ddasdkimo/rack-atx-controller/hardware/research/hxy-trial5-all20-overview.png

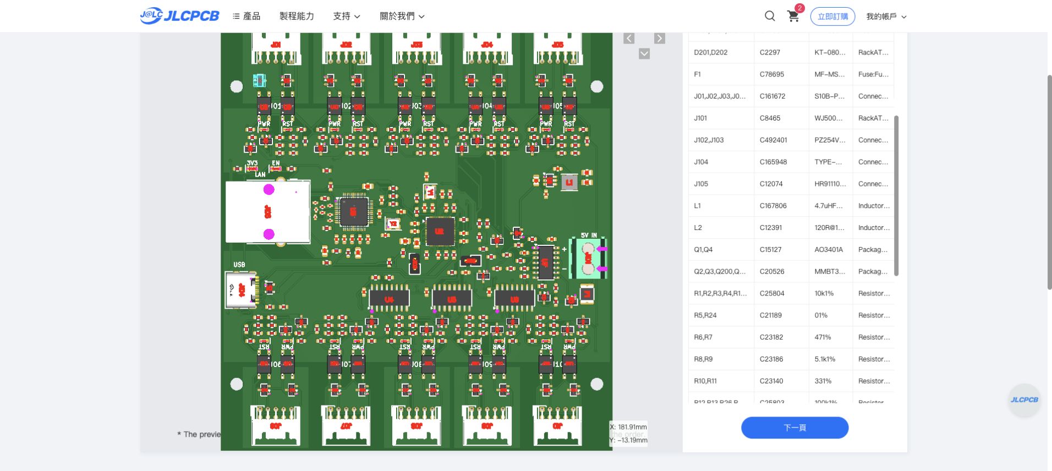
hardware/research/hxy-trial5-all20-overview.png
