ddasdkimo/rack-atx-controller/hardware/research/jlc-r3-shift-registers.jpg

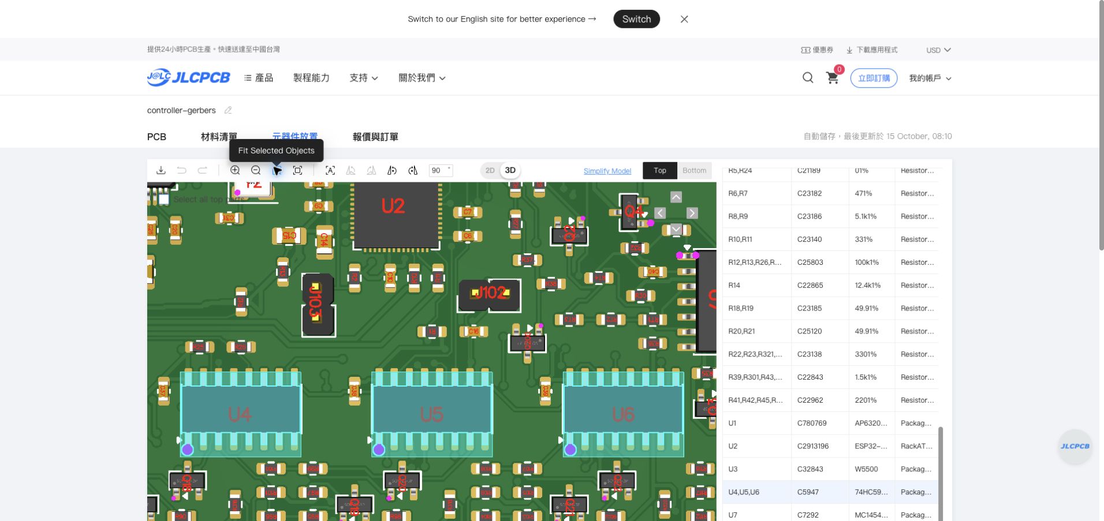
hardware/research/jlc-r3-shift-registers.jpg
