ddasdkimo/rack-atx-controller/hardware/simulation/README.md

# Current B.2 study — 2026-10-14

Run `python3 hardware/simulation/run-b2.py` from the repository root. [B2-summary.json](results/B2-summary.json) is tied to the exact current circuit hash. The study uses ngspice47 with a datasheet-fitted aggregate32768-count timer and transistor/photorelay models; **no vendor oscillator model or hardware correlation**.

The B.1 LED sensing failure is addressed by removing that entire electrical branch; case LEDs remain directly attached to the motherboard. The timer is nowMC14541B,200kΩ/1nF C0G,Rs400kΩ,AR disabled,MR external,one transition. Independent ARM gating keeps PHOTO_5V off while reset Q is high. ARM/OE/LATCH move toGPIO4/6/7.

16corners combine R±1.5%,C±5.2%,supply4.75/5.25V and an **assumed±25%clock-frequency stress range**. Nominal15.07328s; computed pulses11.2597–21.4599s fall in the8–25s design-study window. Clock tolerance is a study envelope, not a production specification. Nine cases cover normal pulse,heldARM60s,disarm5s,bootwithoutfirmware,OEforcedenabled,timerQforcedhigh,10µs/1spowerramps,andrepeatedcommands. All assertions pass.

Actual RC oscillator startup/frequency, supply and temperature extremes, MCU boot loading, ESD, EMC, USB/Ethernet and physical relay behavior still need prototype qualification. Repeated ARM transitions start new windows; this is not a fault-proof interlock against arbitrary firmware. The following B.1 study is retained to document why the redesign was made; its LED and TLC555 results are not the active circuit.

---

# B.1 行為級 SPICE 模擬（2026-10-14）

這個目錄是 B.1 電路的 ngspice 模擬：用 datasheet 參數擬合的**行為模型**，檢查 B.1 原理圖中無法只靠直流估算確認的行為。它是設計審閱的輸入，**不是**廠商模型驗證、不是實機量測，也**沒有**改變 B.1 原理圖、BOM 或 S.2／R.1 配置。所有結論都要在實際主機板與試作板上重新確認。

## 範圍與結果一覽

| 研究 | 網表 | 結論 |
|---|---|---|
| LED 感測門檻與遲滯 | `led-threshold.cir` | 300 次 Monte Carlo 加方向性角落：開啟 0.41–1.18 V、關閉 0.33–1.11 V（差動輸入），在「關 ≤0.2 V、開 ≥1.4 V」的理想包絡內成立 |
| LED 感測動態（假設主機板驅動） | `led-dynamic.cir` | **低側開汲極驅動的主機板一律誤判為常亮**；只有高側驅動正確。見下方發現 1 |
| 掉電負載與回灌 | `led-backfeed.cir` | 控制器通電、主機斷電時回灌 <0.02 µA；控制器斷電時每腳負載 ≤46 µA；但感測支路使熄滅的機殼 LED 流過約 30 µA |
| TLP3122A 驅動 | `photorelay.cir` | 128 個角落 IF 7.34–9.30 mA，皆高於 IFT 上限 3 mA、遠低於 50 mA；DRV 低或 595 三態時繼電器皆斷開 |
| TLC555 共用限時 | `timer.cir` | 標稱 16.81 s；含電容偏壓／溫度假設的角落 6.75–25.7 s，**超出 8–25 s 目標**；持續高電位不延長；解除 ARM 立即關閉 |
| 上電時序 | `powerup.cir` | GPIO43/44 的重置弱上拉使 555 RESET 腳在開機時約 2.28 V（高於 1.8 V 最差解除門檻），但 AC 耦合觸發沒有快速邊緣，軌道仍未啟動 |

機器可讀結果在 `results/*.json`，摘要同步到 `../validation/checks.json` 的 `spice_simulation`。

## 發現與建議

### 1. LED 感測在常見的主機板驅動方式下會誤判（高優先）

B.1 的 LED 感測是量 LED+ 與 LED− 的差動電壓，兩個輸入各經 100 kΩ 到比較器網路、10 kΩ 到主機參考地。原本的適配條件是「熄滅時差動 ≤0.2 V、亮起 ≥1.4 V」。模擬顯示對最常見的主機板拓樸（LED+ 經限流電阻接 5 V 或 3.3 V，LED− 由開汲極拉低）這個條件**不成立**：

- 驅動器關閉時 LED− 高阻抗，控制器的感測支路（約 110 kΩ 到主機地）把 LED− 拉向地，使機殼 LED 在約 30 µA 下微導通。差動電壓等於 LED 在微安級的順向電壓：綠色約 1.7 V、藍色約 2.4 V，都高於開啟門檻上限 1.18 V，所以 MCU 讀到「亮」。
- 沒有接機殼 LED 時，LED− 直接被拉到地，差動 ≈ 4.9 V，同樣讀到「亮」。亮與滅的差動幾乎相同，電壓感測在這個情況下**無法分辨**。
- 推挽式驅動（熄滅時 LED− 為 3.3 V 高電位、LED+ 為 5 V）差動 1.68 V，也讀到「亮」。
- 高側驅動（LED+ 被切換、LED− 固定接地）才正確：延遲開啟約 10 µs、關閉約 80 µs。

實務後果：HDD 燈在主機通電時會被讀成常亮；電源燈在待機閃爍時讀不到熄滅；同時機殼 LED 在「熄滅」時仍有約 30 µA 微亮，與控制器是否通電無關。

what-if（**未採用**，只是方向性證據）：在控制器端的主機域內，於 LED− 感測輸入與 LED+ 之間加一顆上拉電阻，讓熄滅時 LED− 跟著 LED+。模擬結果：

| 上拉 | 綠 LED 5 V 低側 | 無機殼 LED | 藍 LED 3.3 V | 亮起時經主機板驅動器的額外電流 |
|---|---|---|---|---|
| 22 kΩ | 誤判（熄滅差動 0.84 V） | 誤判 | 正確 | 0.09 mA |
| 4.7 kΩ | 正確（0.21 V，貼近關閉門檻下限 0.33 V） | 正確 | — | 0.43 mA |
| 2.2 kΩ | 正確（0.10 V），含最差比較器角落 | 正確 | 正確 | 0.93 mA |

2.2 kΩ 時亮起狀態多了約 0.9 mA 經主機板的 LED 驅動電晶體，這對一般驅動器可接受但必須以實際主機板確認；推挽式驅動仍無法用上拉解決，需要改成感測 LED 電流或改門檻。真正的修正要重新設計 LED− 支路（含 390 kΩ 偏壓與 4×510 kΩ 遲滯的比例），並依 AGENTS.md 同步 design.json、3D、接線圖與 CHANGELOG；這裡不做。

### 2. TLC555 限時角落超出 8–25 s 目標

脈寬 = R32 × Ct × ln(VDD / (VDD − VIT))。模擬角落：R32 ±1 %、VIT 2.7–3.9 V（全溫範圍）、Ct 17.2–33 µF。Ct 下限的假設是 3 × CL21A106KAYNNNE（10 µF 25 V X5R 0805）：公差 −10 %、5 V 直流偏壓 −25 %、X5R 溫度 −15 % 相乘；上限 +10 %。結果 6.75–25.7 s。若要守住 8 s 下限，需要量測該電容在 5 V 偏壓下的實際容量，或改用 C0G／較高額定電壓的電容，或接受下限由韌體長按 5 s 的餘裕吸收。這與原本的「8–25 s 是鑑定目標而非保證」一致，只是把差距量化。

其他行為：TIMER_FIRE 持續高電位 40 s 只產生一個 16.8 s 脈衝（AC 耦合有效）；每 5 s 重觸發 1 ms 會在前一脈衝結束後再開新視窗，60 s 內軌道共通電 50.4 s；觸發後 5 s 解除 ARM，軌道在 10 ms 內關閉；未 ARM 時觸發，軌道保持 0 V；20 路同時導通時 PHOTO_5V 為 4.99 V；觸發脈衝約 1.4 ms，4.75 V 時 TRIG 腳最低 0.046 V。

### 3. GPIO43／GPIO44 的重置狀態削弱了「預設禁能」的保護

ESP32-S3 datasheet v2.2 表 2-1 記載 GPIO43（U0TXD，接 TIMER_ARM）與 GPIO44（U0RXD，接 TIMER_FIRE）在重置時與重置後都是「WPU, IE」，即內部弱上拉啟用。以 45 kΩ 上拉對 100 kΩ 下拉計算，開機時 TIMER_ARM 約 2.28 V，高於 TLC555 RESET 解除門檻的最差值 1.8 V，所以 555 在韌體接手前**沒有被 RESET 鎖住**。另外 ROM bootloader 會在 U0TXD 輸出開機訊息，也會把這一腳驅動為高。

模擬顯示軌道仍未啟動：TIMER_FIRE 也被弱上拉緩慢拉到 2.28 V，經 100 nF／10 kΩ 的 AC 耦合只在 Q2 基極產生 0.24 V，不足以觸發；即使之後出現 2.28→3.3 V 的快速邊緣（1 V 階躍）也不觸發。因此 B.1 在開機時的安全只剩「需要低阻抗來源的快速 0→3.3 V 上升邊緣」這一層，失去 ARM 這一層互鎖。建議把 TIMER_ARM 與 TIMER_FIRE 換到重置時沒有上拉的腳位（datasheet 標 IE 的一般 GPIO），把 GPIO43/44 讓給弱上拉無害的訊號（例如 ETH_CS_N、ETH_INT_N，兩者本來就有 10 kΩ 外部上拉），並在 design.json / circuit.json 的 GPIO 表同步。這是腳位分配變更，不改元件。

GPIO2（OUT_OE_N）在上電時有約 60 µs 的低電位毛刺（表 2-2），74HC595 上電內容未定義，所以輸出可能在這 60 µs 被致能。因為 PHOTO_5V 軌道此時關閉，模擬中沒有 LED 電流；假設軌道已開，TLP3122A 的 tON 典型 2 ms，60 µs 不足以閉合，但這依賴切換時間，不是零風險。

### 4. 無問題的項目

- TLP3122A 驅動：IF 7.34–9.30 mA（5 V ±5 %、HC595 2.9–3.3 V、電阻 ±1 %、LED VF 1.1–1.4 V、hFE 100–300、1 或 20 路同時）；IFT 上限 3 mA 以上餘裕 4.3 mA。DRV 低、595 三態、20 路滿載時繼電器皆保持斷開。
- 回灌：主機斷電而控制器通電時，流入主機板 LED 腳的電流小於 0.02 µA（390 kΩ 偏壓經 100 kΩ）。控制器斷電時，每個 LED 腳被負載 ≤46 µA，與原本 51 µA 的估算一致。
- 比較器輸入在所有角落都低於 0.71 V，在 LM393 共模範圍內。
- PWM 調光或 1 kHz 閃爍的 LED 會原樣傳到 MCU（100 µs 輸入濾波、18 µs 光耦），韌體要做積分；30 µs 的脈衝會被濾掉。

## 執行方式

```
/opt/homebrew/bin/brew install ngspice      # arm64 Homebrew；x86 brew 會從原始碼編 X11
python3 hardware/simulation/run.py          # 全部；--quick 減少 Monte Carlo；--only timer,powerup
ngspice -b hardware/simulation/timer.cir    # 單獨跑一個網表
```

run.py 把每個網表的 `.param` 以字串替換後丟給 `ngspice -b`，解析 `.meas` 與 `print` 輸出，寫入 `results/`，最後更新 `../validation/checks.json` 的 `spice_simulation`。`scripts/check-circuit.py` 重新產生 checks.json 時會保留這一段。

## 模型與假設

`models.lib` 內每個模型都註明擬合的 datasheet 數值。重點假設：

- **主機板 LED 驅動**（`MOBO_LED`）：沒有任何實際主機板量測。三種拓樸：低側開汲極（預設）、高側、推挽。限流電阻 330 Ω，軌 5 V 或 3.3 V。機殼 LED 用通用綠（2.0 V @10 mA）與藍（2.9 V）二極體模型。
- **LM393**：TI datasheet 的 VOS、IIB、VOL 極限做成 sigmoid 比較器加開集極 100／175 Ω；共模範圍不強制，改以節點電壓檢查。
- **TLC555**：平滑比較器加純類比雙穩態閂鎖；門檻用 KTH／KTR 縮放到 datasheet 全溫範圍。XSPICE 數位閂鎖在緩慢門檻交越時會進入未知狀態，已捨棄。
- **TLP3122A**：LED 二極體加理想開關，tON 用 4.4 ms 一階延遲近似；tOFF 未建模。
- **EL357N(B)**：CTR 1.3–2.6，軟飽和，8 µs 一階延遲。
- **B0505S / HT7533**：Thevenin 與限幅行為模型，只用在回灌研究的軌電壓，不代表啟動或湧入行為。
- ESP32-S3 內部弱上拉 45 kΩ 為典型值假設。
- 隔離界線不在模擬範圍：各網表只把一個主機域與控制器地用 0 V 源綁在一起供求解器參考。
- `timer.cir` 與 `powerup.cir` 使用 `.options method=gear`；trapezoidal 在門檻交越處會停滯。
- EL357N 模型在輸出翻轉時有 0.1–0.2 V 的數值下衝，與元件無關。

## 尚未模擬（第二批）

十組 B0505S 同時啟動的湧入與 5 V 2 A 供應器、AP63203 buck 負載暫態、EL357N 回傳的溫度與老化 CTR、USB／Ethernet 版圖級阻抗，以及任何實際主機板波形。
