ddasdkimo/rack-atx-controller/hardware/RELEASE-CHECKLIST.md

# B.2 / R.3 送樣檢查紀錄

更新：2026-10-15。目標為試作送樣，**尚未製造放行，未下單、付款或開始生產**。目前可以離線完成的檢查已整理如下；供應商資料不足的項目維持未通過。

| 檢查 | 結果及證據 |
|---|---|
| 原理圖與 PCB 接腳 | 主板 300 顆、956 個腳位；轉接板 6 顆、20 個腳位。兩板 ERC／DRC／未連接皆為 0。原生 PCB 與封裝幾何未改；原理圖/BOM 的 TVS 料號已更新並重新 ERC、接腳與行為模擬檢查。見 [電路檢查](validation/checks.json)、[佈線檢查](validation/routing-R3-checks.json)。 |
| 隔離、預設關閉與限時 | 十個主機參考地互相隔離；保留 20 個雙向接點。ARM／OE 預設、16 組角落與 9 種狀態的行為模擬已檢查。振盪器 ±25% 是模型假設，並非廠商保證。 |
| USB／Ethernet 與供電 | 指定 CLI 已完成原生幾何與回流複查。短距離 USB 接頭扇出跨線、C34 焊盤起點參考面缺口和供電瞬態列為實板量測項，兩層板沒有工廠控阻保證。 |
| Gerber／鑽孔 | 獨立 CAM 解析已核對主板 380 圓孔、4 USB 槽孔、轉接板 20 孔。此次再核對 34 個製造檔雜湊、兩個 ZIP 共 20 個成員逐位一致。 |
| BOM／CPL | 主板 46 料號、300 顆，無重複或漏件，製造 BOM 的料號逐一匹配。新增 [原生幾何核對程式](../scripts/check-jlc-cpl.py)，直接由 PCB 焊盤核對 15 個連接器中心及 285 個原生錨點，最大座標差 0 mm。見 [核對結果](validation/jlc-cpl-native-checks.json)。 |
| JLC 校正可重現性 | 同一位 CLI 已獨立驗證 Trial 4：47 列更改、253 列不變，匯出結果逐位一致。這只證明校正符合所記錄的規則，不能取代供應商封裝方向確認。 |
| HXY TVS 換料 | C5451656 的 60 組 DC 漏電檢查通過限定的 3–5 V／≤47 kΩ 主機介面。全板 20 顆模型顯示正常，D2／D12 兩種方向近照已核對；Trial5 共 67 列校正，較 Trial4 多 20 列。見 [漏電分析](validation/hxy-button-leakage.json)、[預覽證據](validation/hxy-cpl-preview-checks.json)。高溫及實際主機仍須量測。同一位 CLI 已完成 [本次限定複查](validation/hxy-peer-review.json)，無新增阻擋。 |
| 補充放置預覽 | U4／U5／U6 的 pin 1 均在左下，16 腳落在焊盤列；J102 水平、J103 垂直，接腳對準孔位。見 [IC 近照](research/jlc-r3-shift-registers.jpg)、[排針近照](research/jlc-r3-headers.jpg)。未逐顆宣稱工廠貼裝合格。 |
| 固定包完整性 | 前次製造包 88 檔與 CPL 包 26 檔雜湊全部相符，未覆寫。前次獨立複查結果及本次補充證據將一起交給最終複查者。 |
| 實際報價 | 正常 Economic、五片 ENIG／蓋油：PCB 28.25＋零件 168.86＋組裝 78.37＝**US$275.48**。手工組裝費已包含；未列出的費用不預加。主控板單項價格未含運稅與配件。 |
| 轉接板與合併運送報價 | 五十片接頭全部代焊 US$63.10（PCB 17.85＋接頭 23.04＋代焊相關 22.21）。與五片主控製造合計 US$338.58，順豐合併寄台灣 US$12.21，含運 **US$350.79**。CPT 進口稅／清關費未列，線束、電源與外殼另計。見 [完整報價](research/jlc-r3-combined-quote.json)。已暫存購物車，未提交訂單。 |
| 轉接板供應商 CPL | 六個接頭以編號焊盤中心匯出獨立 Trial 1；兩種料號全部選入，JLC 顯示六個接頭。現已保存與實際報價相同雜湊的 [Trial1](manufacturing/R3-candidate/adapter-cpl-jlc-trial1.csv)，核對全部六個原生中心、角度、Top 面與 BOM；最大中心誤差 0 mm。見 [主控與轉接板聯合檢查](validation/combined-cpl-native-checks.json)。原生板與原生 CPL 未改；角度沿用同料號的預覽校正，最終獨立複查與工廠確認仍待完成。 |

## 等客服回覆後處理

2026-10-15 已寄出送件前工程詢問及審閱用附件；11:12（台灣時間）核對原往來及直接相關來信，尚未收到工程答覆。使用者已決定保留原 J105／HANRUN HR911105A／C12074。

1. **D2–D21 已改 HXY C5451656**：原占位模型阻擋已排除。完整模型與兩種擺放方向核對完成；Trial5 的 20 列新增校正與限定漏電結論已經同一位 CLI 獨立複查，未發現新阻擋；工廠問題結案後仍須最終複查。
2. **J105／HR911105A**：確認供應商模型的完整腳位、XY 基準點與角度。
   已比較同價位替代品：HCTL M899 雖有實際 JLC 外殼模型，但圖面型號與商品名稱不一致，固定腳與 LED 孔位也不同；M894 接腳定義不同；CND-tek 同名候選無現貨。此次不換料，J105 阻擋維持。見 [替代品紀錄](research/j105-alternatives.json)。
3. **QFN 工藝**：九個裸焊盤孔、底面蓋油、16 個錫膏窗與 55.39% 覆蓋率，需確認可焊性、鋼網、吸錫／空洞與檢查方式。
4. **通孔組裝**：確認已選料號適用目前 Economic 配置。依畫面報價記帳；如需變更工藝，先取得說明與新報價。

## 送件前最後一步

客服問題結案後，重匯受影響的 Gerber／BOM／JLC CPL，核對實際上傳版本、庫存、工藝和價格，再固定最終送樣包及雜湊。**請使用者指定的同一位 `rack-atx-controller` 複查**，確認收件與最終報告。若修正影響受審內容，須再請其核對。

原生 CPL 留作追溯，不可直接當成已校正的 JLC 生產檔。Trial 5 是本次 HXY 預覽候選，與原生 CPL 分開保存。任何檢查結果都不構成下單或生產授權。

實板到貨後才進行 USB／Ethernet 互通、3.3 V 瞬態、冷開機、斷線／重置時接點釋放、計時上限、十台主機接線及燈號驗證。韌體已編譯、尚未在硬體執行；以上是部署前資格驗證，不能以模擬或 DRC 取代。

## 若現在直接製造的剩餘風險

以下是依目前證據作出的工程判斷，排序代表處理優先順序，不是故障機率。尚無此板的製造批次或實板資料，不能給出良率百分比。檔案檢查通過的範圍是連接、幾何、資料一致性與指定模型；未取得的工廠證據不列為通過。

| 項目 | 已有證據／缺少的確認 | 若未處理就製造，可能結果 |
|---|---|---|
| QFN 裸焊盤焊接，優先處理 | 九孔、底面蓋油與 16 個錫膏窗幾何已核對。工廠尚未確認此孔／鋼網組合的回焊製程與檢查方式。 | 吸錫、空洞或接地焊接不足，可能造成無法啟動、運作不穩或散熱變差。焊點在晶片底下，目視與一般烙鐵不易診斷／修復，可能需要熱風返修、檢查設備或重製。不能推論五片一定有幾片失敗。 |
| J105 供應商對位 | 原廠圖面與原生孔位相符；CPL 計算和外殼預覽相符。尚無供應商完整 pin 編號、零度與錨點對照。 | 可能被工廠退回確認、無法按錯誤指示插裝，或位置／腳位裝配不符而無網路。實際孔型通常會限制插裝方向，但不代表任意角度錯誤都能自動排除；也不代表 PCB 本身已發現錯誤。通孔返修通常比 QFN 容易，仍有焊盤損傷風險。 |
| Economic 通孔組裝 | 報價已選入所需零件，手工設定與組裝費已列入。尚待確認本案全部料號的工藝安排。 | 比較可能影響審核時間、備料或加工安排；若工廠要求技術變更，需重新核價。沒有證據可預加額外費用，也不能把等待確認解讀成一定漏焊。 |
| 原型功能與主機相容性 | 電路、隔離、限時行為與限定 HXY 漏電分析已檢查；USB／Ethernet 為兩層原型佈線，韌體僅編譯通過。 | 可能需要韌體除錯、訊號／電源量測、修改元件甚至改板。未驗證前接上正式主機，錯誤觸發 POWER／RESET 可能造成非預期關機、重開及未儲存資料損失。先以量測治具／備用主機驗證全部輸出、冷開機與斷線釋放。 |

五片主控若有共同設計或製程問題，可能同時受影響；五十片被動轉接板不會因主控 QFN 問題必然報廢。當前整批含運報價仍為 US$350.79，這是本批支出，**不是預估損失，也不含假設的返修／重製費**。

我建議維持現有流程：先取得 J105 對照與 QFN 工藝確認，保留生產檔／零件位置人工確認，再將更新後固定包交同一位 CLI 最終複查；收到板子後才做功能資格驗證。工廠確認能降低製造不確定性，無法取代實板測試。

依據：原生與 CAM 證據見本頁前述連結；[Espressif 指南](https://docs.espressif.com/projects/esp-hardware-design-guidelines/en/latest/esp32s3/pcb-layout-design.html)要求裸焊盤至少九個接地孔；[JLC 過孔工藝說明](https://jlcpcb.com/help/article/pcb-via-covering)區分蓋油與填孔，且不將普通油墨塞孔適用於焊盤內孔；[JLC 焊盤說明](https://jlcpcb.com/blog/solder-pad-design-explained)說明 QFN 焊盤內孔的吸錫／空洞風險；[JLC PCBA FAQ](https://jlcpcb.com/help/article/pcb-assembly-faqs)說明通孔手工組裝及依所選零件顯示報價。以上是一般工藝依據，不代表 JLC 已核准本板。
