ddasdkimo/rack-atx-controller/hardware/HARDWARE.md

# 硬體 B.2 · POWER／RESET only

中央板支援十台主機；每台一片免供電的被動按鍵分接板，亦可用等效 Y 線束。**原機殼電源燈／硬碟燈直接接原主機板，不再接本裝置。** 主控保留 ESP32-S3FN8＋W5500＋HR911105A 有線網路，3 顆 74HC595 控制 20 個 TLP3122A 隔離接點。ping／SSH／Agent 健康檢查是後續軟體，未實作；無硬體 LED 回報。

## 按鍵與隔離

TLP3122A：1=A、3=K、4/6=常開雙向接點；接點並聯在 PWR_SW／RESET_SW，兩端不分正負。1.5 kΩ＋MMBT3904 驅動，base 有 100 kΩ 下拉，光輸入串 2×220 Ω。最低母線 4.5 V 的估算 IF≥5.63 mA；最大約 9.76 mA。長按效果由主機板決定，不會切斷 AC／5VSB。主機板沒有 RESET 腳時該組留空。

每台保留兩顆 PESD5V0S2BT，保護 POWER／RESET 四條線；pin3 維持接本機 HOST_REF。這個參考地是按鍵 TVS 使用，並非供電或 LED 偵測。十個主機域與 GND_CTRL 不相連；繼電器兩側維持隔離。板上 1 mm 功能隔離規則是低壓設計規則，不是安全隔離認證。

## 電源與上電控制

外部穩壓 5 V ±5%、2 A 接 J101：pin1=+5V、pin2=GND。保留 PPTC、防反接及 AP63203 3.3 V 降壓；USB-C 僅燒錄／除錯，不能從 USB VBUS 供電。移除所有 B0505S、HT7533、LM393、EL357N 與 LED 感測 RC。外接電源與保護線路須使 5 V 母線負載下仍≥4.5 V；2 A 為沿用電源選型上限，非實測耗電。

- GPIO4 TIMER_ARM：外部 10 kΩ 下拉。GPIO6 OUT_OE_N：外部 10 kΩ 上拉。GPIO7 OUT_LATCH：外部 100 kΩ 下拉。
- 不再使用 GPIO43/44 的開機弱上拉，也移離 GPIO1/2 的開機毛刺腳位。內部 flash 腳仍保留；禁用 Wi-Fi／BLE，RF 腳留空。
- TIMER_ARM 低時，Q2 關閉，MR 由 10 kΩ 拉至 5 V 重置計數器；Q200 同時斷開輸出閘控，PHOTO_5V 關閉。即使 timer Q 在 reset 為高、OE 意外拉低，未 ARM 仍不允許光繼電器通電。

## 計時修正

MC14541BDR2G（C7292）取代 TLC555CDR。Rtc=2×100 kΩ、Rs=4×100 kΩ，均沿用 Basic 阻值；Ctc=1 nF C0G±5%（C163508）。接線：Rtc(pin1) 經 200 kΩ 至 OSC_RC，Ctc(pin2) 經 1 nF 至 OSC_RC，Rs(pin3) 經 400 kΩ 至 OSC_RC。AR=1、MR 外控、MODE=0、QSEL=1、A=B=1，5 V 工作時不依賴僅適用較高電壓的自動重置。

依原廠 RC 式 f≈1/(2.3RtcCtc)，Q 在 32768 個週期後由高轉低，標稱約 15.07 秒。Q3 與 Q200 串聯控制 PHOTO_5V 的 PMOS，必須 timer Q 與 ARM 都為有效才導通。撤除 ARM 可立即結束短按／長按；持續 ARM 高只能使用一次計時窗口。重複 ARM 低高仍可開新窗口，不是可防任意韌體故障的安全計時器。

韌體順序：ARM低、OE高 → shift並latch 24個0 → OE低，進入啟用待命（EN燈亮）。每次操作寫入單一按鍵位元並latch → ARM高 → 指定按壓時間 → ARM低 → 清除位元。兩次指令間 ARM低至少10ms；目前韌體留50ms。異常或停用時 ARM低且OE高（EN燈熄）。595與W5500共用SPI，寫入完整frame及latch時鎖住匯流排。現有韌體來源見 firmware/；尚未在本板實機驗證。

## 使用者可見燈號

| 燈號 | 亮起 | 熄滅 |
|---|---|---|
| 3V3 電源綠燈 D201 | 主控3.3V母線有電 | 未供電或3.3V異常 |
| EN 啟用綠燈 D202 | OUT_OE_N為低，輸出鎖存已啟用 | 輸出未啟用 |
| RJ45 LINK／ACT | 網路實體連線／封包活動 | 未建立實體連線／無活動 |
| 每台 PWR 紅燈 D101、103…119 | 該 POWER 隔離開關正在驅動 | 該路未驅動 |
| 每台 RST 紅燈 D102、104…120 | 該 RESET 隔離開關正在驅動 | 該路未驅動 |

PWR／RST燈取自 PHOTO_5V 與該路NPN集極，每顆各串1.5kΩ，與光繼電器輸入並聯成獨立支路，沒有串入主機訊號。限時切斷PHOTO_5V時操作燈也熄。兩顆綠燈各串330Ω；EN燈直接由OE_N低電位汲電流，開機預設為熄滅。沿用RJ45內建LINK／ACT燈，沒有新增連線燈零件。

**這些燈顯示驅動命令，不是接點實際回讀，也不是主機開／關機狀態。** 啟用且待命時EN亮、二十顆操作燈全熄；操作時只有選定主機的PWR或RST亮；未啟用時EN與操作燈皆熄。LINK代表乙太網路實體連線，不代表主機SSH可用。紅燈C2286、綠燈C2297均為JLC Basic；22燈＋22顆既有阻值電阻，五片批量每片增加約US$0.23零件費，不新增Extended上料類別。亮度、可視角及色差待樣板確認。

[onsemi MC14541B Rev.16](https://www.onsemi.com/pdf/datasheet/mc14541b-d.pdf) · [Espressif ESP32-S3](https://documentation.espressif.com/esp32_s3_datasheet_en.pdf)

## 連接器與線束

| 自訂 JST pin | 功能 | 線材候選 Belden 9505 |
|---|---|---|
| 1 / 2 | PWR_A / PWR_B | 第1對 紅／黑 |
| 3 / 4 | RST_A / RST_B | 第2對 白／黑 |
| 9 | 本機 HOST_REF（按鍵 ESD） | 第5對 黑 |
| 5–8、10 | NC，不裝端子 | 未用芯兩端絕緣封存 |

沿用 JST S10B-PHDSS(LF)(SN)／PHDR-10VS／SPHD-001T-P0.5；實體孔位依廠商圖面確認，上表不是主機板針位。Belden 9505 是已查過的五對24AWG候選線；現在只使用五芯，不把它誤稱為已選定的新五芯線材。未來可再選少芯線壓成本，這次不加入未驗證料號。十台需20個PCB接頭、20個膠殼、100個端子另加備品；線長1–3m是待測目標，並非保證上限。屏蔽排流線不代替HOST_REF，機殼接法須EMI／ESD確認。

被動分接板只有6個零件：JA1=JST；JA2/JA3=主機板 POWER/RESET；JA4/JA5=原機殼 POWER/RESET；JA6 pin1=本機GND、pin2=NC。原按鈕同名兩端直通，再並聯至JST；這些路徑不依賴中央板供電。原 LED 完全繞過分接板，保持原極性接原主機板。每個2.54mm插頭標註功能，依主機板手冊接，不做未核對的通用F_PANEL插頭。

## 驗證範圍

主控300個元件、956個定義腳位；分接板6個元件、20個腳位，皆與 KiCad 匯出網表核對，ERC 0違規。R.3 中央板與 26×34 mm 被動轉接板均已連通，原生 DRC 0 違規、未連接 0；腳位、網名、封裝及原理圖 UUID 一致。

[行為模擬](simulation/README.md)16角落及9狀態通過，計時11.26–21.46s，包含額外±25%時鐘變動研究假設；非廠商模型或實測。測試尚未涵蓋實際振盪器、USB／Ethernet訊號完整性、ESD／EMC及實際主機。已依授權完成佈線及原生 DRC。晶振與 buck 關鍵線同面無過孔；供電銅箔 DC 路徑已估算。USB／Ethernet 配對阻抗與回流尚未資格驗證，工廠 DFM、熱焊盤／溫升及實機量測仍待完成，見 ROUTING-R3.md。

## 狀態燈位置

[正面俯視位置圖](indicator-layout-R2.svg)。紅色 D101–D110 在上排 J01–J05 內側；D111–D120 在下排 J06–J10 內側。綠色 D201（3V3）／D202（EN）在左側 RJ45 上方。LINK／ACT 位於 RJ45 外露端。此俯視方向，上排 PWR 左、RST 右，下排因鏡像而 RST 左、PWR 右；原生下排絲印旋轉 180°。位置圖文字為便於閱讀統一朝上，未改動 PCB。
