ddasdkimo/rack-atx-controller/hardware/COMPACT-STUDY.md

# Current compact board: S.3

B.2 removes host LED sensing. Selected placement is100×110mm, two copper layers,300electrical components+fourM3holes. It reduces area67.65% versusS.2(200×170mm). R.2 routing was explicitly authorized and is now connected with zero configured DRC violations. See [S.3 rationale and checks](LAYOUT-S3.md).

Two-layer connectivity is complete. High-speed pair/return/impedance qualification, thermal management and factory DFM remain; see [R.2 report](ROUTING-R2.md). This is neither a production board nor a100×100mm discount-tier claim. The prior S.1/S.2 and partial R.0/R.1 files remain historical evidence; their pricing or routing results do not apply to B.2. [Historical compact study](archive/B1/docs/hardware/COMPACT-STUDY.md).
