ddasdkimo/rack-atx-controller/hardware/LAYOUT-S3.md

# S.3 compact control-only placement

B.2 電路，100×110×1.6 mm、2層，300個電氣元件＋4個M3孔；佈局檢查後已依使用者授權完成 R.2 佈線。面積比S.2 200×170 mm減少67.65%。[可放大原生焊盤圖](layout-S3-review.svg)／[PCB](cad/B2/rack-atx-controller.kicad_pcb)。

上下兩排各5個JST PHD，每路中心間距18mm。每路接頭→兩顆按鍵ESD→兩顆TLP3122A→控制側驅動。只有光繼電器封裝跨過隔離帶；兩個銅層的隔離帶禁止tracks／vias／pads／zone fills。每台HOST_REF保持獨立。

左側RJ45、USB，W5500靠近磁性接頭；ESP32在中間，晶振與去耦按實際IC電源／時鐘腳集中。三顆595在中央下方，向上下兩排驅動分配。右側5V輸入；buck／電感／電容在右上，計時與ARM閘控在右中。4個3.2mm孔位為(4,17)、(96,17)、(4,93)、(96,93)mm，避開接頭及ESD；機殼、螺絲頭和線束插拔需實物覆核。

## 實際檢查

- 所有300個元件均有實際焊盤，沒有無焊盤佔位；完整已連線pin/net對應B.2原理圖。
- 元件外框無重疊，基本外框間隙≥0.25mm；44項指定電源／時鐘相關距離加3項獨立覆核全通過。
- 不同電氣域的焊盤外框最小距離5.1mm，滿足本設計1mm低壓功能分隔目標；非安全認證。
- S.3 保留為獨立未佈線基準；現行 R.2 原生 DRC／未連接皆為 0，2,754 段走線、185 過孔、22 個覆銅區，見 [佈線紀錄](ROUTING-R2.md)。
- Footprint採KiCad庫或既有原廠圖面轉錄，與BOM和原理圖Footprint一致；仍不是工廠／實物封裝認證。

此尺寸保留了電源與MCU周圍的出線空間；尚未強壓至100×100mm優惠級距，避免把必要回流／散熱空間當成剩餘空白。兩層已完成連通與幾何 DRC；USB 90Ω／MDI 100Ω 是設計目標，尚無已確認疊構／阻抗計算或配對回流資格驗證。晶振與 buck 關鍵線已手動縮短，供電銅箔 DC 壓降另有估算；QFN 熱焊盤／溫升仍須 DFM 與實測。

依原廠指南與幾何規則作實務審閱；不宣稱完整IPC合規。B.1/S.2/R.0/R.1仍保留為歷史，不能套用本版檢查結果。重建：KiCad bundled Python執行scripts/make-layout-s3.py、scripts/check-layout-s3.py；標準CLI執行pcb drc。
