ddasdkimo/rack-atx-controller/hardware/ROUTING-R0.md

> 歷史 B.1 記錄；現行 B.2／R.2 請看 [佈線檢查](ROUTING-R2.md)，不可沿用本頁的待辦或結果。

# R.0 實務布局審閱與第一階段佈線

使用者於 2026-10-14 指示改採大方向的實務確認，無須以 IPC 完整合規作為開始佈線的門檻。這取代先前「規範全部符合才佈線」的條件；不宣稱 IPC／IEC 認證。

## 開始佈線前的判斷

- 已核對 694 個電氣元件的連線腳位與 PCB net；S.2 的 11 個通孔屬性錯誤已修正。courtyard、板邊及焊盤幾何 DRC 沒有違規。
- 十路分為上下兩排，接頭朝外；38 mm 單元節距大於接頭外形。四角固定孔保留空間；USB／LAN 與供電端子朝板外。RESET／BOOT 排針從上方接入。實際機殼／插頭外殼與工具尺寸仍須在送廠前確認，不能視為機構定版。
- 先前未納入通用 SMD 間距表的 31 件，已按功能與現有封裝外形檢視：十個主機接頭、十顆隔離電源、五個服務接頭、兩顆晶振、兩顆電感、保險絲和二極體。沒有發現會阻止試佈線的外形重疊；不等於逐項公差及工廠組裝 DFM 已簽核。
- U2 周邊 11 對包圍盒距離為 0.925 mm，相對 JLC 的 1 mm 建議差 0.075 mm。此為組裝／返修餘量的建議差異，不是電氣短路或 courtyard 重疊。依此次實務審閱先保留位置，列為送廠 DFM 的明示待覆核項，沒有改寫成符合 1 mm。
- 隔離界線與不同主機參考地保持分開。1 mm 是專案低壓功能隔離規則，不是高壓額定值。
- 去耦、時鐘與電源分組可進入試佈線；ESP32 的細間距 QFN、USB 與 Ethernet 仍要遵循原廠高速／回流要求。不能因大多數元件是一般阻容就省略這些要求。

**判定：足以開始工程試佈線；不是完整製造放行。** IPC 全文不再是這一階段的阻塞。

## 已完成的第一階段

`cad/routing-R0.kicad_pcb` 是實際帶銅箔走線的 KiCad 檔，S.2 保留為不含走線的布局基準。

- 286 組短局部連接，524 段 F.Cu 走線，總長約 865.584 mm。
- 線寬 0.25 mm，僅用於這一階段的短局部支線；不當作主電源幹線的電流能力結論。
- 包含比較器供電去耦支線，以及主機 LED 感測／控制的短局部訊號。沒有為了接通而跨過隔離禁佈區。
- 0 vias、尚無地平面。所有元件位置及焊盤 net 與 S.2 一致。
- 原始試線發現 10 處間距不足；保留原 KiCad 0.2 mm netclass 要求，擴大路徑避讓後重新生成。最終 DRC：0 violations，仍報告 499 個未連線項目；這個報告數不是走線完成百分比。
- 路徑產生器保守避開異 net 焊盤、其他走線及隔離帶，找不到短路徑的連接保留為未完成，不硬穿。

## 尚未完成

主電源幹線、各隔離區地平面、MCU 出線、晶振、USB／Ethernet、其餘跨區控制連接，以及回流／阻抗／散熱與最終連通性審核均尚未完成。**不能送板，也未宣稱兩層已全部走通。**

重現順序：`start-local-routing.py` → KiCad CLI DRC → `export-routing-review.py`。後者核對原生 PCB 的位置／net 與每條實際走線，再輸出 `routing-R0.json` 和 `routing-R0.svg`。原始 DRC 報告留在本地，公開 JSON 只記錄不含本機路徑的結果。後續手動編輯 R.0 後勿直接重跑第一階段生成器覆蓋修改，應另存下一版並更新產生流程。
