ddasdkimo/rack-atx-controller/hardware/ROUTING-R1.md

> 歷史 B.1 記錄；現行 B.2／R.2 請看 [佈線檢查](ROUTING-R2.md)，不可沿用本頁的待辦或結果。

# R.1 雙面佈線與供電檢查

B.1 電路、200 × 170 mm、2 層、1.6 mm FR-4；694 個電氣元件及四個 M3 固定孔。R.0 與 S.2 保留為歷史基準。工作檔為 `cad/routing-R1.kicad_pcb`，必須連同同名 `.kicad_pro`、`.kicad_dru` 開啟，才能使用正確的檢查規則。

這是工程候選板，尚未完成實板與工廠組裝驗證。完整連通不等於阻抗、回流、散熱、EMC 或製造放行。原生連通數、DRC 與來源雜湊以 `routing-R1.json` 為準。

## 本次實作

- F.Cu / B.Cu 實際走線、一般通孔，以及控制器和十個主機各自獨立的地平面。不同主機地與控制器地不能合併。
- ESP32 的部分腳位採內外交錯引出，短引出線最小 0.125 mm；一般細訊號為 0.15 mm。一般過孔 0.5 / 0.3 mm，電源主幹轉層用 0.8 / 0.4 mm。沒有使用微孔、盲孔或埋孔。
- 3.3 V 主幹 1.2 mm，主控電容分支 0.8 / 0.4 mm，接腳附近保留短頸縮線。不能把自動佈線時的 0.15 mm 長線當作主電源。
- 為避免時鐘交叉，Y1 旋轉 180°、C17/C18 對調；USB 串聯電阻 R10/R11 旋轉 180°，MCU 側朝向 MCU；C11 移動 0.5 mm，讓出細腳引出空間。其餘封裝位置與 S.2 基準的差異由匯出器檢查，BOM 和原理圖 net 不因這些調整而變更。
- RJ45 磁性元件下方維持禁止鋪銅區。跨主機區的 1 mm 功能隔離規則仍保留；這不是安規額定隔離距離。
- 十個主機接頭的地腳採直接鋪銅連接，避免僅剩單支熱焊盤連接；局部無法形成完整熱焊盤的 SMD 地腳改用明確走線與過孔，仍須檢查實際連通。

## 製程規則

以 [JLCPCB 公開 PCB 能力](https://jlcpcb.com/capabilities/pcb-capabilities)（2026-10-14 查閱）為製程參考。此版本一般間距採 0.15 mm，細引出線 0.125 mm；均高於頁面所列 1 oz 兩層板的 0.10 mm 線寬／間距能力。

過孔與元件鑽孔分開檢查：過孔孔間距設定 0.25 mm；涉及元件通孔的孔間距維持 0.45 mm，元件通孔至其他銅箔至少 0.28 mm。不能把元件通孔規則直接套用到全部過孔，也不能因資料表可做更小，就省略本板 DRC。

這些是低壓板的工程規則，不宣稱 IPC 或 IEC 完整合規，也不代表工廠已核准檔案。S.2 先前記錄的組裝間距建議差異仍須在送廠 DFM 時覆核。

## 電源驗算方法

`scripts/audit-r1-power-paths.py` 讀取原生走線，建立含焊盤連接、過孔及 T 接點的導通圖，計算來源到負載的一條低電阻供電路徑。使用 35 µm 銅、60°C 銅阻率及每個通孔 2 mΩ 的保守假設。對主控各 3.3 V 腳，個別套用整體 0.65 A 峰值預算，並非宣稱每個腳都實際吸取 0.65 A。

這是供電銅箔的 DC 上界估算；不含外接線、PPTC、MOSFET、接頭、穩壓器公差、地回路與瞬態響應。不能當作實測或溫升簽核。需在負載及啟動測試中確認實際電壓。

## 驗證與發布界線

- KiCad 重新鋪銅後的原生未接線數，是連通性判定依據。DRC JSON 有報告項目數上限，不能用它估算完成率。
- 必須重跑原生 DRC、腳位 net 核對與電源路徑檢查，才更新已選定的 CAD 與公開資料。
- 3D 銅箔、過孔與平面由原生 PCB 匯出。元件外觀仍是審閱模型，不是每顆元件經原廠認證的 STEP 模型。
- USB / Ethernet 仍須按原廠要求檢查配對、長度、回流及訊號完整性。JLCPCB 公開的受控阻抗服務不應直接套用為此兩層板的 90 / 100 Ω 保證。
- ESP32 EPAD 的九個導熱過孔須與鋼網、塞孔／阻焊方式一併覆核，避免錫膏流失。不得僅因 DRC 通過就假設 QFN 組裝已通過 DFM。
- 主機端轉接板與線束仍須依實際主機板手冊核對；本次控制板佈線不代表所有主機型號或線束均已完成驗證。

## 維護

以原生 PCB 為佈線來源；不要重跑 R.0 或試驗產生器覆蓋後續修改。`scripts/export-routing-r1.py` 核對選定 PCB，輸出 `routing-R1.json`、SVG 與 `design.json` 的佈線資料；再執行 `scripts/build.py`、`scripts/check.py`。另外檢視桌面／手機的整體、控制板、兩台 PC 與接線頁。

本地 `artifacts/local/` 內的自動佈線中間檔、試驗板、下載工具及原始日誌不屬於製造釋出。公開頁與 GitHub 應指向相同的選定版本，且不能把試驗中繼檔誤標成已完成板。
