ddasdkimo/rack-atx-controller/hardware/PROTOTYPE-P0.md

# P.0：現成 ESP32 ＋ 控制模組／轉接板郵票孔拼板

**已暫停：使用者已選擇回到一片控制十台主機的整合方案。本頁保留先前研究，不是目前實作方向。**

2026-10-14 曾評估的驗證方向：使用現成 ESP32 開發板，暫不自製網路主控板；保留 TLP3122A 雙向按鍵接點，先驗證控制電路與主機板被動轉接板。此為可行性與試作範圍，尚未完成 P.0 原理圖、BOM、PCB 或生產檔。B.1／S.1 留作完整十路設計的比較基準，不能拿原完整板價格當 P.0 報價。

## 可行，建議這樣分板

同一製造拼板放 **1 片雙主機控制模組＋2 片相同的被動轉接板**。這是 3 片子板、2 種電路設計。兩台是本次建議的驗證粒度，並非使用者已要求固定模組容量。

- ESP32 開發板在拼板外，只提供網路、邏輯控制及狀態管理；接頭先定義功能，待實際開發板型號確認再分配 GPIO。3.3 V 邏輯與 5 V 光驅動電源分開核算，不能假設 USB 開發板可供應任意数量的擴充模組。
- 控制模組放 4 顆 TLP3122A（兩台的 POWER／RESET 各一）、驅動、預設關閉、限時與保護。以移位暫存器等簡單邏輯擴充，避免每模組再買一顆 ESP32；確切介面、按鍵時間限制與失聯行為待原理圖定版。
- 兩片轉接板只有主機板端、原機殼端及控制支路接頭。原按鈕及 LED 直通；這次 LED 不做遠端感測。轉接板免供電，不放 MCU。
- 後續感測另做，這次不裝 B0505S、HT7533-1、LM393 或 LED 回報光耦，也不自製 ESP32／W5500／RJ45／QFN 電源核心。

控制模組與轉接板之間、兩台轉接板之間，在拼板上沒有任何電氣連接；連接橋只保留 FR4 板材，**所有層的走線／銅皮／地平面均不得跨越**。拆板後才透過指定線束接入，控制器側 GND 與各台 HOST_REF 繼續隔離。不能為省佈線而在拼板內把不同電腦的地接在一起。

```text
現成 ESP32（外接，非本次製板）
      │ 短距離邏輯／電源線
      ▼
┌──────────── 同一製造拼板 ────────────┐
│ 雙主機控制模組  ·郵票孔橋·  轉接板 A01 │
│ 4 × TLP3122A    ·郵票孔橋·  轉接板 A02 │
│ 各子板沒有跨板銅線；收到後分板             │
└────────────────────────────────────┘
拆開後：控制模組 ── 線束 ── A01／A02 ── 各自主機板
                               └── 原機殼按鈕／燈號
```

## 分板工藝與費用

優先 **銑槽＋郵票孔連接橋（mouse bites）**。JLC 官方 FAQ 明確列為 Economic 拼板方法；V-cut 若連同代貼要用 Standard。郵票孔並不代表沒有拼板費或自動通過 DFM。

起始機構條件採 2 層、1.6 mm、單面元件、約 2 mm 板間銑槽；JLC 能力表建議郵票孔孔徑 0.5–0.8 mm、孔間剩餘材料 0.2–0.3 mm，有郵票孔的連接橋寬至少 5 mm。將機構強度、分板工具空間、銅／元件退讓、SMT 工藝邊、定位孔與 fiducial 一起交 DFM 確認，並非直接把能力表最小值套用為本板圖面。不要把銅到一般銑邊的 0.2 mm 能力當作郵票孔斷裂區的通用安全退讓。

折斷處避開 TLP3122A、陶瓷電容與接頭焊腳；用分板工具支撐／剪斷連接橋，避免扭整片板。若接頭自行手焊，先分板再裝接頭，較不會讓長接頭承受分板彎力。若工廠全焊，須考慮元件與工具接近空間。

同一片拼板仍應申報 **2 種設計**，不能申報 1 種以取得優惠。JLC 費率頁另列多設計拼板的 PCBA Panel 費 $8.21，裸 PCB 混拼／銑槽／工藝邊等以實際上傳審核為準。圖面確定後要比較：

1. 混拼郵票孔：一筆控制＋轉接板組合拼板，控制器 SMT 代貼，通孔接頭自行焊。
2. 同一混拼，全部接頭也由工廠焊。
3. 若混拼附加費偏高：控制器單獨代貼，轉接板另做裸板手焊。

這次真正的節省來自使用現成主控、少做感測與先驗證少數路數；不能單靠「幾片小板連在一起」推算一定便宜。TLP3122A 的數量按实际控制路數縮小，不以便宜但有極性的光電晶體代替。

80×80 mm 單一設計、2 層、1.6 mm、綠油白字、無鉛噴錫、蓋膜、一般 2 天的網頁參考試算：5 片 $5.20，10 片 $6.40（2026-10-14，USD）。這僅驗證小板價格，**不是本拼板尺寸或報價**，沒有計混拼、代貼、元件、耗損或運費；JLCONE 額外優惠不納入基準。對應截圖位於 research/quote-2L-80x80-*。

## P.0 費用初估

以含工藝邊的 **100×100 mm** 拼板為報價情境，尚未驗證是否能放入完整電路／接頭。JLC 網頁設定兩種設計、客戶提供拼板、2 層、1.6 mm、綠油白字、無鉛噴錫、蓋膜、一般交期，5 片裸拼板：工程 $4＋板材 $4.90＋表面處理 $1.30＋拼板 $4.06＝**$14.26**。未上傳 Gerber，最終仍須審核。[截圖](research/quote-P0-100x100-2designs-5panels-2026-10-14.jpg)。

| 項目（USD，整批） | 組裝 2 片拼板，四台容量 | 組裝 5 片拼板，十台容量 |
|---|---:|---:|
| 裸 PCB：兩欄均購買 5 片拼板 | $14.26 | $14.26 |
| 零件：含對應控制模組和轉接板 | $15.53 | $36.91 |
| ① 材料合計，自己焊 | $29.79 | $51.17 |
| ② SMT 代貼，通孔接頭自己焊 | $60.96 | $83.11 |
| ③ 全部由工廠焊好 | $67.62–76.83 | $94.40–103.61 |

①、②、③是替代方案總額，不能相加。兩片方案保留三片空拼板。SMT 自焊接頭方案包含通孔材料的比較預算，但需另找通路採購；JLC 不寄這些散件給使用者。

成本模型暫列每拼板 92 個元件、20 種料號，採實際數量的 2026-10-13 庫價階梯，沒有套用原五片完整十路板的較大量價格。保留 4 顆 TLP3122A、1 顆 74HC595、TLC555 共用限時、電源／訊號保護；ESP32 接口先以 8 個已知 2-pin 排針估 16 個腳位預算，不代表正式接頭與 pinout 已定。

五片批量包含：開單／鋼網／確認／PCBA 混拼 $18.37，4 種 SMT Extended 上料 $12.28，SMT 焊工約 $1.30。全焊再加通孔開工及 470 焊點工資約 $11.29；通孔 Extended 若也計上料，再加 $9.21，故列上下限。沒有 QFN／BGA，暫不計 X-ray；實際分類由工廠決定。

**不含 ESP32 開發板、外接電源、線束／壓接端子、機殼、運稅、耗損／MOQ、DFM 追加、工具／個人焊接工時及燒錄。** 這是功能範圍預算，未完成 P.0 原理圖，不能視為正式 BOM 或成品承諾。五片拼板是十台容量；原五片完整 B.1 中央板是五十台容量，兩批次不能直接當作相同功能／容量的降價百分比。

[可重算模型](prototype-cost.json) · [估算脚本](../scripts/prototype-cost.py)。

## 原接線仍需核對（POWER／RESET／LED）

TLP3122A 的外部開關接點可交換兩端，所以正確的 POWER／RESET 按鈕對不用分正負。但一定要依主機板手冊找對那一對接腳，且電壓／電流須在規格內。LED 直通仍需保留原極性；若保護電路使用 HOST_REF，仍須找對該主機 GND。開關無極性不代表整組接頭可隨便接。

## 這次要驗證的結果

- ESP32 啟動、reset、韌體掛起、模組拔除／缺電時不誤觸發，按鍵不會永久保持。
- POWER 短按、長按、RESET 動作；原機殼按鍵與 LED 在控制器無電時仍能使用。
- 控制器與各主機信號域隔離、兩台 HOST_REF 不因拼板／線束短接，按鍵電壓與低電流接點相容。
- 線束方向、防反插、拉扯與實際線長下的穩定性；先驗證短線，再測預定最長線長。
- 郵票孔分板後無銅皮／焊點裂傷，毛邊不影響接頭、固定孔及機殼。

製作前仍需確認現成 ESP32 的確切型號與主機板前面板接腳；此處不指定可能影響開機的 GPIO，也不宣稱有通用主機板 pinout。

官方來源：[拼板 FAQ](https://jlcpcb.com/help/article/pcb-assembly-faqs)、[分板／V-cut 規則](https://jlcpcb.com/help/article/pcb-panelization)、[工藝能力](https://jlcpcb.com/capabilities/Capabilities?type=1)、[組裝費率](https://jlcpcb.com/help/article/pcb-assembly-price)。
