ddasdkimo/rack-atx-controller/hardware/archive/B1/README.md

# Historical B.1 baseline

Snapshot retained before the B.2 control-only redesign. These schematics/BOM/simulation/documents include LED sensing and known simulation findings; they are not selected or manufacturing-ready. Active files are hardware/cad/B2 and hardware/circuit.json. Archived generator scripts are reference copies with their original relative-path assumptions; do not run in place. S.2/R.0/R.1 native PCBs and their ignored local checkpoints remain in their original locations.
