ddasdkimo/rack-atx-controller/hardware/archive/B1/docs/hardware/HARDWARE.md

> **目前已進入 R.0 局部佈線，尚未全板連通。** S.2 為保留的布局基準；以下舊版「待確認／未佈線」敘述屬歷史狀態。

# 硬體設計 B.1

> 目前布局為 S.2（200×170 mm），待使用者確認，尚未佈線。以下 S.1 尺寸／費用／52 個佔位敘述為歷史紀錄；S.2 已補焊盤，詳見 [布局審閱](LAYOUT-S2.md)。舊尺寸報價不適用於 S.2。

這版已完成選料、可編輯 KiCad 原理圖及電阻／電容定值。這是**原理圖審閱版**：尚無 PCB 佈線、Gerber 或 CPL；亦未接上實際主機驗證。3D 是同版本的機構配置示意，不能用作元件座標。

## 架構與實物數量

1 塊中央控制板接 10 台電腦；每台用 1 片**免供電分接板**，也可以用等效 Y 線束。分接板只有 JST 接頭及 2.54 mm 排針，不含 MCU、供電或通訊電路。主控板內的每一路有獨立隔離電源、感測器及隔離開關。

主控：ESP32-S3FN8（8 MB 內建 Quad flash）＋ W5500 ＋ HR911105A 有線網路。禁用 Wi-Fi／BLE；依 Espressif 指引留空 RF 腳。GPIO26–32 留給內部 flash。USB-C 僅燒錄／除錯，不替本板供電。GPIO 表在 [circuit.json](circuit.json)。

輸出：3 × 74HC595D 鎖存 20 個 POWER／RESET 開關位元。20 路 LED 回傳直接接 MCU GPIO，靠中斷擷取，不用慢速 I/O polling。HDD 活動只代表前面板 LED 訊號，不能據此判定 OS 或硬碟健康；Linux ping／SSH／Agent 屬後續軟體工作。

## 電源

外部穩壓 **5 V ±5%、2 A**，經 WJ500V-5.08-2P 螺絲端子 J101：1 = +5 V、2 = GND。使用合格隔離式外接電源；本板只處理低壓 DC。1.5 A PPTC 加 AO3401A 防反接，AP63203WU-7 與 4.7 µH 電感產生 3.3 V。以本板 5 V 母線在負載下保持 ≥4.5 V 為驗收條件；電源引線與保護元件的壓降一起計算。

每台主機：B0505S-1WR3L 隔離 DC/DC，接 HT7533-1 產生該台專用 3.3 V。非穩壓模組的輕載輸出不可當精確 5 V；HT7533-1 可承受較高輸入。輸入 4.7 µF、隔離原始輸出 10 µF、LDO 輸出 10 µF＋100 nF，另有 10 kΩ 放電負載。模組資料表允許 0% 負載；仍須量測啟動、輕載過衝及 LDO 溫升。模組資料表隔離試驗為 **1500 VDC**，不是 JLC 摘要標成的 Vrms。本板沒有整機安全隔離認證。

預算抓 3.3 V 主系統峰值 0.65 A、十路隔離供電合計 0.25 A@5 V、輸出全開約 0.20 A@5 V，總輸入約 1 A 等級；正常韌體一次只操作一個按鍵。這是配置預算，不是量測值。PPTC 高溫降額、buck 效率及 DC/DC 啟動浪湧列為板上驗收項目。

## POWER／RESET 支路

原按鈕兩端直通，TLP3122A 常開雙向接點並聯。**實際腳號 1 = LED A、3 = LED K、4／6 = 開關**，不能套用 1／2／3／4 SOP4。其光輸入由 74HC595 → 1.5 kΩ → MMBT3904 驅動，base 有 100 kΩ 下拉；光 LED 串 2 × 220 Ω。假設 5 V 母線最低 4.5 V、LED VF 最高 1.7 V、BJT 壓降 0.3 V，光電流最低約 5.63 mA；正常最大估計約 9.76 mA。這覆蓋 Toshiba 建議的 ≥5 mA 工作值。

TLC555CDR 單穩態經 BJT／PMOS 控制共用 PHOTO_5V 光驅動電源。510 kΩ 與 3 × 10 µF 的名目時間約 16.8 秒。觸發採 AC 耦合，因此 GPIO 固定高電位不會一直把 TRIG 拉低。CMOS TLC555 的 RESET 有 100 kΩ 下拉；未採雙極 NE555，避免它的 RESET 偏置電流讓弱下拉失效。

**8–25 秒是待實測的硬體窗口目標，並非已保證的最長時間。** MLCC 偏壓降容、溫度、timer 門檻及漏電會影響時間。重複觸發或反覆切換 ARM 仍可建立新窗口，所以這不是能防禦任意韌體故障的安全計時器。MCU watchdog 仍要在韌體啟用。

韌體順序：OE 保持高 → ARM/FIRE 低 → shift 24 個 0 → latch → OE 低 → 寫入單一按鍵位元 → ARM/FIRE 觸發 → 短按 100–300 ms 或長按約 5 秒 → 清除位元並撤除 ARM。長按效果依主機板／OS 設定；它不會切斷 AC 或 5VSB。三顆 595 共用 Ethernet SPI CLK/MOSI，只有完整輸出 frame 後才能 latch；Ethernet 封包不能誤鎖進輸出。SPI 建議初版 8 MHz 並驗證時序。

## 保留 LED 的感測電路

每個 LED 的正、負端各經 100 kΩ 到比較器網路，10 kΩ 到該主機 HOST_REF、1 nF 濾波。LM393 的 IN− 接 LED+ 分壓；IN+ 接 LED− 分壓並有 390 kΩ 從隔離 3.3 V 提供偏置，以及 **4 × 510 kΩ** 的正回授。OUT 以 10 kΩ 拉高。LED 亮使 OUT 拉低，經 2 × 330 Ω 驅動 EL357N(B)(TA)-G；其電晶體端隔離回到 MCU，10 kΩ 上拉及 1 nF 濾波，狀態 active-low。

390 kΩ 是刻意保留的延伸料：減少串聯拼值元件，並配合共模誤差和遲滯裕度；不是任意可替換為 470 kΩ。100 kΩ／10 kΩ 電阻使用 1% 0603，角落分析額外納入 0.5% 溫度變動額度、隔離電源 ±3%、比較器總輸入誤差 ±14 mV。保守計算的差動觸發範圍為開啟 0.361–1.357 V、關閉 0.216–1.222 V，範圍會隨共模與公差變化；不是單一主機的遲滯寬度。重建結果見 [validation/checks.json](validation/checks.json)。

適配條件：各輸入相對 HOST_REF 在 0–5 V，LED 熄滅差動 ≤0.2 V、亮起 ≥1.4 V。實際主機板要量測；三腳／雙色電源燈或特別的脈衝驅動另行適配。比較器 VCC=0 時允許正輸入電壓；100 kΩ 的 5 V 電阻限流上限約 51 µA/線，另須計入 TVS 漏電。此值是正常條件的支路負載估算，**不是主機板接腳短路保護額定，也不代表掉電回灌已實测為零**。控制器有電而主機沒電時也要量測偏置經網路回到主機的微小電流。

EL357N 的 B 級 CTR 最低值是在 IF=5 mA、VCE=5 V、25°C 定義；本電路的 IF 約數 mA、集極負載約 0.33 mA。低溫／低 IF／飽和條件不能直接套用標示 CTR，需用實物確認 MCU 低準位與短脈波延遲。初版驗收 LED 脈波 ≥1 ms 的捕捉率。

每台 4 顆 PESD5V0S2BT 保護八條信號，pin1／2 為雙向 I/O，pin3 只接該台 HOST_REF。十台 HOST_REF 不在控制板連在一起，也不接主控 GND。主機機殼或既有保護接地可能在設備外相連；本板不增加信號地回路。

## 自訂十芯接頭與線束

| Pin | 訊號 | Belden 9505 線芯 |
|---|---|---|
| 1 / 2 | PWR_A / PWR_B | 第 1 對 紅／黑 |
| 3 / 4 | RST_A / RST_B | 第 2 對 白／黑 |
| 5 / 6 | PLED+ / PLED− | 第 3 對 綠／黑 |
| 7 / 8 | HDD+ / HDD− | 第 4 對 藍／黑 |
| 9 | HOST_REF | 第 5 對 黑 |
| 10 | NC | 第 5 對 黃，兩端封存且不裝端子 |

上表是訊號編號，**不是主機板 F_PANEL 實體孔位圖**。J01–J10 均採 JST S10B-PHDSS(LF)(SN)，線端 PHDR-10VS，SPHD-001T-P0.5 端子。B.1 取代 A.2 的 Molex Micro-Fit，因指定 JST 料號有經濟型代貼庫存、體積與價格較適合。它們不互插。JST 2 mm PHD 也不等於主機板常見的 2.54 mm 排針。

全套十台：20 個 PCB 插座、20 個線端膠殼、180 個裝入端子＋備品、10 段 Belden 9505。9505 是真實五對 24 AWG 屏蔽線；單芯絕緣外徑約 1.1 mm，落在端子規格內。線束是訂製壓接件，沒有單一現成線組料號。1–3 m 只是原型線長驗收目標。屏蔽／排流線另接中央機殼單端，PC 端絕緣，不能代替 HOST_REF；此接法也需做 EMI／ESD 驗證。

分接板 JA1 接長線；JA2–JA5 接主機板四組信號，JA6–JA9 接原機殼同名插頭，JA10 pin1 接經確認的本機 GND，pin2 空。所有同名功能對直接接通。主機板端仍需依手冊訂製帶功能標籤的 2.54 mm 母頭跳線，不應壓成未核對的通用 9-pin F_PANEL 插頭。原機殼按鈕／LED 的直通功能不依賴控制器供電，但不是任意線纜短路故障下仍保證正常。

## 行為級 SPICE 模擬（2026-10-14，未實測）

[simulation/README.md](simulation/README.md) 用 ngspice 與 datasheet 擬合的行為模型檢查 B.1 的 LED 感測、掉電負載／回灌、TLP3122A 驅動、TLC555 限時與上電時序；結果在 [simulation/results/](simulation/results/) 與 [validation/checks.json](validation/checks.json) 的 `spice_simulation`。這些是審閱輸入，不是廠商模型驗證或實機量測，也沒有改變 B.1 電路。主要發現：

- **LED 感測對低側開汲極驅動的主機板會誤判為常亮**：感測支路把高阻抗的 LED− 拉向地，使熄滅的機殼 LED 以約 30 µA 微導通，差動電壓等於 LED 的微安級順向電壓（綠約 1.7 V、藍約 2.4 V），高於開啟門檻；沒有機殼 LED 時差動約 4.9 V，亮滅無法分辨。只有高側驅動正確。上面「熄滅差動 ≤0.2 V」的適配條件對這類主機板不成立，LED− 支路需要重新設計（例如對 LED+ 的上拉，what-if 見模擬說明），尚未採用。
- TLC555 脈寬含電容偏壓與溫度假設的角落為 6.75–25.7 s，超出 8–25 s 目標；下限由 X5R 電容在 5 V 偏壓下的容量決定，需量測或換料。
- TIMER_ARM／TIMER_FIRE 所在的 GPIO43／44 在 ESP32-S3 重置時有內部弱上拉，開機時 555 RESET 腳約 2.28 V，失去 ARM 互鎖；模擬中因 AC 耦合觸發需要快速邊緣，軌道仍未啟動。建議換到重置時無上拉的腳位。
- TLP3122A 驅動 IF 7.3–9.3 mA、回灌 <0.02 µA、斷電控制器負載 ≤46 µA 均無問題。

## PCB 與下一階段驗收

S.1 主控板候選外形 160 × 110 mm、2 層 FR-4、元件單面組裝，保留同尺寸 4 層備案；層數是 PCB 銅層數，與 PCBA 單／雙面收費分開。694 個零件已做無重疊的佔位配置，其中 52 個為五類未核定封裝的無焊盤外框。這仍是空間研究，不保證可佈線，固定孔與機構出口也未定版。詳見 [縮板評估](COMPACT-STUDY.md)。USB 90 Ω 與 Ethernet MDI 100 Ω 差動、QFN散熱焊盤、buck 回路、各主機隔離銅區及爬電距離都要另做 layout/DRC；隔離區不能鋪連續共地平面。

完成：KiCad 10 ERC 零違規；原理圖匯出 netlist 的 1887 個主板腳位及 28 個分接板腳位核對；BOM 數量核對；十路隔離界面檢查；上述 DC 角落計算。ERC 不會驗證供應商腳位、IC類比行為或 PCB實體隔離。

待完成：五類未指派焊盤（TLP3122A、EL357N、隔離模組、電感、輸入端子）及其餘候選焊盤圖面審核；PCB 與外殼、CPL/Gerber；主機板真實針位；有／無電負載與 LED 亮度；拔插和分支故障；timer 靜態卡死與反覆觸發；1–3 m 線束干擾、ESD、溫升／PPTC降額。先做單路台架測試，再接十台。

來源、選料與計價：[JLCPCB.md](JLCPCB.md)、[SOURCES.md](SOURCES.md)。
