ddasdkimo/rack-atx-controller/hardware/research/hxy-trial5-combined-cart.png

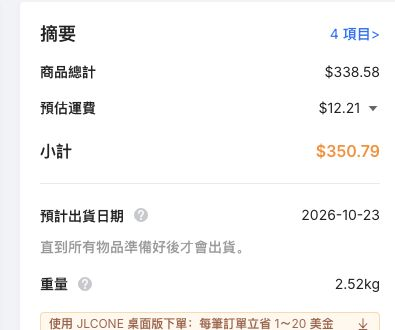
hardware/research/hxy-trial5-combined-cart.png
