ddasdkimo/rack-atx-controller/hardware/research/hxy-trial5-d2-pin1.png

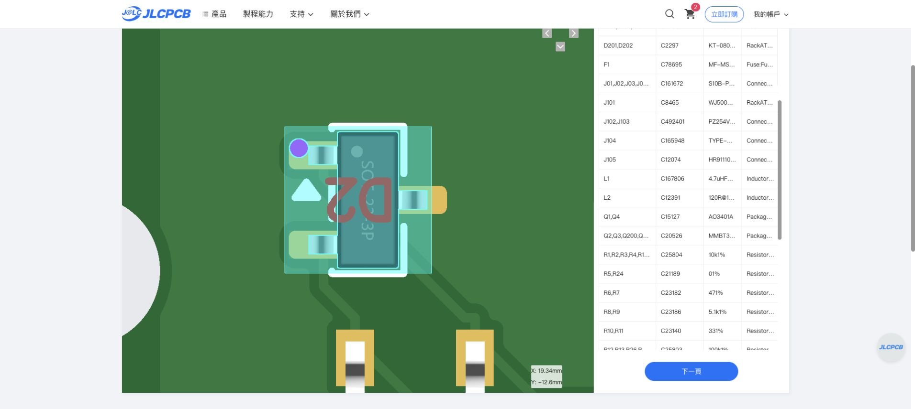
hardware/research/hxy-trial5-d2-pin1.png
