ddasdkimo/rack-atx-controller/hardware/research/j105-hctl-m899-preview.png

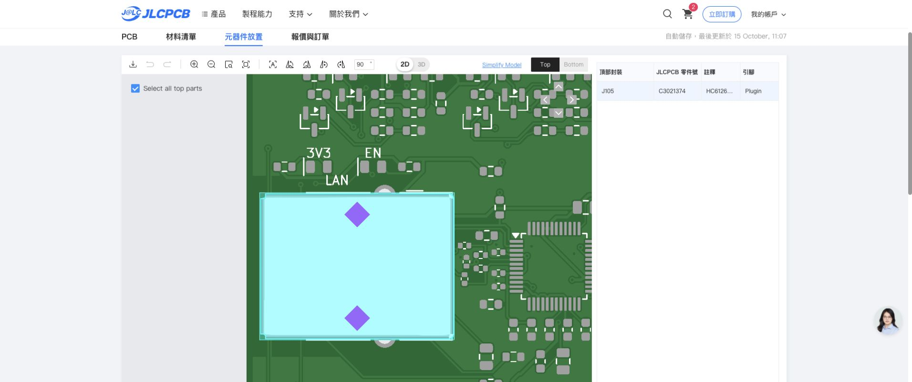
hardware/research/j105-hctl-m899-preview.png
