ddasdkimo/rack-atx-controller/hardware/research/jlc-r3-economic-5pcs-20261015.png

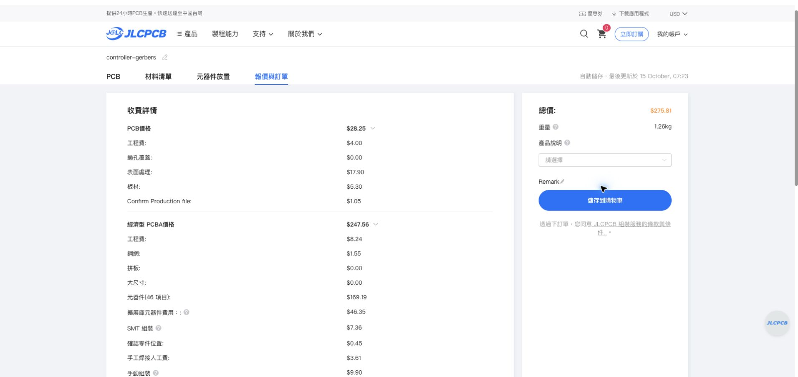
hardware/research/jlc-r3-economic-5pcs-20261015.png
