ddasdkimo/rack-atx-controller/hardware/research/jlc-r3-enig-5pcs-2026-10-15.jpg

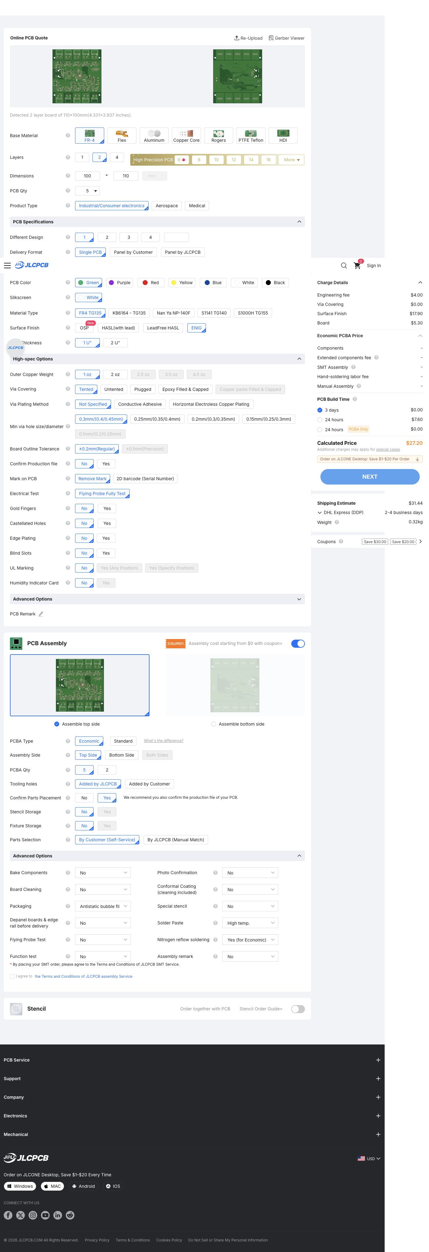
hardware/research/jlc-r3-enig-5pcs-2026-10-15.jpg
