ddasdkimo/rack-atx-controller/hardware/research/jlc-r3-headers.jpg

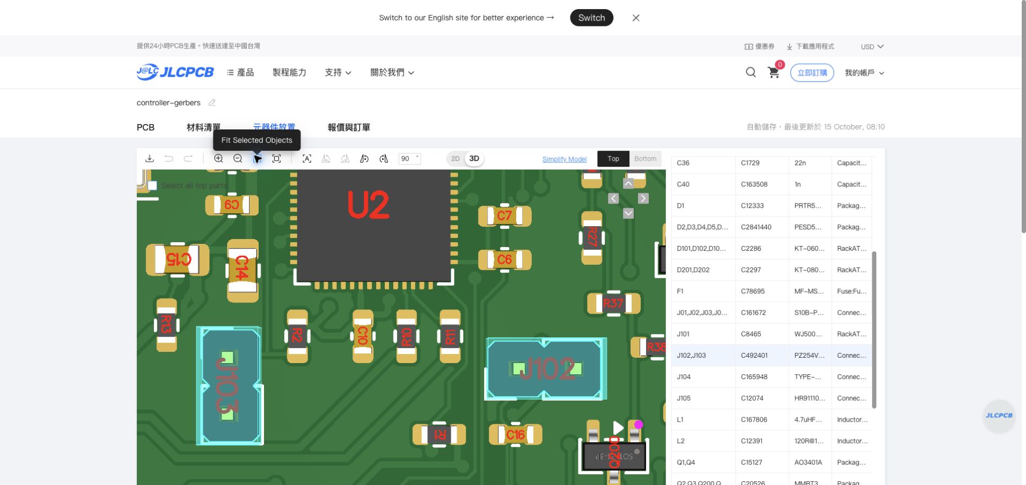
hardware/research/jlc-r3-headers.jpg
