ddasdkimo/rack-atx-controller/hardware/research/pcb-quote-2026-10-14.jpg

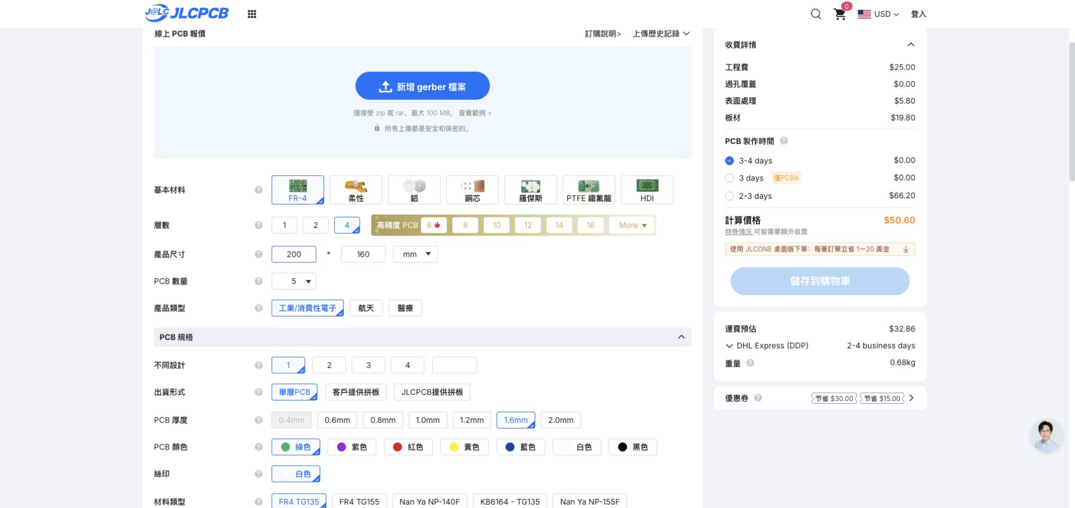
hardware/research/pcb-quote-2026-10-14.jpg
