ddasdkimo/rack-atx-controller/hardware/research/quote-2L-80x80-5pcs-2026-10-14.jpg

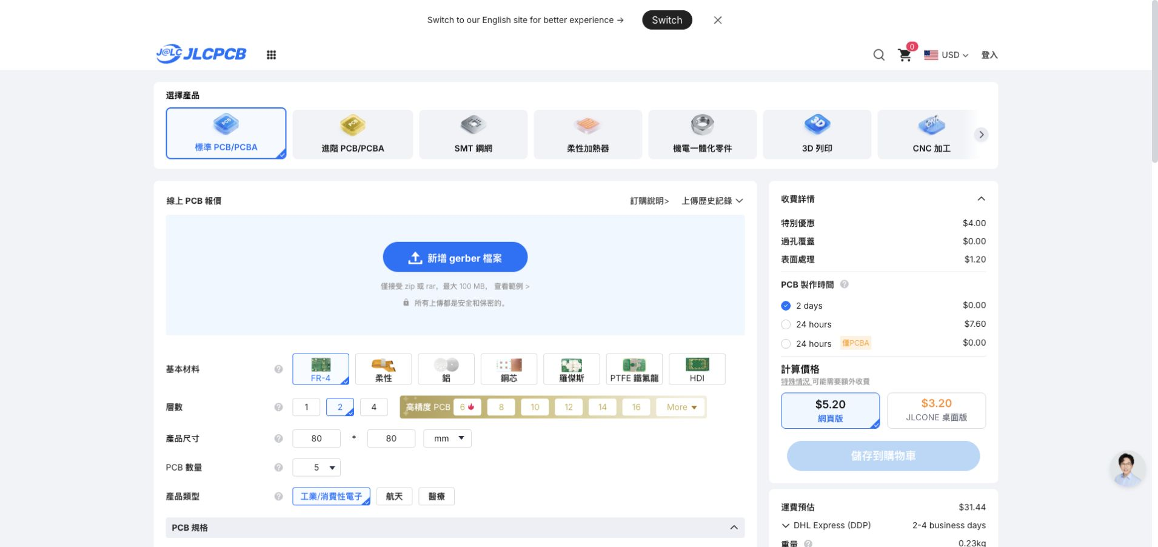
hardware/research/quote-2L-80x80-5pcs-2026-10-14.jpg
