ddasdkimo/rack-atx-controller/hardware/research/quote-2L-200x160-2026-10-14.jpg

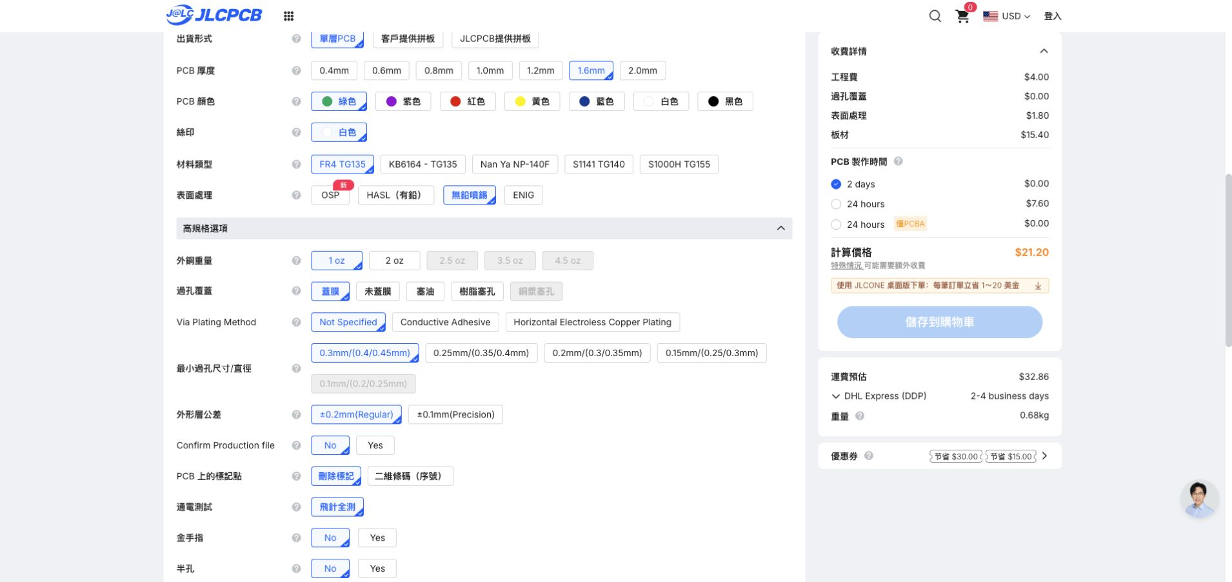
hardware/research/quote-2L-200x160-2026-10-14.jpg
