ddasdkimo/rack-atx-controller/hardware/research/quote-4L-160x100-2026-10-14.jpg

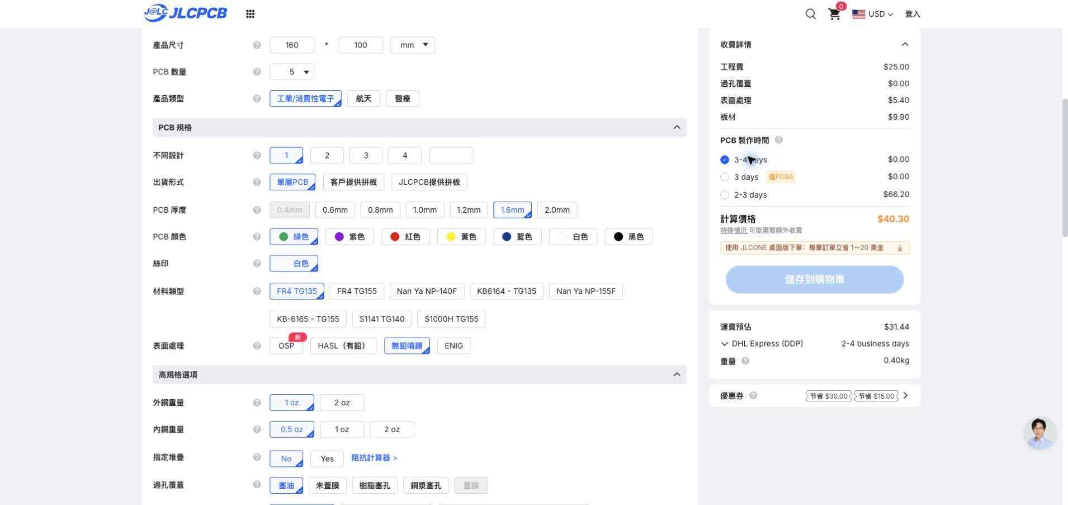
hardware/research/quote-4L-160x100-2026-10-14.jpg
