ddasdkimo/rack-atx-controller/hardware/research/quote-P0-100x100-2designs-5panels-2026-10-14.jpg

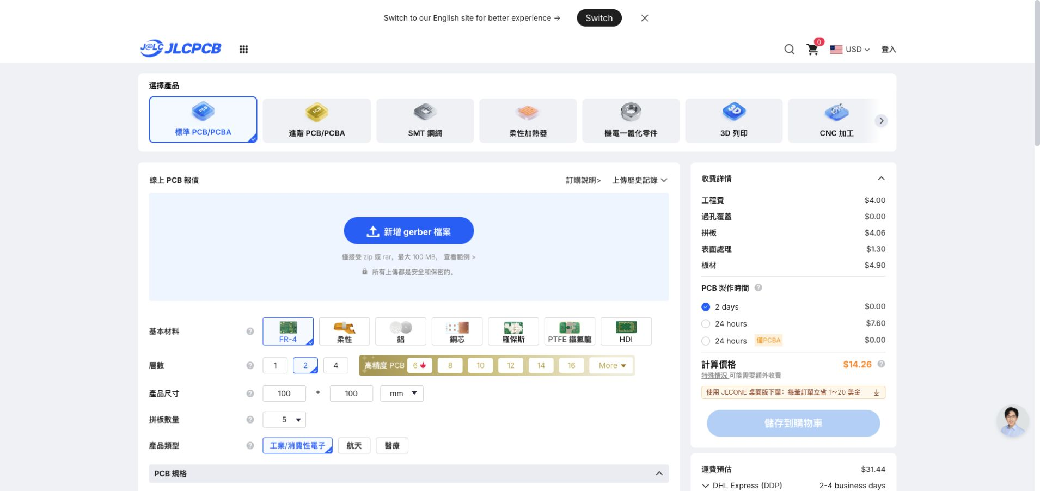
hardware/research/quote-P0-100x100-2designs-5panels-2026-10-14.jpg
