ddasdkimo/rack-atx-controller/hardware/COST-ALTERNATIVES.md

# 按鍵開關替代與隔離電源用途 — 2026-10-14

本文件是成本研究。B.1 原理圖、有效 BOM 與 S.1 配置仍使用 TLP3122A 和每主機一組隔離電源；以下候選尚未驗證，沒有套用到可下單資料。

## TLP3122A 替代

一片中央板供十台主機，每台 POWER／RESET 各一個開關，共 20 個。以下用五片板的採購數量計算，不含耗損、MOQ、焊接和運費，美元。

| 型號／JLC 料號 | 開關類型 | 單價 | 20 顆／片 | 每片相對現版省 | 庫存觀察／日期（UTC） |
|---|---|---:|---:|---:|---|
| [TLP3122A(TPL,E / C4153843](https://jlcpcb.com/partdetail/C4153843) | 雙向 MOS 光繼電器，現版 | $0.7454 | $14.91 | — | 原 BOM 查核 2026-10-13 |
| [KAQY212S / C194898](https://jlcpcb.com/partdetail/C194898) | 雙向 MOS 光繼電器候選 | $0.5824 | $11.65 | $3.26 | 0，2026-10-14 |
| [CPC1017N / C2760115](https://jlcpcb.com/partdetail/C2760115) | MOS 光繼電器候選 | $0.5595 | $11.19 | $3.72 | 0，2026-10-13 |
| [EL357N(B)(TA)-G / C42381015](https://jlcpcb.com/partdetail/C42381015) | 有極性的 NPN 光電晶體，需改電路 | $0.0456 | $0.91 | $14.00 | 510,538，2026-10-13 |

原始觀察與查核時間保留在 research/ 對應 JSON。公開庫存不等於預留庫存；缺貨價也不是可立即成交的報價。可以等待後兩款 MOS 的補貨／詢價，但目前沒有可承諾的日期。上述四款在所讀 JLC 頁面均屬 Extended、SMT、Economic and Standard；設計和供貨仍須審核。

KAQY212S 的 Cosmo 資料表列出 60 V、導通電阻最大 2.5 Ω（IF=10 mA、IL=100 mA），可作低電流按鍵的研究候選。現版光驅動約 5.63–9.76 mA，不能直接沿用 10 mA 的 RON 上限保證；需重新核算實際負載。TLP3122A 是 1/3/4/6 腳，不能把 SOP-4 接成相同焊盤。CPC1017N 目前只完成成本／庫存初篩，電氣與腳位審查尚未完成。

EL357 便宜得多，但輸出是光電晶體。只有確認主機板按鍵為正電壓上拉、對 GND 短接有效時，才能研究集極接 PWRBTN#／RESET#、射極接該主機 GND 的方案。它不能像雙向 MOS 接點一樣任意交換兩根線。十台主機的輸出側仍各自隔離。

必須量測各主機板按鍵開路電壓、短路電流及低準位門檻，重新核算光輸入電流，驗證溫度、CTR 老化、飽和、關斷漏電與錯接；確認原按鈕並聯和硬體限時仍正常。Everlight 的 VCE(sat) ≤0.2 V 規格條件為 IF=20 mA、IC=1 mA，不能把 IF=5 mA、VCE=5 V 的 CTR 直接當成低準位保證，也不能把現版 5.63–9.76 mA 驅動宣稱已滿足該飽和測試條件。

若最後確認可用 EL357，新增的按鍵光耦加上原有回報光耦共 200 顆／五片，仍在所記錄的 100–299 顆價階。單看 100 個開關零件，五片可省約 $69.98；原零件總額 $224.27 理論上降至約 $154.29。**這只替換開關單價，未計改版所需的驅動／保護元件，也不是新版完整 BOM 或成品報價。** 原 BOM 已用同料號回報光耦，因此有機會再少一種 Extended 上料費，待實際方案重算。

原廠文件：[Cosmo KAQY212 系列資料表](https://datasheet.lcsc.com/lcsc/2207071645_Cosmo-Electronics-KAQY212S_C194898.pdf)、[Everlight EL357N 系列資料表](https://www.everlighteurope.com/custom/files/datasheets/DPC-0000014.pdf)。

## B0505S-1WR3L 的用途

現版是 **HENIPER C20622559** 的 5 V 輸入、標稱 5 V 隔離輸出、1 W 模組。這不是把電壓提高，而是將能量傳到另一個與控制器 GND 不直接相連的電源域；输出不是精密穩壓，所以後面有 HT7533-1 產生 3.3 V。

每個主機通道的接法：

```text
控制板 5 V / GND
        │
   B0505S 隔離 DC/DC
        │
  該主機隔離 5 V / HOST_REF
        │
   HT7533-1 → 3.3 V
        │
   LM393 比較器讀取 POWER / HDD LED
        │
   EL357 光耦 → 控制器讀取狀態
```

十顆都在中央板，每個隔離輸出只接對應主機的 HOST_REF。這讓高阻抗感測器可以少取主機 LED 接腳的電流，並避免中央板額外連接十台訊號地。設備的保護接地／機殼仍可能在外部相連，不能宣稱整個機櫃完全浮接。

TLP3122A 的光輸入由控制器側 PHOTO_5V 供電，輸出直接並聯在按鈕兩端；**只做遠端 POWER／RESET 不需要 B0505S**。隔離電源是現版主動式 LED 感測的選擇，不是所有遠端按鍵控制器的必備元件。

要保留 LED 監測又刪除這十顆，需另設計無獨立供電的隔離感測方式，例如評估 LED 線路能否提供光耦所需電流。這會增加 LED 接腳負載，可能影響原燈亮度與低電流／短脈波偵測；主機板型號、電流和實測仍缺，不能承諾通用。不能直接將十路 HOST_REF 短接，也不能只刪電源而留原感測器。

原 BOM 五片採購 50 顆，單價 $0.6035；每片十顆約 $6.04，五片約 $30.18。這僅是模組費，周邊 LDO／電容另计。價格基準為 2026-10-13 的代貼庫觀察，非本日成交承諾；[JLC 料號頁](https://jlcpcb.com/partdetail/HENIPER-B0505S1WR3L/C20622559)可能已顯示不同價階。其他廠牌有同名型號，不能以另一品牌的規格或認證代替本料號資料表。
