ddasdkimo/rack-atx-controller/hardware/bom/controller-bom.csv

Designator | Quantity per board | Comment | Manufacturer | MPN | LCSC Part # | Package | Footprint candidate | Library class | Assembly | PCBA mode | Observed stock | Checked at UTC | Source | Notes
J101 | 1 | WJ500V-5.08-2P | Ningbo Kangnex Elec | WJ500V-5.08-2P | C8465 | Plugin,P=5.08mm | RackATX:WJ500V_5.08_2P | Extended | Wave Soldering | Economic and Standard | 261906 | 2026-10-13T15:48:15.997975+00:00 | https://jlcpcb.com/partdetail/C8465 | Drawing/library candidate used in S.3; physical footprint and assembly DFM qualification pending.
F1 | 1 | MF-MSMF150/24X-2 1.5A | BOURNS | MF-MSMF150/24X-2 | C78695 | 1812 | Fuse:Fuse_1812_4532Metric | Extended | SMT Assembly | Economic and Standard | 6223 | 2026-10-13T15:22:31.648916+00:00 | https://jlcpcb.com/partdetail/C78695
Q1,Q4 | 2 | AO3401A | Alpha & Omega Semicon | AO3401A | C15127 | SOT-23 | Package_TO_SOT_SMD:SOT-23 | Basic | SMT Assembly | Economic and Standard | 631158 | 2026-10-13T15:24:52.156424+00:00 | https://jlcpcb.com/partdetail/C15127
C1,C14,C15,C27,C29 | 5 | 10u | Samsung Electro-Mechanics | CL21A106KAYNNNE | C15850 | 0805 | Capacitor_SMD:C_0805_2012Metric | Basic | SMT Assembly | Economic and Standard | 4003857 | 2026-10-13T15:20:39.544599+00:00 | https://jlcpcb.com/partdetail/C15850
C2,C3,C6,C8,C9,C10,C11,C12,C13,C24,C25,C26,C28,C37,C38,C39,C42 | 17 | 100n | YAGEO | CC0603KRX7R9BB104 | C14663 | 0603 | Capacitor_SMD:C_0603_1608Metric | Basic | SMT Assembly | Economic and Standard | 53307896 | 2026-10-13T15:20:39.536320+00:00 | https://jlcpcb.com/partdetail/C14663
U1 | 1 | AP63203WU-7 | Diodes Incorporated | AP63203WU-7 | C780769 | TSOT-23-6 | Package_TO_SOT_SMD:TSOT-23-6 | Extended | SMT Assembly | Economic and Standard | 8099 | 2026-10-13T15:15:58.092399+00:00 | https://jlcpcb.com/partdetail/C780769
L1 | 1 | 4.7uH FNR4018S4R7MT | cjiang (Changjiang Microelectronics Tech) | FNR4018S4R7MT | C167806 | SMD,4x4mm | Inductor_SMD:L_Changjiang_FNR4018S | Extended | SMT Assembly | Economic and Standard | 7188 | 2026-10-13T15:18:09.856125+00:00 | https://jlcpcb.com/partdetail/C167806 | Drawing/library candidate used in S.3; physical footprint and assembly DFM qualification pending.
C4,C5 | 2 | 22u | Samsung Electro-Mechanics | CL21A226MAQNNNE | C45783 | 0805 | Capacitor_SMD:C_0805_2012Metric | Basic | SMT Assembly | Economic and Standard | 3454275 | 2026-10-13T15:15:59.158144+00:00 | https://jlcpcb.com/partdetail/C45783
U2 | 1 | ESP32-S3FN8 | Espressif Systems | ESP32-S3FN8 | C2913196 | QFN-56-EP(7x7) | RackATX:ESP32_S3_QFN56_EP4_16Window | Extended | SMT Assembly | Economic and Standard | 2345 | 2026-10-13T15:12:40.649680+00:00 | https://jlcpcb.com/partdetail/C2913196
C7,C16,C30 | 3 | 1u | Samsung Electro-Mechanics | CL10A105KB8NNNC | C15849 | 0603 | Capacitor_SMD:C_0603_1608Metric | Basic | SMT Assembly | Economic and Standard | 10311730 | 2026-10-13T15:46:51.366149+00:00 | https://jlcpcb.com/partdetail/C15849
R1,R2,R3,R4,R15,R16,R17,R25,R27,R28,R30,R33,R37,R35,R36 | 15 | 10k 1% | UNI-ROYAL(Uniroyal Elec) | 0603WAF1002T5E | C25804 | 0603 | Resistor_SMD:R_0603_1608Metric | Basic | SMT Assembly | Economic and Standard | 31975394 | 2026-10-13T15:10:20.790070+00:00 | https://jlcpcb.com/partdetail/C25804
J102,J103 | 2 | PZ254V-11-02P | XFCN | PZ254V-11-02P | C492401 | Plugin,P=2.54mm | Connector_PinHeader_2.54mm:PinHeader_1x02_P2.54mm_Vertical | Extended | Wave Soldering | Economic and Standard | 1143383 | 2026-10-13T15:31:20.503576+00:00 | https://jlcpcb.com/partdetail/C492401
Y1 | 1 | 40MHz CL12pF | YXC Crystal Oscillators | XL2EL89COI-111YLC-40M | C18214314 | SMD3225-4P | Crystal:Crystal_SMD_3225-4Pin_3.2x2.5mm | Extended | SMT Assembly | Economic and Standard | 31425 | 2026-10-13T15:20:35.889069+00:00 | https://jlcpcb.com/partdetail/C18214314
R5,R24 | 2 | 0 1% | UNI-ROYAL(Uniroyal Elec) | 0603WAF0000T5E | C21189 | 0603 | Resistor_SMD:R_0603_1608Metric | Basic | SMT Assembly | Economic and Standard | 24624745 | 2026-10-13T15:20:39.483336+00:00 | https://jlcpcb.com/partdetail/C21189
C17,C18,C31,C32 | 4 | 20p | Samsung Electro-Mechanics | CL10C200JB8NNNC | C1648 | 0603 | Capacitor_SMD:C_0603_1608Metric | Basic | SMT Assembly | Economic and Standard | 1984484 | 2026-10-13T15:22:34.155368+00:00 | https://jlcpcb.com/partdetail/C1648
R6,R7 | 2 | 47 1% | UNI-ROYAL(Uniroyal Elec) | 0603WAF470JT5E | C23182 | 0603 | Resistor_SMD:R_0603_1608Metric | Basic | SMT Assembly | Economic and Standard | 971973 | 2026-10-13T15:11:27.450515+00:00 | https://jlcpcb.com/partdetail/C23182
J104 | 1 | TYPE-C-31-M-12 | Korean Hroparts Elec | TYPE-C-31-M-12 | C165948 | SMD | Connector_USB:USB_C_Receptacle_HRO_TYPE-C-31-M-12 | Extended | SMT Assembly | Economic and Standard | 398485 | 2026-10-13T15:11:33.015832+00:00 | https://jlcpcb.com/partdetail/C165948
D1 | 1 | PRTR5V0U2X,215 | Nexperia | PRTR5V0U2X,215 | C12333 | SOT-143 | Package_TO_SOT_SMD:SOT-143 | Extended | SMT Assembly | Economic and Standard | 23665 | 2026-10-13T15:24:52.166312+00:00 | https://jlcpcb.com/partdetail/C12333
R8,R9 | 2 | 5.1k 1% | UNI-ROYAL(Uniroyal Elec) | 0603WAF5101T5E | C23186 | 0603 | Resistor_SMD:R_0603_1608Metric | Basic | SMT Assembly | Economic and Standard | 24076196 | 2026-10-13T15:22:33.103748+00:00 | https://jlcpcb.com/partdetail/C23186
R10,R11 | 2 | 33 1% | UNI-ROYAL(Uniroyal Elec) | 0603WAF330JT5E | C23140 | 0603 | Resistor_SMD:R_0603_1608Metric | Basic | SMT Assembly | Economic and Standard | 5175876 | 2026-10-13T15:41:21.024471+00:00 | https://jlcpcb.com/partdetail/C23140
R12,R13,R26,R29,R31,R32,RT1,RT2,RT3,RT4,R34,R38,R40,R44,R48,R52,R56,R60,R64,R68,R72,R76,R80,R84,R88,R92,R96,R100,R104,R108,R112,R116 | 32 | 100k 1% | UNI-ROYAL(Uniroyal Elec) | 0603WAF1003T5E | C25803 | 0603 | Resistor_SMD:R_0603_1608Metric | Basic | SMT Assembly | Economic and Standard | 20296056 | 2026-10-13T15:11:26.198973+00:00 | https://jlcpcb.com/partdetail/C25803
U3 | 1 | W5500 | WIZNET | W5500 | C32843 | LQFP-48_7x7 | Package_QFP:LQFP-48_7x7mm_P0.5mm | Extended | SMT Assembly | Economic and Standard | 15204 | 2026-10-13T15:20:39.517626+00:00 | https://jlcpcb.com/partdetail/C32843
L2 | 1 | 120R@100MHz GZ1608D121TF | Sunlord | GZ1608D121TF | C12391 | 0603 | Inductor_SMD:L_0603_1608Metric | Extended | SMT Assembly | Economic and Standard | 211674 | 2026-10-13T15:31:21.203168+00:00 | https://jlcpcb.com/partdetail/C12391
R14 | 1 | 12.4k 1% | UNI-ROYAL(Uniroyal Elec) | 0603WAF1242T5E | C22865 | 0603 | Resistor_SMD:R_0603_1608Metric | Extended | SMT Assembly | Economic and Standard | 199175 | 2026-10-13T15:22:32.998707+00:00 | https://jlcpcb.com/partdetail/C22865
C19 | 1 | 4.7u | Samsung Electro-Mechanics | CL10A475KO8NNNC | C19666 | 0603 | Capacitor_SMD:C_0603_1608Metric | Basic | SMT Assembly | Economic and Standard | 3207024 | 2026-10-13T15:24:52.182713+00:00 | https://jlcpcb.com/partdetail/C19666
C20 | 1 | 10n | FH (Guangdong Fenghua Advanced Tech) | 0603B103K500NT | C57112 | 0603 | Capacitor_SMD:C_0603_1608Metric | Basic | SMT Assembly | Economic and Standard | 6247556 | 2026-10-13T15:22:34.255431+00:00 | https://jlcpcb.com/partdetail/C57112
C21,C22,C23 | 3 | 100n | Samsung Electro-Mechanics | CL05B104KO5NNNC | C1525 | 0402 | Capacitor_SMD:C_0402_1005Metric | Basic | SMT Assembly | Economic and Standard | 22967367 | 2026-10-14T16:55:03.091408+00:00 | https://jlcpcb.com/partdetail/C1525 | R.3 compact Ethernet group; nominal value unchanged. Factory DFM and prototype verification pending.
Y2 | 1 | 25MHz CL12pF | YXC Crystal Oscillators | X322525MOB4SI | C9006 | SMD3225-4P | Crystal:Crystal_SMD_3225-4Pin_3.2x2.5mm | Basic | SMT Assembly | Economic and Standard | 181710 | 2026-10-13T15:18:09.304055+00:00 | https://jlcpcb.com/partdetail/C9006
R18,R19 | 2 | 49.9 1% | UNI-ROYAL(Uniroyal Elec) | 0603WAF499JT5E | C23185 | 0603 | Resistor_SMD:R_0603_1608Metric | Basic | SMT Assembly | Economic and Standard | 1972323 | 2026-10-13T15:24:51.215319+00:00 | https://jlcpcb.com/partdetail/C23185
R20,R21 | 2 | 49.9 1% | UNI-ROYAL(Uniroyal Elec) | 0402WGF499JTCE | C25120 | 0402 | Resistor_SMD:R_0402_1005Metric | Basic | SMT Assembly | Economic and Standard | 1309179 | 2026-10-14T16:55:02.995713+00:00 | https://jlcpcb.com/partdetail/C25120 | R.3 compact Ethernet group; nominal value unchanged. Factory DFM and prototype verification pending.
C33 | 1 | 10n | Samsung Electro-Mechanics | CL05B103KB5NNNC | C15195 | 0402 | Capacitor_SMD:C_0402_1005Metric | Basic | SMT Assembly | Economic and Standard | 6391726 | 2026-10-14T17:10:24.486349+00:00 | https://jlcpcb.com/partdetail/C15195 | R.3 compact Ethernet group; nominal value unchanged. Factory DFM and prototype verification pending.
C34,C35 | 2 | 6.8n | Samsung Electro-Mechanics | CL05B682KB5NNNC | C318580 | 0402 | Capacitor_SMD:C_0402_1005Metric | Extended | SMT Assembly | Economic and Standard | 17120 | 2026-10-14T17:24:25.757374+00:00 | https://jlcpcb.com/partdetail/C318580 | R.3 compact Ethernet group; nominal value unchanged. Factory DFM and prototype verification pending.
C36 | 1 | 22n | Samsung Electro-Mechanics | CL21B223KBANNNC | C1729 | 0805 | Capacitor_SMD:C_0805_2012Metric | Basic | SMT Assembly | Economic and Standard | 325000 | 2026-10-13T15:24:52.121389+00:00 | https://jlcpcb.com/partdetail/C1729
R22,R23,R321,R322 | 4 | 330 1% | UNI-ROYAL(Uniroyal Elec) | 0603WAF3300T5E | C23138 | 0603 | Resistor_SMD:R_0603_1608Metric | Basic | SMT Assembly | Economic and Standard | 3627090 | 2026-10-13T15:12:44.845004+00:00 | https://jlcpcb.com/partdetail/C23138
J105 | 1 | HR911105A | HANRUN(Zhongshan HanRun Elec) | HR911105A | C12074 | Plugin | Connector_RJ:RJ45_Hanrun_HR911105A_Horizontal | Extended | Wave Soldering | Economic and Standard | 48875 | 2026-10-13T15:10:20.801373+00:00 | https://jlcpcb.com/partdetail/C12074
U4,U5,U6 | 3 | 74HC595D,118 | Nexperia | 74HC595D,118 | C5947 | SOIC-16 | Package_SO:SOIC-16_3.9x9.9mm_P1.27mm | Basic | SMT Assembly | Economic and Standard | 296051 | 2026-10-13T15:20:39.527642+00:00 | https://jlcpcb.com/partdetail/C5947
Q2,Q3,Q200,Q5,Q6,Q7,Q8,Q9,Q10,Q11,Q12,Q13,Q14,Q15,Q16,Q17,Q18,Q19,Q20,Q21,Q22,Q23,Q24 | 23 | MMBT3904 | Jiangsu Changjing Electronics Technology Co., Ltd. | MMBT3904(RANGE:100-300) | C20526 | SOT-23 | Package_TO_SOT_SMD:SOT-23 | Basic | SMT Assembly | Economic and Standard | 605058 | 2026-10-13T15:24:52.145924+00:00 | https://jlcpcb.com/partdetail/C20526
U7 | 1 | MC14541BDR2G | onsemi | MC14541BDR2G | C7292 | SOIC-14 | Package_SO:SOIC-14_3.9x8.7mm_P1.27mm | Extended | SMT Assembly | Economic and Standard | 4597 | 2026-10-14T08:46:45.997803+00:00 | https://jlcpcb.com/partdetail/C7292
C40 | 1 | 1n | Samsung Electro-Mechanics | CL10C102JB8NNNC | C163508 | 0603 | Capacitor_SMD:C_0603_1608Metric | Extended | SMT Assembly | Economic and Standard | 483260 | 2026-10-14T08:48:03.275930+00:00 | https://jlcpcb.com/partdetail/C163508
J01,J02,J03,J04,J05,J06,J07,J08,J09,J10 | 10 | S10B-PHDSS(LF)(SN) | JST | S10B-PHDSS(LF)(SN) | C161672 | Push-Pull,P=2mm | Connector_JST:JST_PHD_S10B-PHDSS_2x05_P2.00mm_Horizontal | Extended | Wave Soldering | Economic and Standard | 9875 | 2026-10-13T15:20:39.554597+00:00 | https://jlcpcb.com/partdetail/C161672
R39,R301,R43,R302,R47,R303,R51,R304,R55,R305,R59,R306,R63,R307,R67,R308,R71,R309,R75,R310,R79,R311,R83,R312,R87,R313,R91,R314,R95,R315,R99,R316,R103,R317,R107,R318,R111,R319,R115,R320 | 40 | 1.5k 1% | UNI-ROYAL(Uniroyal Elec) | 0603WAF1501T5E | C22843 | 0603 | Resistor_SMD:R_0603_1608Metric | Basic | SMT Assembly | Economic and Standard | 4314656 | 2026-10-13T15:11:28.820502+00:00 | https://jlcpcb.com/partdetail/C22843
R41,R42,R45,R46,R49,R50,R53,R54,R57,R58,R61,R62,R65,R66,R69,R70,R73,R74,R77,R78,R81,R82,R85,R86,R89,R90,R93,R94,R97,R98,R101,R102,R105,R106,R109,R110,R113,R114,R117,R118 | 40 | 220 1% | UNI-ROYAL(Uniroyal Elec) | 0603WAF2200T5E | C22962 | 0603 | Resistor_SMD:R_0603_1608Metric | Basic | SMT Assembly | Economic and Standard | 2129597 | 2026-10-13T15:12:43.320139+00:00 | https://jlcpcb.com/partdetail/C22962
U8,U9,U10,U11,U12,U13,U14,U15,U16,U17,U18,U19,U20,U21,U22,U23,U24,U25,U26,U27 | 20 | TLP3122A(TPL,E | TOSHIBA | TLP3122A(TPL,E | C4153843 | SOP-4 | RackATX:TLP3122A_11-4M1S | Extended | SMT Assembly | Economic and Standard | 4136 | 2026-10-13T15:20:39.507893+00:00 | https://jlcpcb.com/partdetail/C4153843 | Drawing/library candidate used in S.3; physical footprint and assembly DFM qualification pending.
D101,D102,D103,D104,D105,D106,D107,D108,D109,D110,D111,D112,D113,D114,D115,D116,D117,D118,D119,D120 | 20 | KT-0603R / RED | Hubei KENTO Elec | KT-0603R | C2286 | 0603 | RackATX:LED_0603_1608Metric_CathodeSilk | Basic | SMT Assembly | Economic and Standard | 7949222 | 2026-10-14T15:04:10.920701+00:00 | https://jlcpcb.com/partdetail/C2286 | Local driver indication only, not contact feedback. Basic library; verify brightness and cathode mark in prototype.
D2,D3,D4,D5,D6,D7,D8,D9,D10,D11,D12,D13,D14,D15,D16,D17,D18,D19,D20,D21 | 20 | PESD5V0S2BT | HXY MOSFET | PESD5V0S2BT | C5451656 | SOT-23 | Package_TO_SOT_SMD:SOT-23 | Extended | SMT Assembly | Economic and Standard | 21243 | 2026-10-15T01:56:00+00:00 | https://jlcpcb.com/partdetail/HXYMOSFET-PESD5V0S2BT/C5451656 | HXY bidirectional dual TVS; pin3 host reference, pins1/2 button pair. Leakage envelope: 3-5V active-low, pull-up <=47k; see hxy-button-leakage validation. JLC supplier rotation +180deg; native footprint unchanged.
D201,D202 | 2 | KT-0805G / GREEN | Hubei KENTO Elec | KT-0805G | C2297 | 0805 | RackATX:LED_0805_2012Metric_CathodeSilk | Basic | SMT Assembly | Economic and Standard | 2784392 | 2026-10-14T15:04:11.076033+00:00 | https://jlcpcb.com/partdetail/C2297 | Controller power / output-enable indicator, not host power state. Basic library; verify brightness and cathode mark in prototype.
