ddasdkimo/rack-atx-controller/hardware/validation/qfn-cam-study.png

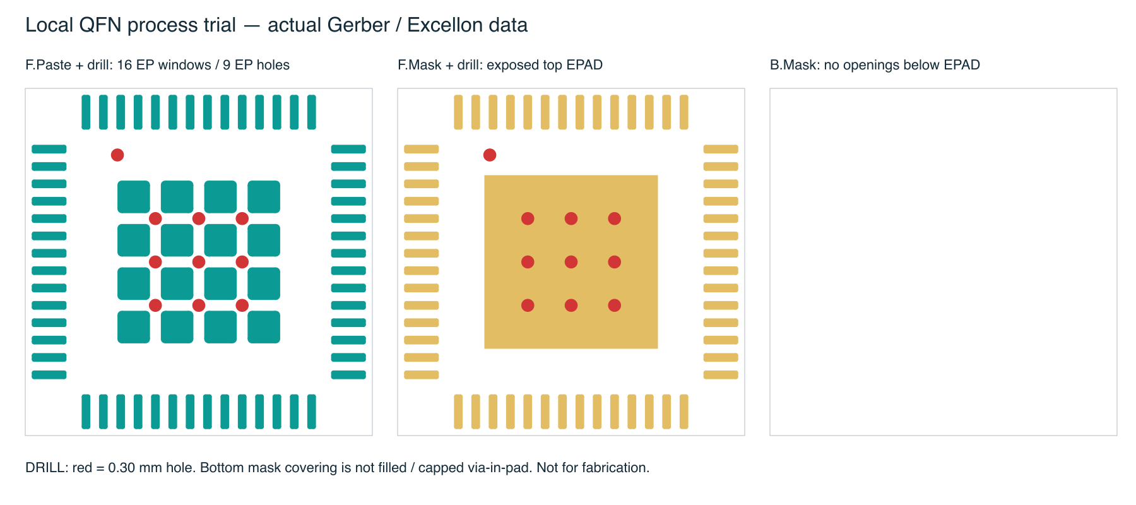
hardware/validation/qfn-cam-study.png
