ddasdkimo/rack-atx-controller/hardware/release/adapter-schematic.pdf

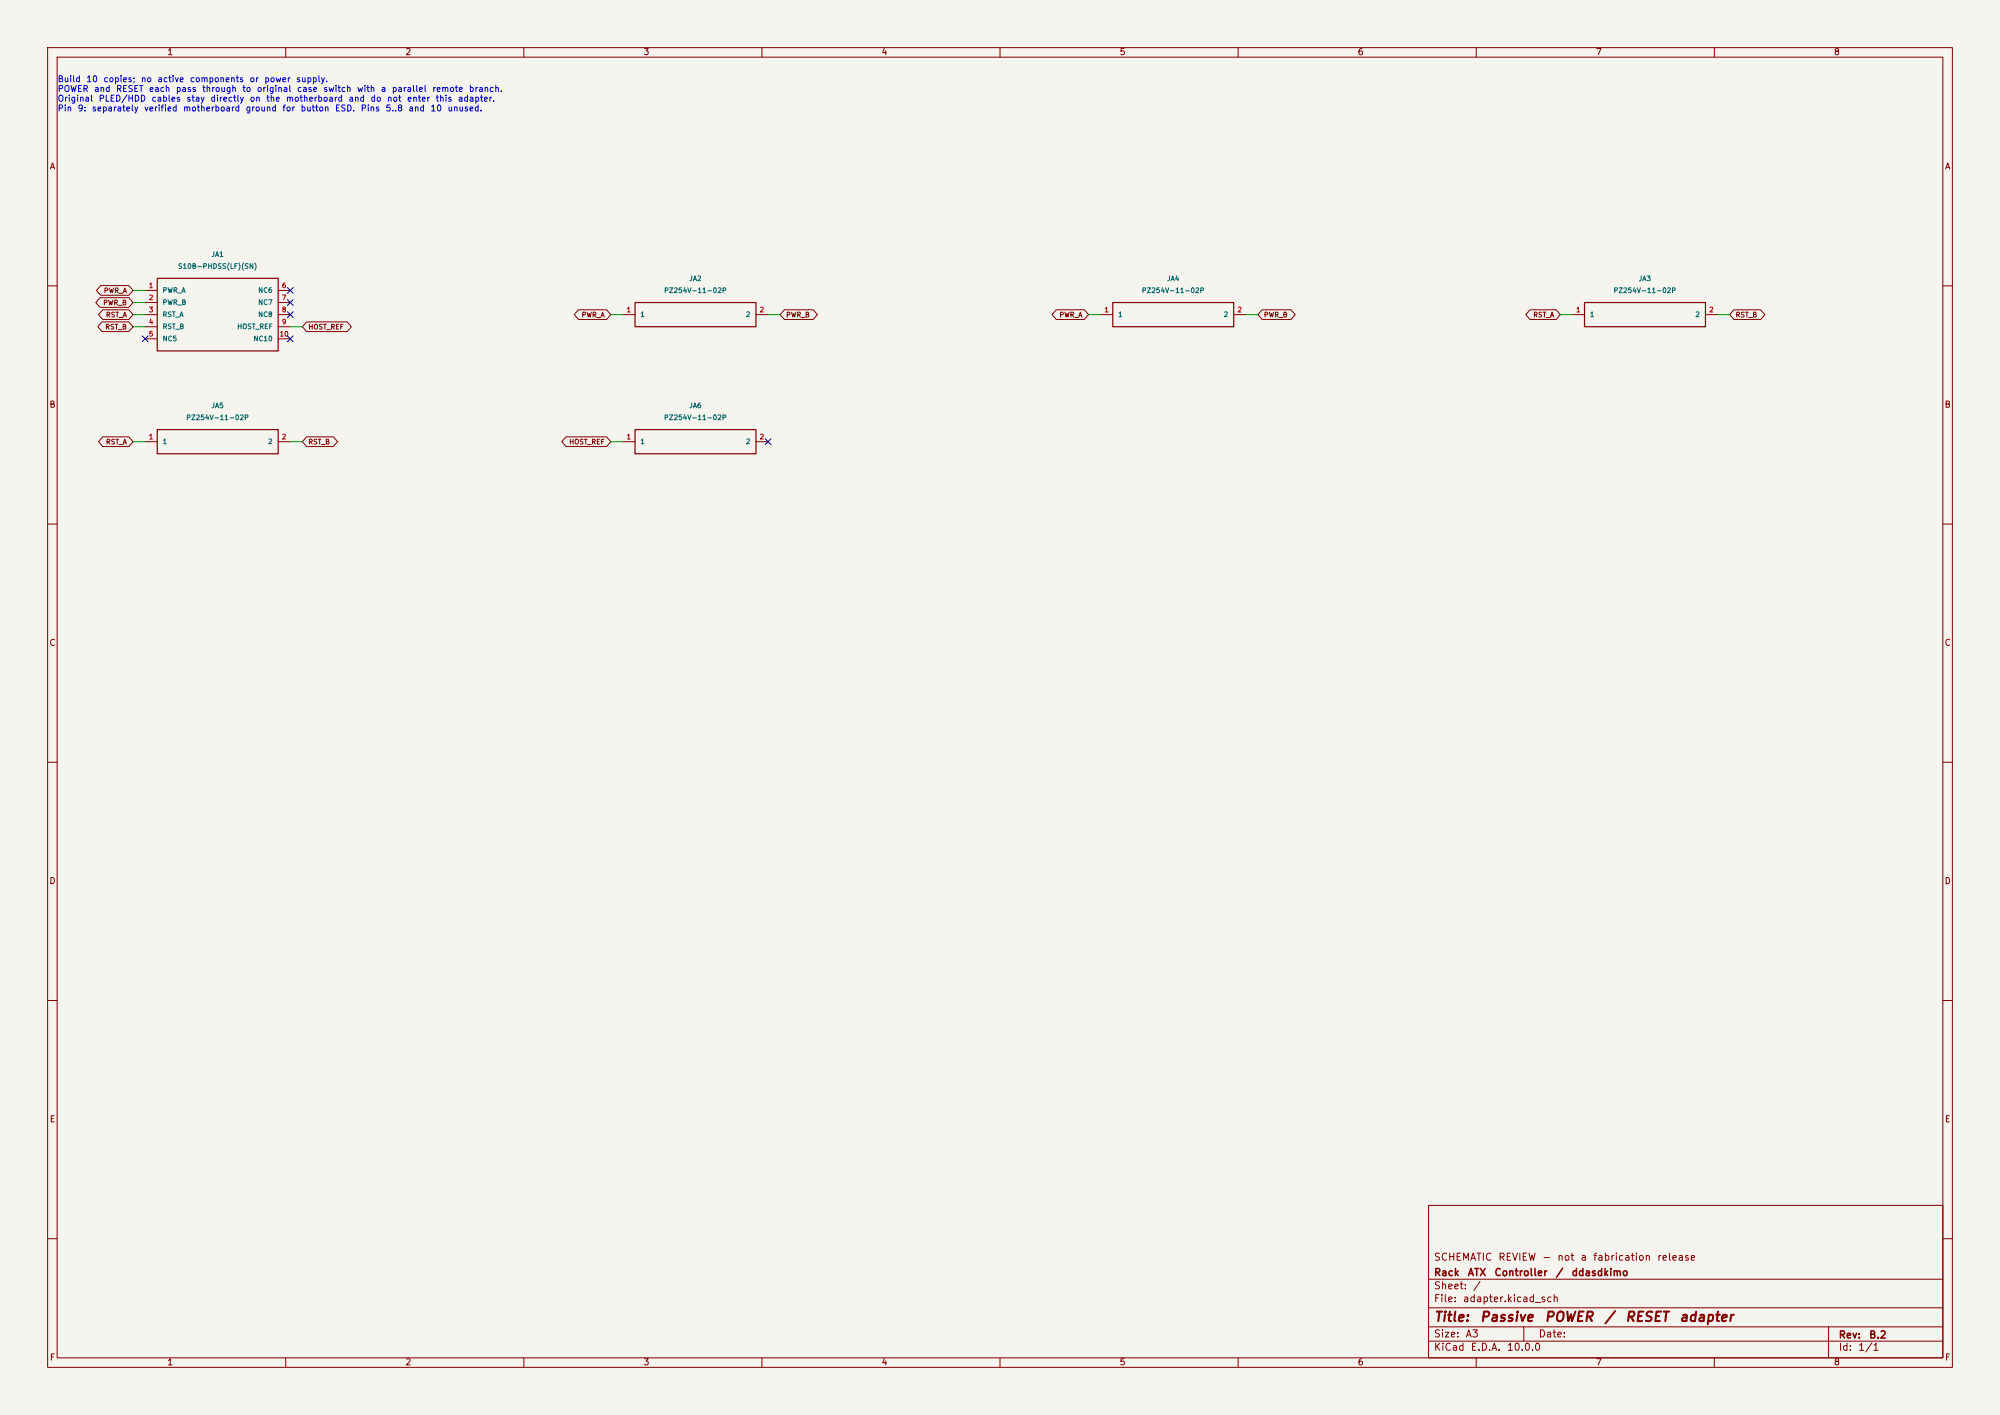
[picture p17: page 1]

POWER and RESET each pass through to original case switch with a parallel remote branch. Original PLED/HDD cables stay directly on the motherboard and do not enter this adapter.

Pin 9: separately verified motherboard ground for button ESD. Pins 5..8 and 10 unused.

Rack ATX Controller / ddasdkimo SCHEMATIC REVIEW - not a fabrication release

Sheet: /
File: adapter.kicad_sch
Title: Passive POWER / RESET adapter

Size: A3 | Rev: B.2 | F Date:
KiCad E.D.A. 10.0.0 | Id: 1/1
