ddasdkimo/rack-atx-controller/hardware/release/controller-schematic.pdf

1 | 2 | 3 | 4 | 5 | 6 | 7 | 8

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
Size: A3 | Rev: B.2 | F Date:
KiCad E.D.A. 10.0.0 | Id: 1/20

# Title: 10-host rack ATX controller

## File: rack-atx-controller.kicad_sch

## Sheet: /

## B.2 circuit - prototype review, not a manufacturing release

W5500 / HR911105A Ethernet (1/3) 檔案： ethernet_1.kicad_sch Output latches / counted timeout (2/2) 檔案： outputs_2.kicad_sch Host 04: POWER / RESET only 檔案： host04.kicad_sch Host 08: POWER / RESET only 檔案： host08.kicad_sch

ESP32-S3FN8 / USB programming (1/2) 檔案： processor_1.kicad_sch W5500 / HR911105A Ethernet (3/3) 檔案： ethernet_3.kicad_sch Host 02: POWER / RESET only 檔案： host02.kicad_sch Host 06: POWER / RESET only 檔案： host06.kicad_sch Host 10: POWER / RESET only 檔案： host10.kicad_sch 5 V input, protection and 3.3 V buck 檔案： power.kicad_sch W5500 / HR911105A Ethernet (2/3) 檔案： ethernet_2.kicad_sch Host 01: POWER / RESET only 檔案： host01.kicad_sch Host 05: POWER / RESET only 檔案： host05.kicad_sch Host 09: POWER / RESET only 檔案： host09.kicad_sch

ESP32-S3FN8 / USB programming (2/2) 檔案： processor_2.kicad_sch Output latches / counted timeout (1/2) 檔案： outputs_1.kicad_sch Host 03: POWER / RESET only 檔案： host03.kicad_sch Host 07: POWER / RESET only 檔案： host07.kicad_sch Controller power and output-enable indicators 檔案： indicators.kicad_sch

B.2: ten hosts, POWER / RESET only. Original case LEDs remain on motherboard.

# 5 V input -> 3.3 V logic; ESP32-S3FN8 + W5500 -> 74HC595 -> twenty isolated dry contacts MC14541B counted timeout + independent ARM gate; no LED sensing or isolated DC/DC

S.3 baseline / R.3 routing and package updates; factory DFM and prototype verification pending

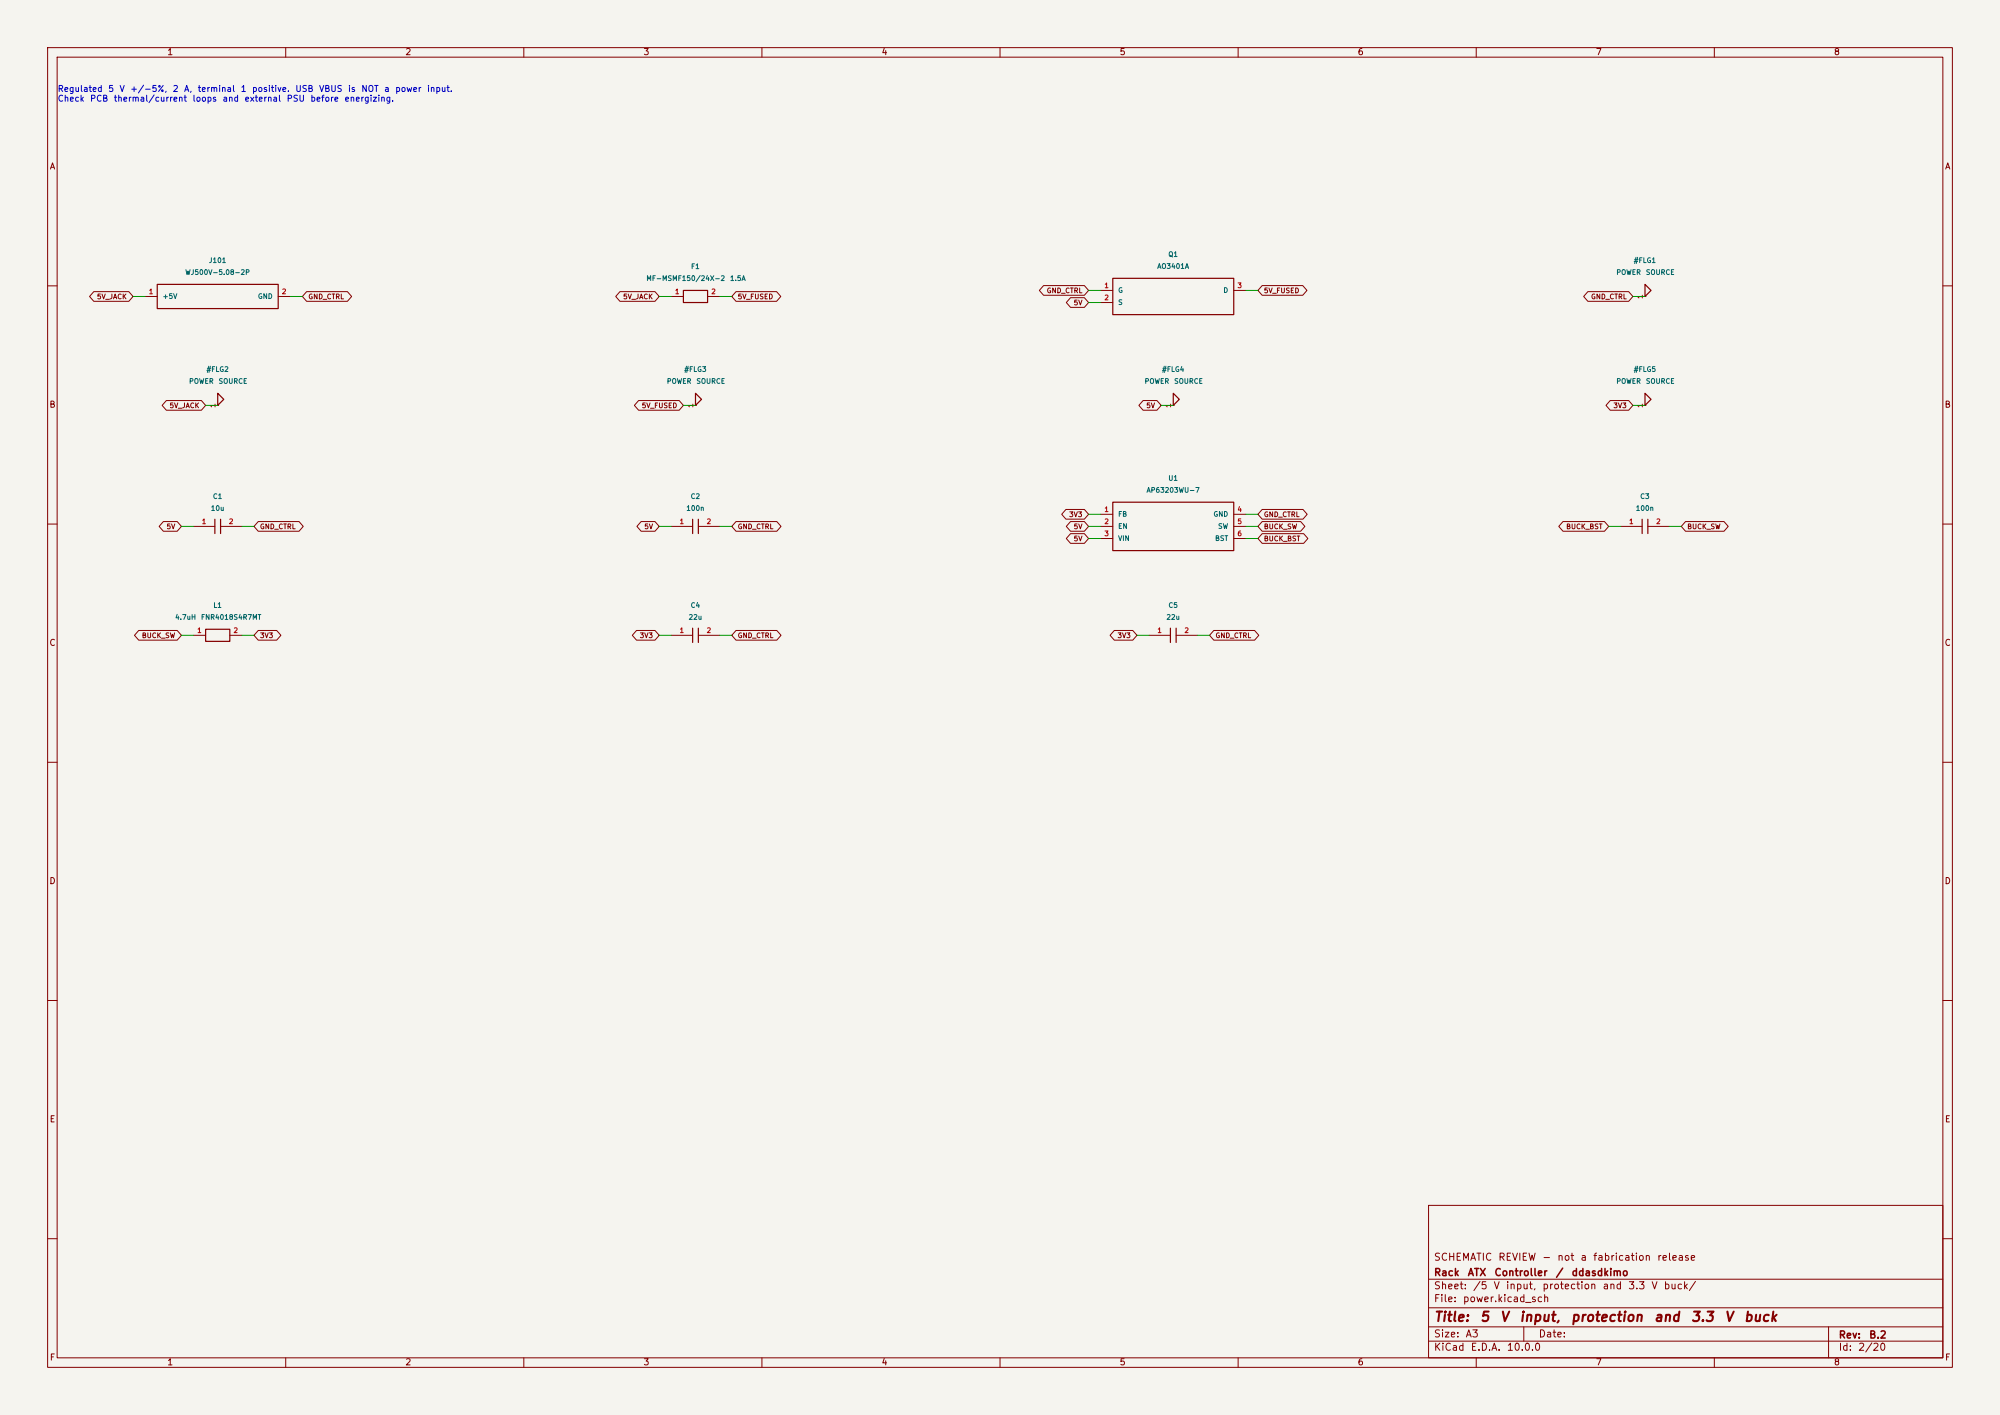
[picture p18: page 2]

Check PCB thermal/current loops and external PSU before energizing.

Rack ATX Controller / ddasdkimo SCHEMATIC REVIEW - not a fabrication release

Sheet: /5 V input, protection and 3.3 V buck/
File: power.kicad_sch
Title: 5 V input, protection and 3.3 V buck

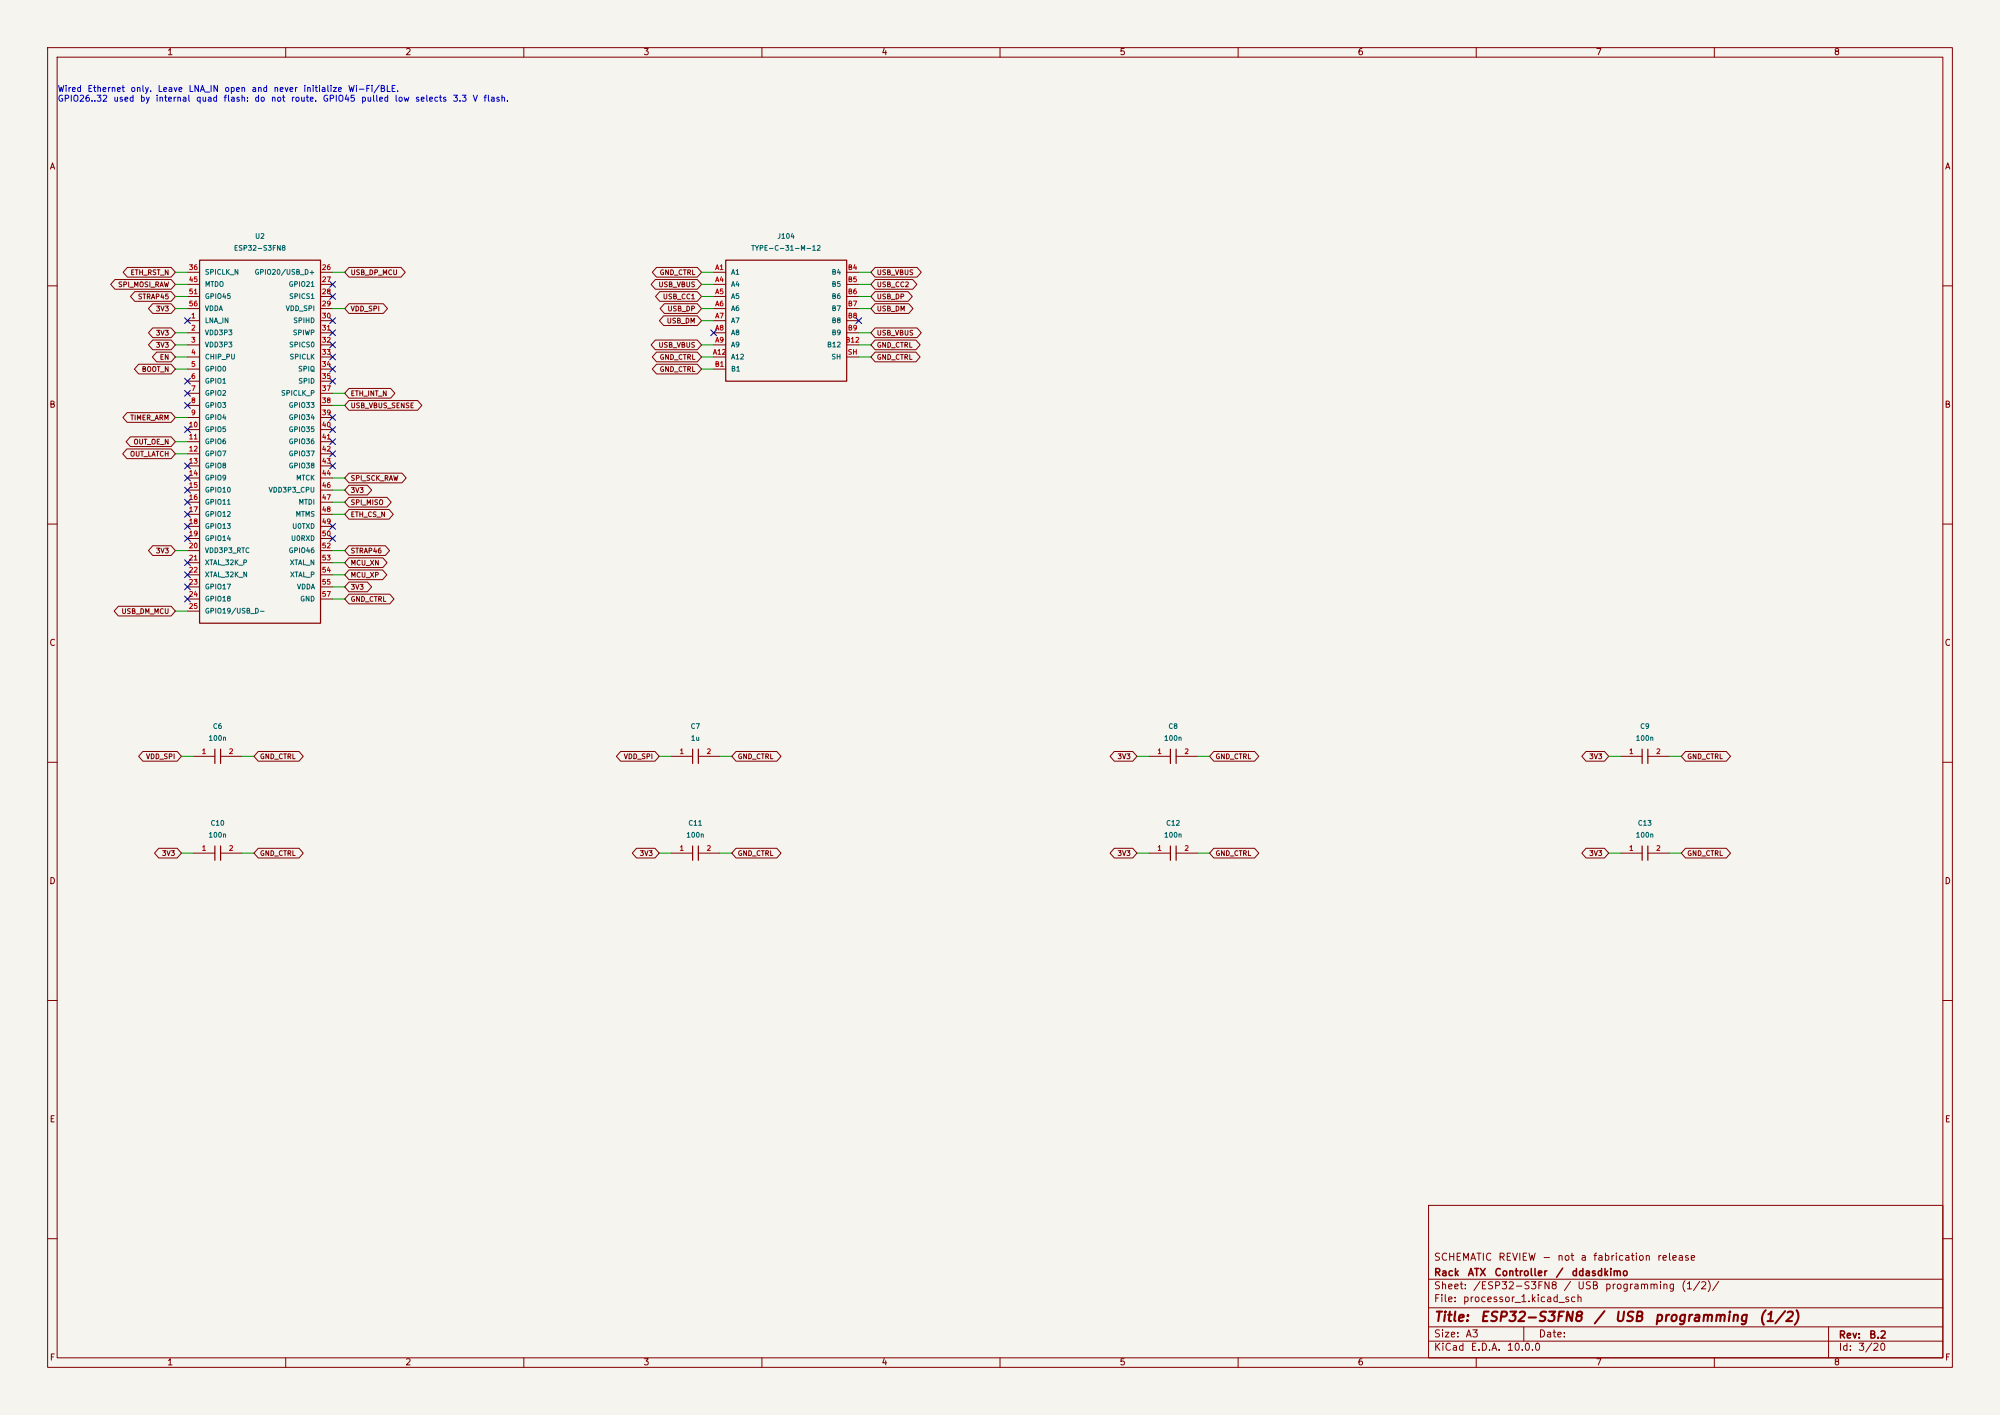
[picture p19: page 3]

GND_CTRL GND_CTRL 3V3 Wired Ethernet only. Leave LNA_IN open and never initialize Wi-Fi/BLE.
GPIO26..32 used by internal quad flash: do not route. GPIO45 pulled low selects 3.3 V flash.
LNA_IN 1
VDD3P3 2

Rack ATX Controller / ddasdkimo SCHEMATIC REVIEW - not a fabrication release

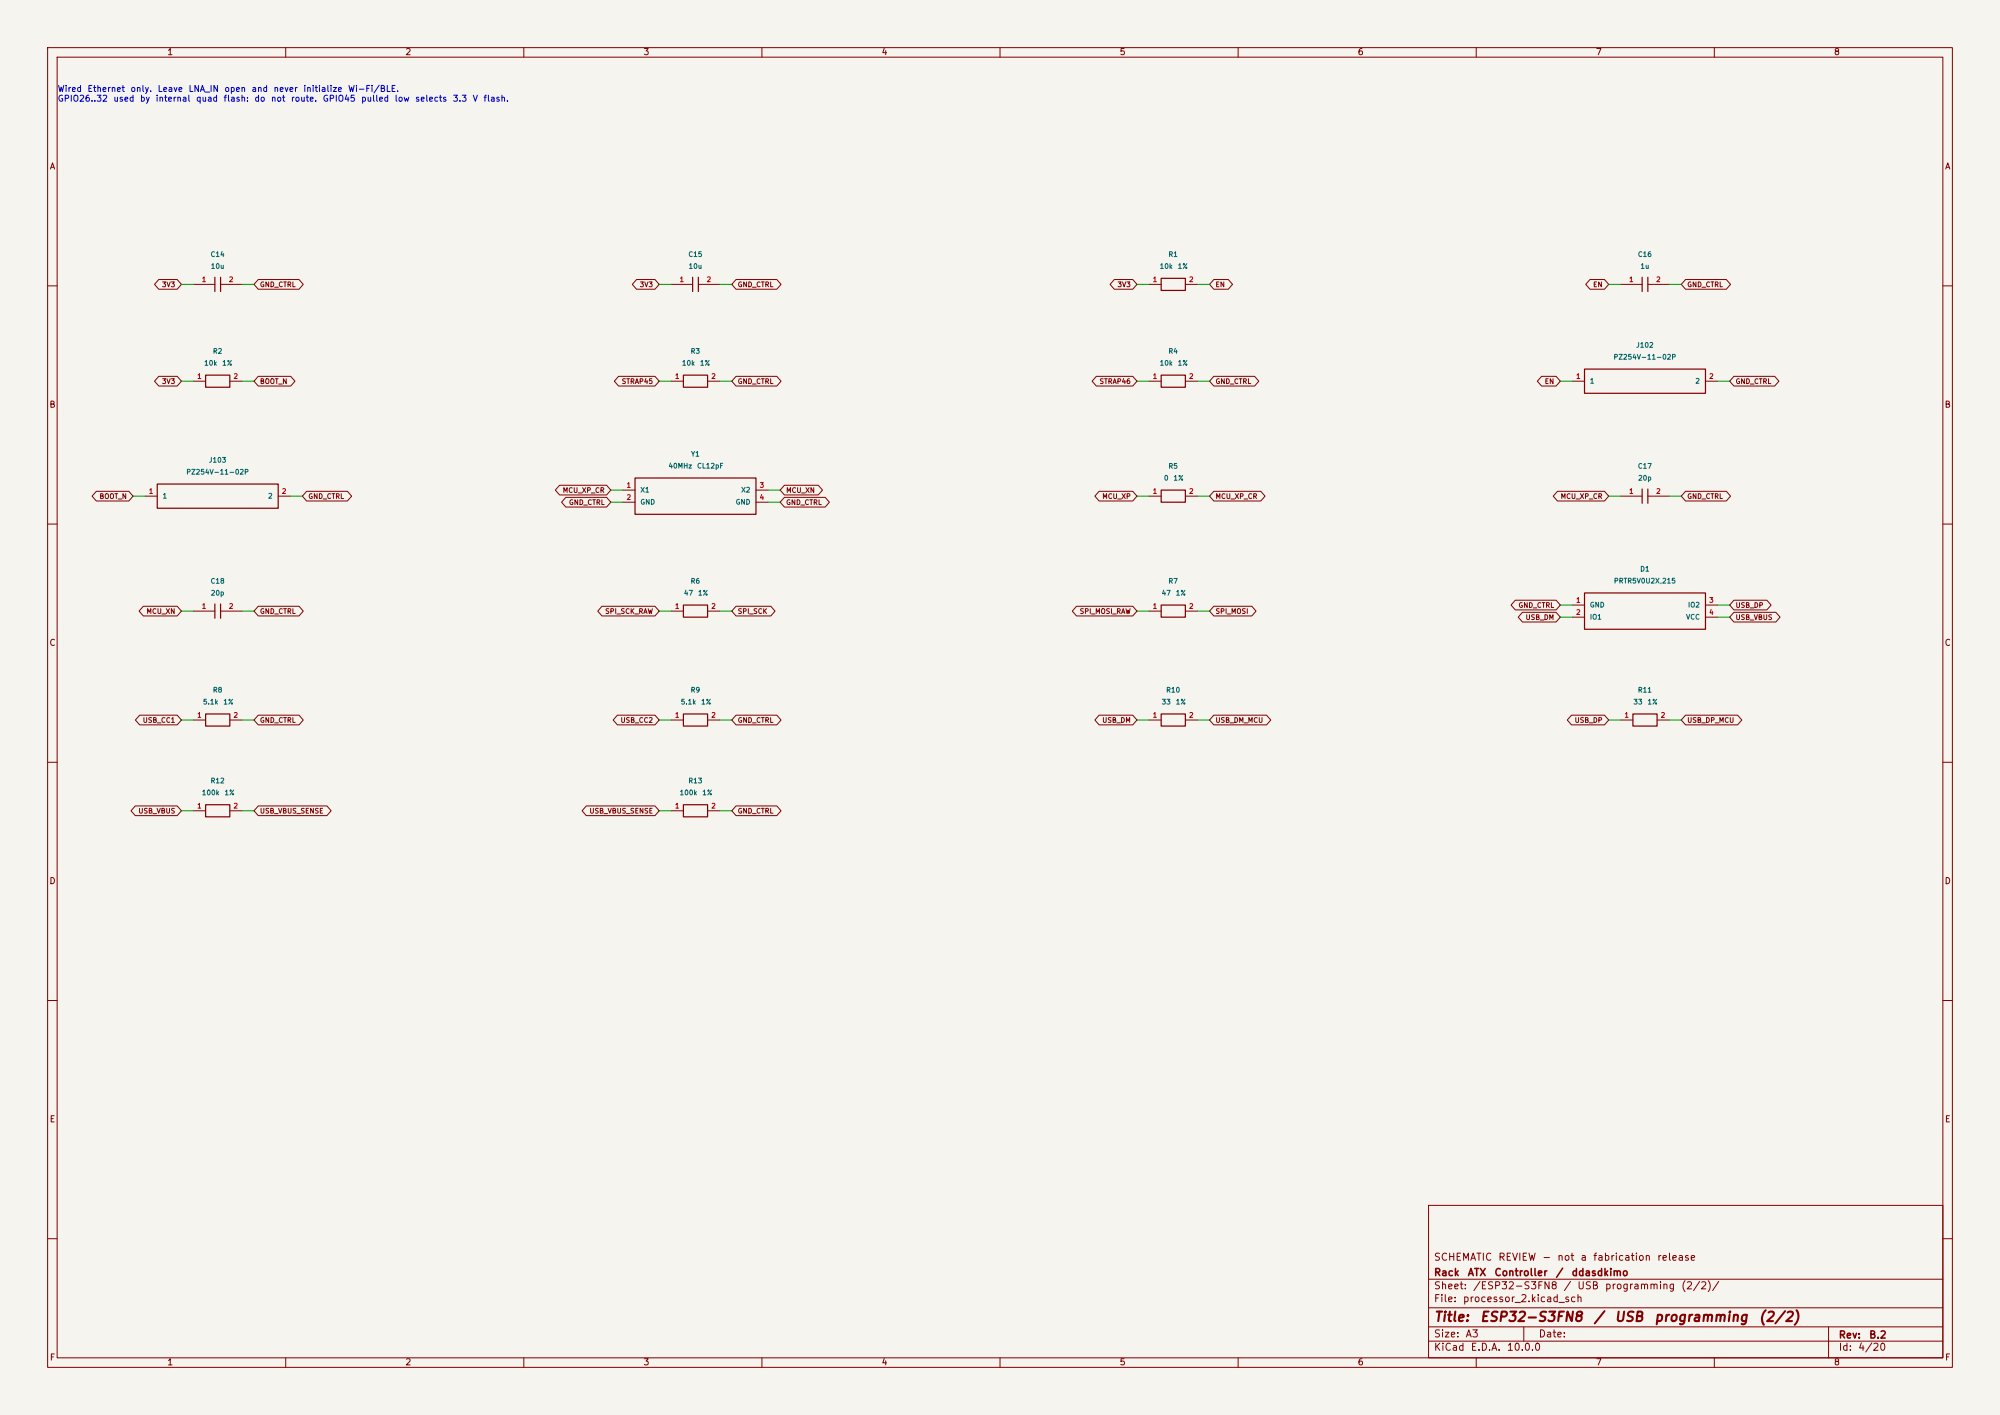
[picture p20: page 4]
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

Rack ATX Controller / ddasdkimo SCHEMATIC REVIEW - not a fabrication release

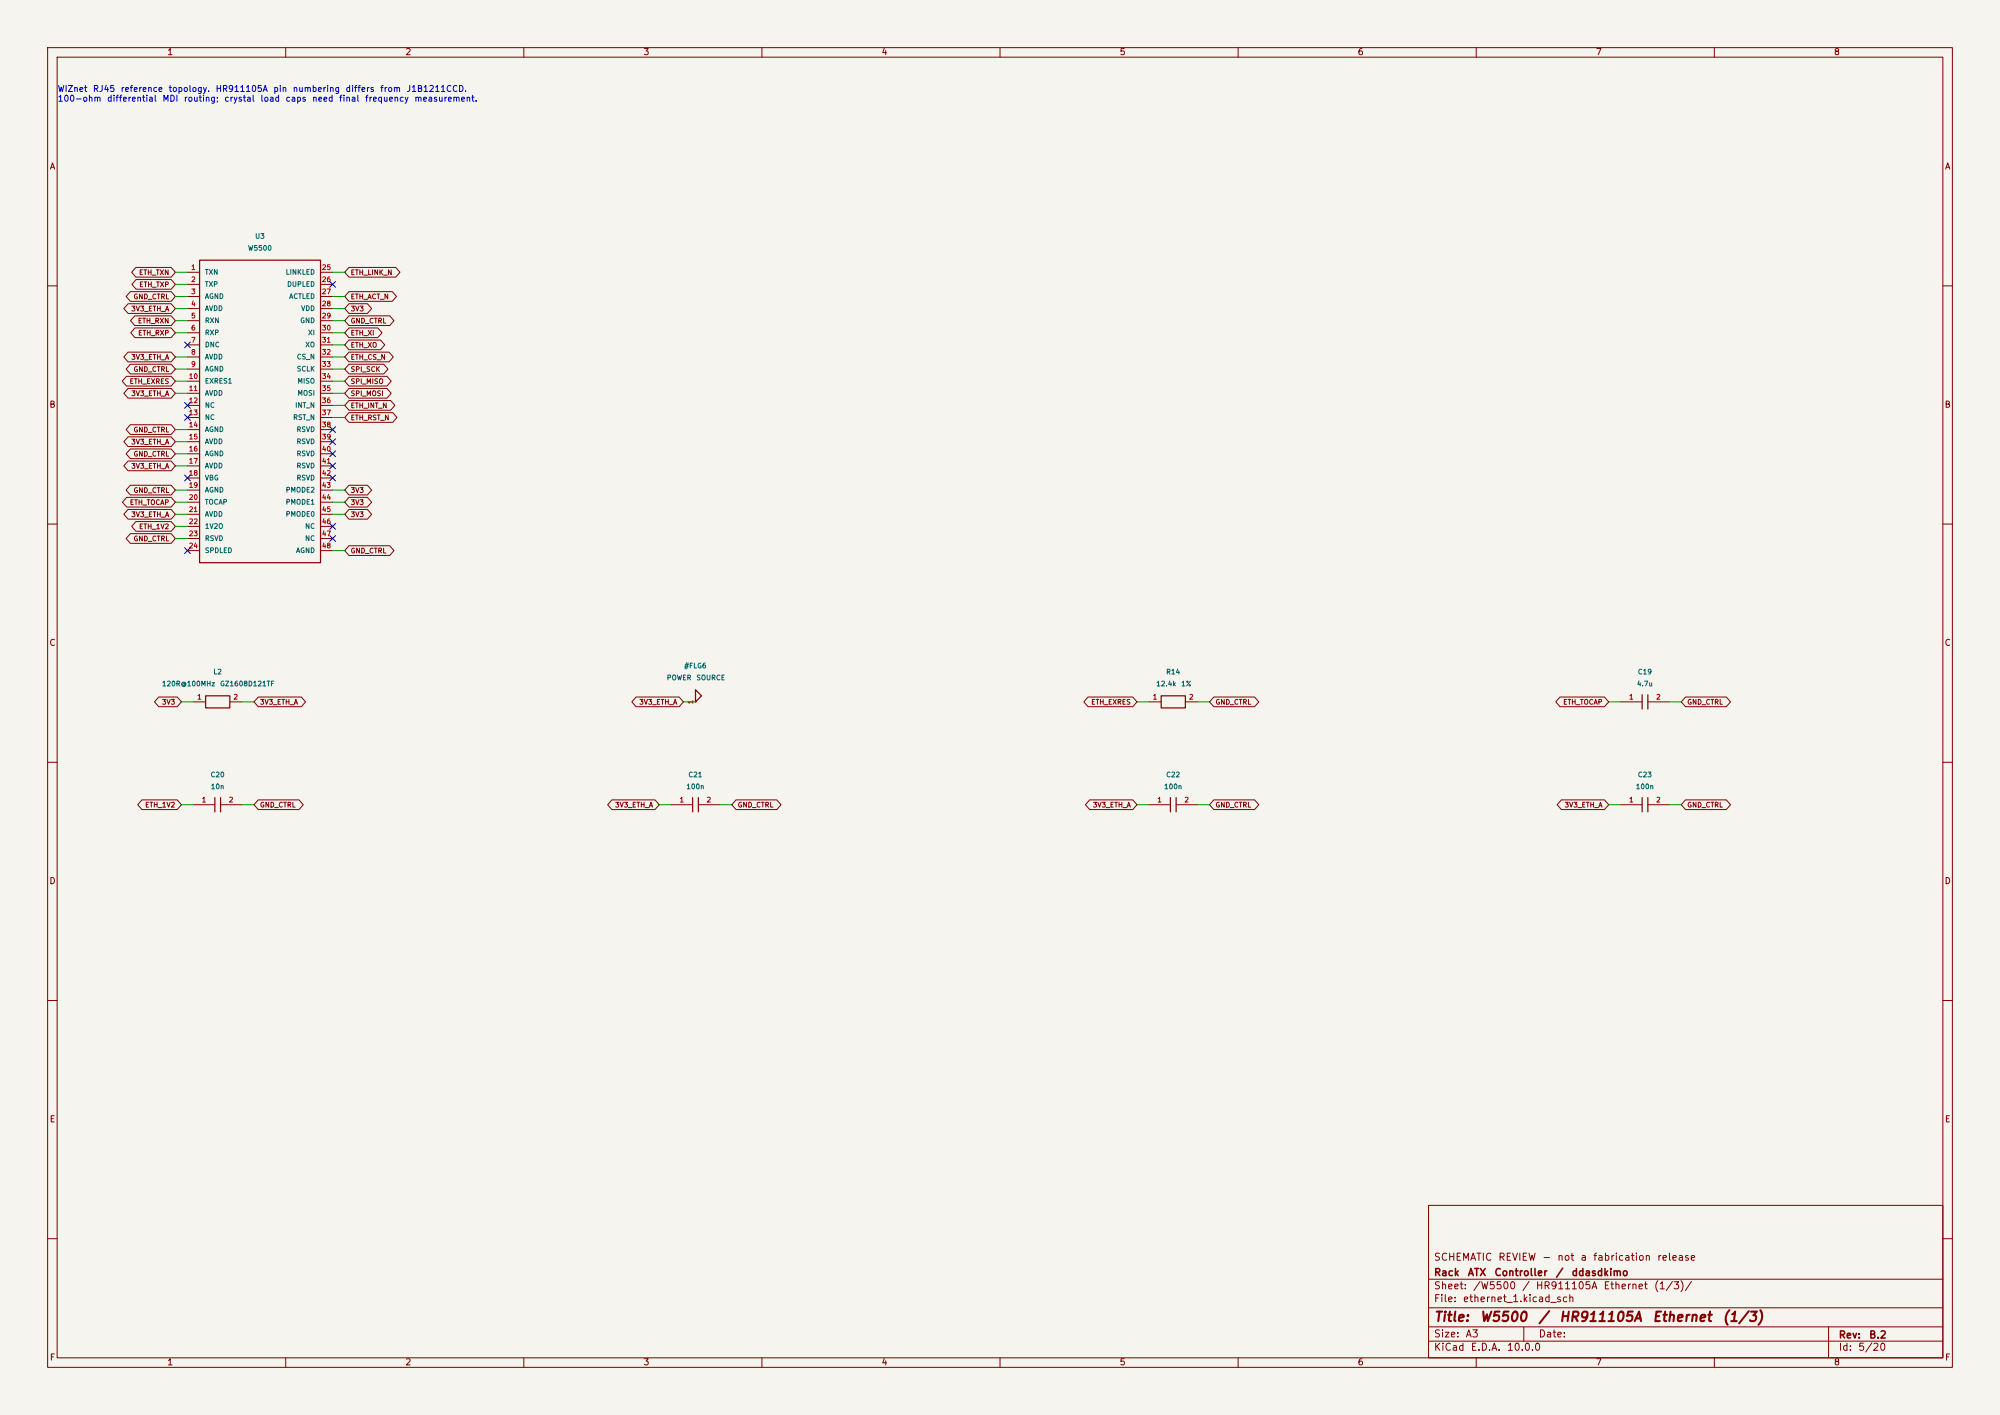
[picture p21: page 5]

WIZnet RJ45 reference topology. HR911105A pin numbering differs from J1B1211CCD. 100-ohm differential MDI routing; crystal load caps need final frequency measurement.
GND_CTRL 3V3_ETH_A GND_CTRL 3V3_ETH_A GND_CTRL 3V3_ETH_A GND_CTRL ETH_TOCAP

Rack ATX Controller / ddasdkimo SCHEMATIC REVIEW - not a fabrication release

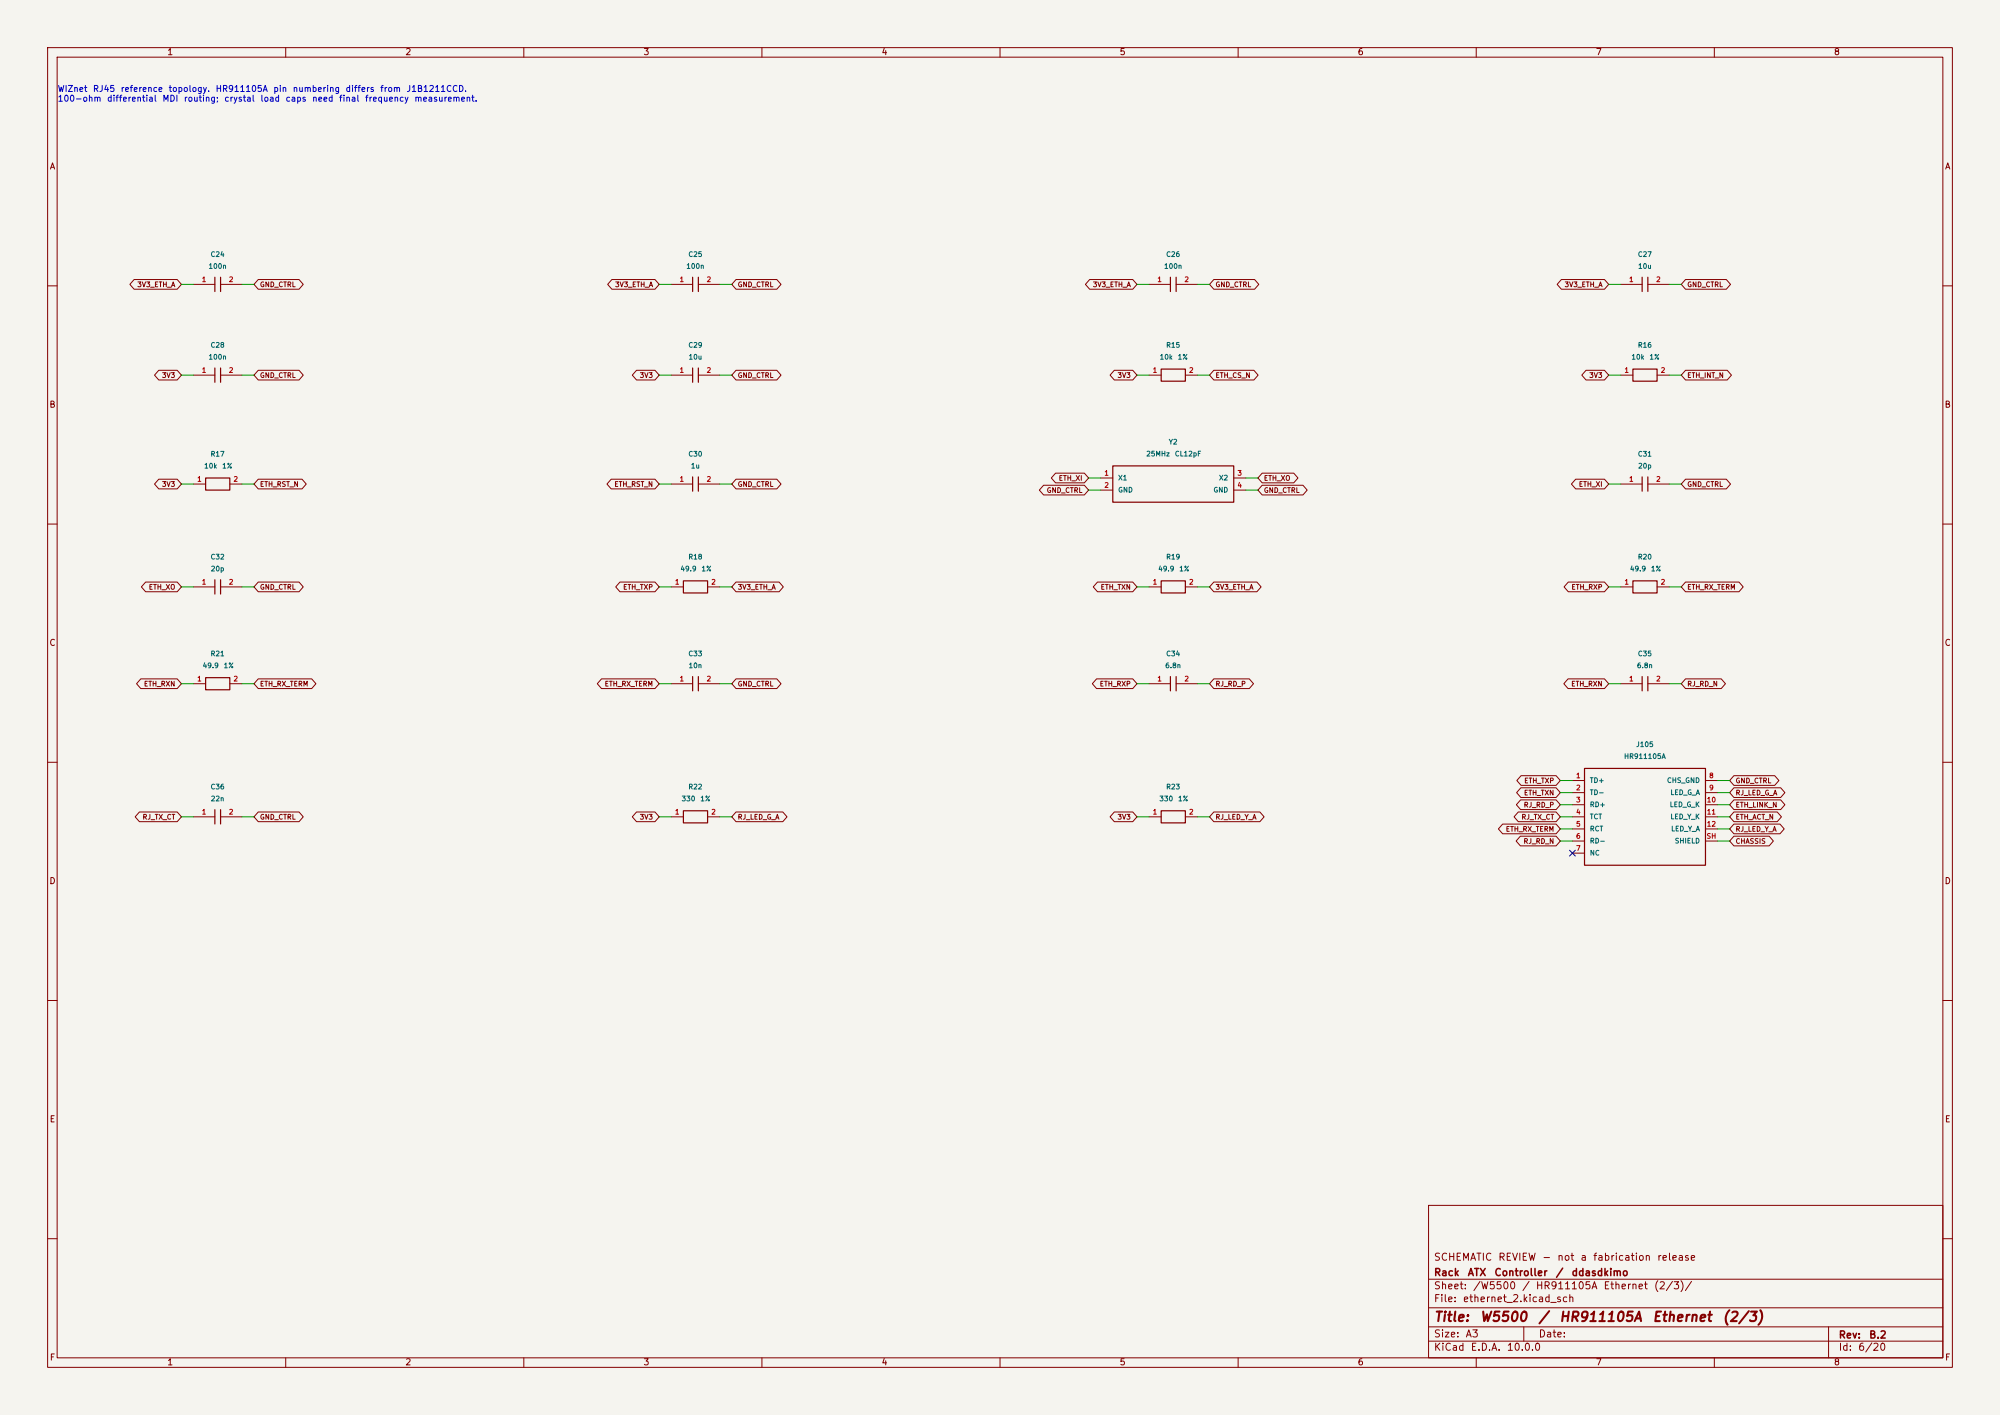
[picture p22: page 6]

Rack ATX Controller / ddasdkimo SCHEMATIC REVIEW - not a fabrication release

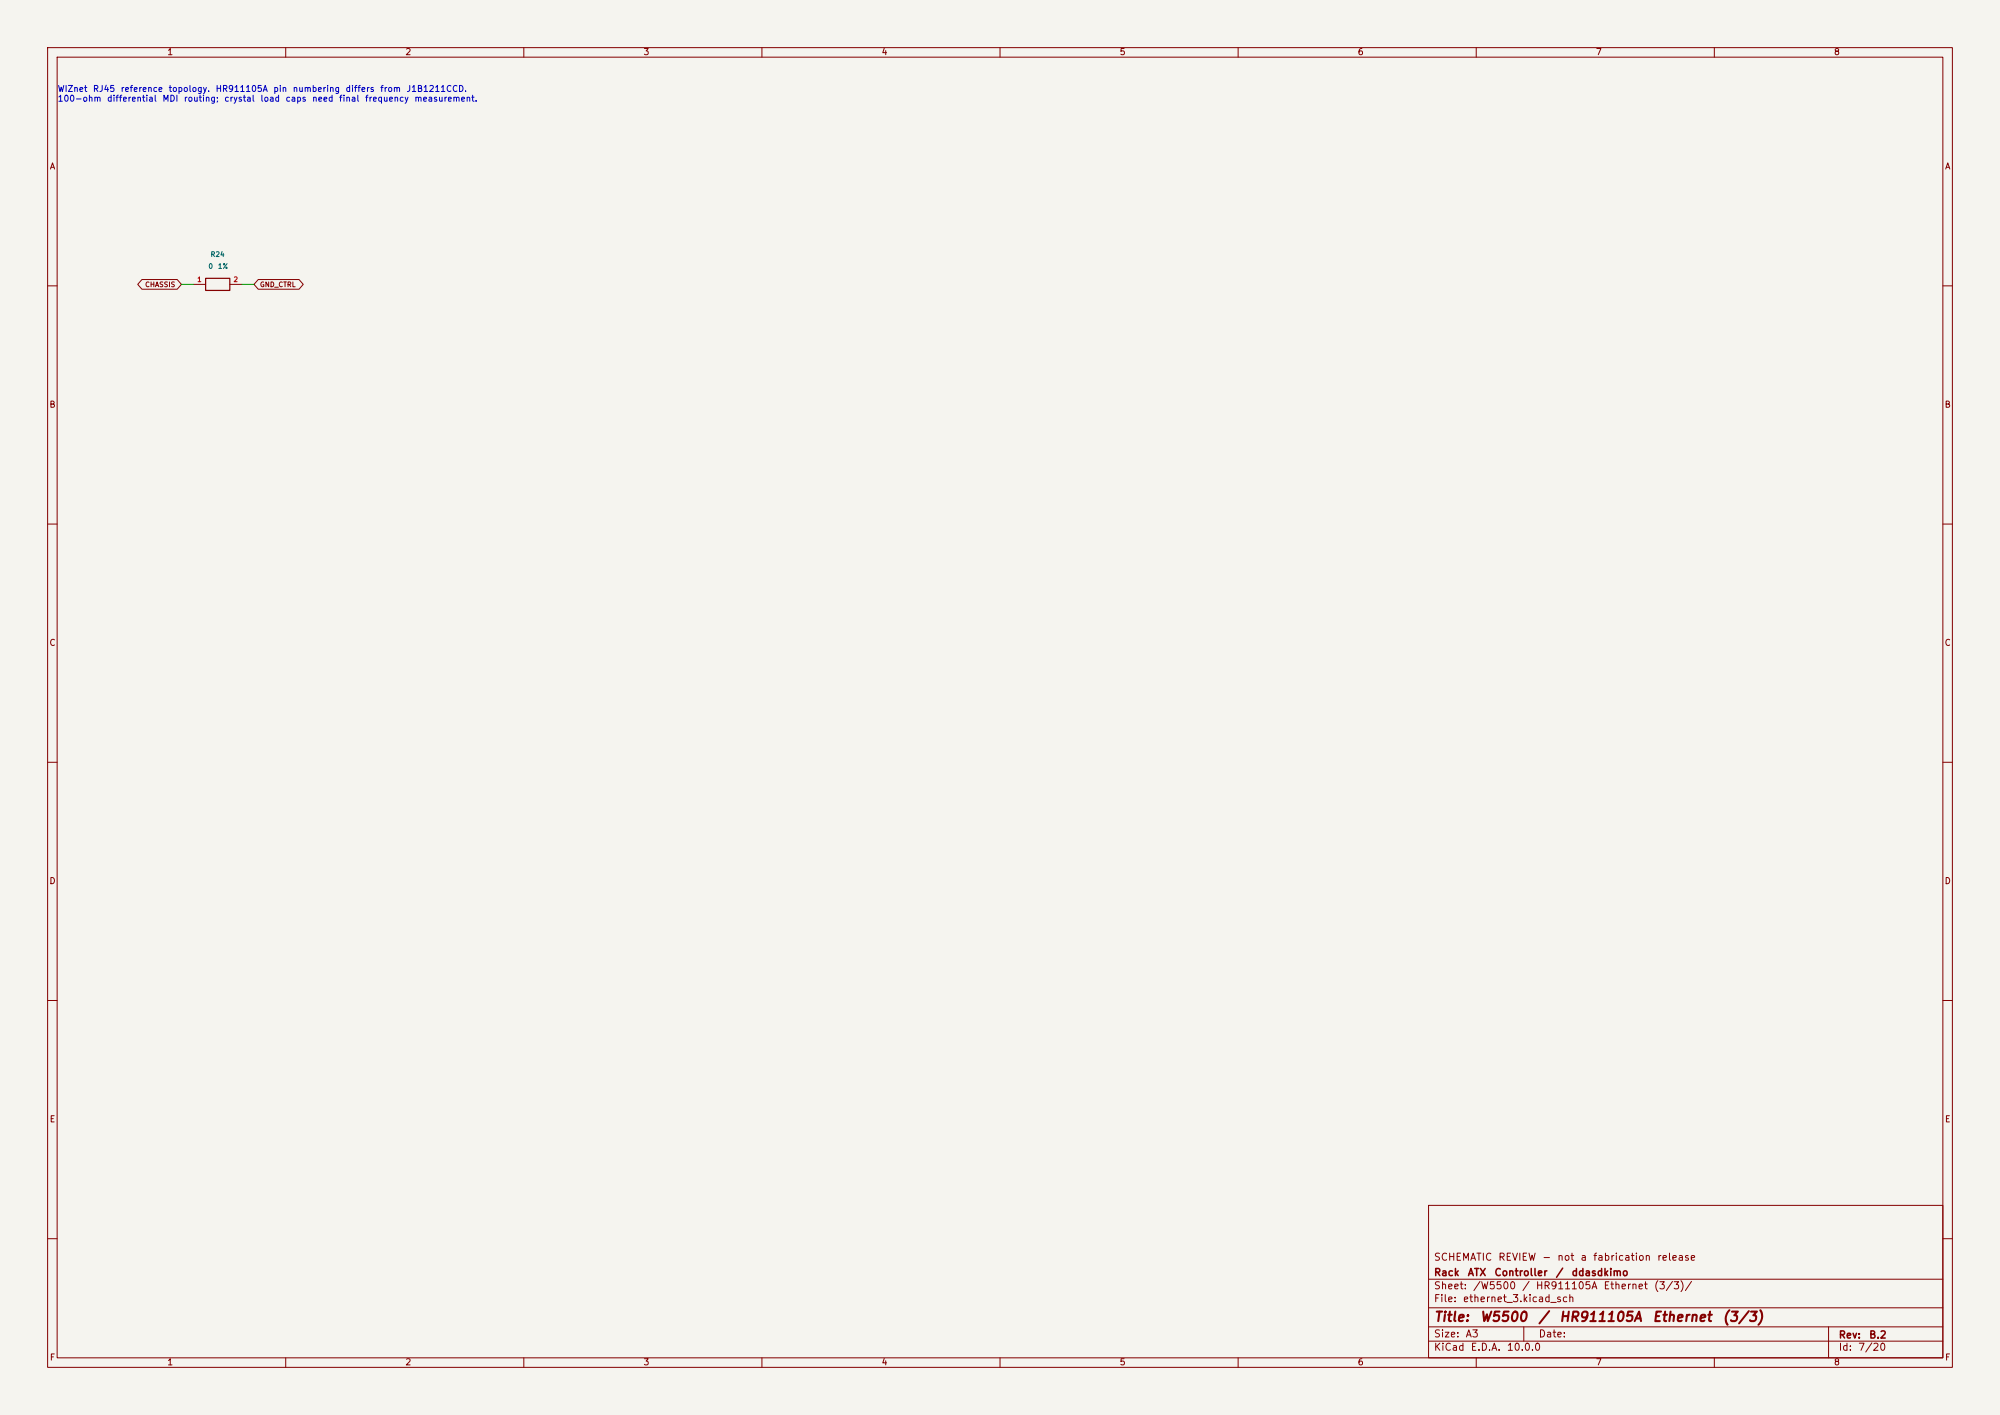
[picture p23: page 7]

Rack ATX Controller / ddasdkimo SCHEMATIC REVIEW - not a fabrication release

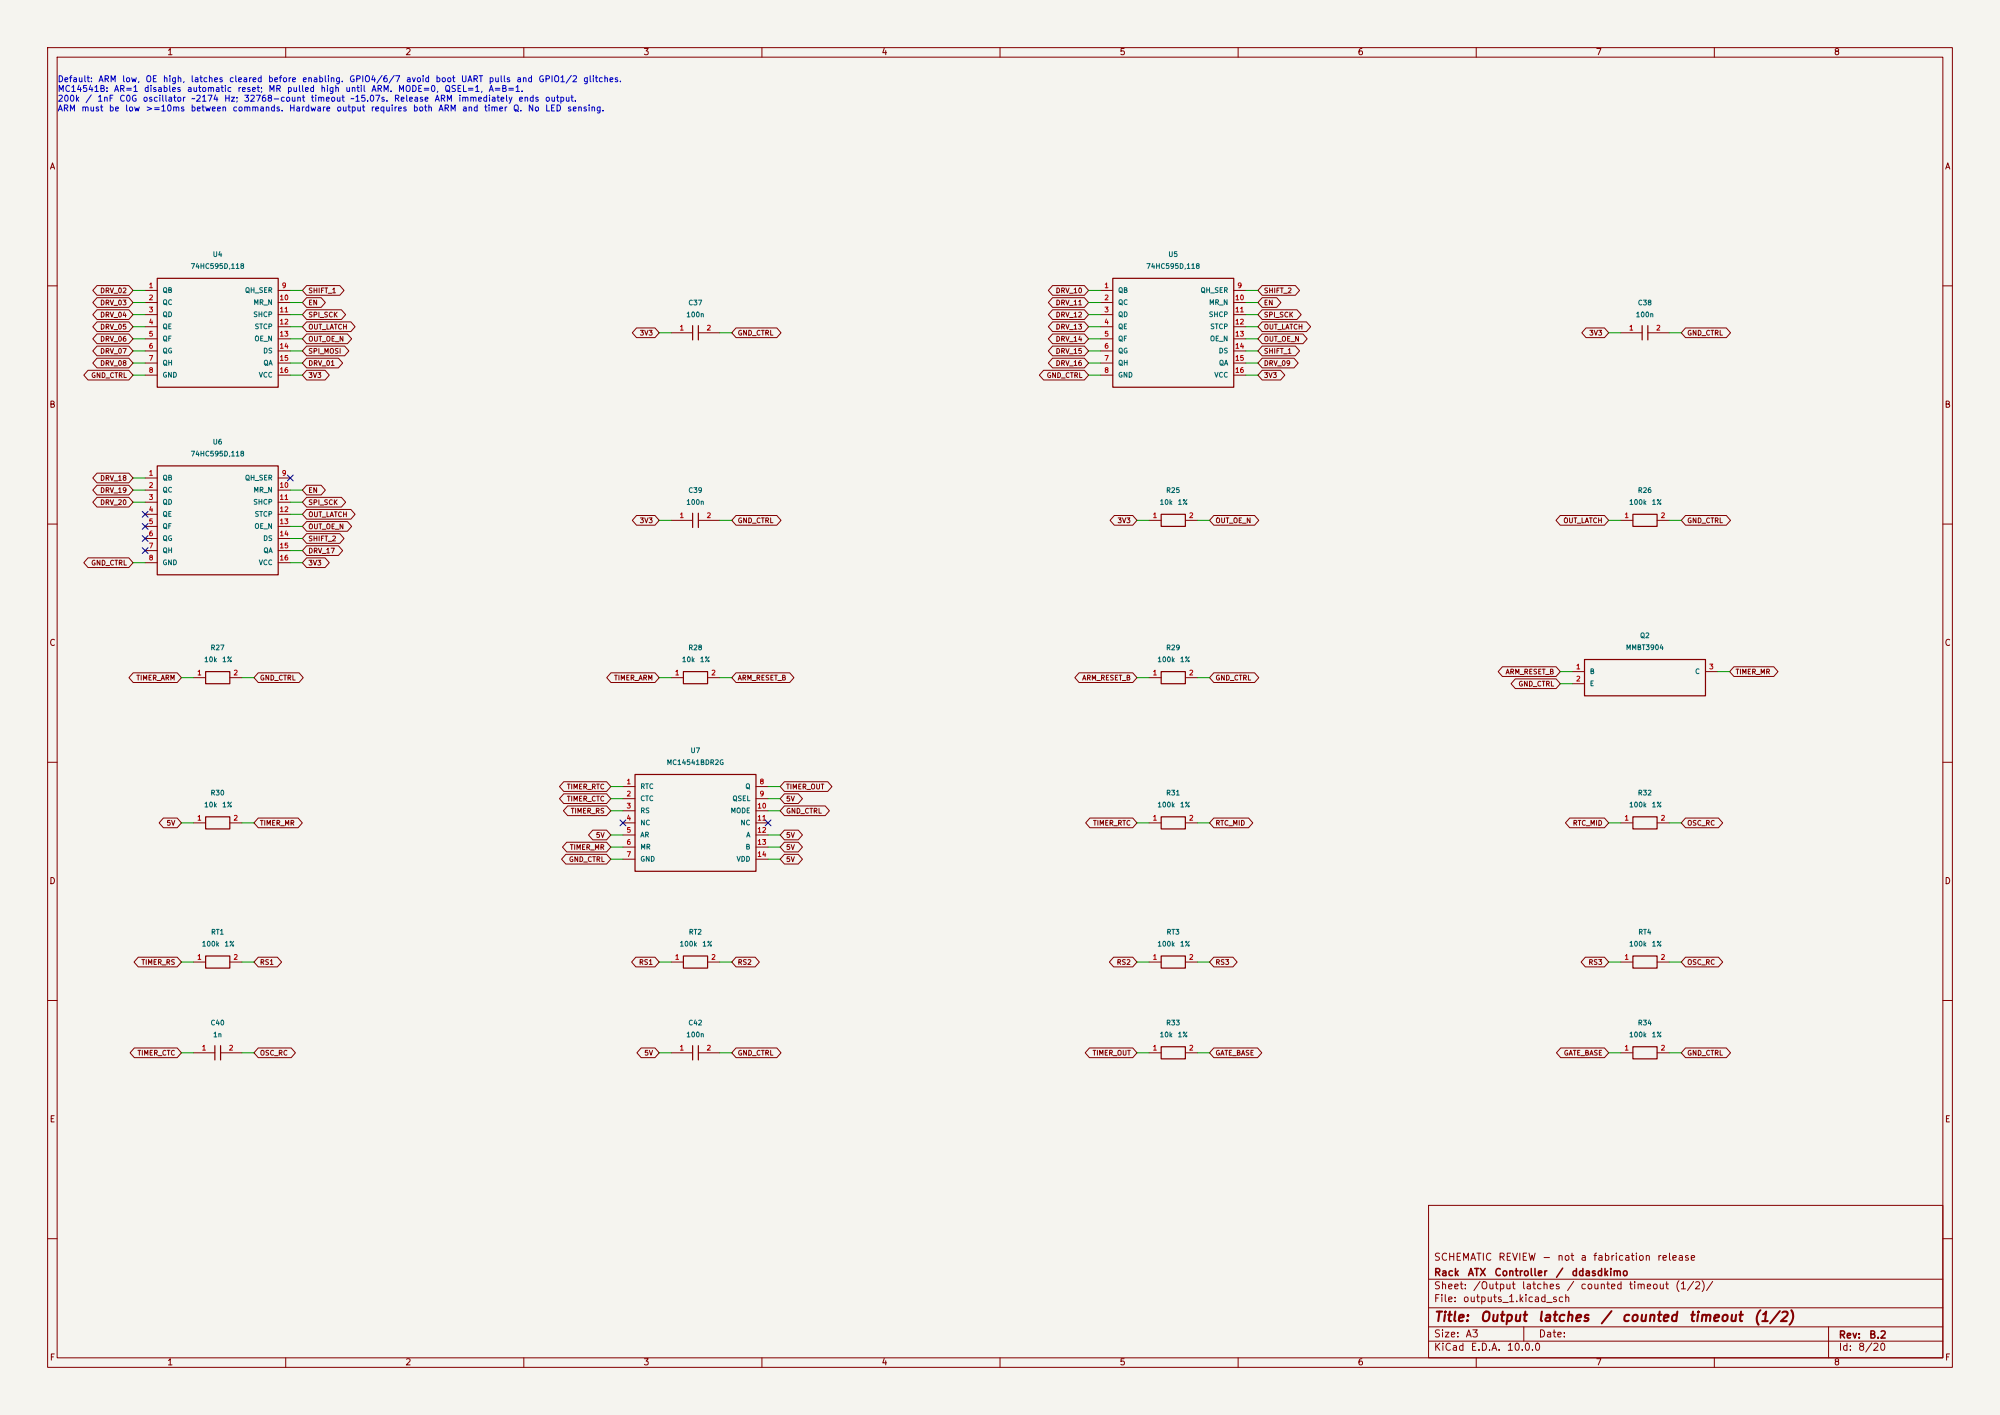
[picture p24: page 8]

EN Default: ARM low, OE high, latches cleared before enabling. GPIO4/6/7 avoid boot UART pulls and GPIO1/2 glitches.
MC14541B: AR=1 disables automatic reset; MR pulled high until ARM. MODE=0, QSEL=1, A=B=1. 200k / 1nF C0G oscillator ~2174 Hz; 32768-count timeout ~15.07s. Release ARM immediately ends output.

ARM must be low >=10ms between commands. Hardware output requires both ARM and timer Q. No LED sensing.

Rack ATX Controller / ddasdkimo SCHEMATIC REVIEW - not a fabrication release

Sheet: /Output latches / counted timeout (1/2)/
File: outputs_1.kicad_sch
Title: Output latches / counted timeout (1/2)

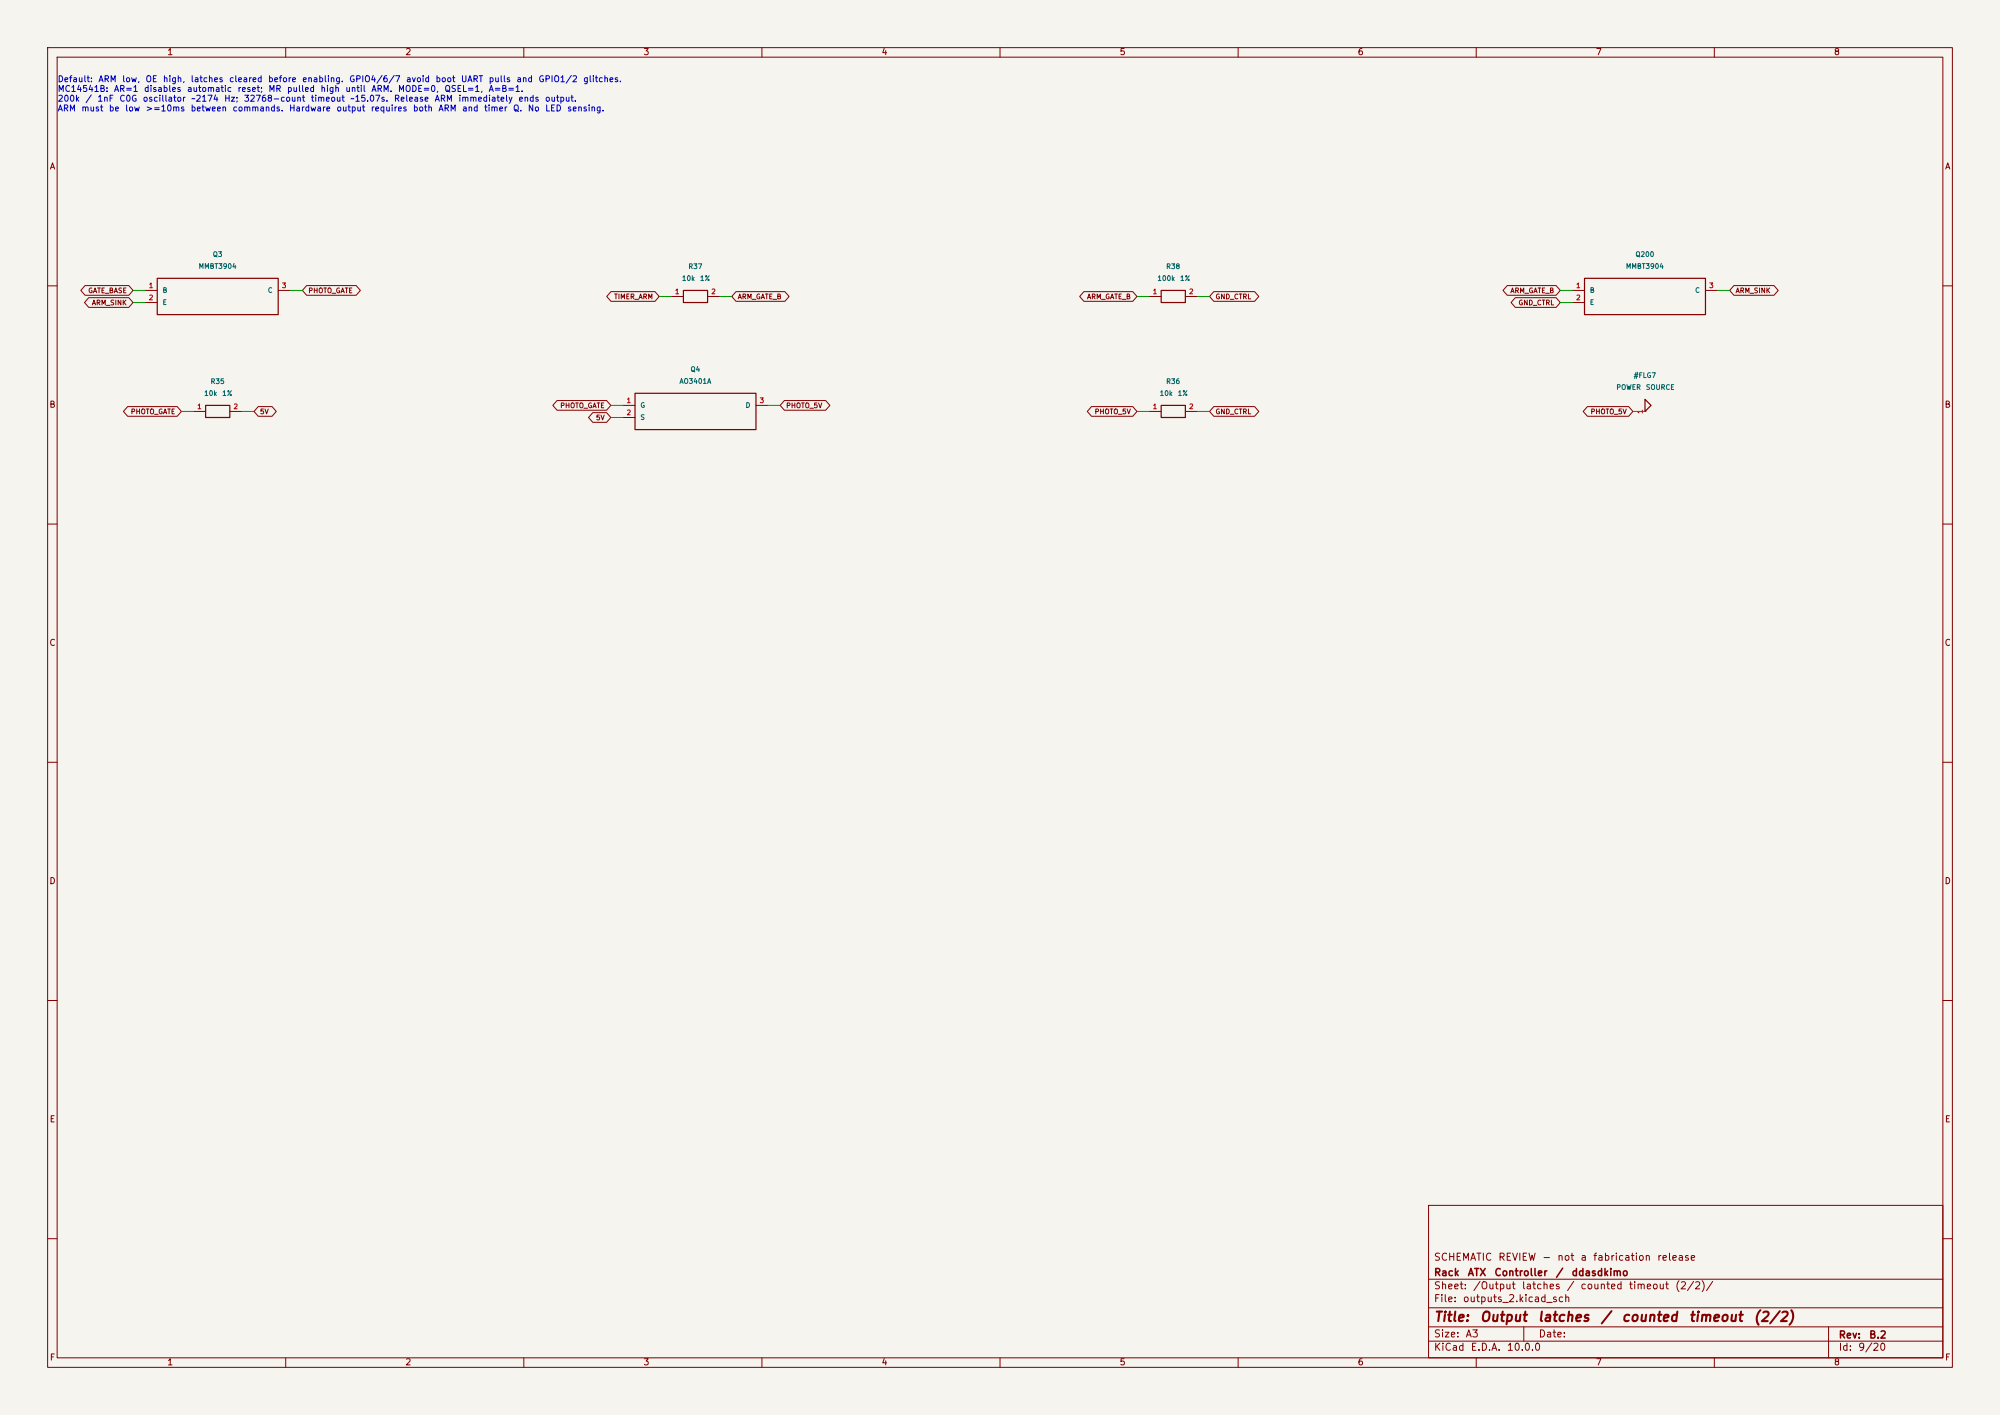
[picture p25: page 9]
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

Rack ATX Controller / ddasdkimo SCHEMATIC REVIEW - not a fabrication release

Sheet: /Output latches / counted timeout (2/2)/
File: outputs_2.kicad_sch
Title: Output latches / counted timeout (2/2)

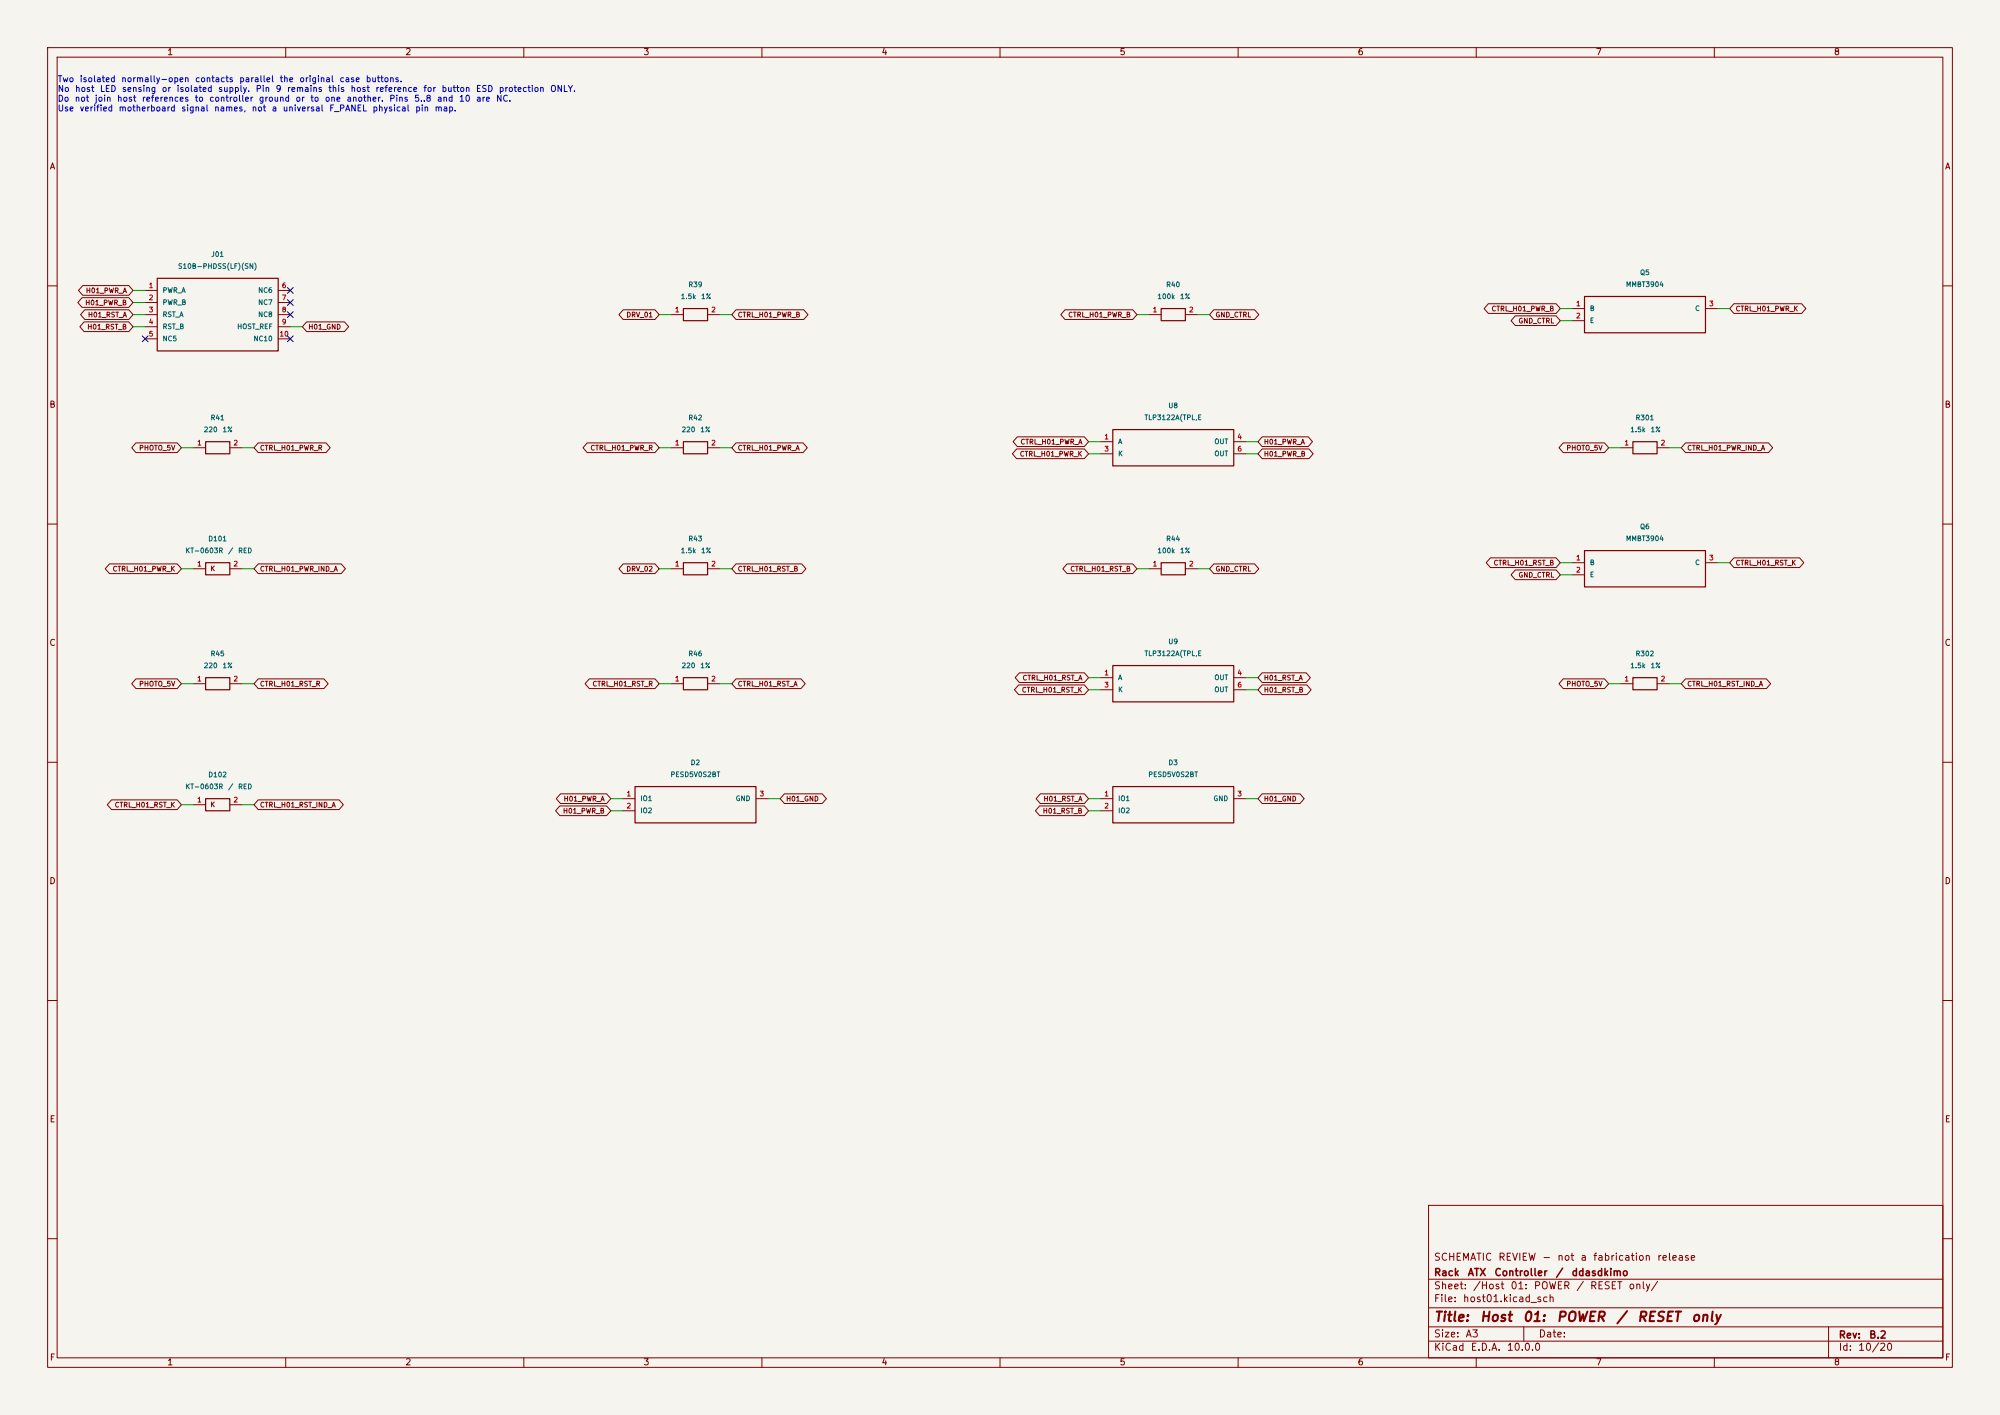
[picture p26: page 10]

Two isolated normally-open contacts parallel the original case buttons. No host LED sensing or isolated supply. Pin 9 remains this host reference for button ESD protection ONLY. Do not join host references to controller ground or to one another. Pins 5..8 and 10 are NC. Use verified motherboard signal names, not a universal F_PANEL physical pin map.

Rack ATX Controller / ddasdkimo SCHEMATIC REVIEW - not a fabrication release

Sheet: /Host 01: POWER / RESET only/
File: host01.kicad_sch
Title: Host 01: POWER / RESET only

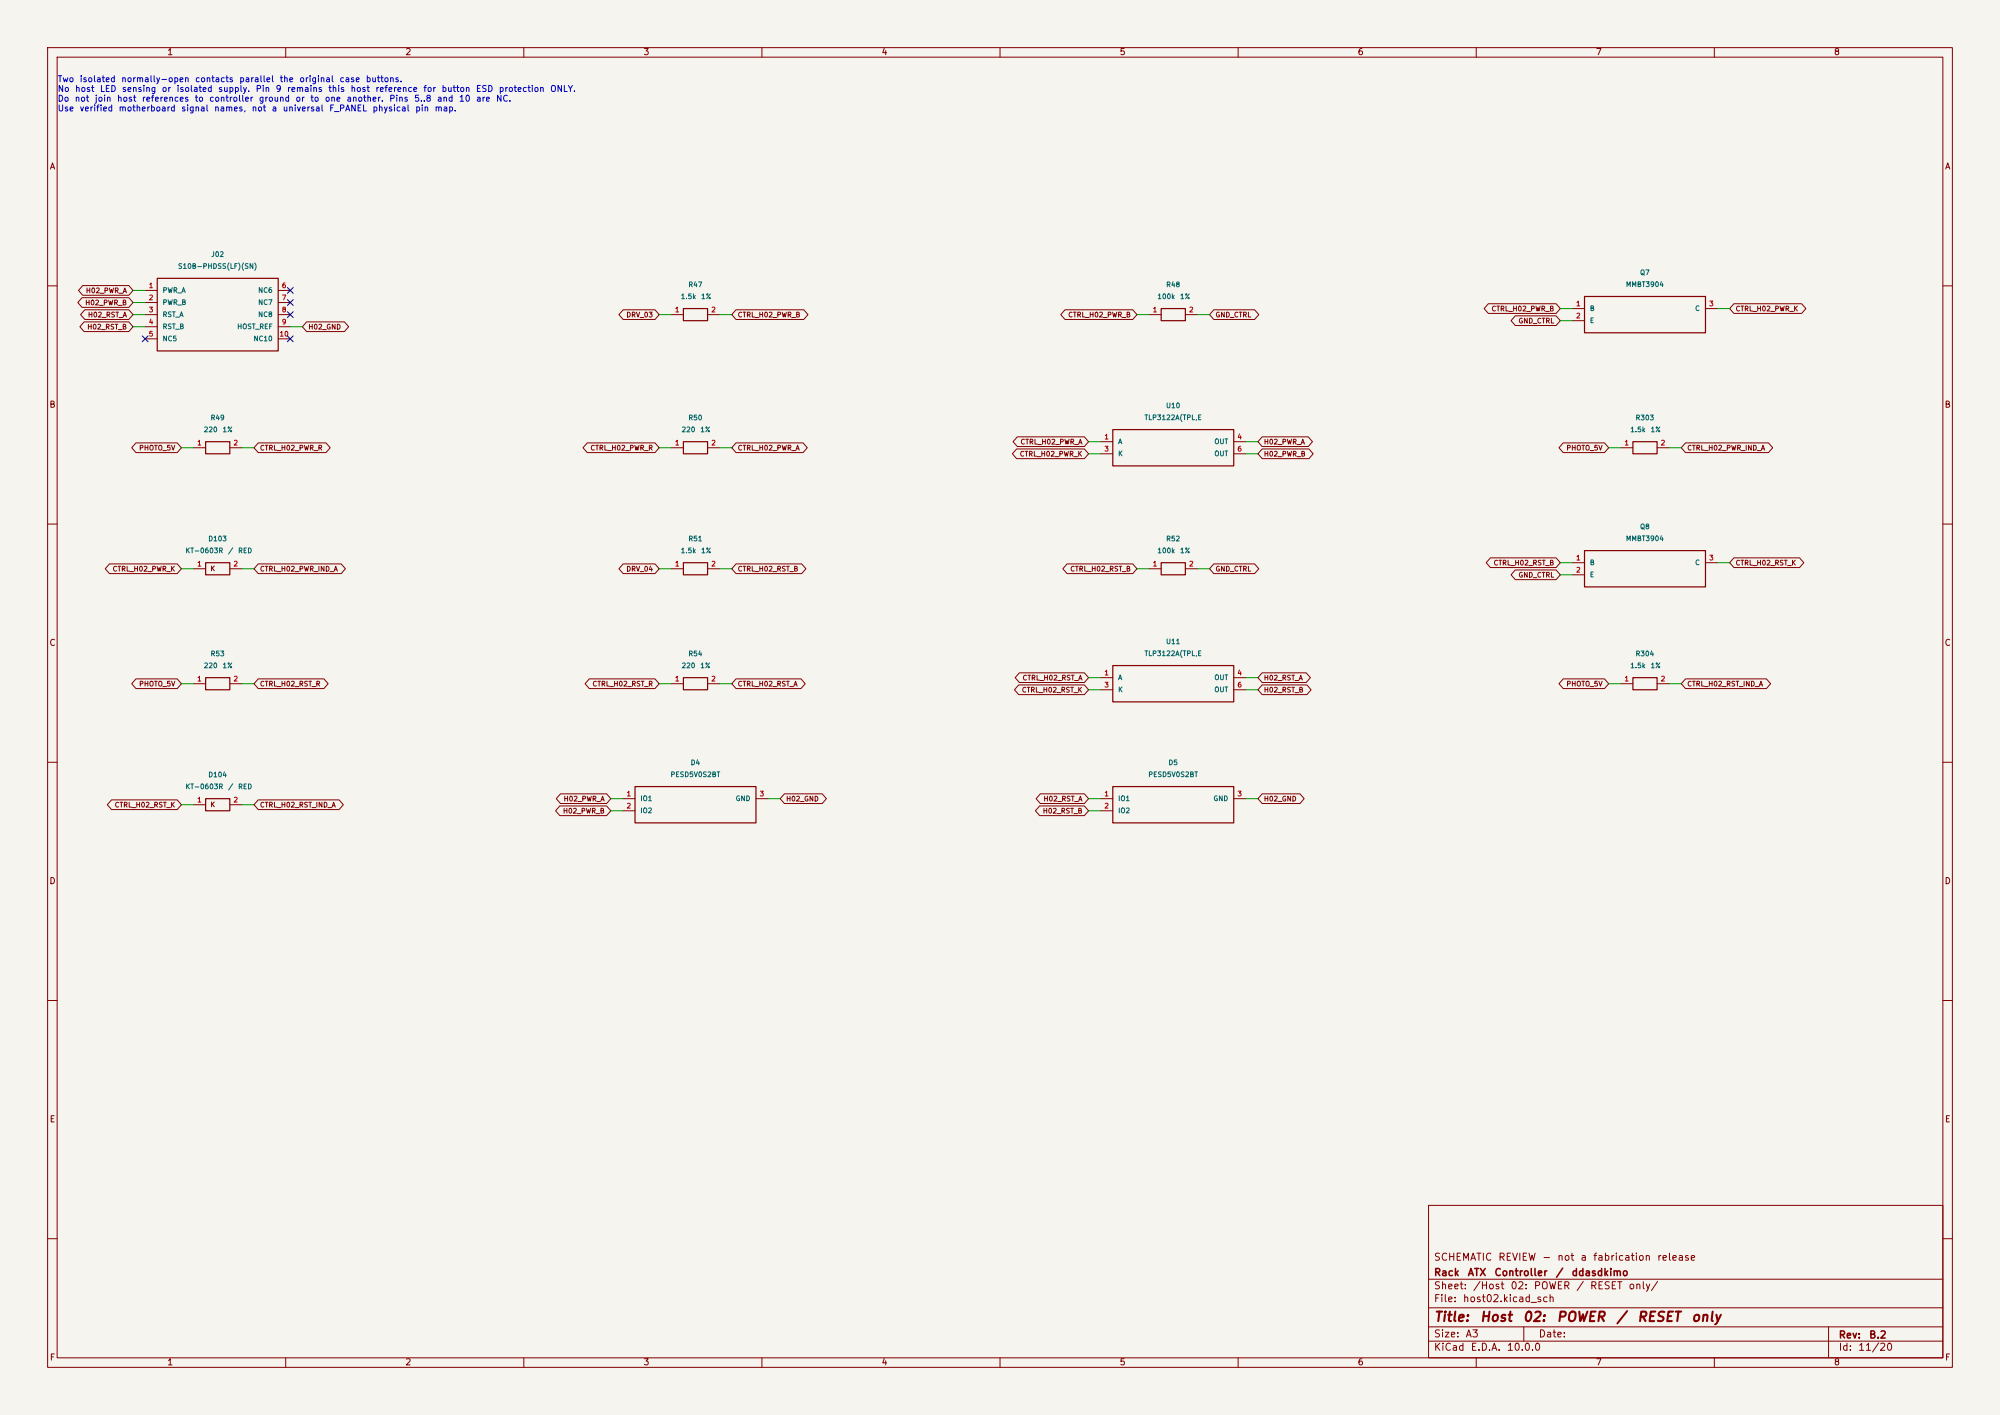
[picture p27: page 11]

Rack ATX Controller / ddasdkimo SCHEMATIC REVIEW - not a fabrication release

Sheet: /Host 02: POWER / RESET only/
File: host02.kicad_sch
Title: Host 02: POWER / RESET only

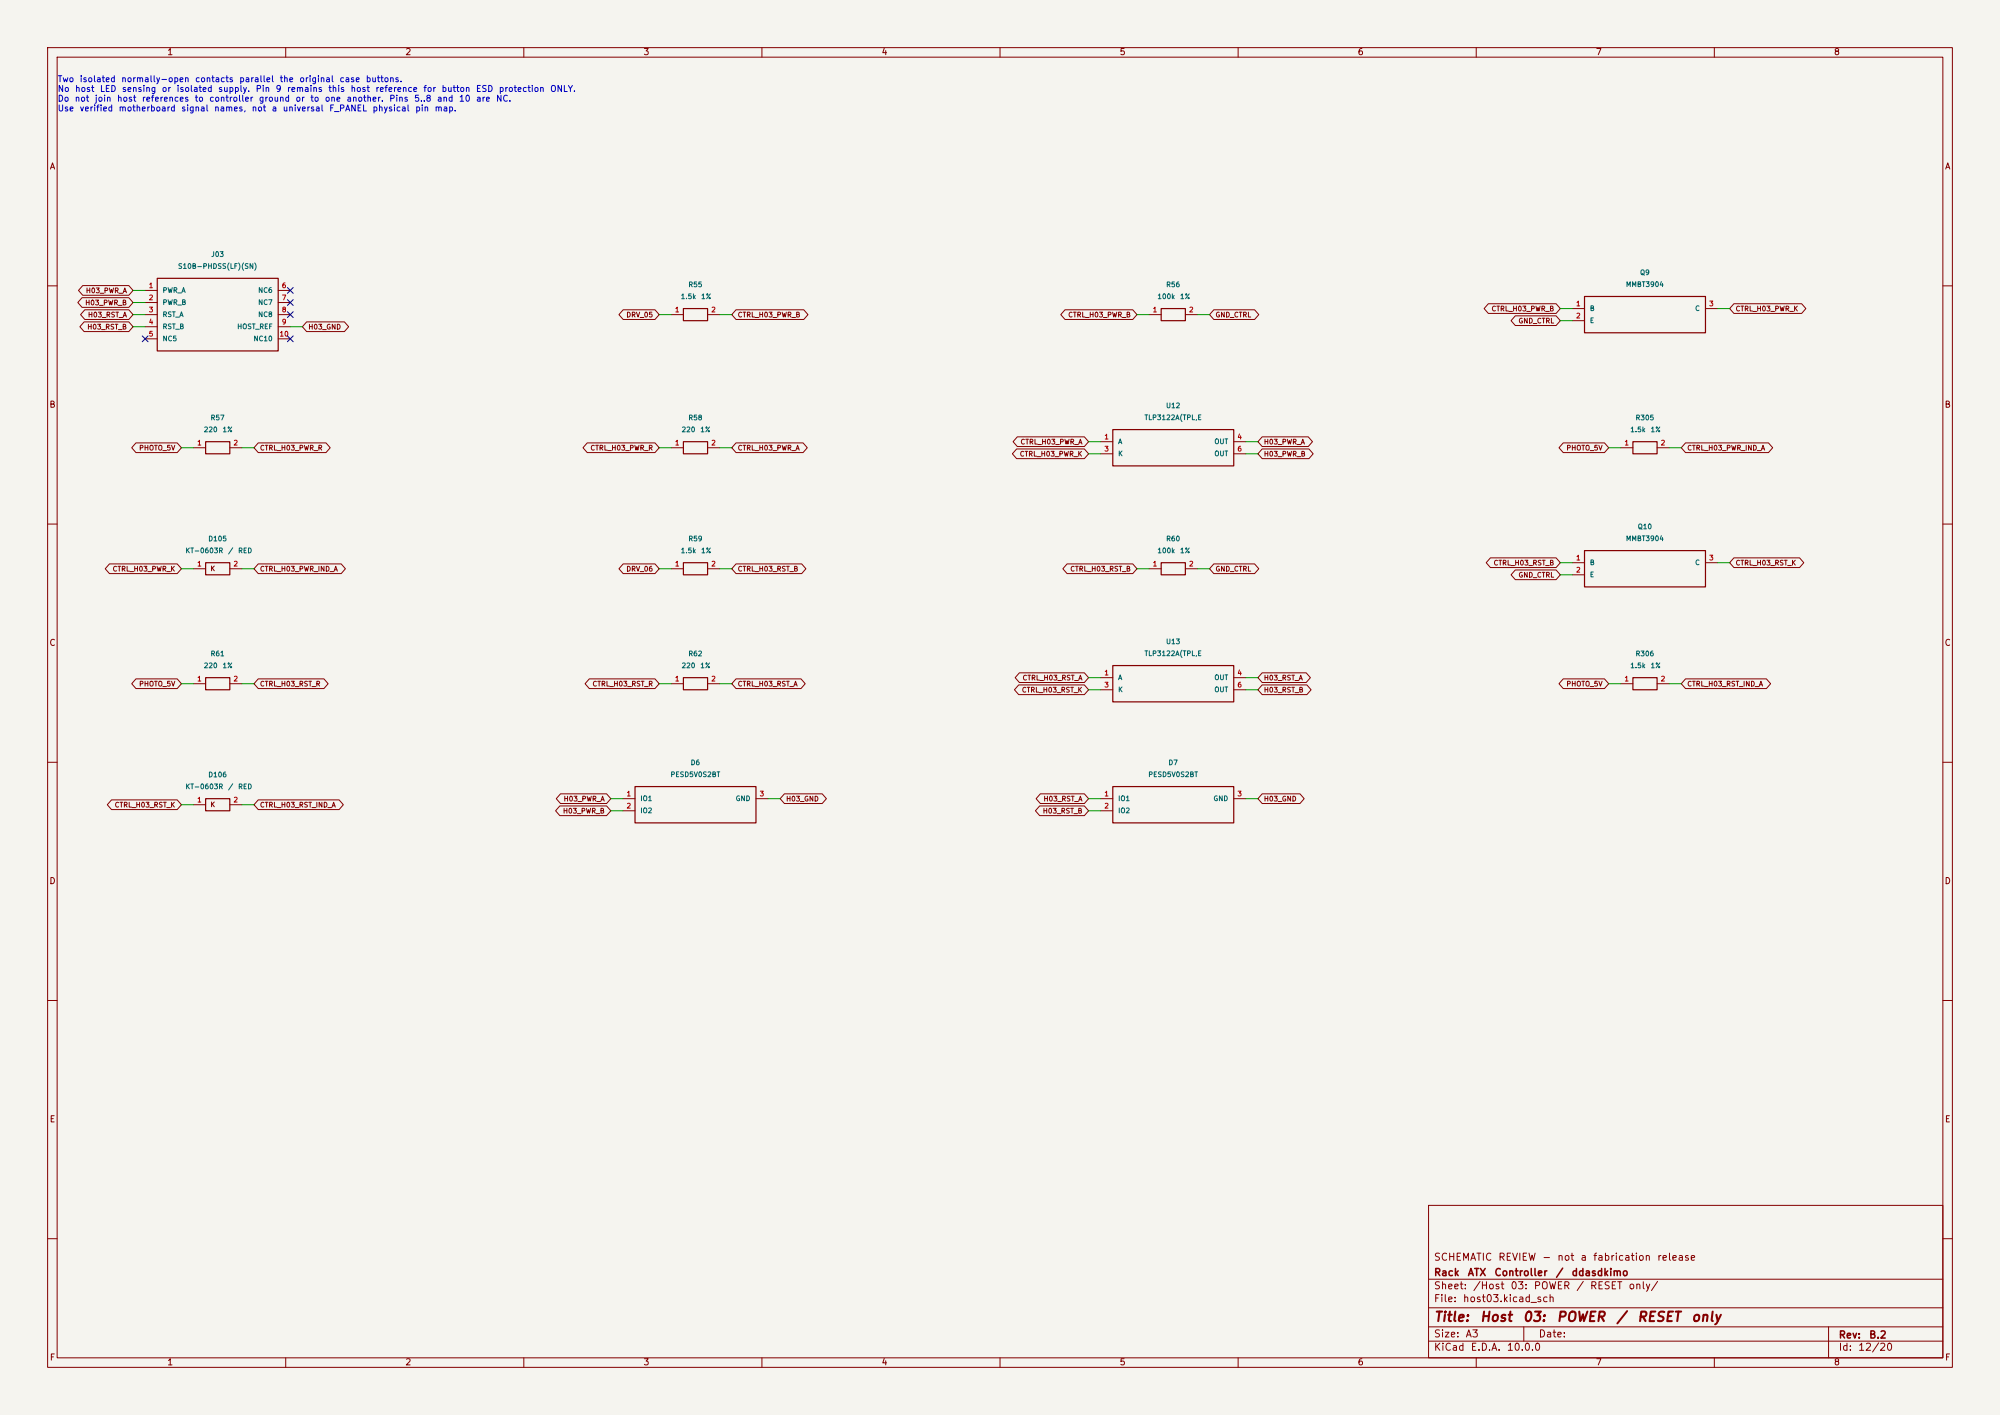
[picture p28: page 12]

Rack ATX Controller / ddasdkimo SCHEMATIC REVIEW - not a fabrication release

Sheet: /Host 03: POWER / RESET only/
File: host03.kicad_sch
Title: Host 03: POWER / RESET only

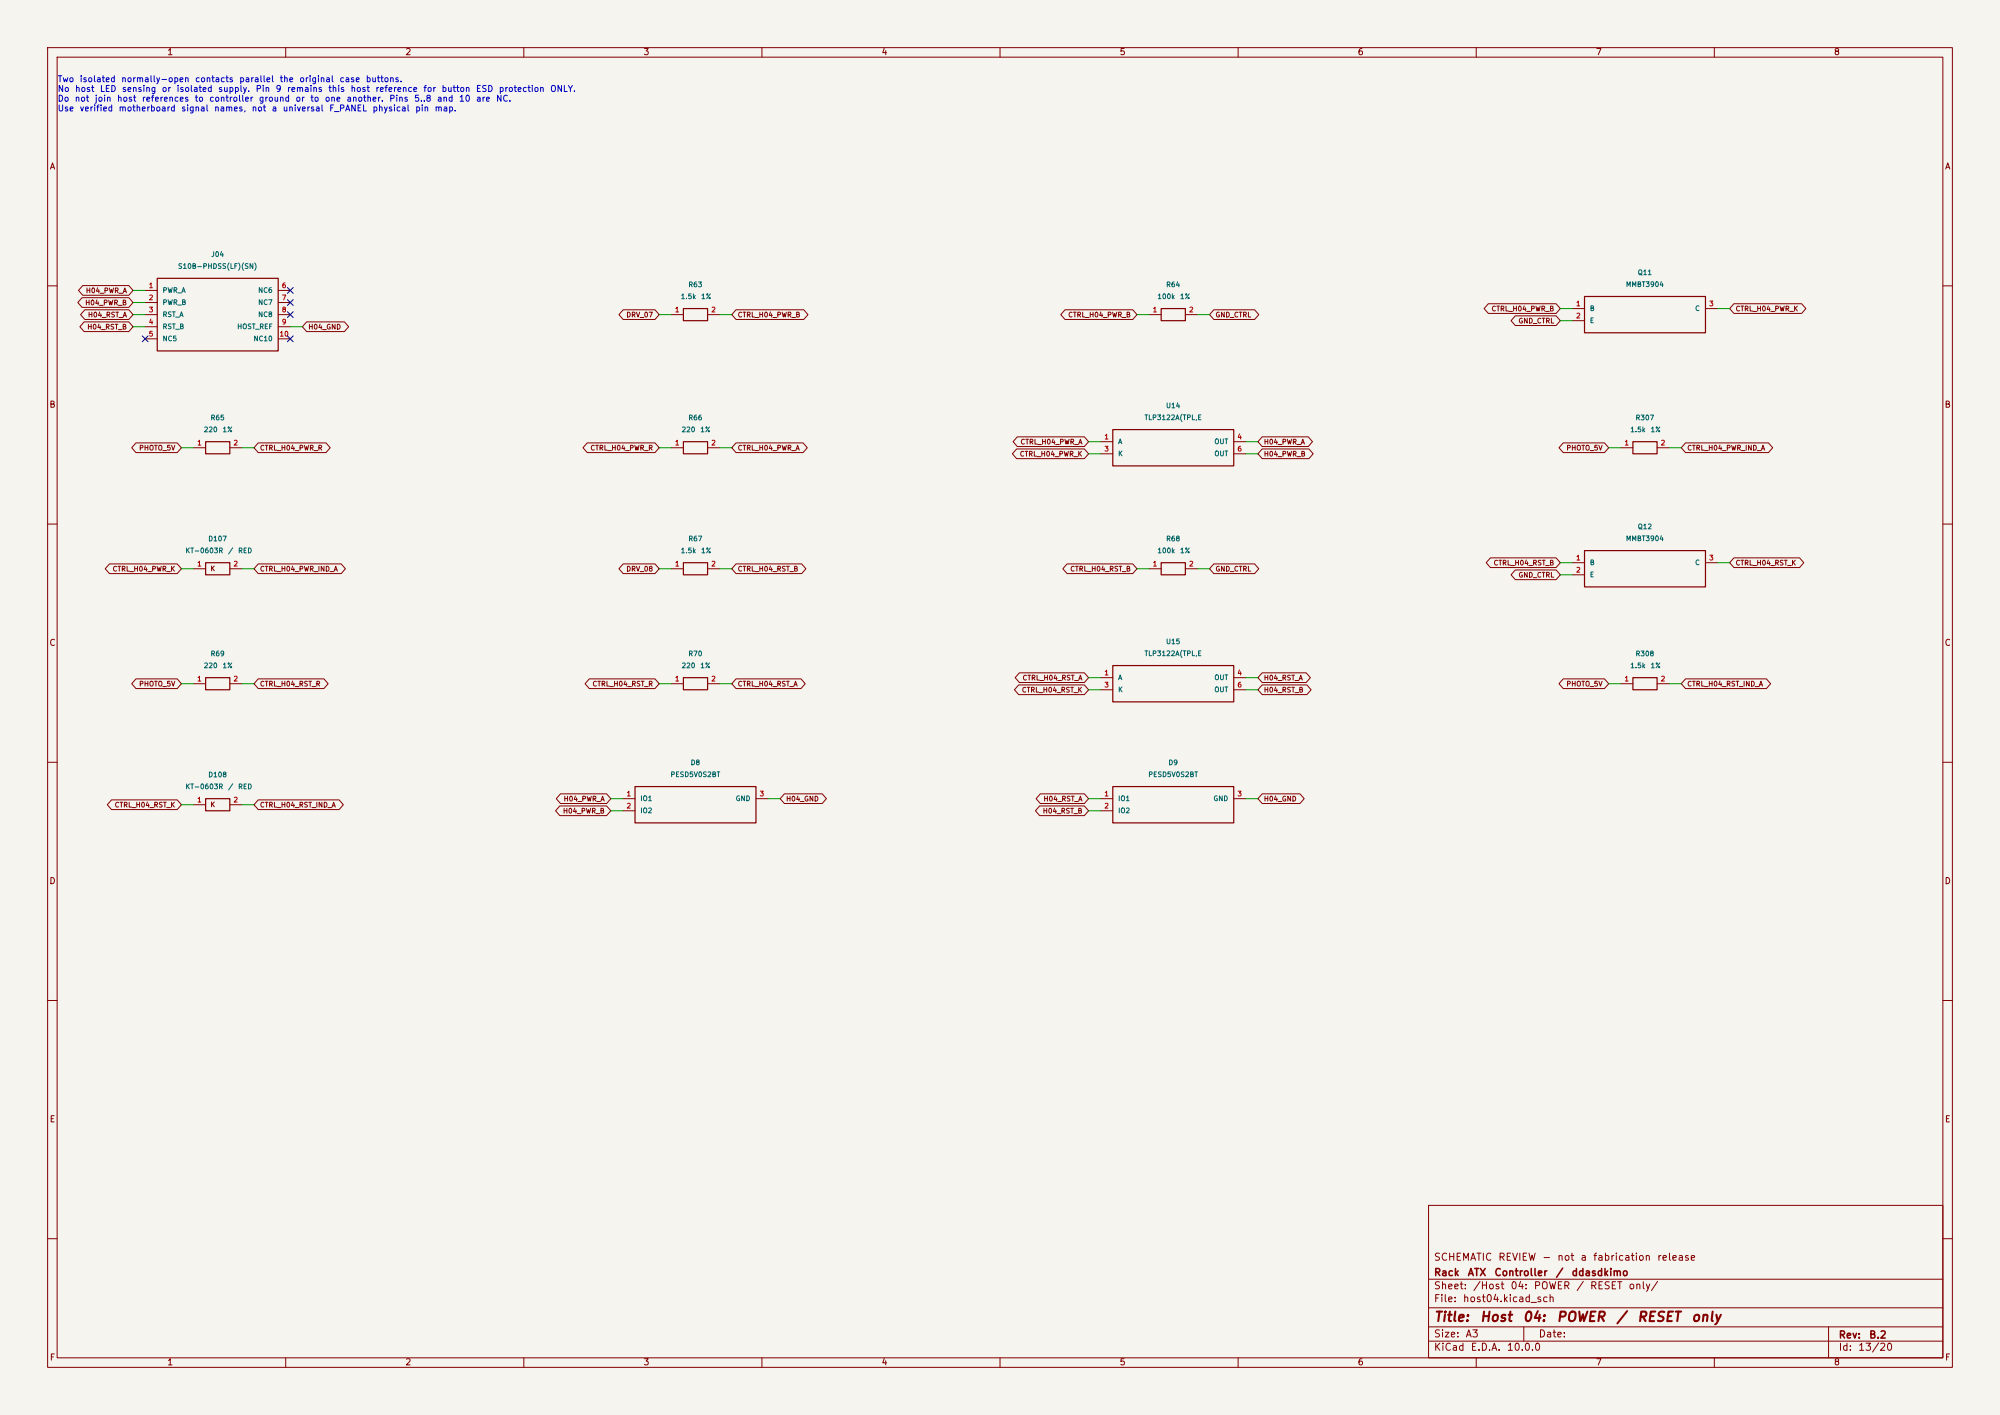
[picture p29: page 13]

Rack ATX Controller / ddasdkimo SCHEMATIC REVIEW - not a fabrication release

Sheet: /Host 04: POWER / RESET only/
File: host04.kicad_sch
Title: Host 04: POWER / RESET only

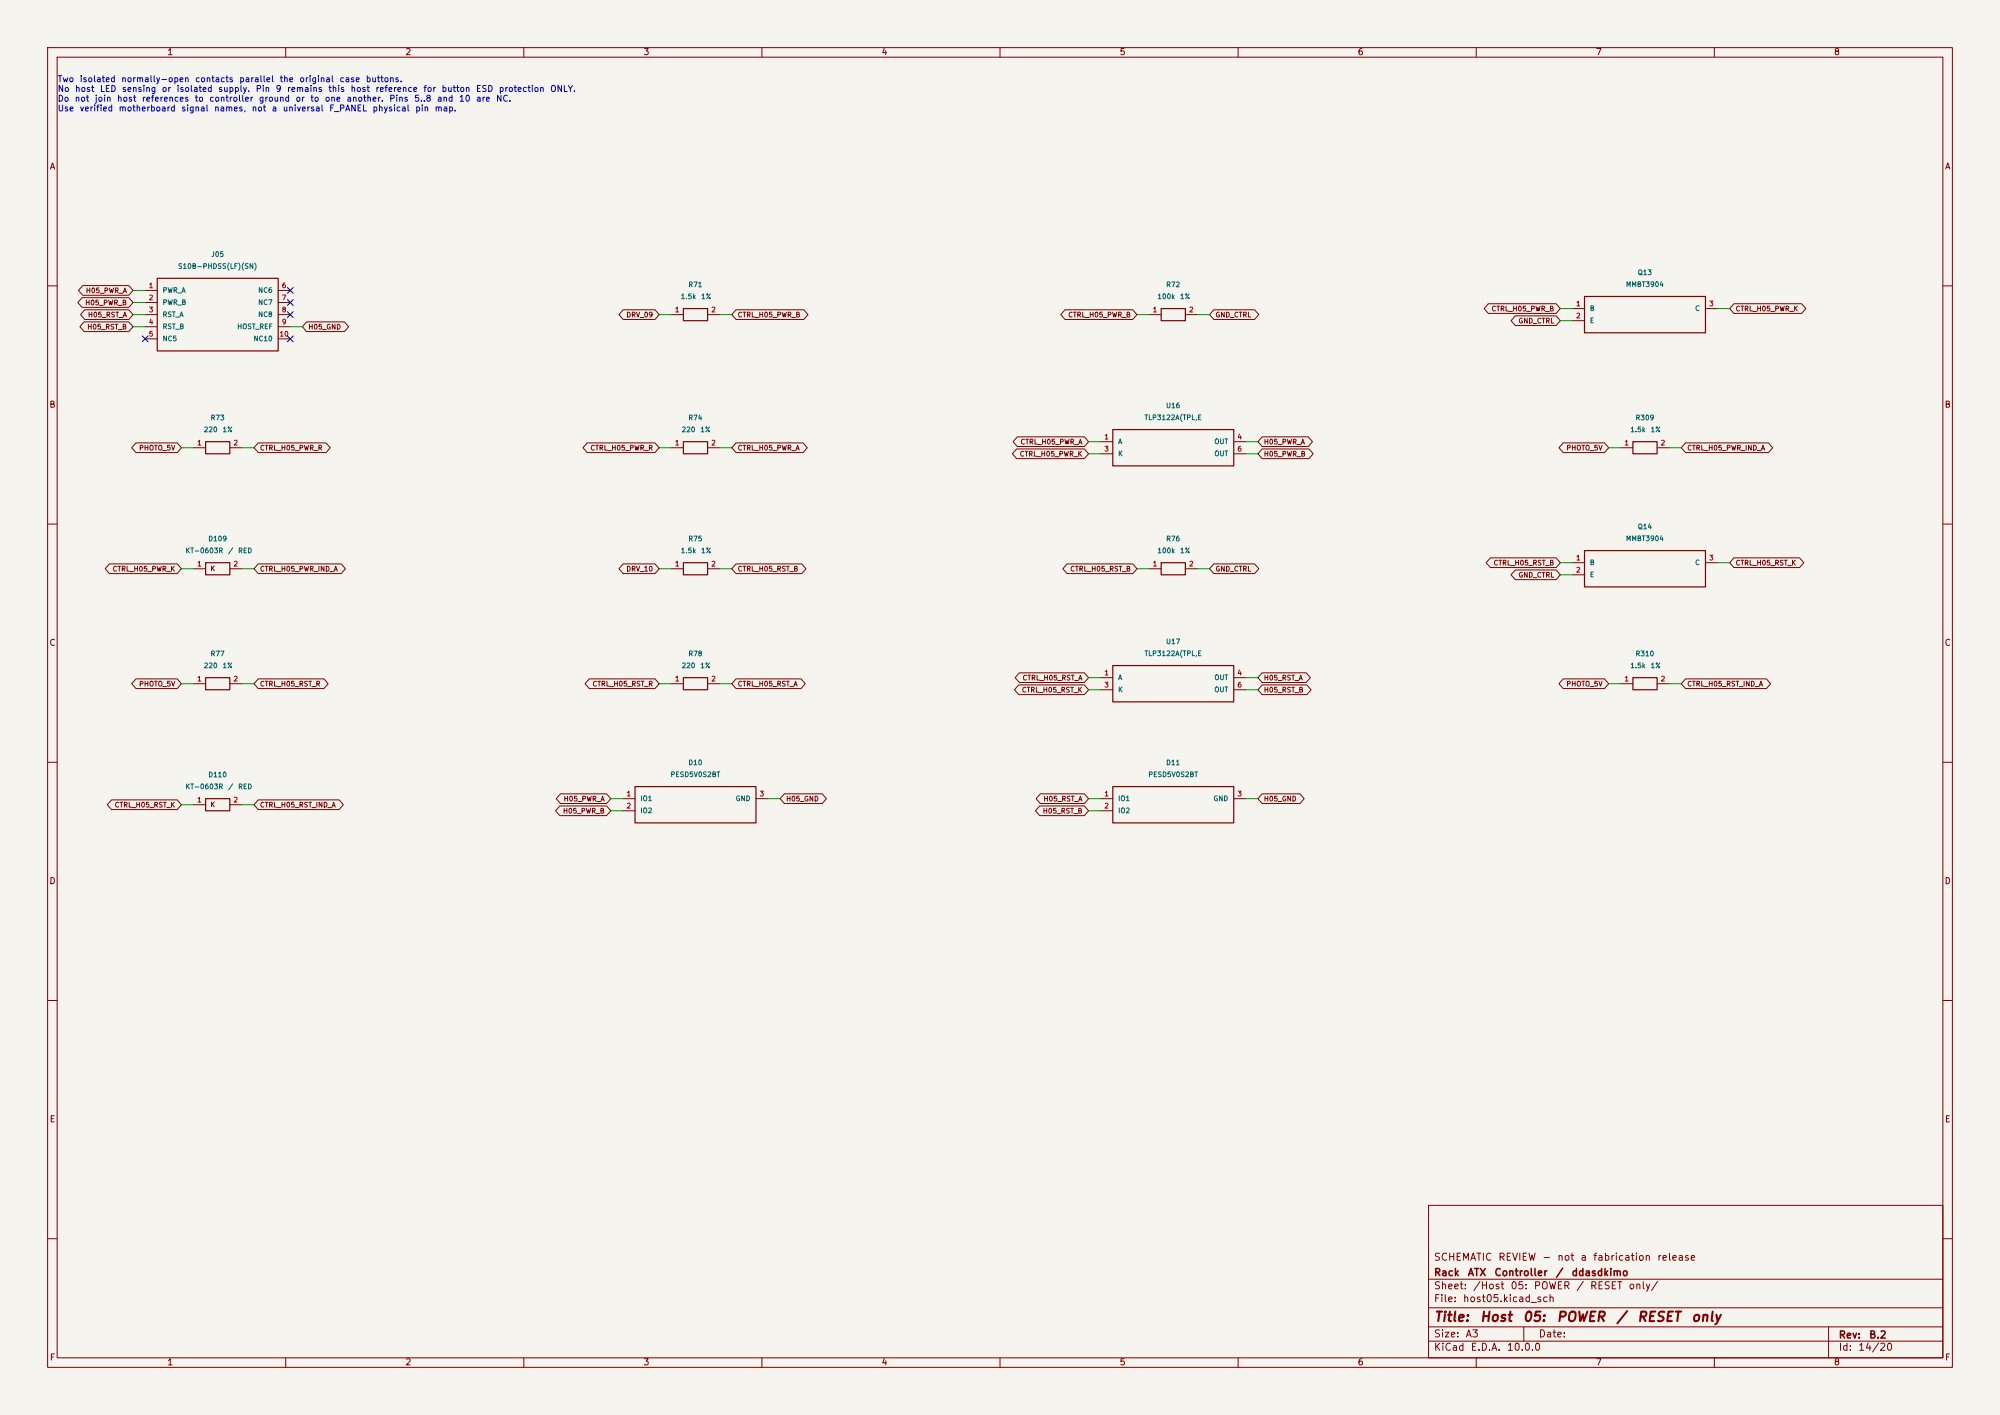
[picture p30: page 14]

Rack ATX Controller / ddasdkimo SCHEMATIC REVIEW - not a fabrication release

Sheet: /Host 05: POWER / RESET only/
File: host05.kicad_sch
Title: Host 05: POWER / RESET only

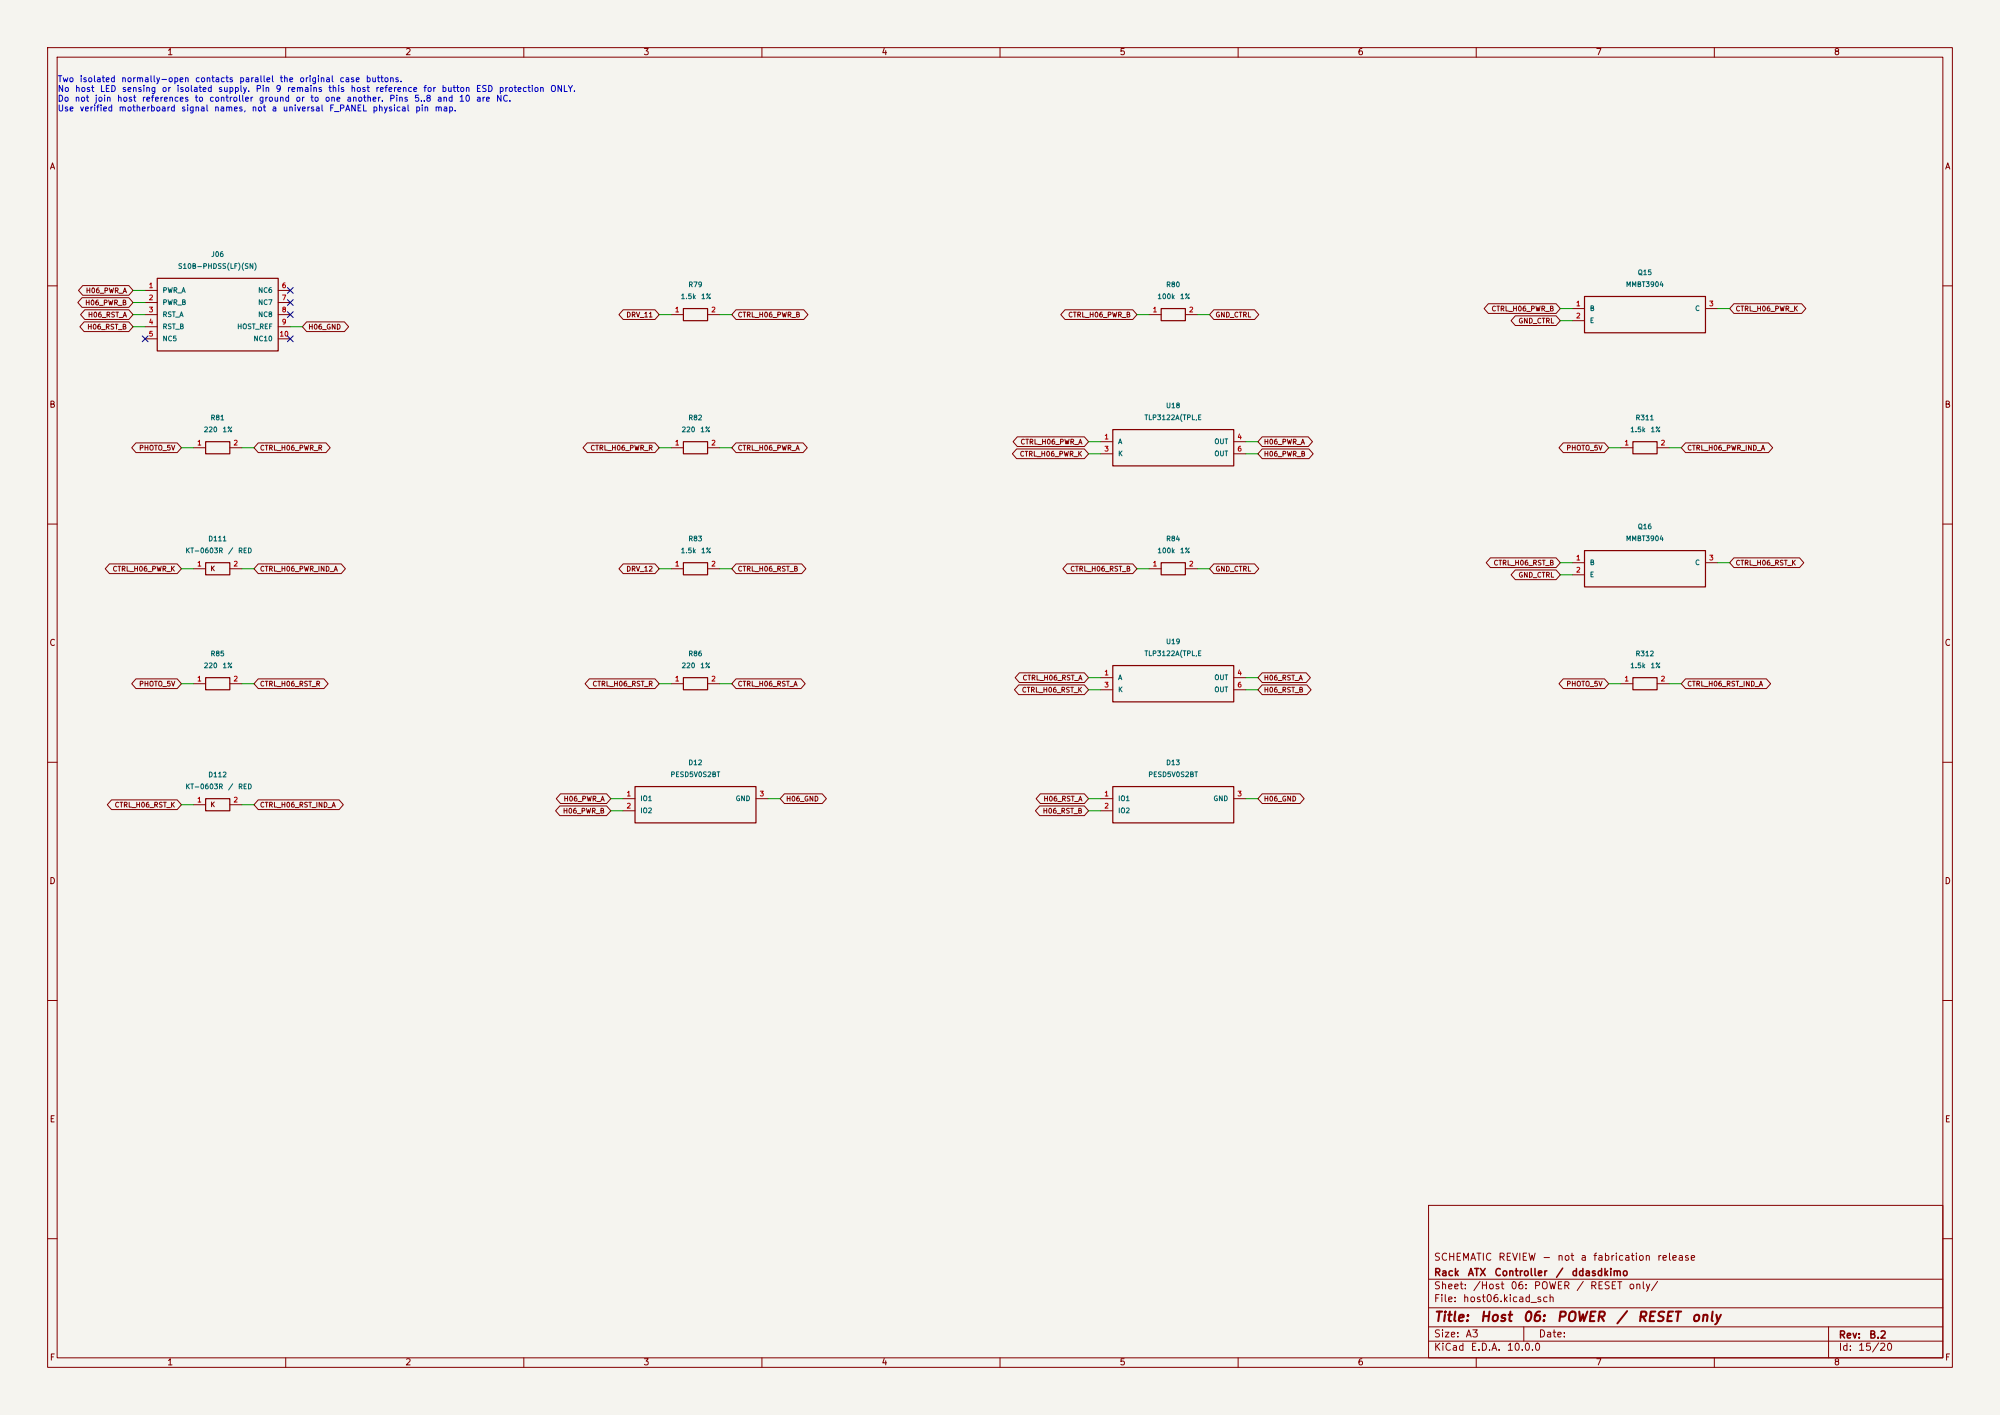
[picture p31: page 15]

Rack ATX Controller / ddasdkimo SCHEMATIC REVIEW - not a fabrication release

Sheet: /Host 06: POWER / RESET only/
File: host06.kicad_sch
Title: Host 06: POWER / RESET only

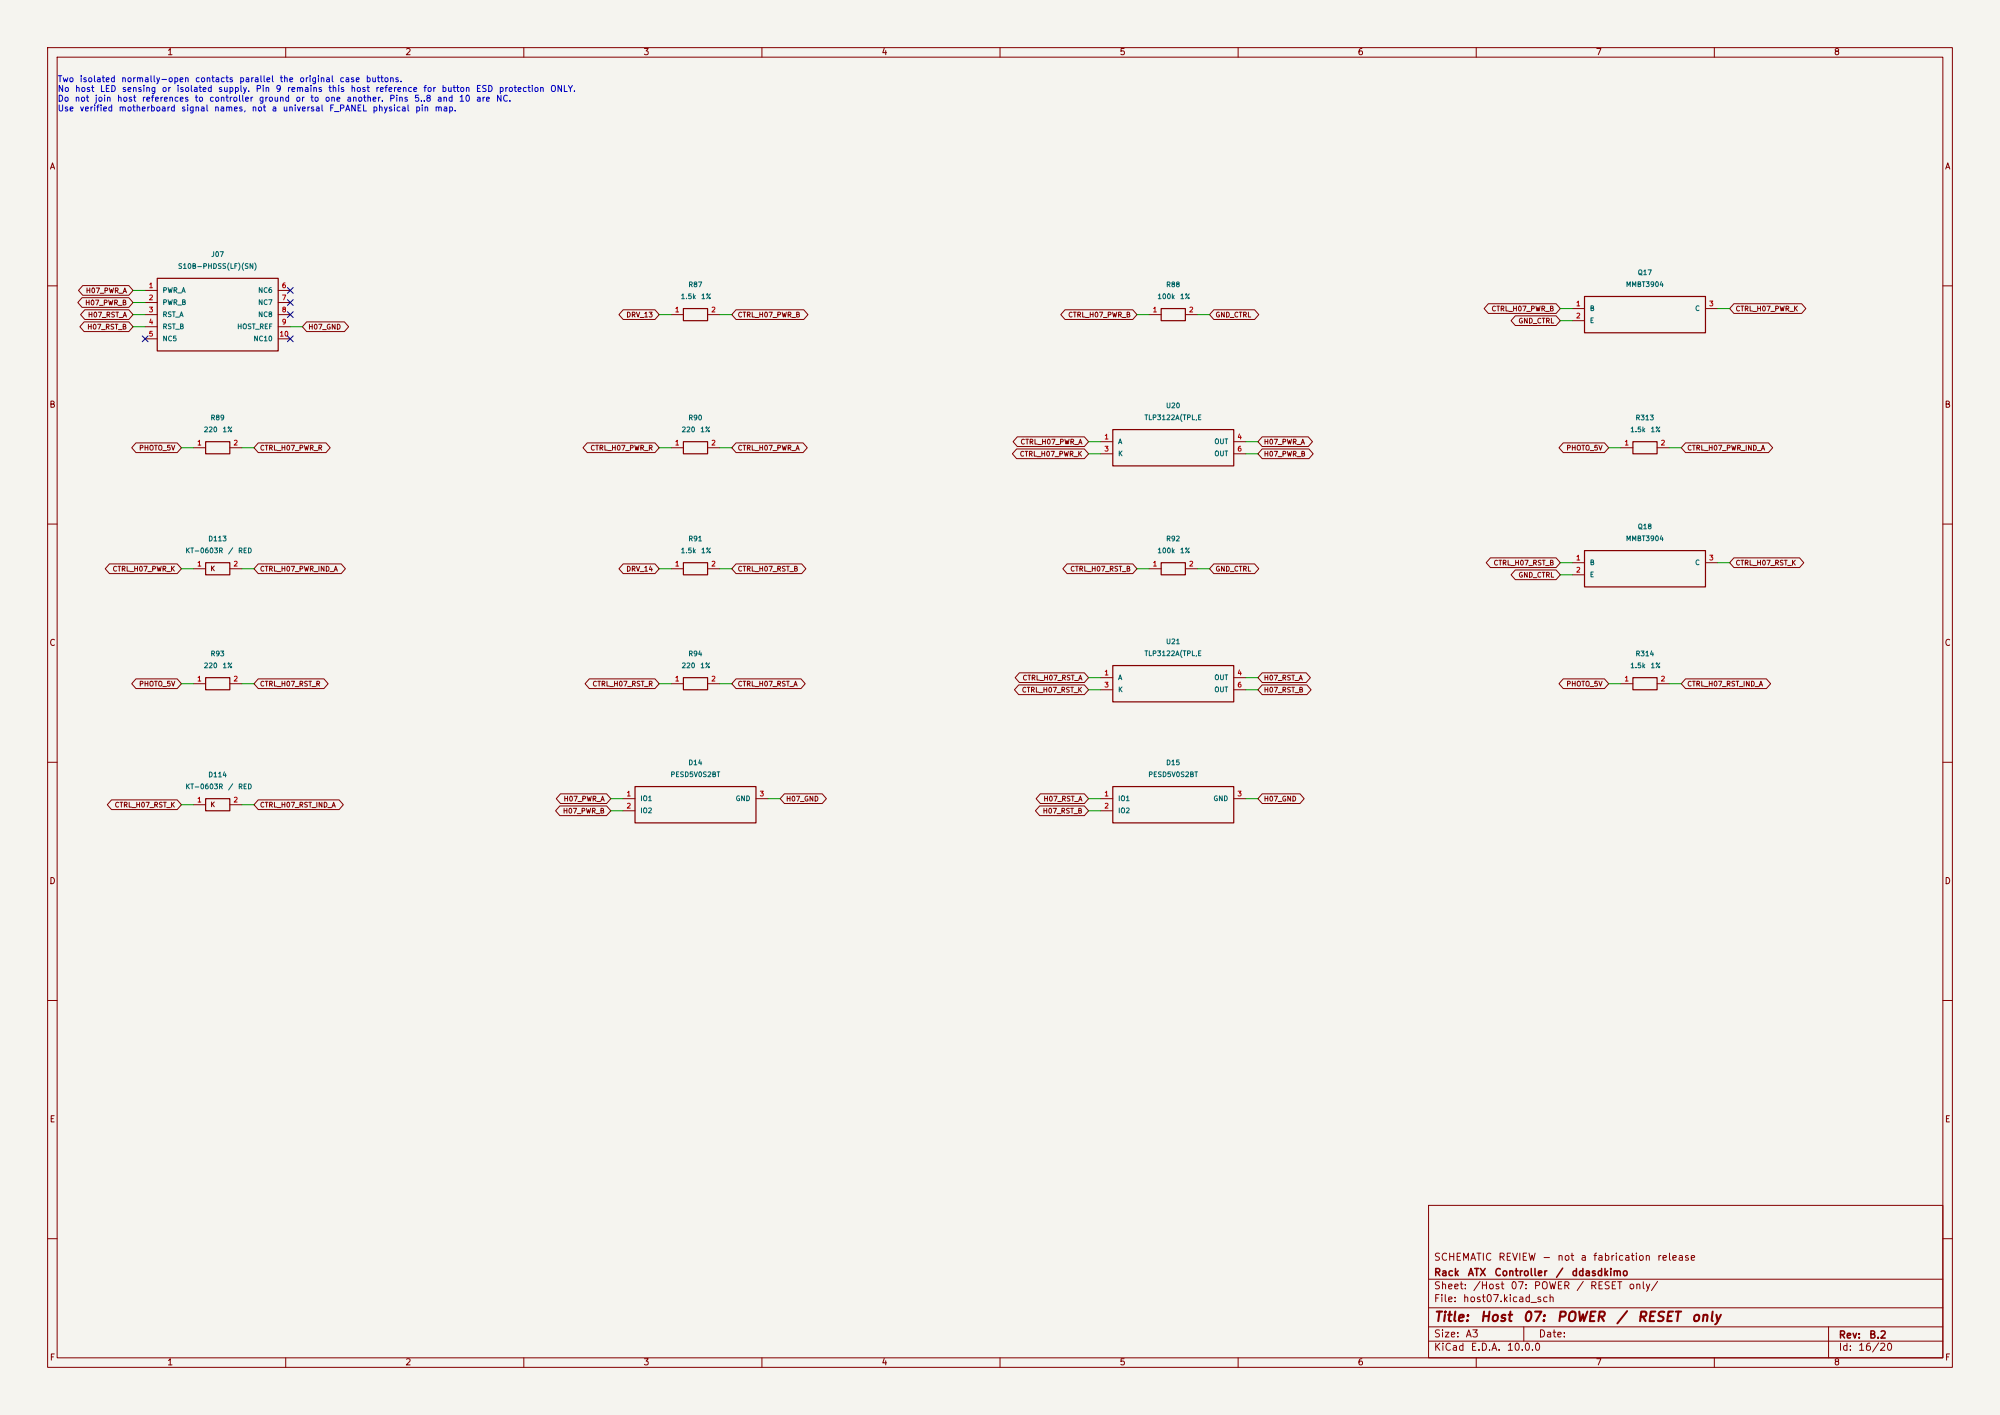
[picture p32: page 16]

Rack ATX Controller / ddasdkimo SCHEMATIC REVIEW - not a fabrication release

Sheet: /Host 07: POWER / RESET only/
File: host07.kicad_sch
Title: Host 07: POWER / RESET only

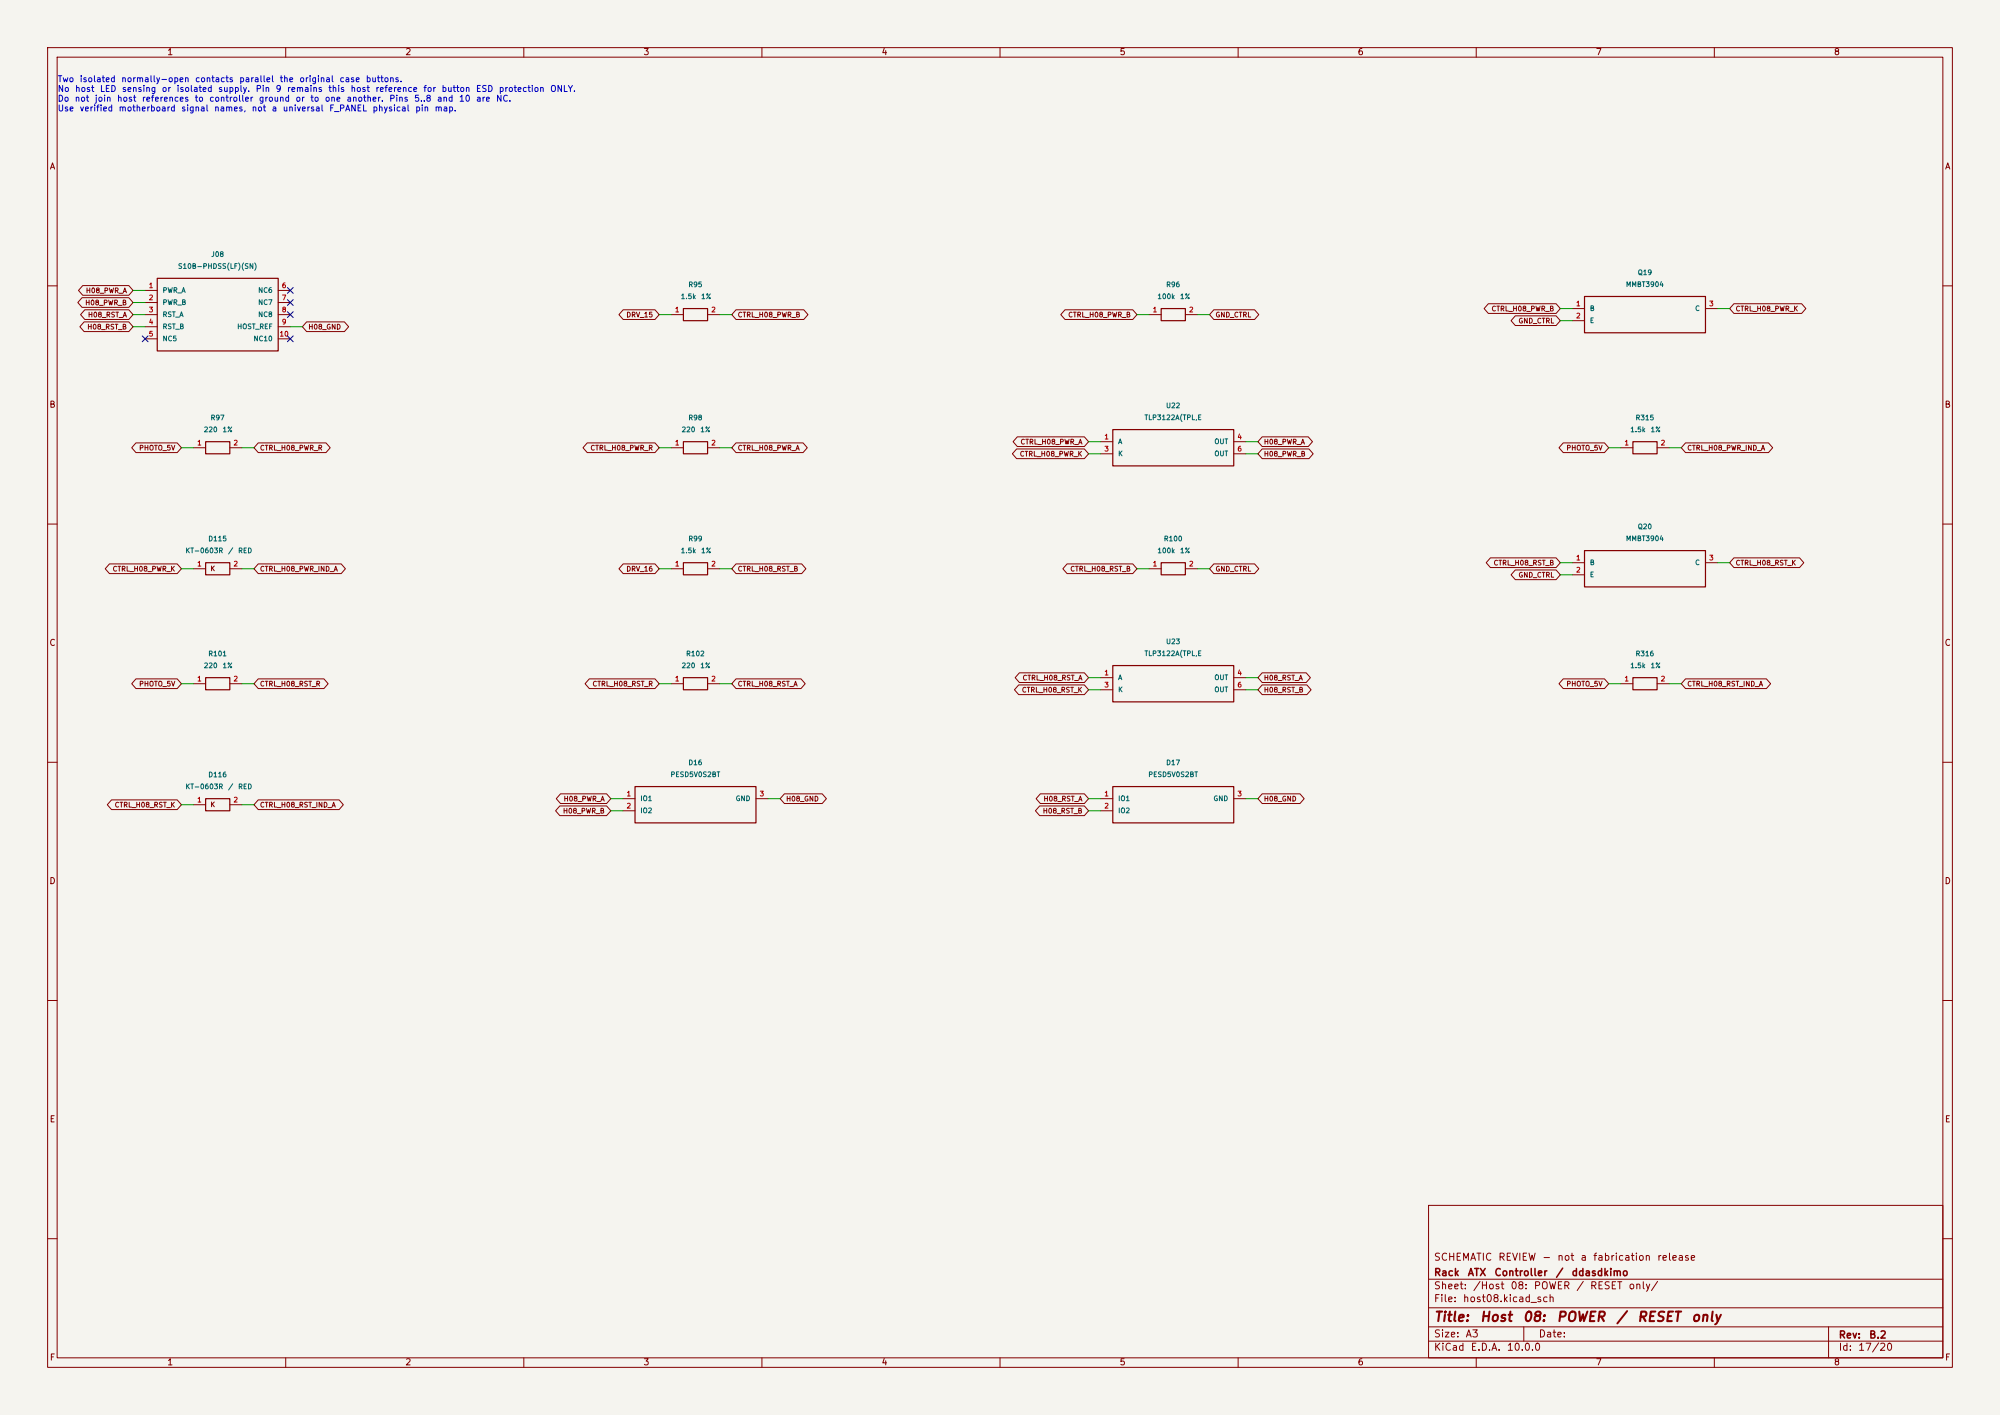
[picture p33: page 17]

Rack ATX Controller / ddasdkimo SCHEMATIC REVIEW - not a fabrication release

Sheet: /Host 08: POWER / RESET only/
File: host08.kicad_sch
Title: Host 08: POWER / RESET only

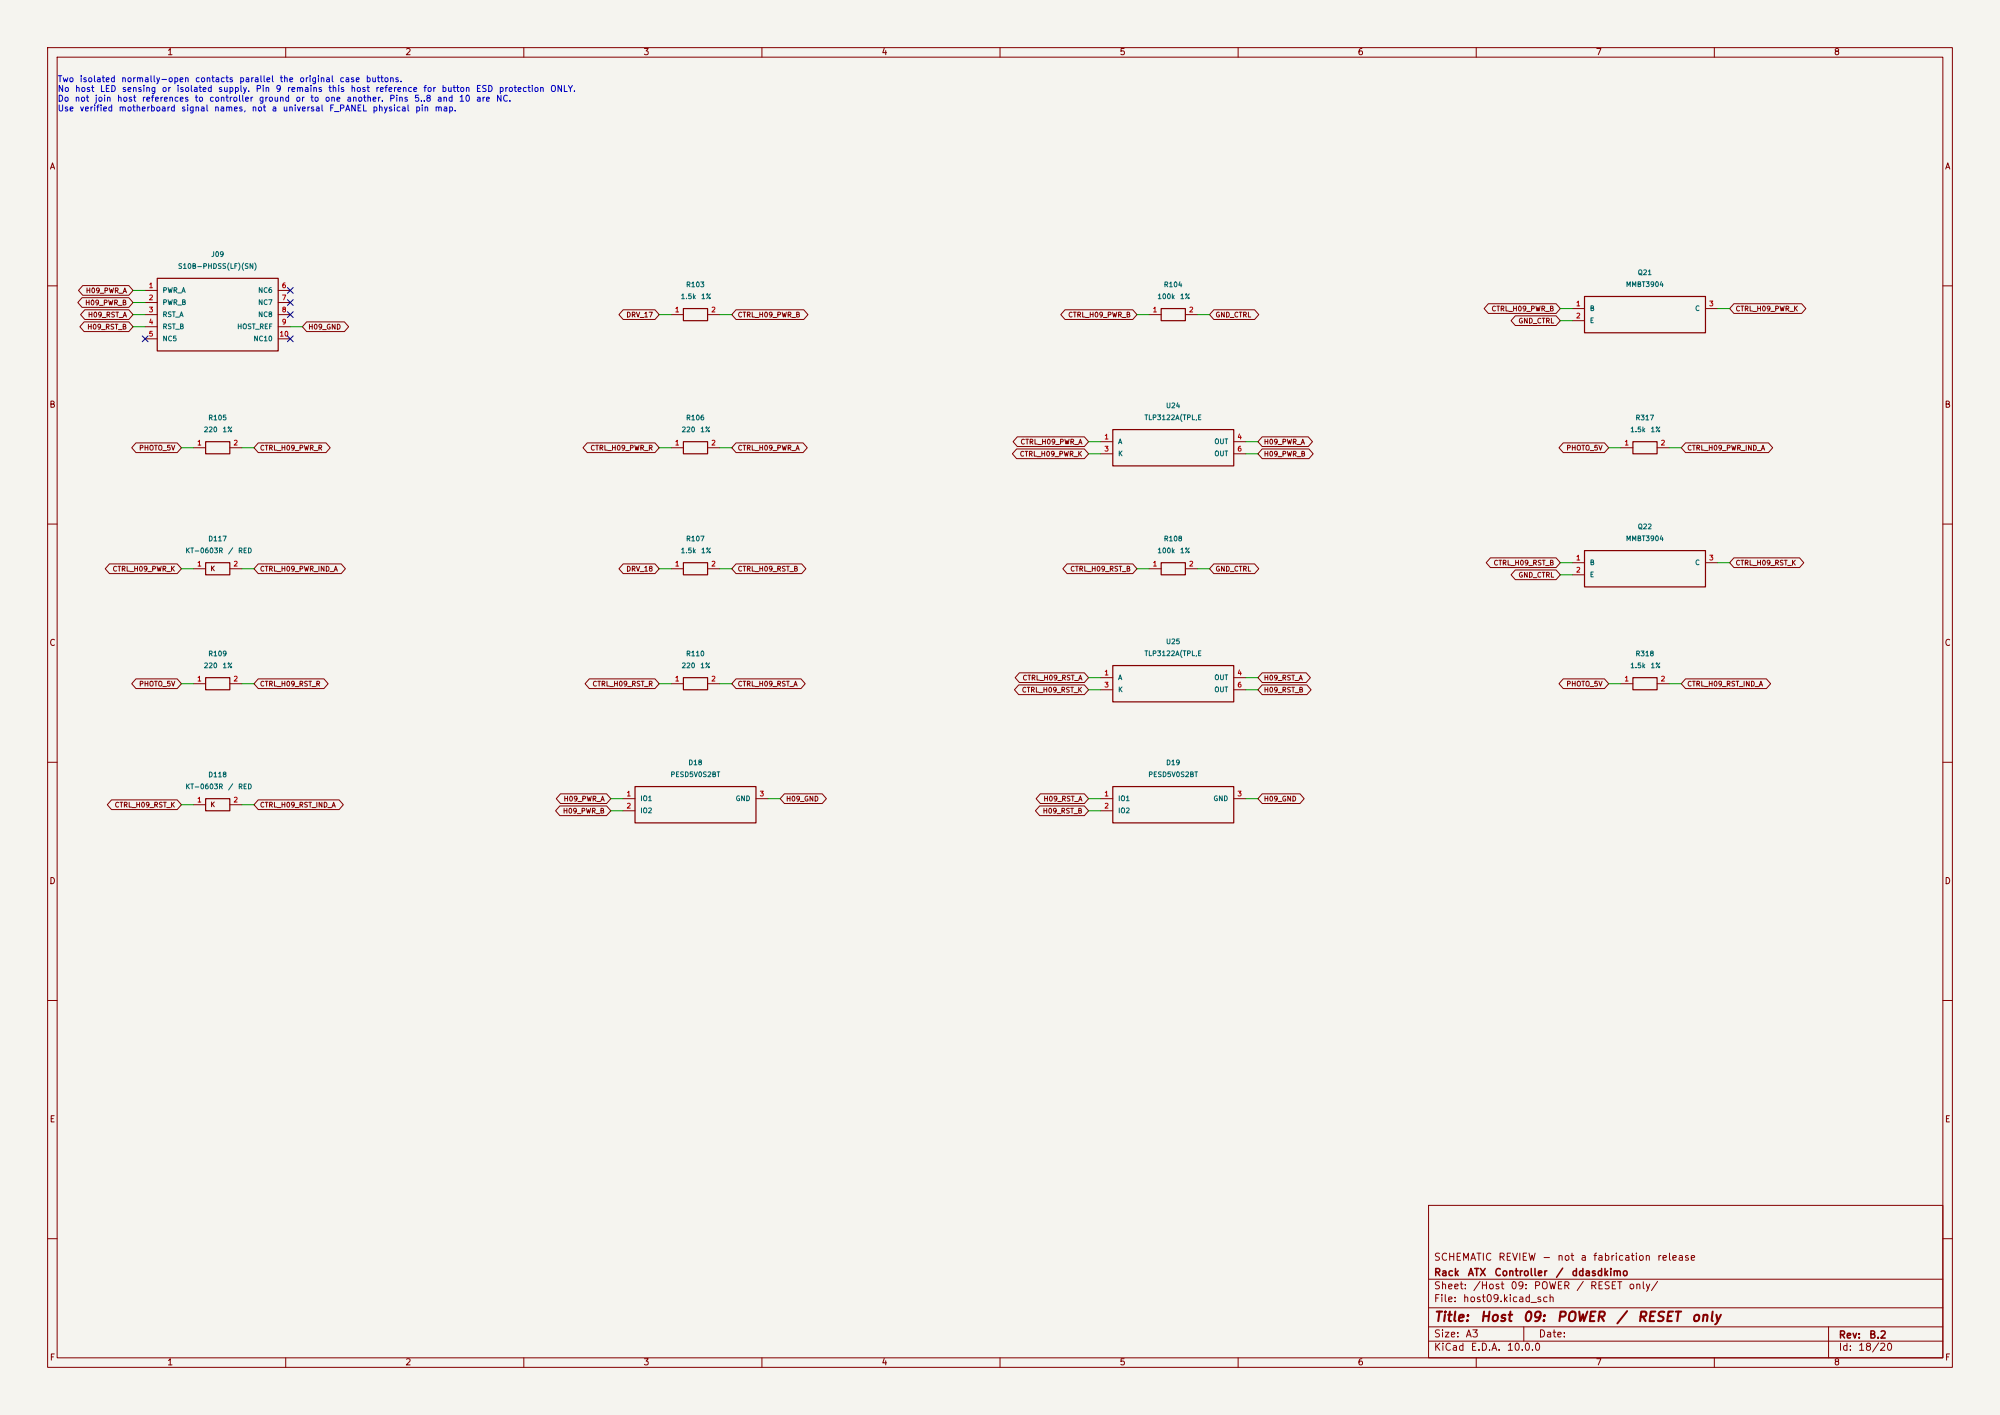
[picture p34: page 18]

Rack ATX Controller / ddasdkimo SCHEMATIC REVIEW - not a fabrication release

Sheet: /Host 09: POWER / RESET only/
File: host09.kicad_sch
Title: Host 09: POWER / RESET only

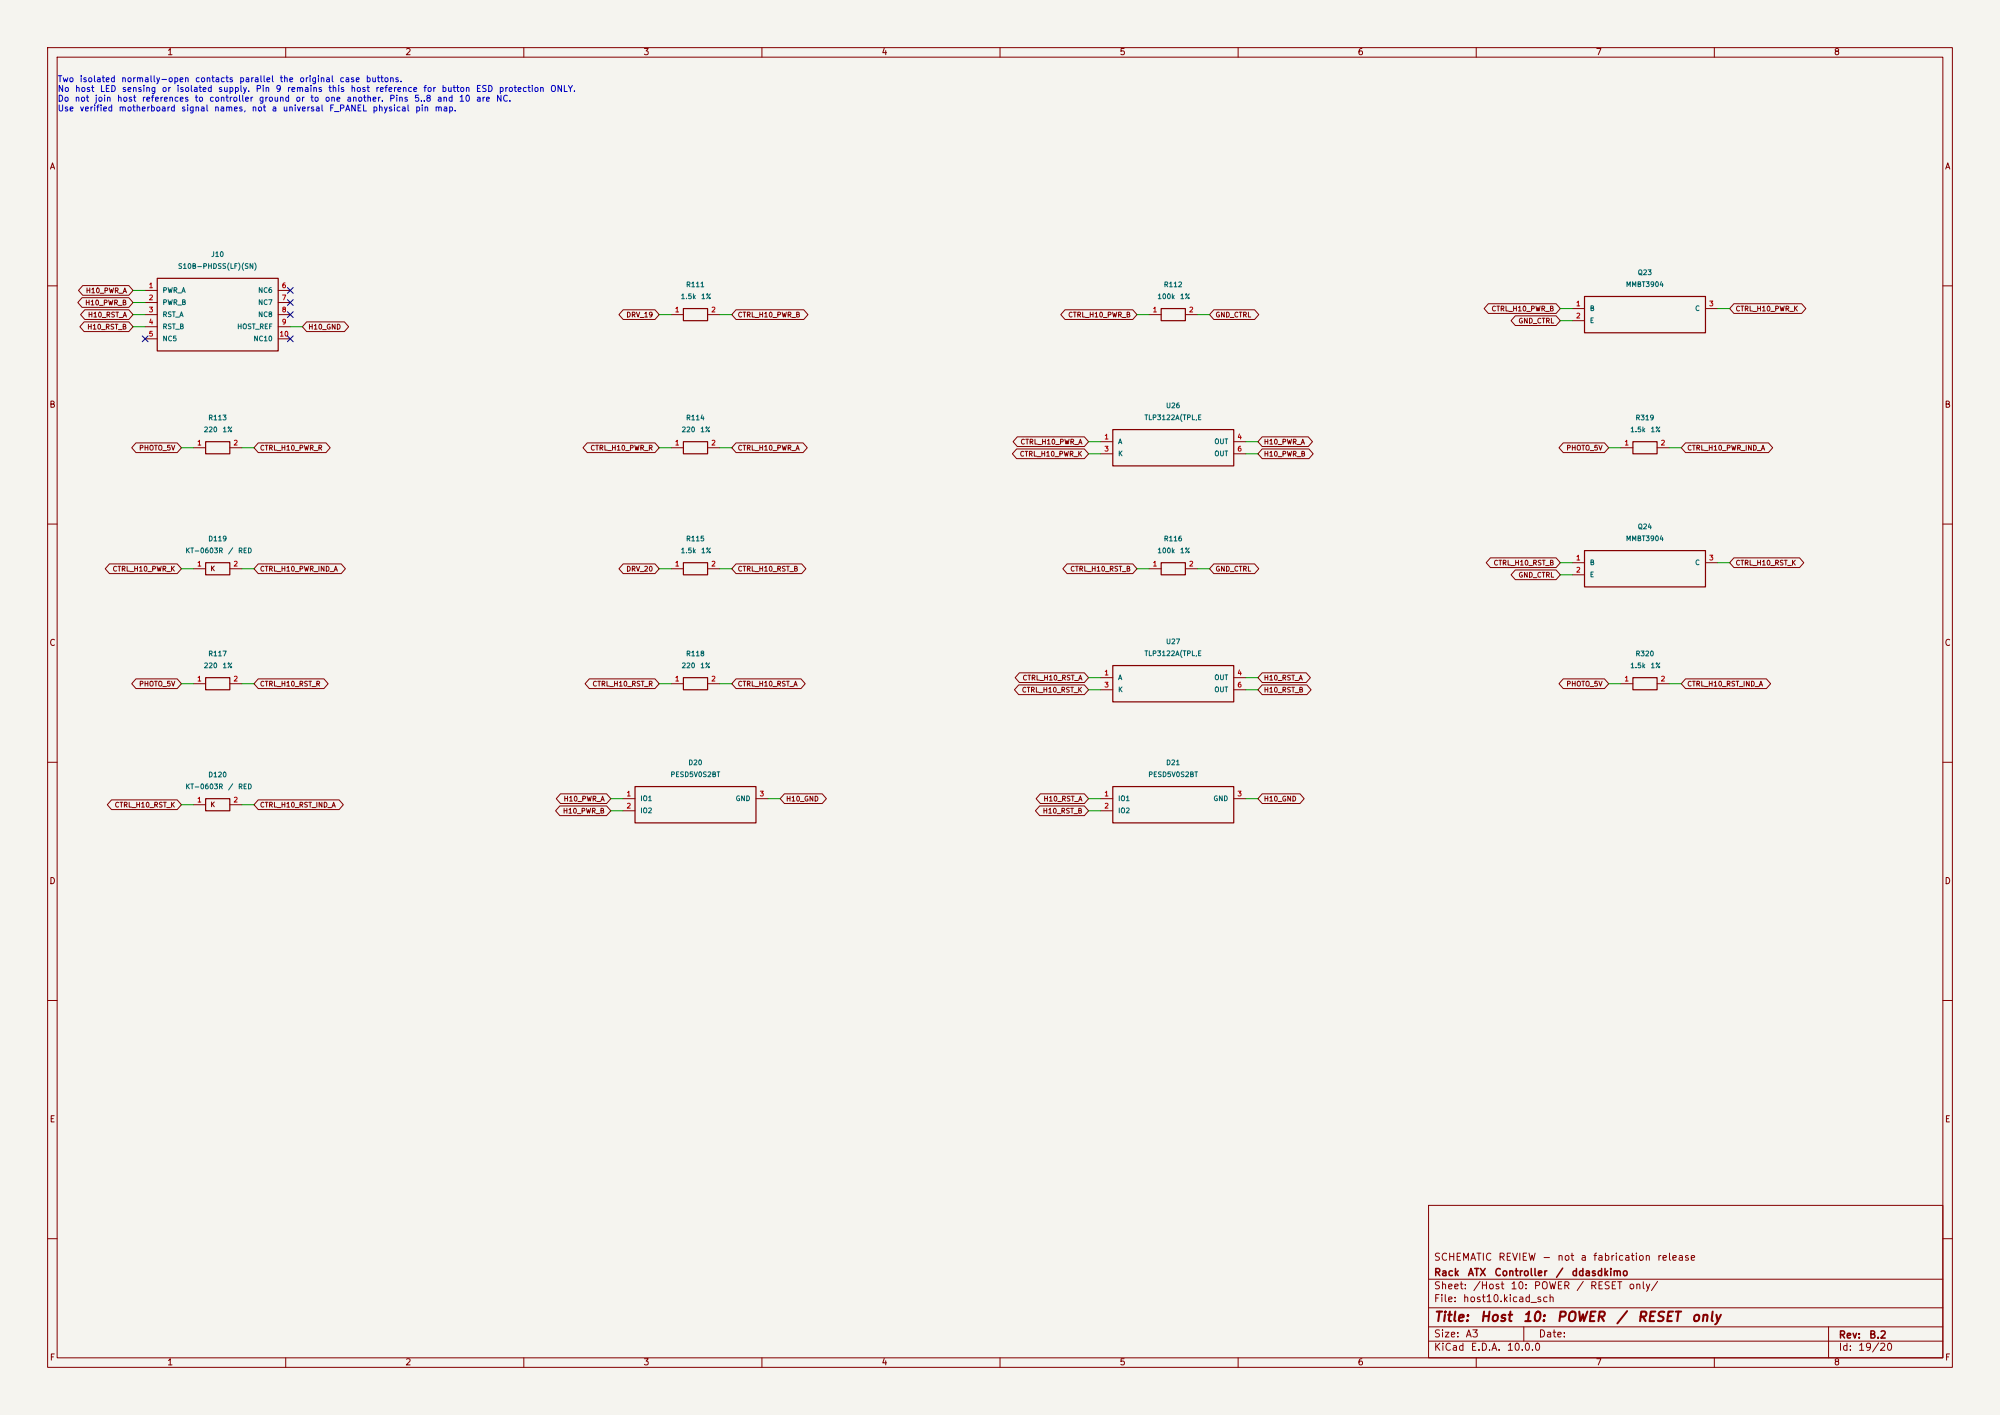
[picture p35: page 19]

Rack ATX Controller / ddasdkimo SCHEMATIC REVIEW - not a fabrication release

Sheet: /Host 10: POWER / RESET only/
File: host10.kicad_sch
Title: Host 10: POWER / RESET only

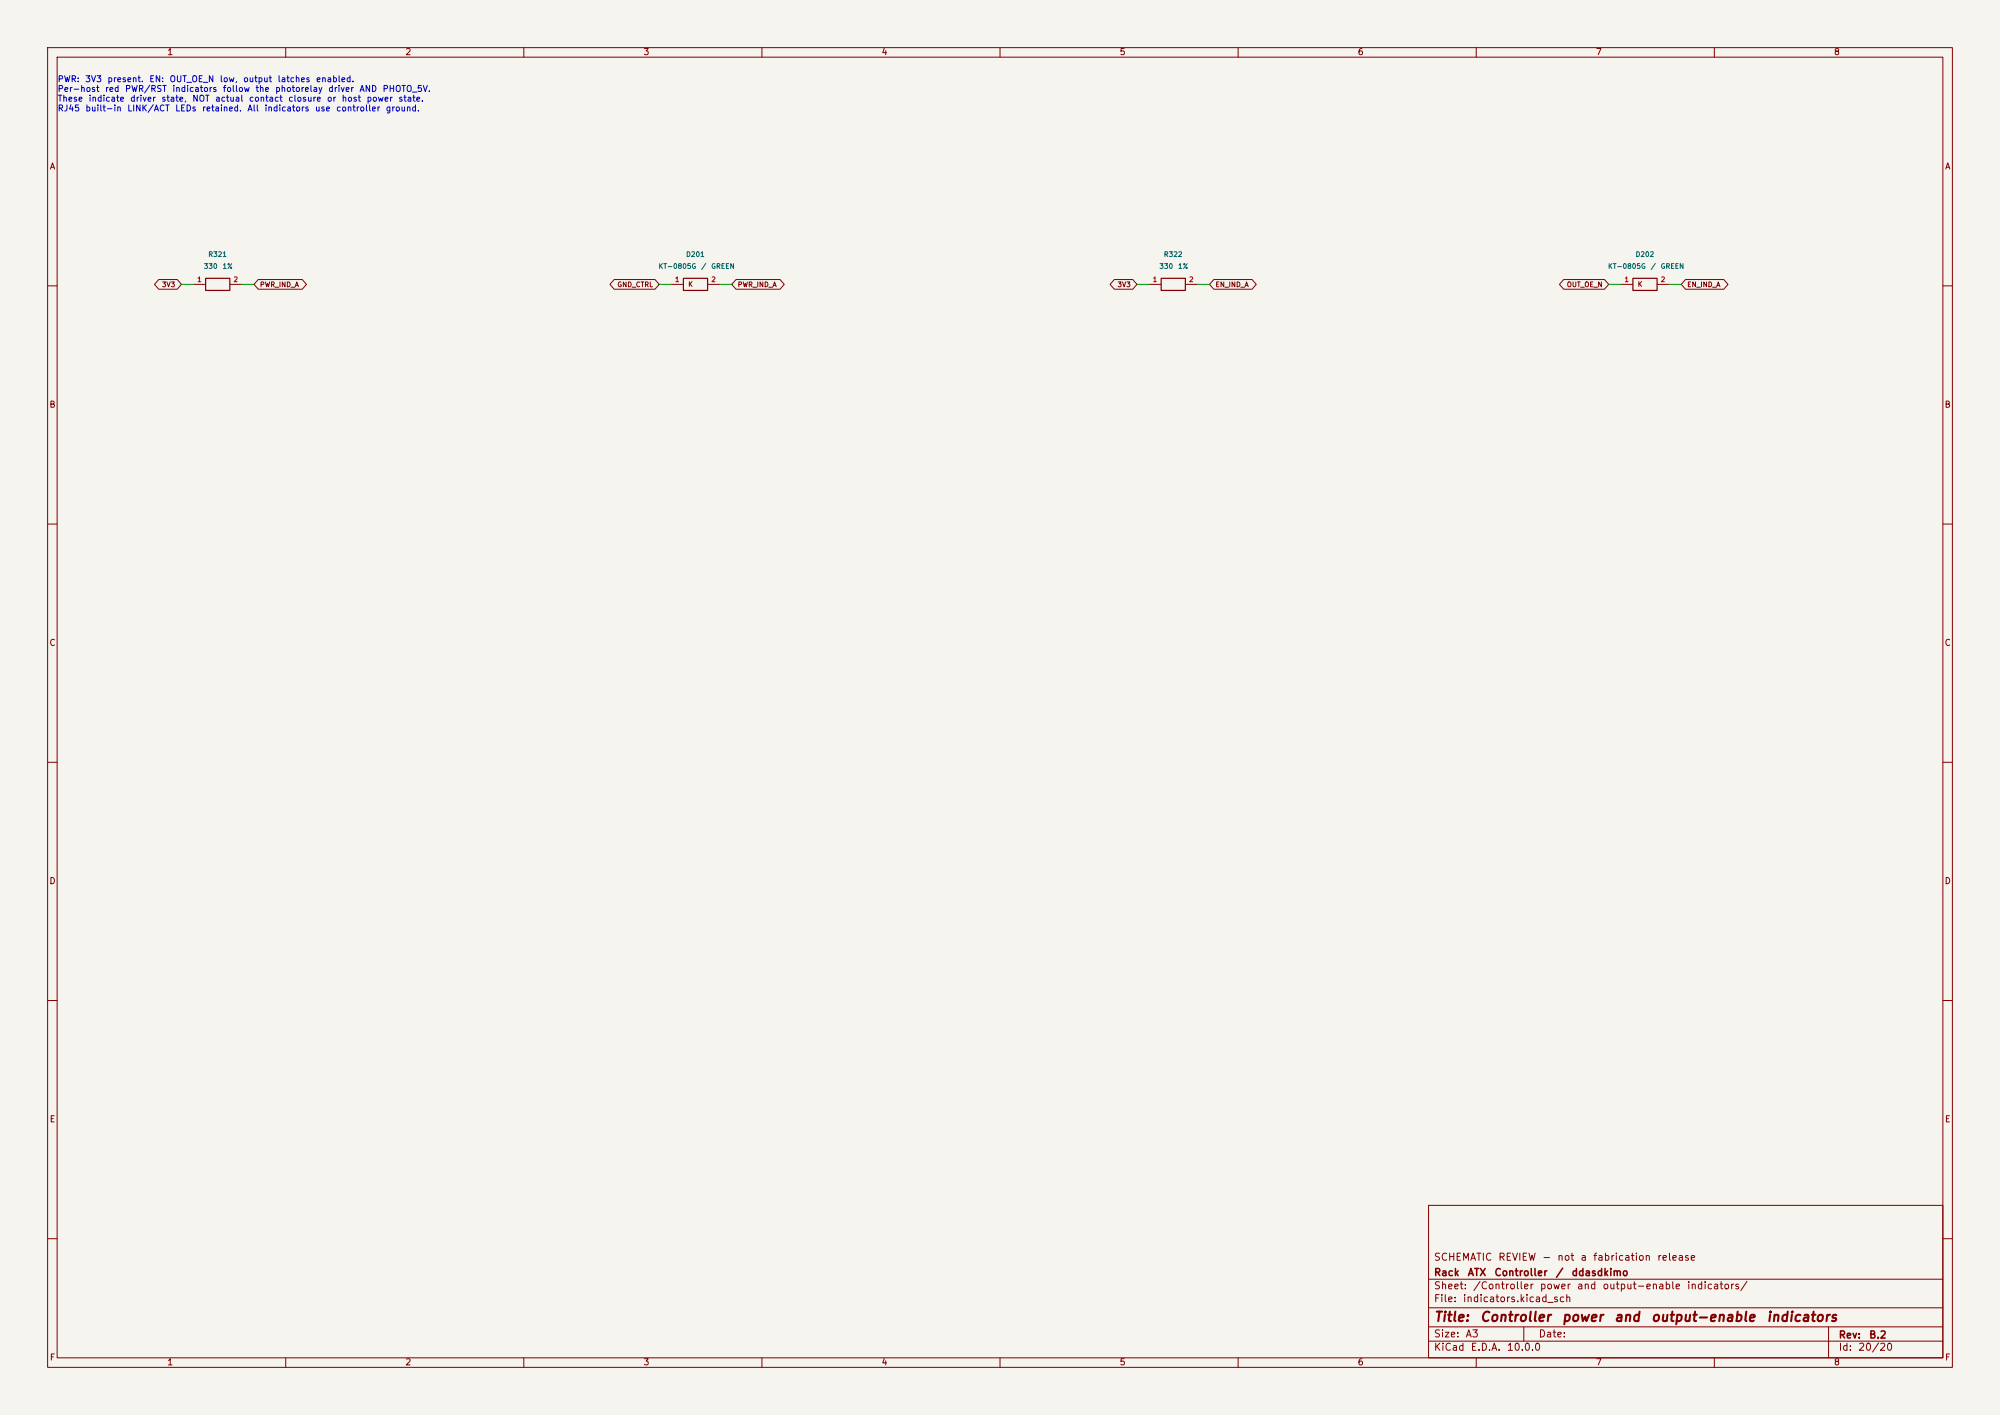
[picture p36: page 20]

Rack ATX Controller / ddasdkimo SCHEMATIC REVIEW - not a fabrication release

Sheet: /Controller power and output-enable indicators/
File: indicators.kicad_sch
Title: Controller power and output-enable indicators
