ddasdkimo/rack-atx-controller/hardware/archive/B1/release/controller-schematic.pdf

1 | 2 | 3 | 4 | 5 | 6 | 7 | 8

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
Size: A3 | Rev: B.1 | F Date:
KiCad E.D.A. 10.0.0 | Id: 1/39

# Title: 10-host rack ATX controller

## File: rack-atx-controller.kicad_sch

## Sheet: /

## SCHEMATIC REVIEW - no PCB routing or Gerber release

Host 10: isolated controls / LEDs (1/3) 檔案： host10_1.kicad_sch

5 V input, protection and 3.3 V buck 檔案： power.kicad_sch W5500 / HR911105A Ethernet (2/3) 檔案： ethernet_2.kicad_sch Host 01: isolated controls / LEDs (1/3) 檔案： host01_1.kicad_sch | W5500 / HR911105A Ethernet (1/3) 檔案： ethernet_1.kicad_sch Output latches / timed drive rail (2/2) 檔案： outputs_2.kicad_sch Host 02: isolated controls / LEDs (1/3) 檔案： host02_1.kicad_sch Host 03: isolated controls / LEDs (2/3) 檔案： host03_2.kicad_sch Host 04: isolated controls / LEDs (3/3) 檔案： host04_3.kicad_sch

ESP32-S3FN8 / USB programming (1/2) 檔案： processor_1.kicad_sch W5500 / HR911105A Ethernet (3/3) 檔案： ethernet_3.kicad_sch Host 01: isolated controls / LEDs (2/3) 檔案： host01_2.kicad_sch Host 02: isolated controls / LEDs (3/3) 檔案： host02_3.kicad_sch Host 04: isolated controls / LEDs (1/3) 檔案： host04_1.kicad_sch

ESP32-S3FN8 / USB programming (2/2) 檔案： processor_2.kicad_sch Output latches / timed drive rail (1/2) 檔案： outputs_1.kicad_sch Host 01: isolated controls / LEDs (3/3) 檔案： host01_3.kicad_sch Host 03: isolated controls / LEDs (1/3) 檔案： host03_1.kicad_sch Host 04: isolated controls / LEDs (2/3) 檔案： host04_2.kicad_sch Host 02: isolated controls / LEDs (2/3) 檔案： host02_2.kicad_sch Host 03: isolated controls / LEDs (3/3) 檔案： host03_3.kicad_sch Host 05: isolated controls / LEDs (1/3) 檔案： host05_1.kicad_sch Host 06: isolated controls / LEDs (2/3) 檔案： host06_2.kicad_sch Host 07: isolated controls / LEDs (3/3) 檔案： host07_3.kicad_sch Host 09: isolated controls / LEDs (1/3) 檔案： host09_1.kicad_sch Host 10: isolated controls / LEDs (2/3) 檔案： host10_2.kicad_sch

Host 05: isolated controls / LEDs (2/3) 檔案： host05_2.kicad_sch Host 06: isolated controls / LEDs (3/3) 檔案： host06_3.kicad_sch Host 08: isolated controls / LEDs (1/3) 檔案： host08_1.kicad_sch Host 09: isolated controls / LEDs (2/3) 檔案： host09_2.kicad_sch Host 10: isolated controls / LEDs (3/3) 檔案： host10_3.kicad_sch

Host 05: isolated controls / LEDs (3/3) 檔案： host05_3.kicad_sch Host 07: isolated controls / LEDs (1/3) 檔案： host07_1.kicad_sch Host 08: isolated controls / LEDs (2/3) 檔案： host08_2.kicad_sch Host 09: isolated controls / LEDs (3/3) 檔案： host09_3.kicad_sch

Host 06: isolated controls / LEDs (1/3) 檔案： host06_1.kicad_sch Host 07: isolated controls / LEDs (2/3) 檔案： host07_2.kicad_sch Host 08: isolated controls / LEDs (3/3) 檔案： host08_3.kicad_sch

# 5 V input -> 3.3 V logic / ten isolated host supplies ESP32-S3FN8 + W5500 -> three 74HC595 -> twenty isolated dry contacts Twenty differential LED detectors -> twenty isolated returns -> MCU GPIO Original case wiring bypasses this controller on passive adapters

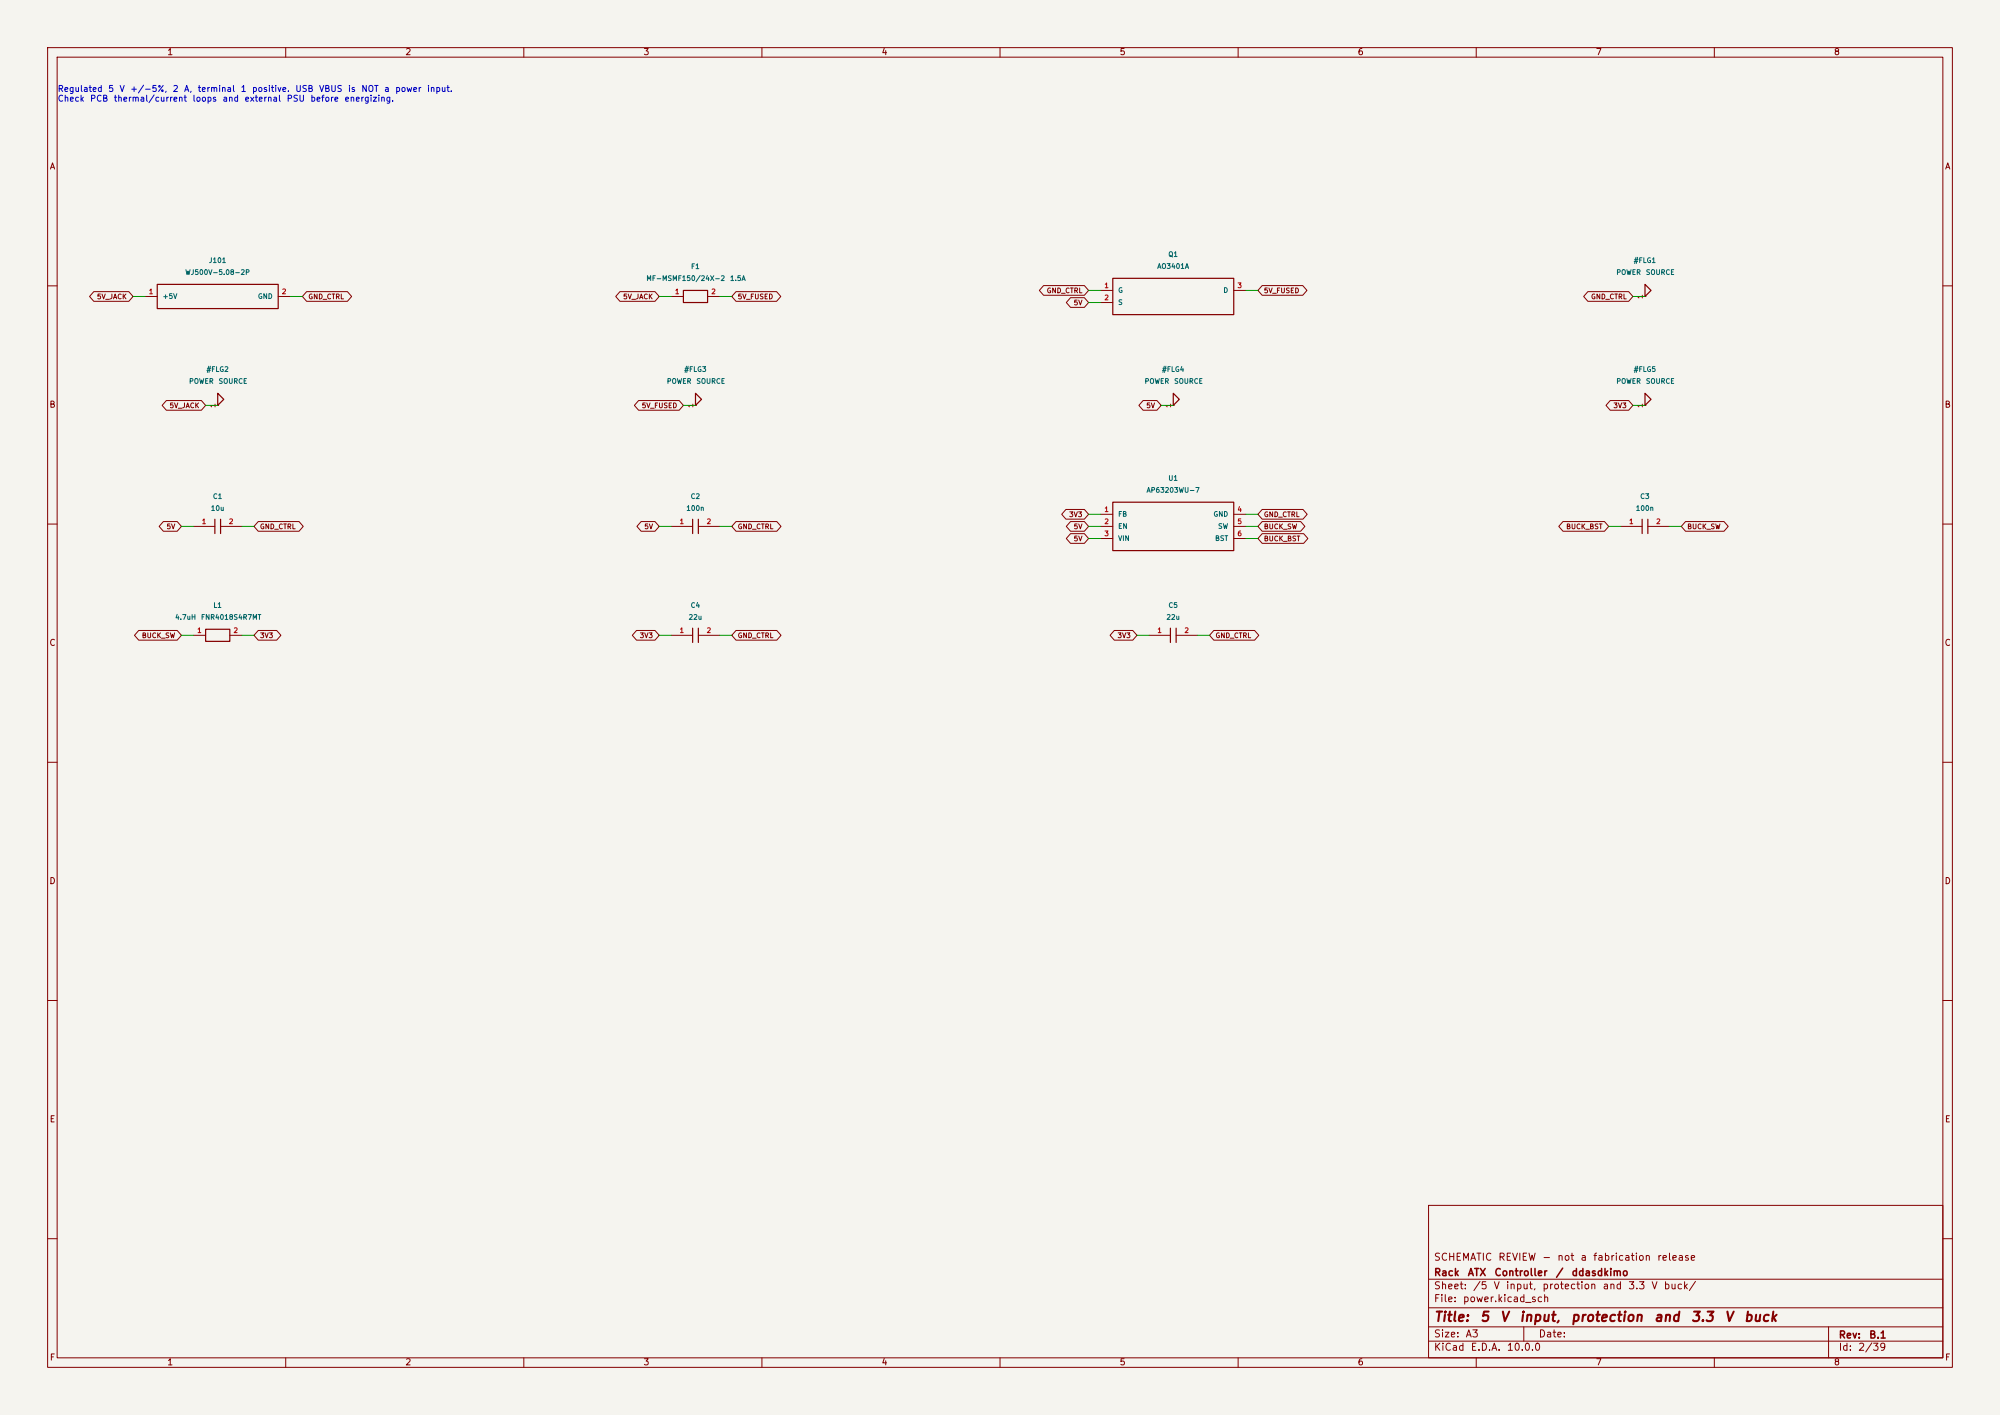
[picture p37: page 2]

Check PCB thermal/current loops and external PSU before energizing.

Rack ATX Controller / ddasdkimo SCHEMATIC REVIEW - not a fabrication release

Sheet: /5 V input, protection and 3.3 V buck/
File: power.kicad_sch
Title: 5 V input, protection and 3.3 V buck

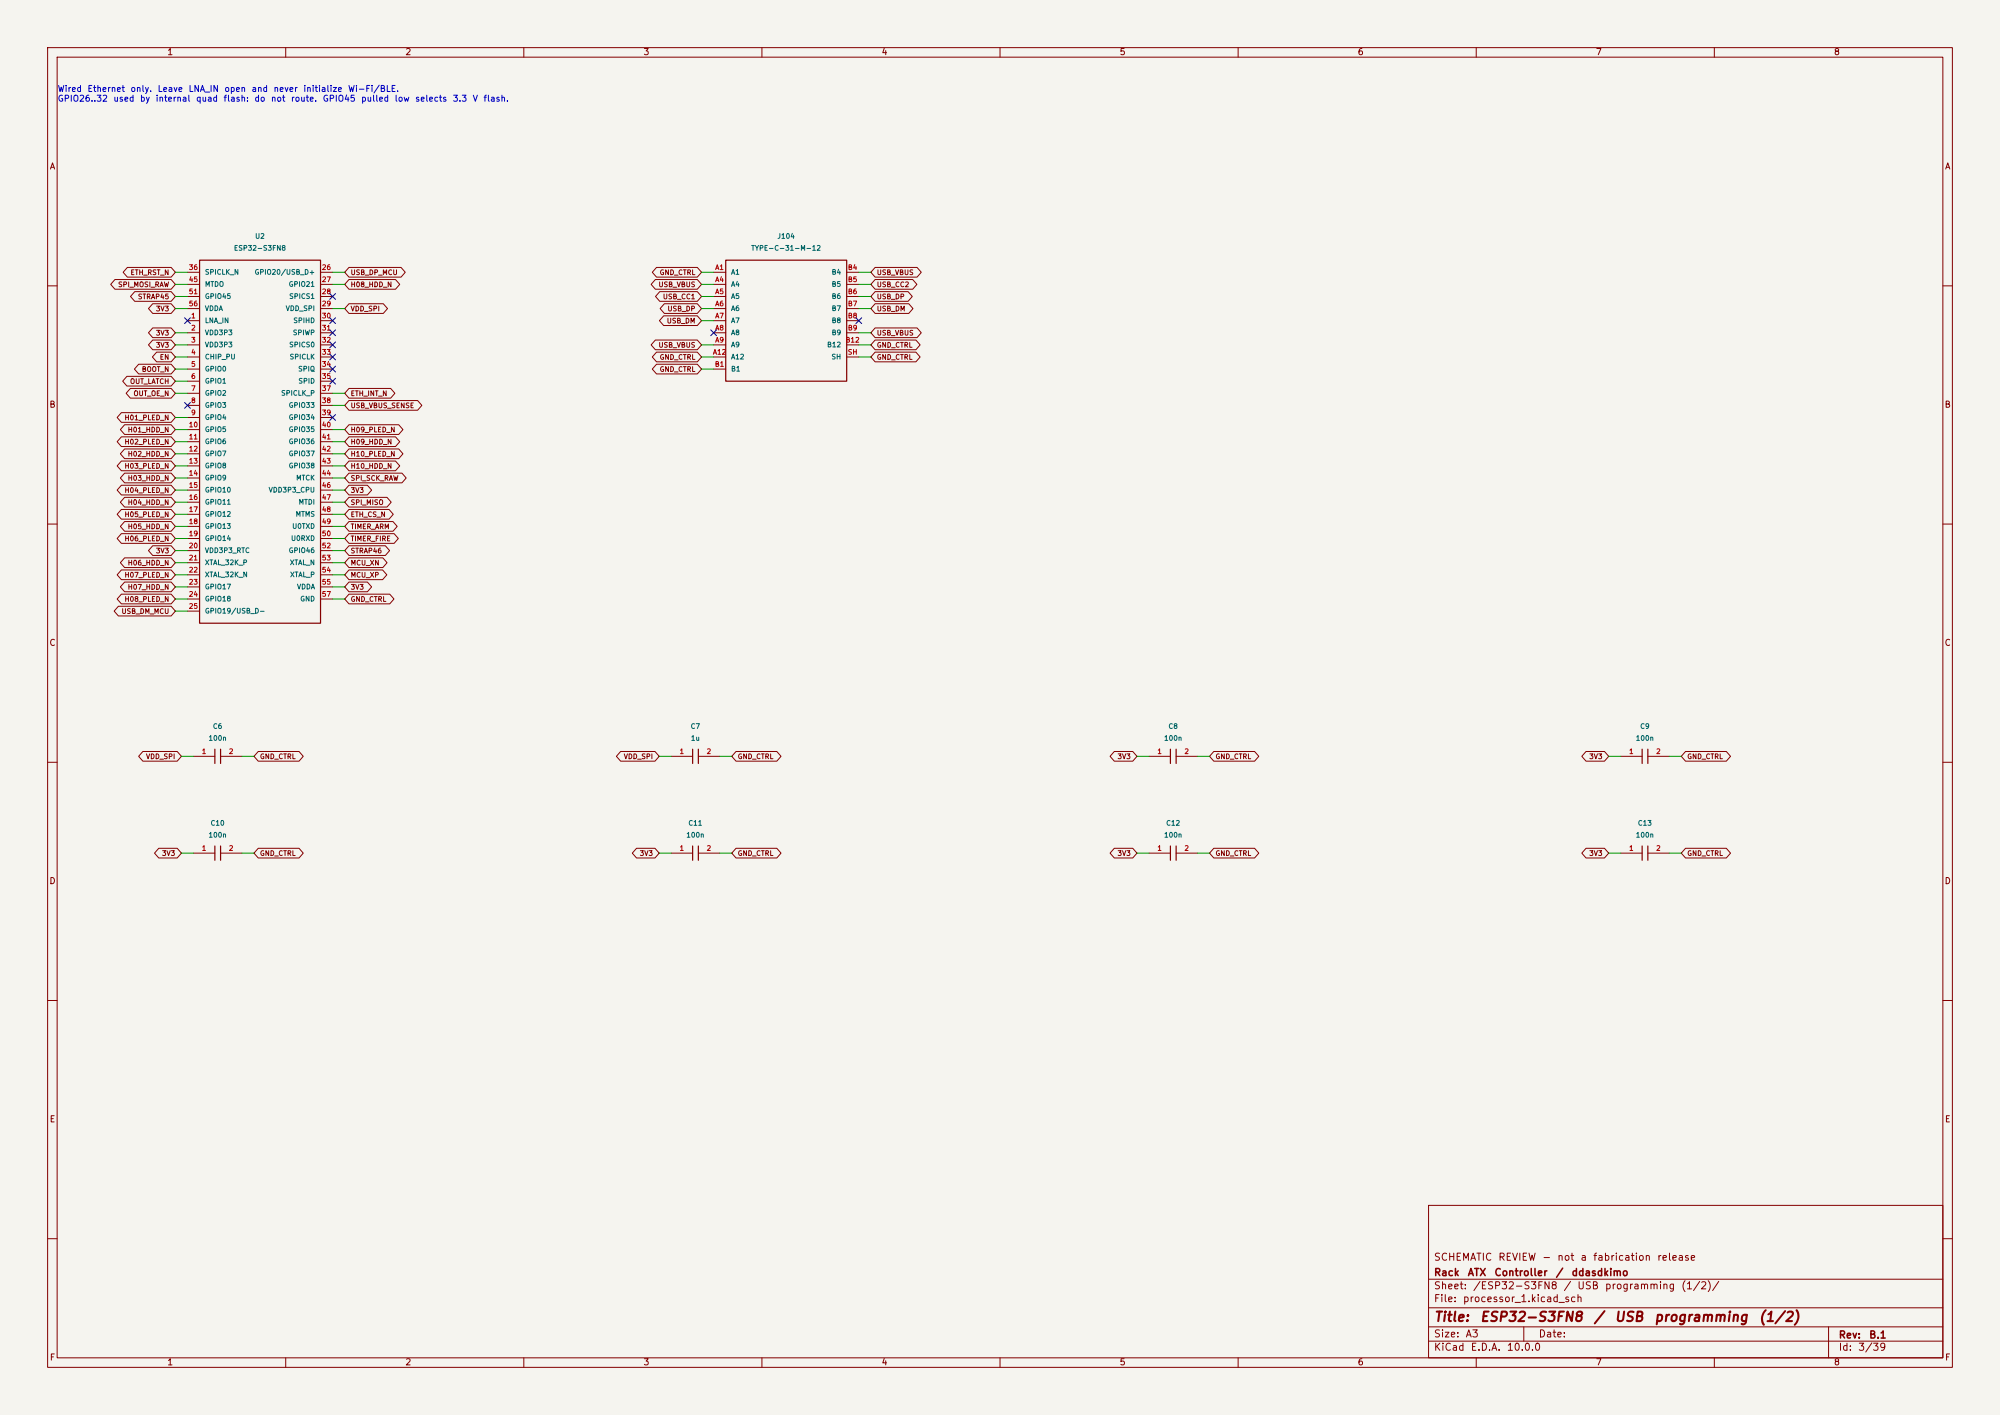
[picture p38: page 3]

USB_DP_MCU Wired Ethernet only. Leave LNA_IN open and never initialize Wi-Fi/BLE.
GPIO26..32 used by internal quad flash: do not route. GPIO45 pulled low selects 3.3 V flash.
LNA_IN 1
VDD3P3 2

Rack ATX Controller / ddasdkimo SCHEMATIC REVIEW - not a fabrication release

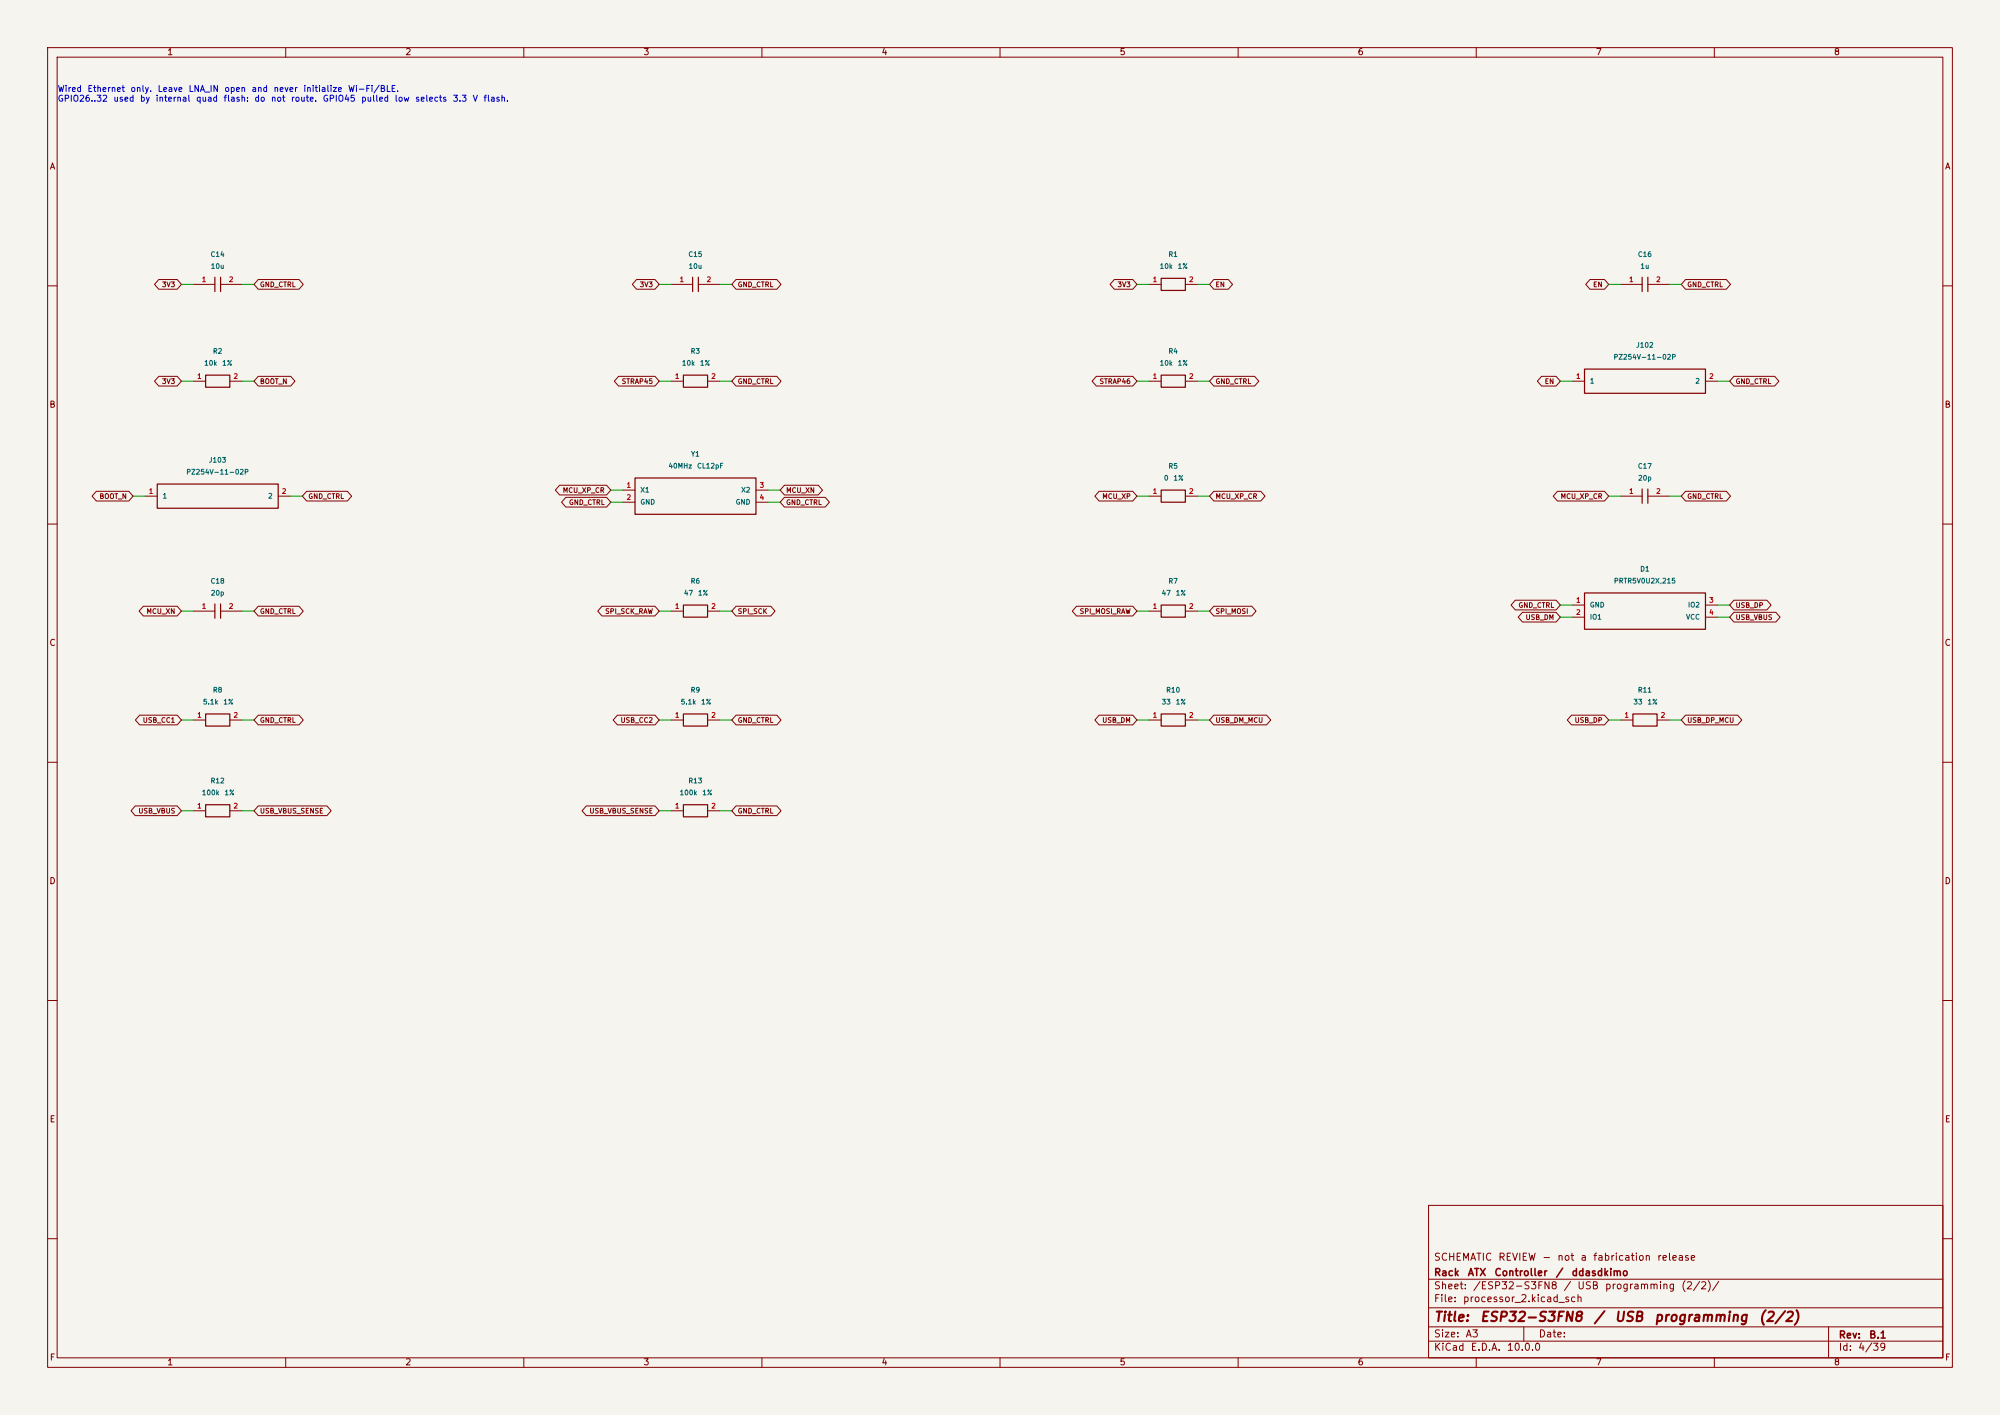
[picture p39: page 4]
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

Rack ATX Controller / ddasdkimo SCHEMATIC REVIEW - not a fabrication release

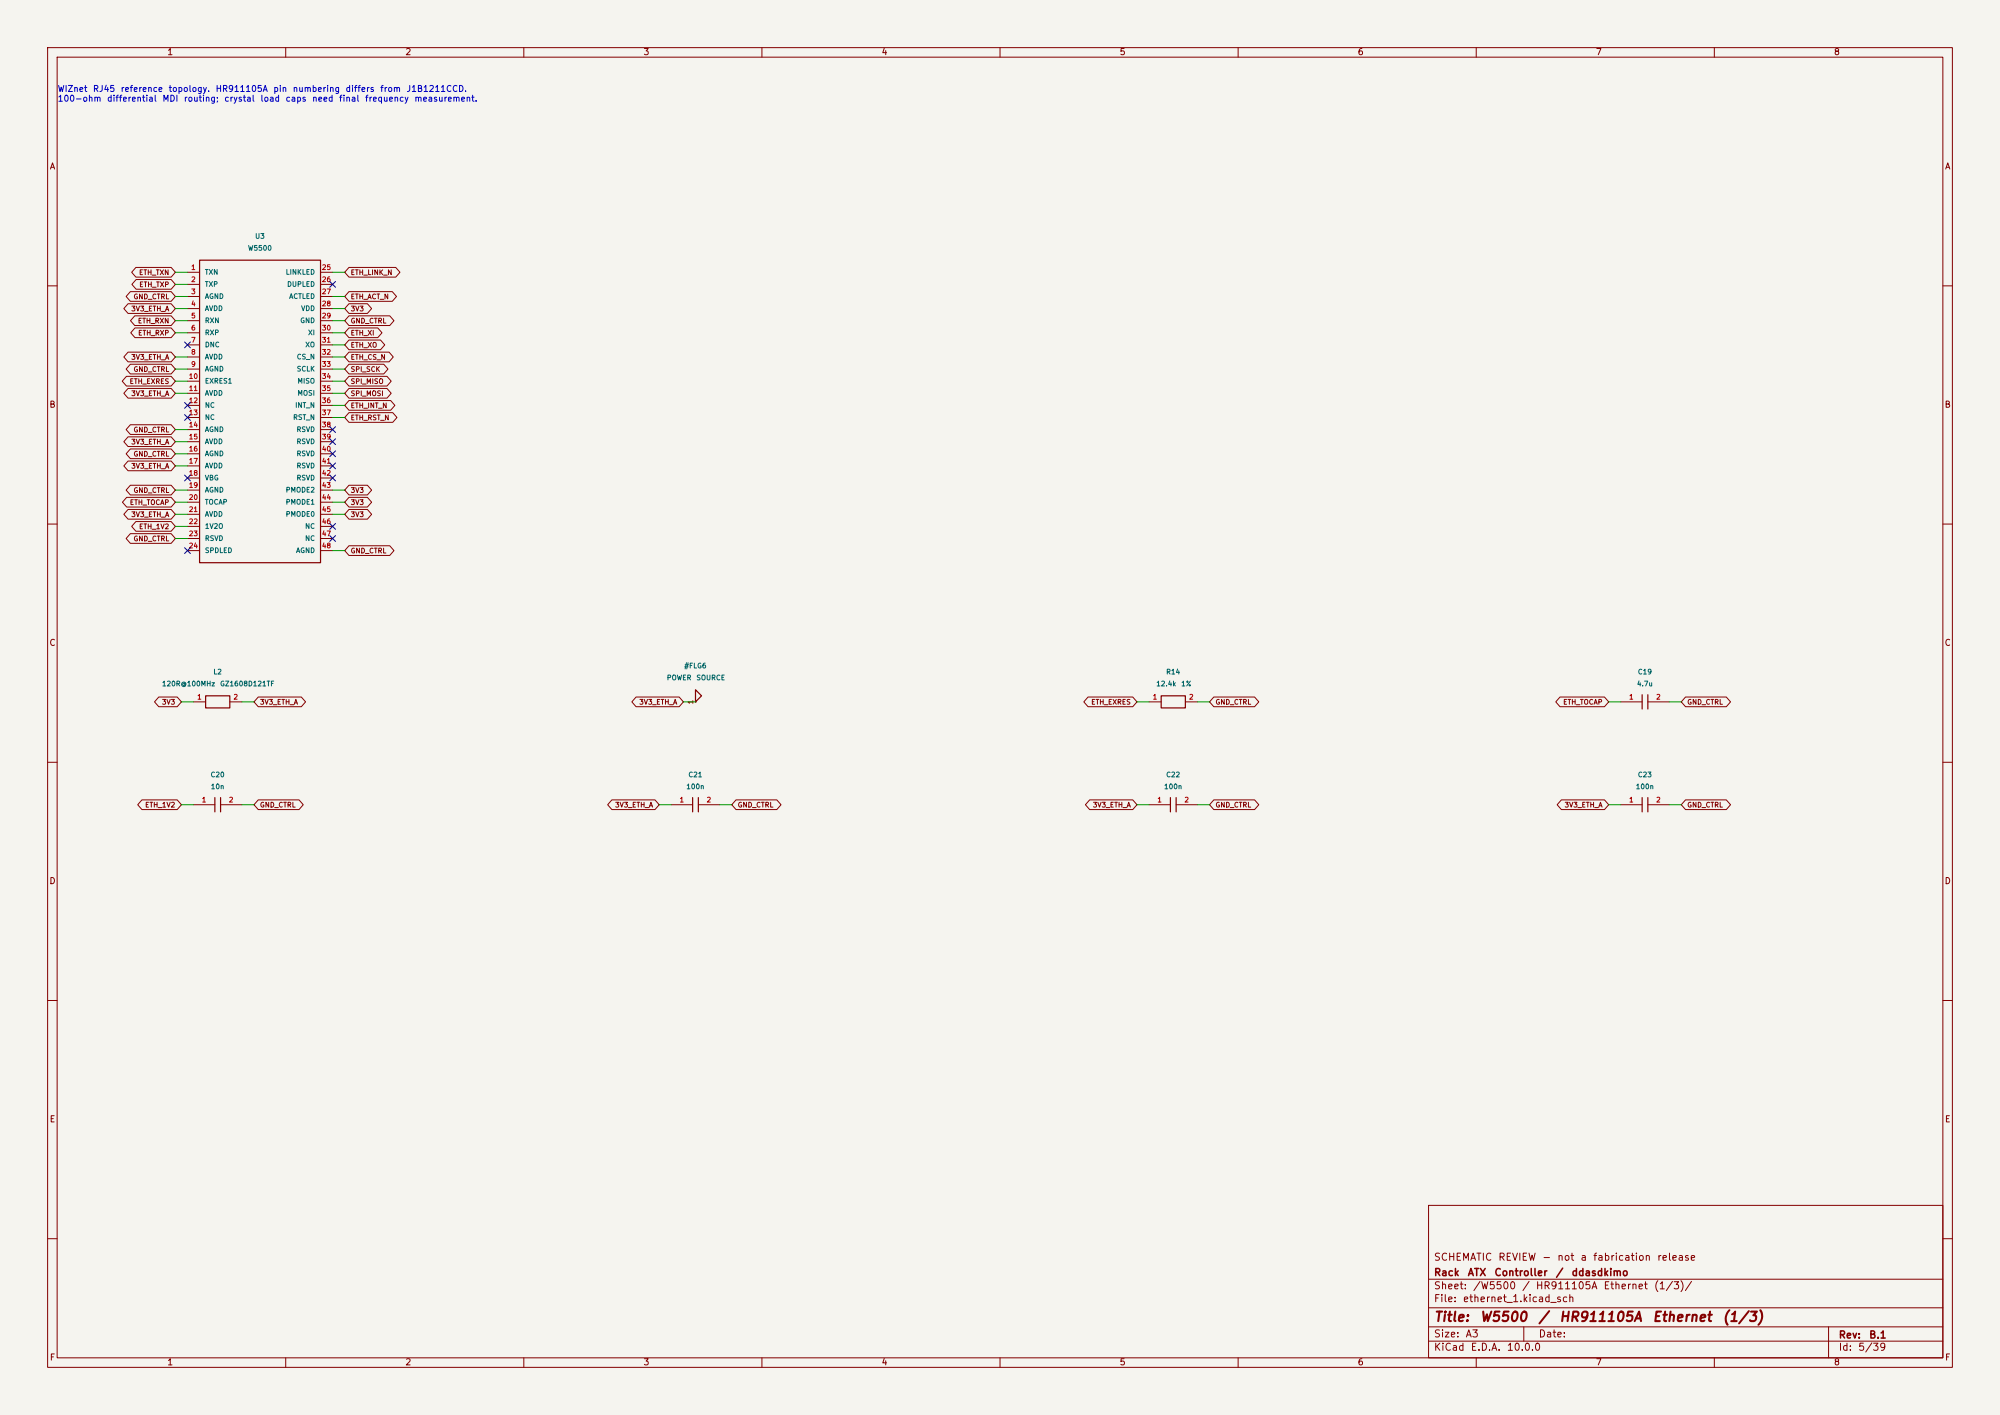
[picture p40: page 5]

WIZnet RJ45 reference topology. HR911105A pin numbering differs from J1B1211CCD. 100-ohm differential MDI routing; crystal load caps need final frequency measurement.
GND_CTRL 3V3_ETH_A GND_CTRL 3V3_ETH_A GND_CTRL 3V3_ETH_A GND_CTRL ETH_TOCAP

Rack ATX Controller / ddasdkimo SCHEMATIC REVIEW - not a fabrication release

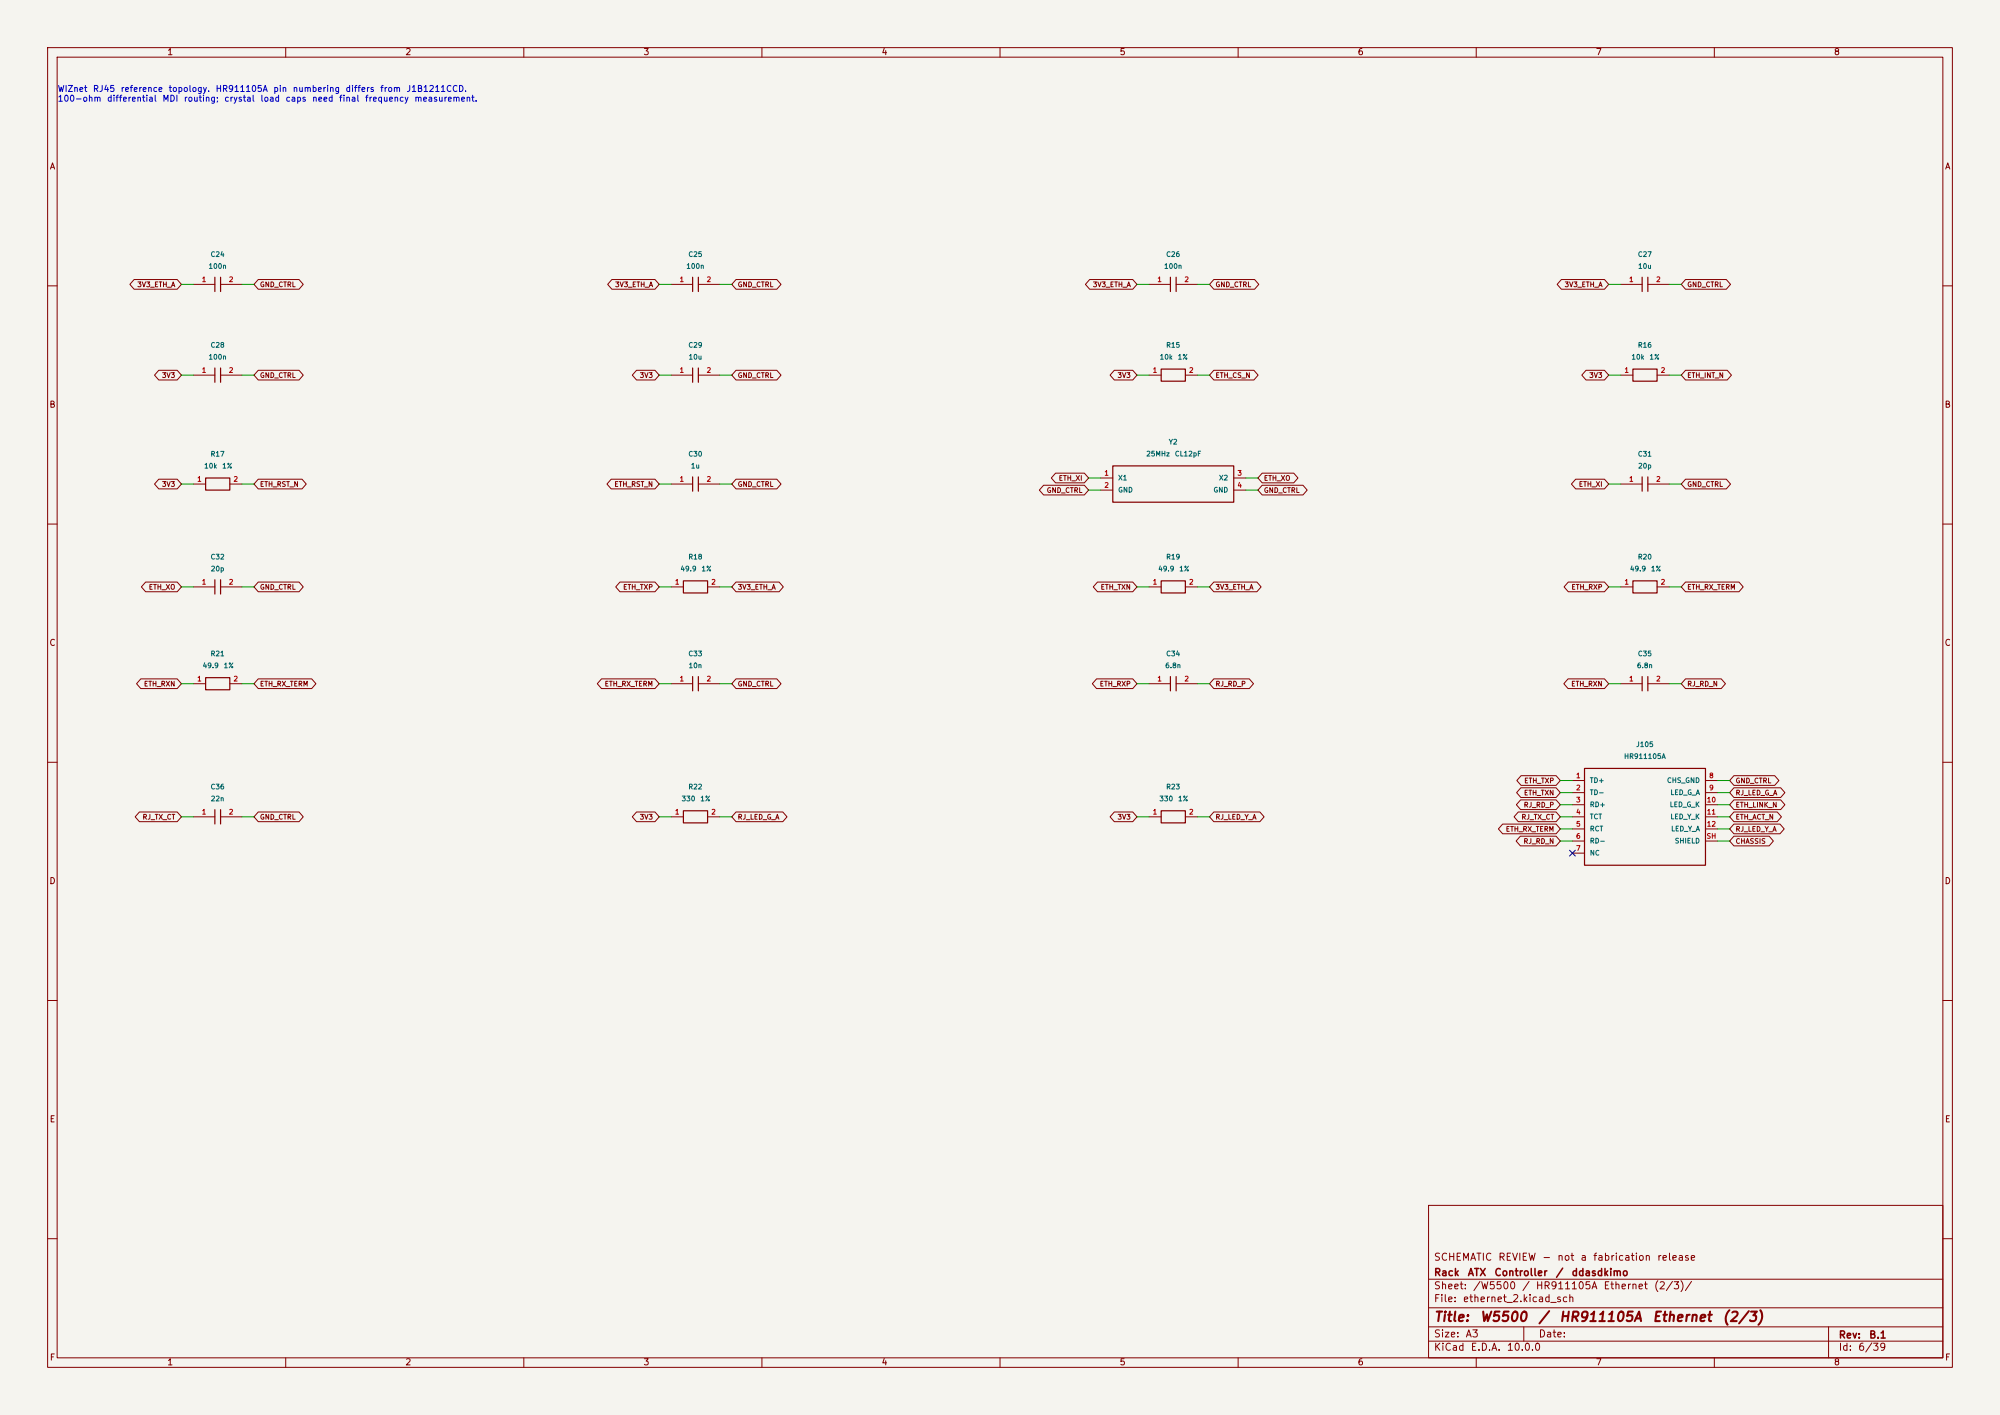
[picture p41: page 6]

Rack ATX Controller / ddasdkimo SCHEMATIC REVIEW - not a fabrication release

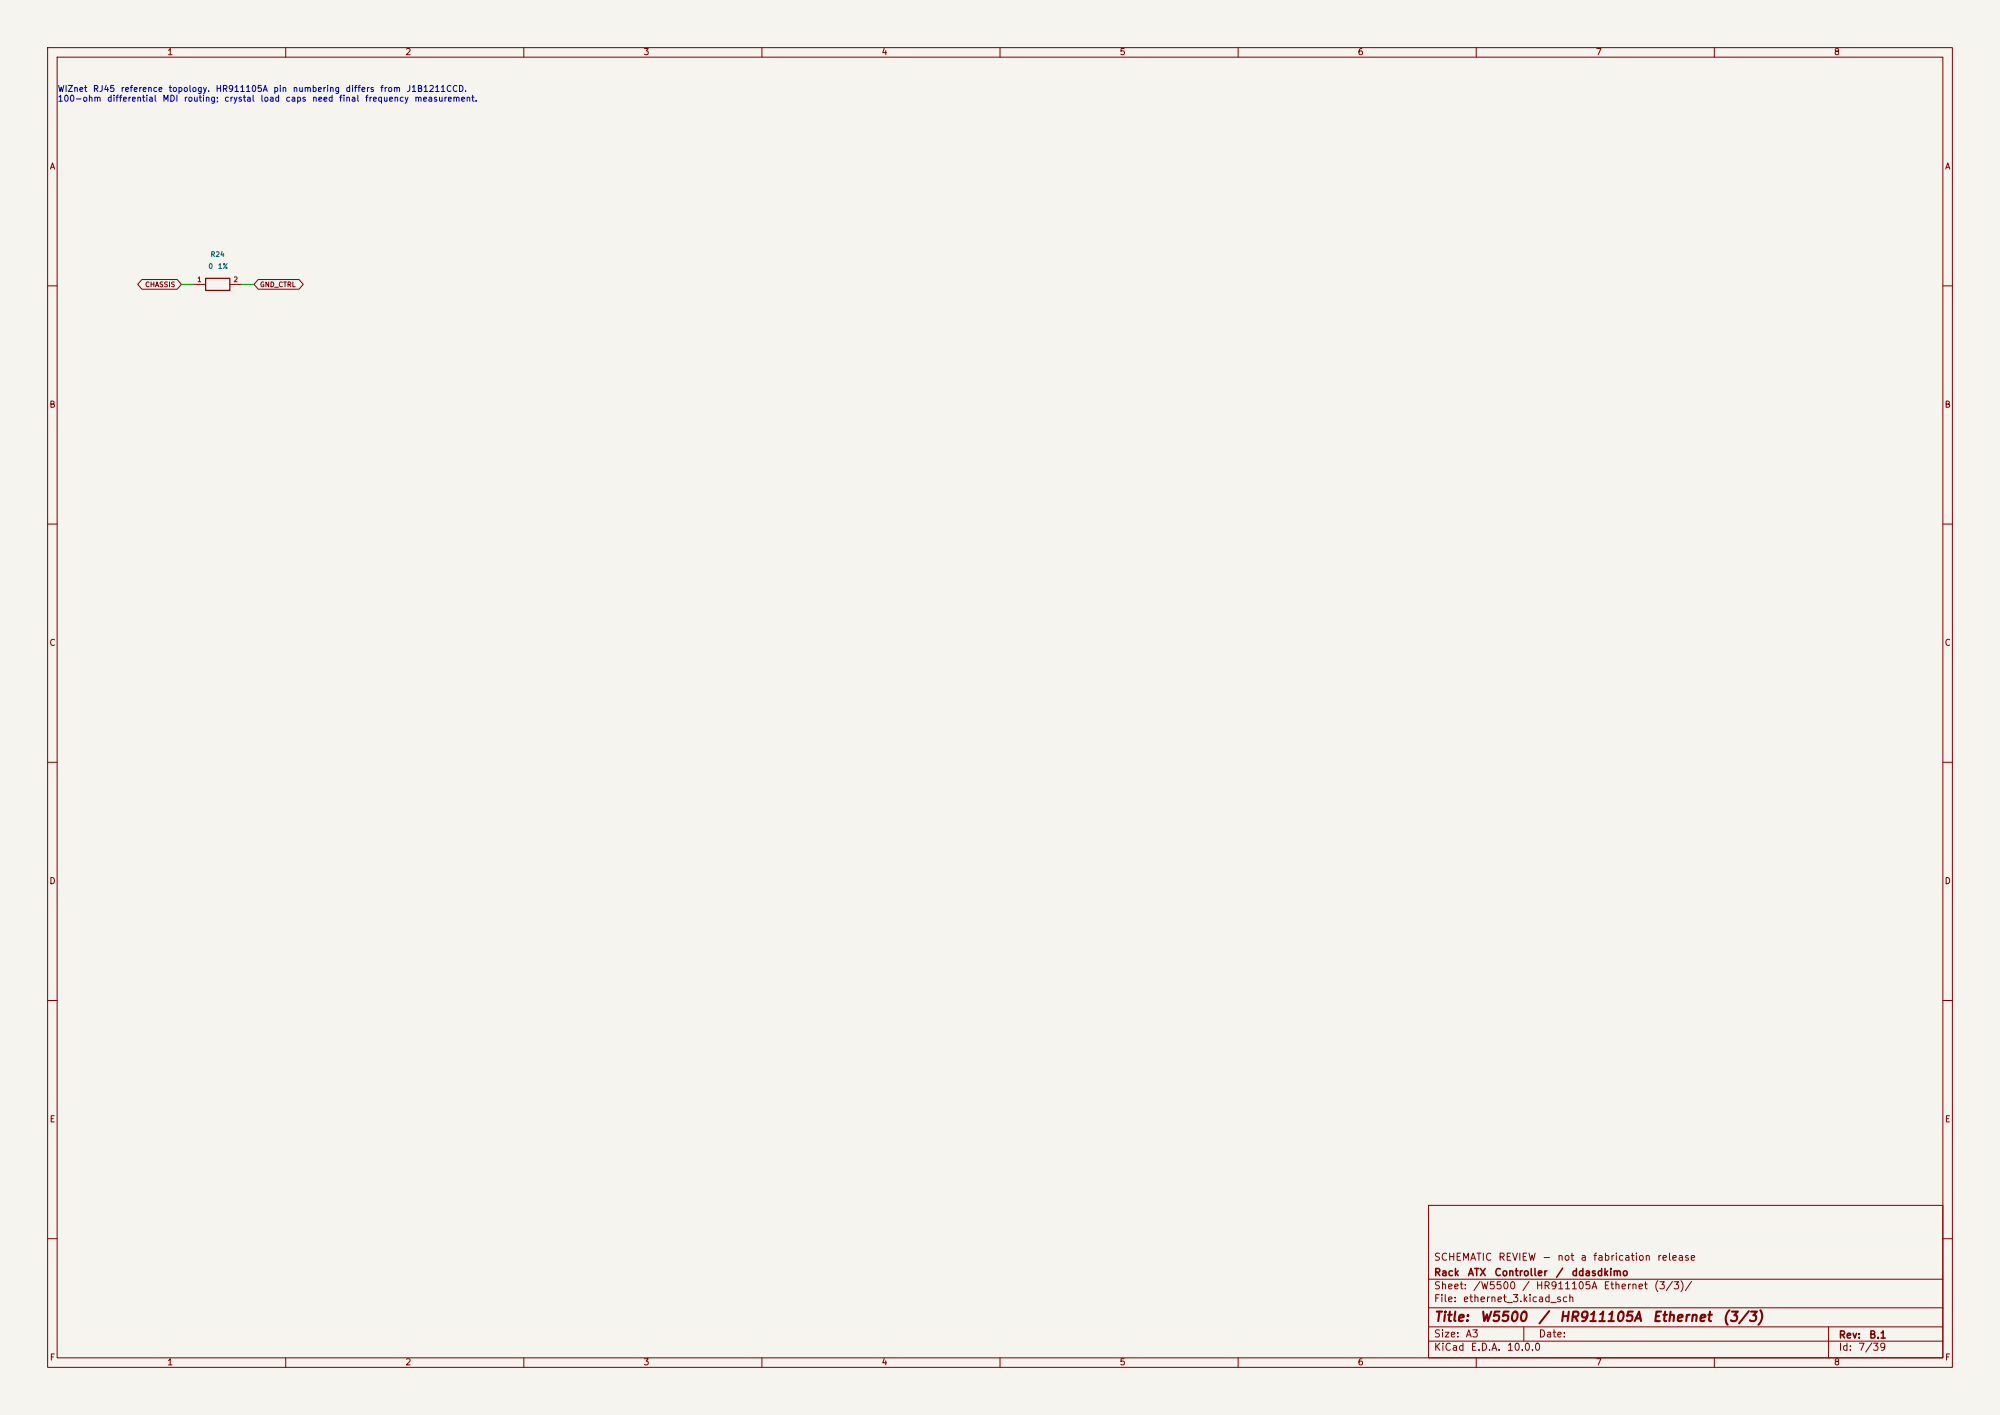
[picture p42: page 7]

Rack ATX Controller / ddasdkimo SCHEMATIC REVIEW - not a fabrication release

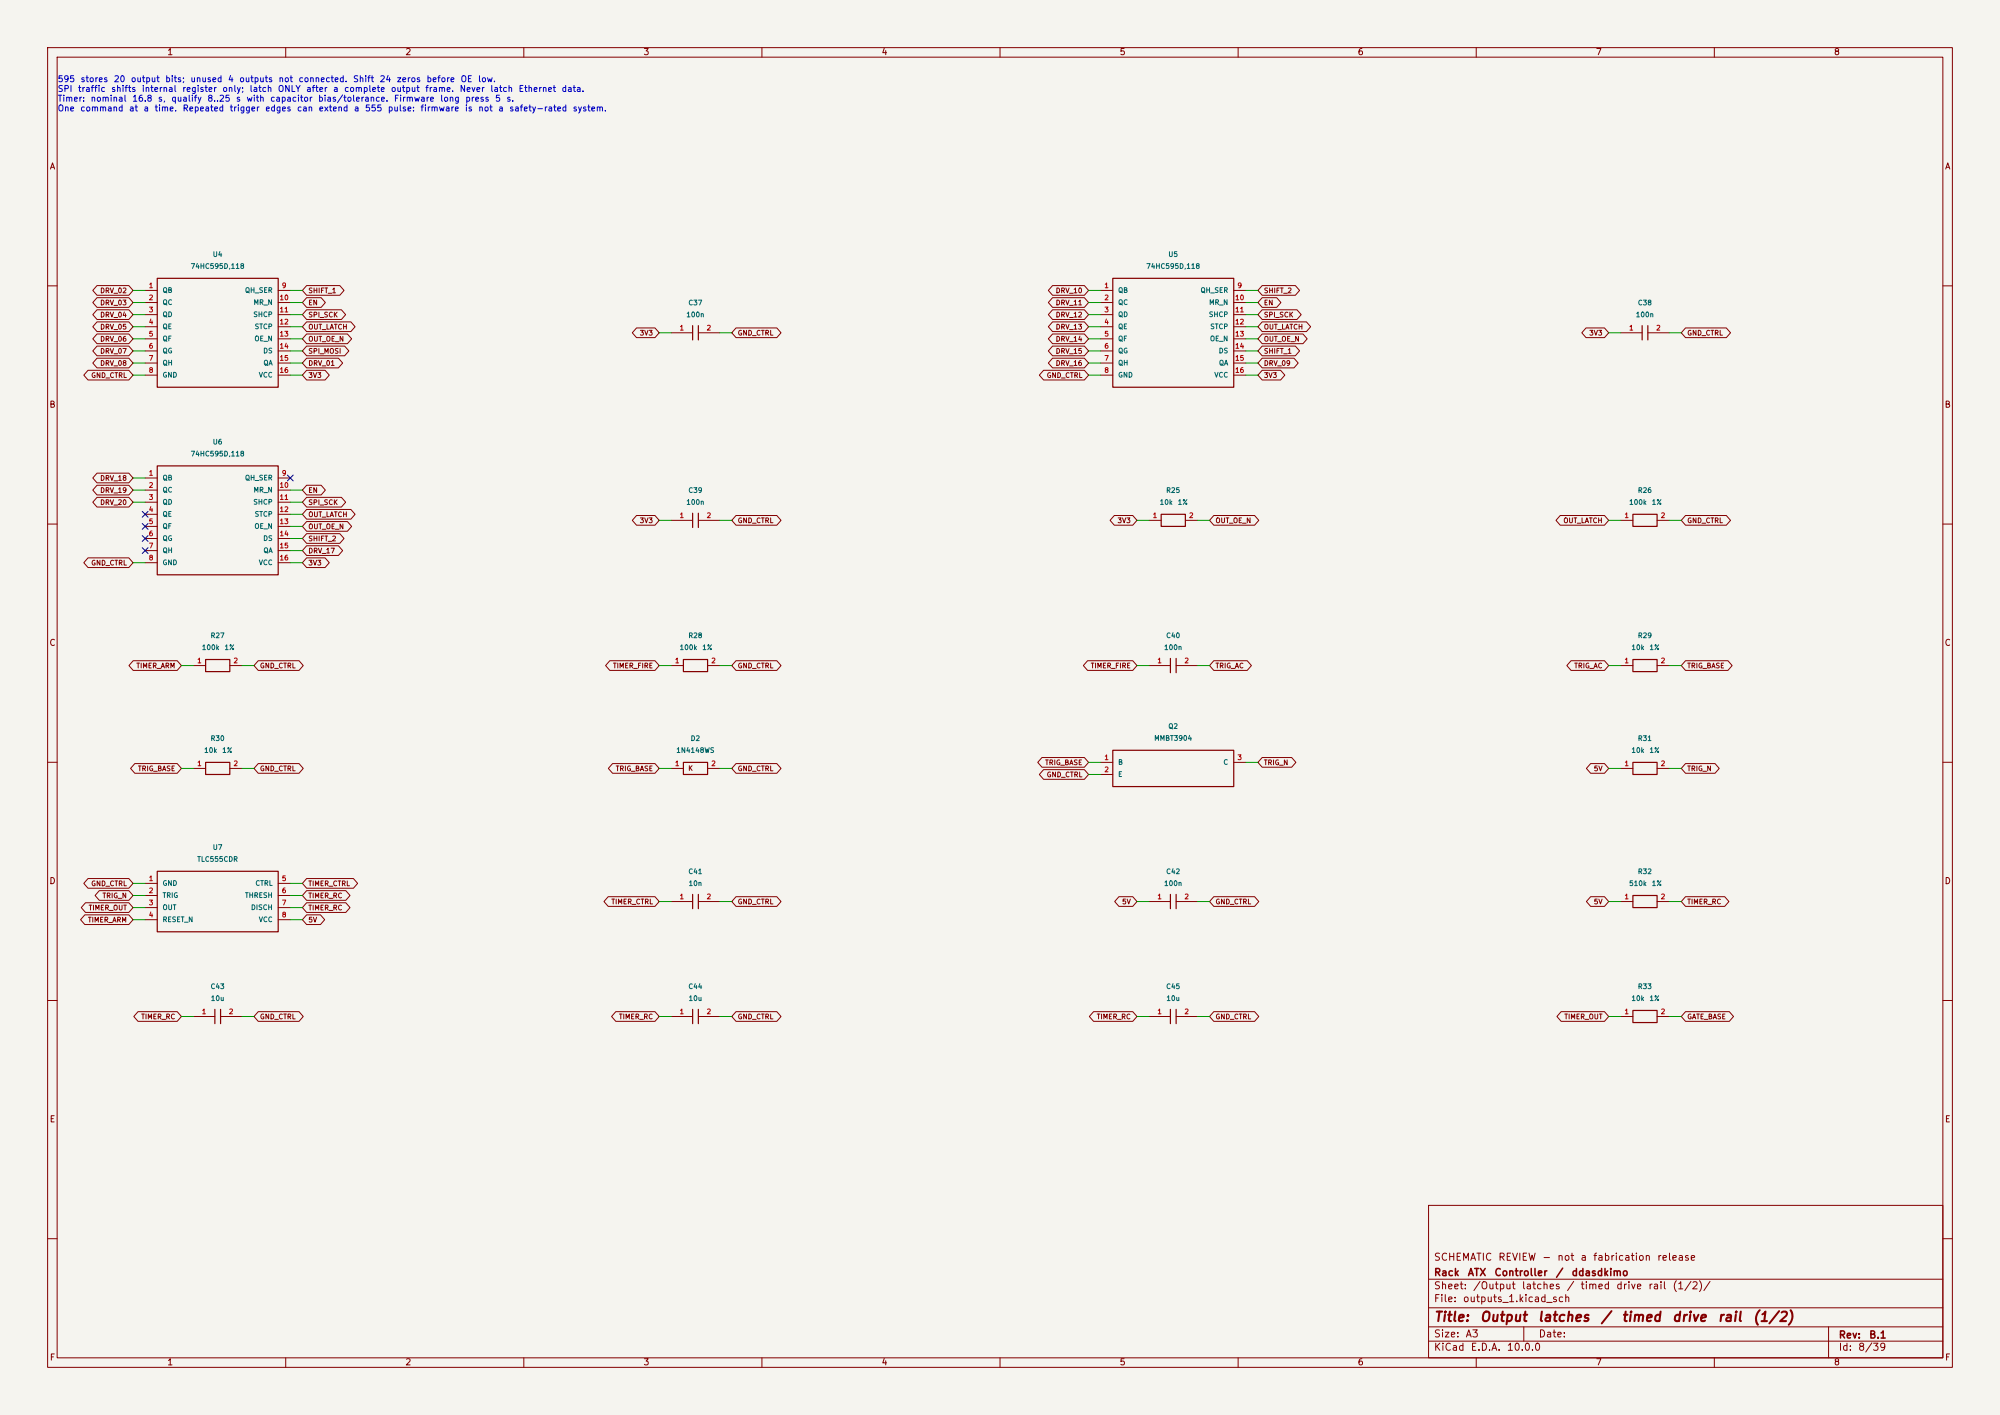
[picture p43: page 8]

SPI_SCK 595 stores 20 output bits; unused 4 outputs not connected. Shift 24 zeros before OE low. SPI traffic shifts internal register only; latch ONLY after a complete output frame. Never latch Ethernet data. Timer: nominal 16.8 s, qualify 8..25 s with capacitor bias/tolerance. Firmware long press 5 s. One command at a time. Repeated trigger edges can extend a 555 pulse: firmware is not a safety-rated system.

Rack ATX Controller / ddasdkimo SCHEMATIC REVIEW - not a fabrication release

Sheet: /Output latches / timed drive rail (1/2)/
File: outputs_1.kicad_sch
Title: Output latches / timed drive rail (1/2)

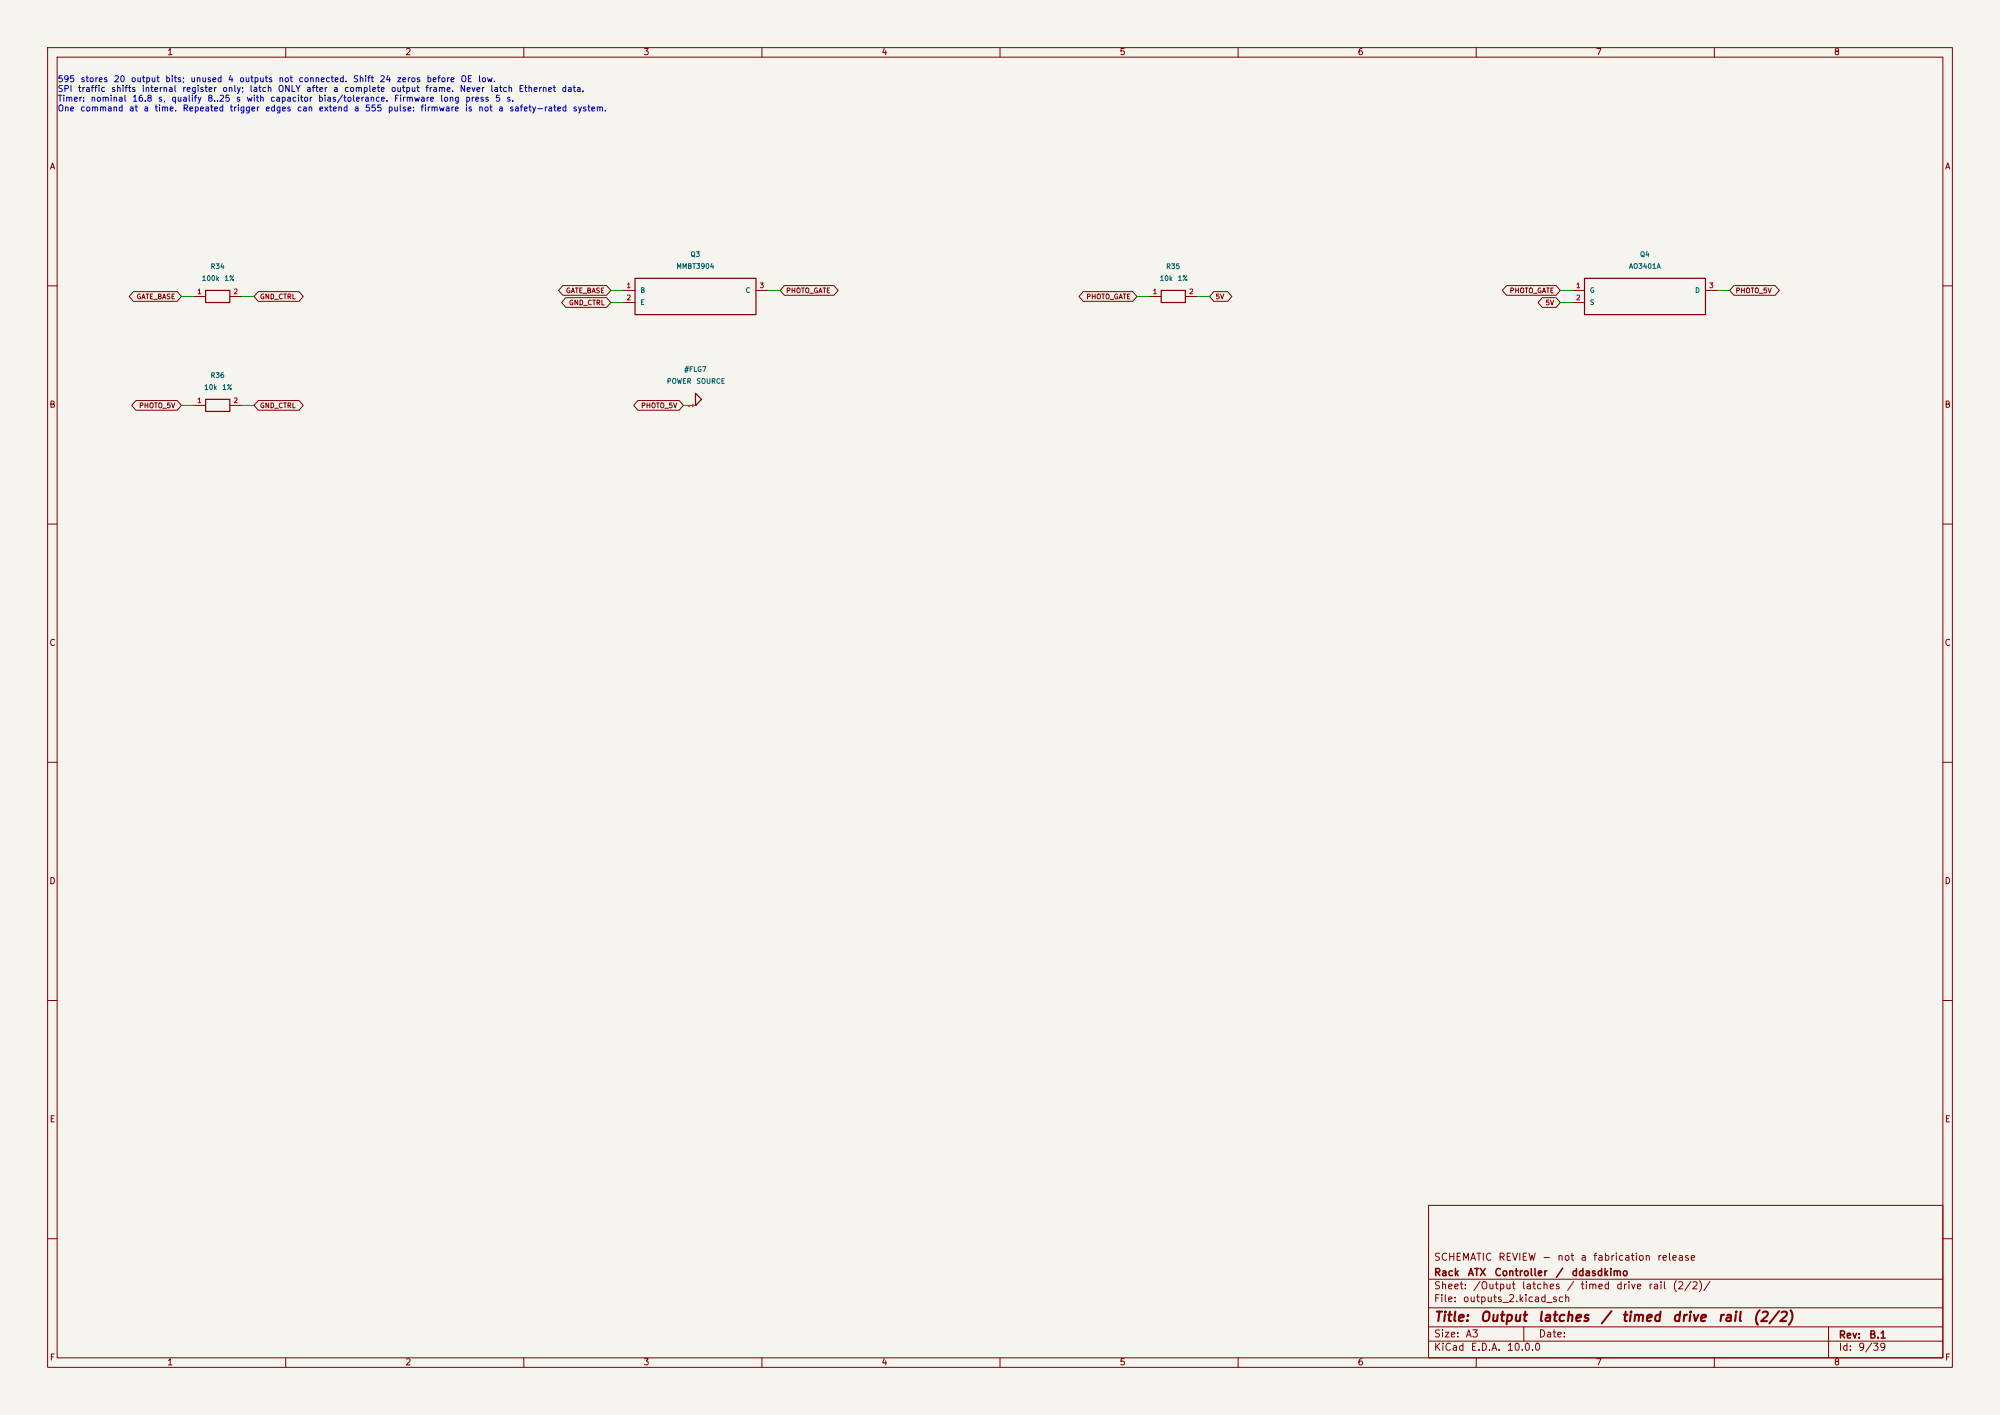
[picture p44: page 9]

Rack ATX Controller / ddasdkimo SCHEMATIC REVIEW - not a fabrication release

Sheet: /Output latches / timed drive rail (2/2)/
File: outputs_2.kicad_sch
Title: Output latches / timed drive rail (2/2)

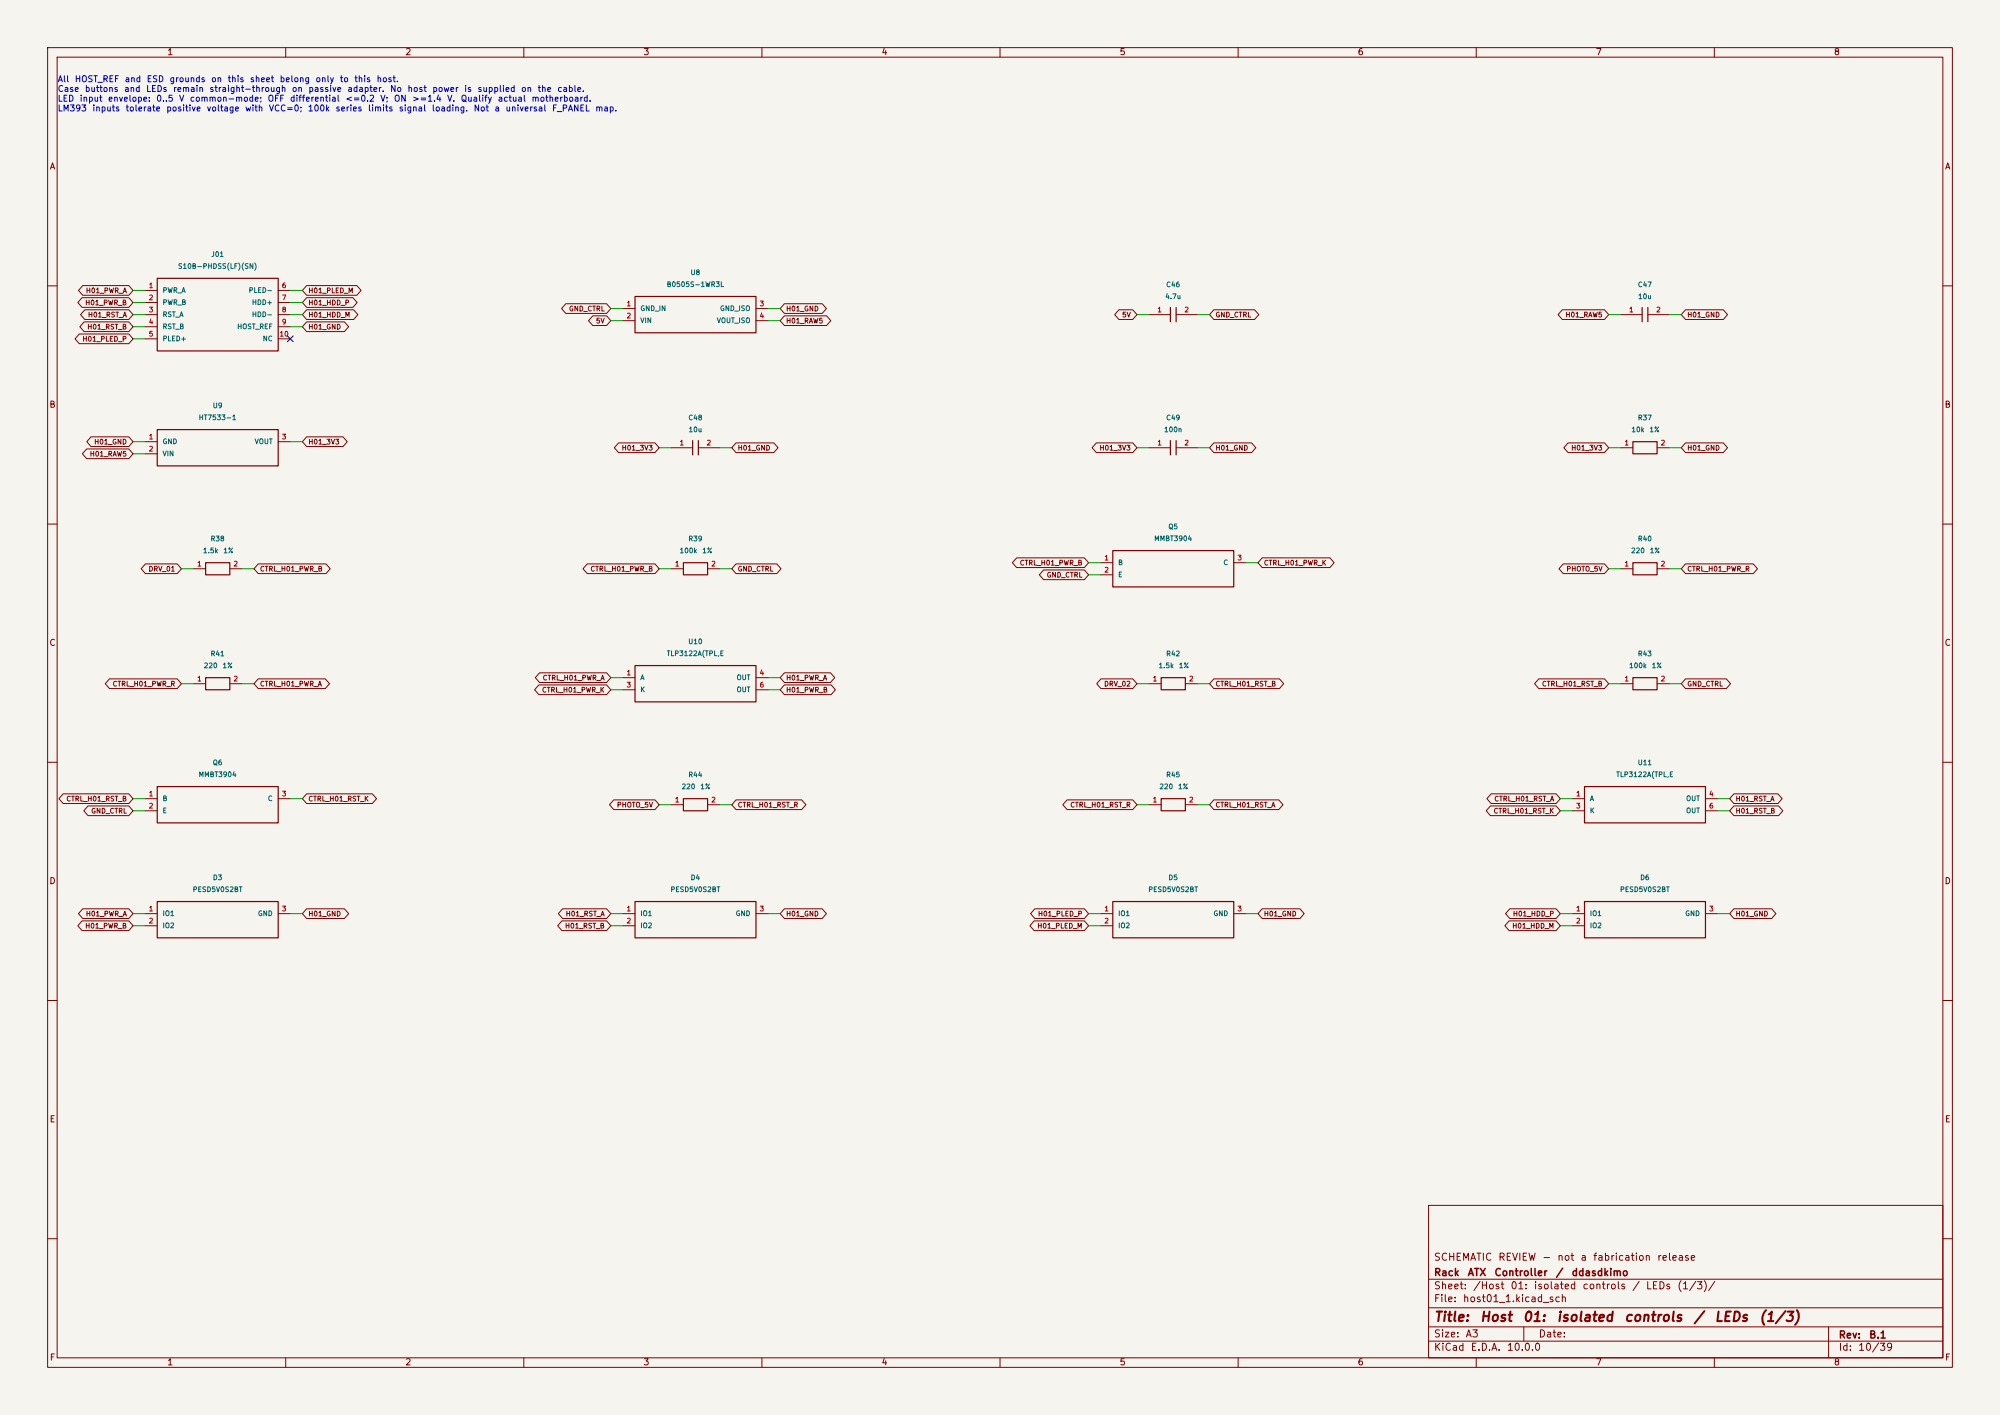
[picture p45: page 10]

All HOST_REF and ESD grounds on this sheet belong only to this host. Case buttons and LEDs remain straight-through on passive adapter. No host power is supplied on the cable. LED input envelope: 0..5 V common-mode; OFF differential <=0.2 V; ON >=1.4 V. Qualify actual motherboard. LM393 inputs tolerate positive voltage with VCC=0; 100k series limits signal loading. Not a universal F_PANEL map.

Rack ATX Controller / ddasdkimo SCHEMATIC REVIEW - not a fabrication release

Sheet: /Host 01: isolated controls / LEDs (1/3)/
File: host01_1.kicad_sch
Title: Host 01: isolated controls / LEDs (1/3)

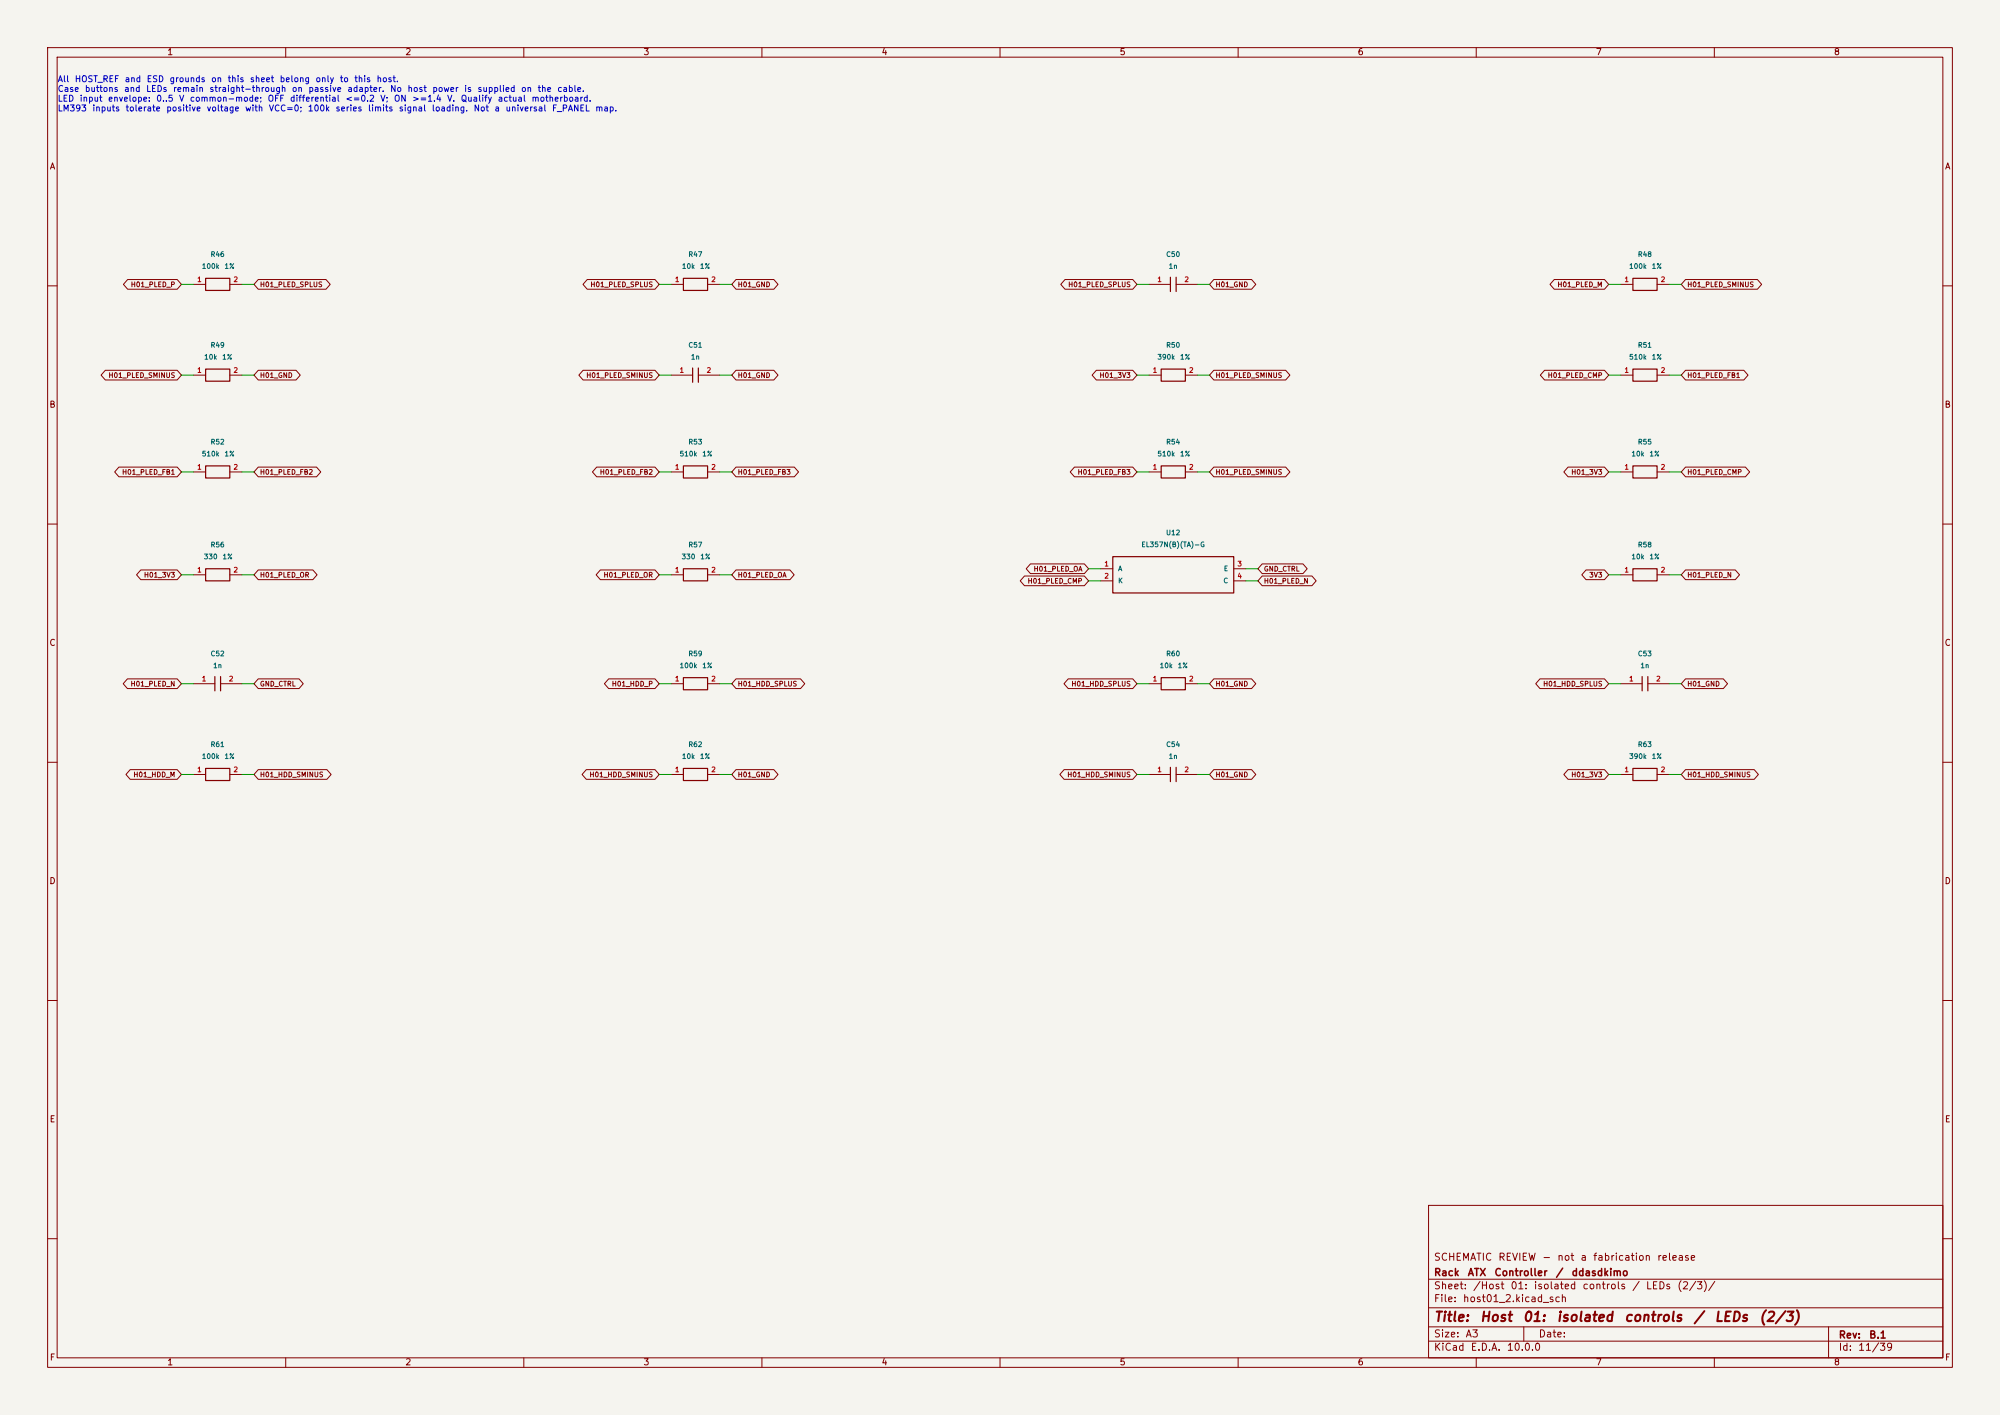
[picture p46: page 11]

Rack ATX Controller / ddasdkimo SCHEMATIC REVIEW - not a fabrication release

Sheet: /Host 01: isolated controls / LEDs (2/3)/
File: host01_2.kicad_sch
Title: Host 01: isolated controls / LEDs (2/3)

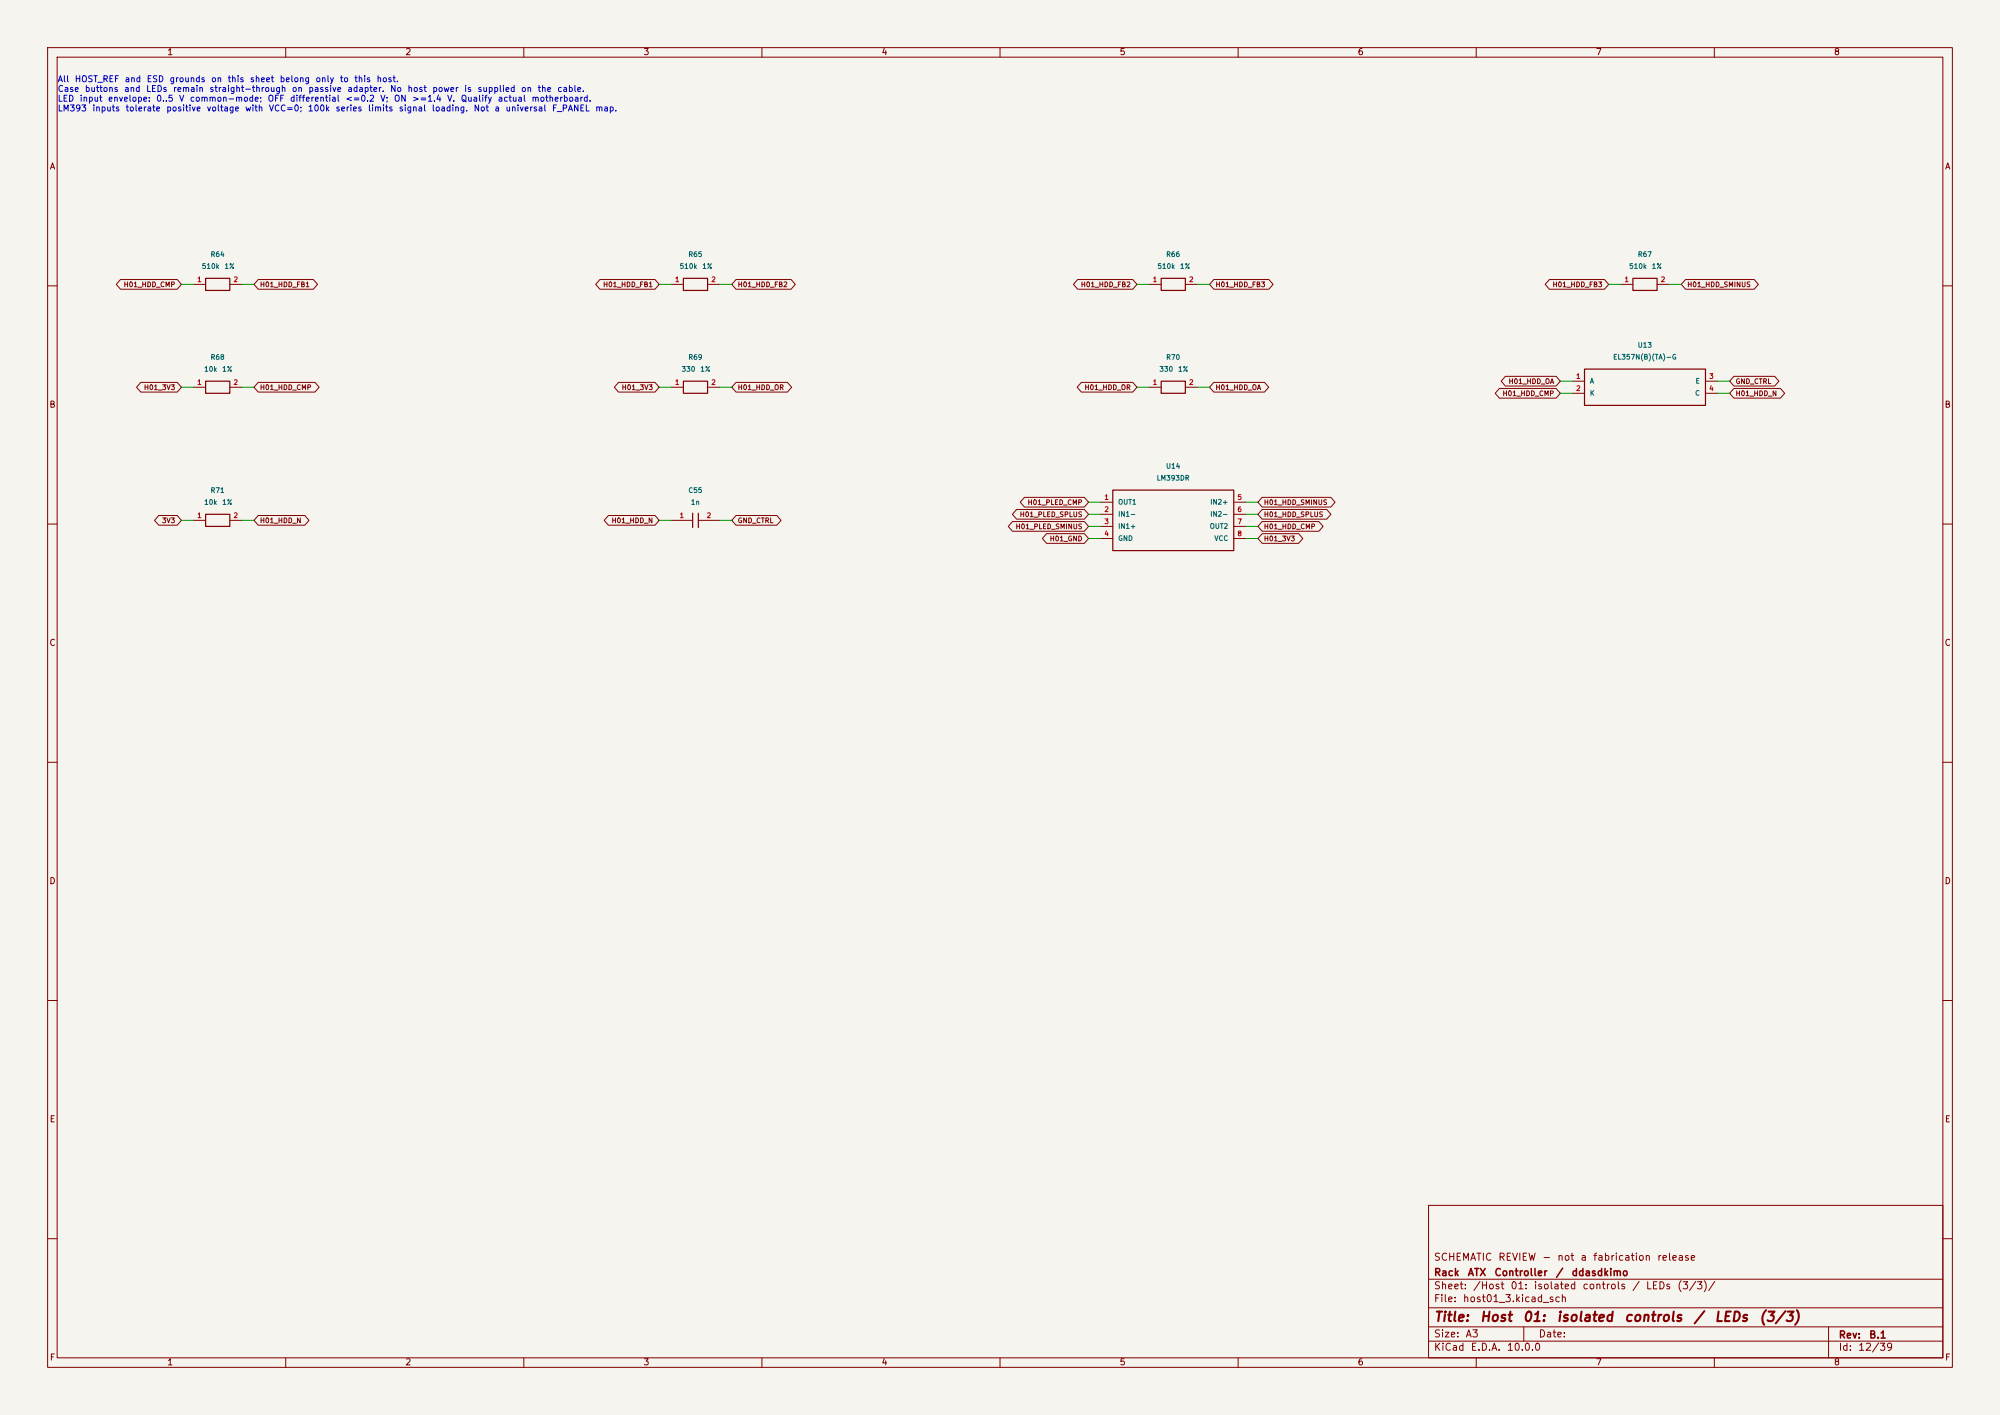
[picture p47: page 12]

Rack ATX Controller / ddasdkimo SCHEMATIC REVIEW - not a fabrication release

Sheet: /Host 01: isolated controls / LEDs (3/3)/
File: host01_3.kicad_sch
Title: Host 01: isolated controls / LEDs (3/3)

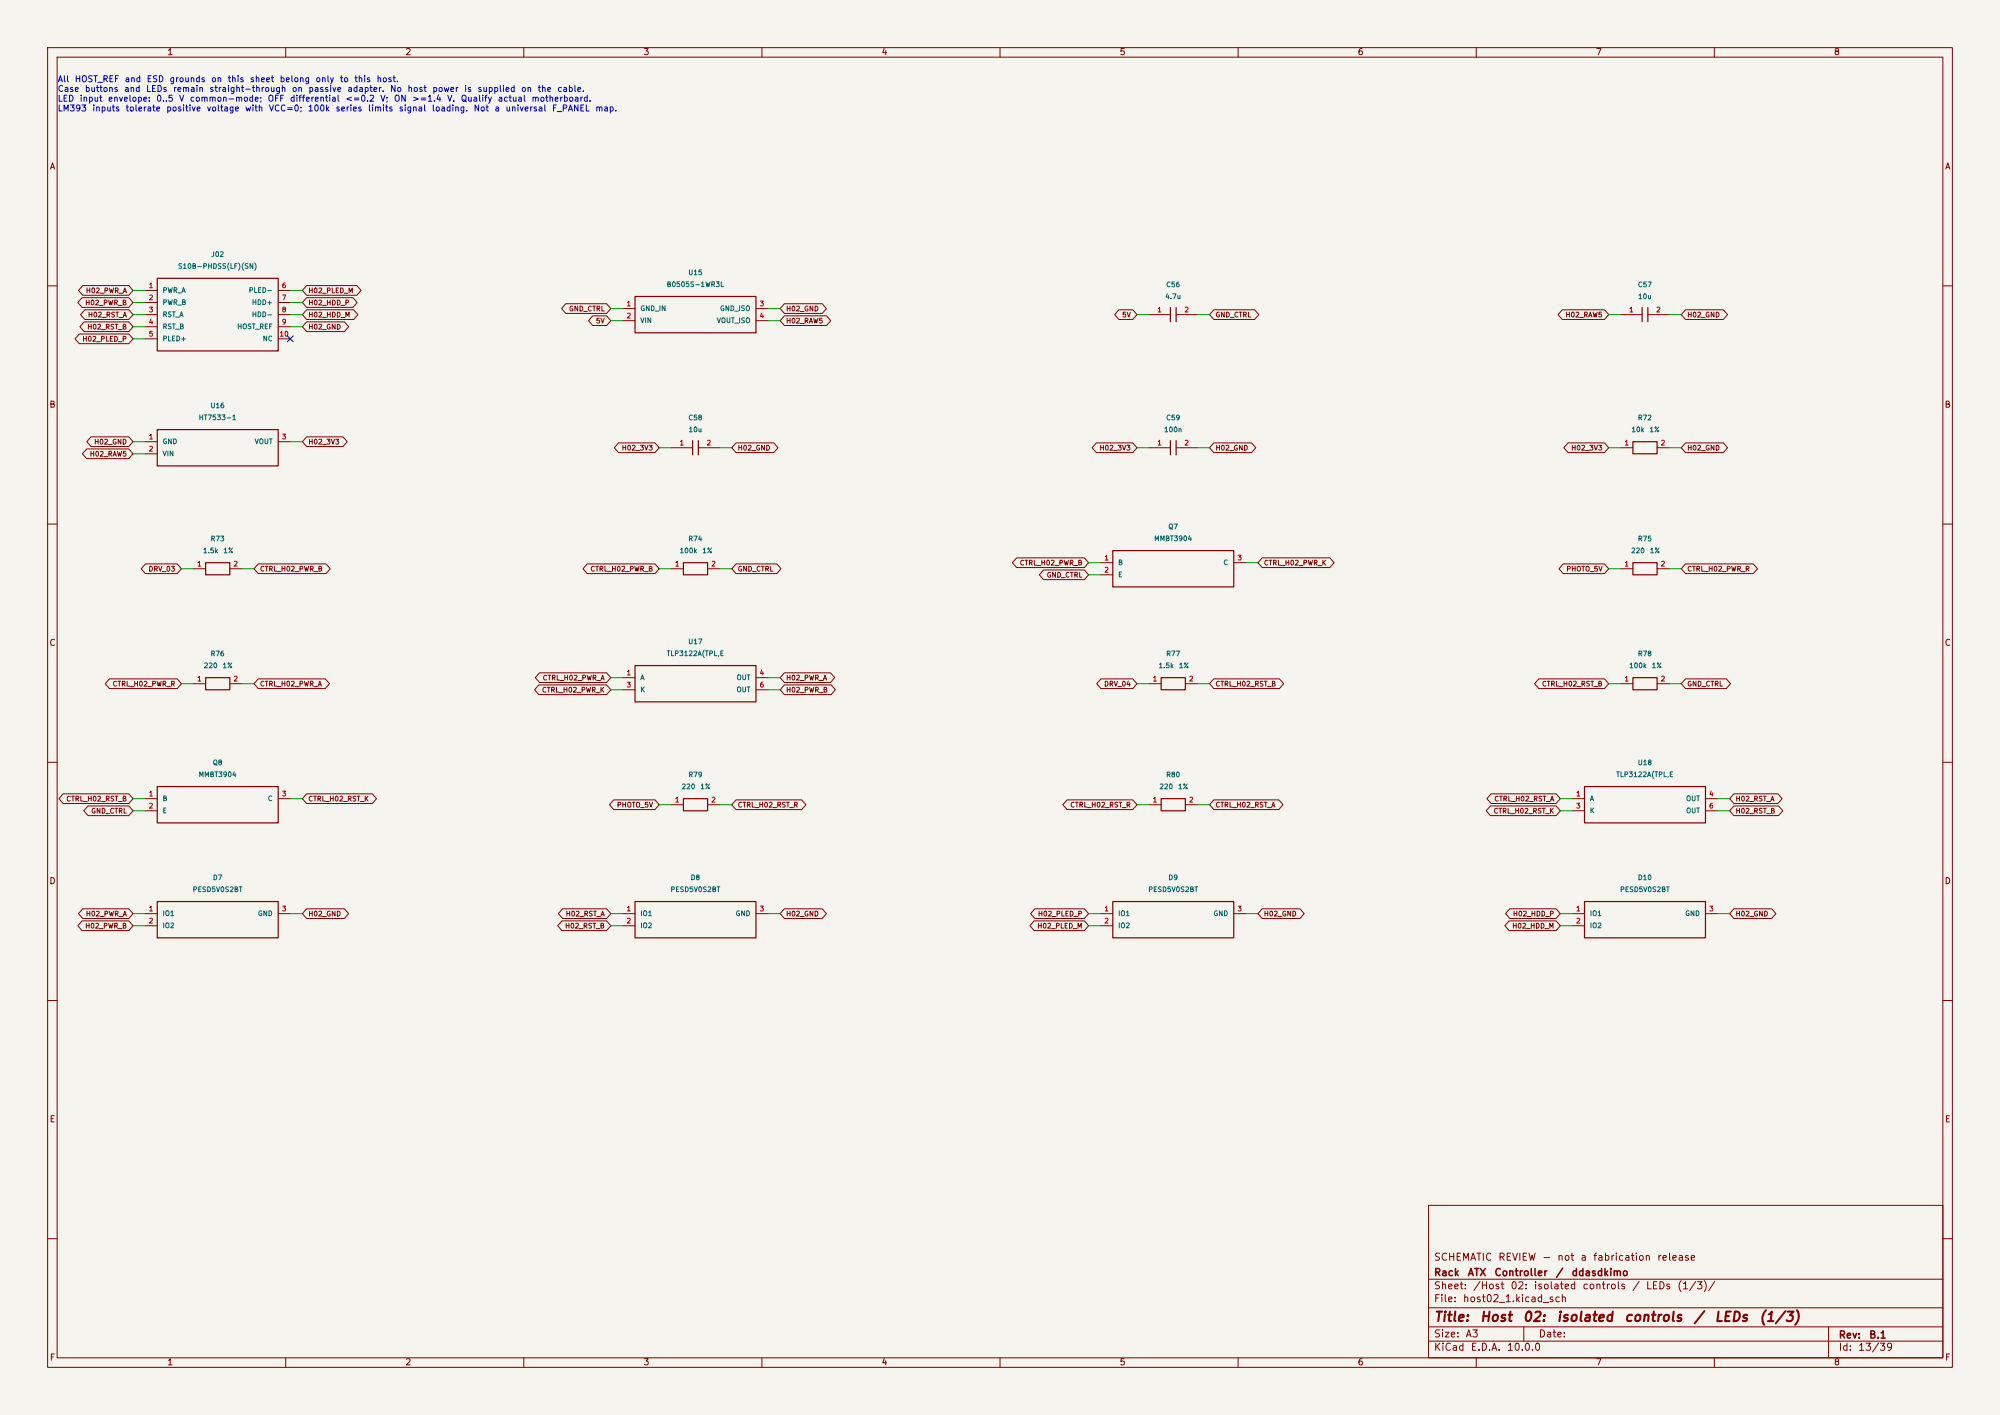
[picture p48: page 13]

Rack ATX Controller / ddasdkimo SCHEMATIC REVIEW - not a fabrication release

Sheet: /Host 02: isolated controls / LEDs (1/3)/
File: host02_1.kicad_sch
Title: Host 02: isolated controls / LEDs (1/3)

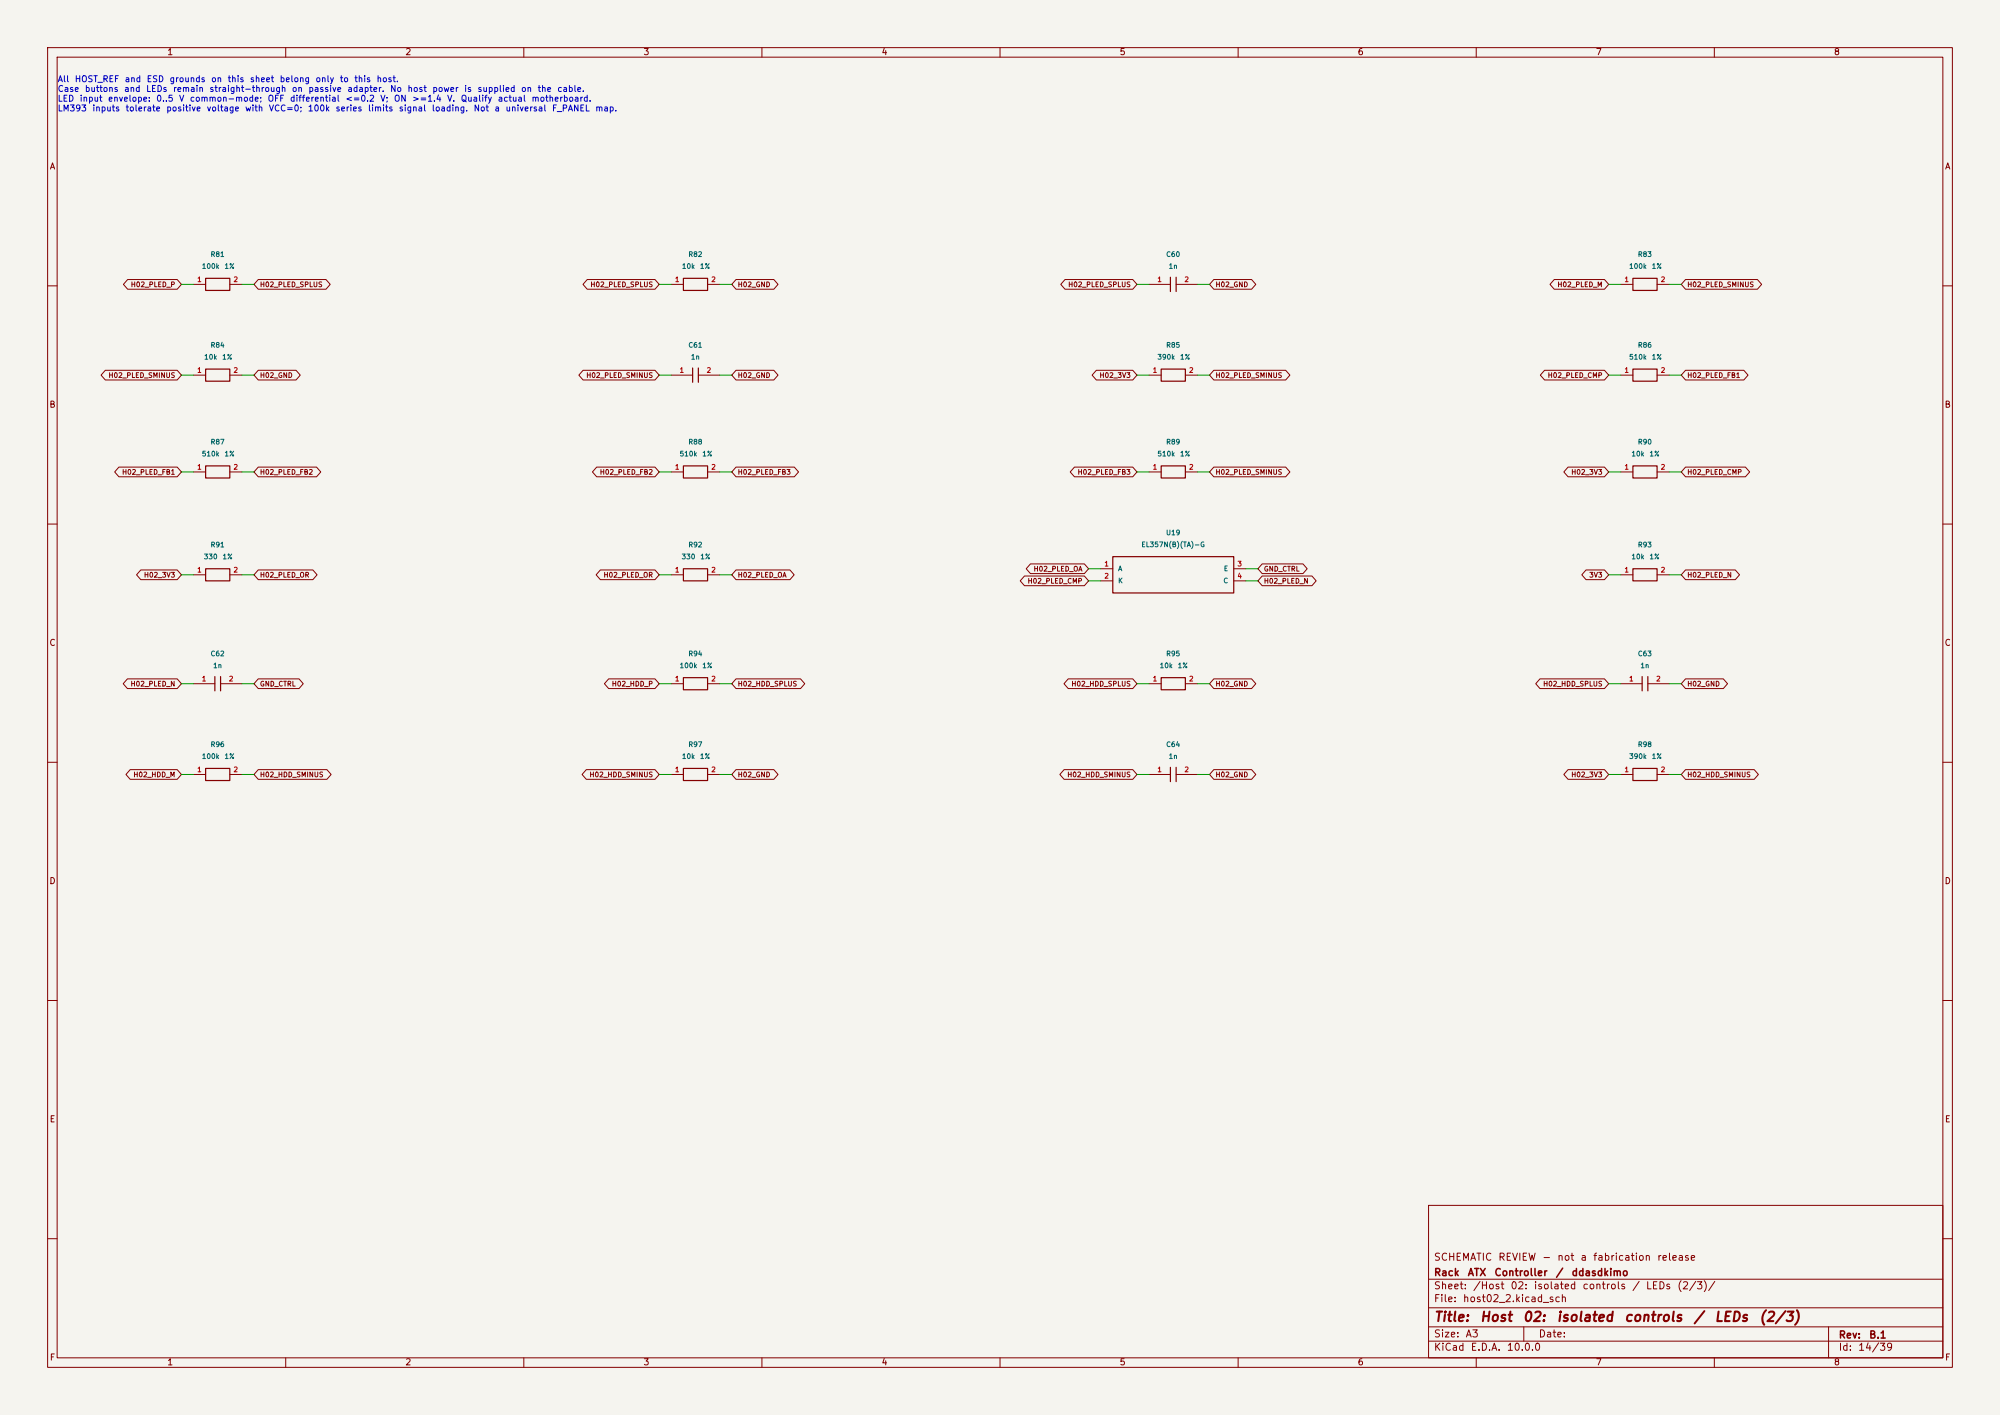
[picture p49: page 14]

Rack ATX Controller / ddasdkimo SCHEMATIC REVIEW - not a fabrication release

Sheet: /Host 02: isolated controls / LEDs (2/3)/
File: host02_2.kicad_sch
Title: Host 02: isolated controls / LEDs (2/3)

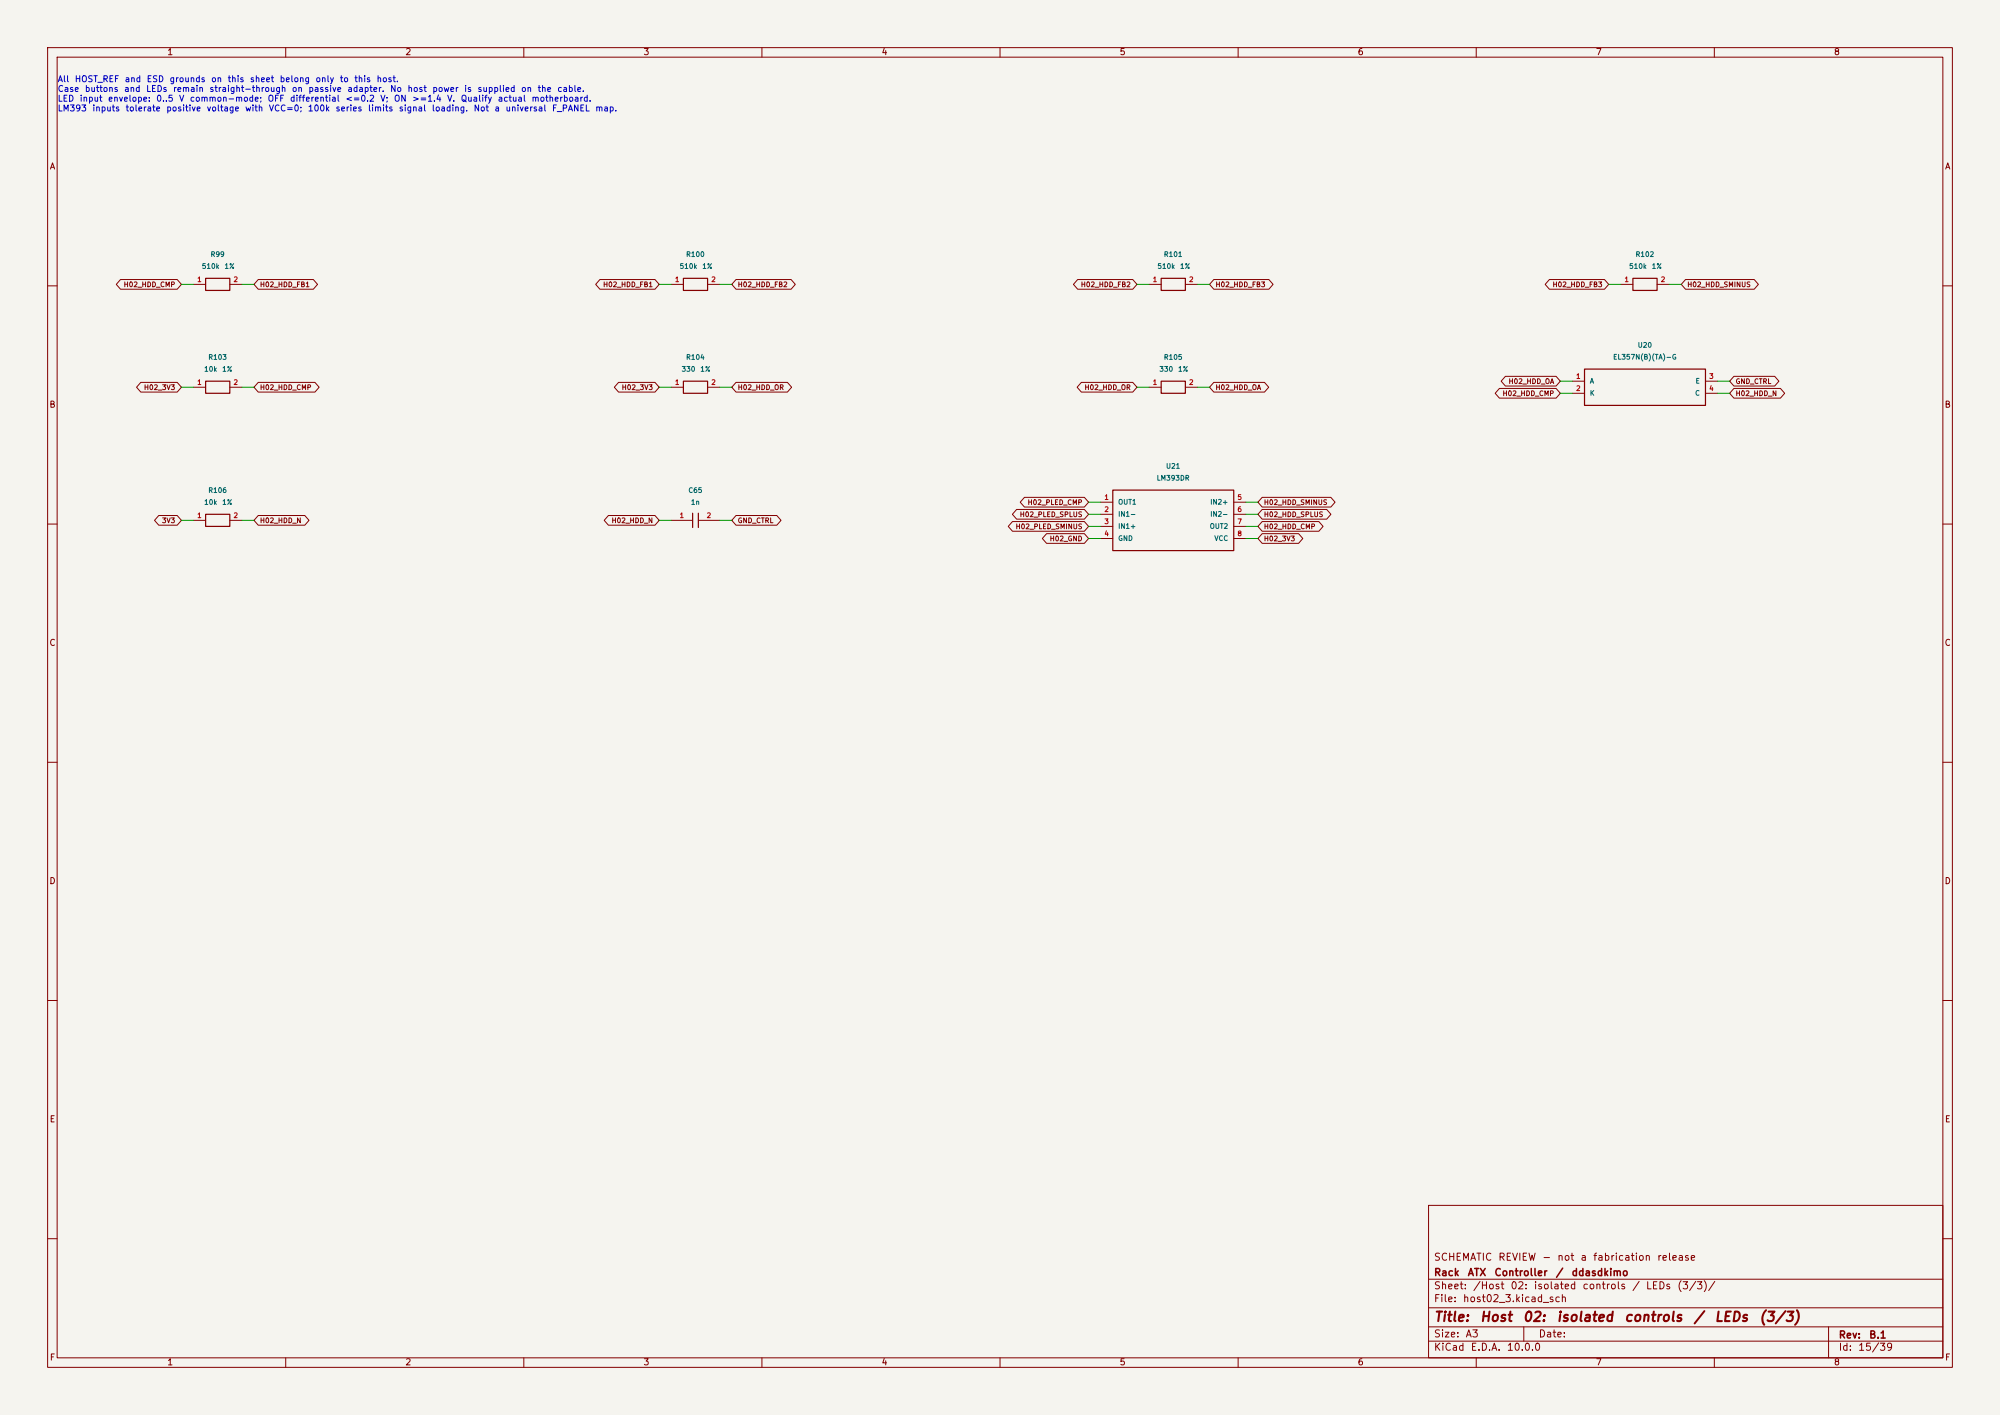
[picture p50: page 15]

Rack ATX Controller / ddasdkimo SCHEMATIC REVIEW - not a fabrication release

Sheet: /Host 02: isolated controls / LEDs (3/3)/
File: host02_3.kicad_sch
Title: Host 02: isolated controls / LEDs (3/3)

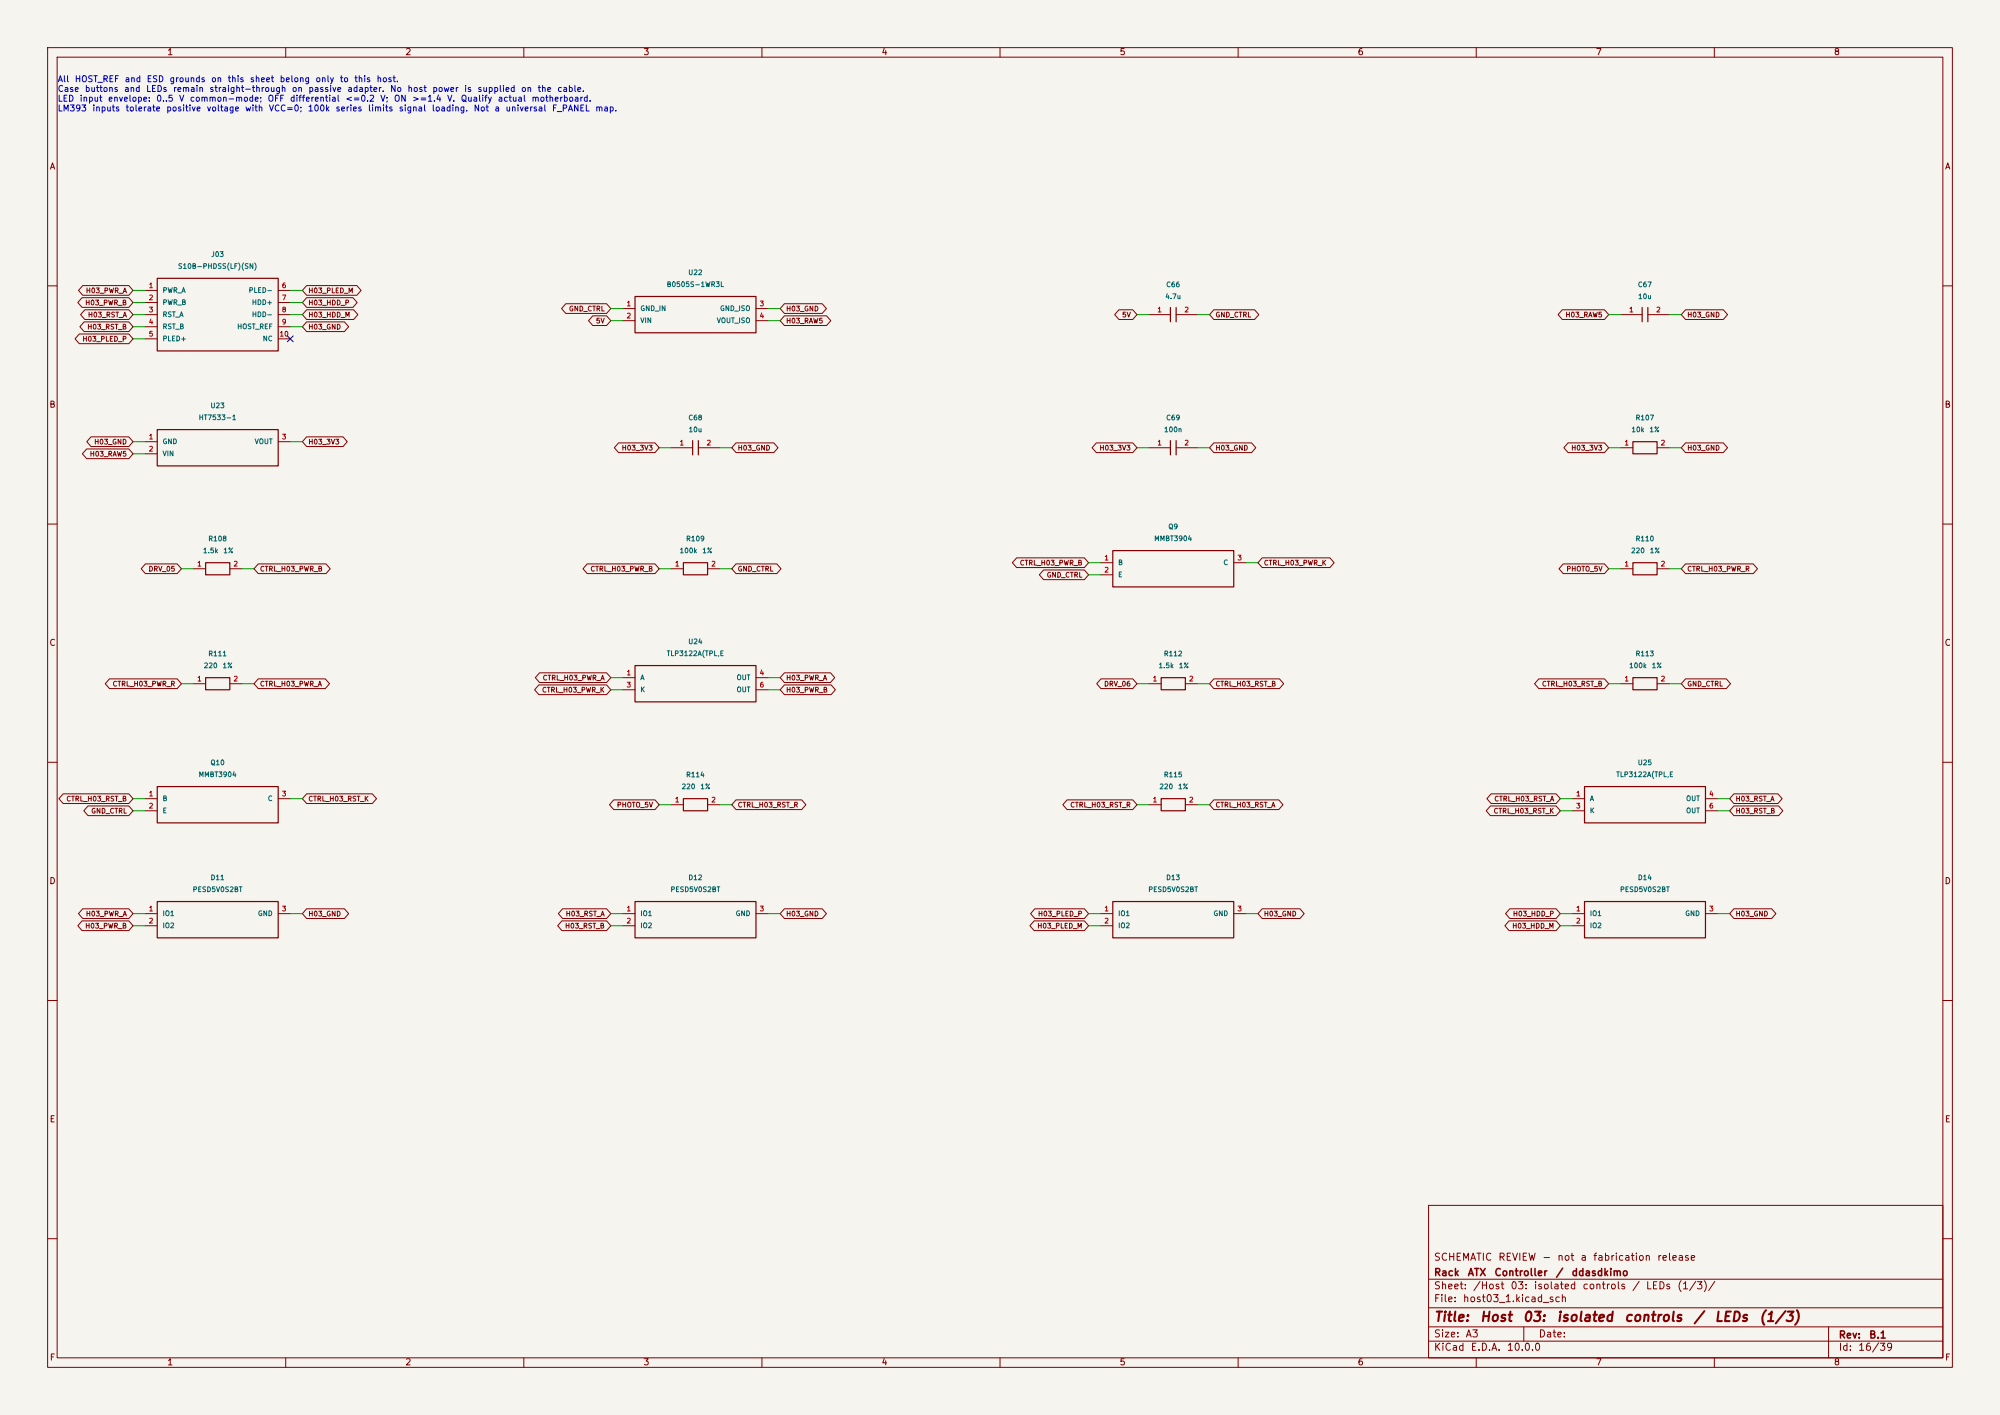
[picture p51: page 16]

Rack ATX Controller / ddasdkimo SCHEMATIC REVIEW - not a fabrication release

Sheet: /Host 03: isolated controls / LEDs (1/3)/
File: host03_1.kicad_sch
Title: Host 03: isolated controls / LEDs (1/3)

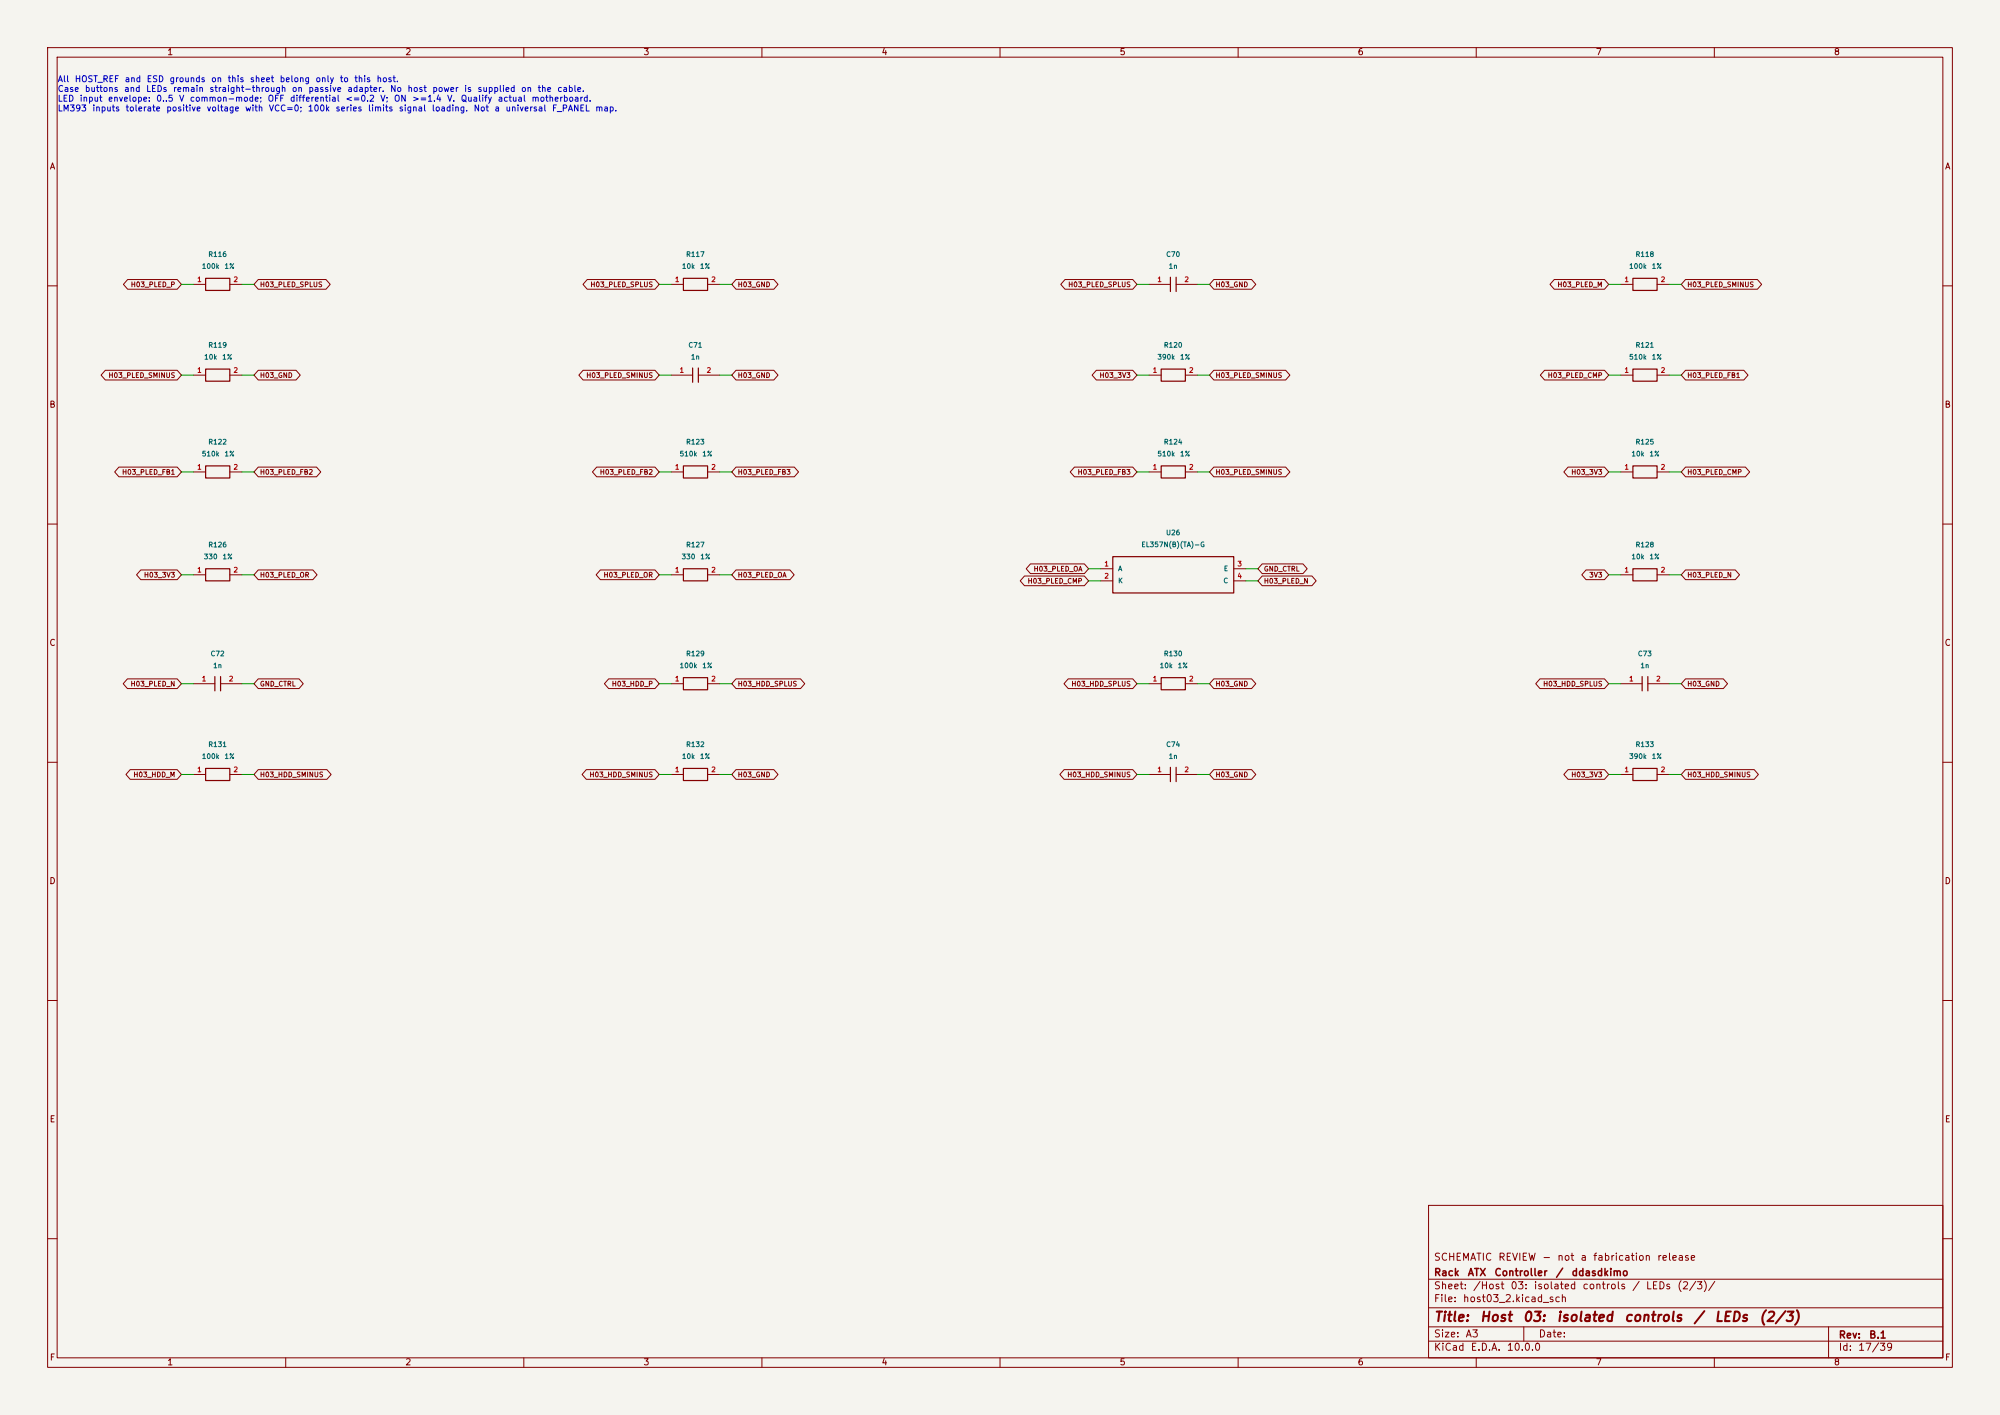
[picture p52: page 17]

Rack ATX Controller / ddasdkimo SCHEMATIC REVIEW - not a fabrication release

Sheet: /Host 03: isolated controls / LEDs (2/3)/
File: host03_2.kicad_sch
Title: Host 03: isolated controls / LEDs (2/3)

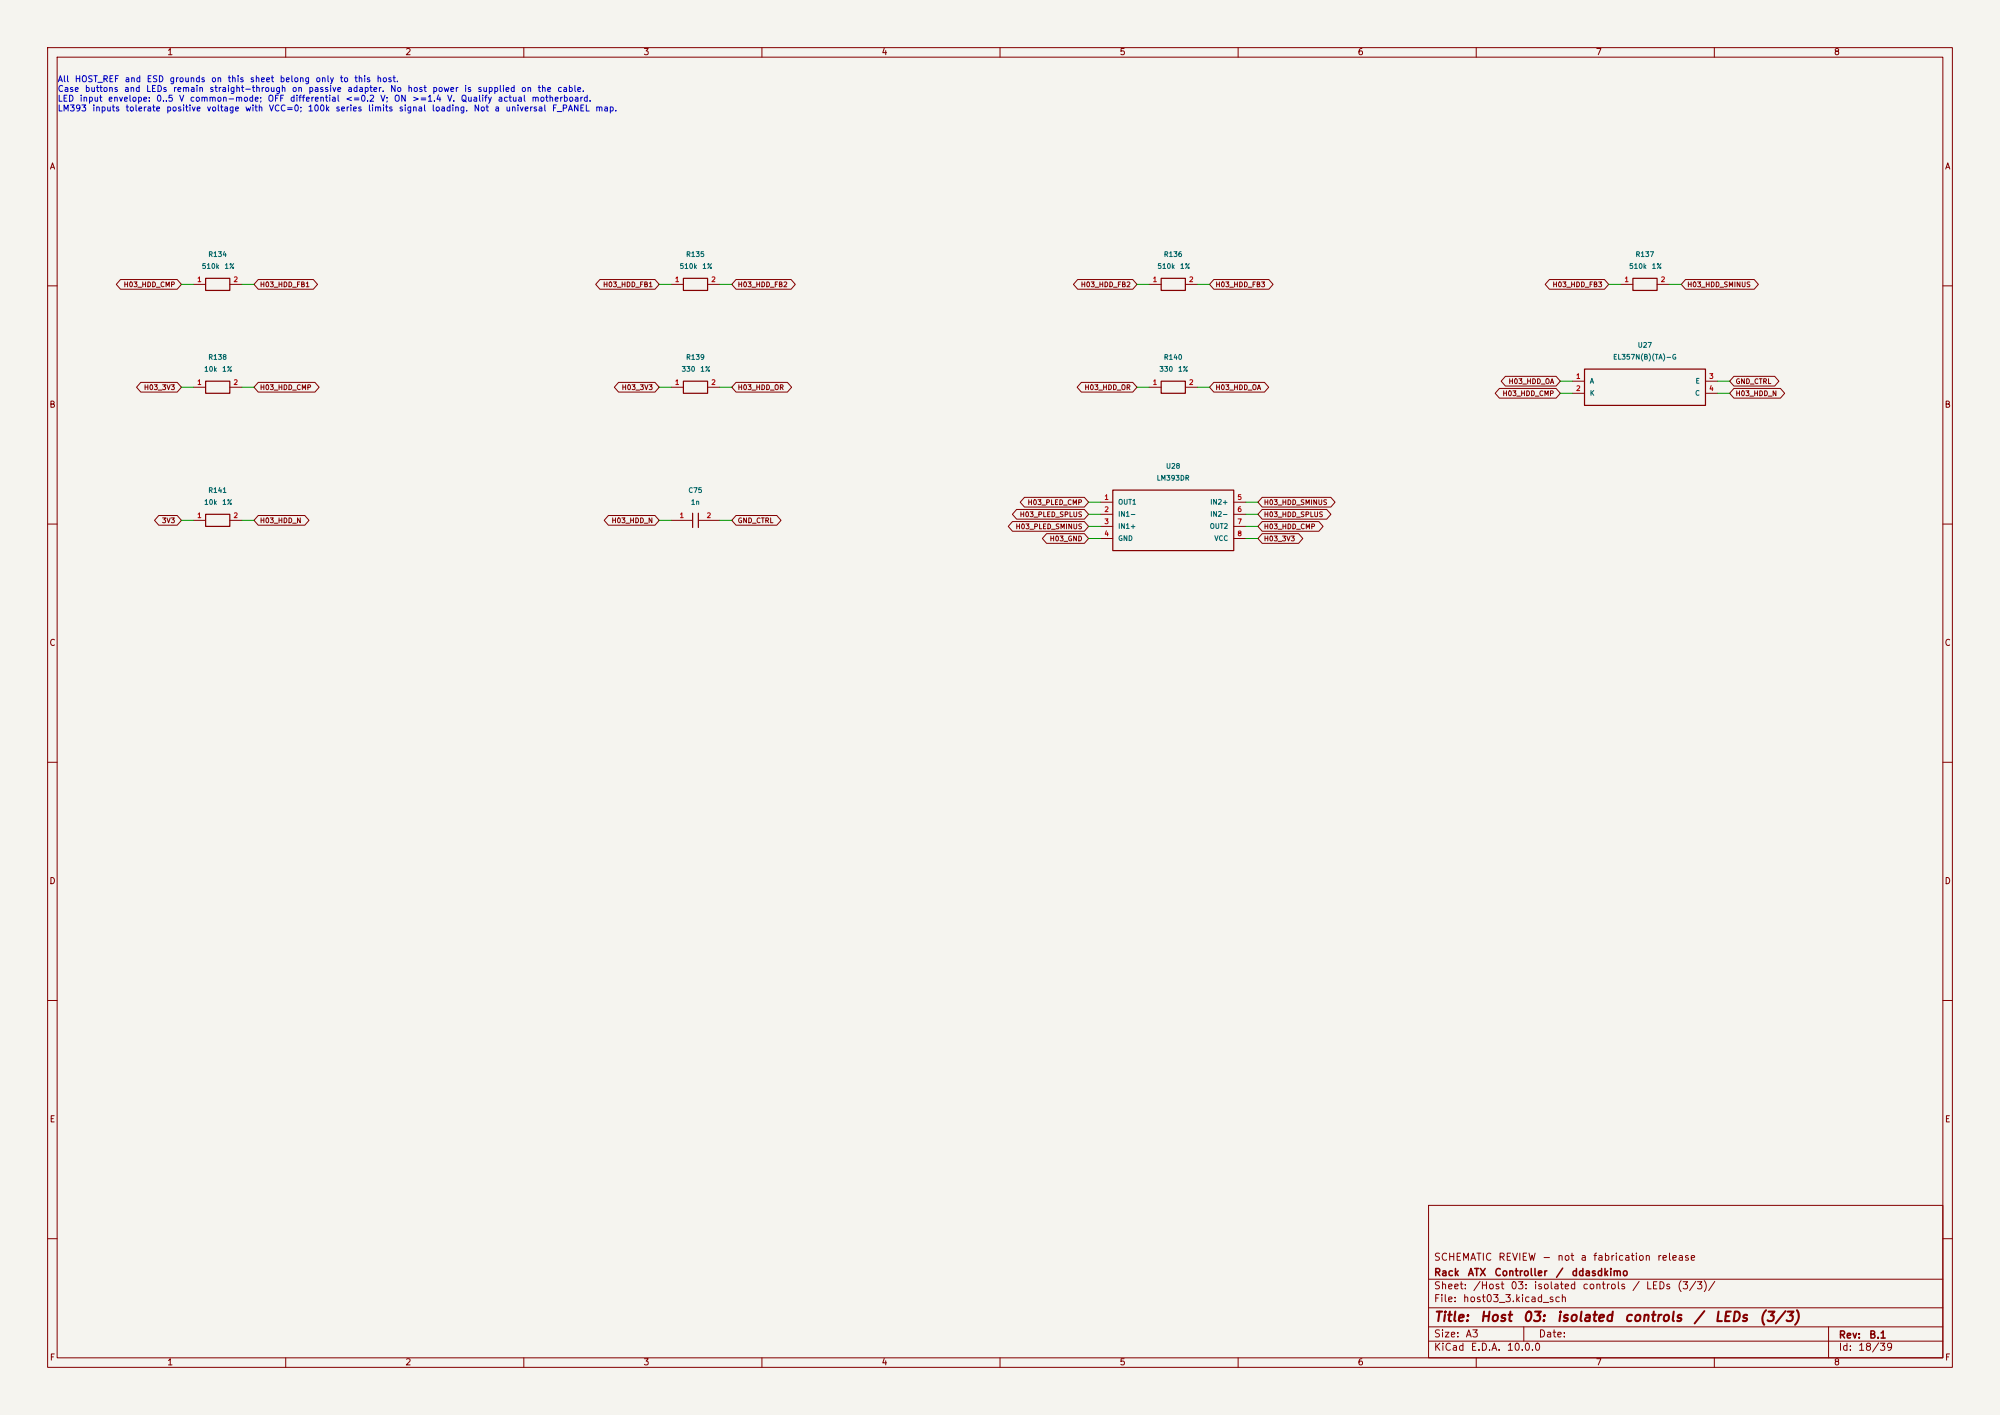
[picture p53: page 18]

Rack ATX Controller / ddasdkimo SCHEMATIC REVIEW - not a fabrication release

Sheet: /Host 03: isolated controls / LEDs (3/3)/
File: host03_3.kicad_sch
Title: Host 03: isolated controls / LEDs (3/3)

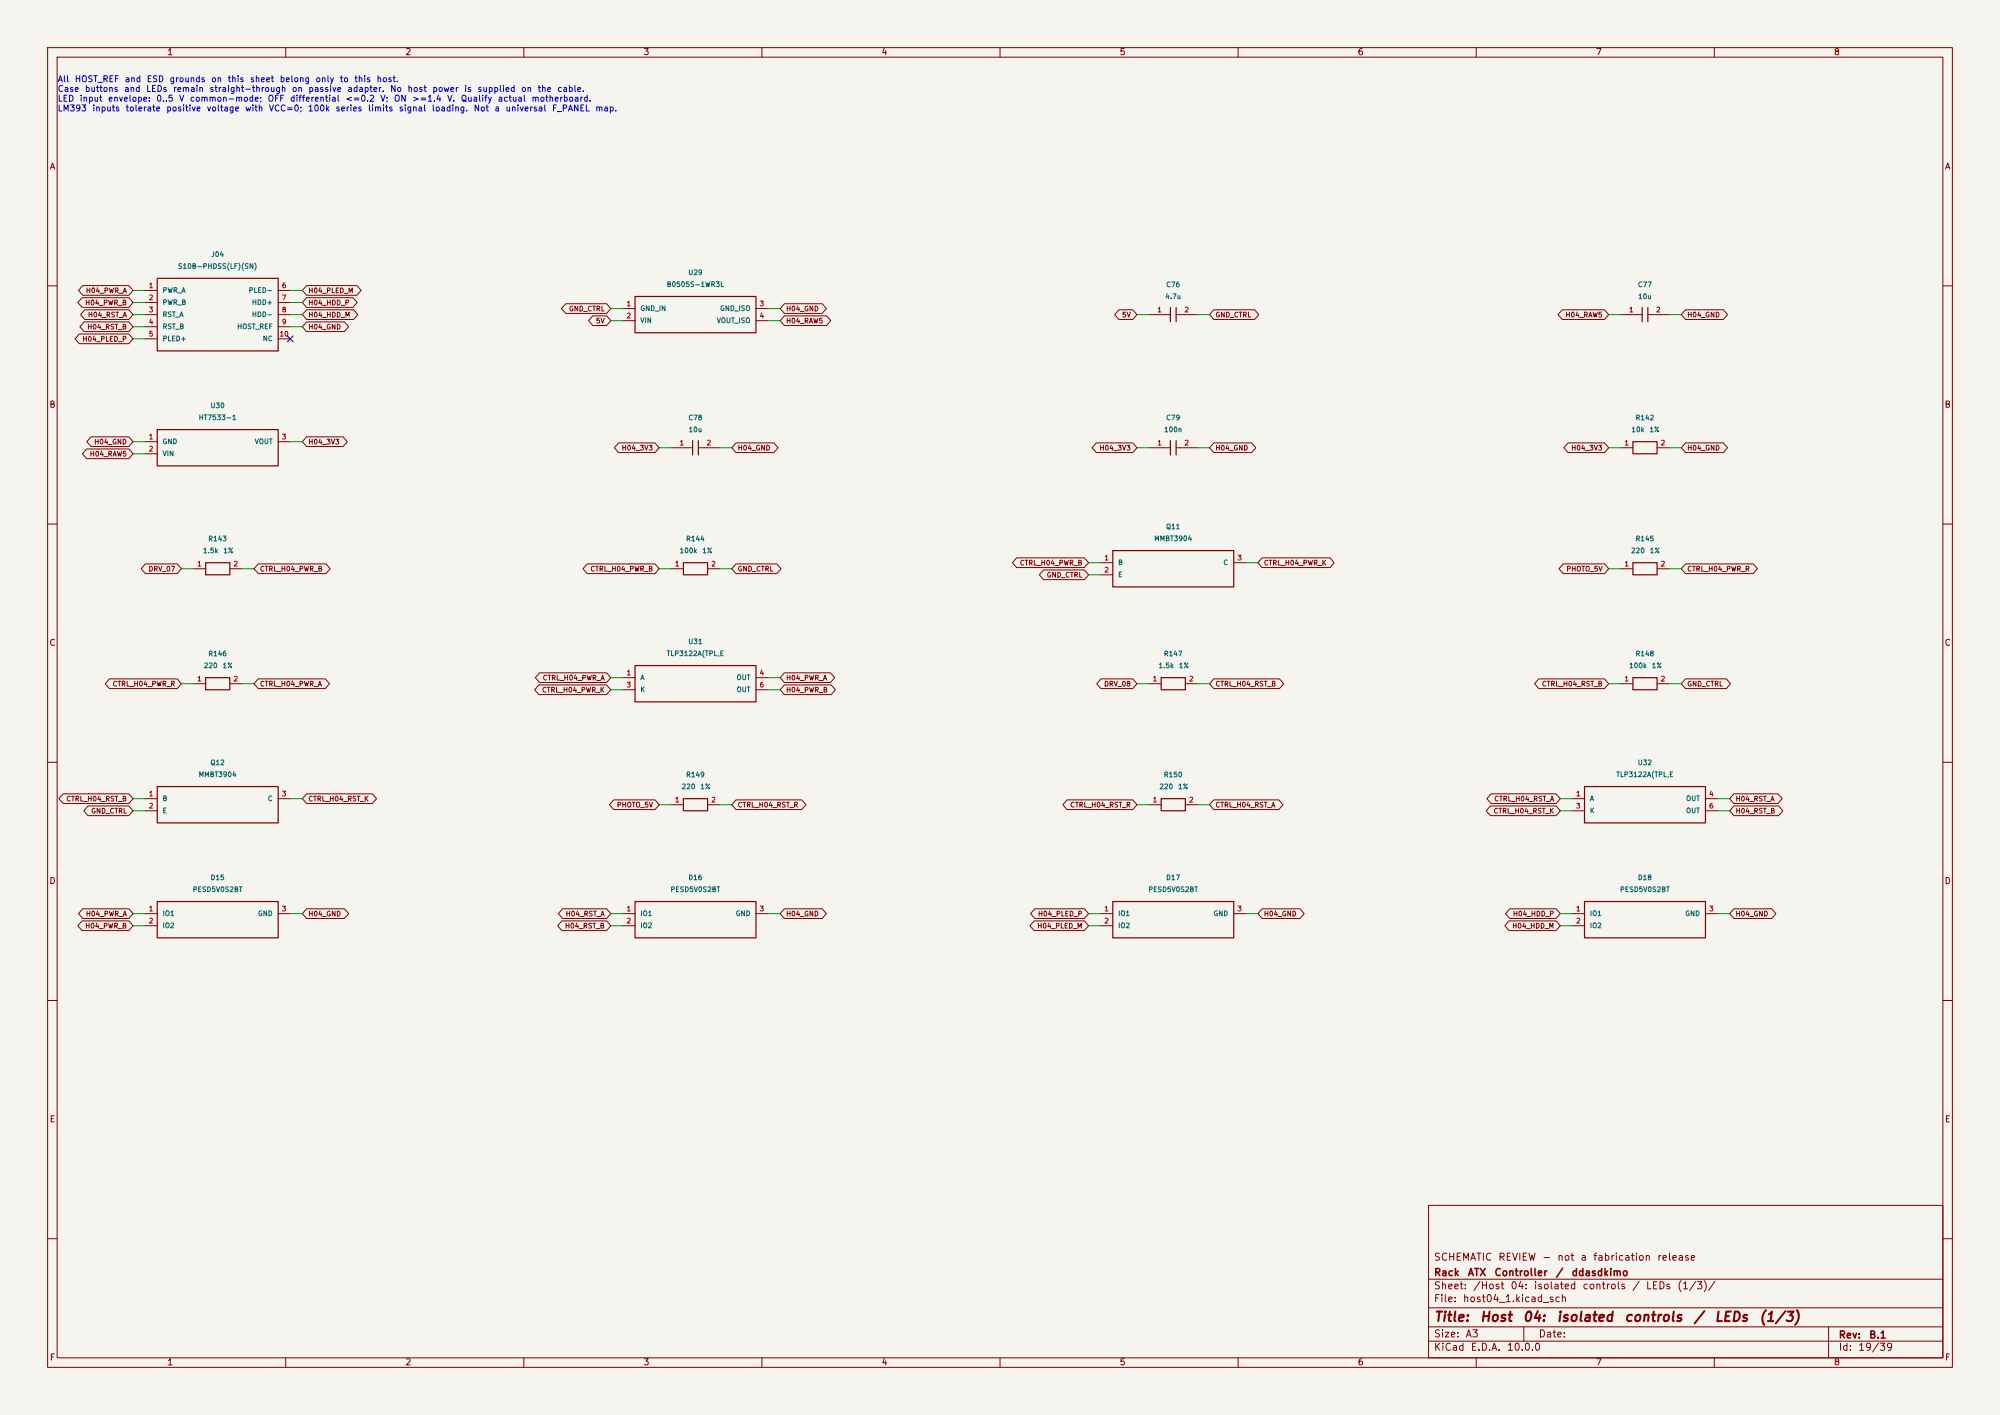
[picture p54: page 19]

Rack ATX Controller / ddasdkimo SCHEMATIC REVIEW - not a fabrication release

Sheet: /Host 04: isolated controls / LEDs (1/3)/
File: host04_1.kicad_sch
Title: Host 04: isolated controls / LEDs (1/3)

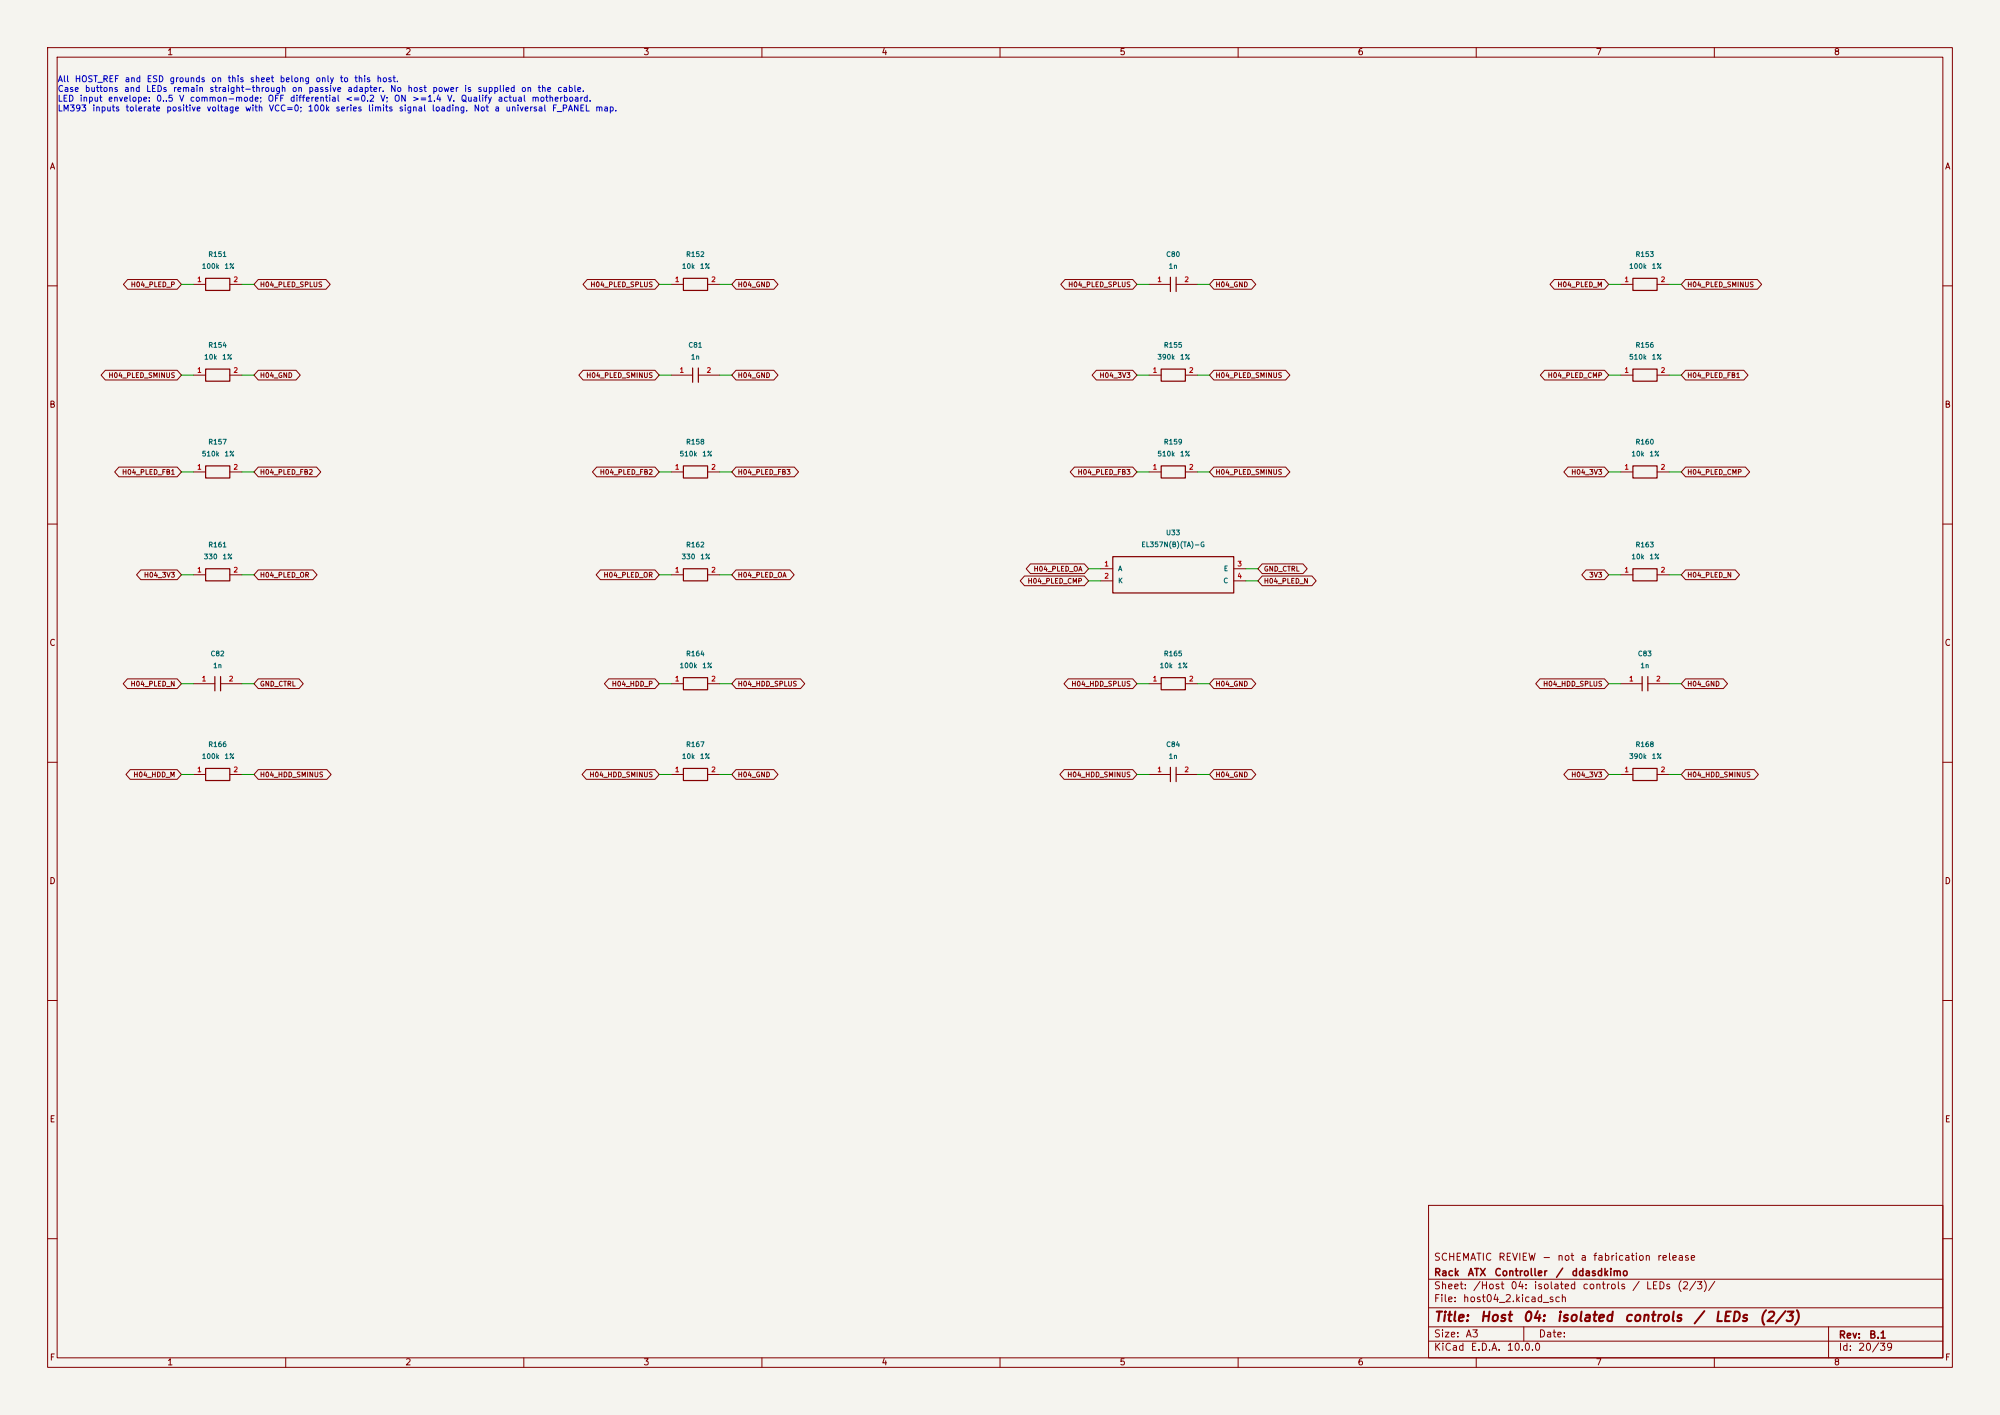
[picture p55: page 20]

Rack ATX Controller / ddasdkimo SCHEMATIC REVIEW - not a fabrication release

Sheet: /Host 04: isolated controls / LEDs (2/3)/
File: host04_2.kicad_sch
Title: Host 04: isolated controls / LEDs (2/3)

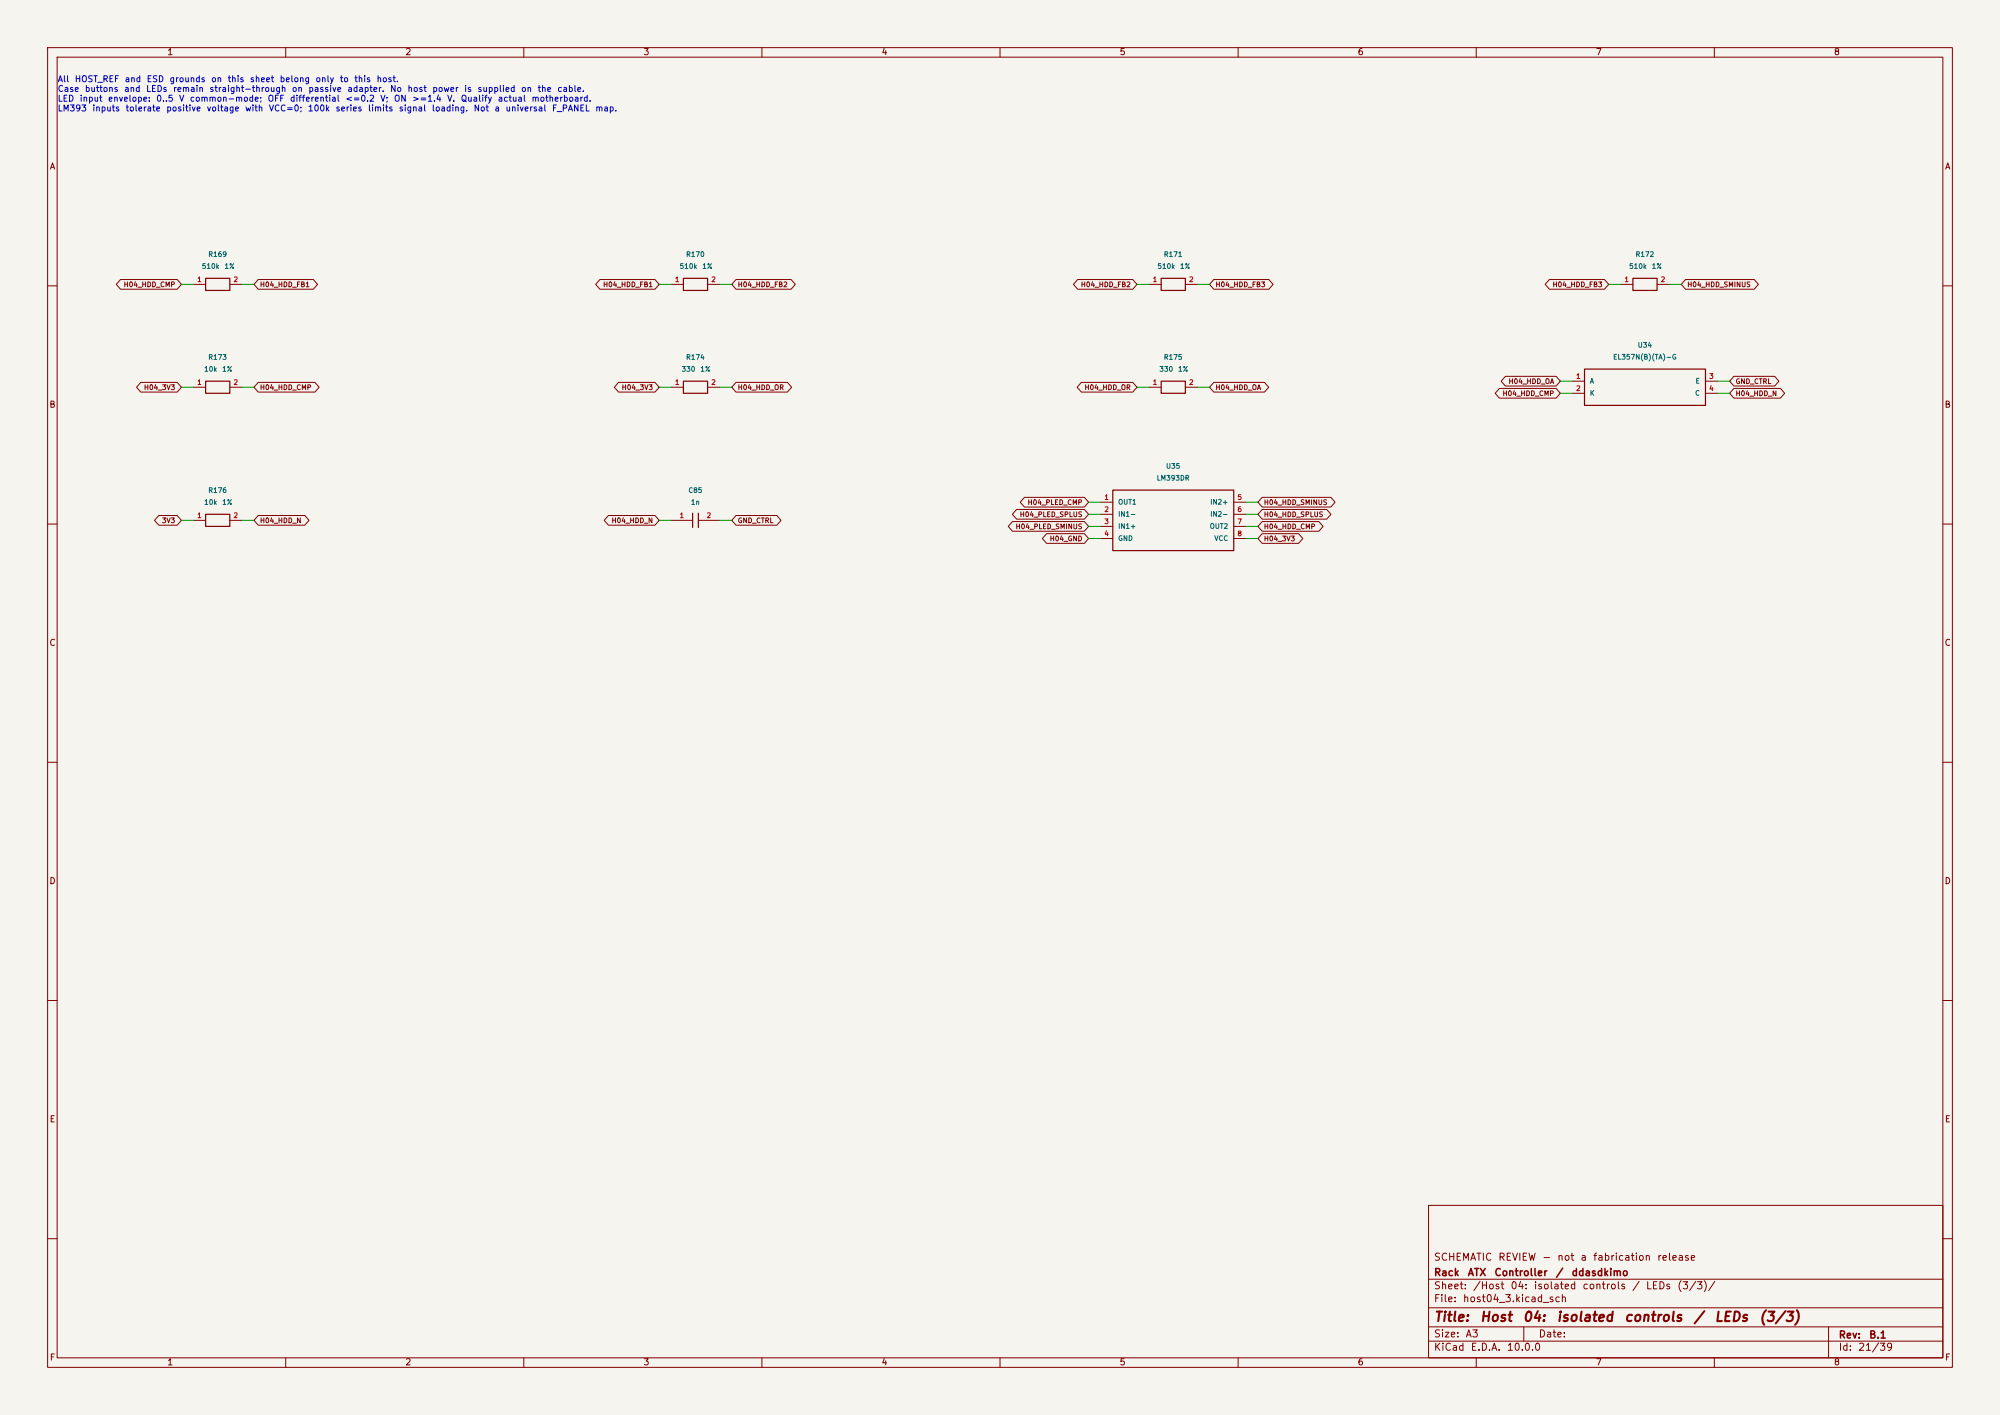
[picture p56: page 21]

Rack ATX Controller / ddasdkimo SCHEMATIC REVIEW - not a fabrication release

Sheet: /Host 04: isolated controls / LEDs (3/3)/
File: host04_3.kicad_sch
Title: Host 04: isolated controls / LEDs (3/3)

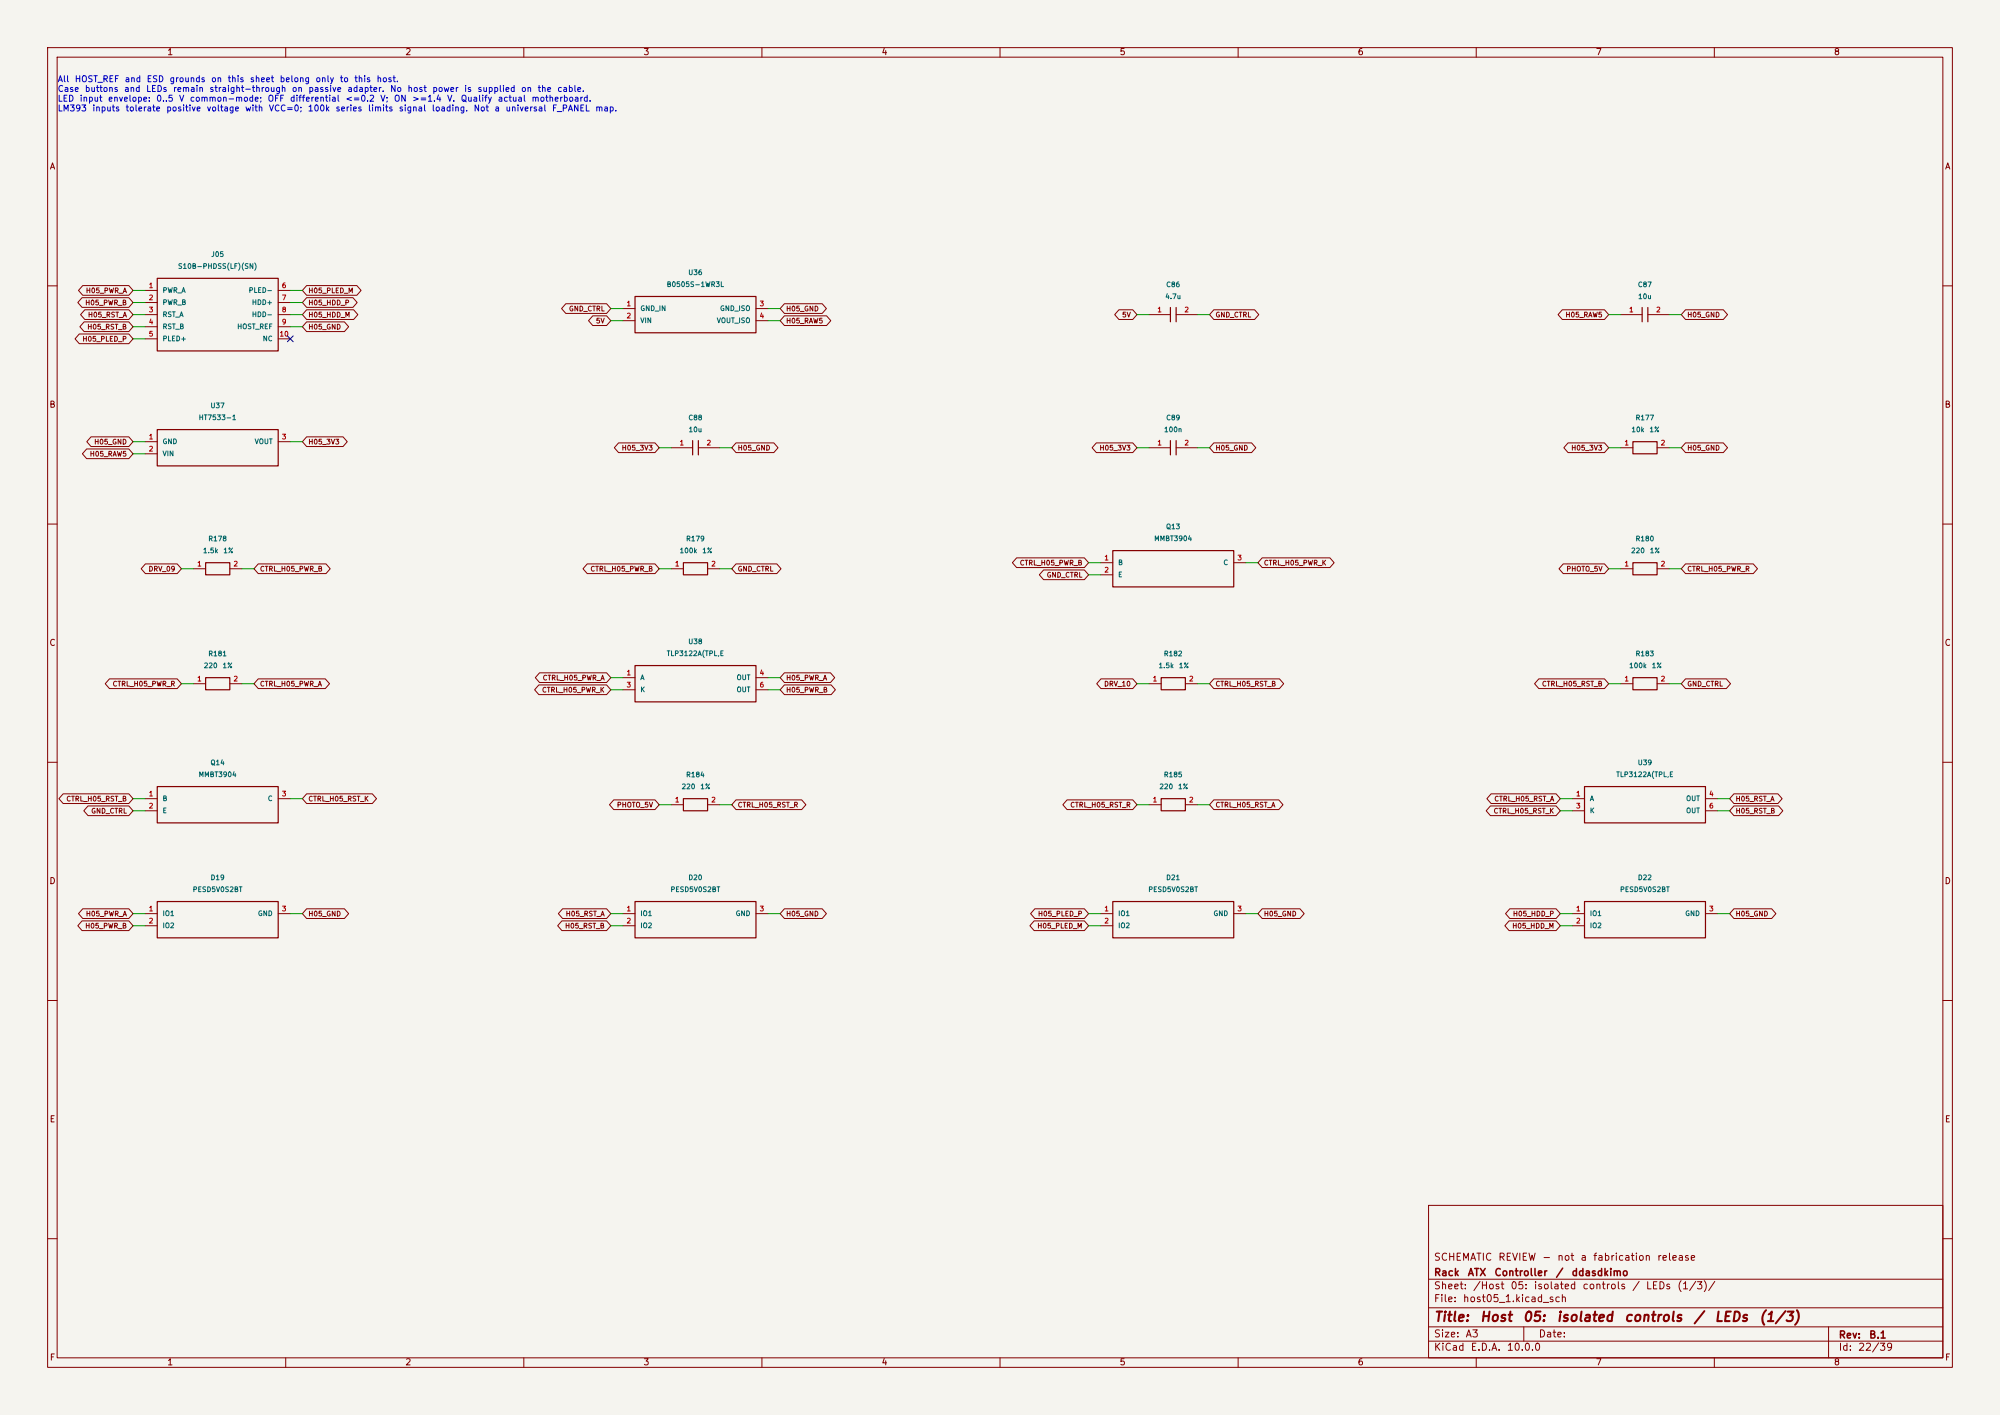
[picture p57: page 22]

Rack ATX Controller / ddasdkimo SCHEMATIC REVIEW - not a fabrication release

Sheet: /Host 05: isolated controls / LEDs (1/3)/
File: host05_1.kicad_sch
Title: Host 05: isolated controls / LEDs (1/3)

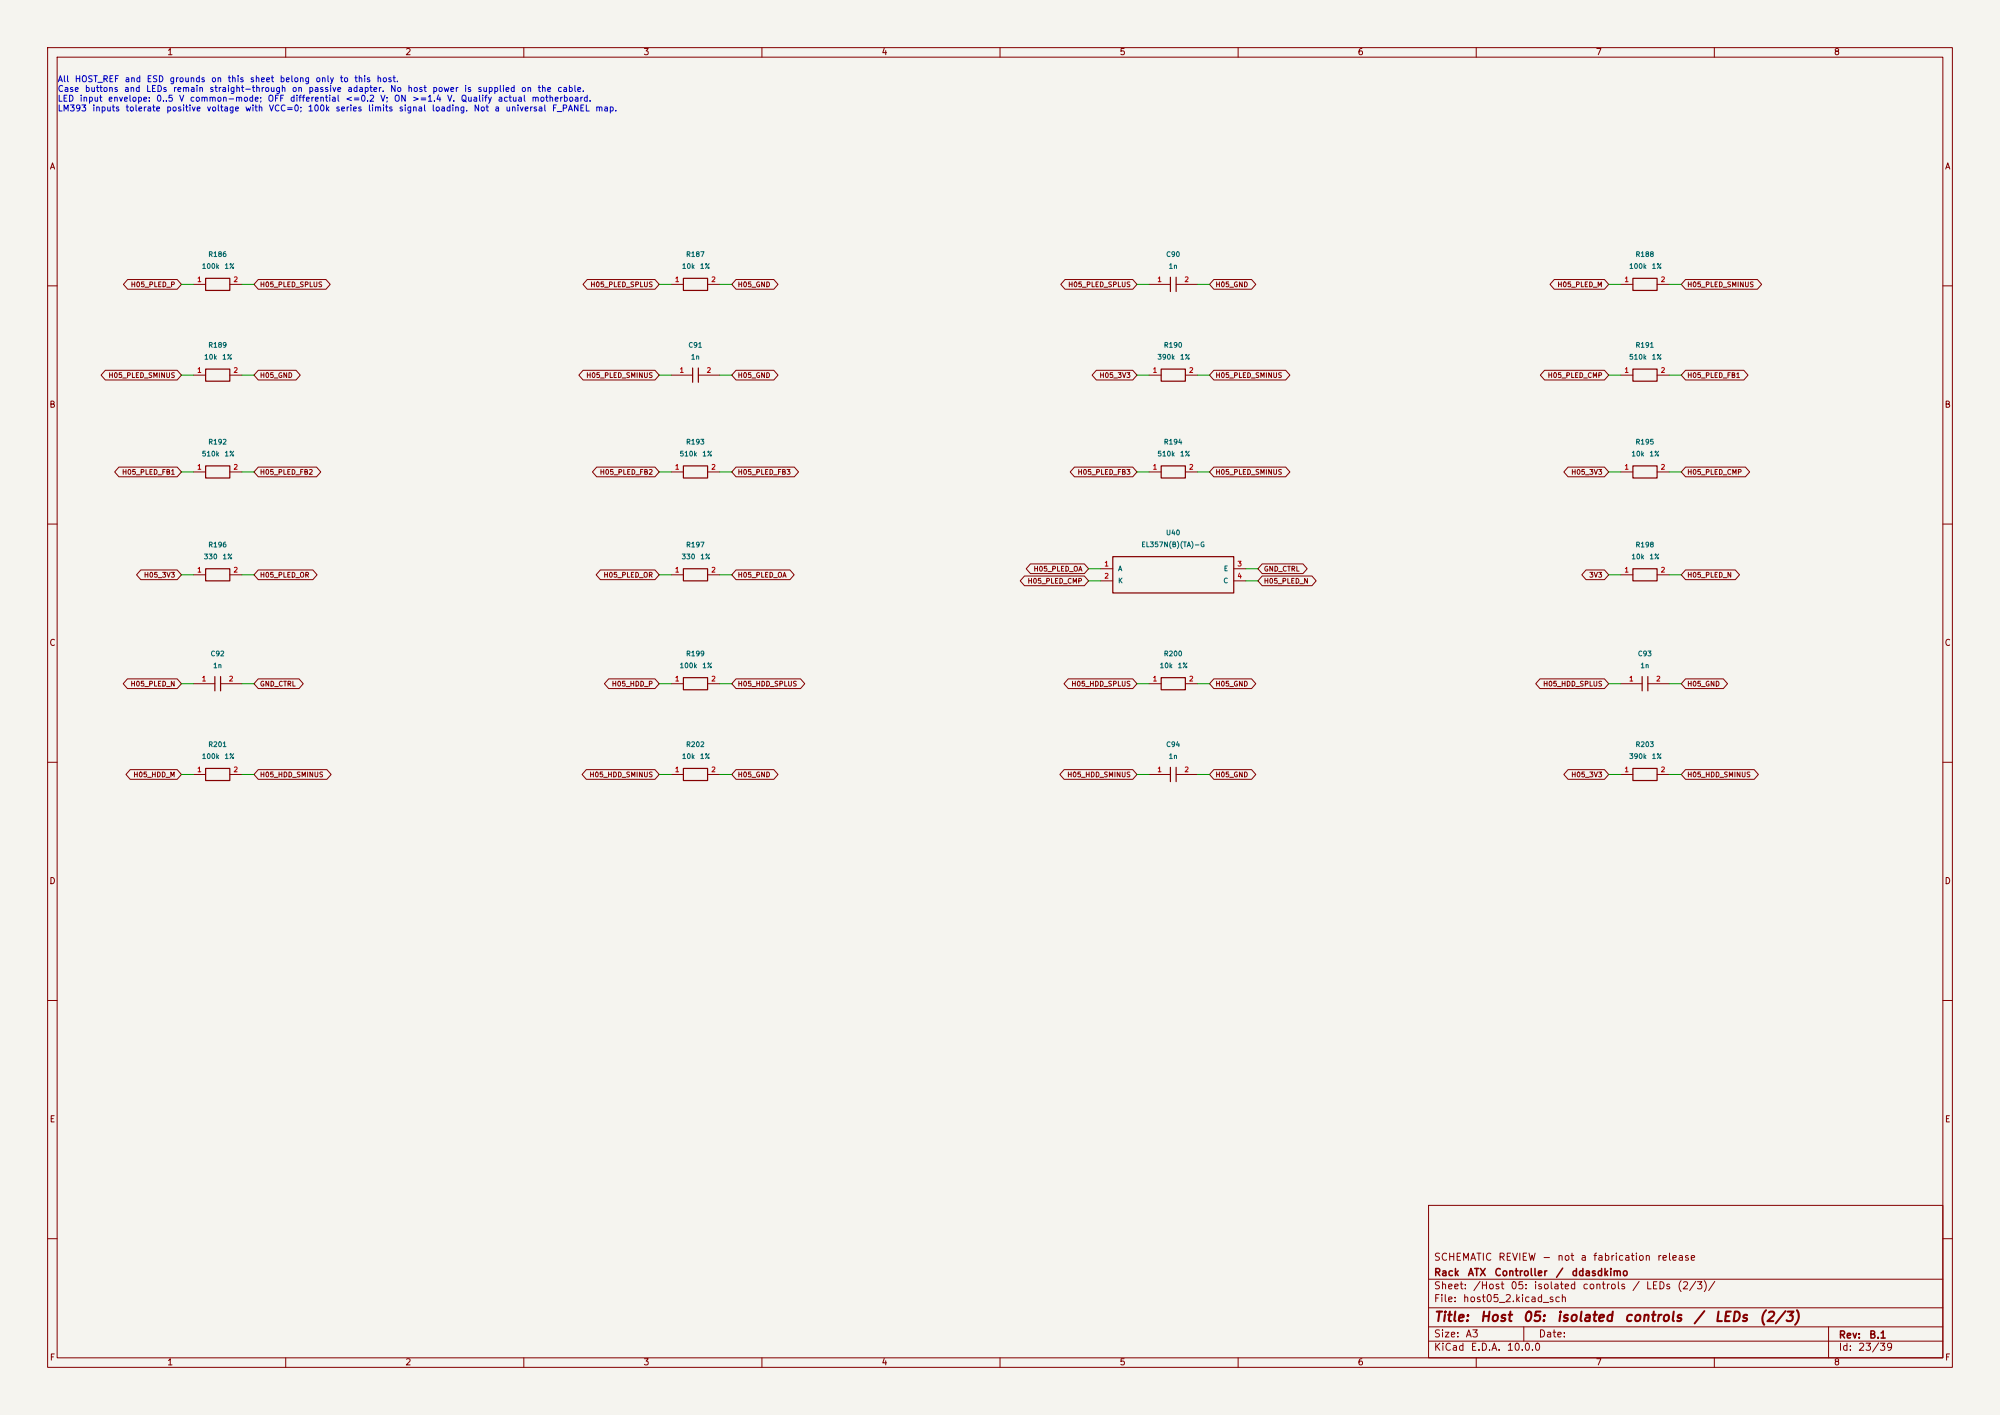
[picture p58: page 23]

Rack ATX Controller / ddasdkimo SCHEMATIC REVIEW - not a fabrication release

Sheet: /Host 05: isolated controls / LEDs (2/3)/
File: host05_2.kicad_sch
Title: Host 05: isolated controls / LEDs (2/3)

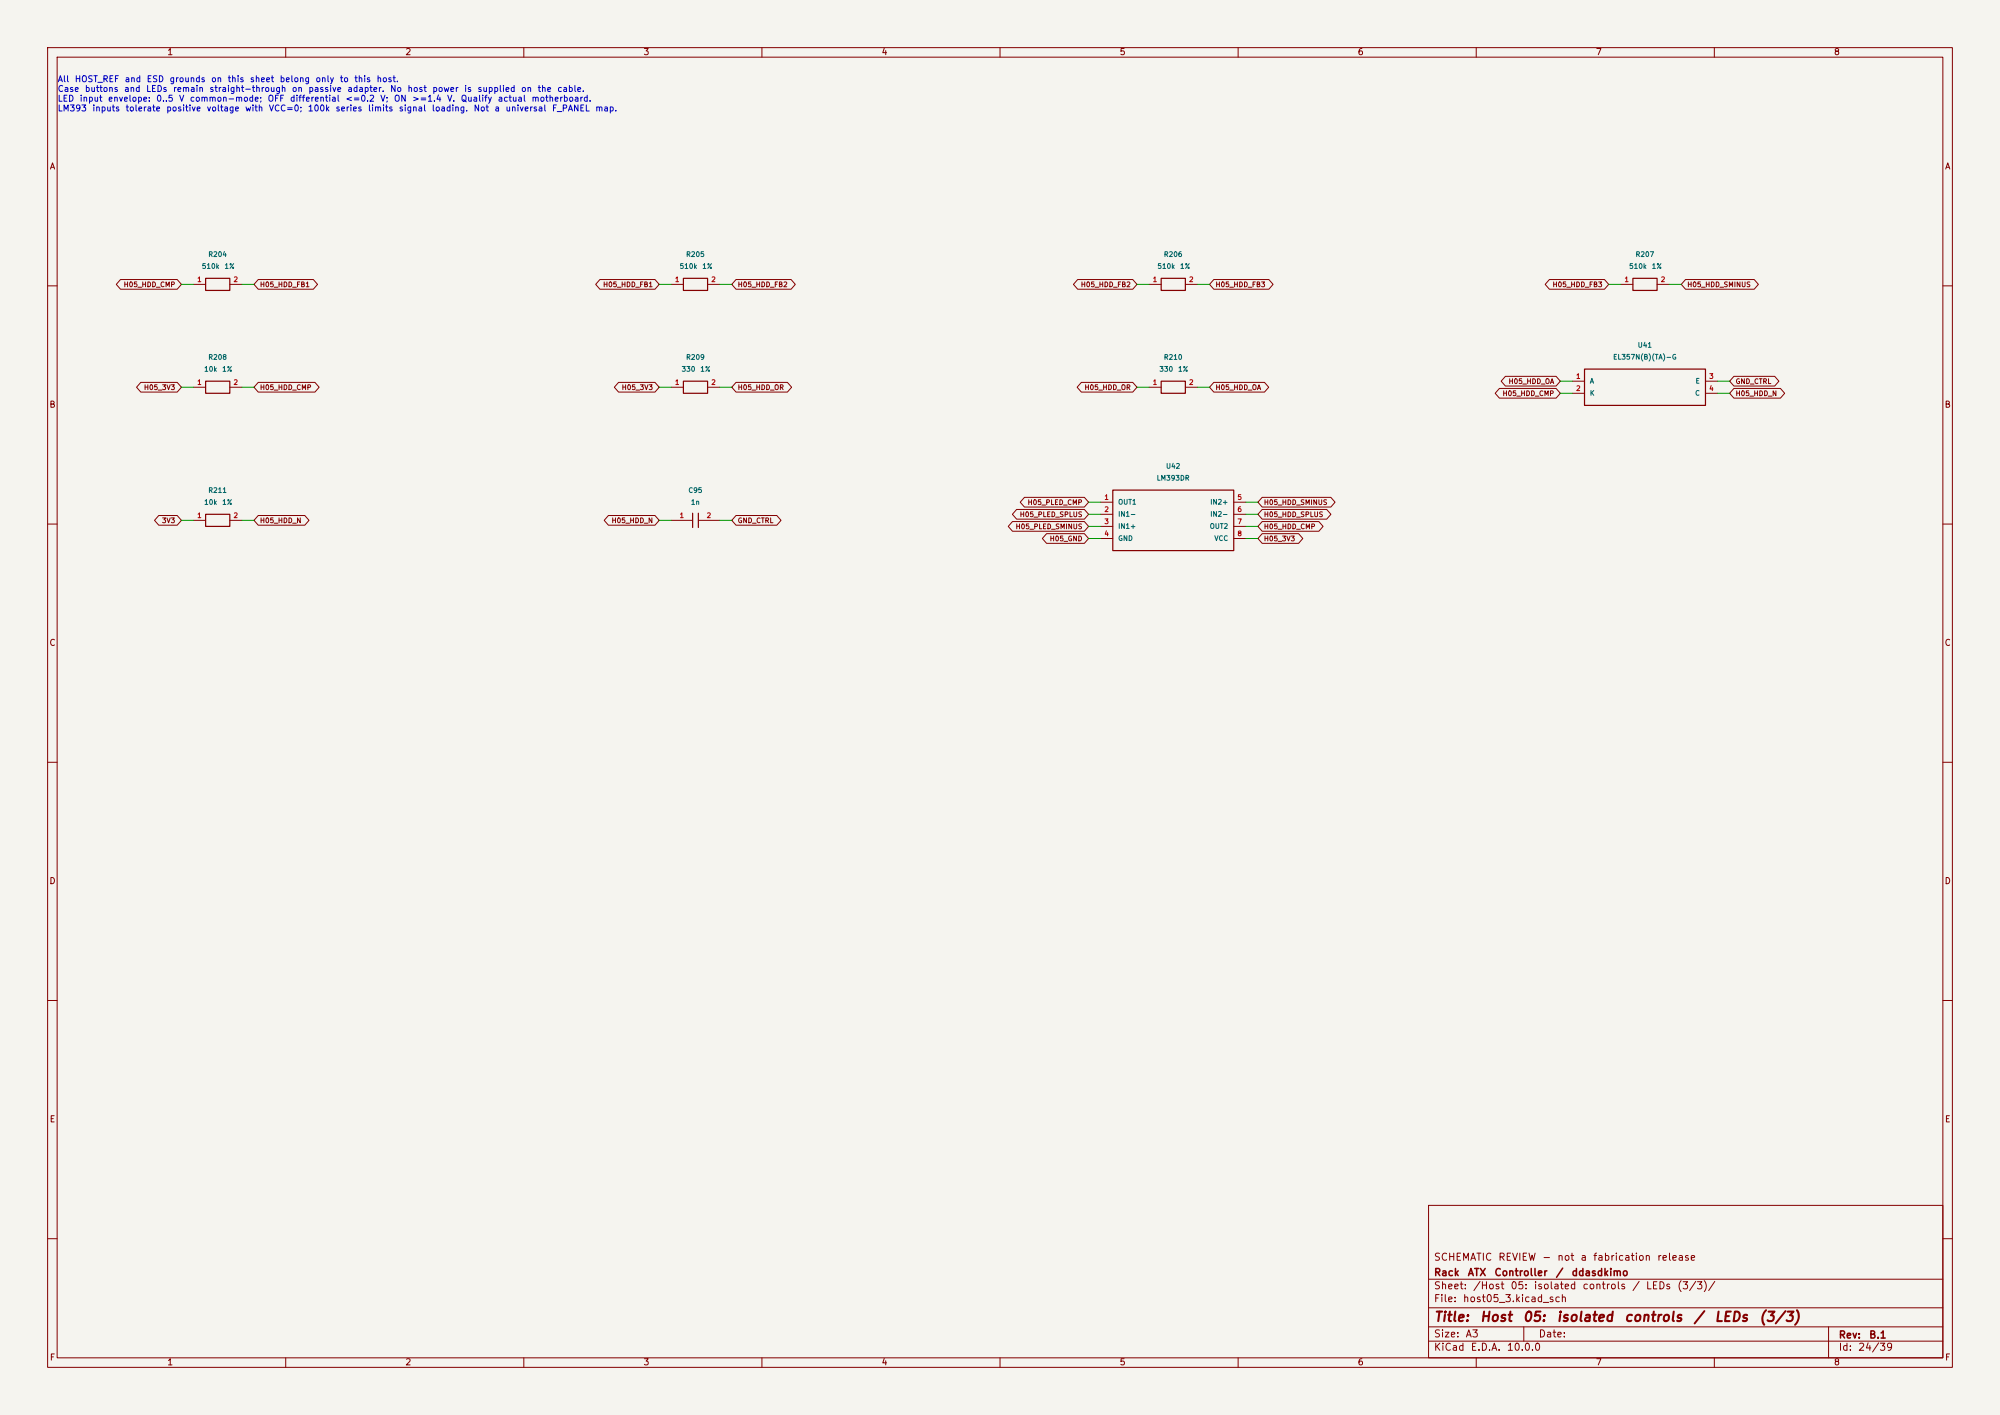
[picture p59: page 24]

Rack ATX Controller / ddasdkimo SCHEMATIC REVIEW - not a fabrication release

Sheet: /Host 05: isolated controls / LEDs (3/3)/
File: host05_3.kicad_sch
Title: Host 05: isolated controls / LEDs (3/3)

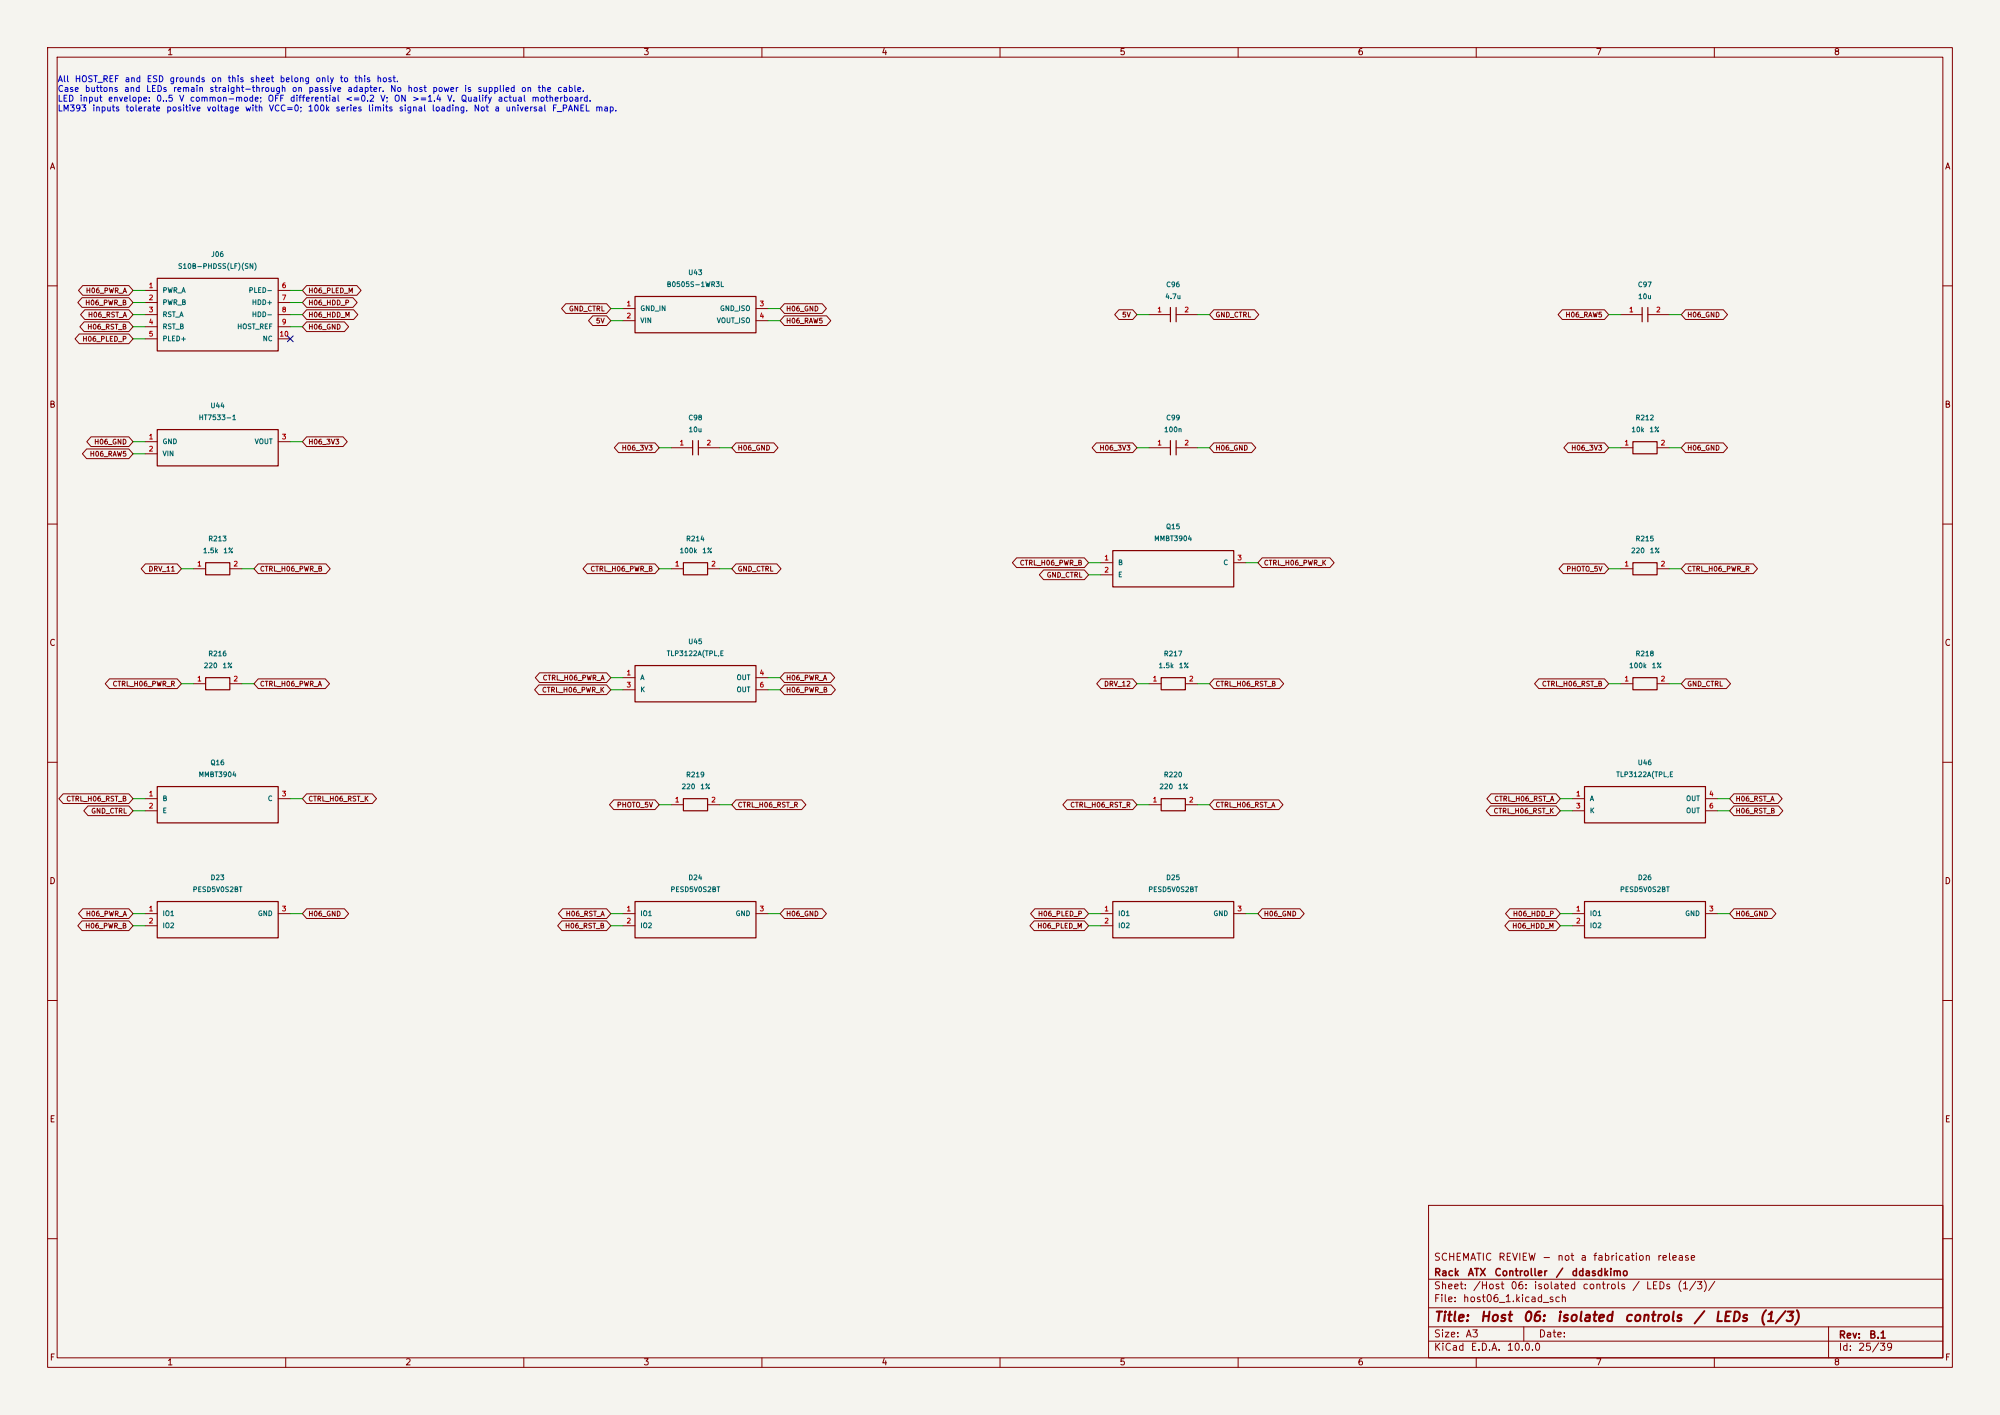
[picture p60: page 25]

Rack ATX Controller / ddasdkimo SCHEMATIC REVIEW - not a fabrication release

Sheet: /Host 06: isolated controls / LEDs (1/3)/
File: host06_1.kicad_sch
Title: Host 06: isolated controls / LEDs (1/3)

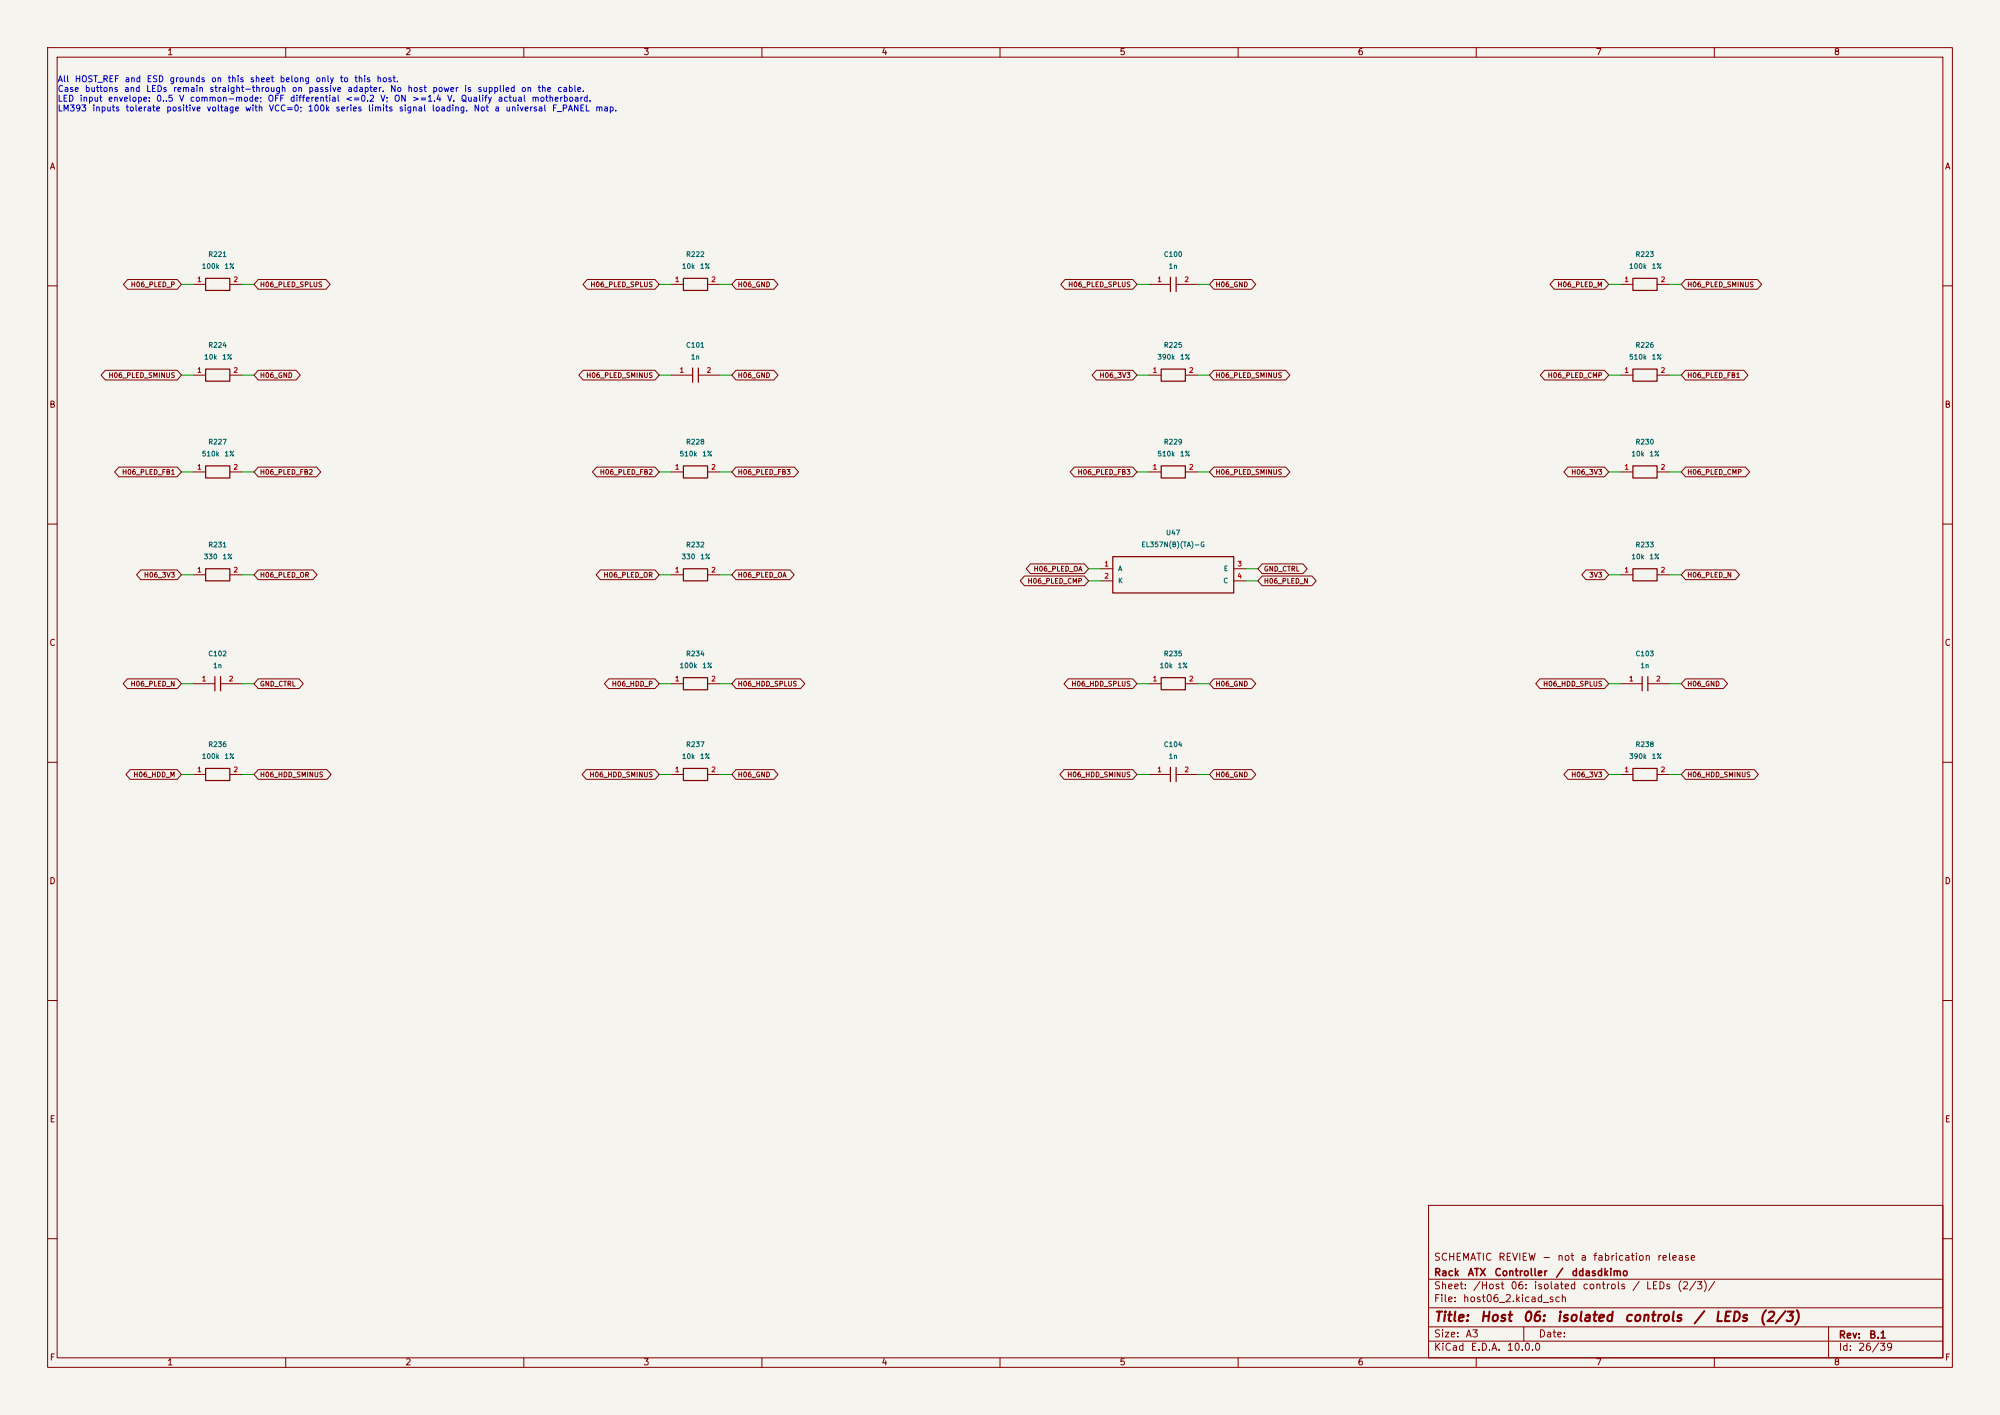
[picture p61: page 26]

Rack ATX Controller / ddasdkimo SCHEMATIC REVIEW - not a fabrication release

Sheet: /Host 06: isolated controls / LEDs (2/3)/
File: host06_2.kicad_sch
Title: Host 06: isolated controls / LEDs (2/3)

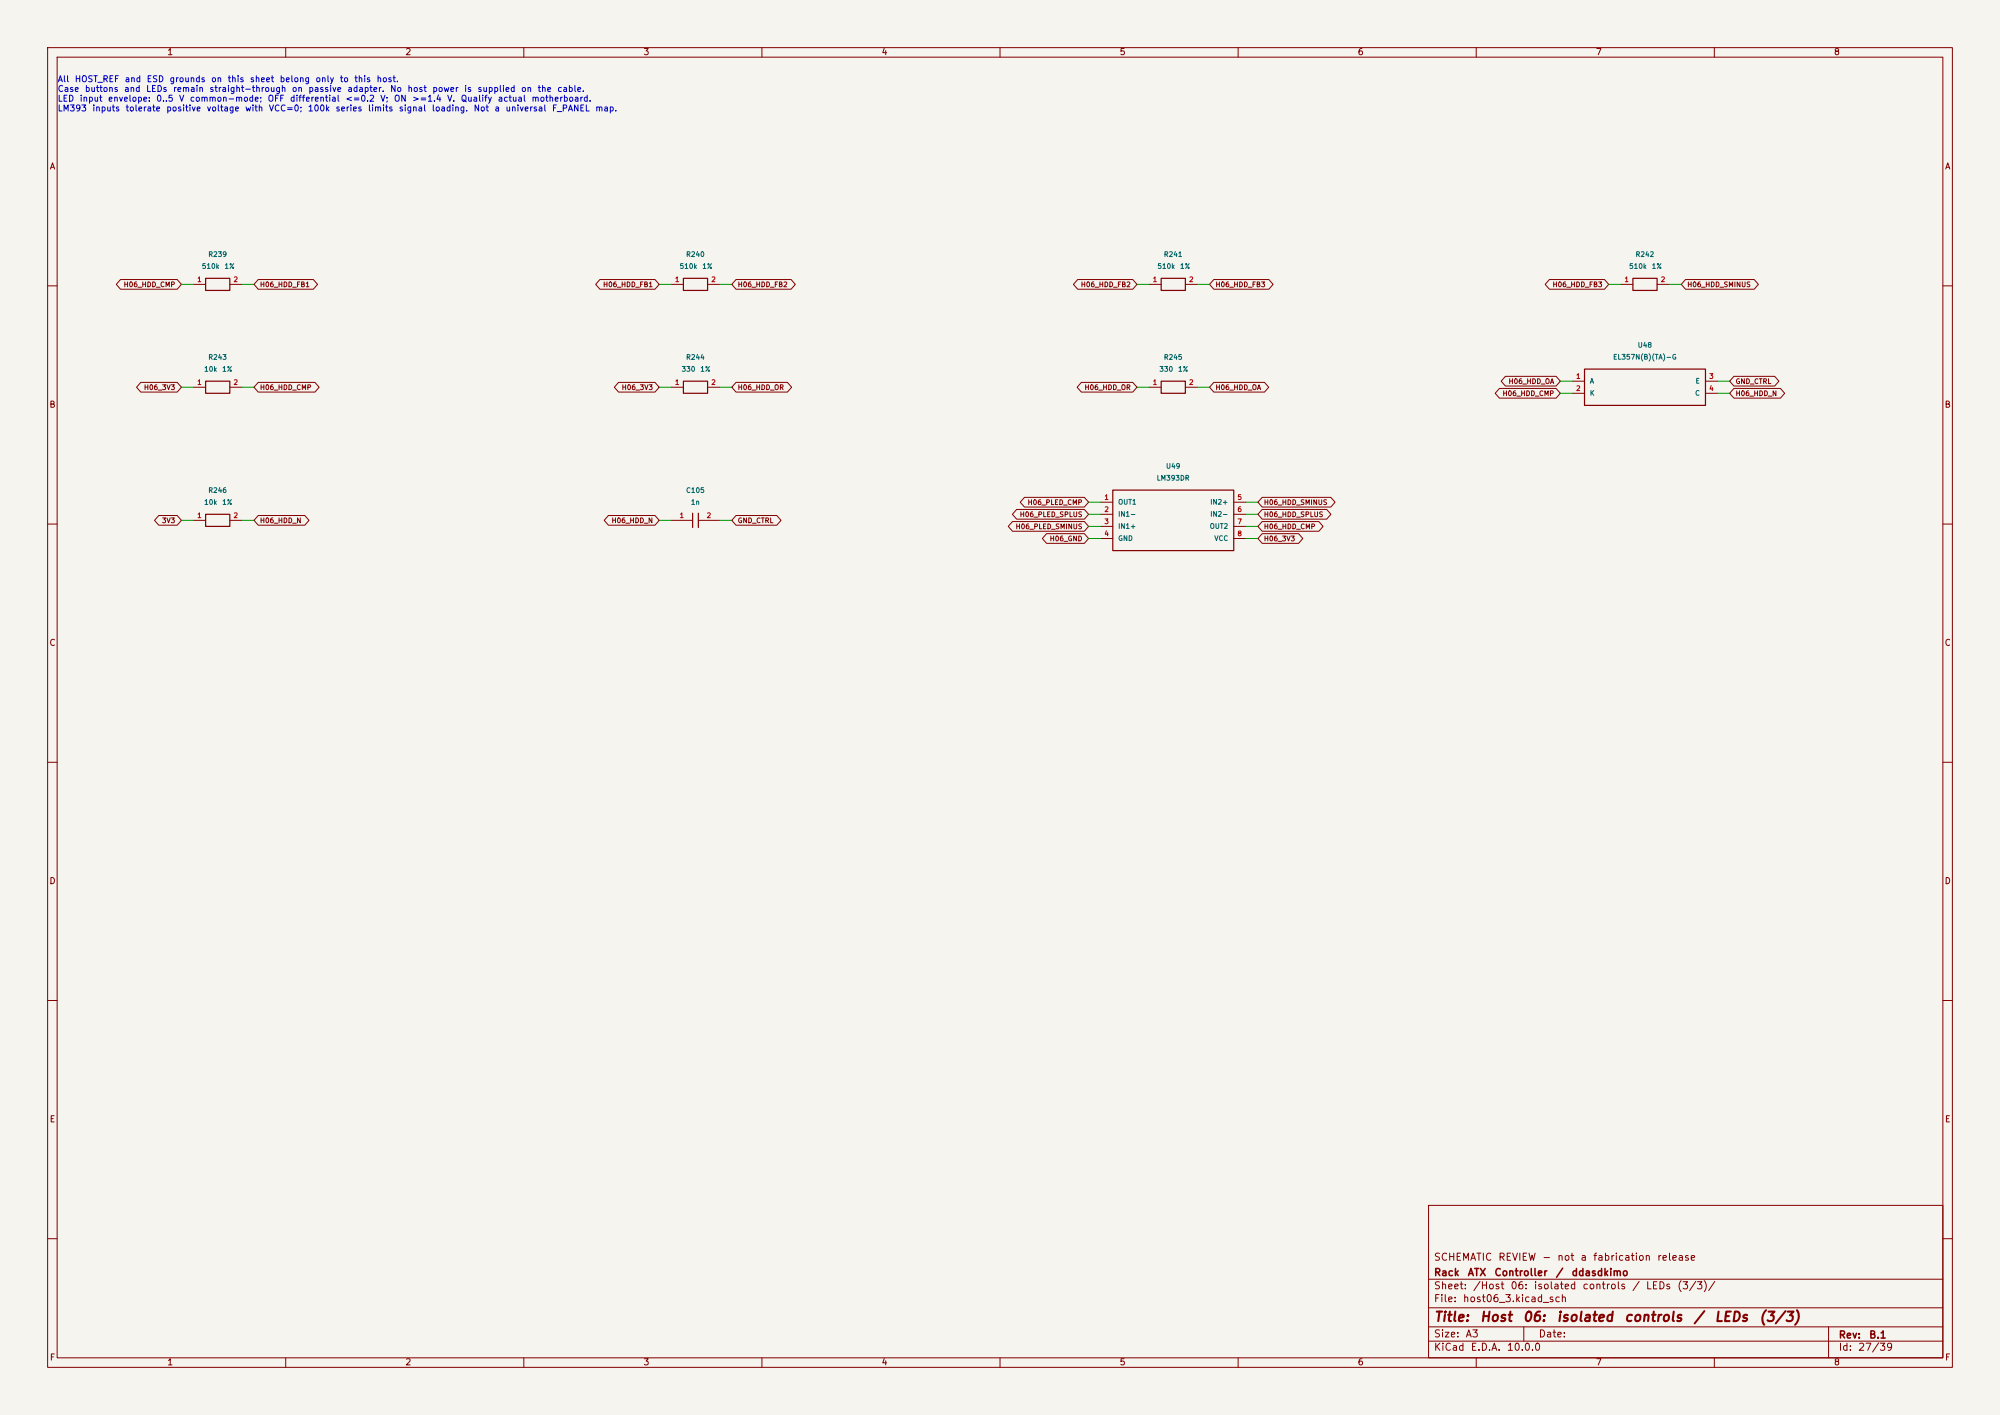
[picture p62: page 27]

Rack ATX Controller / ddasdkimo SCHEMATIC REVIEW - not a fabrication release

Sheet: /Host 06: isolated controls / LEDs (3/3)/
File: host06_3.kicad_sch
Title: Host 06: isolated controls / LEDs (3/3)

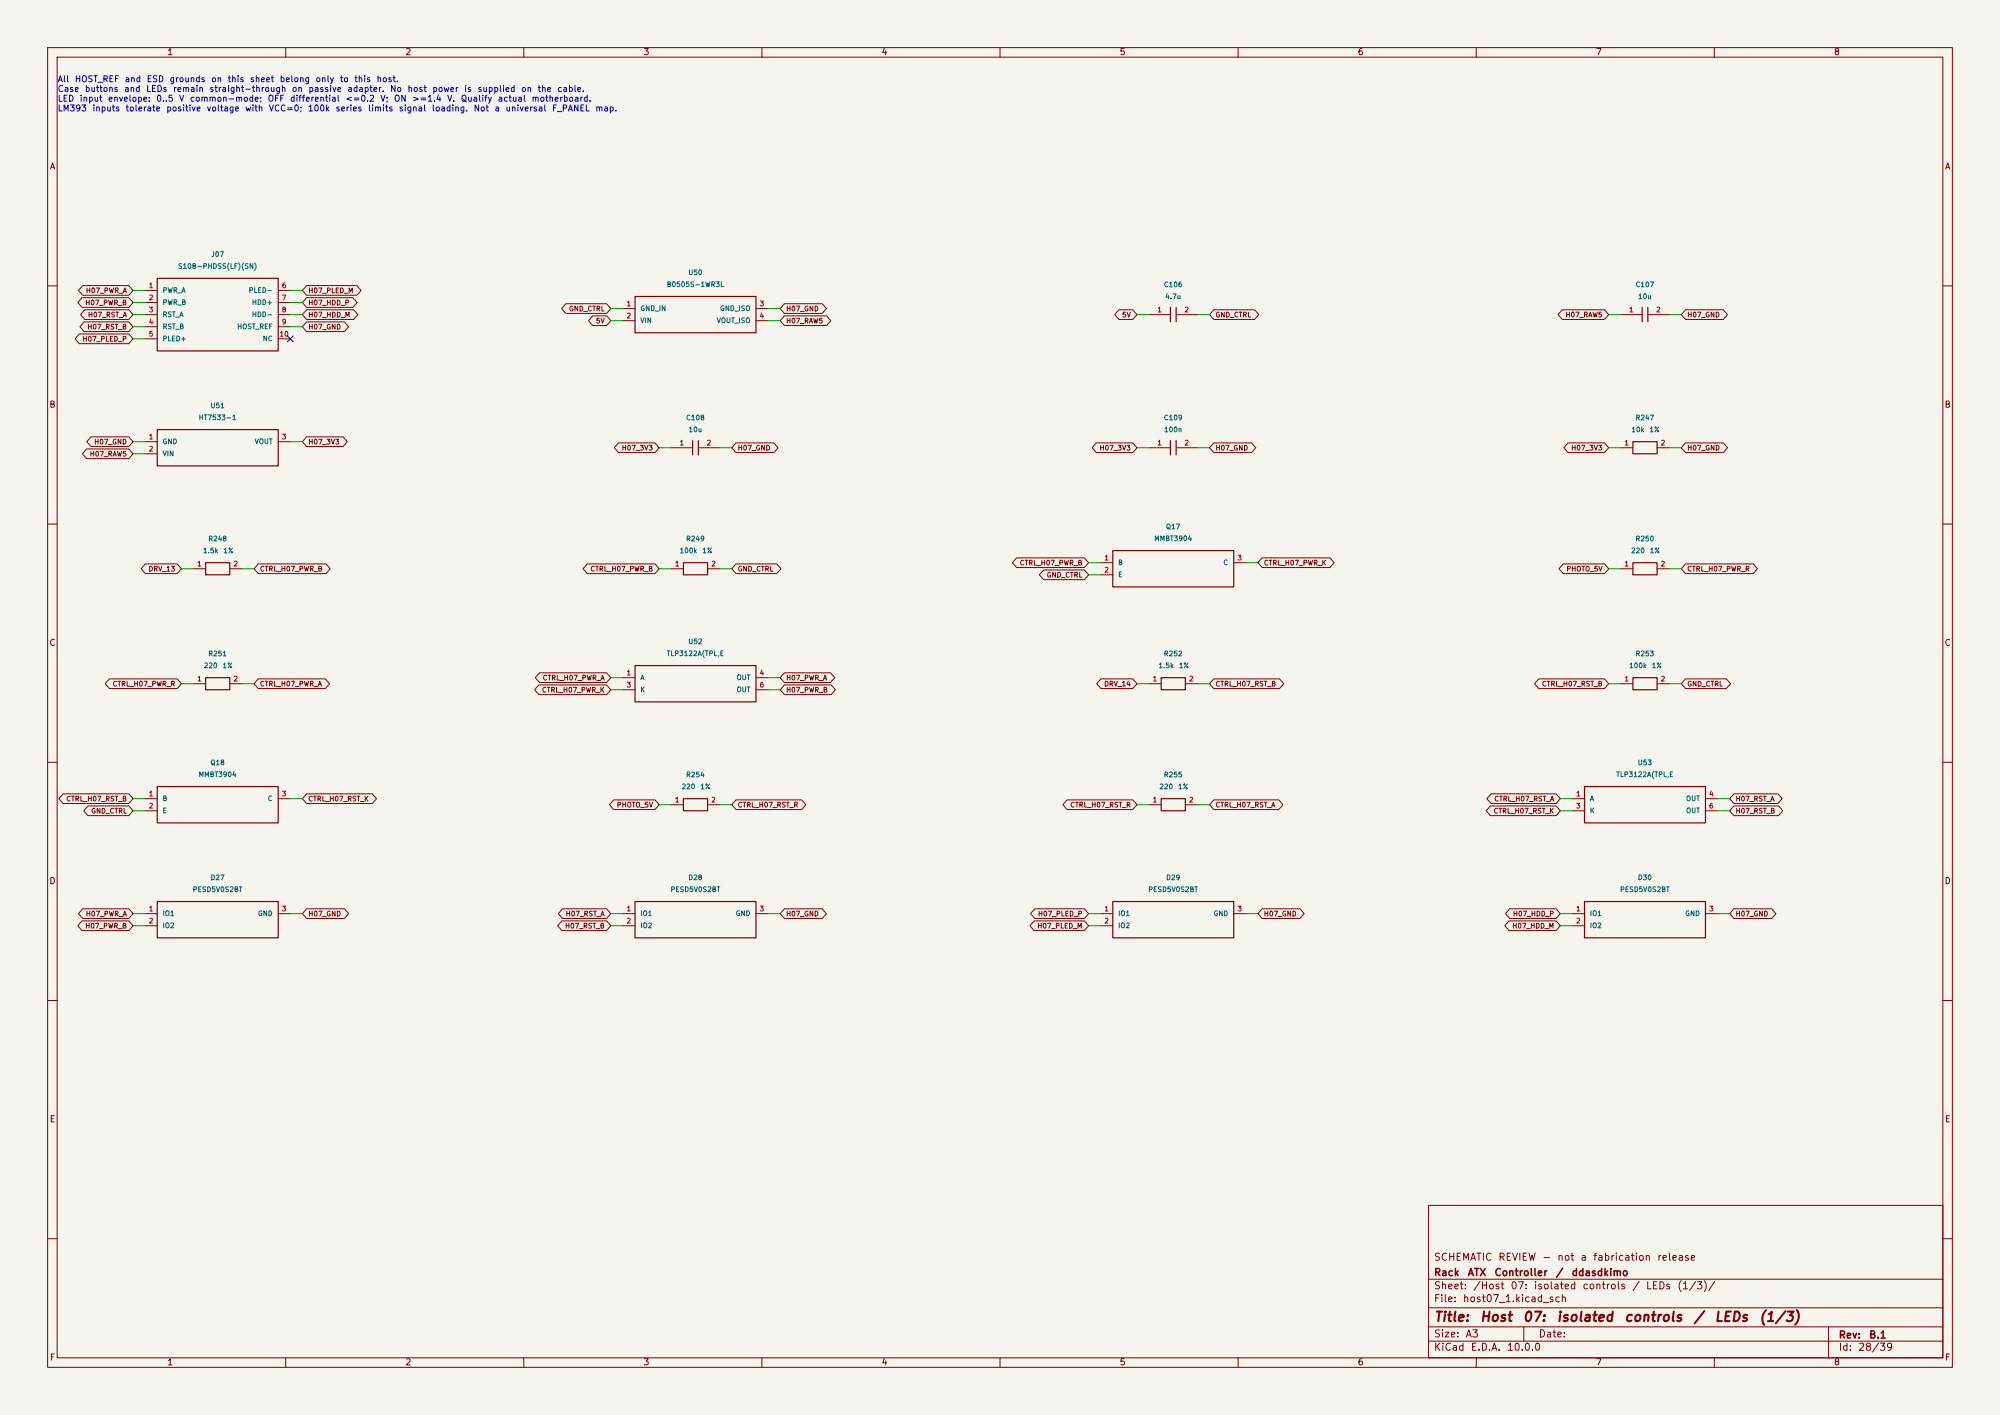
[picture p63: page 28]

Rack ATX Controller / ddasdkimo SCHEMATIC REVIEW - not a fabrication release

Sheet: /Host 07: isolated controls / LEDs (1/3)/
File: host07_1.kicad_sch
Title: Host 07: isolated controls / LEDs (1/3)

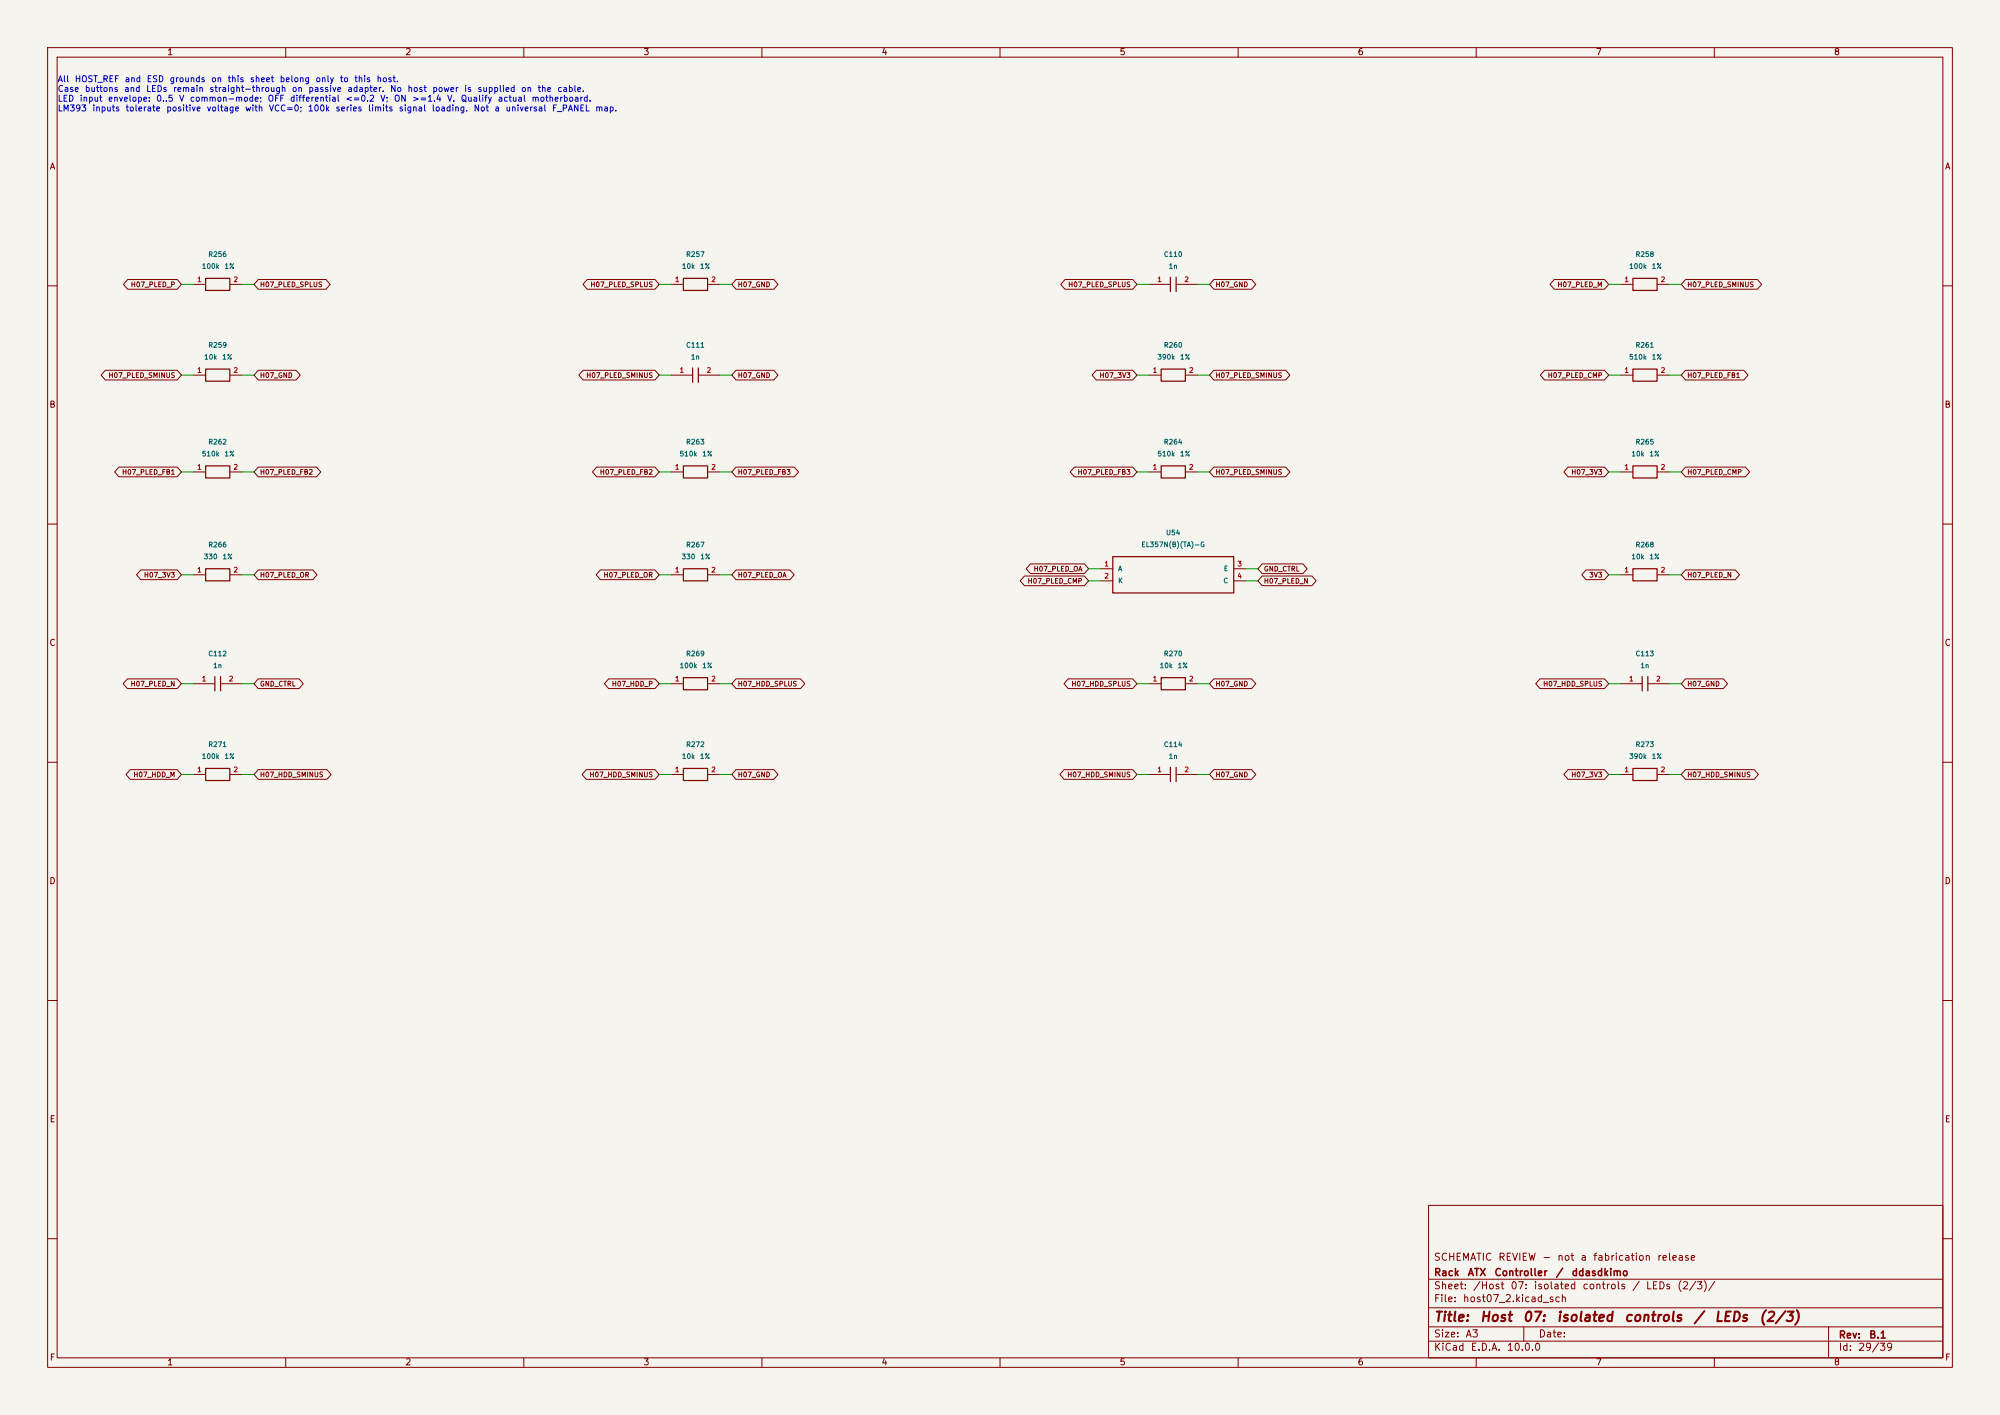
[picture p64: page 29]

Rack ATX Controller / ddasdkimo SCHEMATIC REVIEW - not a fabrication release

Sheet: /Host 07: isolated controls / LEDs (2/3)/
File: host07_2.kicad_sch
Title: Host 07: isolated controls / LEDs (2/3)

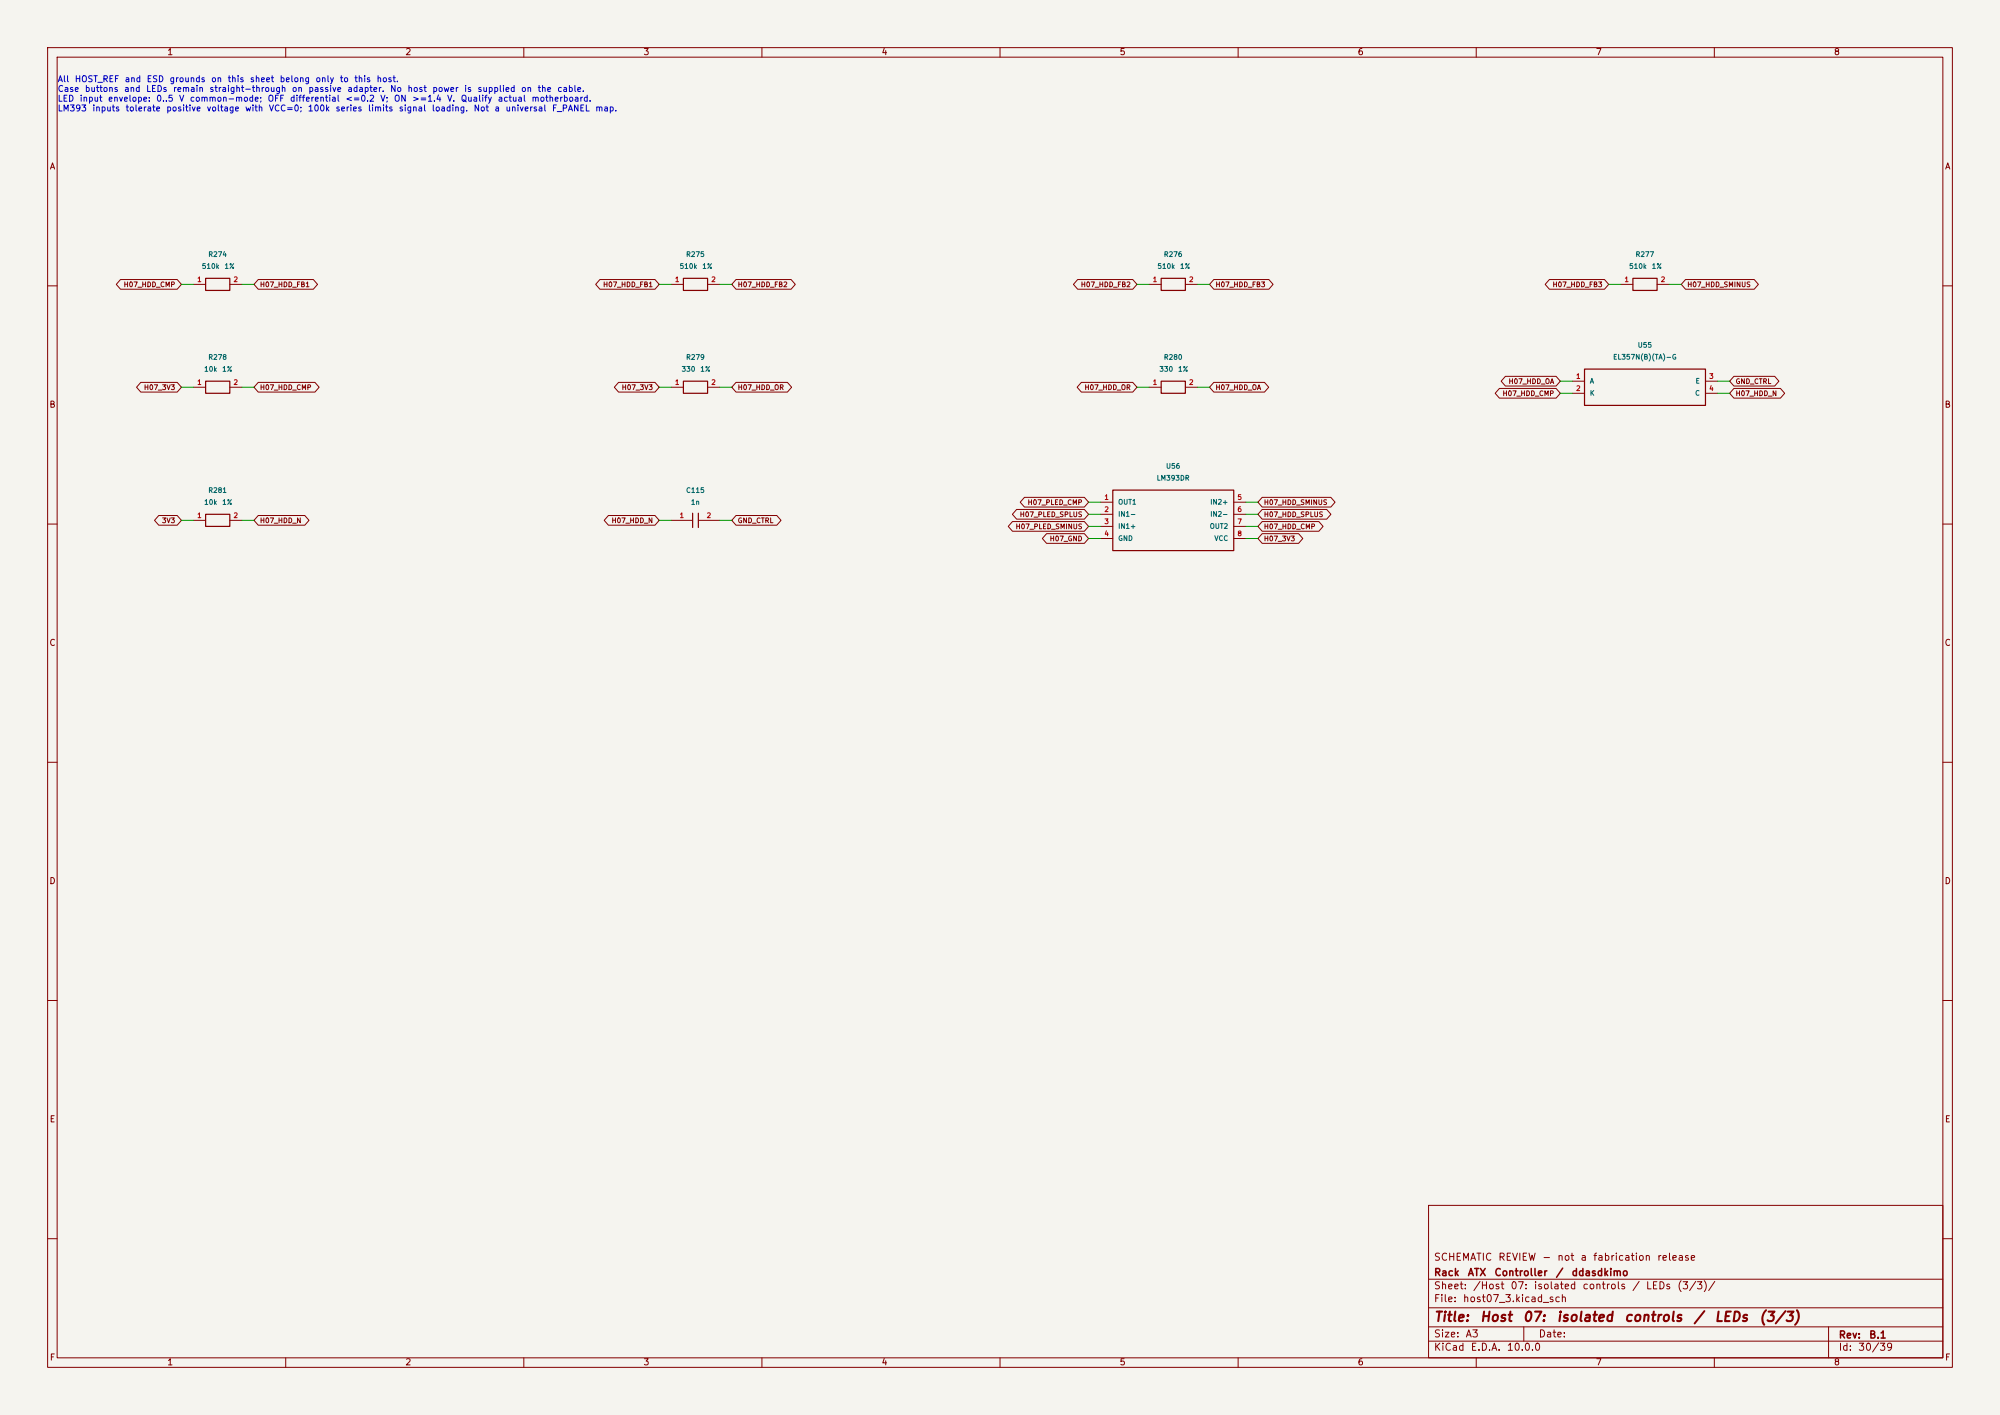
[picture p65: page 30]

Rack ATX Controller / ddasdkimo SCHEMATIC REVIEW - not a fabrication release

Sheet: /Host 07: isolated controls / LEDs (3/3)/
File: host07_3.kicad_sch
Title: Host 07: isolated controls / LEDs (3/3)

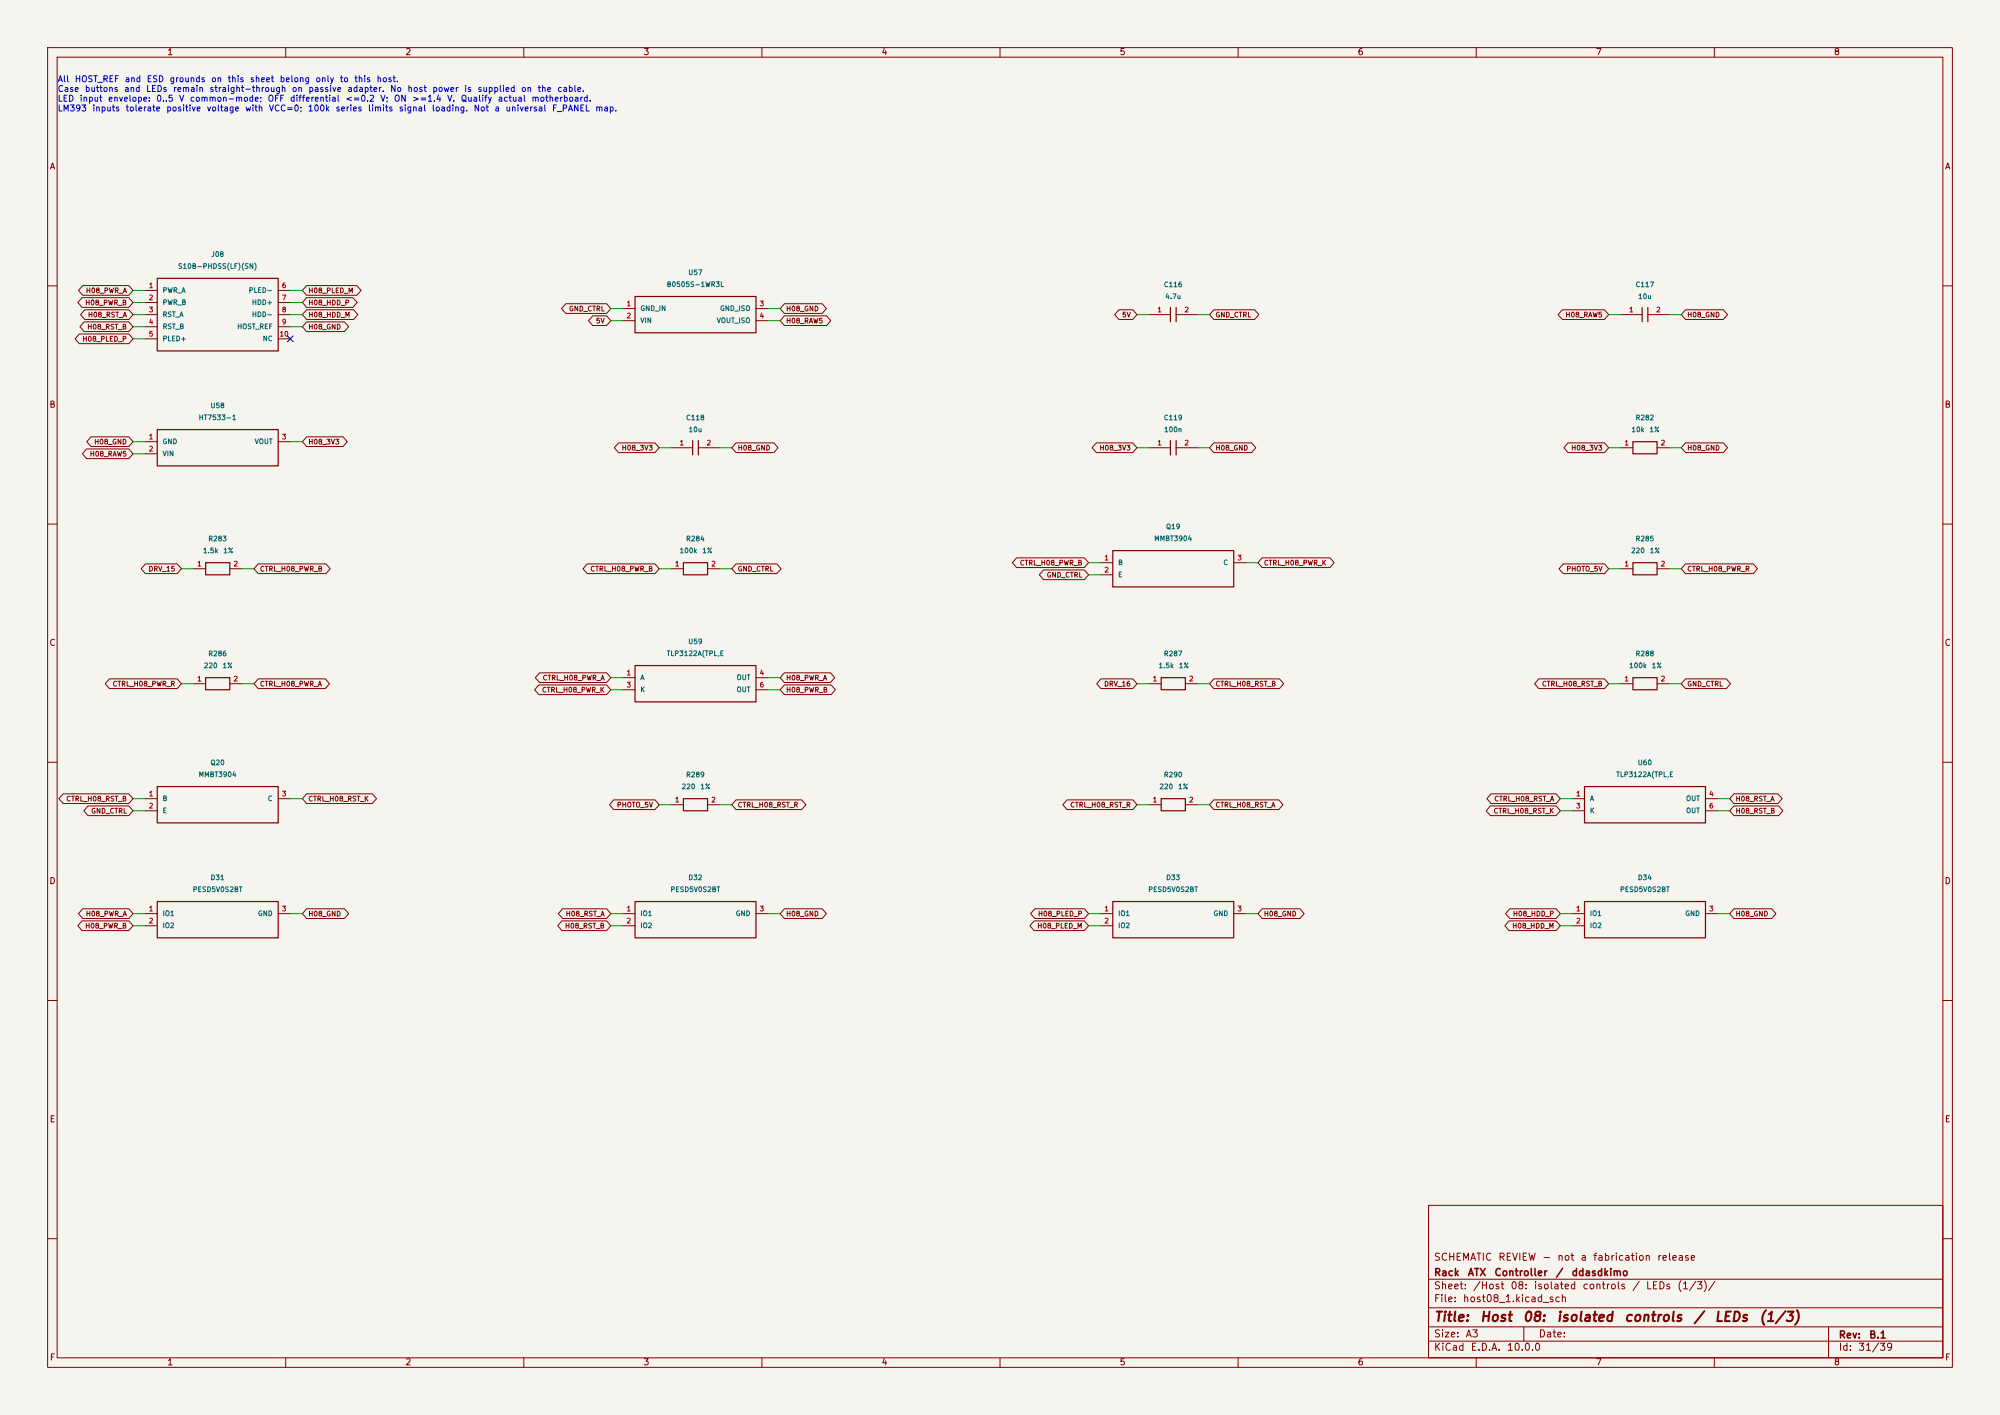
[picture p66: page 31]

Rack ATX Controller / ddasdkimo SCHEMATIC REVIEW - not a fabrication release

Sheet: /Host 08: isolated controls / LEDs (1/3)/
File: host08_1.kicad_sch
Title: Host 08: isolated controls / LEDs (1/3)

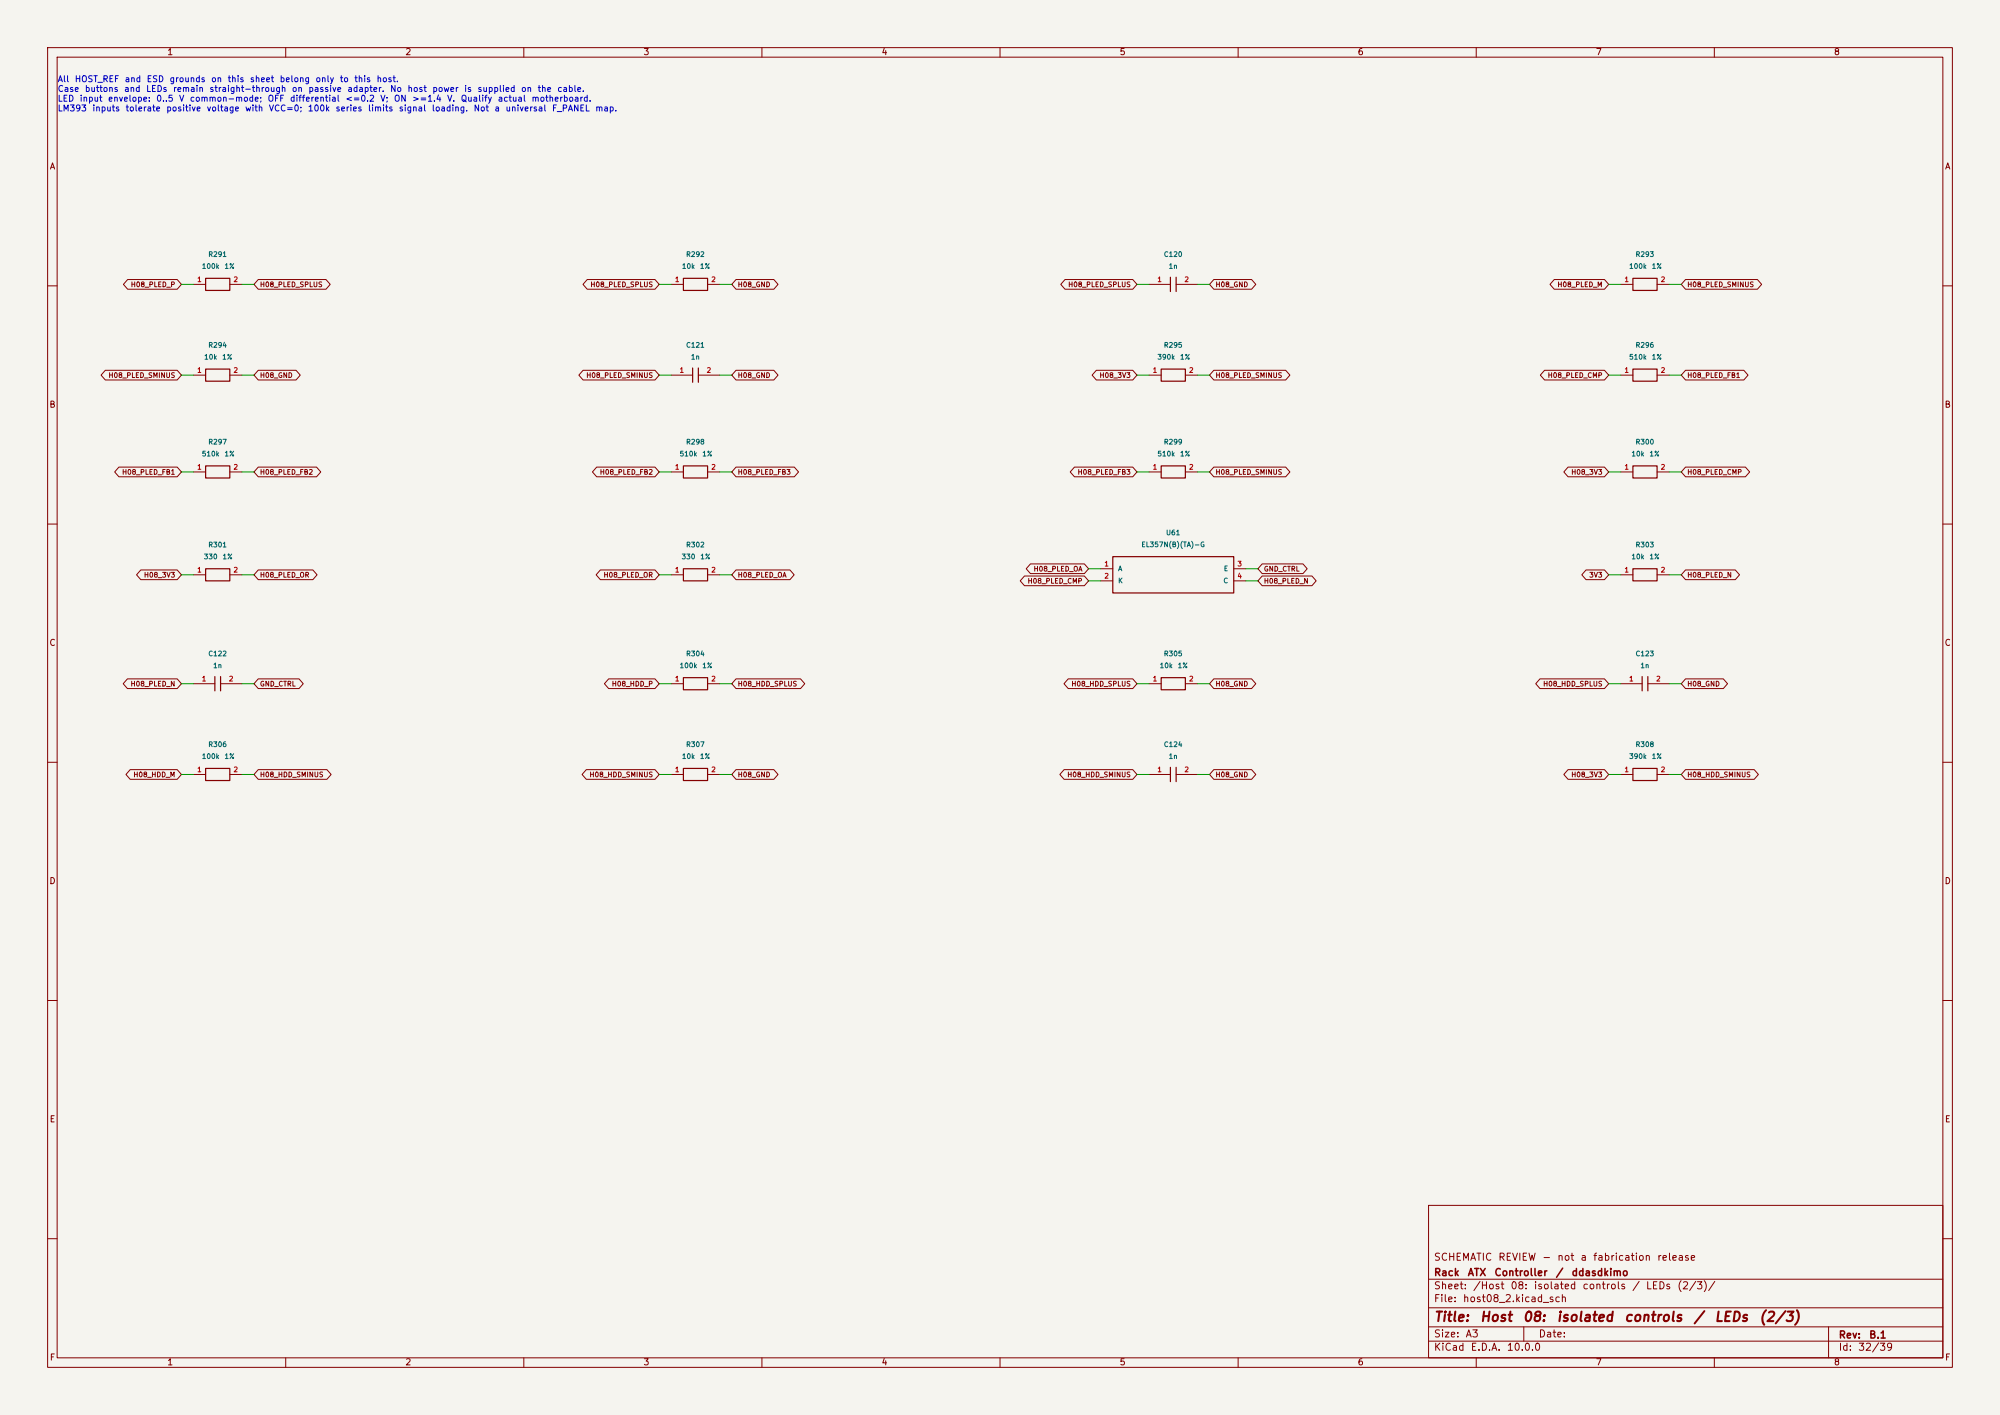
[picture p67: page 32]

Rack ATX Controller / ddasdkimo SCHEMATIC REVIEW - not a fabrication release

Sheet: /Host 08: isolated controls / LEDs (2/3)/
File: host08_2.kicad_sch
Title: Host 08: isolated controls / LEDs (2/3)

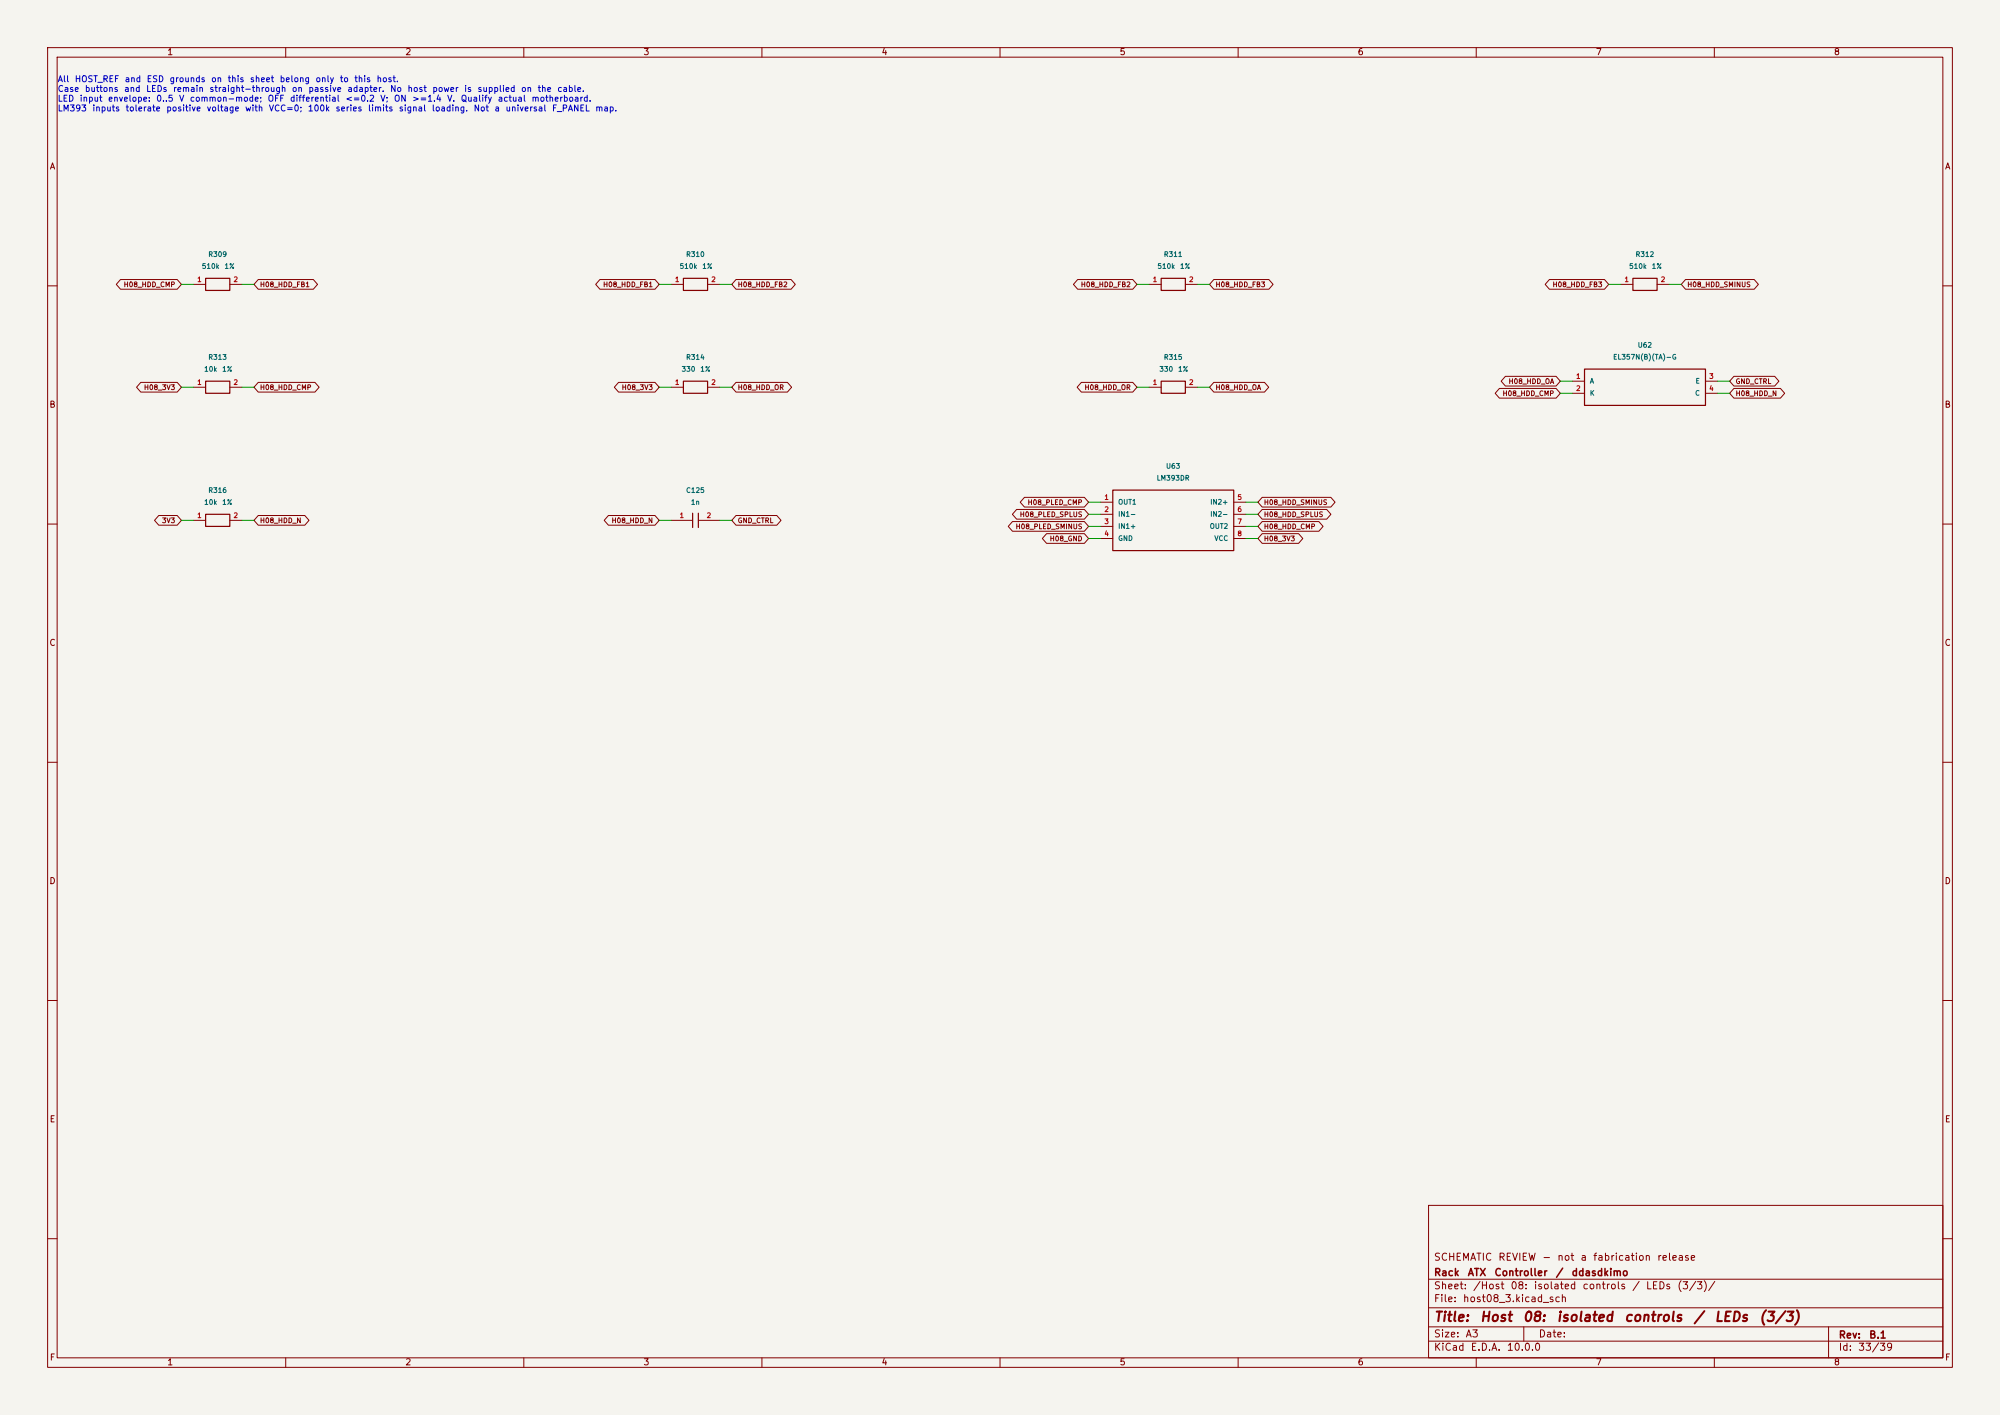
[picture p68: page 33]

Rack ATX Controller / ddasdkimo SCHEMATIC REVIEW - not a fabrication release

Sheet: /Host 08: isolated controls / LEDs (3/3)/
File: host08_3.kicad_sch
Title: Host 08: isolated controls / LEDs (3/3)

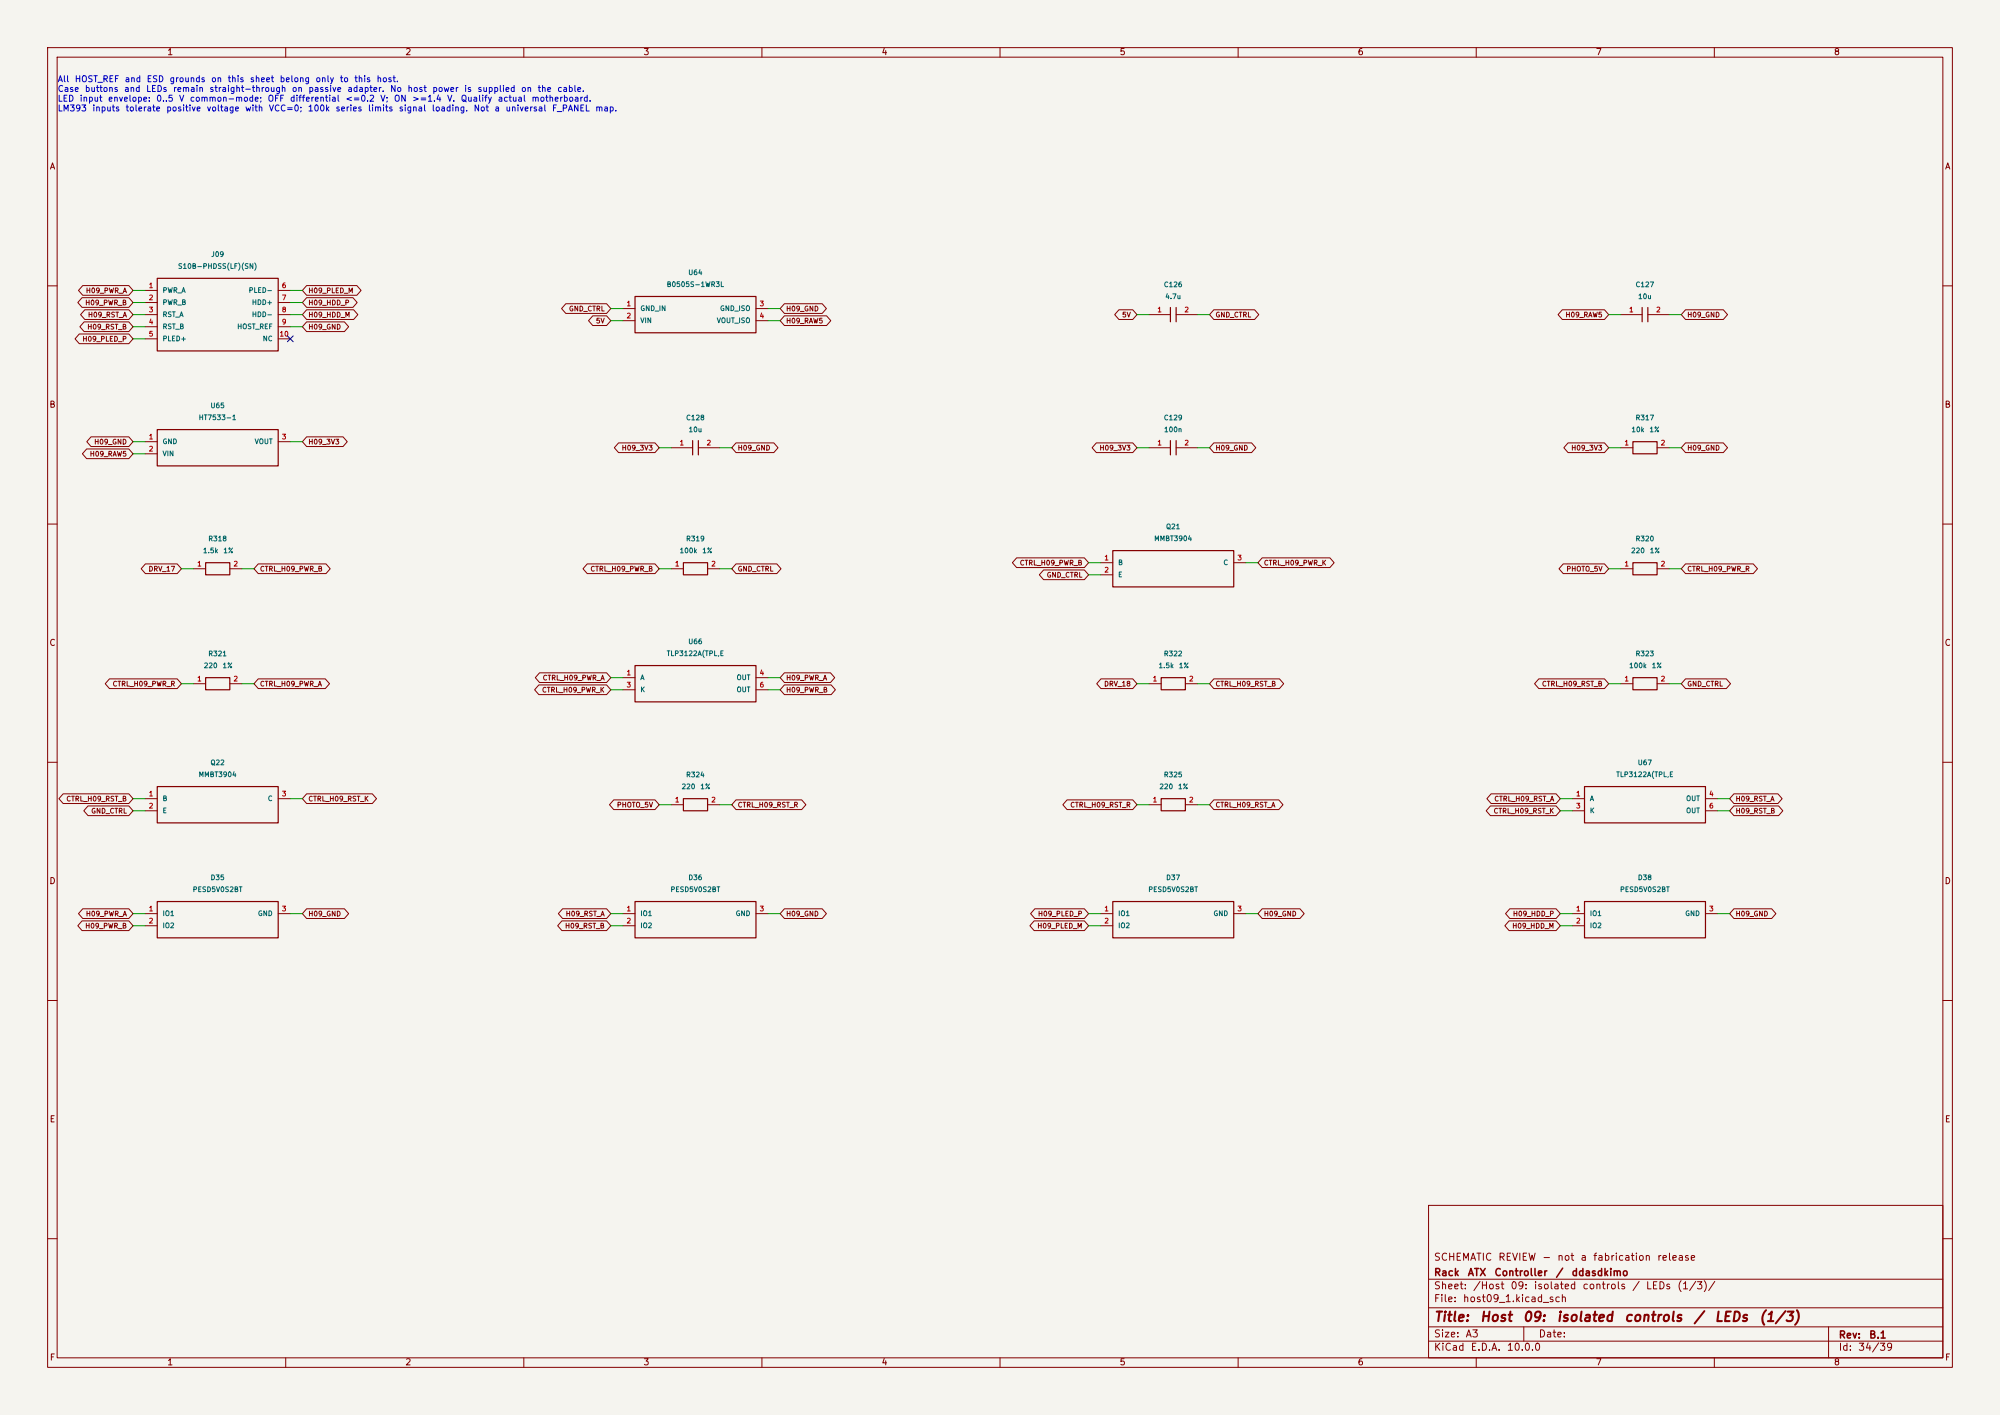
[picture p69: page 34]

Rack ATX Controller / ddasdkimo SCHEMATIC REVIEW - not a fabrication release

Sheet: /Host 09: isolated controls / LEDs (1/3)/
File: host09_1.kicad_sch
Title: Host 09: isolated controls / LEDs (1/3)

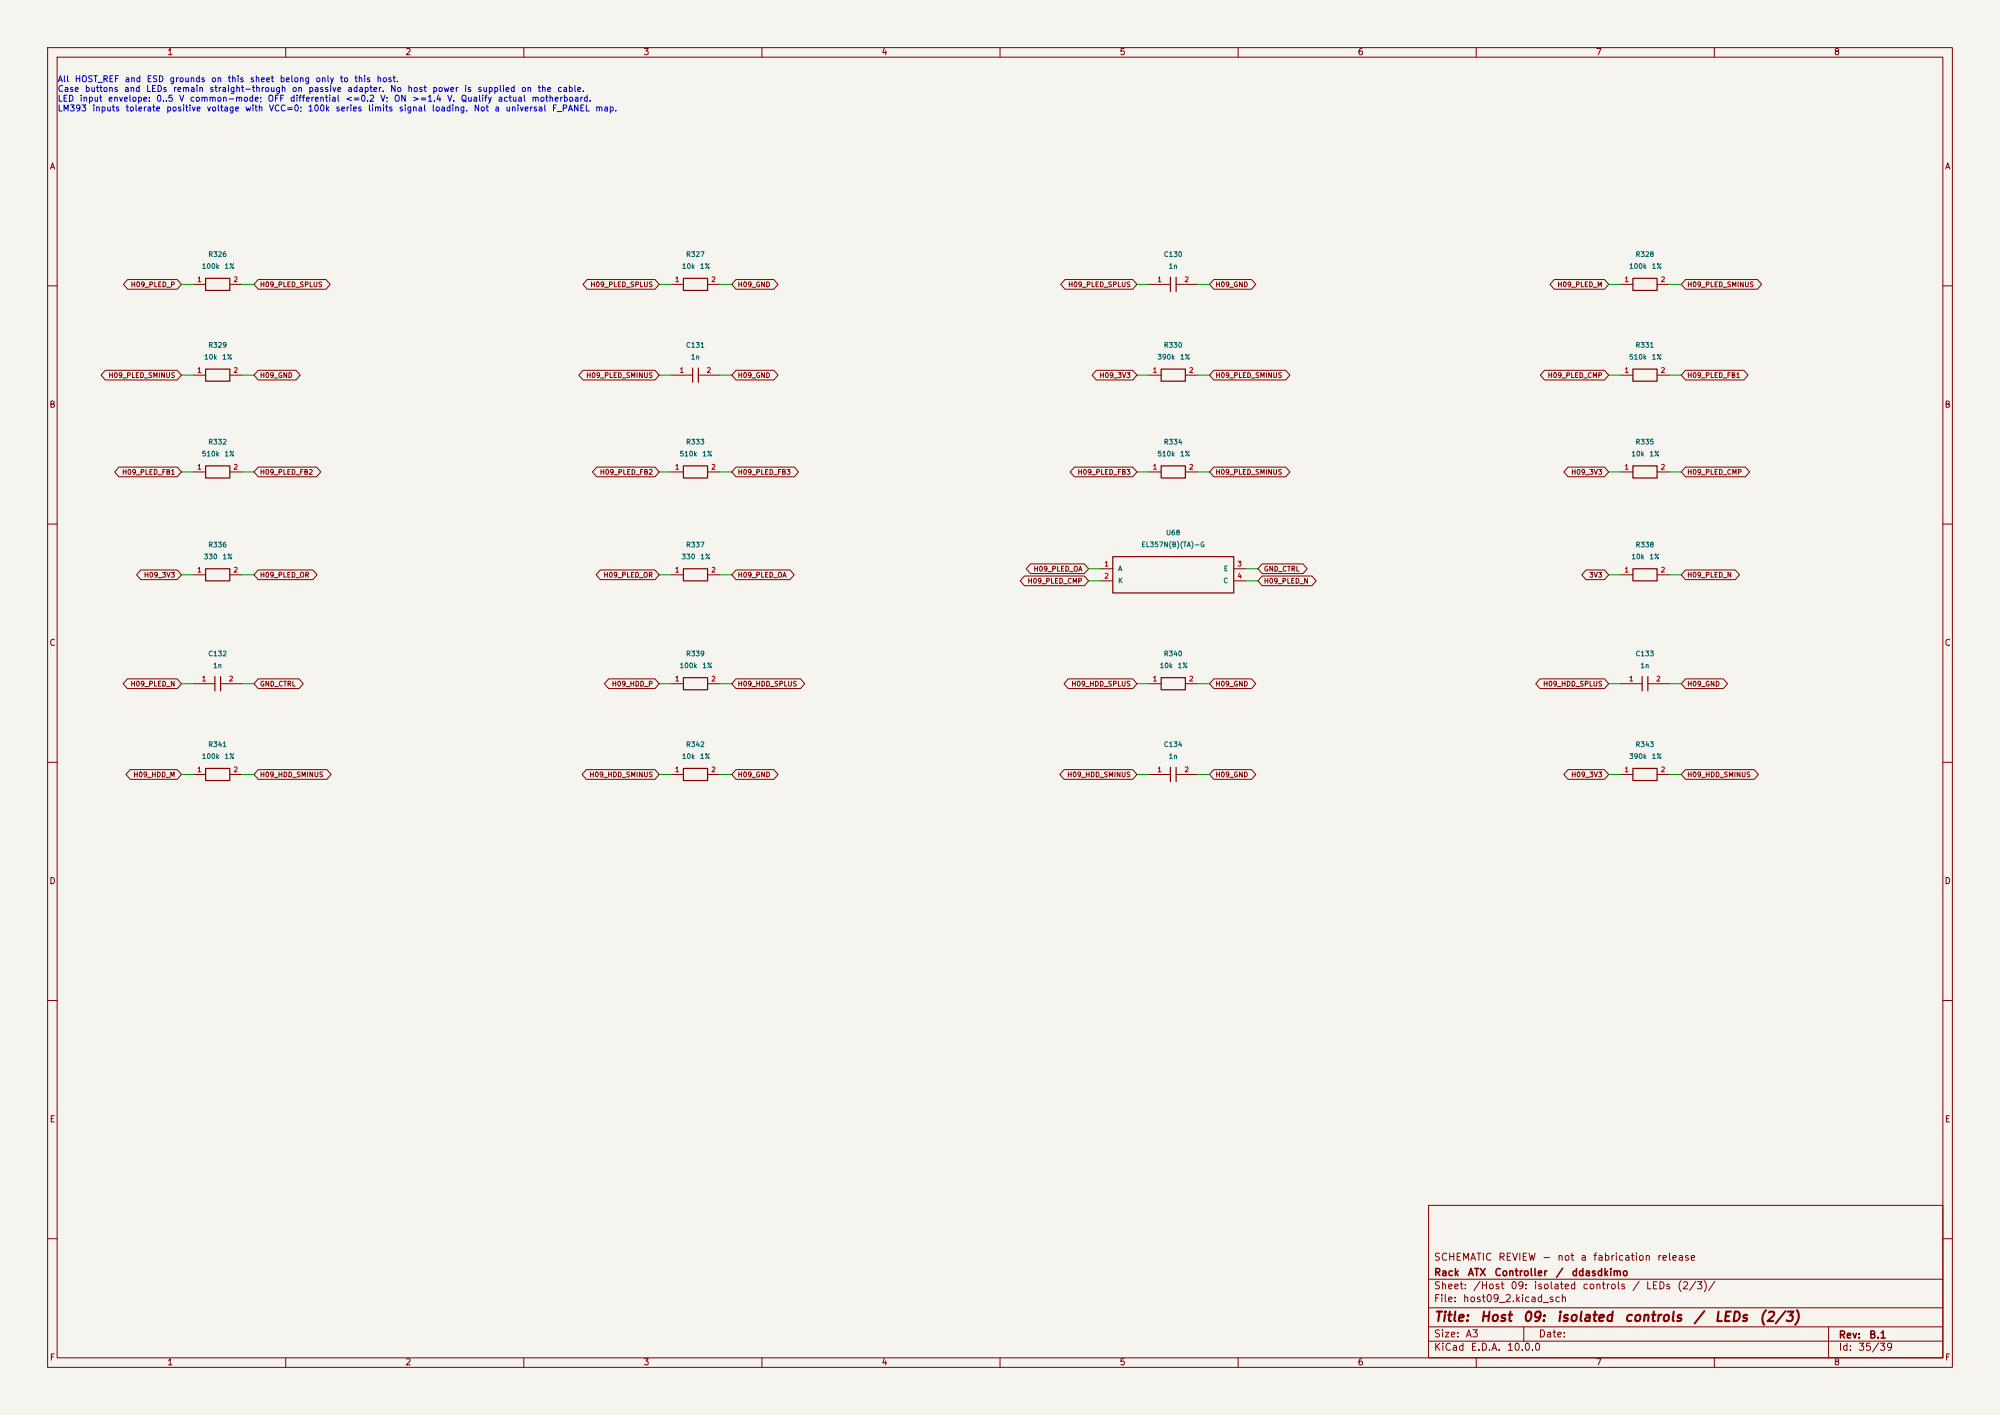
[picture p70: page 35]

Rack ATX Controller / ddasdkimo SCHEMATIC REVIEW - not a fabrication release

Sheet: /Host 09: isolated controls / LEDs (2/3)/
File: host09_2.kicad_sch
Title: Host 09: isolated controls / LEDs (2/3)

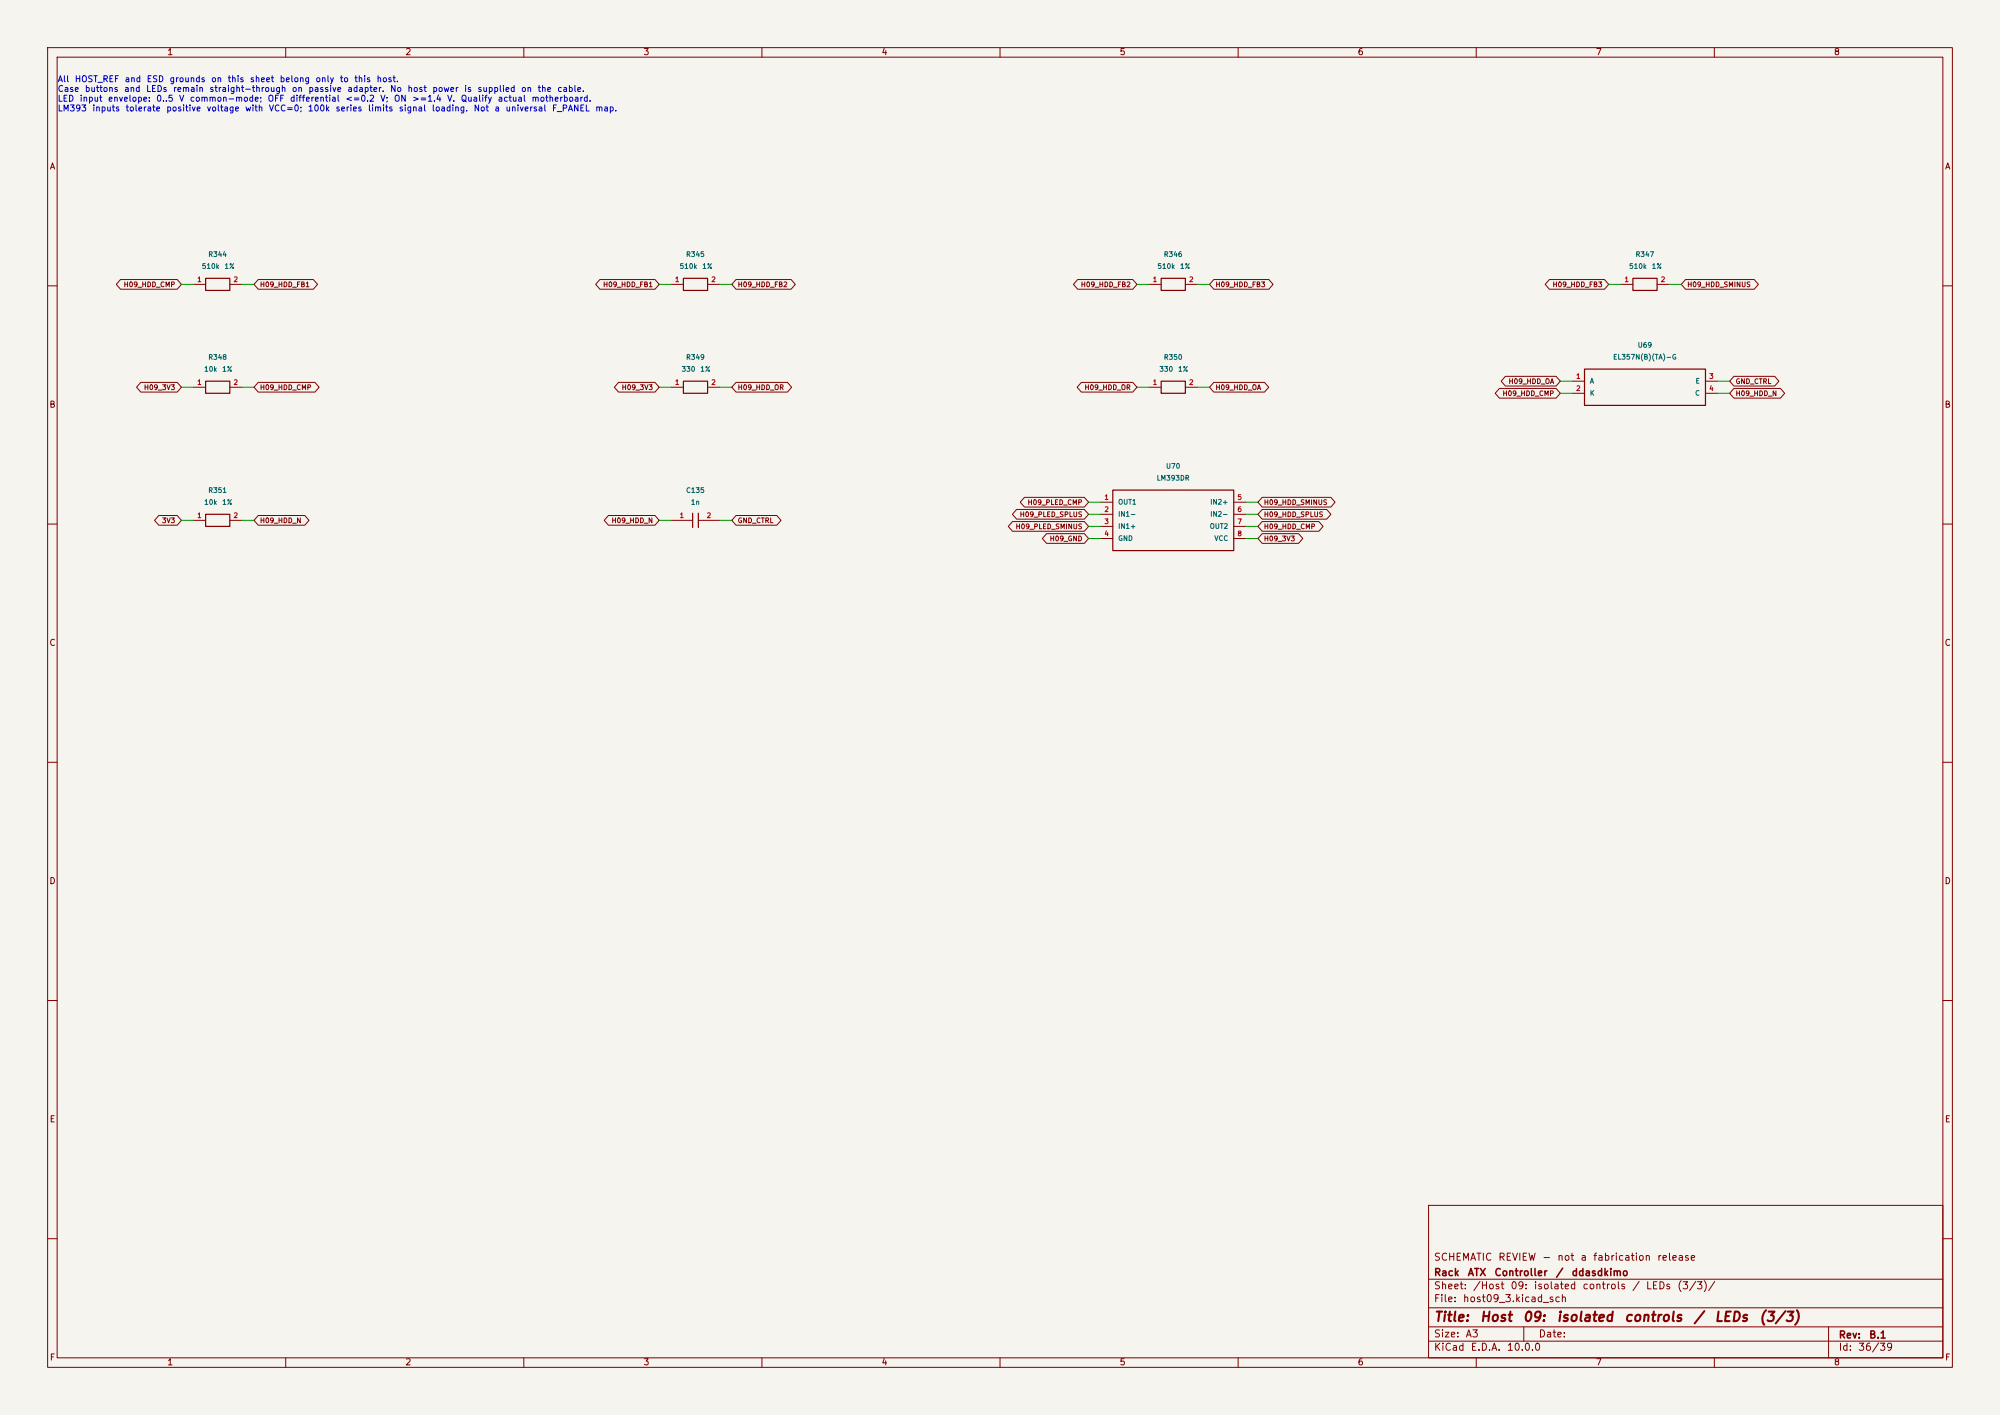
[picture p71: page 36]

Rack ATX Controller / ddasdkimo SCHEMATIC REVIEW - not a fabrication release

Sheet: /Host 09: isolated controls / LEDs (3/3)/
File: host09_3.kicad_sch
Title: Host 09: isolated controls / LEDs (3/3)

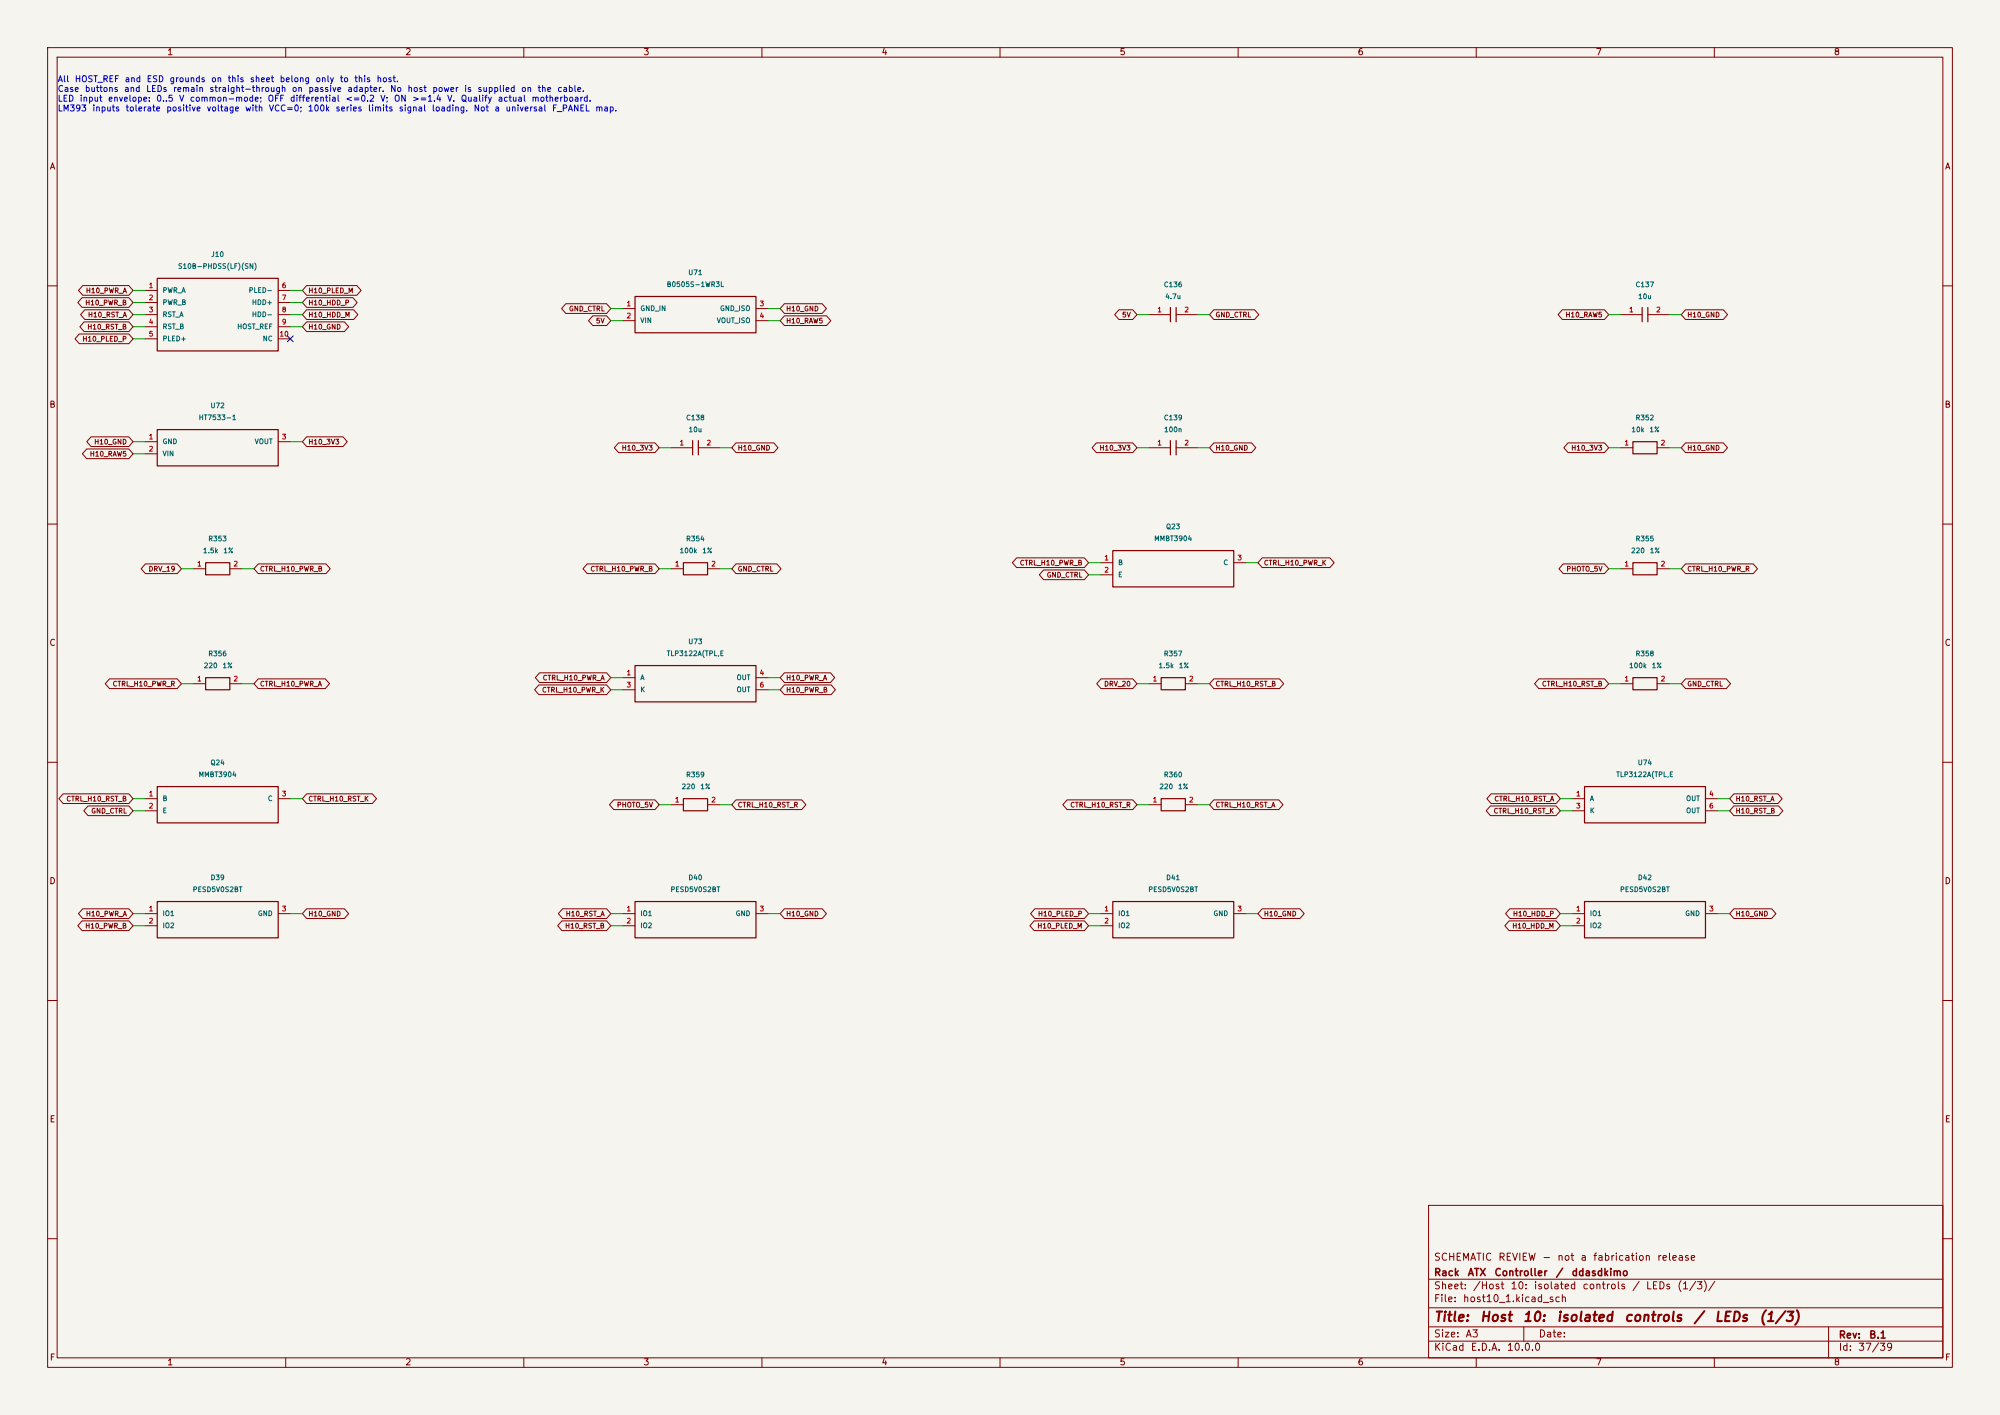
[picture p72: page 37]

Rack ATX Controller / ddasdkimo SCHEMATIC REVIEW - not a fabrication release

Sheet: /Host 10: isolated controls / LEDs (1/3)/
File: host10_1.kicad_sch
Title: Host 10: isolated controls / LEDs (1/3)

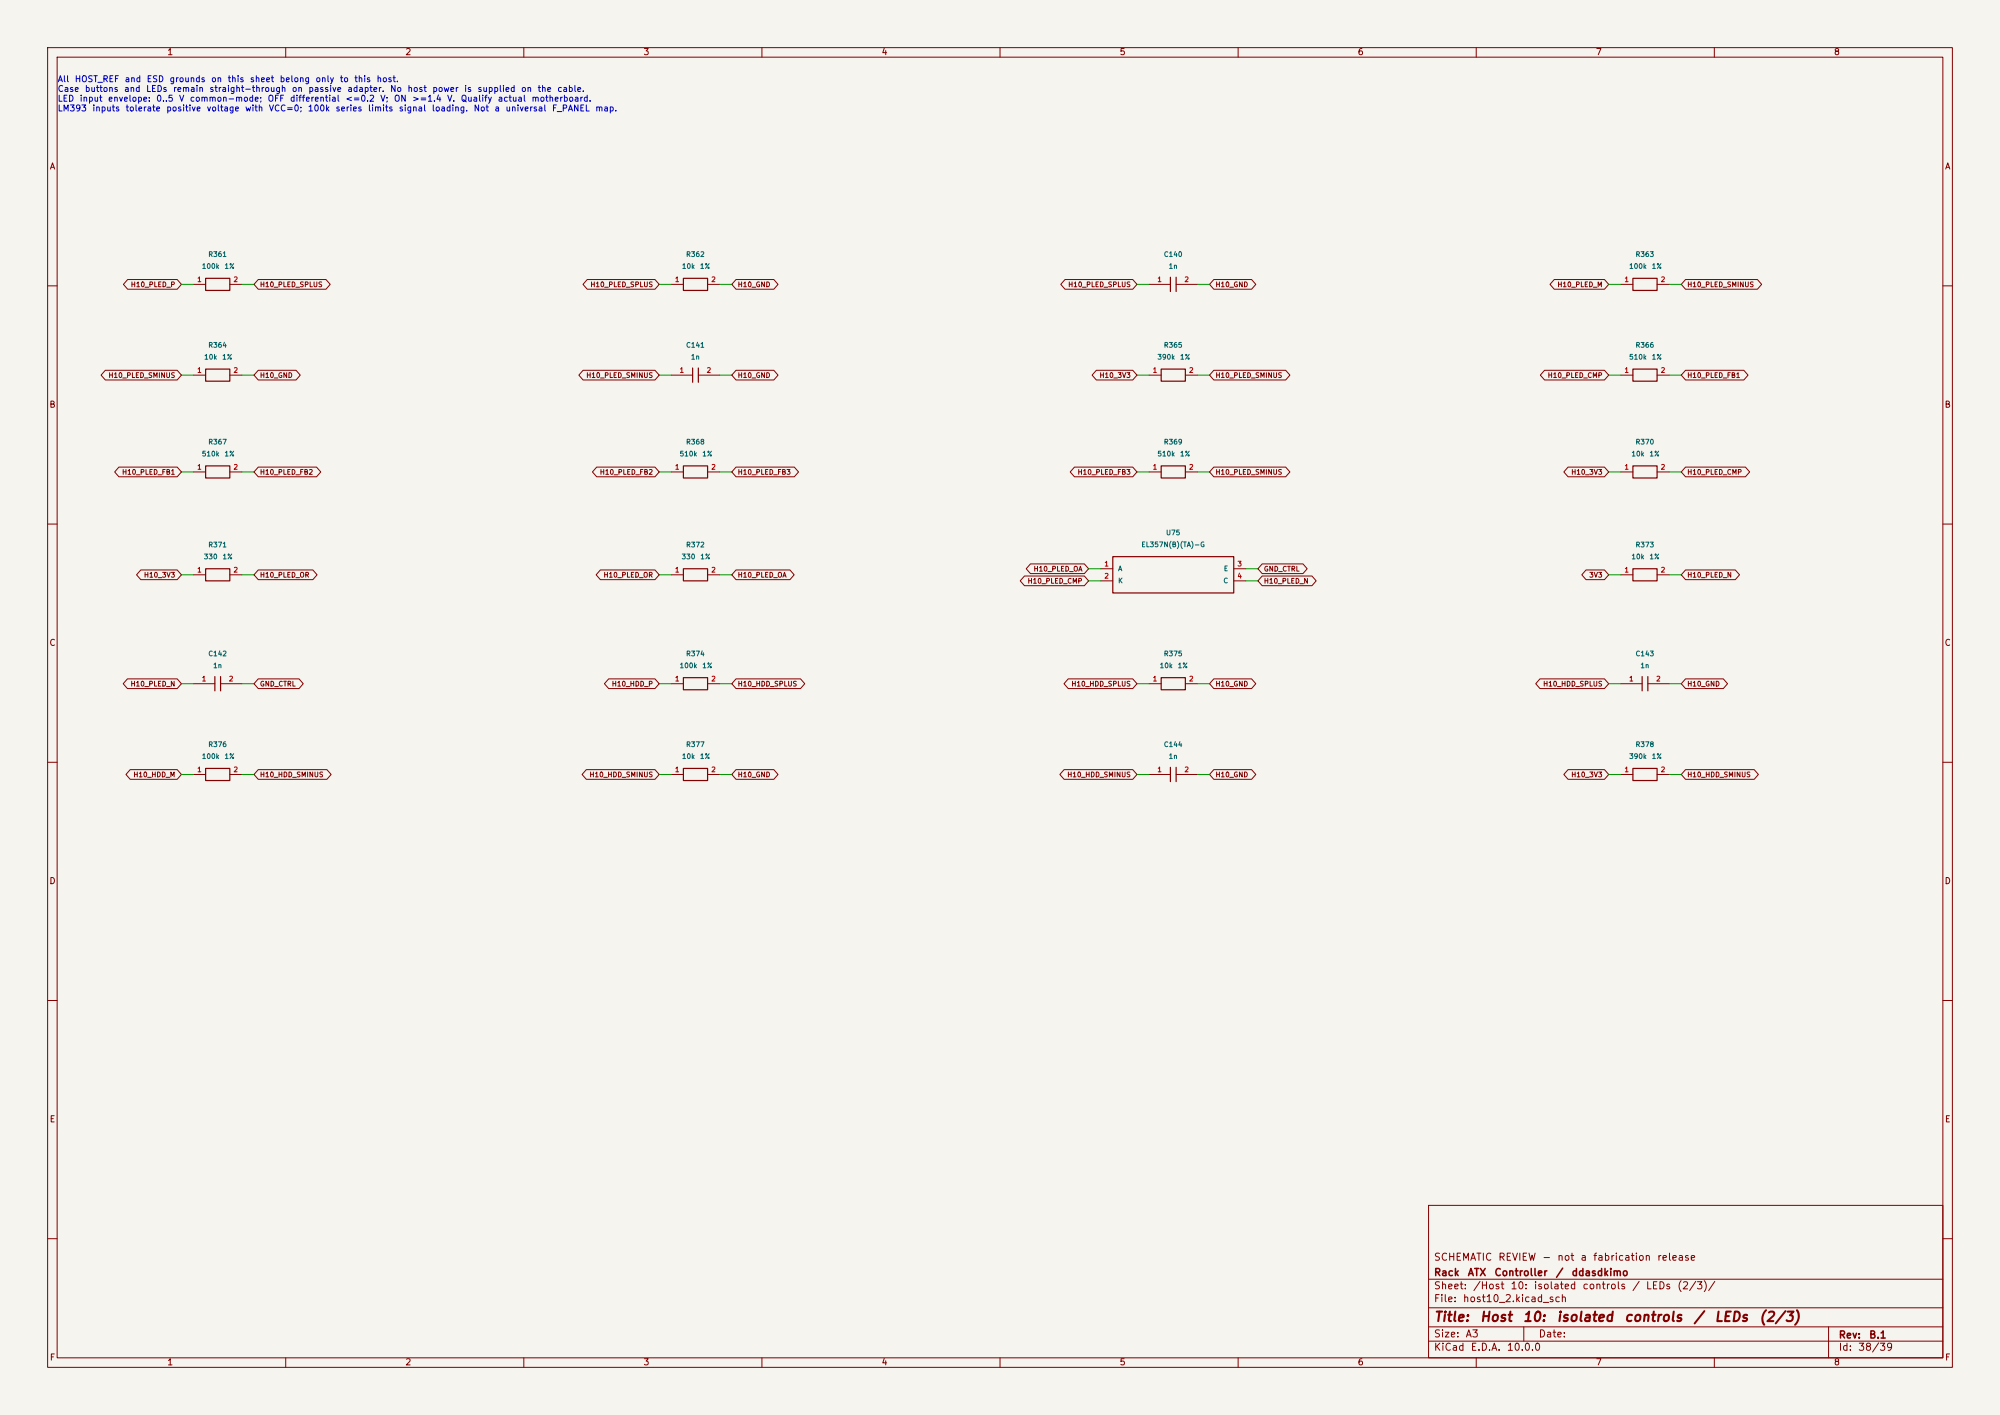
[picture p73: page 38]

Rack ATX Controller / ddasdkimo SCHEMATIC REVIEW - not a fabrication release

Sheet: /Host 10: isolated controls / LEDs (2/3)/
File: host10_2.kicad_sch
Title: Host 10: isolated controls / LEDs (2/3)

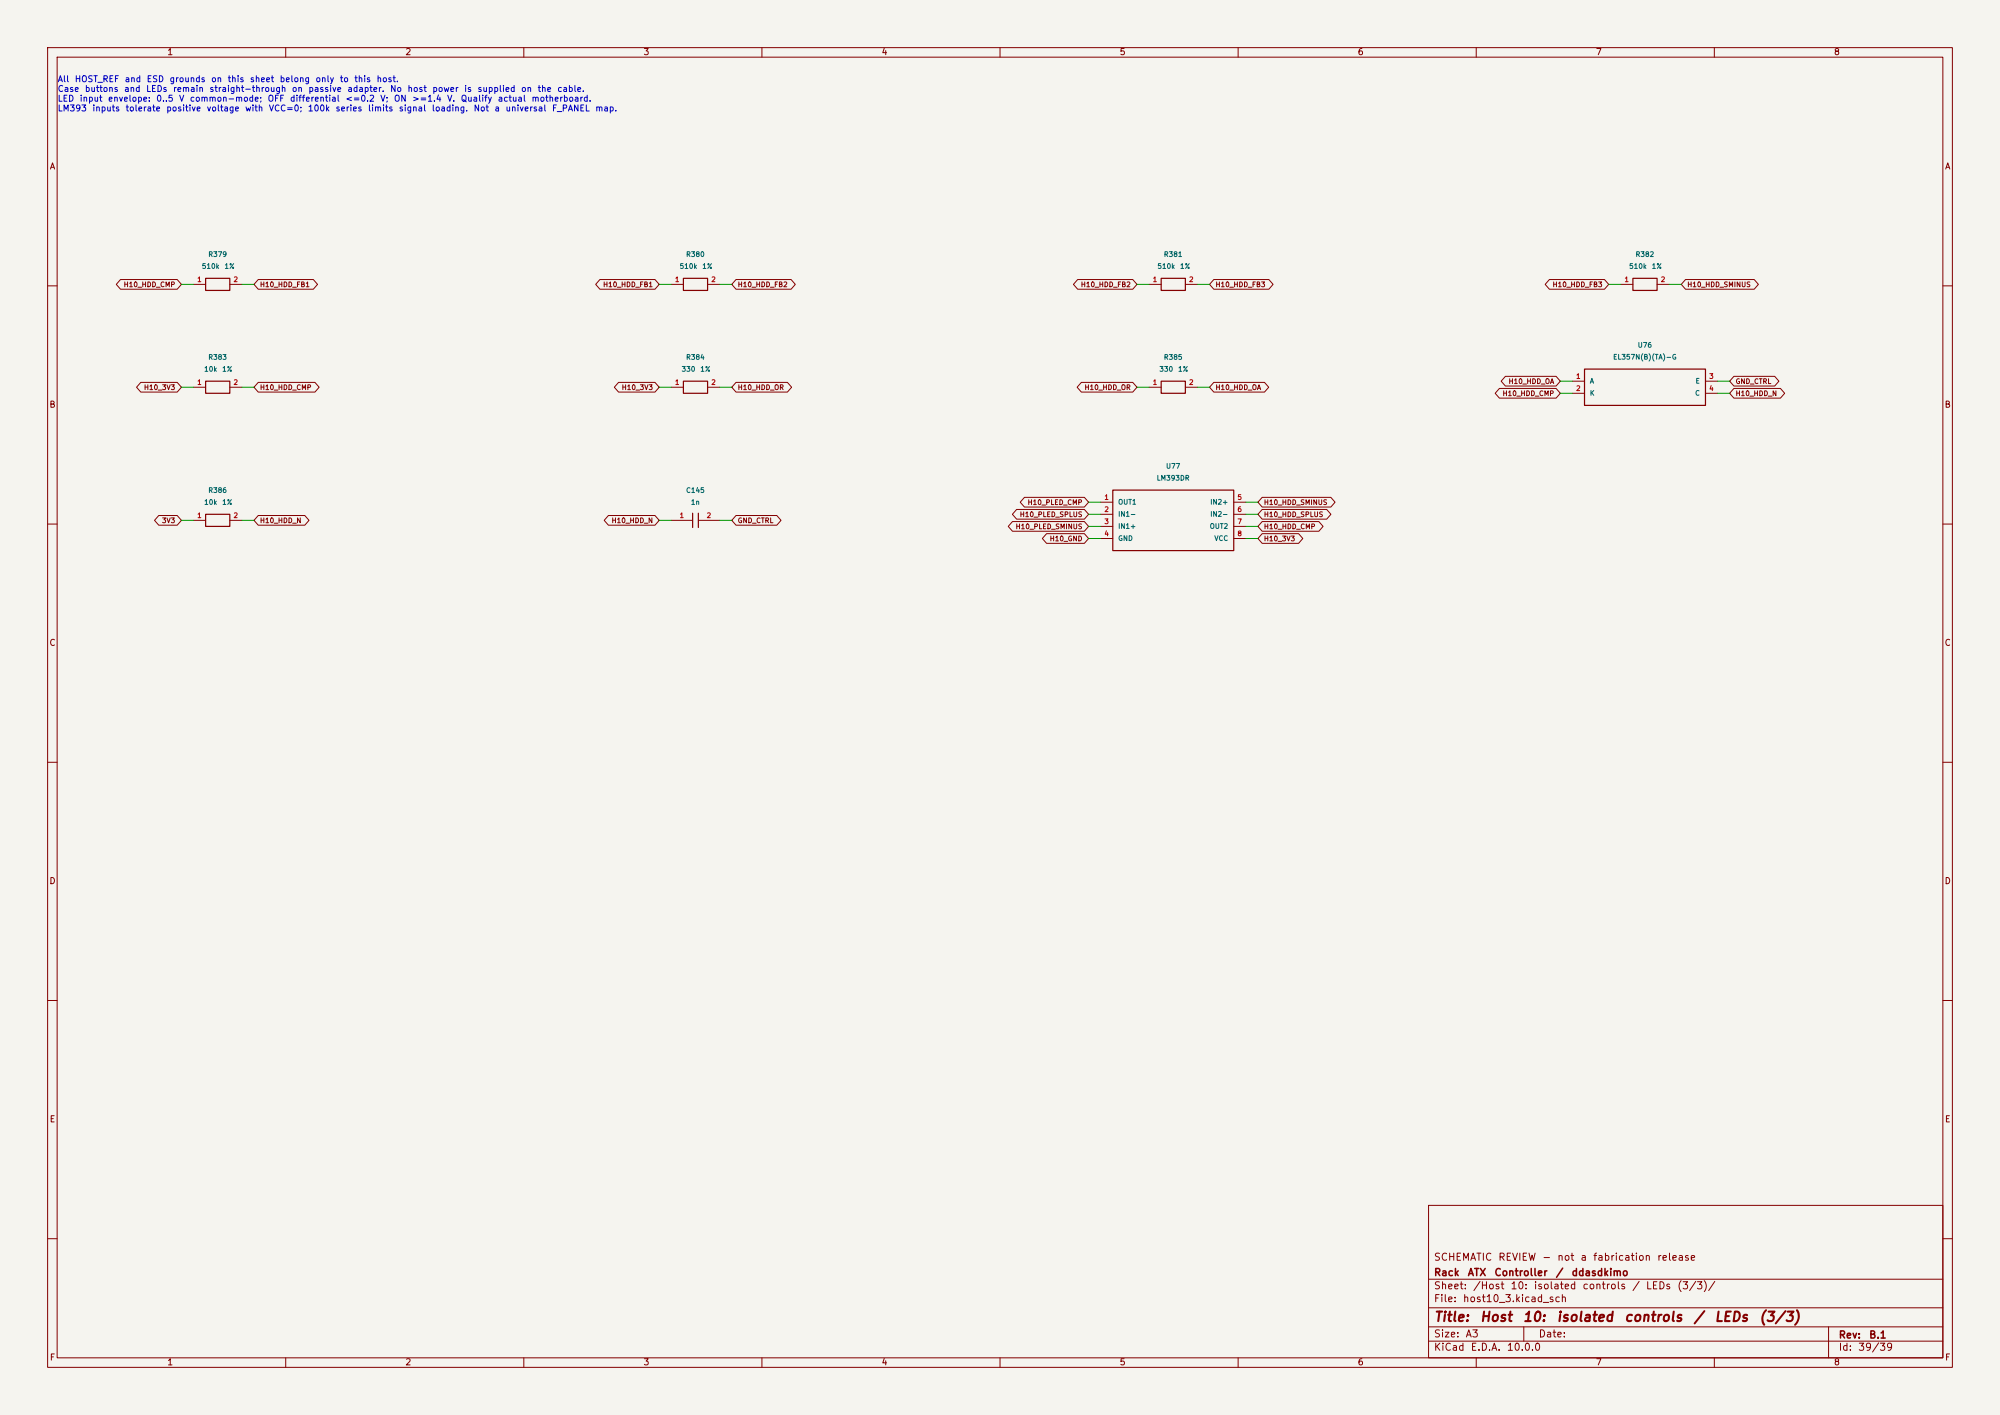
[picture p74: page 39]

Rack ATX Controller / ddasdkimo SCHEMATIC REVIEW - not a fabrication release

Sheet: /Host 10: isolated controls / LEDs (3/3)/
File: host10_3.kicad_sch
Title: Host 10: isolated controls / LEDs (3/3)
