ddasdkimo/rack-atx-controller/(list of files, drawings)

Other design files:
hardware/research/pcb-comparison-2026-10-14.json
hardware/research/pcb-price-2026-10-14.json
