ddasdkimo/rack-atx-controller/hardware/cad/B2/rack-atx-controller.kicad_pcb

## KiCad design hardware/cad/B2/rack-atx-controller.kicad_pcb (2026-10-14)

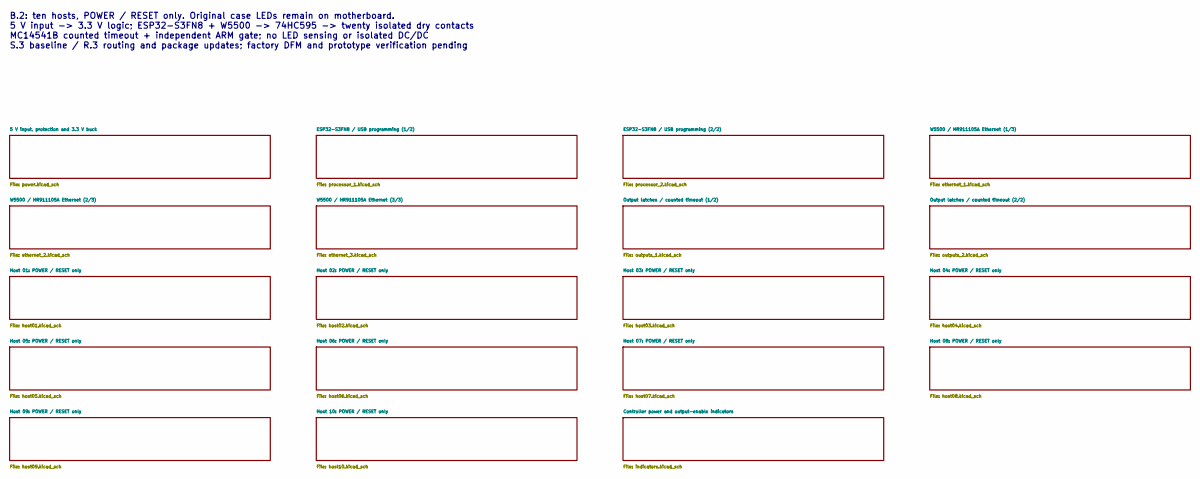
[picture p75: schematic rack-atx-controller.kicad_sch, 10-host rack ATX controller]

Notes on the sheet:
B.2: ten hosts, POWER / RESET only. Original case LEDs remain on motherboard. 5 V input -> 3.3 V logic; ESP32-S3FN8 + W5500 -> 74HC595 -> twenty isolated dry contacts MC14541B counted timeout + independent ARM gate; no LED sensing or isolated DC/DC S.3 baseline / R.3 routing and package updates; fa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

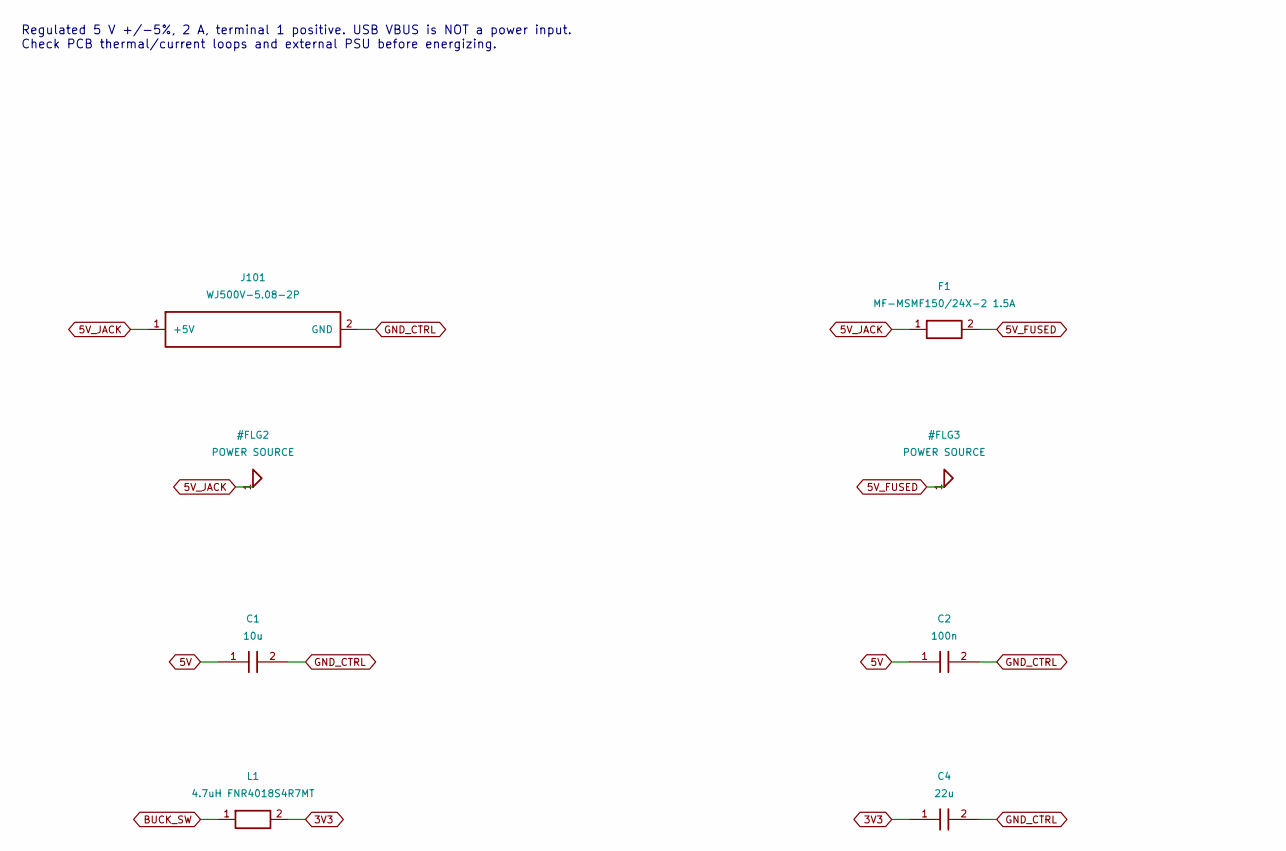
[picture p76: schematic power.kicad_sch, 5 V input, protection and 3.3 V buck, part in row 1, column 1]

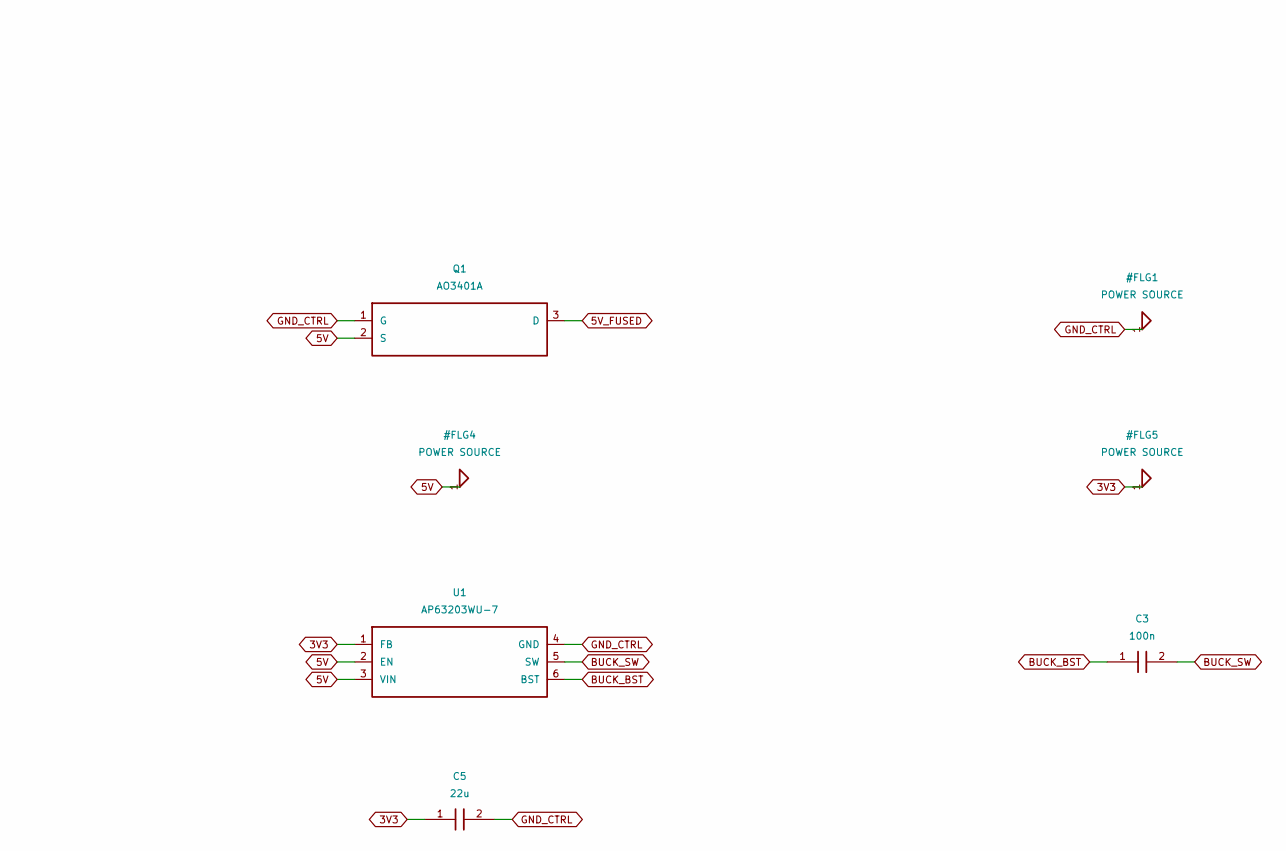
[picture p77: schematic power.kicad_sch, 5 V input, protection and 3.3 V buck, part in row 1, column 2]

Parts:
C1: 10u; C_0805_2012Metric; MPN CL21A106KAYNNNE; LCSC C15850
C2, C3: 100n; C_0603_1608Metric; MPN CC0603KRX7R9BB104; LCSC C14663
C4, C5: 22u; C_0805_2012Metric; MPN CL21A226MAQNNNE; LCSC C45783
F1: MF-MSMF150/24X-2 1.5A; Fuse_1812_4532Metric; MPN MF-MSMF150/24X-2; LCSC C78695
J101: WJ500V-5.08-2P; WJ500V_5.08_2P; MPN WJ500V-5.08-2P; LCSC C8465
L1: 4.7uH FNR4018S4R7MT; L_Changjiang_FNR4018S; MPN FNR4018S4R7MT; LCSC C167806
Q1: AO3401A; SOT-23; MPN AO3401A; LCSC C15127
U1: AP63203WU-7; TSOT-23-6; MPN AP63203WU-7; LCSC C780769

Connections:
3V3: C4.1, C5.1, L1.2, U1.1 (FB); also elsewhere on the board
5V: C1.1, C2.1, Q1.2 (S), U1.2 (EN), U1.3 (VIN); also elsewhere on the board
5V_FUSED: F1.2, Q1.3 (D)
5V_JACK: F1.1, J101.1 (+5V)
BUCK_BST: C3.1, U1.6 (BST)
BUCK_SW: C3.2, L1.1, U1.5 (SW)
GND_CTRL: C1.2, C2.2, C4.2, C5.2, J101.2 (GND), Q1.1 (G), U1.4 (GND); also elsewhere on the board

Notes on the sheet:
Regulated 5 V +/-5%, 2 A, terminal 1 positive. USB VBUS is NOT a power input. Check PCB thermal/current loops and external PSU before energizing.

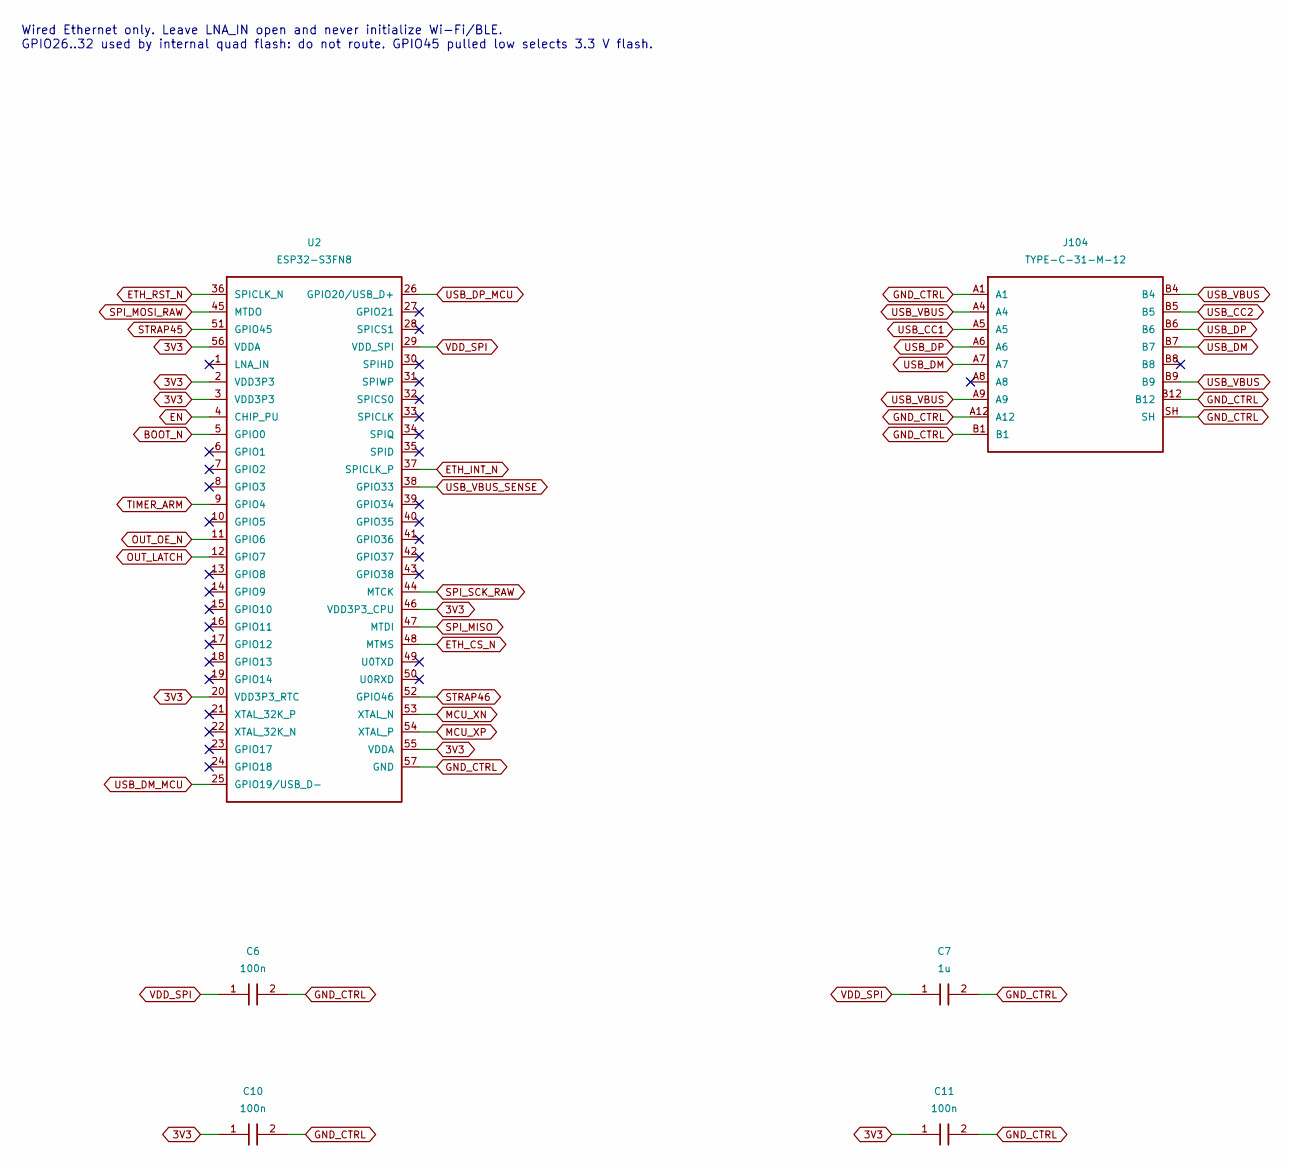
[picture p78: schematic processor_1.kicad_sch, ESP32-S3FN8 / USB programming (1/2), part in row 1, column 1]

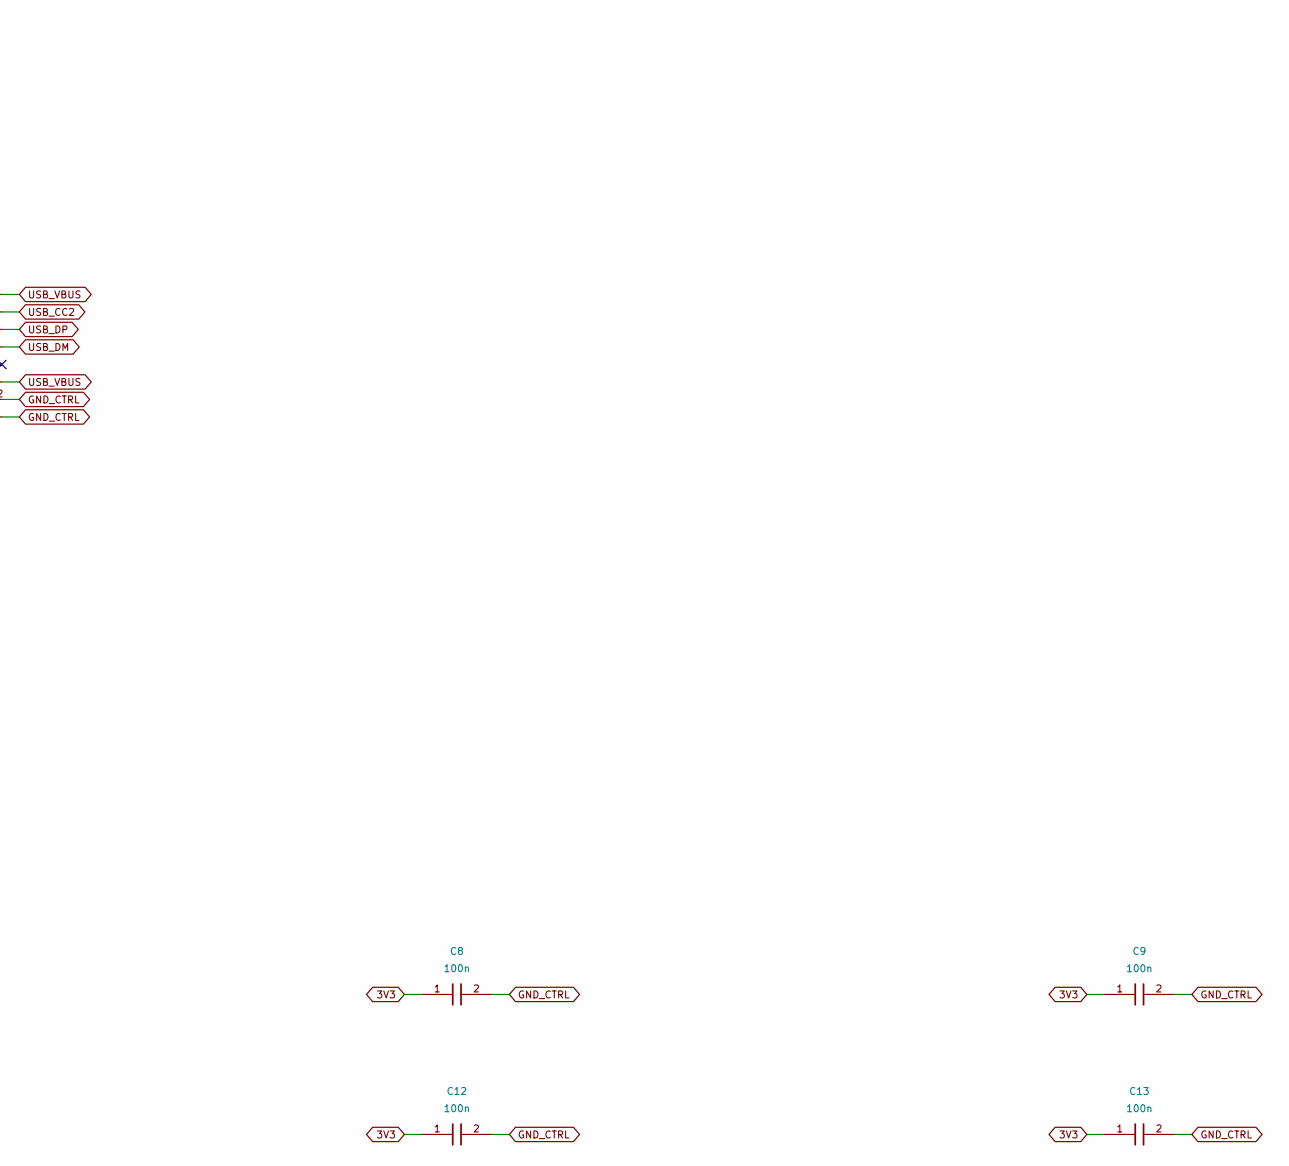
[picture p79: schematic processor_1.kicad_sch, ESP32-S3FN8 / USB programming (1/2), part in row 1, column 2]

Parts:
C6, C8, C9, C10, C11, C12, C13: 100n; C_0603_1608Metric; MPN CC0603KRX7R9BB104; LCSC C14663
C7: 1u; C_0603_1608Metric; MPN CL10A105KB8NNNC; LCSC C15849
J104: TYPE-C-31-M-12; USB_C_Receptacle_HRO_TYPE-C-31-M-12; MPN TYPE-C-31-M-12; LCSC C165948
U2: ESP32-S3FN8; ESP32_S3_QFN56_EP4_16Window; MPN ESP32-S3FN8; LCSC C2913196

Connections:
3V3: C8.1, C9.1, C10.1, C11.1, C12.1, C13.1, U2.2 (VDD3P3), U2.3 (VDD3P3), U2.20 (VDD3P3_RTC), U2.46 (VDD3P3_CPU), U2.55 (VDDA), U2.56 (VDDA); also elsewhere on the board
BOOT_N: U2.5 (GPIO0); also elsewhere on the board
EN: U2.4 (CHIP_PU); also elsewhere on the board
ETH_CS_N: U2.48 (MTMS); also elsewhere on the board
ETH_INT_N: U2.37 (SPICLK_P); also elsewhere on the board
ETH_RST_N: U2.36 (SPICLK_N); also elsewhere on the board
GND_CTRL: C6.2, C7.2, C8.2, C9.2, C10.2, C11.2, C12.2, C13.2, J104.A1, J104.A12, J104.B1, J104.B12, J104.SH, U2.57 (GND); also elsewhere on the board
MCU_XN: U2.53 (XTAL_N); also elsewhere on the board
MCU_XP: U2.54 (XTAL_P); also elsewhere on the board
OUT_LATCH: U2.12 (GPIO7); also elsewhere on the board
OUT_OE_N: U2.11 (GPIO6); also elsewhere on the board
SPI_MISO: U2.47 (MTDI); also elsewhere on the board
SPI_MOSI_RAW: U2.45 (MTDO); also elsewhere on the board
SPI_SCK_RAW: U2.44 (MTCK); also elsewhere on the board
STRAP45: U2.51 (GPIO45); also elsewhere on the board
STRAP46: U2.52 (GPIO46); also elsewhere on the board
TIMER_ARM: U2.9 (GPIO4); also elsewhere on the board
USB_CC1: J104.A5; also elsewhere on the board
USB_CC2: J104.B5; also elsewhere on the board
USB_DM: J104.A7, J104.B7; also elsewhere on the board
USB_DM_MCU: U2.25 (GPIO19/USB_D-); also elsewhere on the board
USB_DP: J104.A6, J104.B6; also elsewhere on the board
USB_DP_MCU: U2.26 (GPIO20/USB_D+); also elsewhere on the board
USB_VBUS: J104.A4, J104.A9, J104.B4, J104.B9; also elsewhere on the board
USB_VBUS_SENSE: U2.38 (GPIO33); also elsewhere on the board
VDD_SPI: C6.1, C7.1, U2.29 (VDD_SPI)

Notes on the sheet:
Wired Ethernet only. Leave LNA_IN open and never initialize Wi-Fi/BLE. GPIO26..32 used by internal quad flash: do not route. GPIO45 pulled low selects 3.3 V flash.

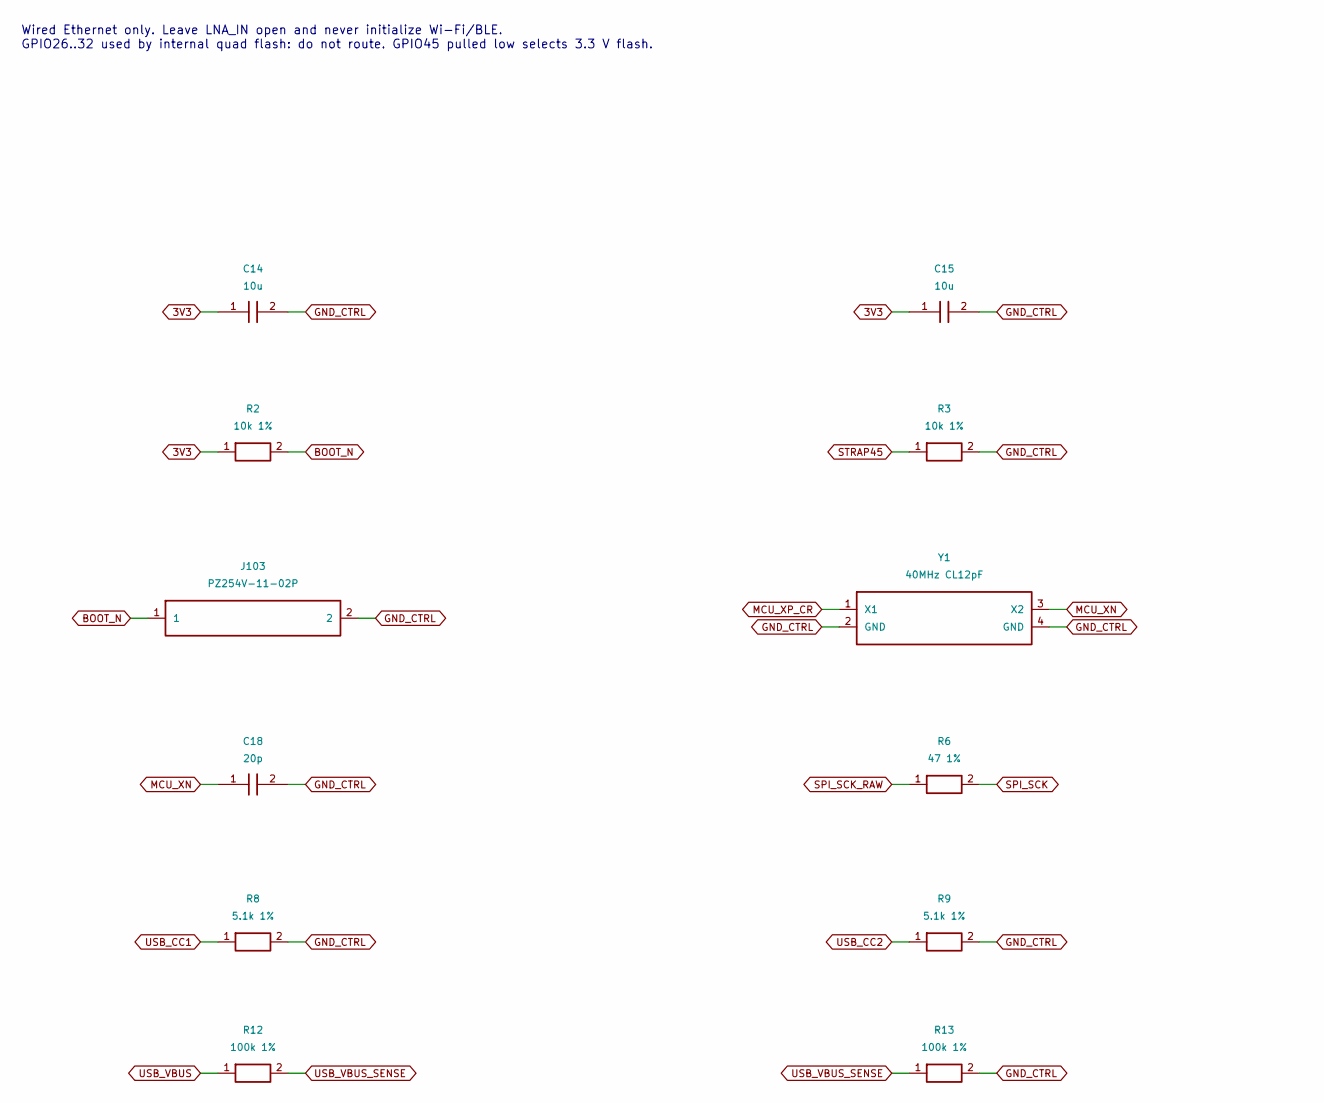
[picture p80: schematic processor_2.kicad_sch, ESP32-S3FN8 / USB programming (2/2), part in row 1, column 1]

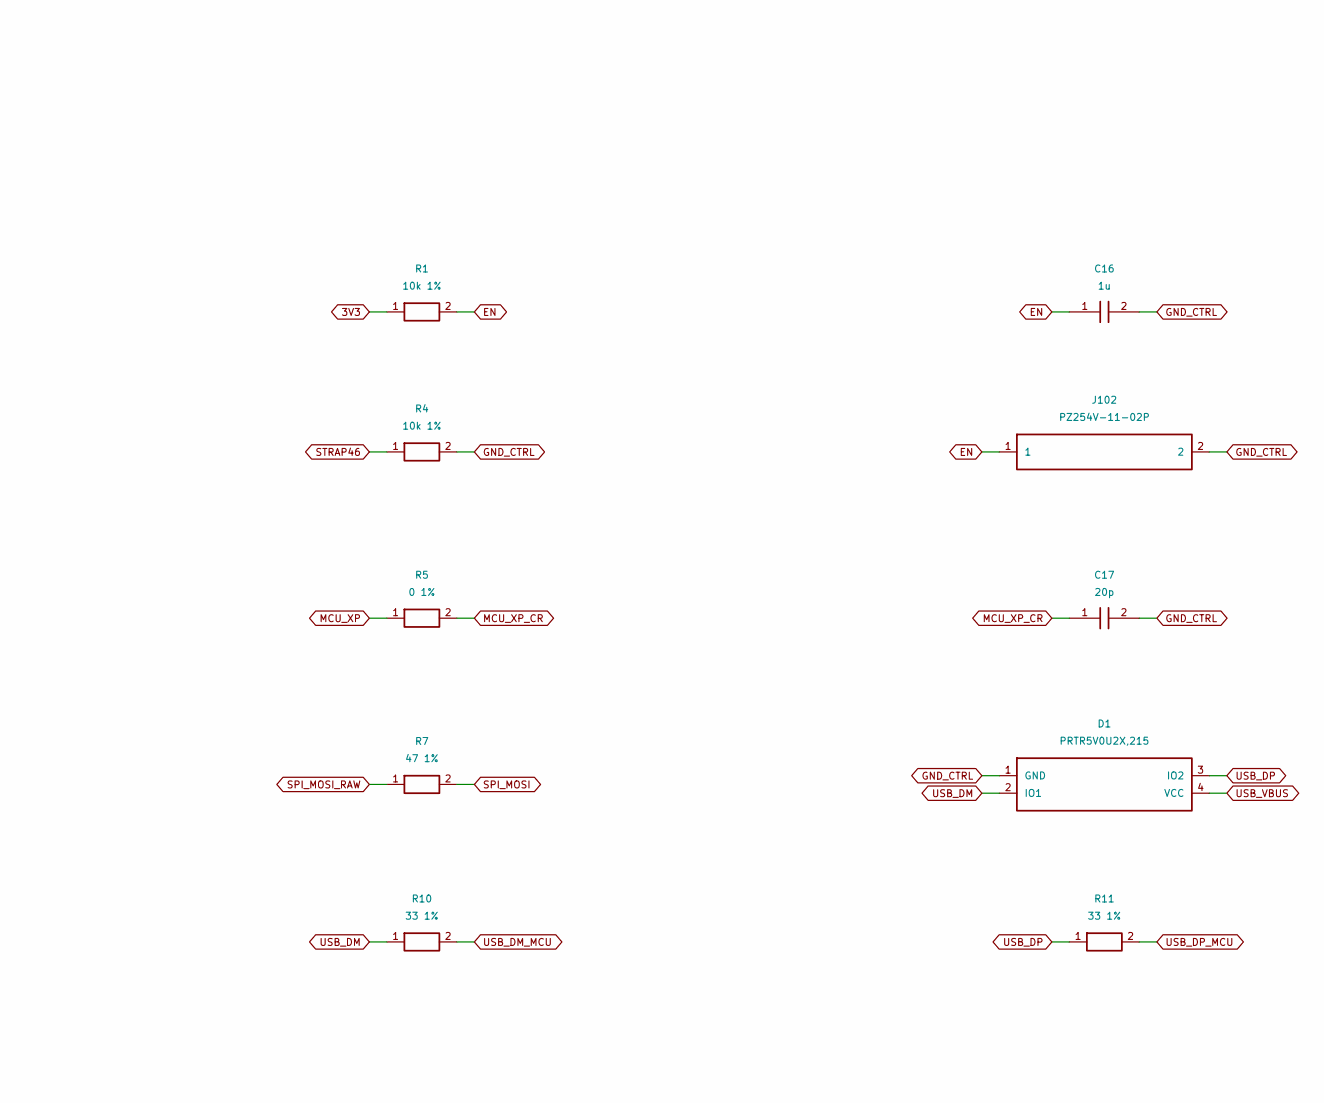
[picture p81: schematic processor_2.kicad_sch, ESP32-S3FN8 / USB programming (2/2), part in row 1, column 2]

Parts:
C14, C15: 10u; C_0805_2012Metric; MPN CL21A106KAYNNNE; LCSC C15850
C16: 1u; C_0603_1608Metric; MPN CL10A105KB8NNNC; LCSC C15849
C17, C18: 20p; C_0603_1608Metric; MPN CL10C200JB8NNNC; LCSC C1648
D1: PRTR5V0U2X,215; SOT-143; MPN PRTR5V0U2X,215; LCSC C12333
J102, J103: PZ254V-11-02P; PinHeader_1x02_P2.54mm_Vertical; MPN PZ254V-11-02P; LCSC C492401
R1, R2, R3, R4: 10k 1%; R_0603_1608Metric; MPN 0603WAF1002T5E; LCSC C25804
R5: 0 1%; R_0603_1608Metric; MPN 0603WAF0000T5E; LCSC C21189
R6, R7: 47 1%; R_0603_1608Metric; MPN 0603WAF470JT5E; LCSC C23182
R8, R9: 5.1k 1%; R_0603_1608Metric; MPN 0603WAF5101T5E; LCSC C23186
R10, R11: 33 1%; R_0603_1608Metric; MPN 0603WAF330JT5E; LCSC C23140
R12, R13: 100k 1%; R_0603_1608Metric; MPN 0603WAF1003T5E; LCSC C25803
Y1: 40MHz CL12pF; Crystal_SMD_3225-4Pin_3.2x2.5mm; MPN XL2EL89COI-111YLC-40M; LCSC C18214314

Connections:
3V3: C14.1, C15.1, R1.1, R2.1; also elsewhere on the board
BOOT_N: J103.1, R2.2; also elsewhere on the board
EN: C16.1, J102.1, R1.2; also elsewhere on the board
GND_CTRL: C14.2, C15.2, C16.2, C17.2, C18.2, D1.1 (GND), J102.2, J103.2, R3.2, R4.2, R8.2, R9.2, R13.2, Y1.2 (GND), Y1.4 (GND); also elsewhere on the board
MCU_XN: C18.1, Y1.3 (X2); also elsewhere on the board
MCU_XP: R5.1; also elsewhere on the board
MCU_XP_CR: C17.1, R5.2, Y1.1 (X1)
SPI_MOSI: R7.2; also elsewhere on the board
SPI_MOSI_RAW: R7.1; also elsewhere on the board
SPI_SCK: R6.2; also elsewhere on the board
SPI_SCK_RAW: R6.1; also elsewhere on the board
STRAP45: R3.1; also elsewhere on the board
STRAP46: R4.1; also elsewhere on the board
USB_CC1: R8.1; also elsewhere on the board
USB_CC2: R9.1; also elsewhere on the board
USB_DM: D1.2 (IO1), R10.1; also elsewhere on the board
USB_DM_MCU: R10.2; also elsewhere on the board
USB_DP: D1.3 (IO2), R11.1; also elsewhere on the board
USB_DP_MCU: R11.2; also elsewhere on the board
USB_VBUS: D1.4 (VCC), R12.1; also elsewhere on the board
USB_VBUS_SENSE: R12.2, R13.1; also elsewhere on the board

Notes on the sheet:
Wired Ethernet only. Leave LNA_IN open and never initialize Wi-Fi/BLE. GPIO26..32 used by internal quad flash: do not route. GPIO45 pulled low selects 3.3 V flash.

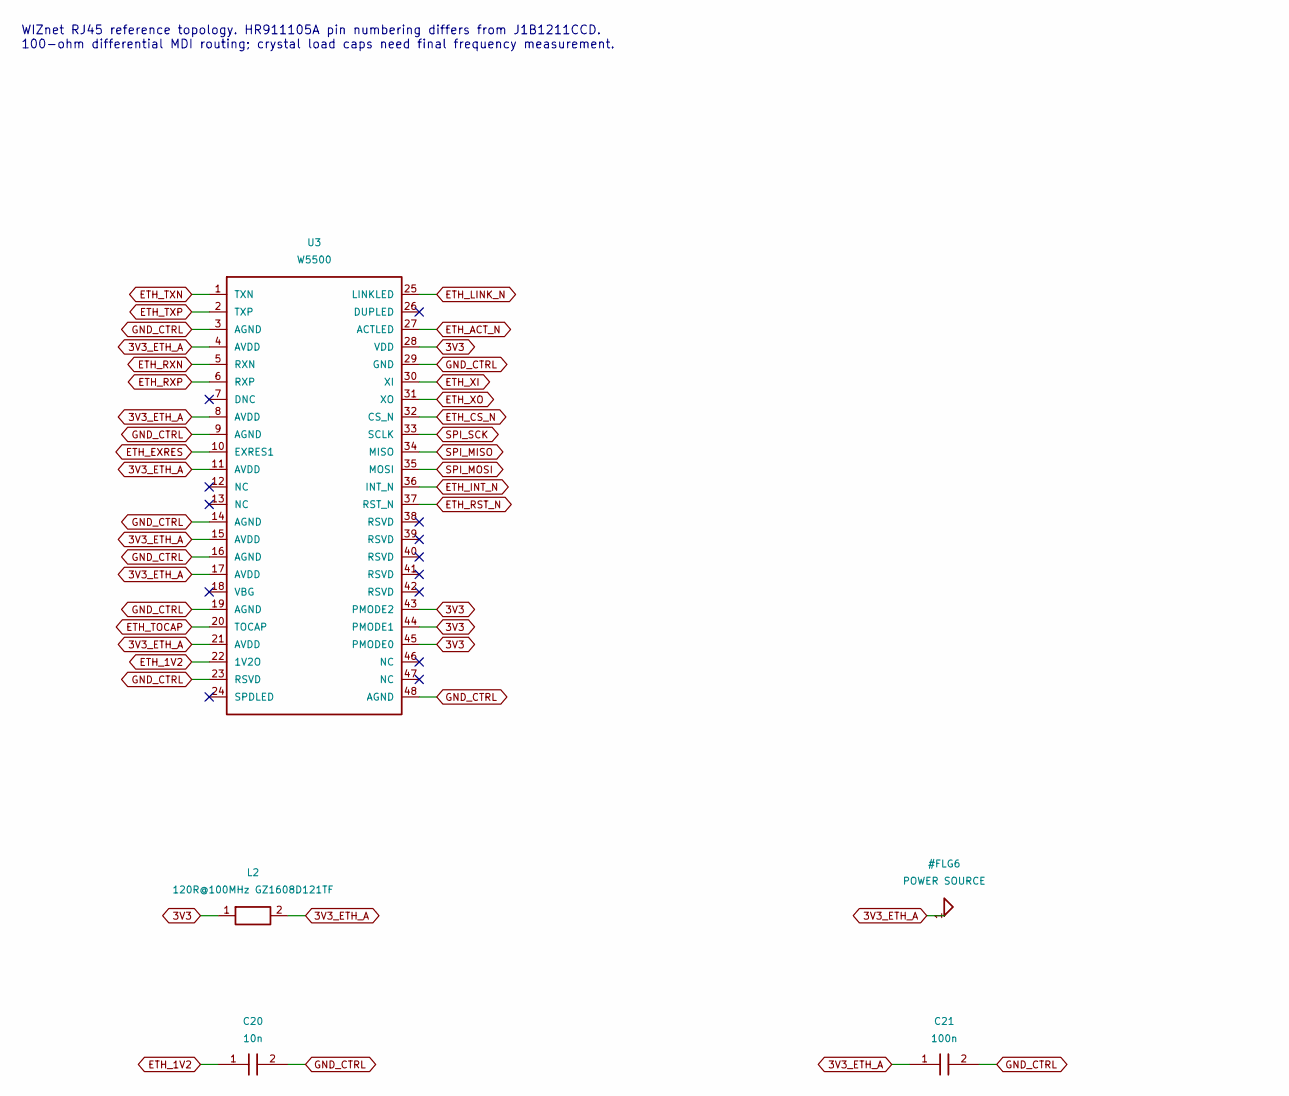
[picture p82: schematic ethernet_1.kicad_sch, W5500 / HR911105A Ethernet (1/3), part in row 1, column 1]

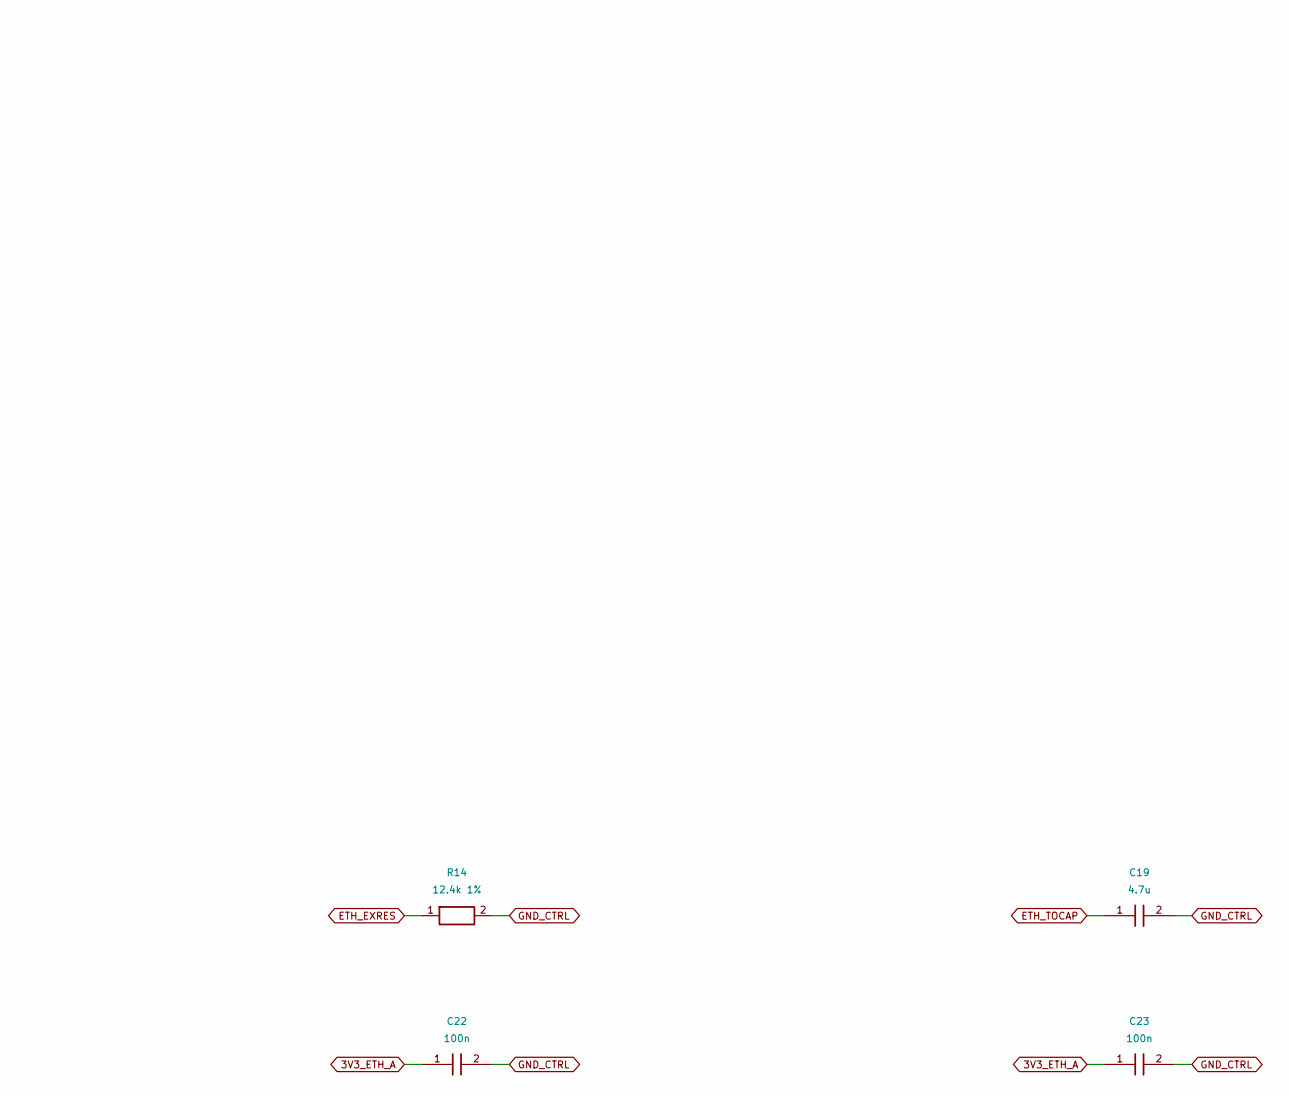
[picture p83: schematic ethernet_1.kicad_sch, W5500 / HR911105A Ethernet (1/3), part in row 1, column 2]

Parts:
C19: 4.7u; C_0603_1608Metric; MPN CL10A475KO8NNNC; LCSC C19666
C20: 10n; C_0603_1608Metric; MPN 0603B103K500NT; LCSC C57112
C21, C22, C23: 100n; C_0402_1005Metric; MPN CL05B104KO5NNNC; LCSC C1525
L2: 120R@100MHz GZ1608D121TF; L_0603_1608Metric; MPN GZ1608D121TF; LCSC C12391
R14: 12.4k 1%; R_0603_1608Metric; MPN 0603WAF1242T5E; LCSC C22865
U3: W5500; LQFP-48_7x7mm_P0.5mm; MPN W5500; LCSC C32843

Connections:
3V3: L2.1, U3.28 (VDD), U3.43 (PMODE2), U3.44 (PMODE1), U3.45 (PMODE0); also elsewhere on the board
3V3_ETH_A: C21.1, C22.1, C23.1, L2.2, U3.4 (AVDD), U3.8 (AVDD), U3.11 (AVDD), U3.15 (AVDD), U3.17 (AVDD), U3.21 (AVDD); also elsewhere on the board
ETH_1V2: C20.1, U3.22 (1V2O)
ETH_ACT_N: U3.27 (ACTLED); also elsewhere on the board
ETH_CS_N: U3.32 (CS_N); also elsewhere on the board
ETH_EXRES: R14.1, U3.10 (EXRES1)
ETH_INT_N: U3.36 (INT_N); also elsewhere on the board
ETH_LINK_N: U3.25 (LINKLED); also elsewhere on the board
ETH_RST_N: U3.37 (RST_N); also elsewhere on the board
ETH_RXN: U3.5 (RXN); also elsewhere on the board
ETH_RXP: U3.6 (RXP); also elsewhere on the board
ETH_TOCAP: C19.1, U3.20 (TOCAP)
ETH_TXN: U3.1 (TXN); also elsewhere on the board
ETH_TXP: U3.2 (TXP); also elsewhere on the board
ETH_XI: U3.30 (XI); also elsewhere on the board
ETH_XO: U3.31 (XO); also elsewhere on the board
GND_CTRL: C19.2, C20.2, C21.2, C22.2, C23.2, R14.2, U3.3 (AGND), U3.9 (AGND), U3.14 (AGND), U3.16 (AGND), U3.19 (AGND), U3.23 (RSVD), U3.29 (GND), U3.48 (AGND); also elsewhere on the board
SPI_MISO: U3.34 (MISO); also elsewhere on the board
SPI_MOSI: U3.35 (MOSI); also elsewhere on the board
SPI_SCK: U3.33 (SCLK); also elsewhere on the board

Notes on the sheet:
WIZnet RJ45 reference topology. HR911105A pin numbering differs from J1B1211CCD. 100-ohm differential MDI routing; crystal load caps need final frequency measurement.

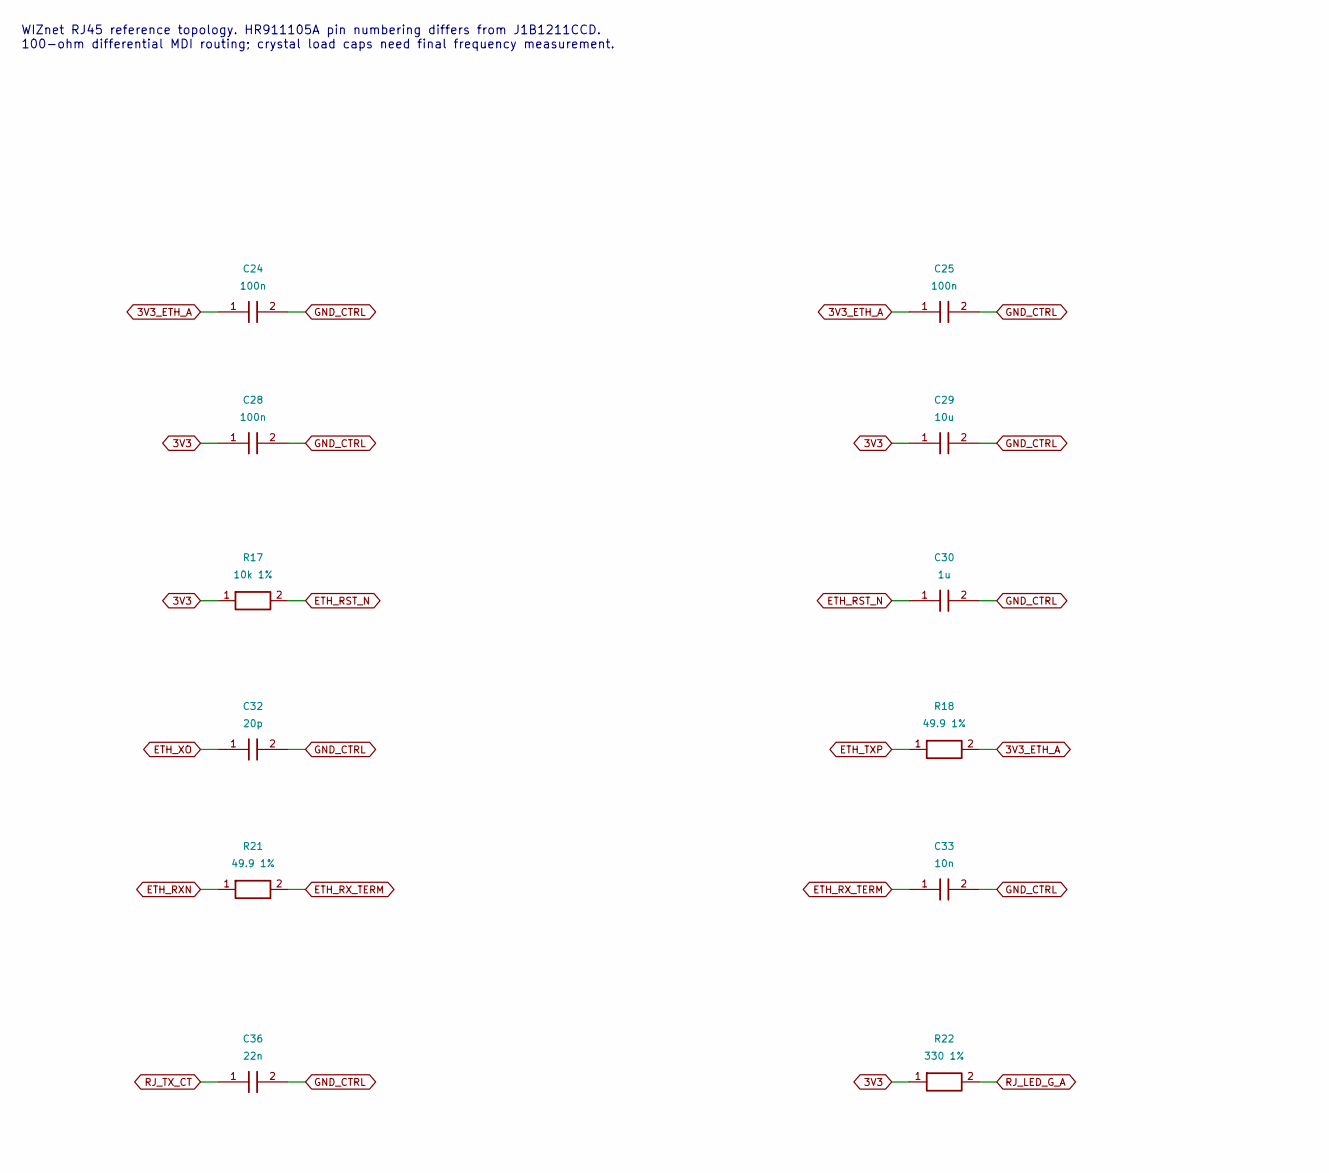
[picture p84: schematic ethernet_2.kicad_sch, W5500 / HR911105A Ethernet (2/3), part in row 1, column 1]

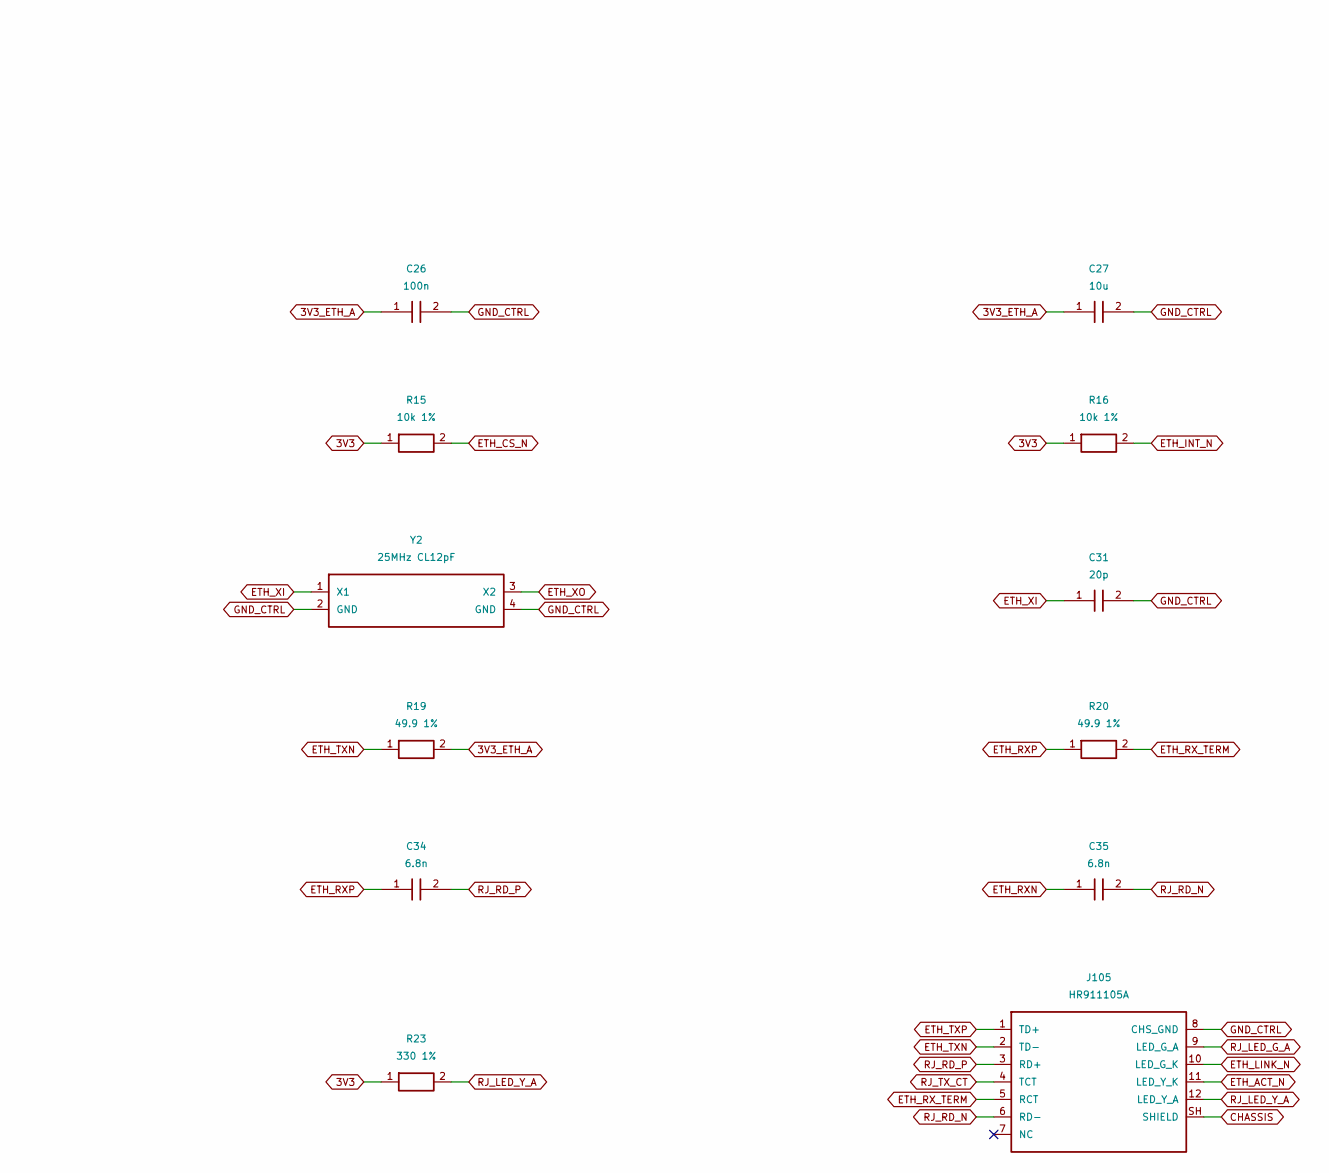
[picture p85: schematic ethernet_2.kicad_sch, W5500 / HR911105A Ethernet (2/3), part in row 1, column 2]

Parts:
C24, C25, C26, C28: 100n; C_0603_1608Metric; MPN CC0603KRX7R9BB104; LCSC C14663
C27, C29: 10u; C_0805_2012Metric; MPN CL21A106KAYNNNE; LCSC C15850
C30: 1u; C_0603_1608Metric; MPN CL10A105KB8NNNC; LCSC C15849
C31, C32: 20p; C_0603_1608Metric; MPN CL10C200JB8NNNC; LCSC C1648
C33: 10n; C_0402_1005Metric; MPN CL05B103KB5NNNC; LCSC C15195
C34, C35: 6.8n; C_0402_1005Metric; MPN CL05B682KB5NNNC; LCSC C318580
C36: 22n; C_0805_2012Metric; MPN CL21B223KBANNNC; LCSC C1729
J105: HR911105A; RJ45_Hanrun_HR911105A_Horizontal; MPN HR911105A; LCSC C12074
R15, R16, R17: 10k 1%; R_0603_1608Metric; MPN 0603WAF1002T5E; LCSC C25804
R18, R19: 49.9 1%; R_0603_1608Metric; MPN 0603WAF499JT5E; LCSC C23185
R20, R21: 49.9 1%; R_0402_1005Metric; MPN 0402WGF499JTCE; LCSC C25120
R22, R23: 330 1%; R_0603_1608Metric; MPN 0603WAF3300T5E; LCSC C23138
Y2: 25MHz CL12pF; Crystal_SMD_3225-4Pin_3.2x2.5mm; MPN X322525MOB4SI; LCSC C9006

Connections:
3V3: C28.1, C29.1, R15.1, R16.1, R17.1, R22.1, R23.1; also elsewhere on the board
3V3_ETH_A: C24.1, C25.1, C26.1, C27.1, R18.2, R19.2; also elsewhere on the board
CHASSIS: J105.SH (SHIELD); also elsewhere on the board
ETH_ACT_N: J105.11 (LED_Y_K); also elsewhere on the board
ETH_CS_N: R15.2; also elsewhere on the board
ETH_INT_N: R16.2; also elsewhere on the board
ETH_LINK_N: J105.10 (LED_G_K); also elsewhere on the board
ETH_RST_N: C30.1, R17.2; also elsewhere on the board
ETH_RXN: C35.1, R21.1; also elsewhere on the board
ETH_RXP: C34.1, R20.1; also elsewhere on the board
ETH_RX_TERM: C33.1, J105.5 (RCT), R20.2, R21.2
ETH_TXN: J105.2 (TD-), R19.1; also elsewhere on the board
ETH_TXP: J105.1 (TD+), R18.1; also elsewhere on the board
ETH_XI: C31.1, Y2.1 (X1); also elsewhere on the board
ETH_XO: C32.1, Y2.3 (X2); also elsewhere on the board
GND_CTRL: C24.2, C25.2, C26.2, C27.2, C28.2, C29.2, C30.2, C31.2, C32.2, C33.2, C36.2, J105.8 (CHS_GND), Y2.2 (GND), Y2.4 (GND); also elsewhere on the board
RJ_LED_G_A: J105.9 (LED_G_A), R22.2
RJ_LED_Y_A: J105.12 (LED_Y_A), R23.2
RJ_RD_N: C35.2, J105.6 (RD-)
RJ_RD_P: C34.2, J105.3 (RD+)
RJ_TX_CT: C36.1, J105.4 (TCT)

Notes on the sheet:
WIZnet RJ45 reference topology. HR911105A pin numbering differs from J1B1211CCD. 100-ohm differential MDI routing; crystal load caps need final frequency measurement.

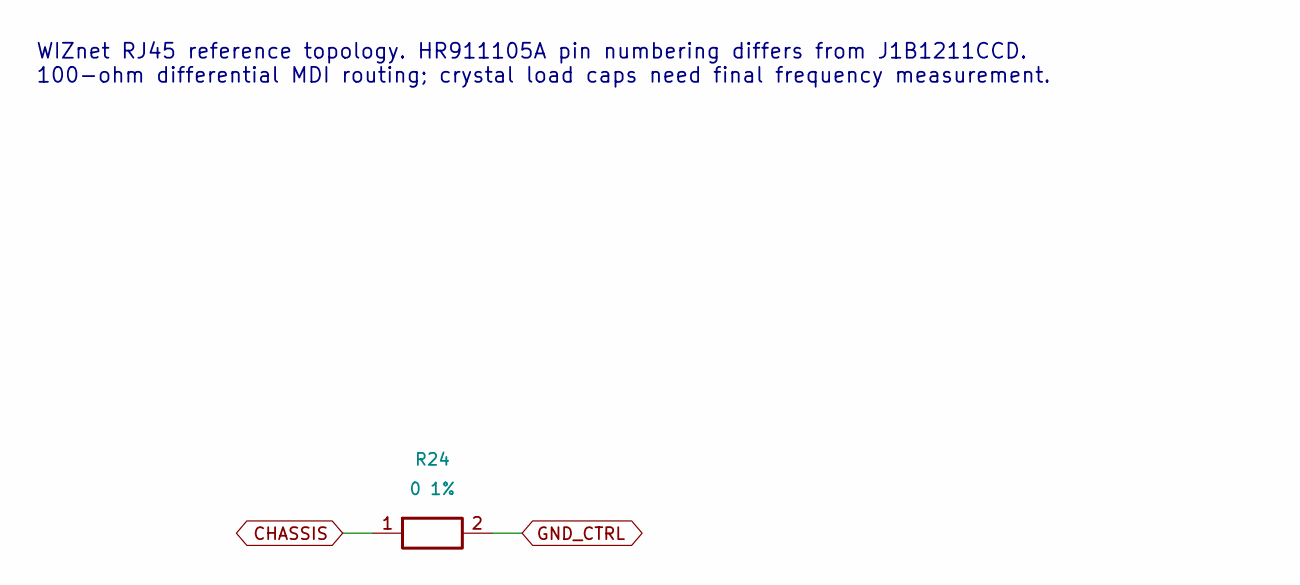
[picture p86: schematic ethernet_3.kicad_sch, W5500 / HR911105A Ethernet (3/3)]

Parts:
R24: 0 1%; R_0603_1608Metric; MPN 0603WAF0000T5E; LCSC C21189

Connections:
CHASSIS: R24.1; also elsewhere on the board
GND_CTRL: R24.2; also elsewhere on the board

Notes on the sheet:
WIZnet RJ45 reference topology. HR911105A pin numbering differs from J1B1211CCD. 100-ohm differential MDI routing; crystal load caps need final frequency measurement.
