ddasdkimo/rack-atx-controller/hardware/cad/B2/rack-atx-controller.kicad_pcb

## KiCad design hardware/cad/B2/rack-atx-controller.kicad_pcb (continued)

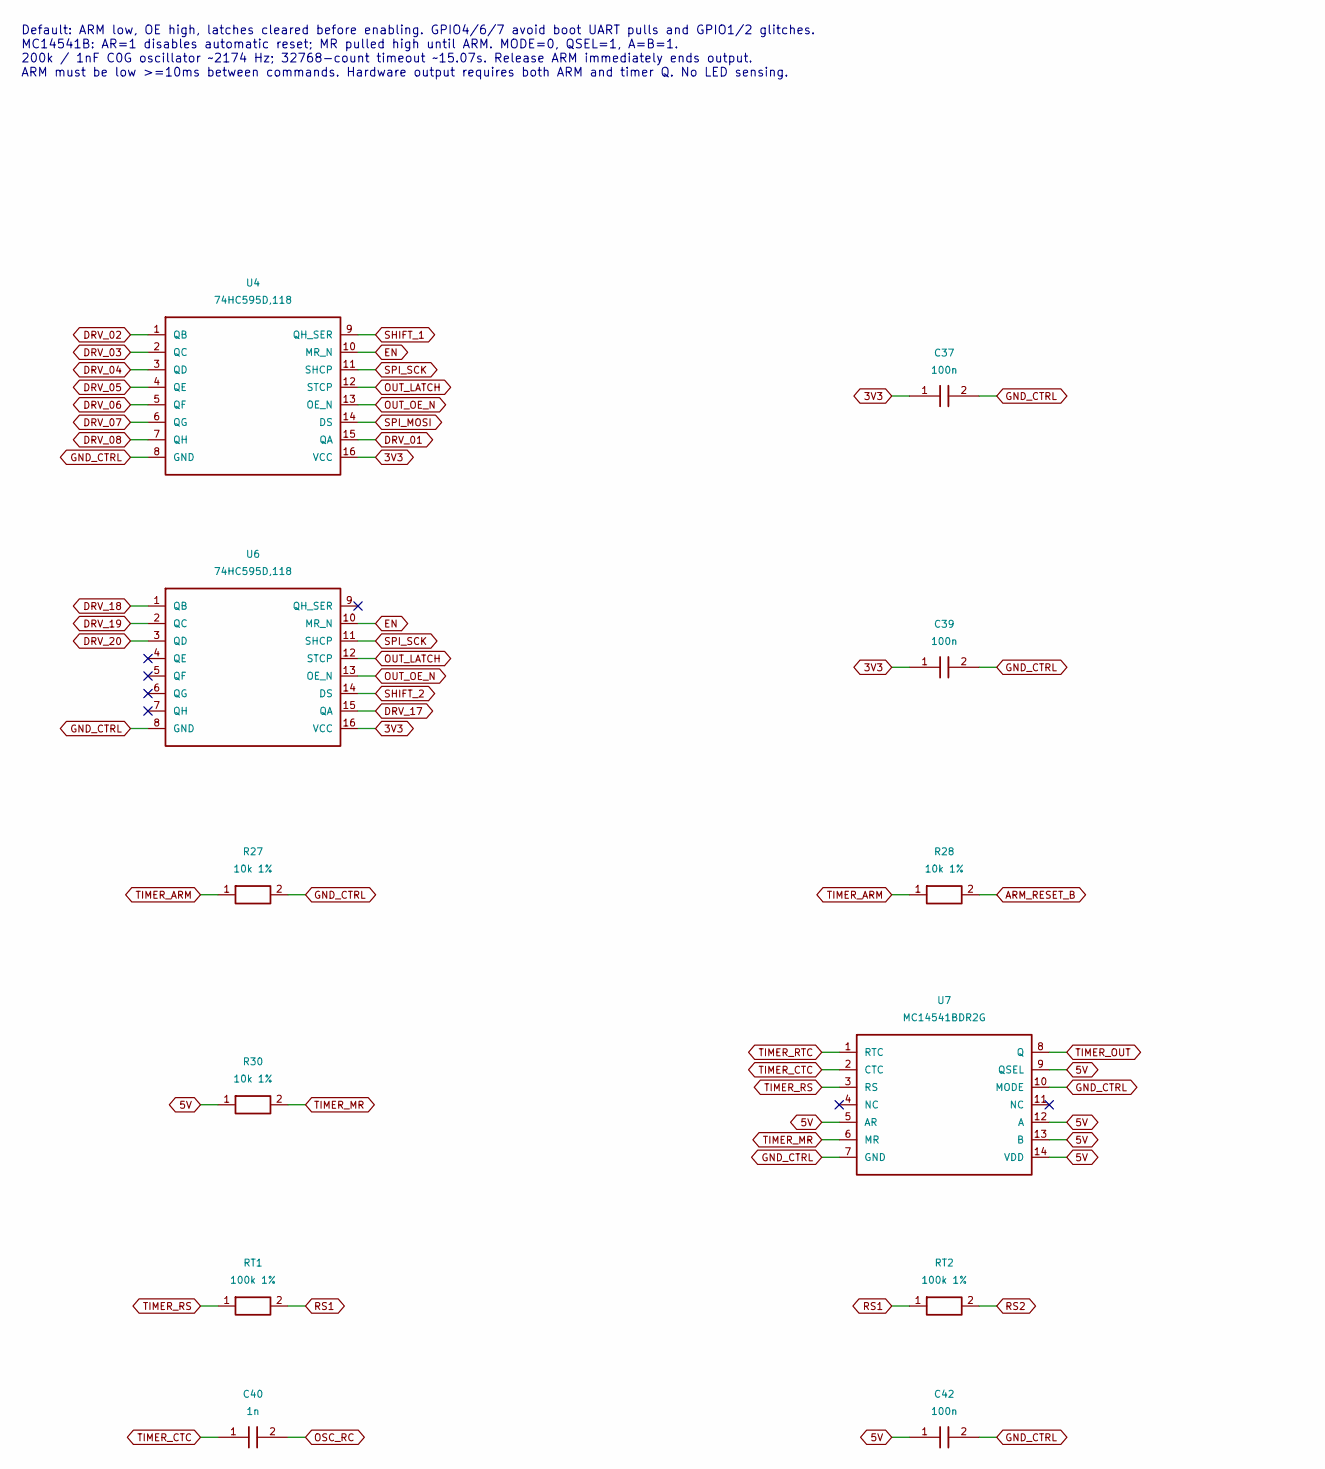
[picture p87: schematic outputs_1.kicad_sch, Output latches / counted timeout (1/2), part in row 1, column 1]

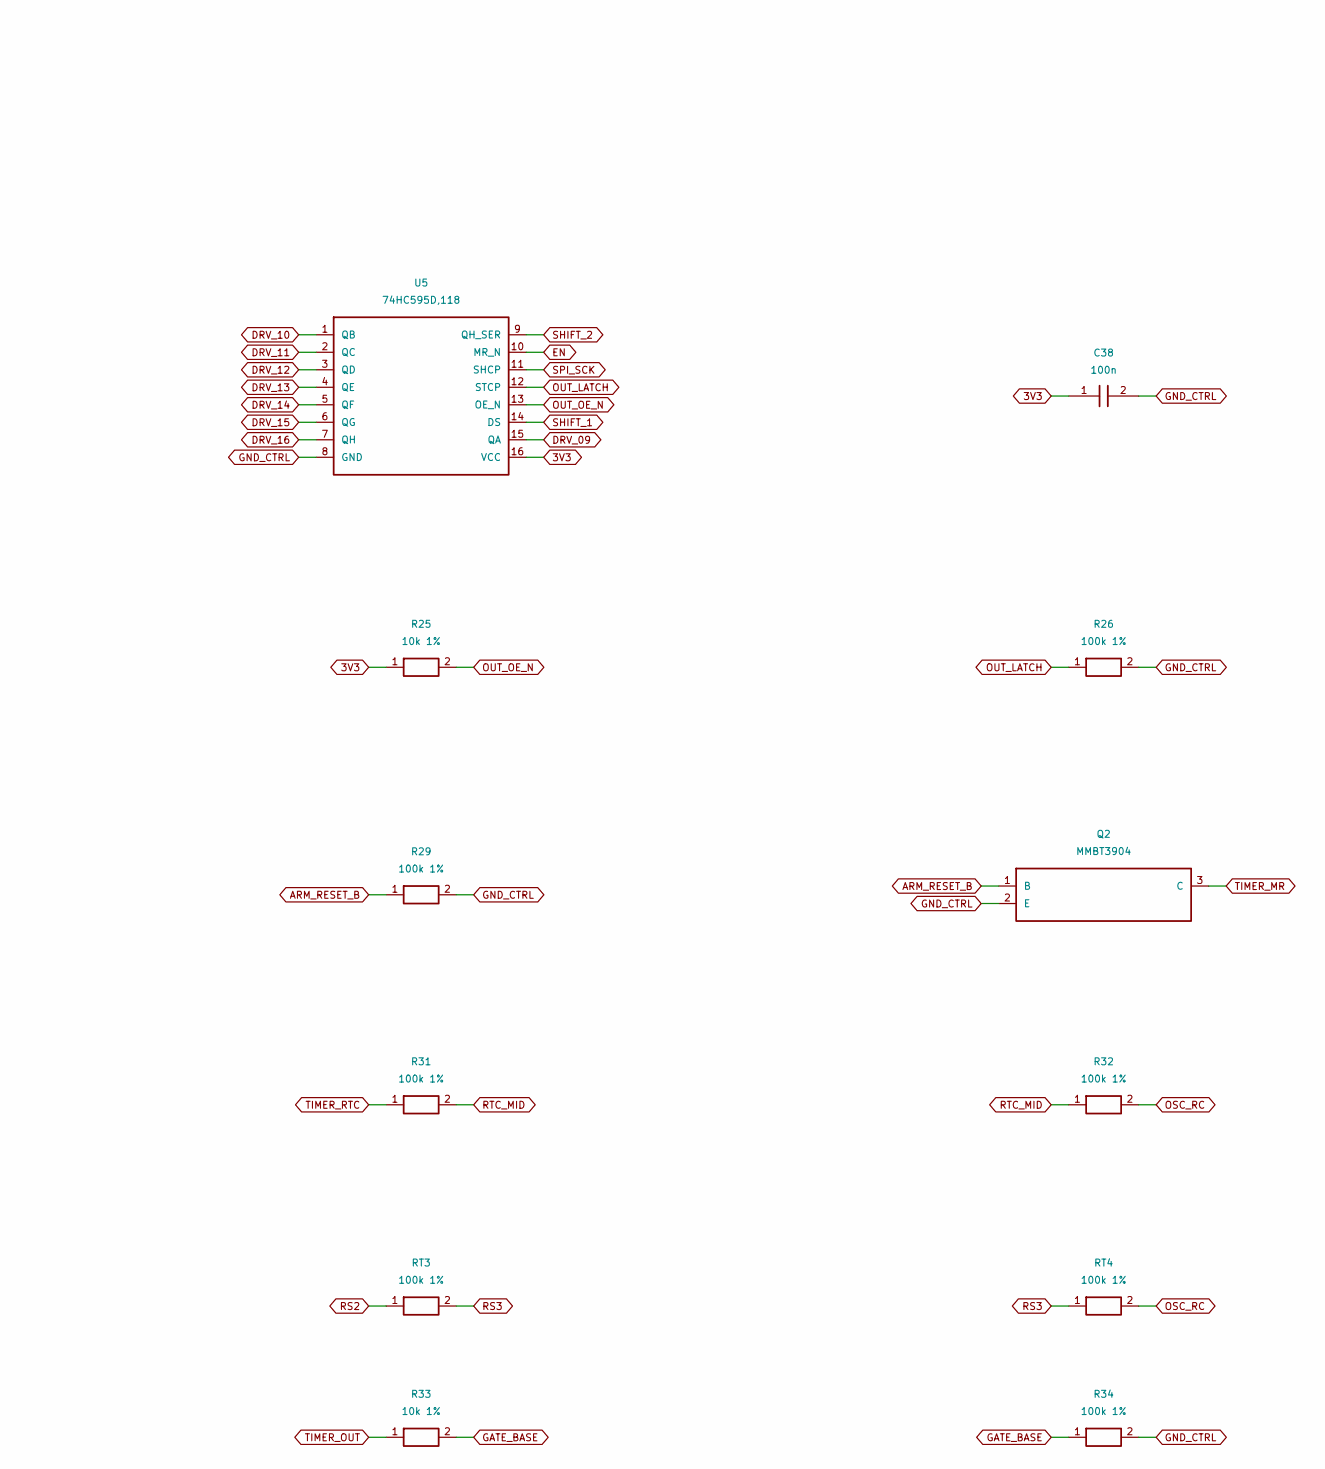
[picture p88: schematic outputs_1.kicad_sch, Output latches / counted timeout (1/2), part in row 1, column 2]

Parts:
C37, C38, C39, C42: 100n; C_0603_1608Metric; MPN CC0603KRX7R9BB104; LCSC C14663
C40: 1n; C_0603_1608Metric; MPN CL10C102JB8NNNC; LCSC C163508
Q2: MMBT3904; SOT-23; MPN MMBT3904(RANGE:100-300); LCSC C20526
R25, R27, R28, R30, R33: 10k 1%; R_0603_1608Metric; MPN 0603WAF1002T5E; LCSC C25804
R26, R29, R31, R32, R34: 100k 1%; R_0603_1608Metric; MPN 0603WAF1003T5E; LCSC C25803
RT1, RT2, RT3, RT4: 100k 1%; R_0603_1608Metric; MPN 0603WAF1003T5E; LCSC C25803
U4, U5, U6: 74HC595D,118; SOIC-16_3.9x9.9mm_P1.27mm; MPN 74HC595D,118; LCSC C5947
U7: MC14541BDR2G; SOIC-14_3.9x8.7mm_P1.27mm; MPN MC14541BDR2G; LCSC C7292

Connections:
3V3: C37.1, C38.1, C39.1, R25.1, U4.16 (VCC), U5.16 (VCC), U6.16 (VCC); also elsewhere on the board
5V: C42.1, R30.1, U7.5 (AR), U7.9 (QSEL), U7.12 (A), U7.13 (B), U7.14 (VDD); also elsewhere on the board
ARM_RESET_B: Q2.1 (B), R28.2, R29.1
DRV_01: U4.15 (QA); also elsewhere on the board
DRV_02: U4.1 (QB); also elsewhere on the board
DRV_03: U4.2 (QC); also elsewhere on the board
DRV_04: U4.3 (QD); also elsewhere on the board
DRV_05: U4.4 (QE); also elsewhere on the board
DRV_06: U4.5 (QF); also elsewhere on the board
DRV_07: U4.6 (QG); also elsewhere on the board
DRV_08: U4.7 (QH); also elsewhere on the board
DRV_09: U5.15 (QA); also elsewhere on the board
DRV_10: U5.1 (QB); also elsewhere on the board
DRV_11: U5.2 (QC); also elsewhere on the board
DRV_12: U5.3 (QD); also elsewhere on the board
DRV_13: U5.4 (QE); also elsewhere on the board
DRV_14: U5.5 (QF); also elsewhere on the board
DRV_15: U5.6 (QG); also elsewhere on the board
DRV_16: U5.7 (QH); also elsewhere on the board
DRV_17: U6.15 (QA); also elsewhere on the board
DRV_18: U6.1 (QB); also elsewhere on the board
DRV_19: U6.2 (QC); also elsewhere on the board
DRV_20: U6.3 (QD); also elsewhere on the board
EN: U4.10 (MR_N), U5.10 (MR_N), U6.10 (MR_N); also elsewhere on the board
GATE_BASE: R33.2, R34.1; also elsewhere on the board
GND_CTRL: C37.2, C38.2, C39.2, C42.2, Q2.2 (E), R26.2, R27.2, R29.2, R34.2, U4.8 (GND), U5.8 (GND), U6.8 (GND), U7.7 (GND), U7.10 (MODE); also elsewhere on the board
OSC_RC: C40.2, R32.2, RT4.2
OUT_LATCH: R26.1, U4.12 (STCP), U5.12 (STCP), U6.12 (STCP); also elsewhere on the board
OUT_OE_N: R25.2, U4.13 (OE_N), U5.13 (OE_N), U6.13 (OE_N); also elsewhere on the board
RS1: RT1.2, RT2.1
RS2: RT2.2, RT3.1
RS3: RT3.2, RT4.1
RTC_MID: R31.2, R32.1
SHIFT_1: U4.9 (QH_SER), U5.14 (DS)
SHIFT_2: U5.9 (QH_SER), U6.14 (DS)
SPI_MOSI: U4.14 (DS); also elsewhere on the board
SPI_SCK: U4.11 (SHCP), U5.11 (SHCP), U6.11 (SHCP); also elsewhere on the board
TIMER_ARM: R27.1, R28.1; also elsewhere on the board
TIMER_CTC: C40.1, U7.2 (CTC)
TIMER_MR: Q2.3 (C), R30.2, U7.6 (MR)
TIMER_OUT: R33.1, U7.8 (Q)
TIMER_RS: RT1.1, U7.3 (RS)
TIMER_RTC: R31.1, U7.1 (RTC)

Notes on the sheet:
Default: ARM low, OE high, latches cleared before enabling. GPIO4/6/7 avoid boot UART pulls and GPIO1/2 glitches. MC14541B: AR=1 disables automatic reset; MR pulled high until ARM. MODE=0, QSEL=1, A=B=1. 200k / 1nF C0G oscillator ~2174 Hz; 32768-count timeout ~15.07s. Release ARM immediately ends o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

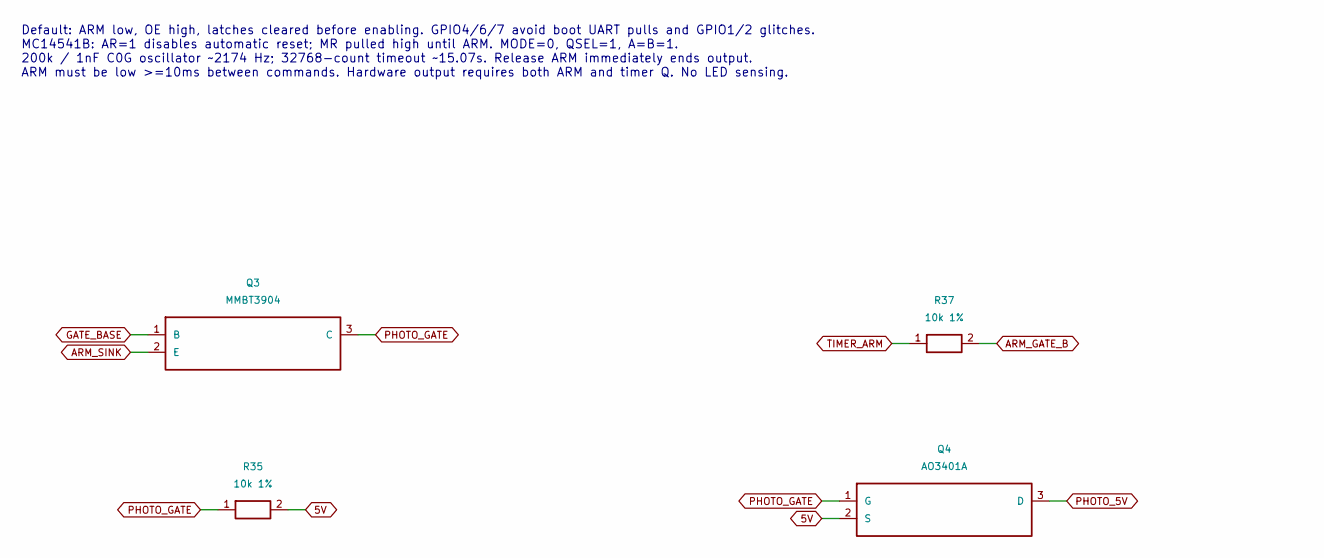
[picture p89: schematic outputs_2.kicad_sch, Output latches / counted timeout (2/2), part in row 1, column 1]

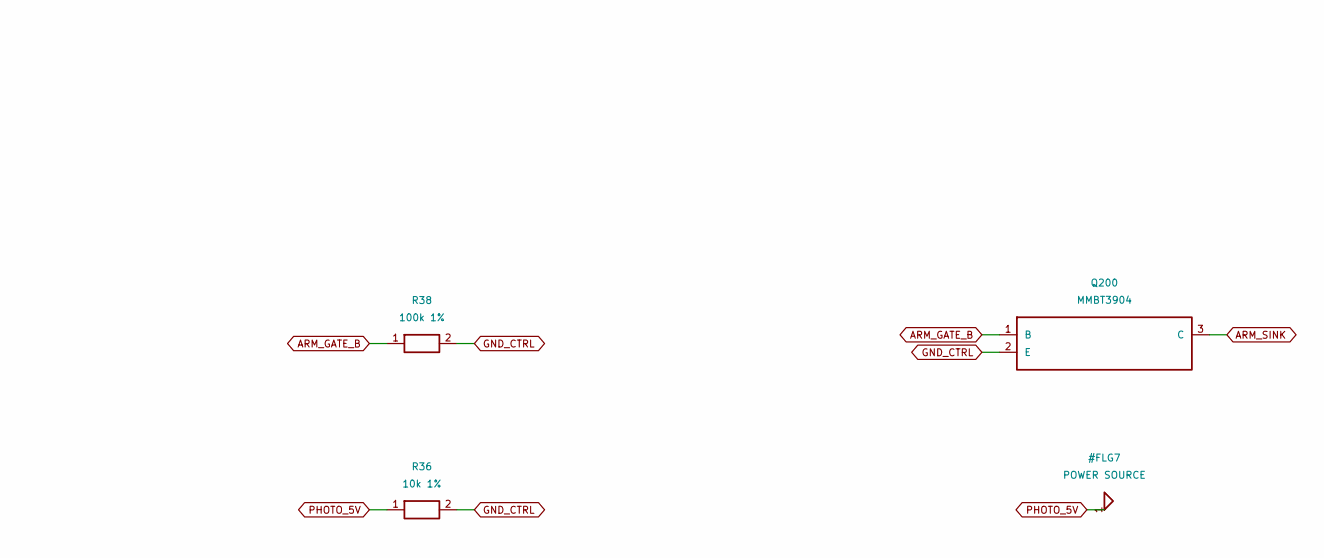
[picture p90: schematic outputs_2.kicad_sch, Output latches / counted timeout (2/2), part in row 1, column 2]

Parts:
Q3, Q200: MMBT3904; SOT-23; MPN MMBT3904(RANGE:100-300); LCSC C20526
Q4: AO3401A; SOT-23; MPN AO3401A; LCSC C15127
R35, R36, R37: 10k 1%; R_0603_1608Metric; MPN 0603WAF1002T5E; LCSC C25804
R38: 100k 1%; R_0603_1608Metric; MPN 0603WAF1003T5E; LCSC C25803

Connections:
5V: Q4.2 (S), R35.2; also elsewhere on the board
ARM_GATE_B: Q200.1 (B), R37.2, R38.1
ARM_SINK: Q3.2 (E), Q200.3 (C)
GATE_BASE: Q3.1 (B); also elsewhere on the board
GND_CTRL: Q200.2 (E), R36.2, R38.2; also elsewhere on the board
PHOTO_5V: Q4.3 (D), R36.1; also elsewhere on the board
PHOTO_GATE: Q3.3 (C), Q4.1 (G), R35.1
TIMER_ARM: R37.1; also elsewhere on the board

Notes on the sheet:
Default: ARM low, OE high, latches cleared before enabling. GPIO4/6/7 avoid boot UART pulls and GPIO1/2 glitches. MC14541B: AR=1 disables automatic reset; MR pulled high until ARM. MODE=0, QSEL=1, A=B=1. 200k / 1nF C0G oscillator ~2174 Hz; 32768-count timeout ~15.07s. Release ARM immediately ends o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

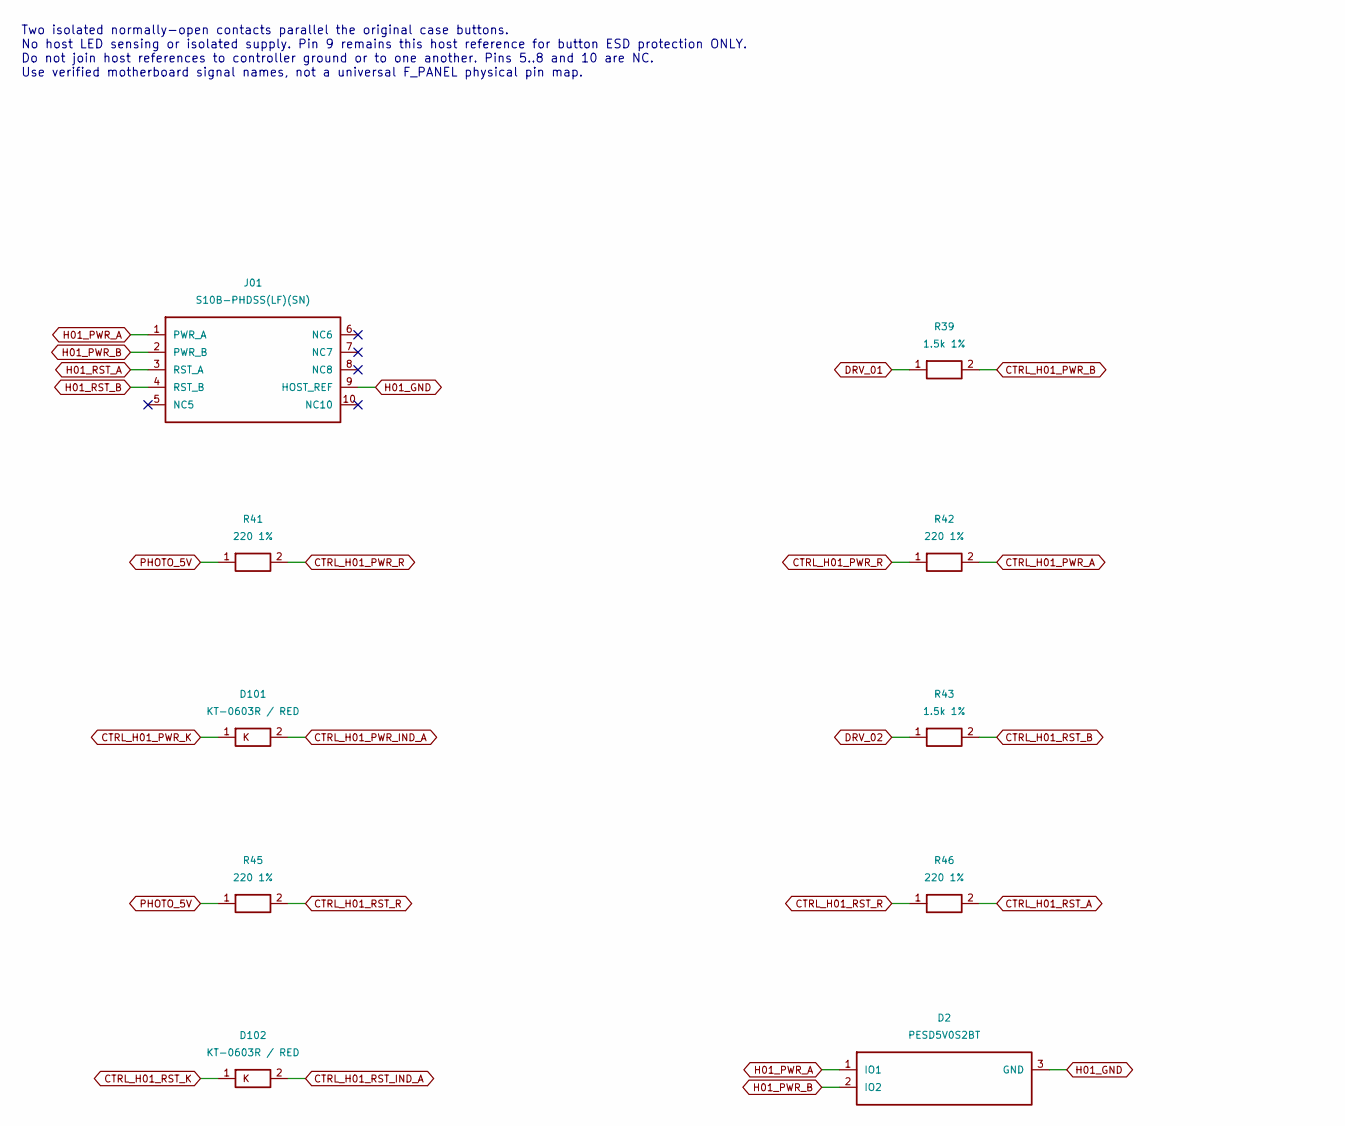
[picture p91: schematic host01.kicad_sch, Host 01: POWER / RESET only, part in row 1, column 1]

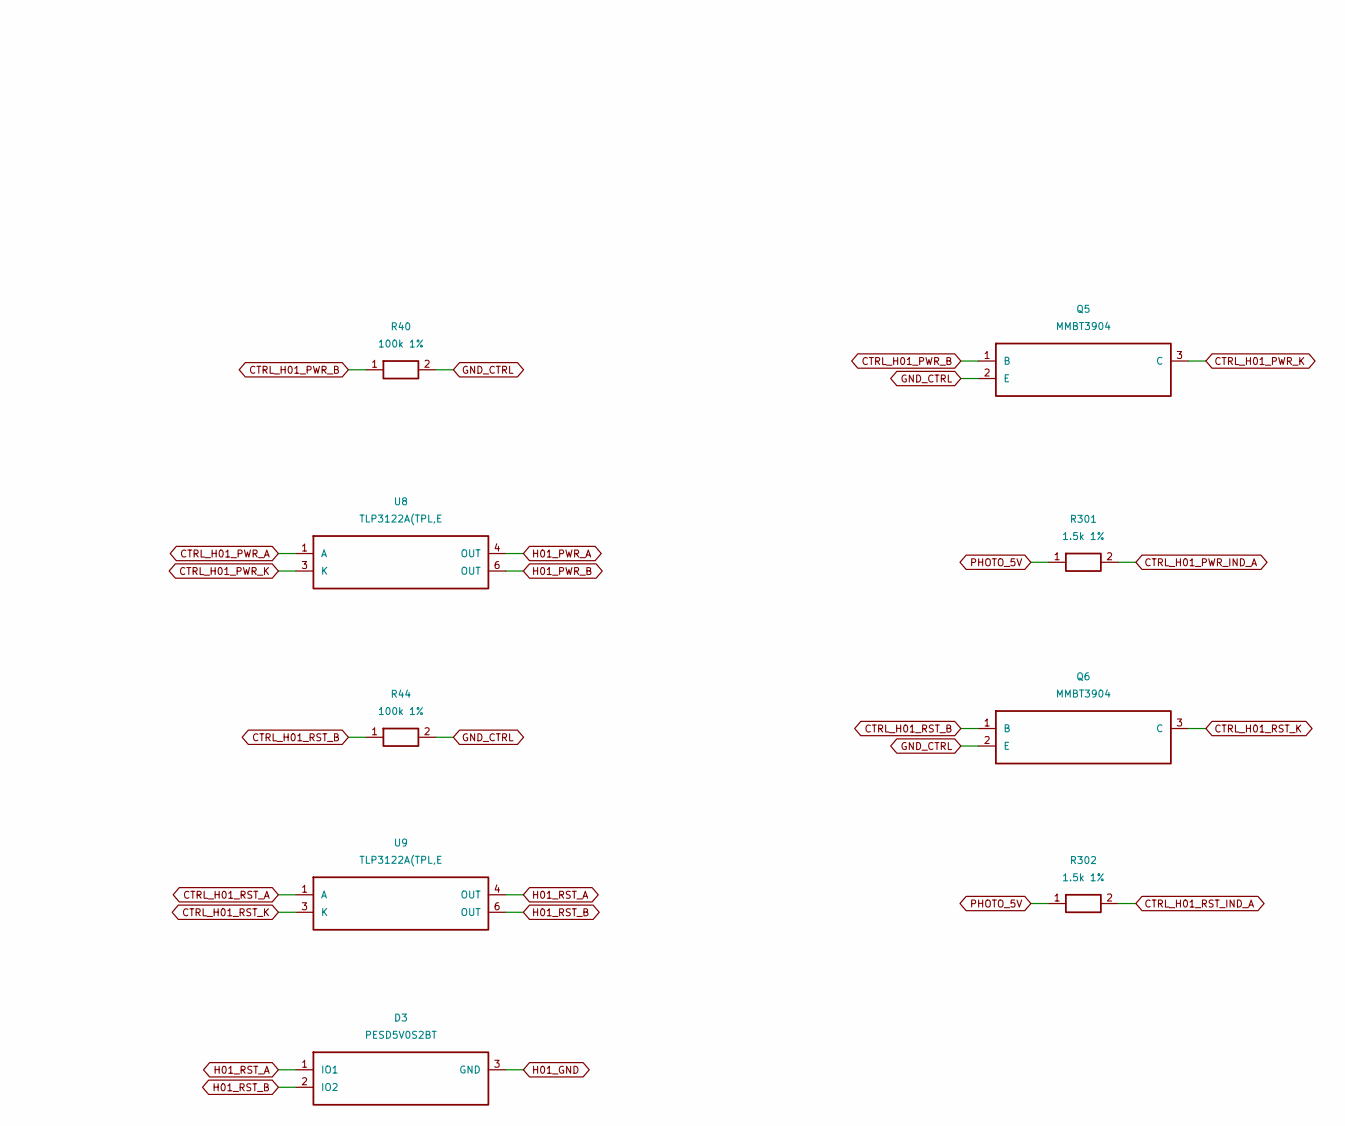
[picture p92: schematic host01.kicad_sch, Host 01: POWER / RESET only, part in row 1, column 2]

Parts:
D2, D3: PESD5V0S2BT; SOT-23; MPN PESD5V0S2BT; LCSC C2841440
D101, D102: KT-0603R / RED; LED_0603_1608Metric_CathodeSilk; MPN KT-0603R; LCSC C2286
J01: S10B-PHDSS(LF)(SN); JST_PHD_S10B-PHDSS_2x05_P2.00mm_Horizontal; MPN S10B-PHDSS(LF)(SN); LCSC C161672
Q5, Q6: MMBT3904; SOT-23; MPN MMBT3904(RANGE:100-300); LCSC C20526
R39, R43, R301, R302: 1.5k 1%; R_0603_1608Metric; MPN 0603WAF1501T5E; LCSC C22843
R40, R44: 100k 1%; R_0603_1608Metric; MPN 0603WAF1003T5E; LCSC C25803
R41, R42, R45, R46: 220 1%; R_0603_1608Metric; MPN 0603WAF2200T5E; LCSC C22962
U8, U9: TLP3122A(TPL,E; TLP3122A_11-4M1S; MPN TLP3122A(TPL,E; LCSC C4153843

Connections:
CTRL_H01_PWR_A: R42.2, U8.1 (A)
CTRL_H01_PWR_B: Q5.1 (B), R39.2, R40.1
CTRL_H01_PWR_IND_A: D101.2 (A), R301.2
CTRL_H01_PWR_K: D101.1 (K), Q5.3 (C), U8.3 (K)
CTRL_H01_PWR_R: R41.2, R42.1
CTRL_H01_RST_A: R46.2, U9.1 (A)
CTRL_H01_RST_B: Q6.1 (B), R43.2, R44.1
CTRL_H01_RST_IND_A: D102.2 (A), R302.2
CTRL_H01_RST_K: D102.1 (K), Q6.3 (C), U9.3 (K)
CTRL_H01_RST_R: R45.2, R46.1
DRV_01: R39.1; also elsewhere on the board
DRV_02: R43.1; also elsewhere on the board
GND_CTRL: Q5.2 (E), Q6.2 (E), R40.2, R44.2; also elsewhere on the board
H01_GND: D2.3 (GND), D3.3 (GND), J01.9 (HOST_REF)
H01_PWR_A: D2.1 (IO1), J01.1 (PWR_A), U8.4 (OUT)
H01_PWR_B: D2.2 (IO2), J01.2 (PWR_B), U8.6 (OUT)
H01_RST_A: D3.1 (IO1), J01.3 (RST_A), U9.4 (OUT)
H01_RST_B: D3.2 (IO2), J01.4 (RST_B), U9.6 (OUT)
PHOTO_5V: R41.1, R45.1, R301.1, R302.1; also elsewhere on the board

Notes on the sheet:
Two isolated normally-open contacts parallel the original case buttons. No host LED sensing or isolated supply. Pin 9 remains this host reference for button ESD protection ONLY. Do not join host references to controller ground or to one another. Pins 5..8 and 10 are NC. Use verified motherboard sig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

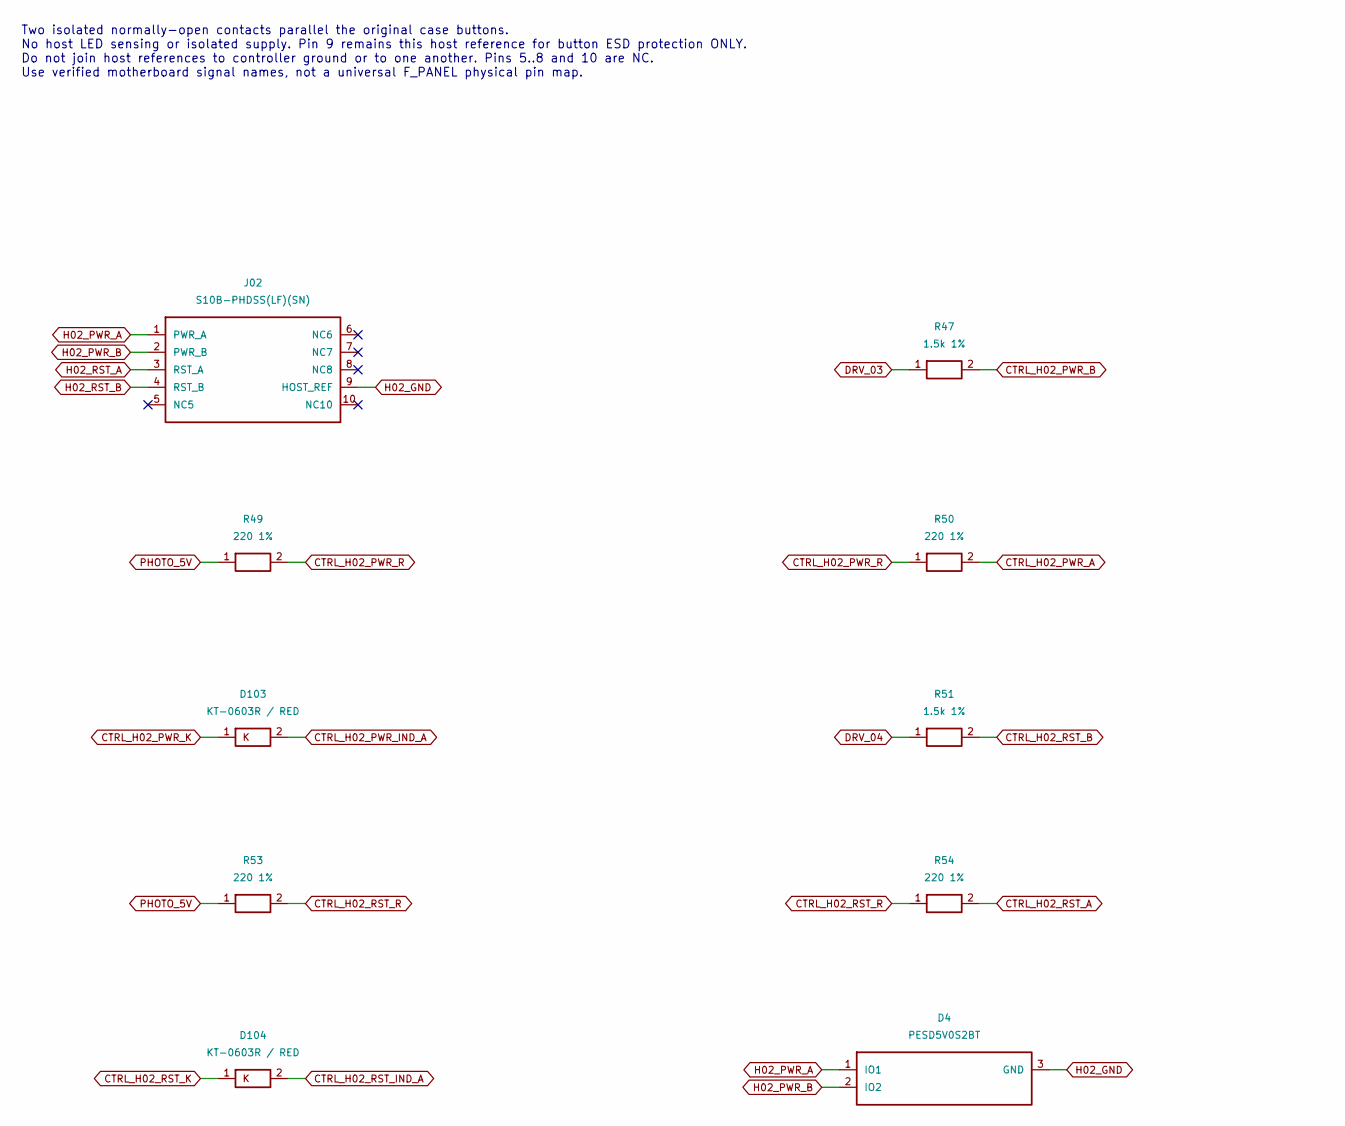
[picture p93: schematic host02.kicad_sch, Host 02: POWER / RESET only, part in row 1, column 1]

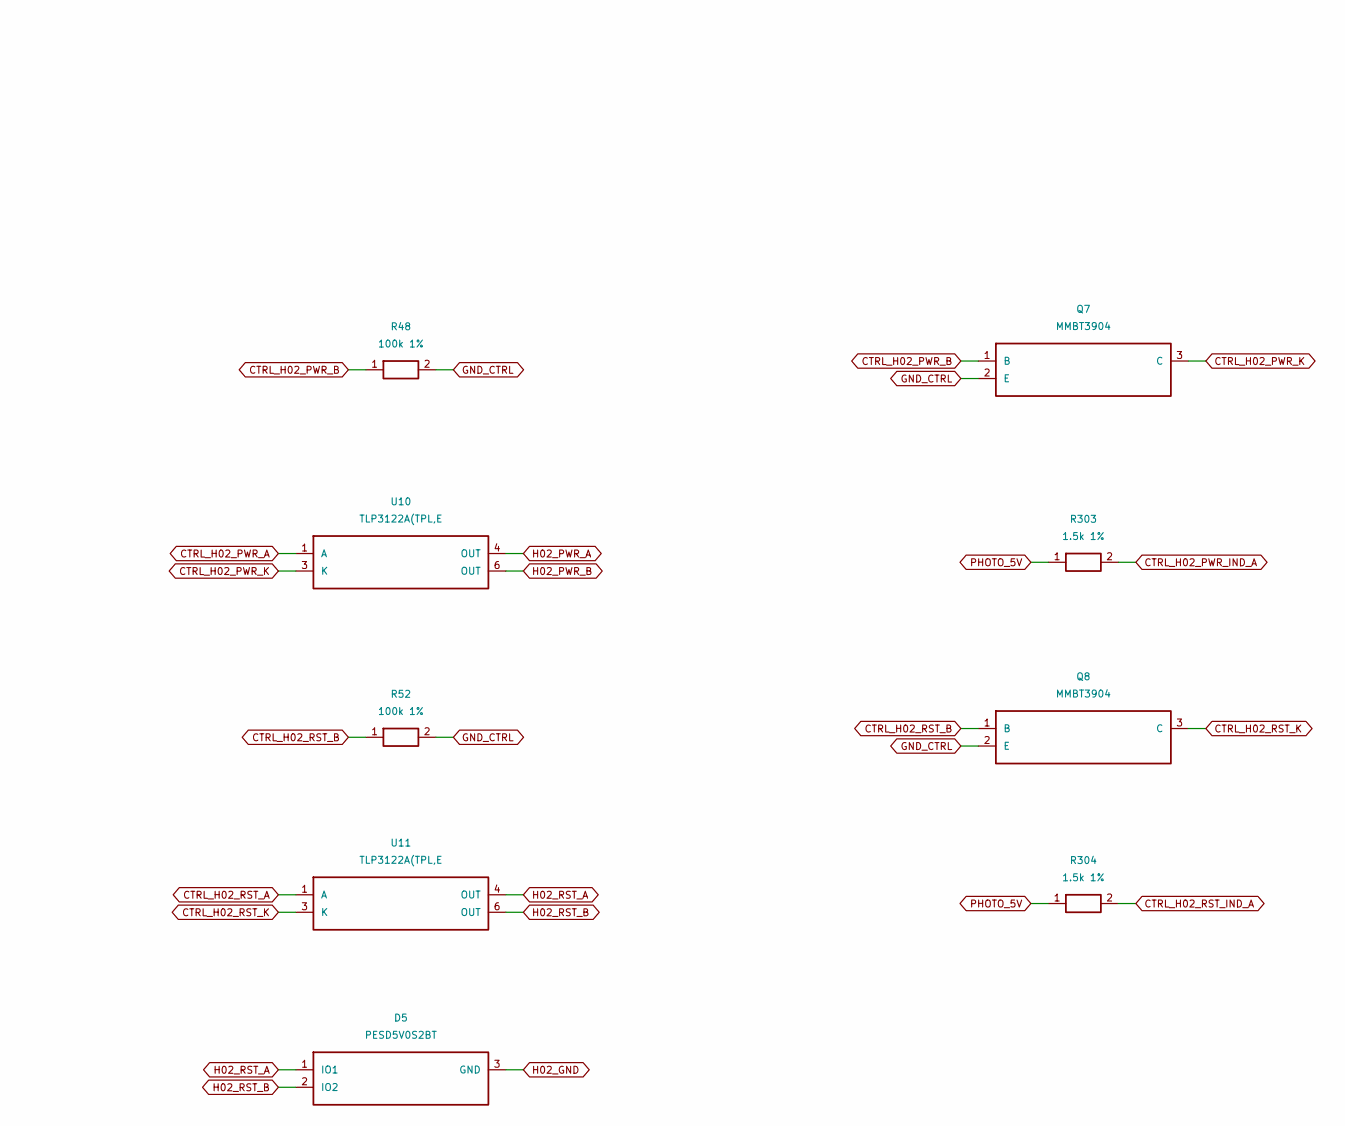
[picture p94: schematic host02.kicad_sch, Host 02: POWER / RESET only, part in row 1, column 2]

Parts:
D4, D5: PESD5V0S2BT; SOT-23; MPN PESD5V0S2BT; LCSC C2841440
D103, D104: KT-0603R / RED; LED_0603_1608Metric_CathodeSilk; MPN KT-0603R; LCSC C2286
J02: S10B-PHDSS(LF)(SN); JST_PHD_S10B-PHDSS_2x05_P2.00mm_Horizontal; MPN S10B-PHDSS(LF)(SN); LCSC C161672
Q7, Q8: MMBT3904; SOT-23; MPN MMBT3904(RANGE:100-300); LCSC C20526
R47, R51, R303, R304: 1.5k 1%; R_0603_1608Metric; MPN 0603WAF1501T5E; LCSC C22843
R48, R52: 100k 1%; R_0603_1608Metric; MPN 0603WAF1003T5E; LCSC C25803
R49, R50, R53, R54: 220 1%; R_0603_1608Metric; MPN 0603WAF2200T5E; LCSC C22962
U10, U11: TLP3122A(TPL,E; TLP3122A_11-4M1S; MPN TLP3122A(TPL,E; LCSC C4153843

Connections:
CTRL_H02_PWR_A: R50.2, U10.1 (A)
CTRL_H02_PWR_B: Q7.1 (B), R47.2, R48.1
CTRL_H02_PWR_IND_A: D103.2 (A), R303.2
CTRL_H02_PWR_K: D103.1 (K), Q7.3 (C), U10.3 (K)
CTRL_H02_PWR_R: R49.2, R50.1
CTRL_H02_RST_A: R54.2, U11.1 (A)
CTRL_H02_RST_B: Q8.1 (B), R51.2, R52.1
CTRL_H02_RST_IND_A: D104.2 (A), R304.2
CTRL_H02_RST_K: D104.1 (K), Q8.3 (C), U11.3 (K)
CTRL_H02_RST_R: R53.2, R54.1
DRV_03: R47.1; also elsewhere on the board
DRV_04: R51.1; also elsewhere on the board
GND_CTRL: Q7.2 (E), Q8.2 (E), R48.2, R52.2; also elsewhere on the board
H02_GND: D4.3 (GND), D5.3 (GND), J02.9 (HOST_REF)
H02_PWR_A: D4.1 (IO1), J02.1 (PWR_A), U10.4 (OUT)
H02_PWR_B: D4.2 (IO2), J02.2 (PWR_B), U10.6 (OUT)
H02_RST_A: D5.1 (IO1), J02.3 (RST_A), U11.4 (OUT)
H02_RST_B: D5.2 (IO2), J02.4 (RST_B), U11.6 (OUT)
PHOTO_5V: R49.1, R53.1, R303.1, R304.1; also elsewhere on the board

Notes on the sheet:
Two isolated normally-open contacts parallel the original case buttons. No host LED sensing or isolated supply. Pin 9 remains this host reference for button ESD protection ONLY. Do not join host references to controller ground or to one another. Pins 5..8 and 10 are NC. Use verified motherboard sig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

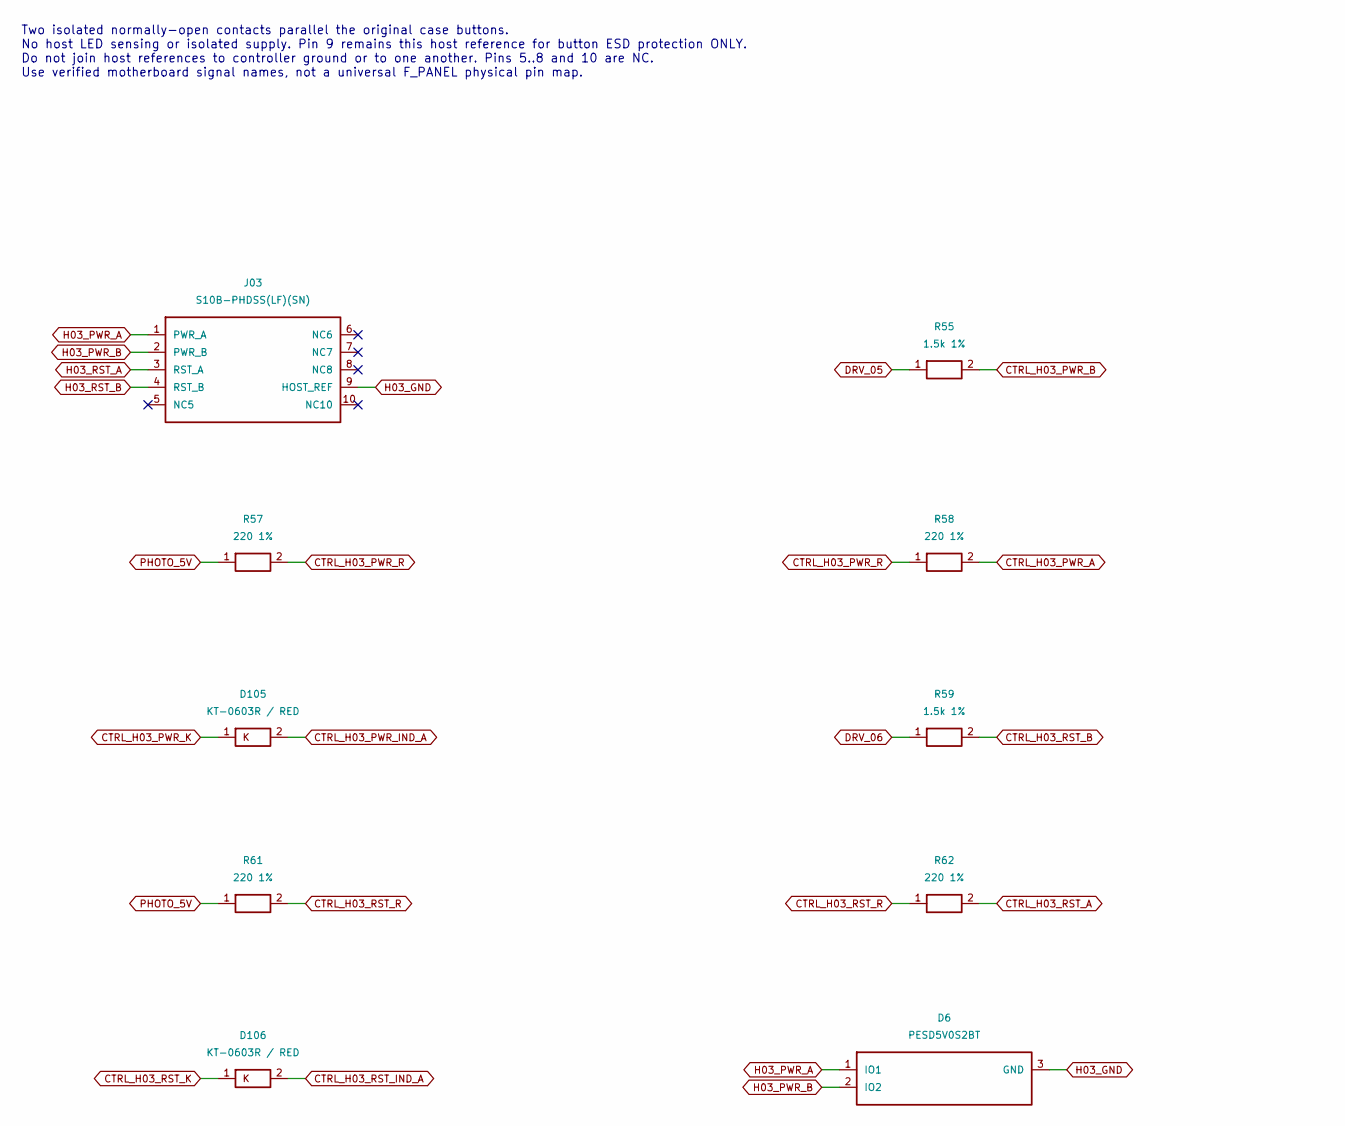
[picture p95: schematic host03.kicad_sch, Host 03: POWER / RESET only, part in row 1, column 1]

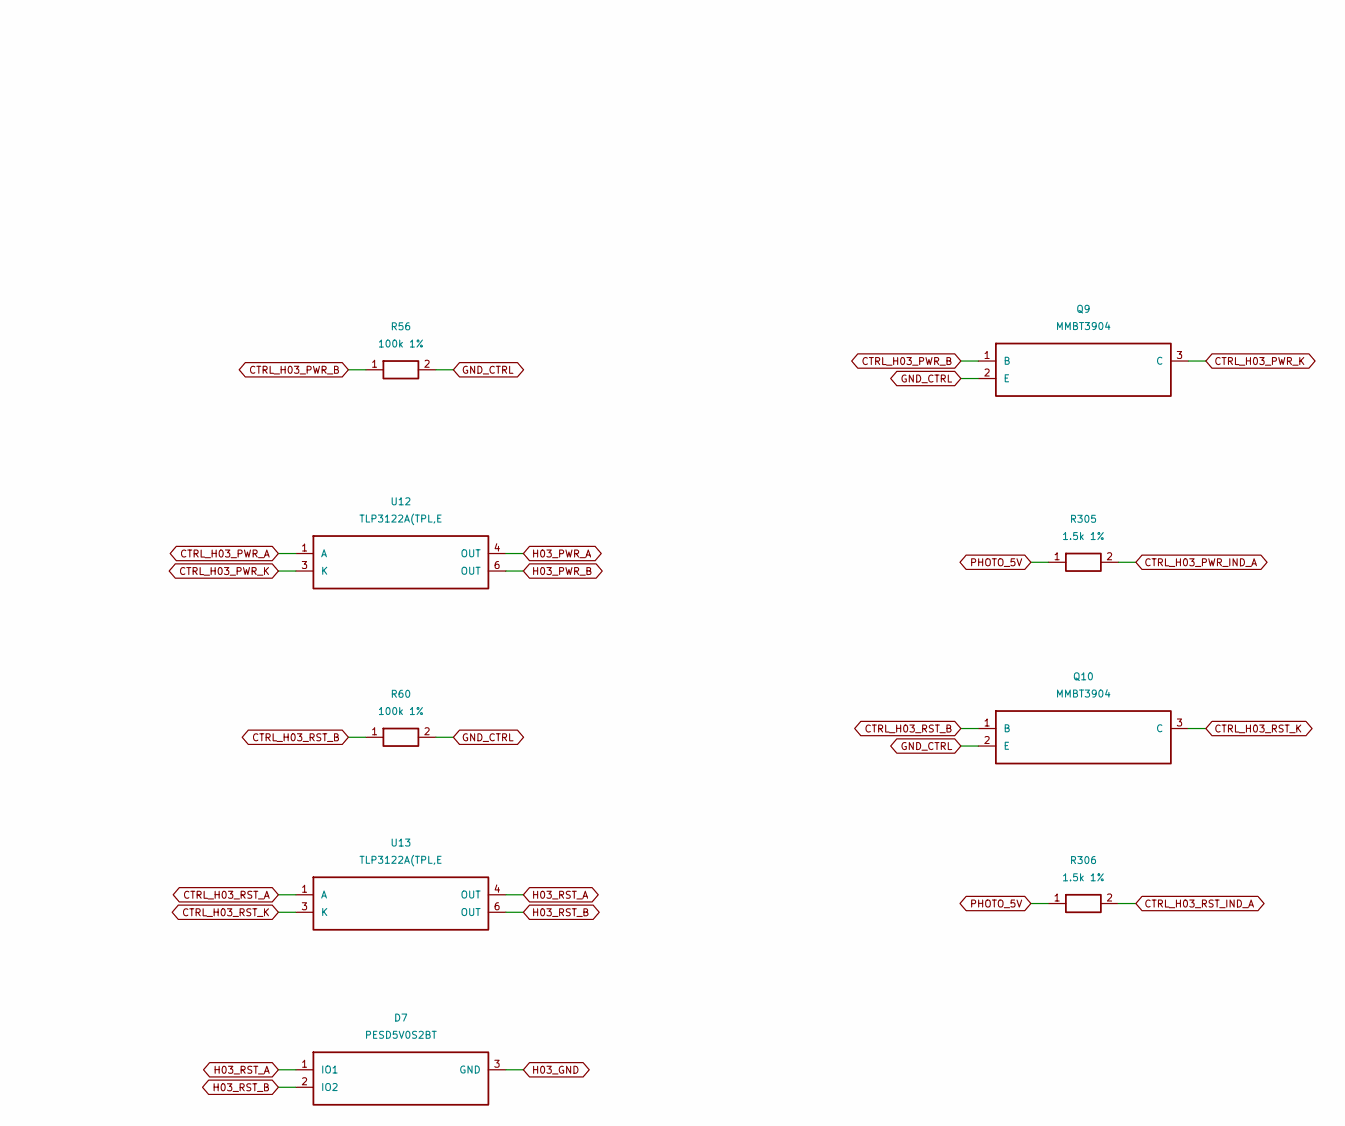
[picture p96: schematic host03.kicad_sch, Host 03: POWER / RESET only, part in row 1, column 2]

Parts:
D6, D7: PESD5V0S2BT; SOT-23; MPN PESD5V0S2BT; LCSC C2841440
D105, D106: KT-0603R / RED; LED_0603_1608Metric_CathodeSilk; MPN KT-0603R; LCSC C2286
J03: S10B-PHDSS(LF)(SN); JST_PHD_S10B-PHDSS_2x05_P2.00mm_Horizontal; MPN S10B-PHDSS(LF)(SN); LCSC C161672
Q9, Q10: MMBT3904; SOT-23; MPN MMBT3904(RANGE:100-300); LCSC C20526
R55, R59, R305, R306: 1.5k 1%; R_0603_1608Metric; MPN 0603WAF1501T5E; LCSC C22843
R56, R60: 100k 1%; R_0603_1608Metric; MPN 0603WAF1003T5E; LCSC C25803
R57, R58, R61, R62: 220 1%; R_0603_1608Metric; MPN 0603WAF2200T5E; LCSC C22962
U12, U13: TLP3122A(TPL,E; TLP3122A_11-4M1S; MPN TLP3122A(TPL,E; LCSC C4153843

Connections:
CTRL_H03_PWR_A: R58.2, U12.1 (A)
CTRL_H03_PWR_B: Q9.1 (B), R55.2, R56.1
CTRL_H03_PWR_IND_A: D105.2 (A), R305.2
CTRL_H03_PWR_K: D105.1 (K), Q9.3 (C), U12.3 (K)
CTRL_H03_PWR_R: R57.2, R58.1
CTRL_H03_RST_A: R62.2, U13.1 (A)
CTRL_H03_RST_B: Q10.1 (B), R59.2, R60.1
CTRL_H03_RST_IND_A: D106.2 (A), R306.2
CTRL_H03_RST_K: D106.1 (K), Q10.3 (C), U13.3 (K)
CTRL_H03_RST_R: R61.2, R62.1
DRV_05: R55.1; also elsewhere on the board
DRV_06: R59.1; also elsewhere on the board
GND_CTRL: Q9.2 (E), Q10.2 (E), R56.2, R60.2; also elsewhere on the board
H03_GND: D6.3 (GND), D7.3 (GND), J03.9 (HOST_REF)
H03_PWR_A: D6.1 (IO1), J03.1 (PWR_A), U12.4 (OUT)
H03_PWR_B: D6.2 (IO2), J03.2 (PWR_B), U12.6 (OUT)
H03_RST_A: D7.1 (IO1), J03.3 (RST_A), U13.4 (OUT)
H03_RST_B: D7.2 (IO2), J03.4 (RST_B), U13.6 (OUT)
PHOTO_5V: R57.1, R61.1, R305.1, R306.1; also elsewhere on the board

Notes on the sheet:
Two isolated normally-open contacts parallel the original case buttons. No host LED sensing or isolated supply. Pin 9 remains this host reference for button ESD protection ONLY. Do not join host references to controller ground or to one another. Pins 5..8 and 10 are NC. Use verified motherboard sig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
