ddasdkimo/rack-atx-controller/hardware/cad/B2/rack-atx-controller.kicad_pcb

## KiCad design hardware/cad/B2/rack-atx-controller.kicad_pcb (continued)

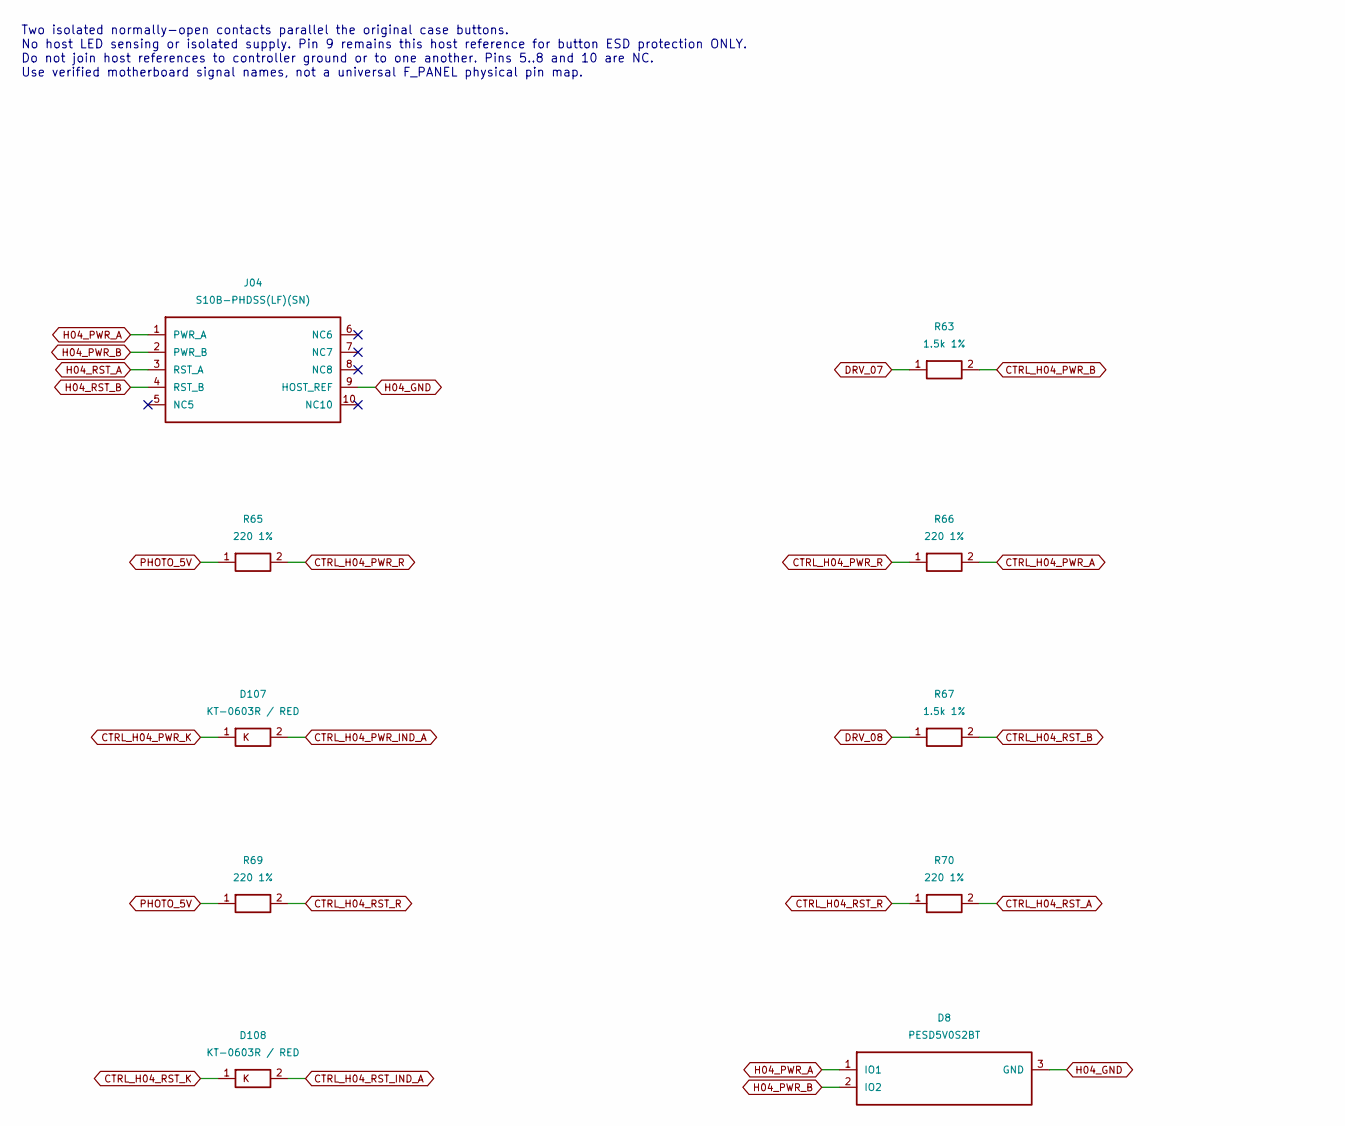
[picture p97: schematic host04.kicad_sch, Host 04: POWER / RESET only, part in row 1, column 1]

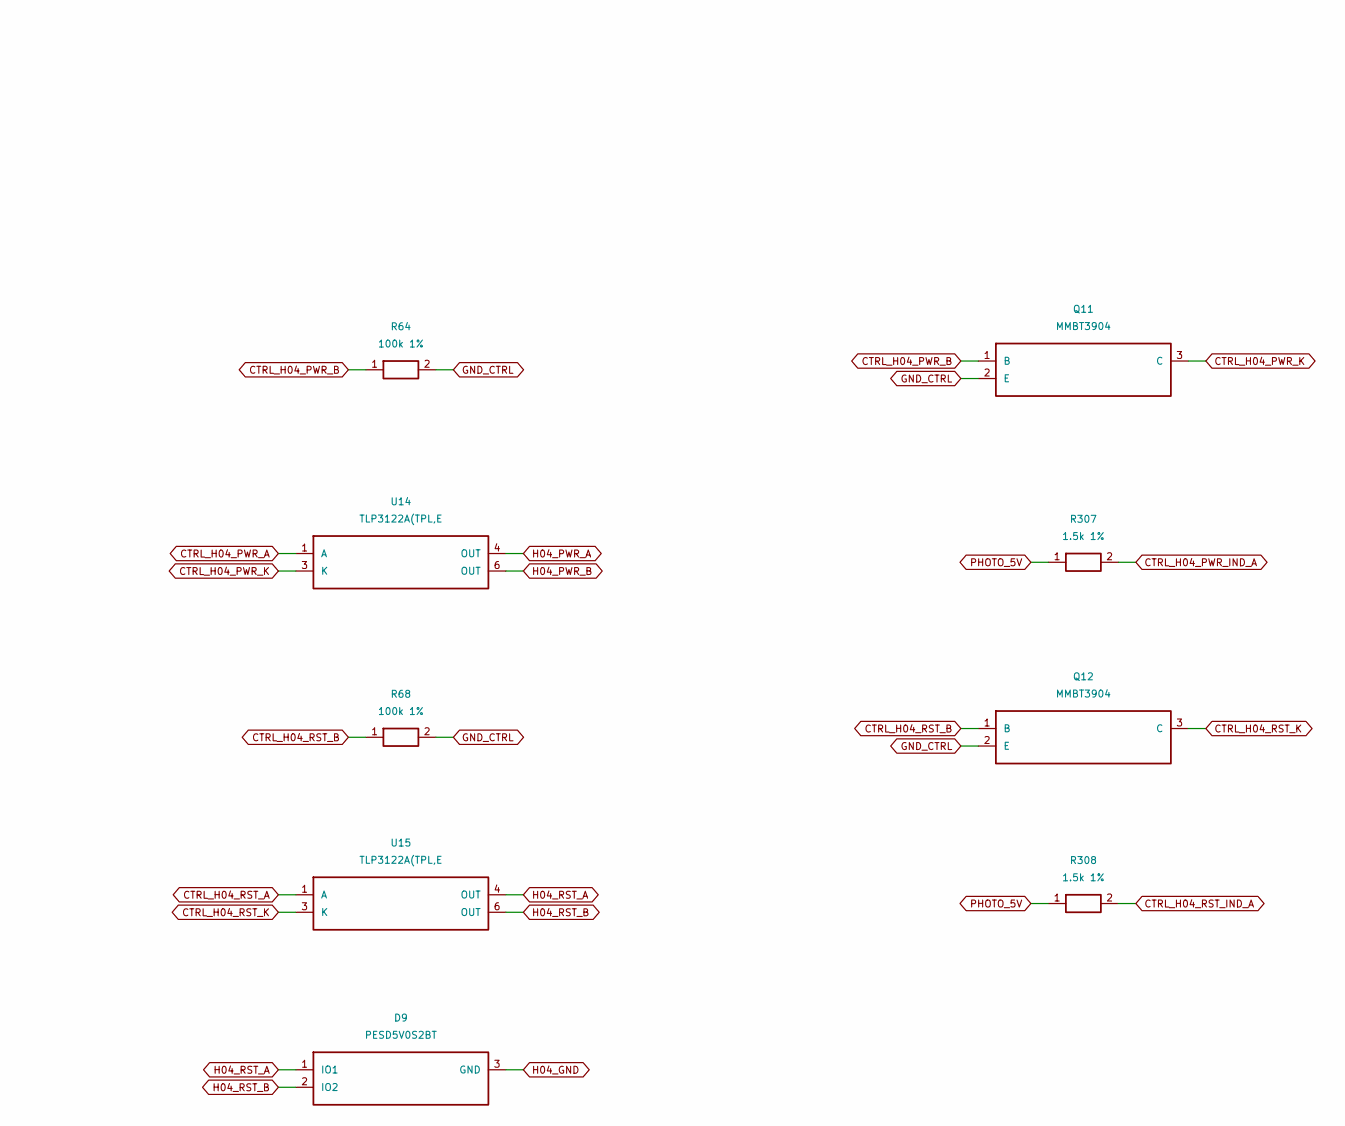
[picture p98: schematic host04.kicad_sch, Host 04: POWER / RESET only, part in row 1, column 2]

Parts:
D8, D9: PESD5V0S2BT; SOT-23; MPN PESD5V0S2BT; LCSC C2841440
D107, D108: KT-0603R / RED; LED_0603_1608Metric_CathodeSilk; MPN KT-0603R; LCSC C2286
J04: S10B-PHDSS(LF)(SN); JST_PHD_S10B-PHDSS_2x05_P2.00mm_Horizontal; MPN S10B-PHDSS(LF)(SN); LCSC C161672
Q11, Q12: MMBT3904; SOT-23; MPN MMBT3904(RANGE:100-300); LCSC C20526
R63, R67, R307, R308: 1.5k 1%; R_0603_1608Metric; MPN 0603WAF1501T5E; LCSC C22843
R64, R68: 100k 1%; R_0603_1608Metric; MPN 0603WAF1003T5E; LCSC C25803
R65, R66, R69, R70: 220 1%; R_0603_1608Metric; MPN 0603WAF2200T5E; LCSC C22962
U14, U15: TLP3122A(TPL,E; TLP3122A_11-4M1S; MPN TLP3122A(TPL,E; LCSC C4153843

Connections:
CTRL_H04_PWR_A: R66.2, U14.1 (A)
CTRL_H04_PWR_B: Q11.1 (B), R63.2, R64.1
CTRL_H04_PWR_IND_A: D107.2 (A), R307.2
CTRL_H04_PWR_K: D107.1 (K), Q11.3 (C), U14.3 (K)
CTRL_H04_PWR_R: R65.2, R66.1
CTRL_H04_RST_A: R70.2, U15.1 (A)
CTRL_H04_RST_B: Q12.1 (B), R67.2, R68.1
CTRL_H04_RST_IND_A: D108.2 (A), R308.2
CTRL_H04_RST_K: D108.1 (K), Q12.3 (C), U15.3 (K)
CTRL_H04_RST_R: R69.2, R70.1
DRV_07: R63.1; also elsewhere on the board
DRV_08: R67.1; also elsewhere on the board
GND_CTRL: Q11.2 (E), Q12.2 (E), R64.2, R68.2; also elsewhere on the board
H04_GND: D8.3 (GND), D9.3 (GND), J04.9 (HOST_REF)
H04_PWR_A: D8.1 (IO1), J04.1 (PWR_A), U14.4 (OUT)
H04_PWR_B: D8.2 (IO2), J04.2 (PWR_B), U14.6 (OUT)
H04_RST_A: D9.1 (IO1), J04.3 (RST_A), U15.4 (OUT)
H04_RST_B: D9.2 (IO2), J04.4 (RST_B), U15.6 (OUT)
PHOTO_5V: R65.1, R69.1, R307.1, R308.1; also elsewhere on the board

Notes on the sheet:
Two isolated normally-open contacts parallel the original case buttons. No host LED sensing or isolated supply. Pin 9 remains this host reference for button ESD protection ONLY. Do not join host references to controller ground or to one another. Pins 5..8 and 10 are NC. Use verified motherboard sig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

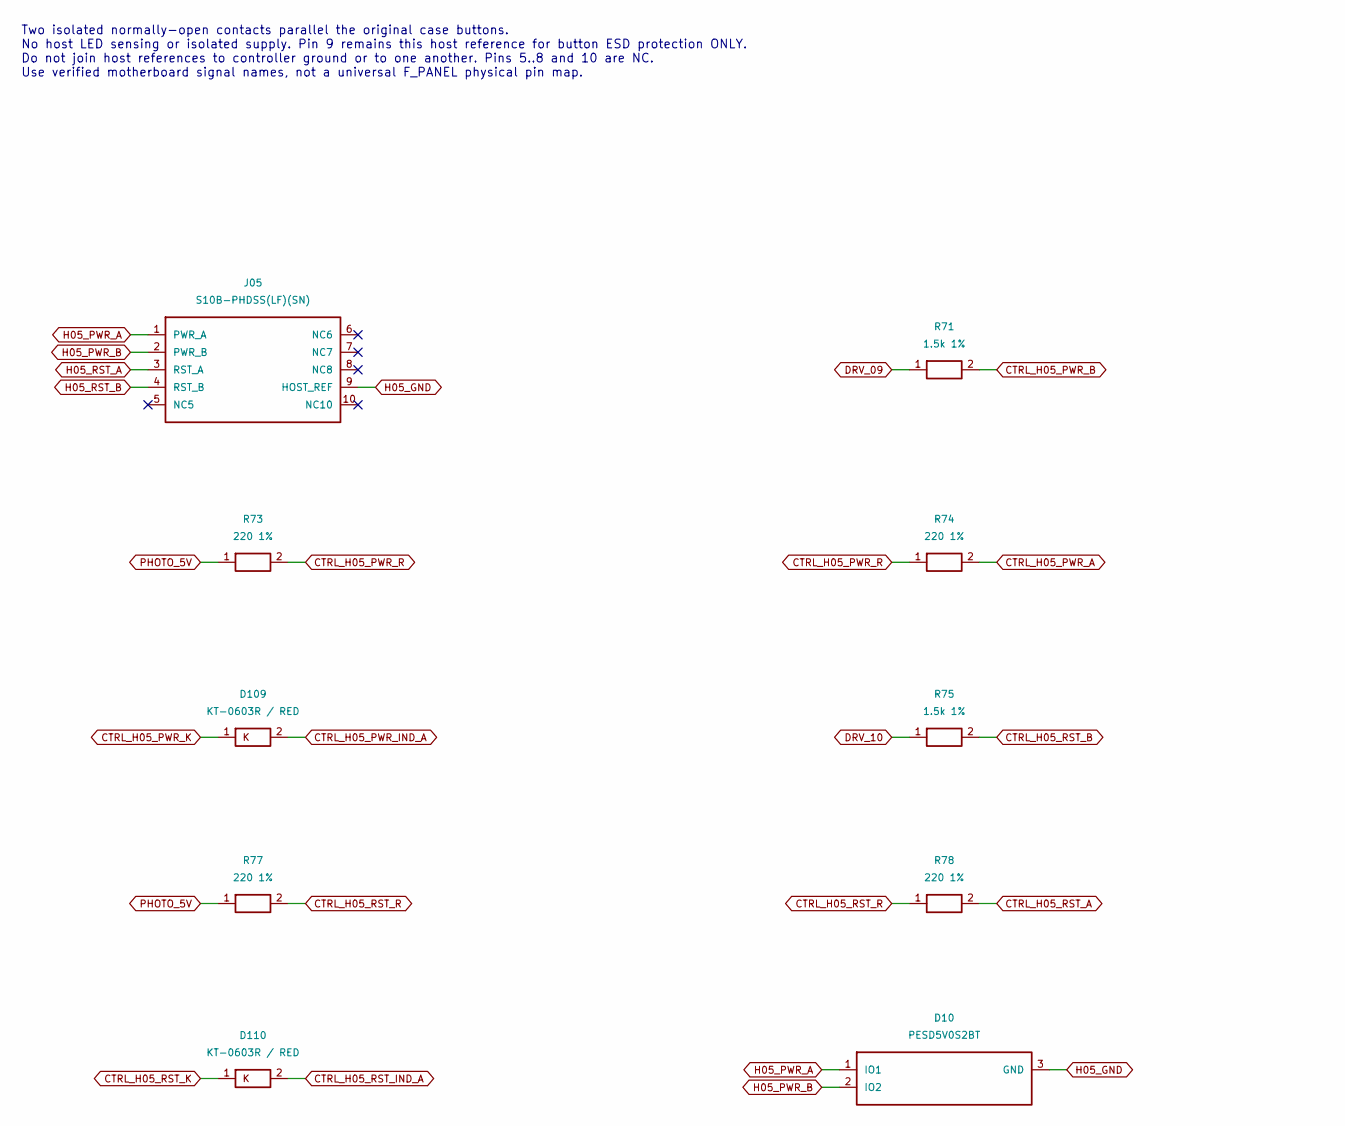
[picture p99: schematic host05.kicad_sch, Host 05: POWER / RESET only, part in row 1, column 1]

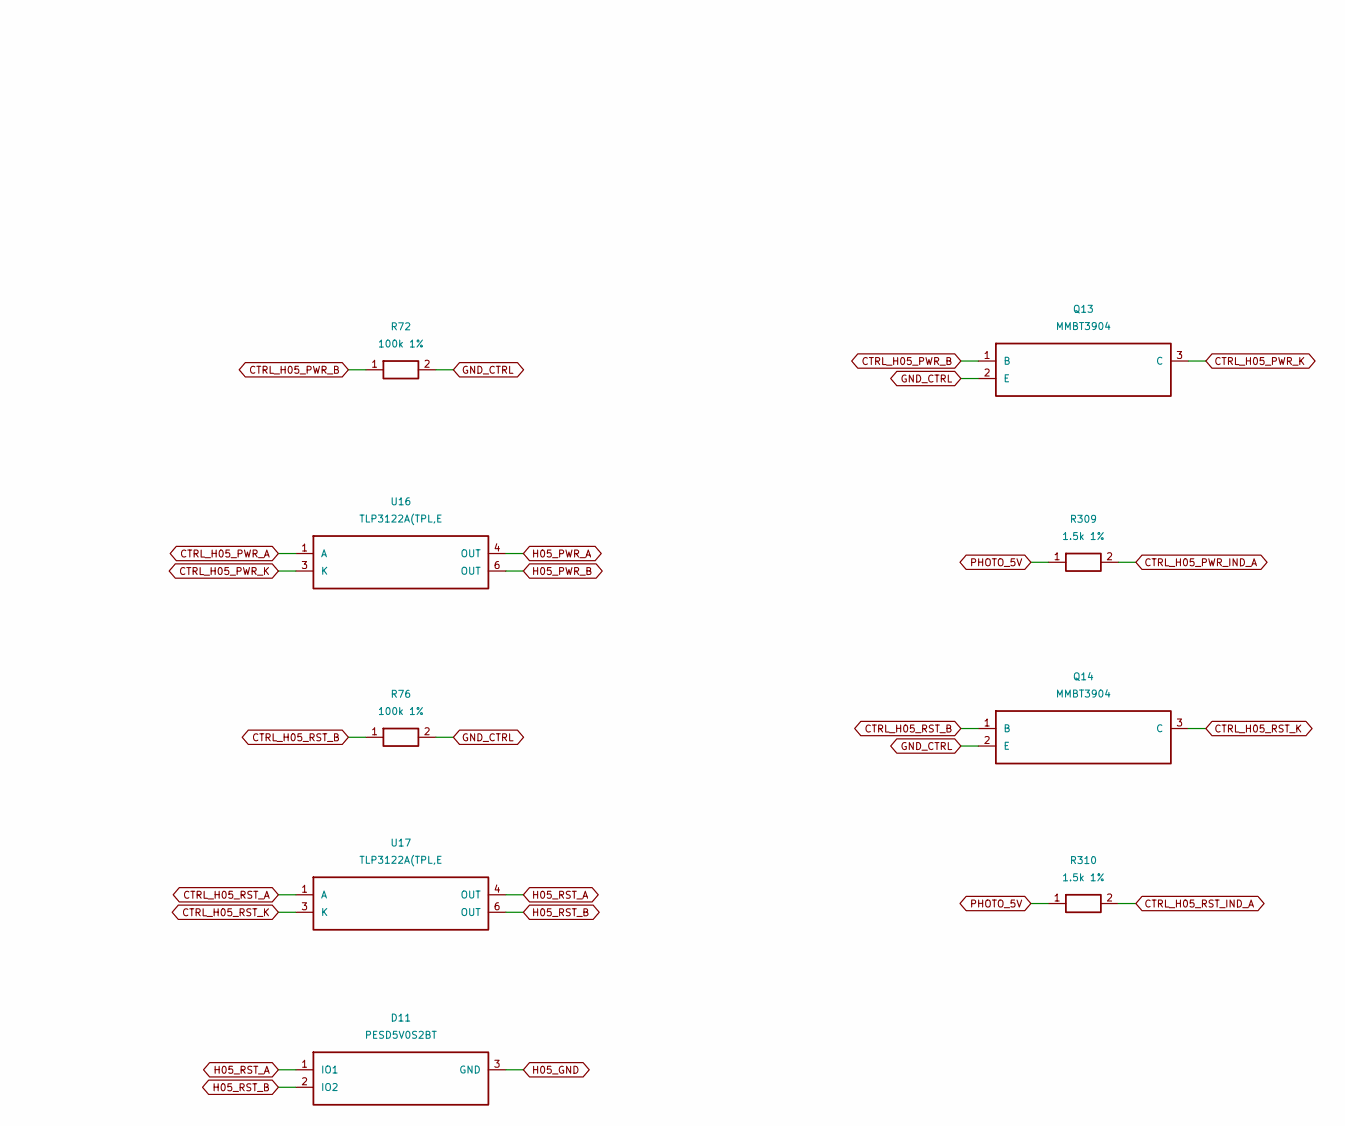
[picture p100: schematic host05.kicad_sch, Host 05: POWER / RESET only, part in row 1, column 2]

Parts:
D10, D11: PESD5V0S2BT; SOT-23; MPN PESD5V0S2BT; LCSC C2841440
D109, D110: KT-0603R / RED; LED_0603_1608Metric_CathodeSilk; MPN KT-0603R; LCSC C2286
J05: S10B-PHDSS(LF)(SN); JST_PHD_S10B-PHDSS_2x05_P2.00mm_Horizontal; MPN S10B-PHDSS(LF)(SN); LCSC C161672
Q13, Q14: MMBT3904; SOT-23; MPN MMBT3904(RANGE:100-300); LCSC C20526
R71, R75, R309, R310: 1.5k 1%; R_0603_1608Metric; MPN 0603WAF1501T5E; LCSC C22843
R72, R76: 100k 1%; R_0603_1608Metric; MPN 0603WAF1003T5E; LCSC C25803
R73, R74, R77, R78: 220 1%; R_0603_1608Metric; MPN 0603WAF2200T5E; LCSC C22962
U16, U17: TLP3122A(TPL,E; TLP3122A_11-4M1S; MPN TLP3122A(TPL,E; LCSC C4153843

Connections:
CTRL_H05_PWR_A: R74.2, U16.1 (A)
CTRL_H05_PWR_B: Q13.1 (B), R71.2, R72.1
CTRL_H05_PWR_IND_A: D109.2 (A), R309.2
CTRL_H05_PWR_K: D109.1 (K), Q13.3 (C), U16.3 (K)
CTRL_H05_PWR_R: R73.2, R74.1
CTRL_H05_RST_A: R78.2, U17.1 (A)
CTRL_H05_RST_B: Q14.1 (B), R75.2, R76.1
CTRL_H05_RST_IND_A: D110.2 (A), R310.2
CTRL_H05_RST_K: D110.1 (K), Q14.3 (C), U17.3 (K)
CTRL_H05_RST_R: R77.2, R78.1
DRV_09: R71.1; also elsewhere on the board
DRV_10: R75.1; also elsewhere on the board
GND_CTRL: Q13.2 (E), Q14.2 (E), R72.2, R76.2; also elsewhere on the board
H05_GND: D10.3 (GND), D11.3 (GND), J05.9 (HOST_REF)
H05_PWR_A: D10.1 (IO1), J05.1 (PWR_A), U16.4 (OUT)
H05_PWR_B: D10.2 (IO2), J05.2 (PWR_B), U16.6 (OUT)
H05_RST_A: D11.1 (IO1), J05.3 (RST_A), U17.4 (OUT)
H05_RST_B: D11.2 (IO2), J05.4 (RST_B), U17.6 (OUT)
PHOTO_5V: R73.1, R77.1, R309.1, R310.1; also elsewhere on the board

Notes on the sheet:
Two isolated normally-open contacts parallel the original case buttons. No host LED sensing or isolated supply. Pin 9 remains this host reference for button ESD protection ONLY. Do not join host references to controller ground or to one another. Pins 5..8 and 10 are NC. Use verified motherboard sig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

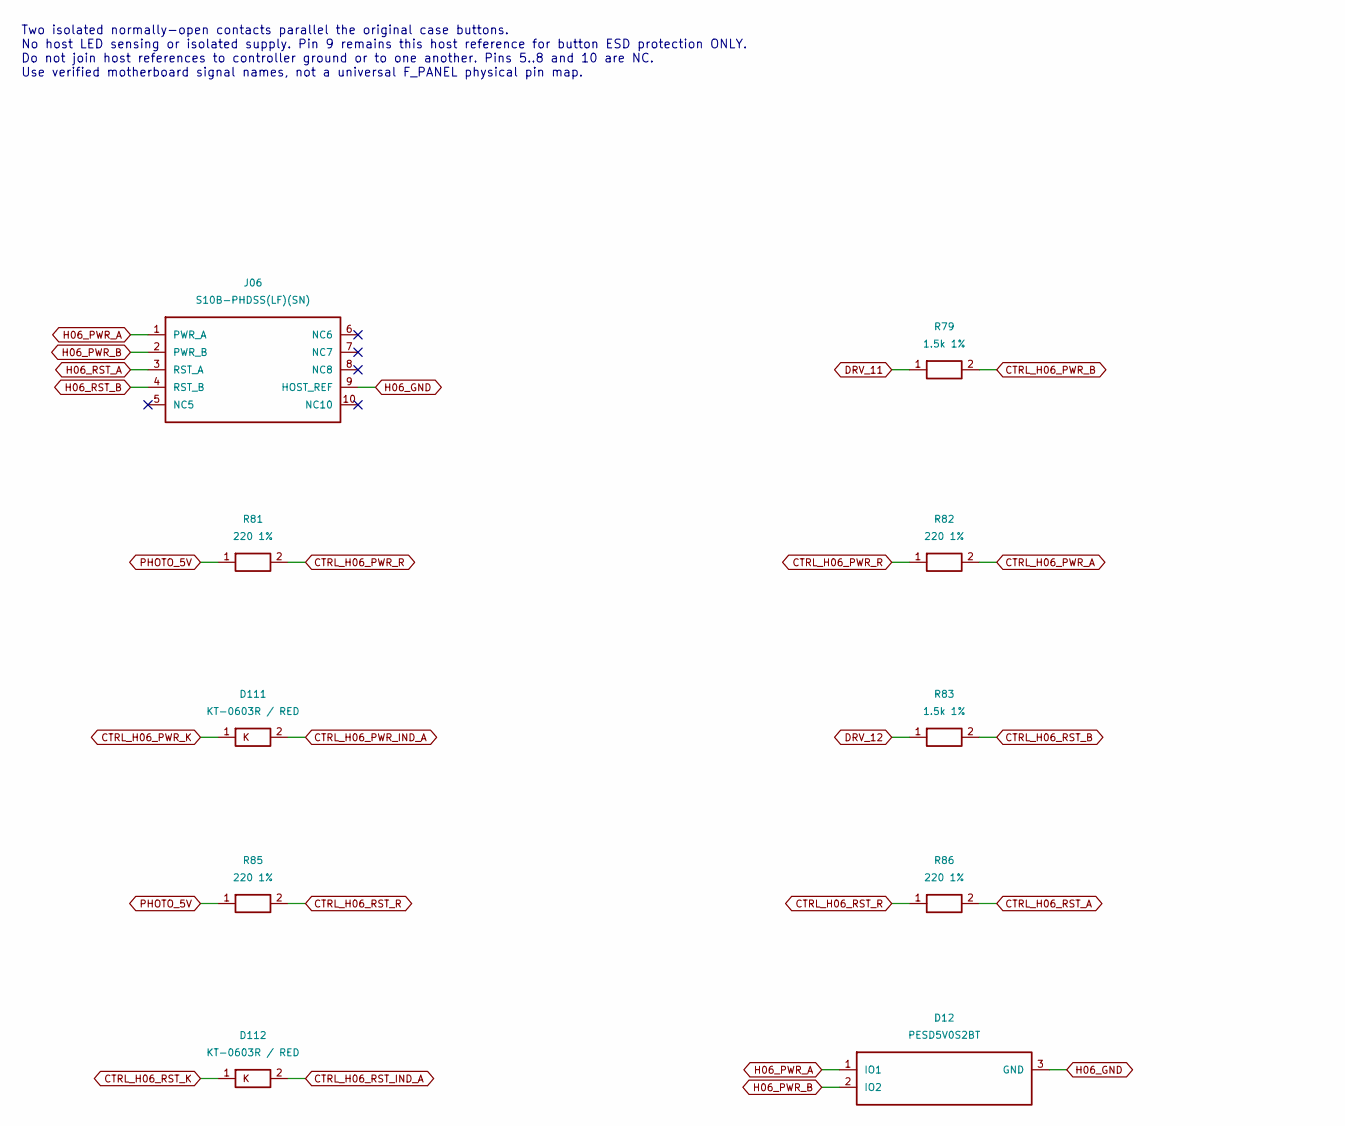
[picture p101: schematic host06.kicad_sch, Host 06: POWER / RESET only, part in row 1, column 1]

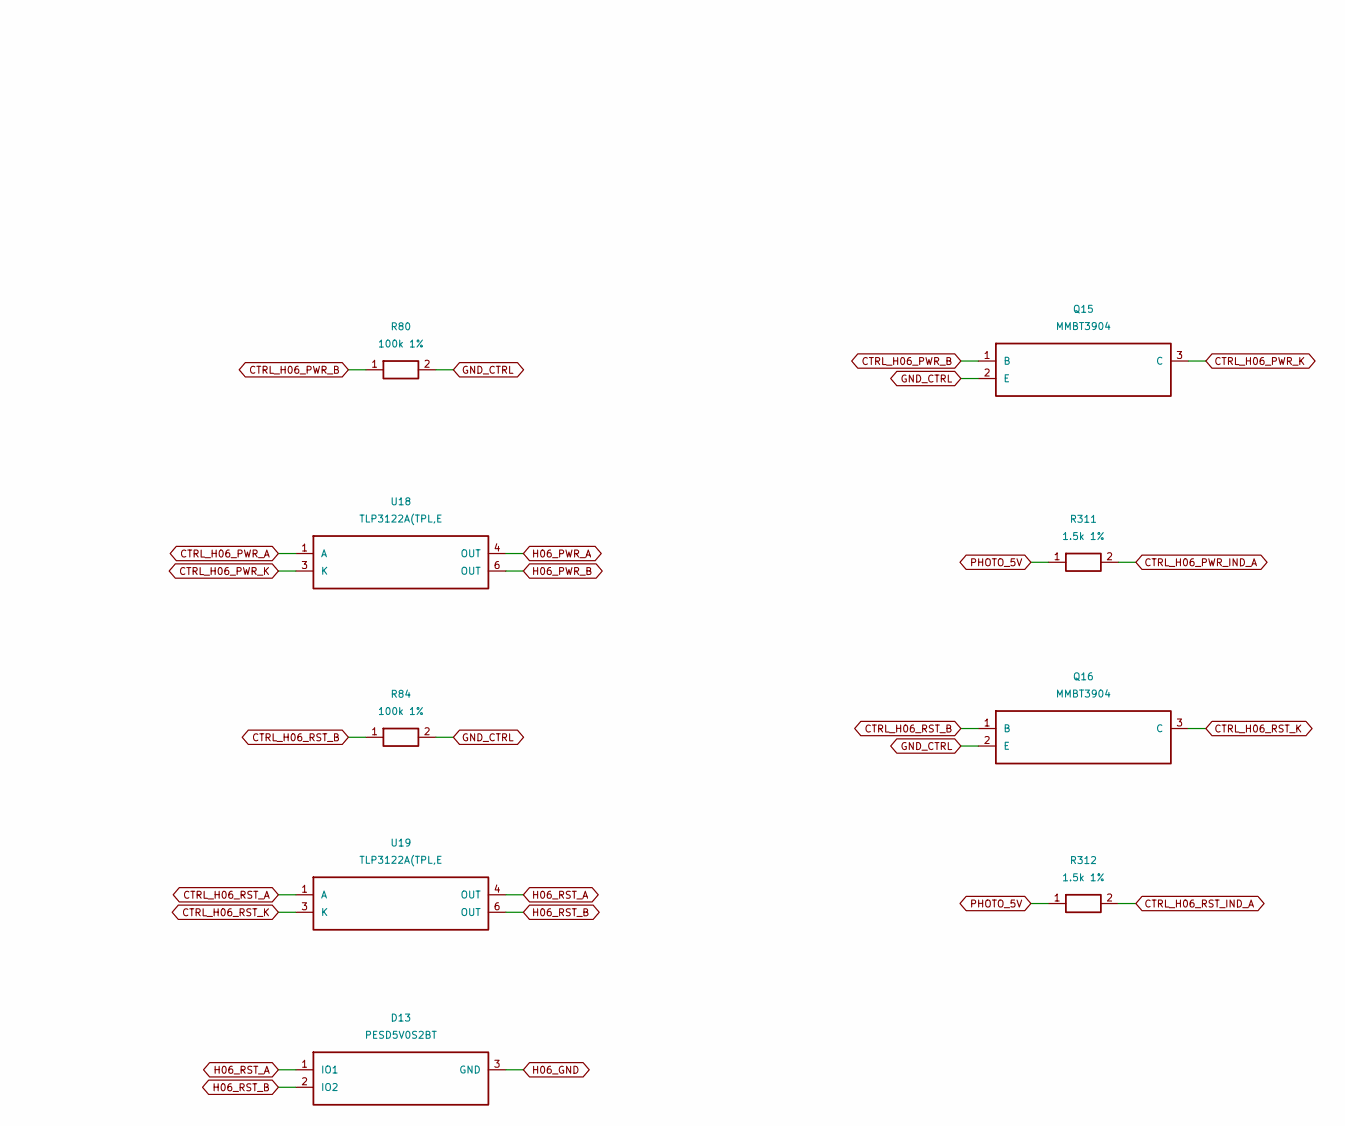
[picture p102: schematic host06.kicad_sch, Host 06: POWER / RESET only, part in row 1, column 2]

Parts:
D12, D13: PESD5V0S2BT; SOT-23; MPN PESD5V0S2BT; LCSC C2841440
D111, D112: KT-0603R / RED; LED_0603_1608Metric_CathodeSilk; MPN KT-0603R; LCSC C2286
J06: S10B-PHDSS(LF)(SN); JST_PHD_S10B-PHDSS_2x05_P2.00mm_Horizontal; MPN S10B-PHDSS(LF)(SN); LCSC C161672
Q15, Q16: MMBT3904; SOT-23; MPN MMBT3904(RANGE:100-300); LCSC C20526
R79, R83, R311, R312: 1.5k 1%; R_0603_1608Metric; MPN 0603WAF1501T5E; LCSC C22843
R80, R84: 100k 1%; R_0603_1608Metric; MPN 0603WAF1003T5E; LCSC C25803
R81, R82, R85, R86: 220 1%; R_0603_1608Metric; MPN 0603WAF2200T5E; LCSC C22962
U18, U19: TLP3122A(TPL,E; TLP3122A_11-4M1S; MPN TLP3122A(TPL,E; LCSC C4153843

Connections:
CTRL_H06_PWR_A: R82.2, U18.1 (A)
CTRL_H06_PWR_B: Q15.1 (B), R79.2, R80.1
CTRL_H06_PWR_IND_A: D111.2 (A), R311.2
CTRL_H06_PWR_K: D111.1 (K), Q15.3 (C), U18.3 (K)
CTRL_H06_PWR_R: R81.2, R82.1
CTRL_H06_RST_A: R86.2, U19.1 (A)
CTRL_H06_RST_B: Q16.1 (B), R83.2, R84.1
CTRL_H06_RST_IND_A: D112.2 (A), R312.2
CTRL_H06_RST_K: D112.1 (K), Q16.3 (C), U19.3 (K)
CTRL_H06_RST_R: R85.2, R86.1
DRV_11: R79.1; also elsewhere on the board
DRV_12: R83.1; also elsewhere on the board
GND_CTRL: Q15.2 (E), Q16.2 (E), R80.2, R84.2; also elsewhere on the board
H06_GND: D12.3 (GND), D13.3 (GND), J06.9 (HOST_REF)
H06_PWR_A: D12.1 (IO1), J06.1 (PWR_A), U18.4 (OUT)
H06_PWR_B: D12.2 (IO2), J06.2 (PWR_B), U18.6 (OUT)
H06_RST_A: D13.1 (IO1), J06.3 (RST_A), U19.4 (OUT)
H06_RST_B: D13.2 (IO2), J06.4 (RST_B), U19.6 (OUT)
PHOTO_5V: R81.1, R85.1, R311.1, R312.1; also elsewhere on the board

Notes on the sheet:
Two isolated normally-open contacts parallel the original case buttons. No host LED sensing or isolated supply. Pin 9 remains this host reference for button ESD protection ONLY. Do not join host references to controller ground or to one another. Pins 5..8 and 10 are NC. Use verified motherboard sig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

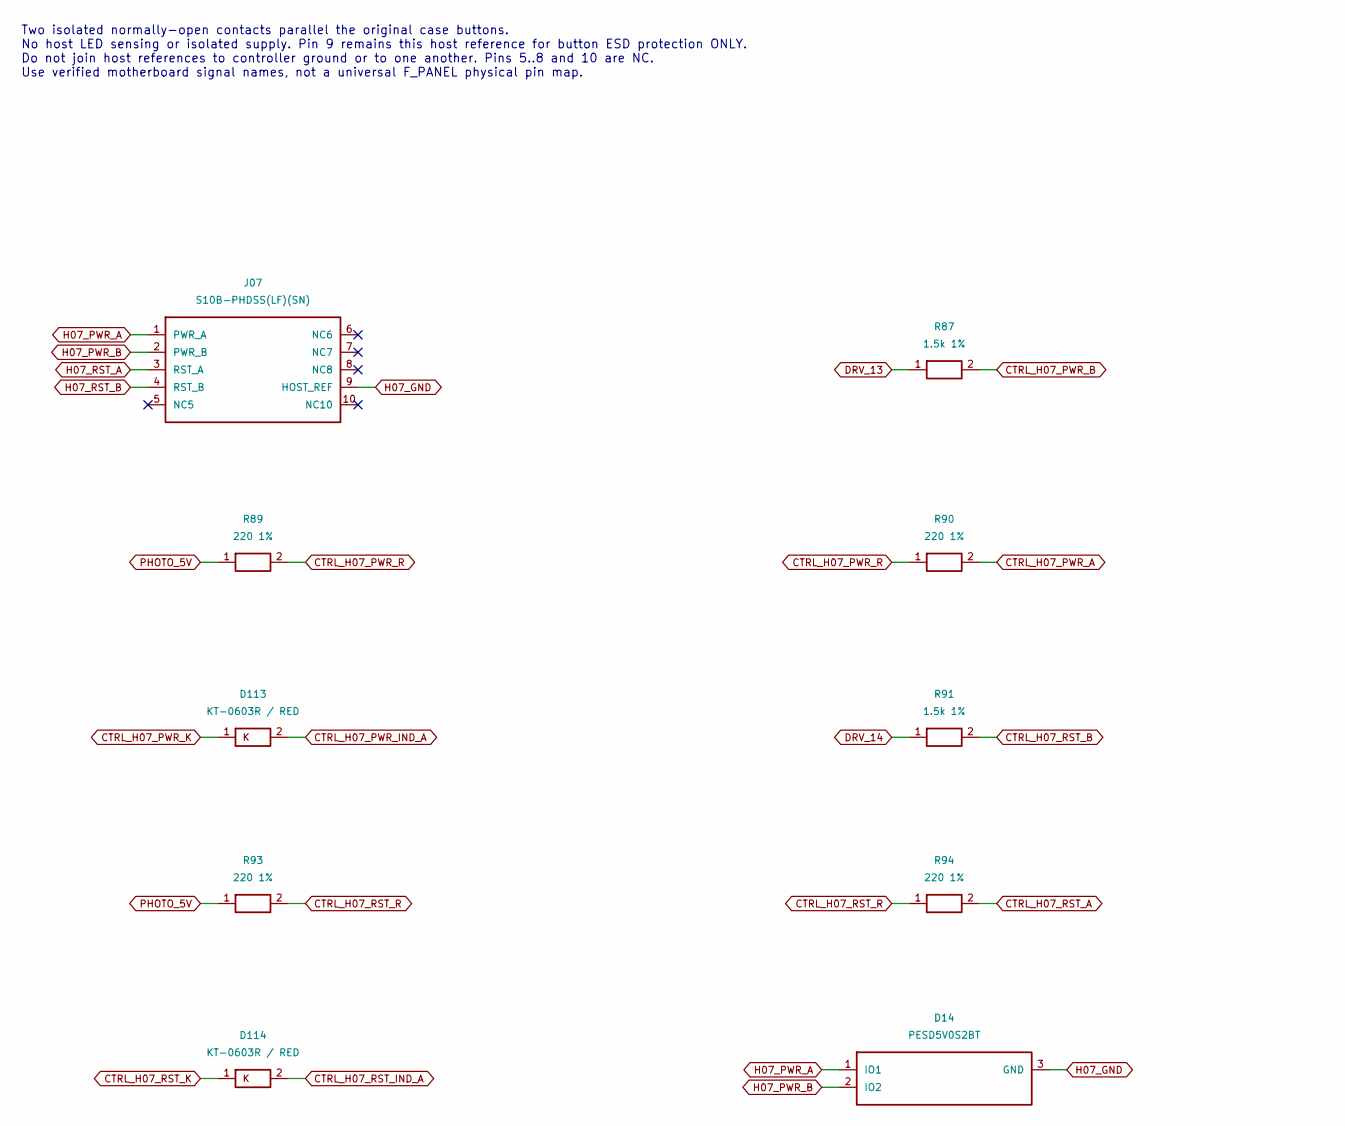
[picture p103: schematic host07.kicad_sch, Host 07: POWER / RESET only, part in row 1, column 1]

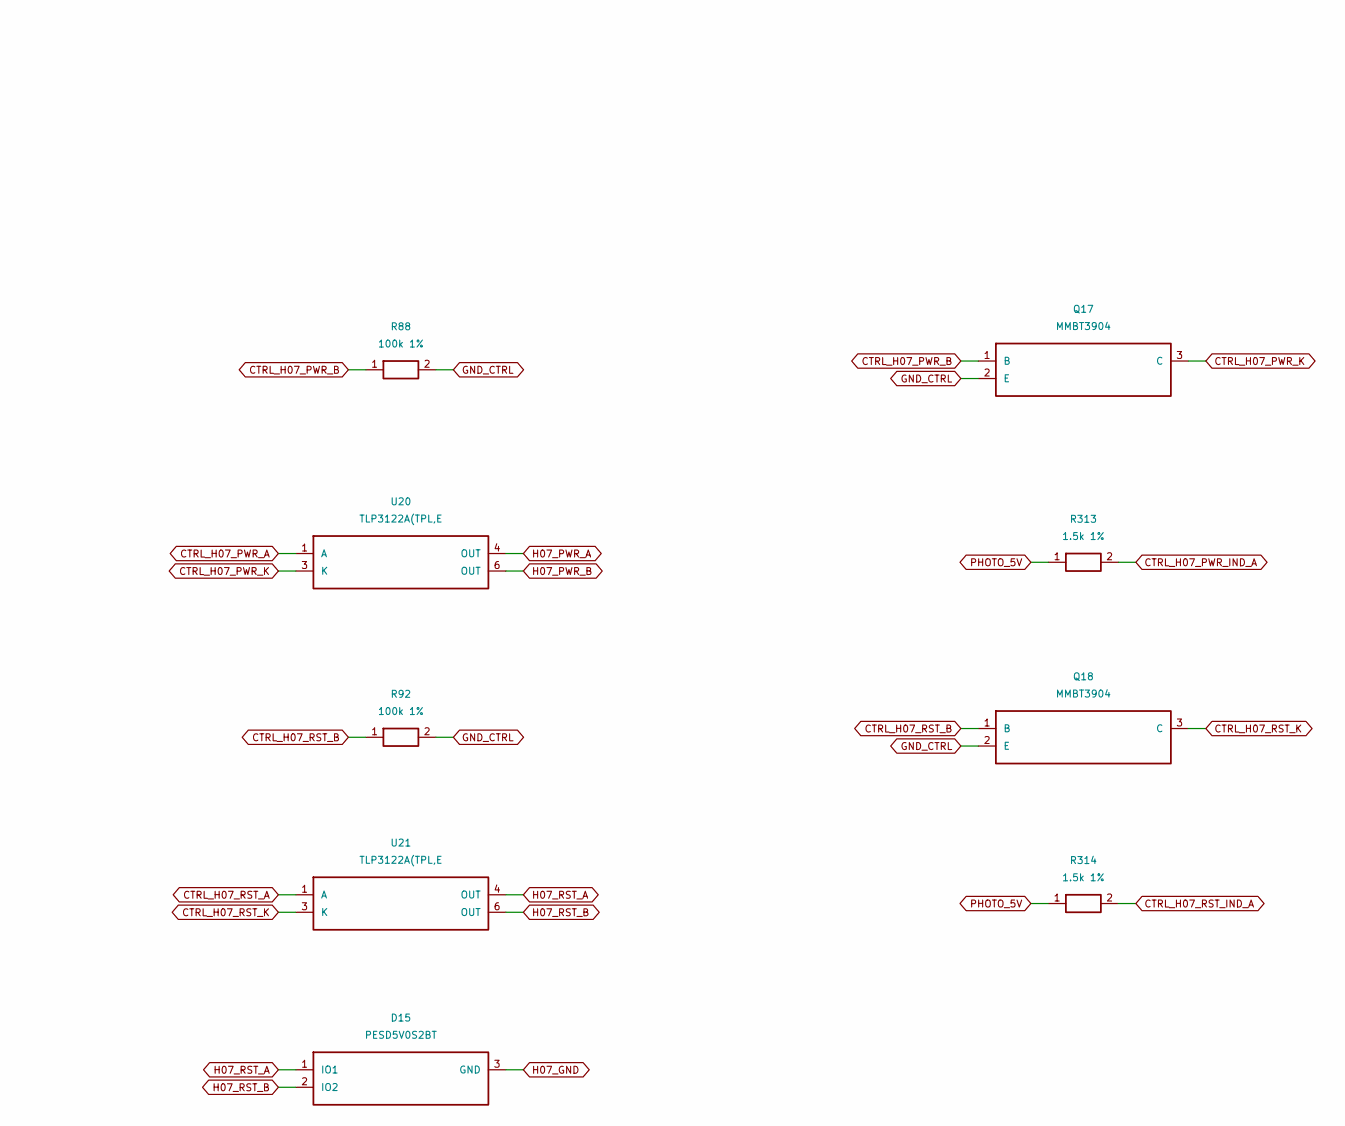
[picture p104: schematic host07.kicad_sch, Host 07: POWER / RESET only, part in row 1, column 2]

Parts:
D14, D15: PESD5V0S2BT; SOT-23; MPN PESD5V0S2BT; LCSC C2841440
D113, D114: KT-0603R / RED; LED_0603_1608Metric_CathodeSilk; MPN KT-0603R; LCSC C2286
J07: S10B-PHDSS(LF)(SN); JST_PHD_S10B-PHDSS_2x05_P2.00mm_Horizontal; MPN S10B-PHDSS(LF)(SN); LCSC C161672
Q17, Q18: MMBT3904; SOT-23; MPN MMBT3904(RANGE:100-300); LCSC C20526
R87, R91, R313, R314: 1.5k 1%; R_0603_1608Metric; MPN 0603WAF1501T5E; LCSC C22843
R88, R92: 100k 1%; R_0603_1608Metric; MPN 0603WAF1003T5E; LCSC C25803
R89, R90, R93, R94: 220 1%; R_0603_1608Metric; MPN 0603WAF2200T5E; LCSC C22962
U20, U21: TLP3122A(TPL,E; TLP3122A_11-4M1S; MPN TLP3122A(TPL,E; LCSC C4153843

Connections:
CTRL_H07_PWR_A: R90.2, U20.1 (A)
CTRL_H07_PWR_B: Q17.1 (B), R87.2, R88.1
CTRL_H07_PWR_IND_A: D113.2 (A), R313.2
CTRL_H07_PWR_K: D113.1 (K), Q17.3 (C), U20.3 (K)
CTRL_H07_PWR_R: R89.2, R90.1
CTRL_H07_RST_A: R94.2, U21.1 (A)
CTRL_H07_RST_B: Q18.1 (B), R91.2, R92.1
CTRL_H07_RST_IND_A: D114.2 (A), R314.2
CTRL_H07_RST_K: D114.1 (K), Q18.3 (C), U21.3 (K)
CTRL_H07_RST_R: R93.2, R94.1
DRV_13: R87.1; also elsewhere on the board
DRV_14: R91.1; also elsewhere on the board
GND_CTRL: Q17.2 (E), Q18.2 (E), R88.2, R92.2; also elsewhere on the board
H07_GND: D14.3 (GND), D15.3 (GND), J07.9 (HOST_REF)
H07_PWR_A: D14.1 (IO1), J07.1 (PWR_A), U20.4 (OUT)
H07_PWR_B: D14.2 (IO2), J07.2 (PWR_B), U20.6 (OUT)
H07_RST_A: D15.1 (IO1), J07.3 (RST_A), U21.4 (OUT)
H07_RST_B: D15.2 (IO2), J07.4 (RST_B), U21.6 (OUT)
PHOTO_5V: R89.1, R93.1, R313.1, R314.1; also elsewhere on the board

Notes on the sheet:
Two isolated normally-open contacts parallel the original case buttons. No host LED sensing or isolated supply. Pin 9 remains this host reference for button ESD protection ONLY. Do not join host references to controller ground or to one another. Pins 5..8 and 10 are NC. Use verified motherboard sig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

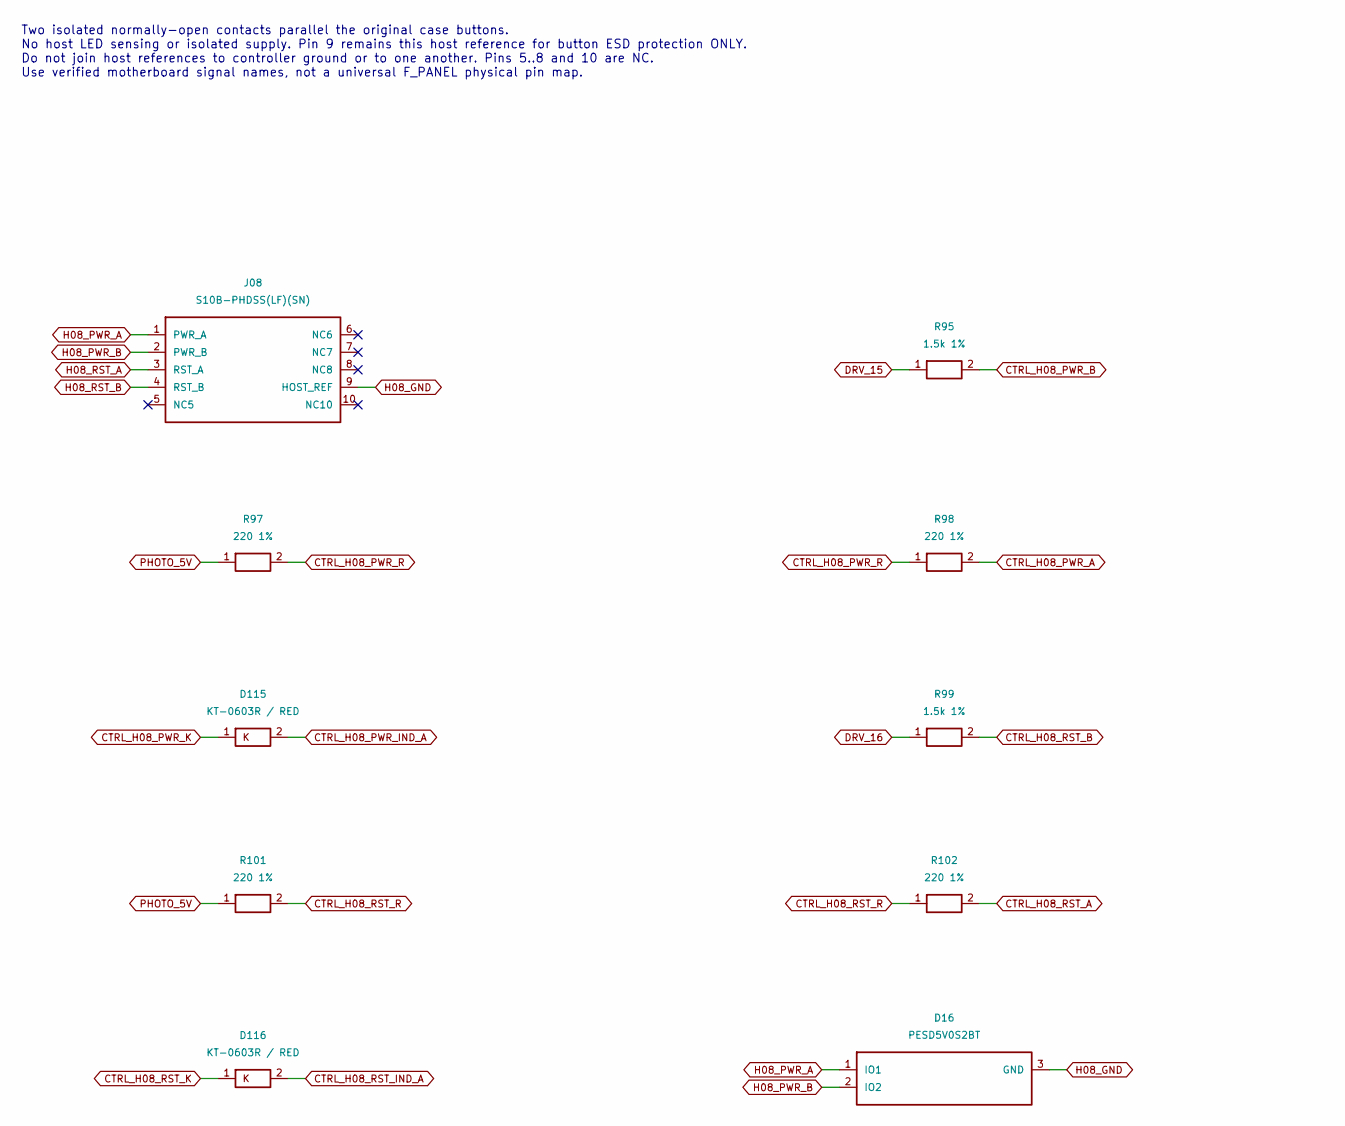
[picture p105: schematic host08.kicad_sch, Host 08: POWER / RESET only, part in row 1, column 1]

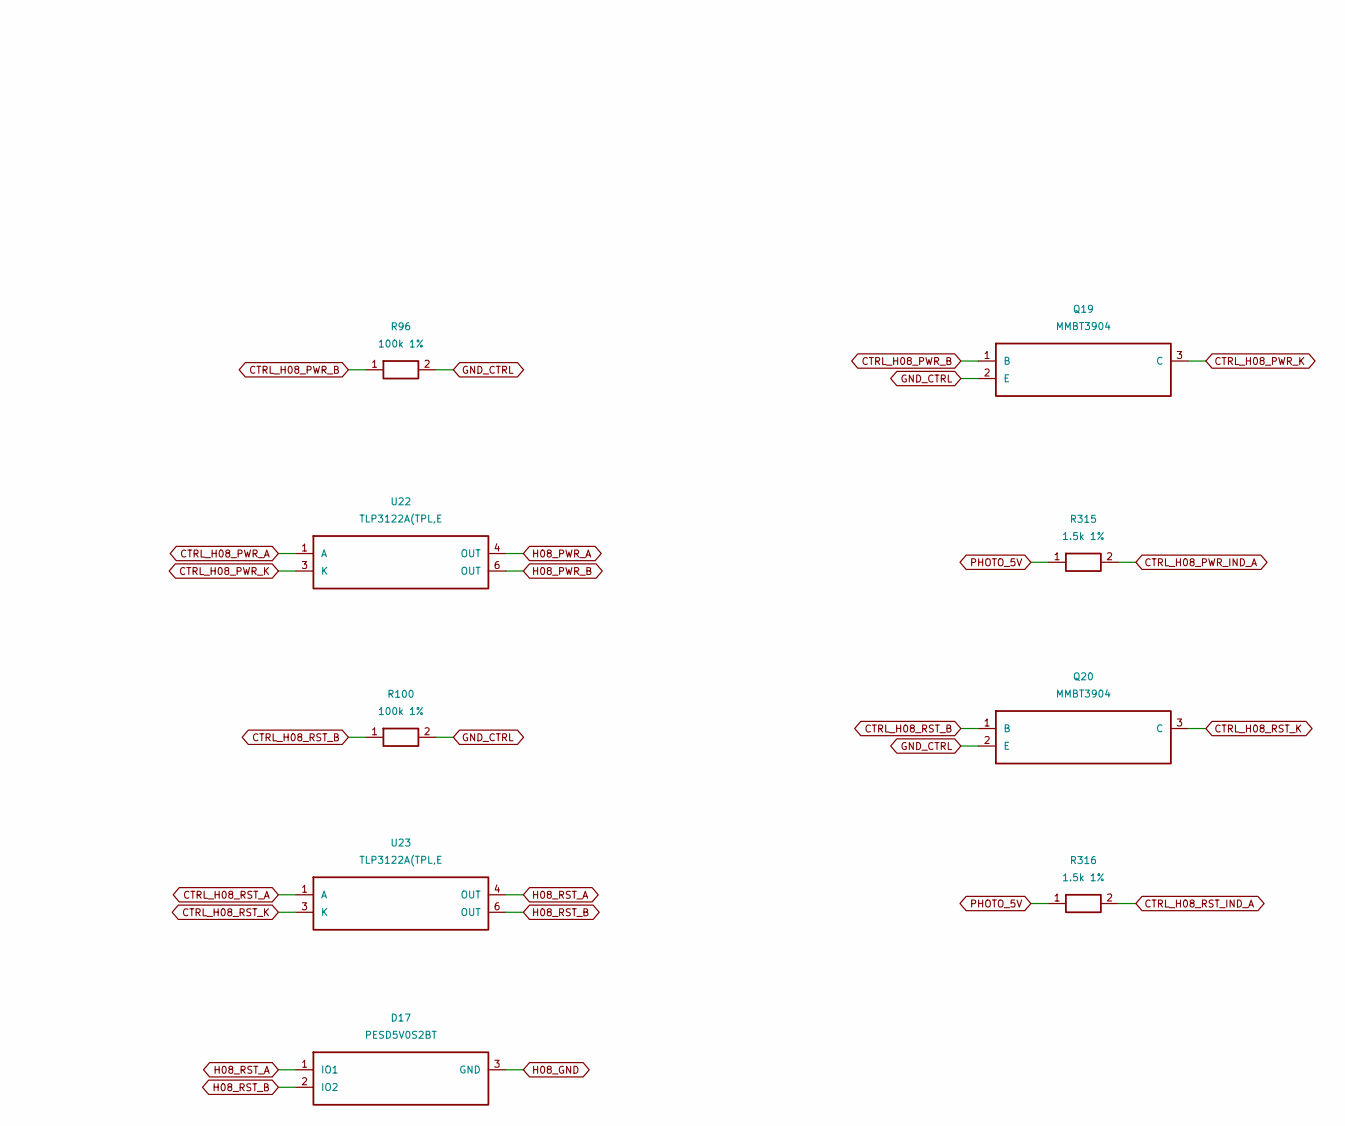
[picture p106: schematic host08.kicad_sch, Host 08: POWER / RESET only, part in row 1, column 2]

Parts:
D16, D17: PESD5V0S2BT; SOT-23; MPN PESD5V0S2BT; LCSC C2841440
D115, D116: KT-0603R / RED; LED_0603_1608Metric_CathodeSilk; MPN KT-0603R; LCSC C2286
J08: S10B-PHDSS(LF)(SN); JST_PHD_S10B-PHDSS_2x05_P2.00mm_Horizontal; MPN S10B-PHDSS(LF)(SN); LCSC C161672
Q19, Q20: MMBT3904; SOT-23; MPN MMBT3904(RANGE:100-300); LCSC C20526
R95, R99, R315, R316: 1.5k 1%; R_0603_1608Metric; MPN 0603WAF1501T5E; LCSC C22843
R96, R100: 100k 1%; R_0603_1608Metric; MPN 0603WAF1003T5E; LCSC C25803
R97, R98, R101, R102: 220 1%; R_0603_1608Metric; MPN 0603WAF2200T5E; LCSC C22962
U22, U23: TLP3122A(TPL,E; TLP3122A_11-4M1S; MPN TLP3122A(TPL,E; LCSC C4153843

Connections:
CTRL_H08_PWR_A: R98.2, U22.1 (A)
CTRL_H08_PWR_B: Q19.1 (B), R95.2, R96.1
CTRL_H08_PWR_IND_A: D115.2 (A), R315.2
CTRL_H08_PWR_K: D115.1 (K), Q19.3 (C), U22.3 (K)
CTRL_H08_PWR_R: R97.2, R98.1
CTRL_H08_RST_A: R102.2, U23.1 (A)
CTRL_H08_RST_B: Q20.1 (B), R99.2, R100.1
CTRL_H08_RST_IND_A: D116.2 (A), R316.2
CTRL_H08_RST_K: D116.1 (K), Q20.3 (C), U23.3 (K)
CTRL_H08_RST_R: R101.2, R102.1
DRV_15: R95.1; also elsewhere on the board
DRV_16: R99.1; also elsewhere on the board
GND_CTRL: Q19.2 (E), Q20.2 (E), R96.2, R100.2; also elsewhere on the board
H08_GND: D16.3 (GND), D17.3 (GND), J08.9 (HOST_REF)
H08_PWR_A: D16.1 (IO1), J08.1 (PWR_A), U22.4 (OUT)
H08_PWR_B: D16.2 (IO2), J08.2 (PWR_B), U22.6 (OUT)
H08_RST_A: D17.1 (IO1), J08.3 (RST_A), U23.4 (OUT)
H08_RST_B: D17.2 (IO2), J08.4 (RST_B), U23.6 (OUT)
PHOTO_5V: R97.1, R101.1, R315.1, R316.1; also elsewhere on the board

Notes on the sheet:
Two isolated normally-open contacts parallel the original case buttons. No host LED sensing or isolated supply. Pin 9 remains this host reference for button ESD protection ONLY. Do not join host references to controller ground or to one another. Pins 5..8 and 10 are NC. Use verified motherboard sig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
