ddasdkimo/rack-atx-controller/hardware/cad/B2/rack-atx-controller.kicad_pcb

## KiCad design hardware/cad/B2/rack-atx-controller.kicad_pcb (continued)

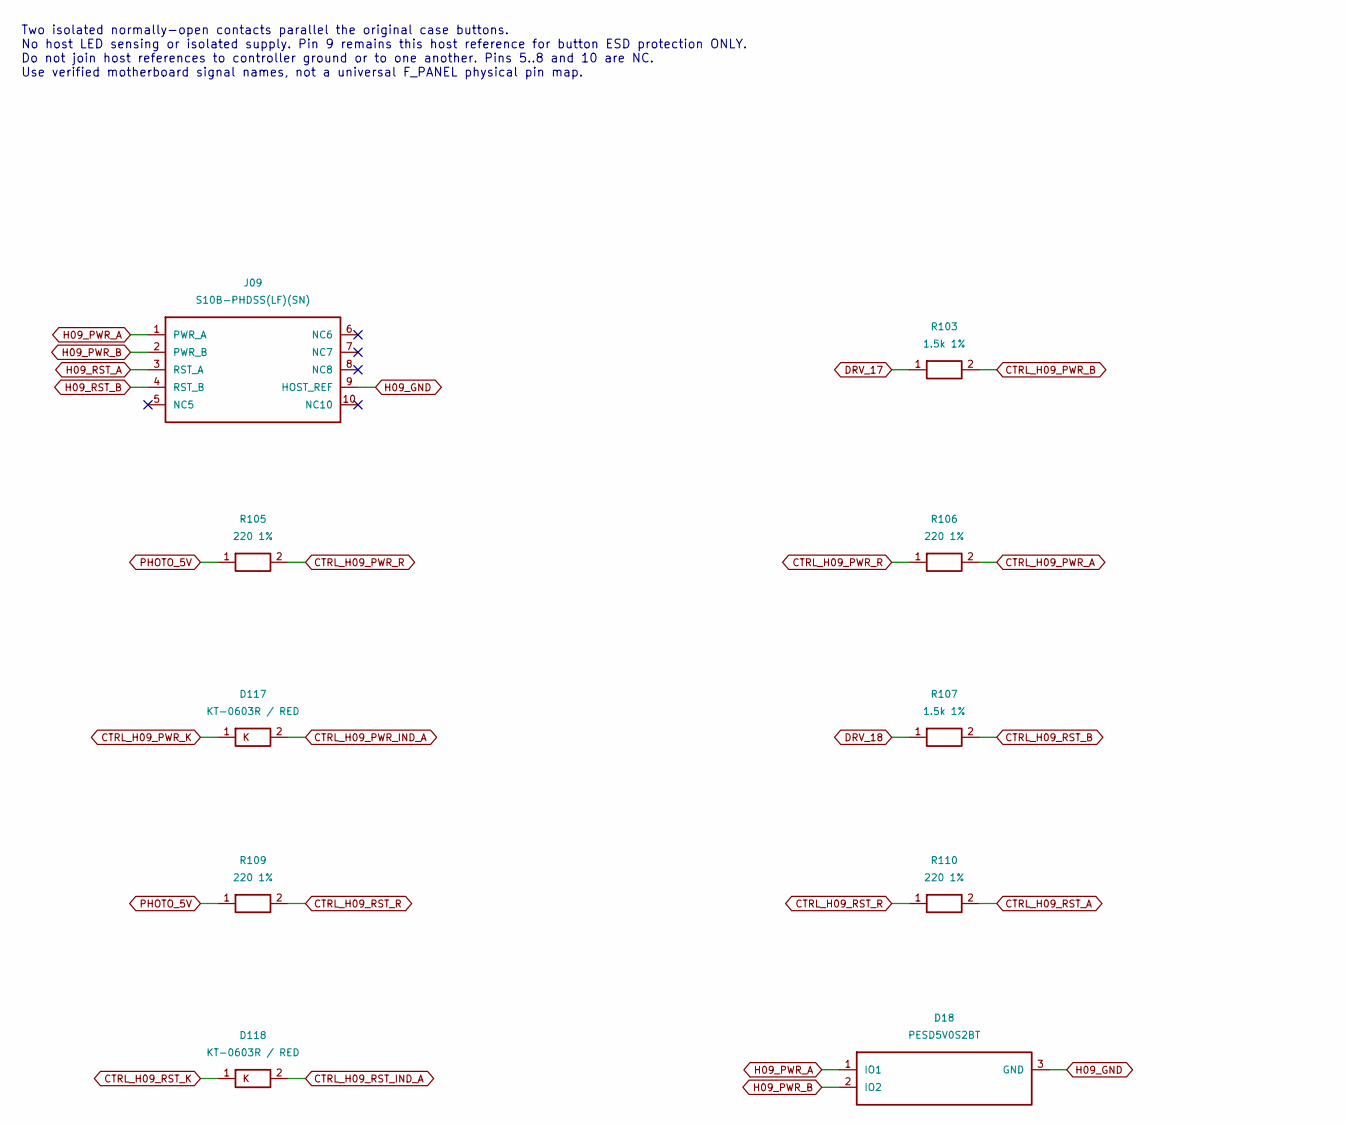
[picture p107: schematic host09.kicad_sch, Host 09: POWER / RESET only, part in row 1, column 1]

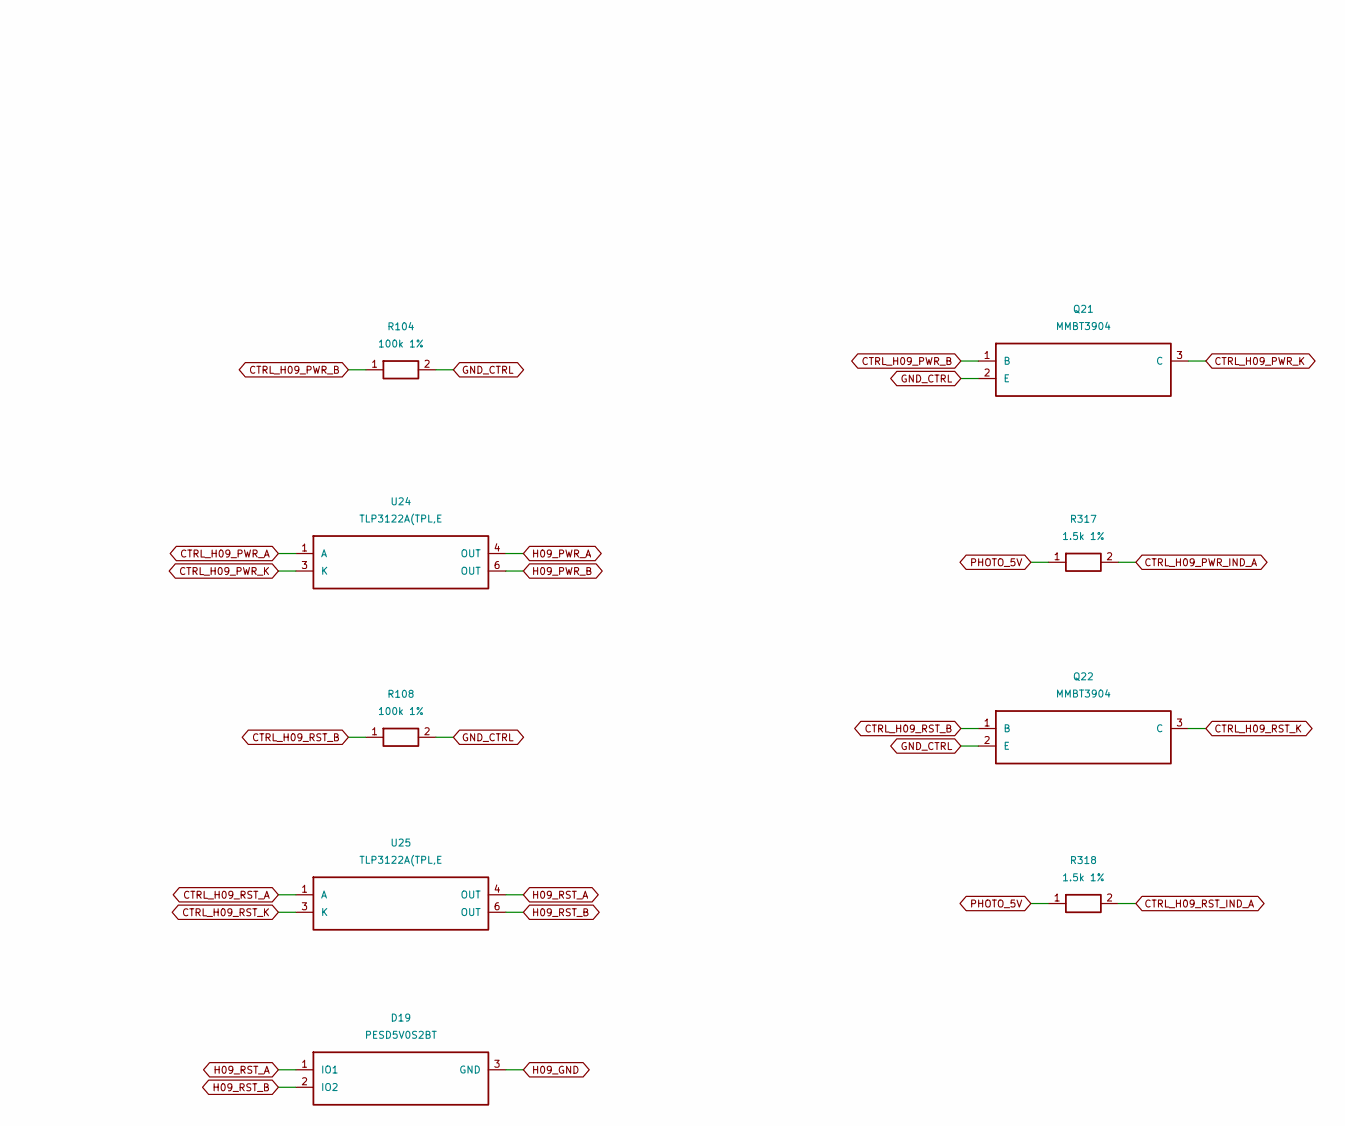
[picture p108: schematic host09.kicad_sch, Host 09: POWER / RESET only, part in row 1, column 2]

Parts:
D18, D19: PESD5V0S2BT; SOT-23; MPN PESD5V0S2BT; LCSC C2841440
D117, D118: KT-0603R / RED; LED_0603_1608Metric_CathodeSilk; MPN KT-0603R; LCSC C2286
J09: S10B-PHDSS(LF)(SN); JST_PHD_S10B-PHDSS_2x05_P2.00mm_Horizontal; MPN S10B-PHDSS(LF)(SN); LCSC C161672
Q21, Q22: MMBT3904; SOT-23; MPN MMBT3904(RANGE:100-300); LCSC C20526
R103, R107, R317, R318: 1.5k 1%; R_0603_1608Metric; MPN 0603WAF1501T5E; LCSC C22843
R104, R108: 100k 1%; R_0603_1608Metric; MPN 0603WAF1003T5E; LCSC C25803
R105, R106, R109, R110: 220 1%; R_0603_1608Metric; MPN 0603WAF2200T5E; LCSC C22962
U24, U25: TLP3122A(TPL,E; TLP3122A_11-4M1S; MPN TLP3122A(TPL,E; LCSC C4153843

Connections:
CTRL_H09_PWR_A: R106.2, U24.1 (A)
CTRL_H09_PWR_B: Q21.1 (B), R103.2, R104.1
CTRL_H09_PWR_IND_A: D117.2 (A), R317.2
CTRL_H09_PWR_K: D117.1 (K), Q21.3 (C), U24.3 (K)
CTRL_H09_PWR_R: R105.2, R106.1
CTRL_H09_RST_A: R110.2, U25.1 (A)
CTRL_H09_RST_B: Q22.1 (B), R107.2, R108.1
CTRL_H09_RST_IND_A: D118.2 (A), R318.2
CTRL_H09_RST_K: D118.1 (K), Q22.3 (C), U25.3 (K)
CTRL_H09_RST_R: R109.2, R110.1
DRV_17: R103.1; also elsewhere on the board
DRV_18: R107.1; also elsewhere on the board
GND_CTRL: Q21.2 (E), Q22.2 (E), R104.2, R108.2; also elsewhere on the board
H09_GND: D18.3 (GND), D19.3 (GND), J09.9 (HOST_REF)
H09_PWR_A: D18.1 (IO1), J09.1 (PWR_A), U24.4 (OUT)
H09_PWR_B: D18.2 (IO2), J09.2 (PWR_B), U24.6 (OUT)
H09_RST_A: D19.1 (IO1), J09.3 (RST_A), U25.4 (OUT)
H09_RST_B: D19.2 (IO2), J09.4 (RST_B), U25.6 (OUT)
PHOTO_5V: R105.1, R109.1, R317.1, R318.1; also elsewhere on the board

Notes on the sheet:
Two isolated normally-open contacts parallel the original case buttons. No host LED sensing or isolated supply. Pin 9 remains this host reference for button ESD protection ONLY. Do not join host references to controller ground or to one another. Pins 5..8 and 10 are NC. Use verified motherboard sig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

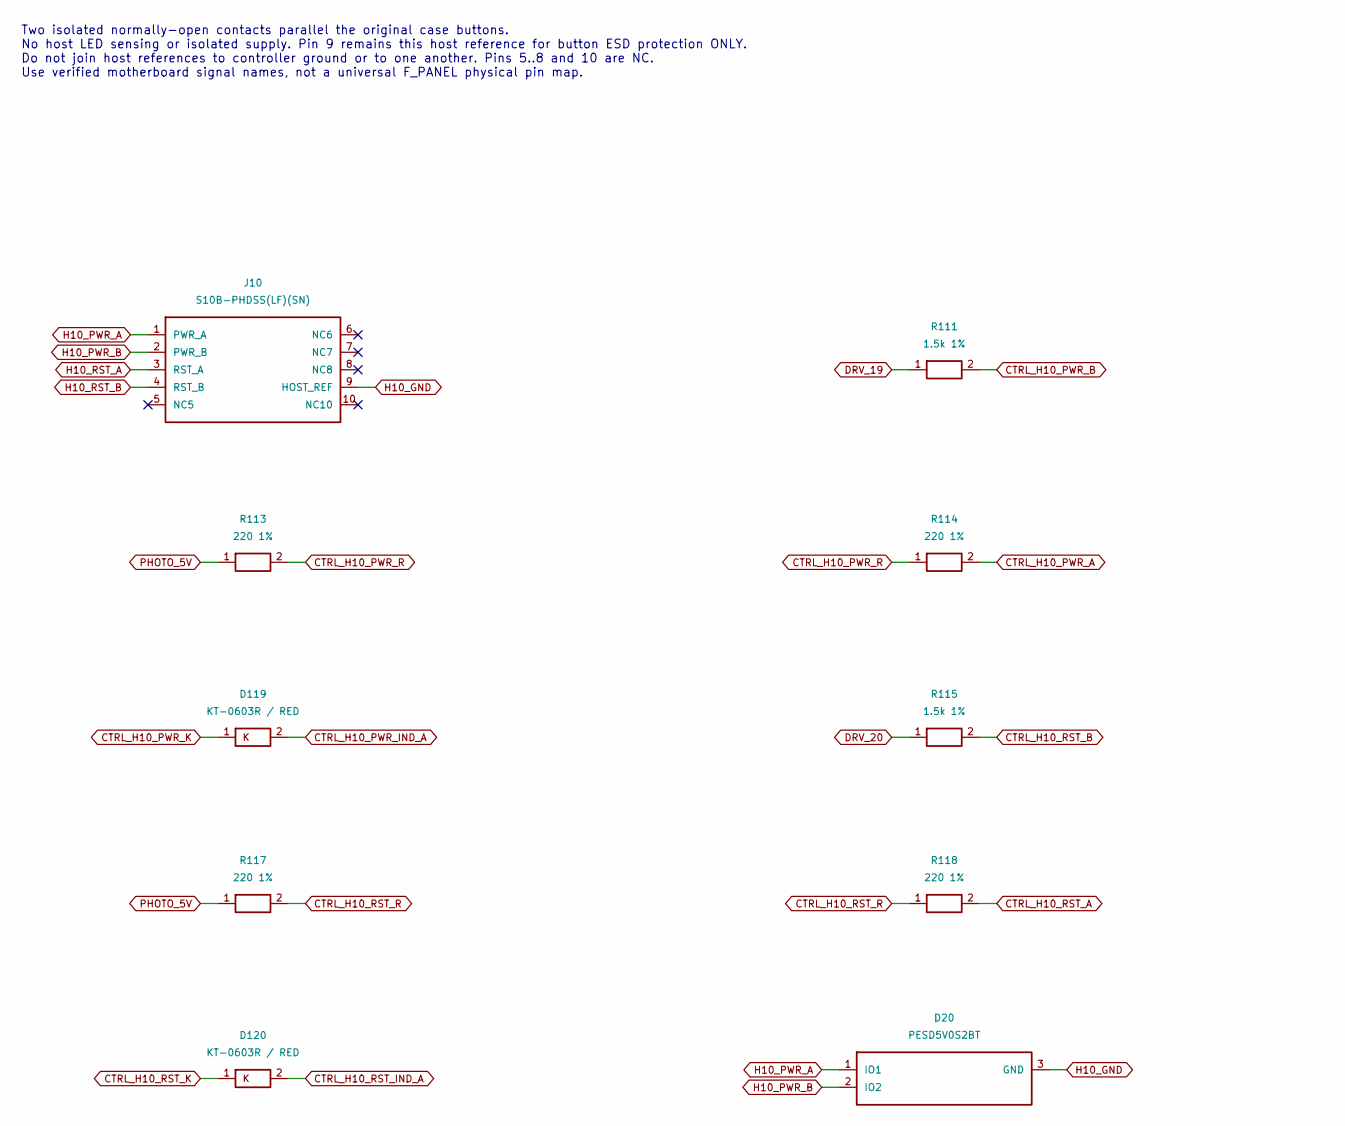
[picture p109: schematic host10.kicad_sch, Host 10: POWER / RESET only, part in row 1, column 1]

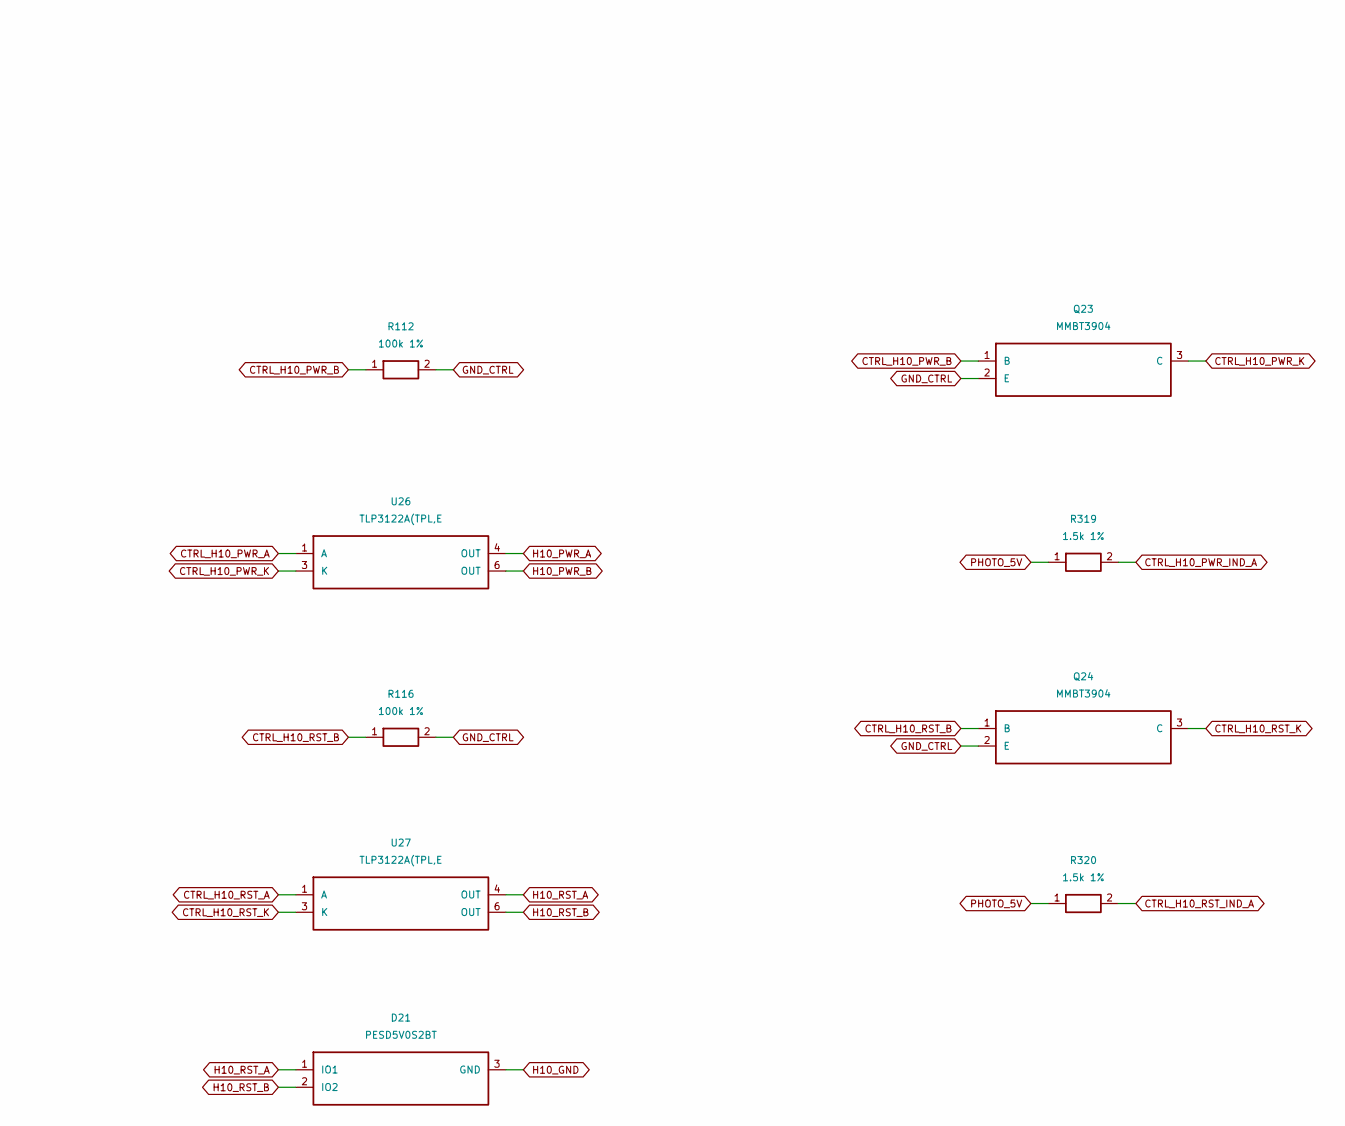
[picture p110: schematic host10.kicad_sch, Host 10: POWER / RESET only, part in row 1, column 2]

Parts:
D20, D21: PESD5V0S2BT; SOT-23; MPN PESD5V0S2BT; LCSC C2841440
D119, D120: KT-0603R / RED; LED_0603_1608Metric_CathodeSilk; MPN KT-0603R; LCSC C2286
J10: S10B-PHDSS(LF)(SN); JST_PHD_S10B-PHDSS_2x05_P2.00mm_Horizontal; MPN S10B-PHDSS(LF)(SN); LCSC C161672
Q23, Q24: MMBT3904; SOT-23; MPN MMBT3904(RANGE:100-300); LCSC C20526
R111, R115, R319, R320: 1.5k 1%; R_0603_1608Metric; MPN 0603WAF1501T5E; LCSC C22843
R112, R116: 100k 1%; R_0603_1608Metric; MPN 0603WAF1003T5E; LCSC C25803
R113, R114, R117, R118: 220 1%; R_0603_1608Metric; MPN 0603WAF2200T5E; LCSC C22962
U26, U27: TLP3122A(TPL,E; TLP3122A_11-4M1S; MPN TLP3122A(TPL,E; LCSC C4153843

Connections:
CTRL_H10_PWR_A: R114.2, U26.1 (A)
CTRL_H10_PWR_B: Q23.1 (B), R111.2, R112.1
CTRL_H10_PWR_IND_A: D119.2 (A), R319.2
CTRL_H10_PWR_K: D119.1 (K), Q23.3 (C), U26.3 (K)
CTRL_H10_PWR_R: R113.2, R114.1
CTRL_H10_RST_A: R118.2, U27.1 (A)
CTRL_H10_RST_B: Q24.1 (B), R115.2, R116.1
CTRL_H10_RST_IND_A: D120.2 (A), R320.2
CTRL_H10_RST_K: D120.1 (K), Q24.3 (C), U27.3 (K)
CTRL_H10_RST_R: R117.2, R118.1
DRV_19: R111.1; also elsewhere on the board
DRV_20: R115.1; also elsewhere on the board
GND_CTRL: Q23.2 (E), Q24.2 (E), R112.2, R116.2; also elsewhere on the board
H10_GND: D20.3 (GND), D21.3 (GND), J10.9 (HOST_REF)
H10_PWR_A: D20.1 (IO1), J10.1 (PWR_A), U26.4 (OUT)
H10_PWR_B: D20.2 (IO2), J10.2 (PWR_B), U26.6 (OUT)
H10_RST_A: D21.1 (IO1), J10.3 (RST_A), U27.4 (OUT)
H10_RST_B: D21.2 (IO2), J10.4 (RST_B), U27.6 (OUT)
PHOTO_5V: R113.1, R117.1, R319.1, R320.1; also elsewhere on the board

Notes on the sheet:
Two isolated normally-open contacts parallel the original case buttons. No host LED sensing or isolated supply. Pin 9 remains this host reference for button ESD protection ONLY. Do not join host references to controller ground or to one another. Pins 5..8 and 10 are NC. Use verified motherboard sig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

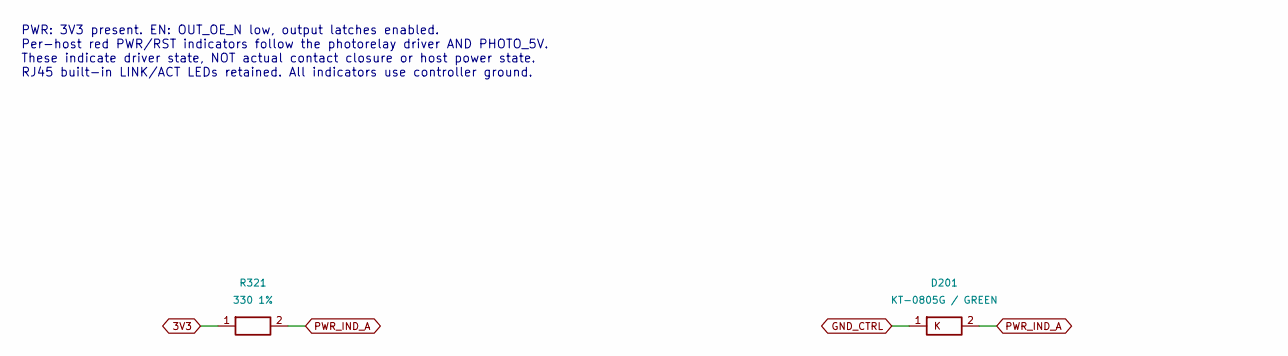
[picture p111: schematic indicators.kicad_sch, Controller power and output-enable indicators, part in row 1, column 1]

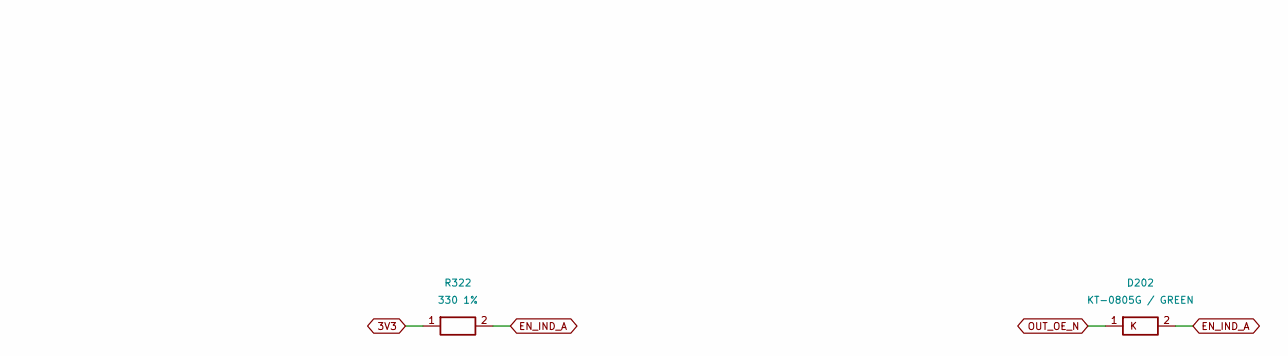
[picture p112: schematic indicators.kicad_sch, Controller power and output-enable indicators, part in row 1, column 2]

Parts:
D201, D202: KT-0805G / GREEN; LED_0805_2012Metric_CathodeSilk; MPN KT-0805G; LCSC C2297
R321, R322: 330 1%; R_0603_1608Metric; MPN 0603WAF3300T5E; LCSC C23138

Connections:
3V3: R321.1, R322.1; also elsewhere on the board
EN_IND_A: D202.2 (A), R322.2
GND_CTRL: D201.1 (K); also elsewhere on the board
OUT_OE_N: D202.1 (K); also elsewhere on the board
PWR_IND_A: D201.2 (A), R321.2

Notes on the sheet:
PWR: 3V3 present. EN: OUT_OE_N low, output latches enabled. Per-host red PWR/RST indicators follow the photorelay driver AND PHOTO_5V. These indicate driver state, NOT actual contact closure or host power state. RJ45 built-in LINK/ACT LEDs retained. All indicators use controller ground.

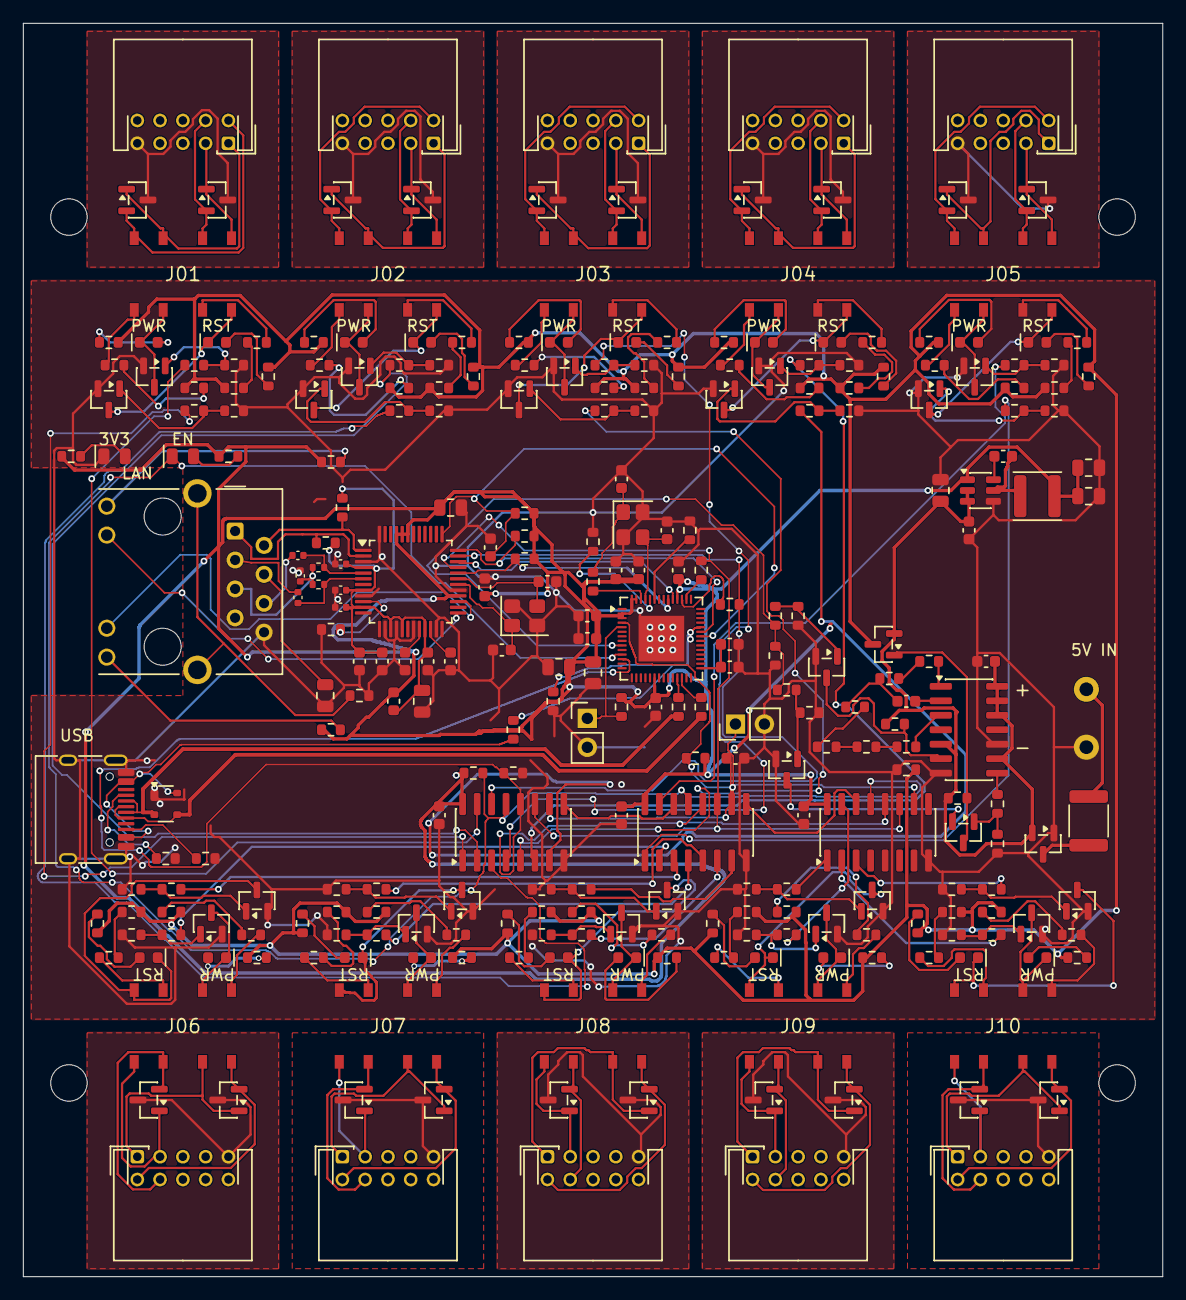
[picture p113: board rack-atx-controller.kicad_pcb from above]

Board: 2 copper layers, 100.0 x 110.0 mm, 304 parts (0 on the bottom side), 243 nets.

Other parts of the board:
MH1, MH2, MH3, MH4: MountingHole_3.2mm_M3
