ddasdkimo/rack-atx-controller/hardware/cad/B2/adapter.kicad_pcb

## KiCad design hardware/cad/B2/adapter.kicad_pcb (2026-10-14)

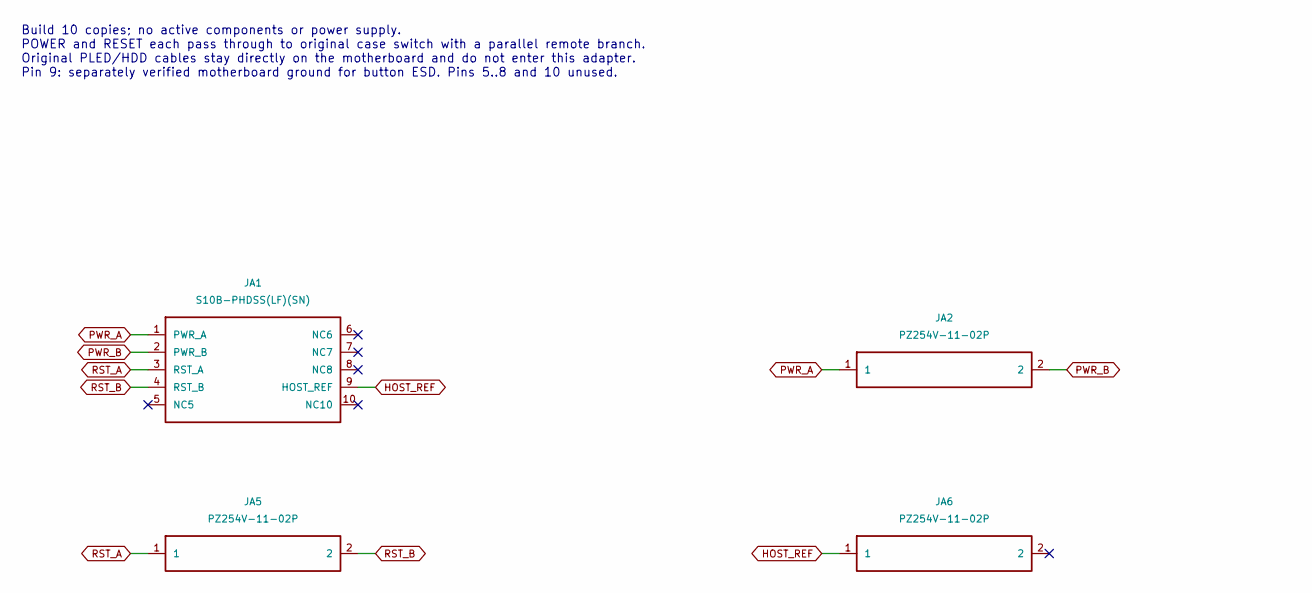
[picture p114: schematic adapter.kicad_sch, Passive POWER / RESET adapter, part in row 1, column 1]

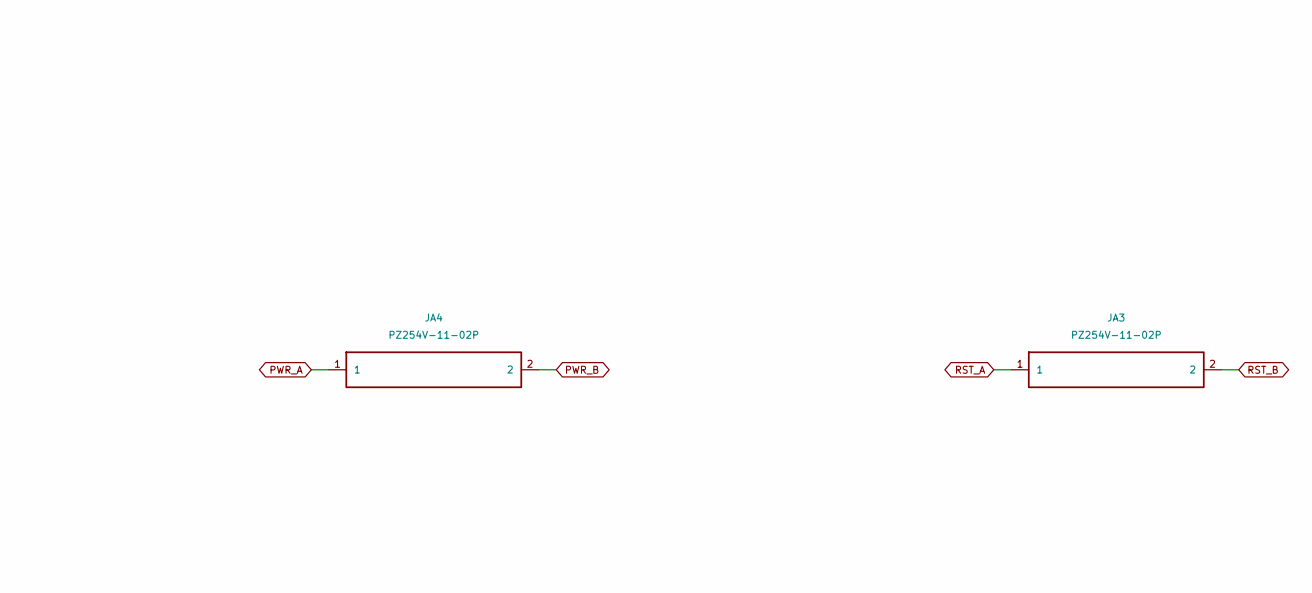
[picture p115: schematic adapter.kicad_sch, Passive POWER / RESET adapter, part in row 1, column 2]

Parts:
JA1: S10B-PHDSS(LF)(SN); JST_PHD_S10B-PHDSS_2x05_P2.00mm_Horizontal; MPN S10B-PHDSS(LF)(SN); LCSC C161672
JA2, JA3, JA4, JA5, JA6: PZ254V-11-02P; PinHeader_1x02_P2.54mm_Vertical; MPN PZ254V-11-02P; LCSC C492401

Connections:
HOST_REF: JA1.9 (HOST_REF), JA6.1
PWR_A: JA1.1 (PWR_A), JA2.1, JA4.1
PWR_B: JA1.2 (PWR_B), JA2.2, JA4.2
RST_A: JA1.3 (RST_A), JA3.1, JA5.1
RST_B: JA1.4 (RST_B), JA3.2, JA5.2

Notes on the sheet:
Build 10 copies; no active components or power supply. POWER and RESET each pass through to original case switch with a parallel remote branch. Original PLED/HDD cables stay directly on the motherboard and do not enter this adapter. Pin 9: separately verified motherboard ground for button ESD. Pins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

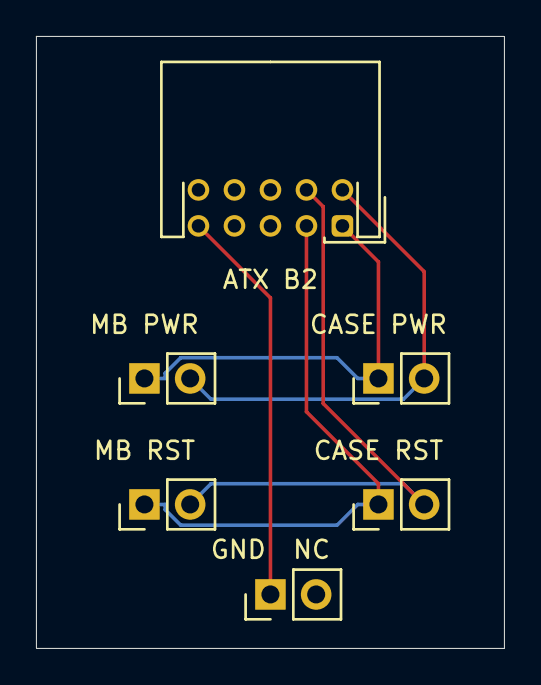
[picture p116: board adapter.kicad_pcb from above]

Board: 2 copper layers, 26.0 x 34.0 mm, 6 parts (0 on the bottom side), 5 nets.
