ddasdkimo/rack-atx-controller/hardware/cad/routing-R1.kicad_pcb

## KiCad design hardware/cad/routing-R1.kicad_pcb (2026-10-14)

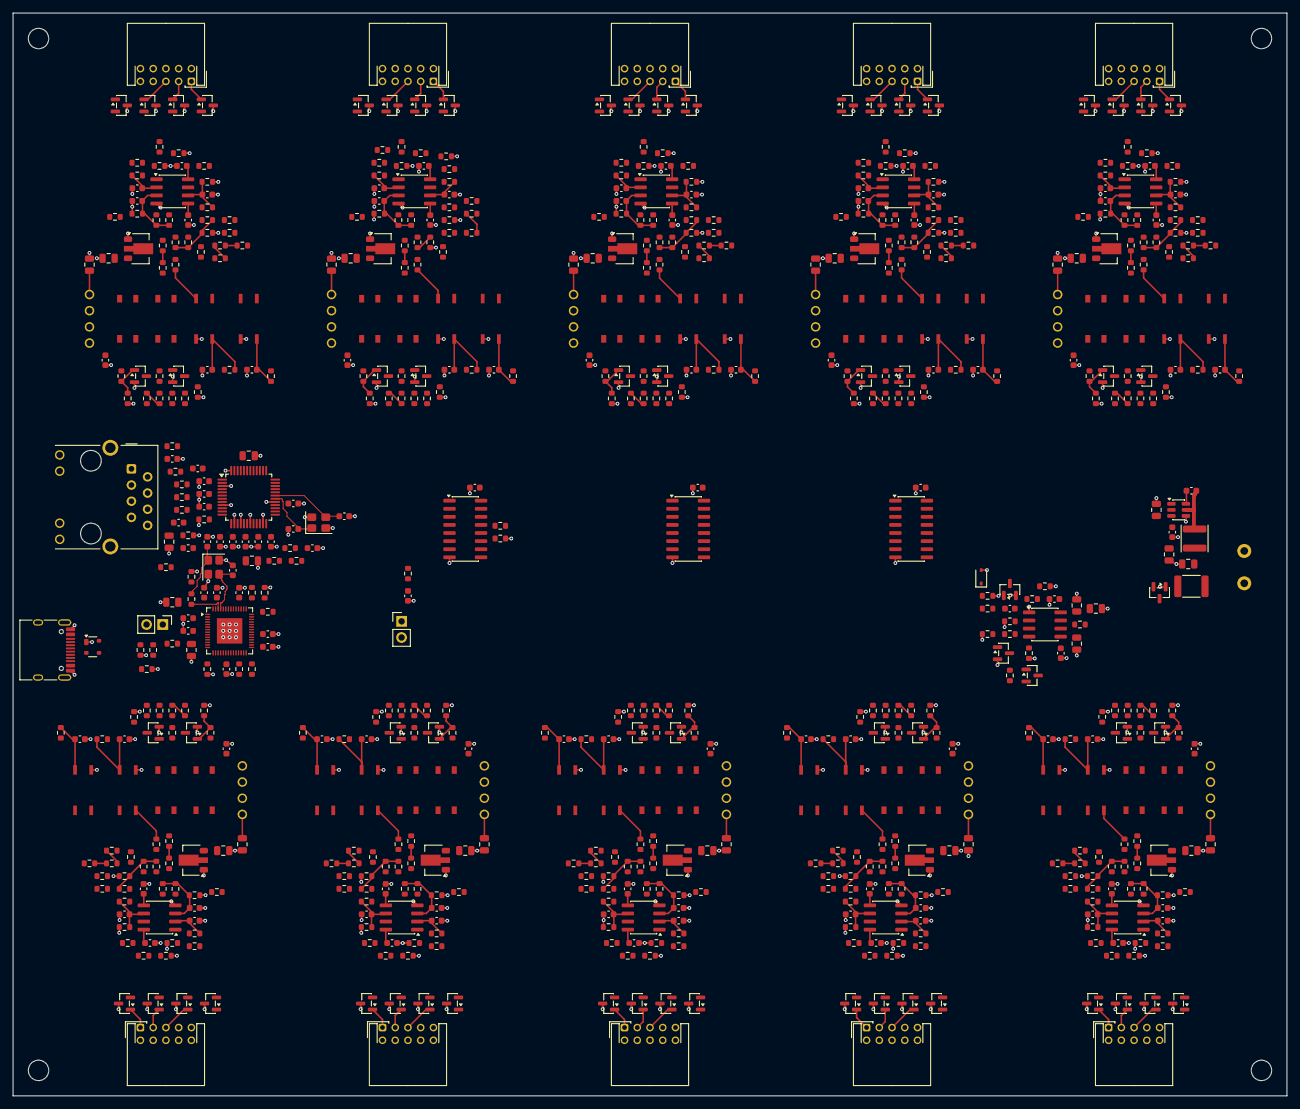
[picture p117: board routing-R1.kicad_pcb from above]

Board: 2 copper layers, 200.0 x 170.0 mm, 698 parts (0 on the bottom side), 455 nets.

Parts:
C1, C14, C15, C27, C29, C43, C44, C45, C47, C48, C57, C58, C67, C68, C77, C78, C87, C88, C97, C98, C107, C108, C117, C118, C127, C128, C137, C138: 10u; C_0805_2012Metric
C2, C3, C6, C8, C9, C10, C11, C12, C13, C21, C22, C23, C24, C25, C26, C28, C37, C38, C39, C40, C42, C49, C59, C69, C79, C89, C99, C109, C119, C129, C139: 100n; C_0603_1608Metric
C4, C5: 22u; C_0805_2012Metric
C7, C16, C30: 1u; C_0603_1608Metric
C17, C18, C31, C32: 20p; C_0603_1608Metric
C19, C46, C56, C66, C76, C86, C96, C106, C116, C126, C136: 4.7u; C_0603_1608Metric
C20, C33, C41: 10n; C_0603_1608Metric
C34, C35: 6.8n; C_0603_1608Metric
C36: 22n; C_0805_2012Metric
C50, C51, C52, C53, C54, C55, C60, C61, C62, C63, C64, C65, C70, C71, C72, C73, C74, C75, C80, C81, C82, C83, C84, C85, C90, C91, C92, C93, C94, C95, C100, C101, C102, C103, C104, C105, C110, C111, C112, C113, C114, C115, C120, C121, C122, C123, C124, C125, C130, C131, C132, C133, C134, C135, C140, C141, C142, C143, C144, C145: 1n; C_0603_1608Metric
D1: PRTR5V0U2X,215; SOT-143
D2: 1N4148WS; D_SOD-323
D3, D4, D5, D6, D7, D8, D9, D10, D11, D12, D13, D14, D15, D16, D17, D18, D19, D20, D21, D22, D23, D24, D25, D26, D27, D28, D29, D30, D31, D32, D33, D34, D35, D36, D37, D38, D39, D40, D41, D42: PESD5V0S2BT; SOT-23
F1: MF-MSMF150/24X-2 1.5A; Fuse_1812_4532Metric
J01, J02, J03, J04, J05, J06, J07, J08, J09, J10: S10B-PHDSS(LF)(SN); JST_PHD_S10B-PHDSS_2x05_P2.00mm_Horizontal
J101: WJ500V-5.08-2P; WJ500V_5.08_2P
J102, J103: PZ254V-11-02P; PinHeader_1x02_P2.54mm_Vertical
J104: TYPE-C-31-M-12; USB_C_Receptacle_HRO_TYPE-C-31-M-12
J105: HR911105A; RJ45_Hanrun_HR911105A_Horizontal
L1: 4.7uH FNR4018S4R7MT; L_Changjiang_FNR4018S
L2: 120R@100MHz GZ1608D121TF; L_0603_1608Metric
MH1, MH2, MH3, MH4: MountingHole_3.2mm_M3
Q1, Q4: AO3401A; SOT-23
Q2, Q3, Q5, Q6, Q7, Q8, Q9, Q10, Q11, Q12, Q13, Q14, Q15, Q16, Q17, Q18, Q19, Q20, Q21, Q22, Q23, Q24: MMBT3904; SOT-23
R1, R2, R3, R4, R15, R16, R17, R25, R29, R30, R31, R33, R35, R36, R37, R47, R49, R55, R58, R60, R62, R68, R71, R72, R82, R84, R90, R93, R95, R97, R103, R106, R107, R117, R119, R125, R128, R130, R132, R138, R141, R142, R152, R154, R160, R163, R165, R167, R173, R176, R177, R187, R189, R195, R198, R200, R202, R208, R211, R212, R222, R224, R230, R233, R235, R237, R243, R246, R247, R257, R259, R265, R268, R270, R272, R278, R281, R282, R292, R294, R300, R303, R305, R307, R313, R316, R317, R327, R329, R335, R338, R340, R342, R348, R351, R352, R362, R364, R370, R373, R375, R377, R383, R386: 10k 1%; R_0603_1608Metric
R5, R24: 0 1%; R_0603_1608Metric
R6, R7: 47 1%; R_0603_1608Metric
R8, R9: 5.1k 1%; R_0603_1608Metric
R10, R11: 33 1%; R_0603_1608Metric
R12, R13, R26, R27, R28, R34, R39, R43, R46, R48, R59, R61, R74, R78, R81, R83, R94, R96, R109, R113, R116, R118, R129, R131, R144, R148, R151, R153, R164, R166, R179, R183, R186, R188, R199, R201, R214, R218, R221, R223, R234, R236, R249, R253, R256, R258, R269, R271, R284, R288, R291, R293, R304, R306, R319, R323, R326, R328, R339, R341, R354, R358, R361, R363, R374, R376: 100k 1%; R_0603_1608Metric
R14: 12.4k 1%; R_0603_1608Metric
R18, R19, R20, R21: 49.9 1%; R_0603_1608Metric
R22, R23, R56, R57, R69, R70, R91, R92, R104, R105, R126, R127, R139, R140, R161, R162, R174, R175, R196, R197, R209, R210, R231, R232, R244, R245, R266, R267, R279, R280, R301, R302, R314, R315, R336, R337, R349, R350, R371, R372, R384, R385: 330 1%; R_0603_1608Metric
R32, R51, R52, R53, R54, R64, R65, R66, R67, R86, R87, R88, R89, R99, R100, R101, R102, R121, R122, R123, R124, R134, R135, R136, R137, R156, R157, R158, R159, R169, R170, R171, R172, R191, R192, R193, R194, R204, R205, R206, R207, R226, R227, R228, R229, R239, R240, R241, R242, R261, R262, R263, R264, R274, R275, R276, R277, R296, R297, R298, R299, R309, R310, R311, R312, R331, R332, R333, R334, R344, R345, R346, R347, R366, R367, R368, R369, R379, R380, R381, R382: 510k 1%; R_0603_1608Metric
R38, R42, R73, R77, R108, R112, R143, R147, R178, R182, R213, R217, R248, R252, R283, R287, R318, R322, R353, R357: 1.5k 1%; R_0603_1608Metric
R40, R41, R44, R45, R75, R76, R79, R80, R110, R111, R114, R115, R145, R146, R149, R150, R180, R181, R184, R185, R215, R216, R219, R220, R250, R251, R254, R255, R285, R286, R289, R290, R320, R321, R324, R325, R355, R356, R359, R360: 220 1%; R_0603_1608Metric
R50, R63, R85, R98, R120, R133, R155, R168, R190, R203, R225, R238, R260, R273, R295, R308, R330, R343, R365, R378: 390k 1%; R_0603_1608Metric
U1: AP63203WU-7; TSOT-23-6
U2: ESP32-S3FN8; QFN-56-1EP_7x7mm_P0.4mm_EP4x4mm
U3: W5500; LQFP-48_7x7mm_P0.5mm
U4, U5, U6: 74HC595D,118; SOIC-16_3.9x9.9mm_P1.27mm
U7: TLC555CDR; SOIC-8_3.9x4.9mm_P1.27mm
U8, U15, U22, U29, U36, U43, U50, U57, U64, U71: B0505S-1WR3L; HENIPER_B0505S_1WR3L
U9, U16, U23, U30, U37, U44, U51, U58, U65, U72: HT7533-1; SOT-89-3
U10, U11, U17, U18, U24, U25, U31, U32, U38, U39, U45, U46, U52, U53, U59, U60, U66, U67, U73, U74: TLP3122A(TPL,E; TLP3122A_11-4M1S
U12, U13, U19, U20, U26, U27, U33, U34, U40, U41, U47, U48, U54, U55, U61, U62, U68, U69, U75, U76: EL357N(B)(TA)-G; EL357N_SOP4
U14, U21, U28, U35, U42, U49, U56, U63, U70, U77: LM393DR; SOIC-8_3.9x4.9mm_P1.27mm
Y1: 40MHz CL12pF; Crystal_SMD_3225-4Pin_3.2x2.5mm
Y2: 25MHz CL12pF; Crystal_SMD_3225-4Pin_3.2x2.5mm

Connections:
3V3: C4.1, C5.1, C8.1, C9.1, C10.1, C11.1, C12.1, C13.1, C14.1, C15.1, C28.1, C29.1, C37.1, C38.1, C39.1, L1.2, L2.1, R1.1, R2.1, R15.1, R16.1, R17.1, R22.1, R23.1, R25.1, R58.1, R71.1, R93.1, R106.1, R128.1, R141.1, R163.1, R176.1, R198.1, R211.1, R233.1, R246.1, R268.1, R281.1, R303.1, R316.1, R338.1, R351.1, R373.1, R386.1, U1.1, U2.2, U2.3, U2.20, U2.46, U2.55, U2.56, U3.28, U3.43, U3.44, U3.45, U4.16, U5.16, U6.16
3V3_ETH_A: C21.1, C22.1, C23.1, C24.1, C25.1, C26.1, C27.1, L2.2, R18.2, R19.2, U3.4, U3.8, U3.11, U3.15, U3.17, U3.21
5V: C1.1, C2.1, C42.1, C46.1, C56.1, C66.1, C76.1, C86.1, C96.1, C106.1, C116.1, C126.1, C136.1, Q1.2, Q4.2, R31.1, R32.1, R35.2, U1.2, U1.3, U7.8, U8.2, U15.2, U22.2, U29.2, U36.2, U43.2, U50.2, U57.2, U64.2, U71.2
5V_FUSED: F1.2, Q1.3
5V_JACK: F1.1, J101.1
BOOT_N: J103.1, R2.2, U2.5
BUCK_BST: C3.1, U1.6
BUCK_SW: C3.2, L1.1, U1.5
CHASSIS: J105.SH, R24.1
CTRL_H01_PWR_A: R41.2, U10.1
CTRL_H01_PWR_B: Q5.1, R38.2, R39.1
CTRL_H01_PWR_K: Q5.3, U10.3
CTRL_H01_PWR_R: R40.2, R41.1
CTRL_H01_RST_A: R45.2, U11.1
CTRL_H01_RST_B: Q6.1, R42.2, R43.1
CTRL_H01_RST_K: Q6.3, U11.3
CTRL_H01_RST_R: R44.2, R45.1
CTRL_H02_PWR_A: R76.2, U17.1
CTRL_H02_PWR_B: Q7.1, R73.2, R74.1
CTRL_H02_PWR_K: Q7.3, U17.3
CTRL_H02_PWR_R: R75.2, R76.1
CTRL_H02_RST_A: R80.2, U18.1
CTRL_H02_RST_B: Q8.1, R77.2, R78.1
CTRL_H02_RST_K: Q8.3, U18.3
CTRL_H02_RST_R: R79.2, R80.1
CTRL_H03_PWR_A: R111.2, U24.1
CTRL_H03_PWR_B: Q9.1, R108.2, R109.1
CTRL_H03_PWR_K: Q9.3, U24.3
CTRL_H03_PWR_R: R110.2, R111.1
CTRL_H03_RST_A: R115.2, U25.1
CTRL_H03_RST_B: Q10.1, R112.2, R113.1
CTRL_H03_RST_K: Q10.3, U25.3
CTRL_H03_RST_R: R114.2, R115.1
CTRL_H04_PWR_A: R146.2, U31.1
CTRL_H04_PWR_B: Q11.1, R143.2, R144.1
CTRL_H04_PWR_K: Q11.3, U31.3
CTRL_H04_PWR_R: R145.2, R146.1
CTRL_H04_RST_A: R150.2, U32.1
CTRL_H04_RST_B: Q12.1, R147.2, R148.1
CTRL_H04_RST_K: Q12.3, U32.3
CTRL_H04_RST_R: R149.2, R150.1
CTRL_H05_PWR_A: R181.2, U38.1
CTRL_H05_PWR_B: Q13.1, R178.2, R179.1
CTRL_H05_PWR_K: Q13.3, U38.3
CTRL_H05_PWR_R: R180.2, R181.1
CTRL_H05_RST_A: R185.2, U39.1
CTRL_H05_RST_B: Q14.1, R182.2, R183.1
CTRL_H05_RST_K: Q14.3, U39.3
CTRL_H05_RST_R: R184.2, R185.1
CTRL_H06_PWR_A: R216.2, U45.1
CTRL_H06_PWR_B: Q15.1, R213.2, R214.1
CTRL_H06_PWR_K: Q15.3, U45.3
CTRL_H06_PWR_R: R215.2, R216.1
CTRL_H06_RST_A: R220.2, U46.1
CTRL_H06_RST_B: Q16.1, R217.2, R218.1
CTRL_H06_RST_K: Q16.3, U46.3
CTRL_H06_RST_R: R219.2, R220.1
CTRL_H07_PWR_A: R251.2, U52.1
CTRL_H07_PWR_B: Q17.1, R248.2, R249.1
CTRL_H07_PWR_K: Q17.3, U52.3
CTRL_H07_PWR_R: R250.2, R251.1
CTRL_H07_RST_A: R255.2, U53.1
CTRL_H07_RST_B: Q18.1, R252.2, R253.1
CTRL_H07_RST_K: Q18.3, U53.3
CTRL_H07_RST_R: R254.2, R255.1
CTRL_H08_PWR_A: R286.2, U59.1
CTRL_H08_PWR_B: Q19.1, R283.2, R284.1
CTRL_H08_PWR_K: Q19.3, U59.3
CTRL_H08_PWR_R: R285.2, R286.1
CTRL_H08_RST_A: R290.2, U60.1
CTRL_H08_RST_B: Q20.1, R287.2, R288.1
CTRL_H08_RST_K: Q20.3, U60.3
CTRL_H08_RST_R: R289.2, R290.1
CTRL_H09_PWR_A: R321.2, U66.1
CTRL_H09_PWR_B: Q21.1, R318.2, R319.1
CTRL_H09_PWR_K: Q21.3, U66.3
CTRL_H09_PWR_R: R320.2, R321.1
CTRL_H09_RST_A: R325.2, U67.1
CTRL_H09_RST_B: Q22.1, R322.2, R323.1
CTRL_H09_RST_K: Q22.3, U67.3
CTRL_H09_RST_R: R324.2, R325.1
CTRL_H10_PWR_A: R356.2, U73.1
CTRL_H10_PWR_B: Q23.1, R353.2, R354.1
CTRL_H10_PWR_K: Q23.3, U73.3
CTRL_H10_PWR_R: R355.2, R356.1
CTRL_H10_RST_A: R360.2, U74.1
CTRL_H10_RST_B: Q24.1, R357.2, R358.1
CTRL_H10_RST_K: Q24.3, U74.3
CTRL_H10_RST_R: R359.2, R360.1
DRV_01: R38.1, U4.15
DRV_02: R42.1, U4.1
DRV_03: R73.1, U4.2
DRV_04: R77.1, U4.3
DRV_05: R108.1, U4.4
DRV_06: R112.1, U4.5
DRV_07: R143.1, U4.6
DRV_08: R147.1, U4.7
DRV_09: R178.1, U5.15
DRV_10: R182.1, U5.1
DRV_11: R213.1, U5.2
DRV_12: R217.1, U5.3
DRV_13: R248.1, U5.4
DRV_14: R252.1, U5.5
DRV_15: R283.1, U5.6
DRV_16: R287.1, U5.7
DRV_17: R318.1, U6.15
DRV_18: R322.1, U6.1
DRV_19: R353.1, U6.2
DRV_20: R357.1, U6.3
EN: C16.1, J102.1, R1.2, U2.4, U4.10, U5.10, U6.10
ETH_1V2: C20.1, U3.22
ETH_ACT_N: J105.11, U3.27
ETH_CS_N: R15.2, U2.48, U3.32
ETH_EXRES: R14.1, U3.10
ETH_INT_N: R16.2, U2.37, U3.36
ETH_LINK_N: J105.10, U3.25
ETH_RST_N: C30.1, R17.2, U2.36, U3.37
ETH_RXN: C35.1, R21.1, U3.5
ETH_RXP: C34.1, R20.1, U3.6
ETH_RX_TERM: C33.1, J105.5, R20.2, R21.2
ETH_TOCAP: C19.1, U3.20
ETH_TXN: J105.2, R19.1, U3.1
ETH_TXP: J105.1, R18.1, U3.2
ETH_XI: C31.1, U3.30, Y2.1
ETH_XO: C32.1, U3.31, Y2.3
GATE_BASE: Q3.1, R33.2, R34.1
GND_CTRL: C1.2, C2.2, C4.2, C5.2, C6.2, C7.2, C8.2, C9.2, C10.2, C11.2, C12.2, C13.2, C14.2, C15.2, C16.2, C17.2, C18.2, C19.2, C20.2, C21.2, C22.2, C23.2, C24.2, C25.2, C26.2, C27.2, C28.2, C29.2, C30.2, C31.2, C32.2, C33.2, C36.2, C37.2, C38.2, C39.2, C41.2, C42.2, C43.2, C44.2, C45.2, C46.2, C52.2, C55.2, C56.2, C62.2, C65.2, C66.2, C72.2, C75.2, C76.2, C82.2, C85.2, C86.2, C92.2, C95.2, C96.2, C102.2, C105.2, C106.2, C112.2, C115.2, C116.2, C122.2, C125.2, C126.2, C132.2, C135.2, C136.2, C142.2, C145.2, D1.1, D2.2, J101.2, J102.2, J103.2, J104.A1, J104.A12, J104.B1, J104.B12, J104.SH, J105.8, Q1.1, Q2.2, Q3.2, Q5.2, Q6.2, Q7.2, Q8.2, Q9.2, Q10.2, Q11.2, Q12.2, Q13.2, Q14.2, Q15.2, Q16.2, Q17.2, Q18.2, Q19.2, Q20.2, Q21.2, Q22.2, Q23.2, Q24.2, R3.2, R4.2, R8.2, R9.2, R13.2, R14.2, R24.2, R26.2, R27.2, R28.2, R30.2, R34.2, R36.2, R39.2, R43.2, R74.2, R78.2, R109.2, R113.2, R144.2, R148.2, R179.2, R183.2, R214.2, R218.2, R249.2, R253.2, R284.2, R288.2, R319.2, R323.2, R354.2, R358.2, U1.4, U2.57, U3.3, U3.9, U3.14, U3.16, U3.19, U3.23, U3.29, U3.48, U4.8, U5.8, U6.8, U7.1, U8.1, U12.3, U13.3, U15.1, U19.3, U20.3, U22.1, U26.3, U27.3, U29.1, U33.3, U34.3, U36.1, U40.3, U41.3, U43.1, U47.3, U48.3, U50.1, U54.3, U55.3, U57.1, U61.3, U62.3, U64.1, U68.3, U69.3, U71.1, U75.3, U76.3, Y1.2, Y1.4, Y2.2, Y2.4
H01_3V3: C48.1, C49.1, R37.1, R50.1, R55.1, R56.1, R63.1, R68.1, R69.1, U9.3, U14.8
H01_GND: C47.2, C48.2, C49.2, C50.2, C51.2, C53.2, C54.2, D3.3, D4.3, D5.3, D6.3, J01.9, R37.2, R47.2, R49.2, R60.2, R62.2, U8.3, U9.1, U14.4
H01_HDD_CMP: R64.1, R68.2, U13.2, U14.7
H01_HDD_FB1: R64.2, R65.1
H01_HDD_FB2: R65.2, R66.1
H01_HDD_FB3: R66.2, R67.1
H01_HDD_M: D6.2, J01.8, R61.1
H01_HDD_N: C55.1, R71.2, U2.10, U13.4
H01_HDD_OA: R70.2, U13.1
H01_HDD_OR: R69.2, R70.1
H01_HDD_P: D6.1, J01.7, R59.1
H01_HDD_SMINUS: C54.1, R61.2, R62.1, R63.2, R67.2, U14.5
H01_HDD_SPLUS: C53.1, R59.2, R60.1, U14.6
H01_PLED_CMP: R51.1, R55.2, U12.2, U14.1
H01_PLED_FB1: R51.2, R52.1
H01_PLED_FB2: R52.2, R53.1
H01_PLED_FB3: R53.2, R54.1
H01_PLED_M: D5.2, J01.6, R48.1
H01_PLED_N: C52.1, R58.2, U2.9, U12.4
H01_PLED_OA: R57.2, U12.1
H01_PLED_OR: R56.2, R57.1
H01_PLED_P: D5.1, J01.5, R46.1
H01_PLED_SMINUS: C51.1, R48.2, R49.1, R50.2, R54.2, U14.3
H01_PLED_SPLUS: C50.1, R46.2, R47.1, U14.2
H01_PWR_A: D3.1, J01.1, U10.4
H01_PWR_B: D3.2, J01.2, U10.6
H01_RAW5: C47.1, U8.4, U9.2
H01_RST_A: D4.1, J01.3, U11.4
H01_RST_B: D4.2, J01.4, U11.6
H02_3V3: C58.1, C59.1, R72.1, R85.1, R90.1, R91.1, R98.1, R103.1, R104.1, U16.3, U21.8
H02_GND: C57.2, C58.2, C59.2, C60.2, C61.2, C63.2, C64.2, D7.3, D8.3, D9.3, D10.3, J02.9, R72.2, R82.2, R84.2, R95.2, R97.2, U15.3, U16.1, U21.4
H02_HDD_CMP: R99.1, R103.2, U20.2, U21.7
H02_HDD_FB1: R99.2, R100.1
H02_HDD_FB2: R100.2, R101.1
H02_HDD_FB3: R101.2, R102.1
H02_HDD_M: D10.2, J02.8, R96.1
H02_HDD_N: C65.1, R106.2, U2.12, U20.4
H02_HDD_OA: R105.2, U20.1
H02_HDD_OR: R104.2, R105.1
H02_HDD_P: D10.1, J02.7, R94.1
H02_HDD_SMINUS: C64.1, R96.2, R97.1, R98.2, R102.2, U21.5
H02_HDD_SPLUS: C63.1, R94.2, R95.1, U21.6
H02_PLED_CMP: R86.1, R90.2, U19.2, U21.1
H02_PLED_FB1: R86.2, R87.1
H02_PLED_FB2: R87.2, R88.1
H02_PLED_FB3: R88.2, R89.1
H02_PLED_M: D9.2, J02.6, R83.1
H02_PLED_N: C62.1, R93.2, U2.11, U19.4
H02_PLED_OA: R92.2, U19.1
H02_PLED_OR: R91.2, R92.1
H02_PLED_P: D9.1, J02.5, R81.1
H02_PLED_SMINUS: C61.1, R83.2, R84.1, R85.2, R89.2, U21.3
H02_PLED_SPLUS: C60.1, R81.2, R82.1, U21.2
H02_PWR_A: D7.1, J02.1, U17.4
H02_PWR_B: D7.2, J02.2, U17.6
H02_RAW5: C57.1, U15.4, U16.2
H02_RST_A: D8.1, J02.3, U18.4
H02_RST_B: D8.2, J02.4, U18.6
H03_3V3: C68.1, C69.1, R107.1, R120.1, R125.1, R126.1, R133.1, R138.1, R139.1, U23.3, U28.8
H03_GND: C67.2, C68.2, C69.2, C70.2, C71.2, C73.2, C74.2, D11.3, D12.3, D13.3, D14.3, J03.9, R107.2, R117.2, R119.2, R130.2, R132.2, U22.3, U23.1, U28.4
H03_HDD_CMP: R134.1, R138.2, U27.2, U28.7
H03_HDD_FB1: R134.2, R135.1
H03_HDD_FB2: R135.2, R136.1
H03_HDD_FB3: R136.2, R137.1
H03_HDD_M: D14.2, J03.8, R131.1
H03_HDD_N: C75.1, R141.2, U2.14, U27.4
H03_HDD_OA: R140.2, U27.1
H03_HDD_OR: R139.2, R140.1
H03_HDD_P: D14.1, J03.7, R129.1
H03_HDD_SMINUS: C74.1, R131.2, R132.1, R133.2, R137.2, U28.5
H03_HDD_SPLUS: C73.1, R129.2, R130.1, U28.6
H03_PLED_CMP: R121.1, R125.2, U26.2, U28.1
H03_PLED_FB1: R121.2, R122.1
H03_PLED_FB2: R122.2, R123.1
H03_PLED_FB3: R123.2, R124.1
H03_PLED_M: D13.2, J03.6, R118.1
H03_PLED_N: C72.1, R128.2, U2.13, U26.4
H03_PLED_OA: R127.2, U26.1
H03_PLED_OR: R126.2, R127.1
H03_PLED_P: D13.1, J03.5, R116.1
H03_PLED_SMINUS: C71.1, R118.2, R119.1, R120.2, R124.2, U28.3
H03_PLED_SPLUS: C70.1, R116.2, R117.1, U28.2
H03_PWR_A: D11.1, J03.1, U24.4
H03_PWR_B: D11.2, J03.2, U24.6
H03_RAW5: C67.1, U22.4, U23.2
H03_RST_A: D12.1, J03.3, U25.4
H03_RST_B: D12.2, J03.4, U25.6
H04_3V3: C78.1, C79.1, R142.1, R155.1, R160.1, R161.1, R168.1, R173.1, R174.1, U30.3, U35.8
H04_GND: C77.2, C78.2, C79.2, C80.2, C81.2, C83.2, C84.2, D15.3, D16.3, D17.3, D18.3, J04.9, R142.2, R152.2, R154.2, R165.2, R167.2, U29.3, U30.1, U35.4
H04_HDD_CMP: R169.1, R173.2, U34.2, U35.7
H04_HDD_FB1: R169.2, R170.1
H04_HDD_FB2: R170.2, R171.1
H04_HDD_FB3: R171.2, R172.1
H04_HDD_M: D18.2, J04.8, R166.1
H04_HDD_N: C85.1, R176.2, U2.16, U34.4
H04_HDD_OA: R175.2, U34.1
H04_HDD_OR: R174.2, R175.1
H04_HDD_P: D18.1, J04.7, R164.1
H04_HDD_SMINUS: C84.1, R166.2, R167.1, R168.2, R172.2, U35.5
H04_HDD_SPLUS: C83.1, R164.2, R165.1, U35.6
H04_PLED_CMP: R156.1, R160.2, U33.2, U35.1
H04_PLED_FB1: R156.2, R157.1
H04_PLED_FB2: R157.2, R158.1
H04_PLED_FB3: R158.2, R159.1
H04_PLED_M: D17.2, J04.6, R153.1
H04_PLED_N: C82.1, R163.2, U2.15, U33.4
H04_PLED_OA: R162.2, U33.1
H04_PLED_OR: R161.2, R162.1
H04_PLED_P: D17.1, J04.5, R151.1
H04_PLED_SMINUS: C81.1, R153.2, R154.1, R155.2, R159.2, U35.3
H04_PLED_SPLUS: C80.1, R151.2, R152.1, U35.2
H04_PWR_A: D15.1, J04.1, U31.4
H04_PWR_B: D15.2, J04.2, U31.6
H04_RAW5: C77.1, U29.4, U30.2
H04_RST_A: D16.1, J04.3, U32.4
H04_RST_B: D16.2, J04.4, U32.6
H05_3V3: C88.1, C89.1, R177.1, R190.1, R195.1, R196.1, R203.1, R208.1, R209.1, U37.3, U42.8
H05_GND: C87.2, C88.2, C89.2, C90.2, C91.2, C93.2, C94.2, D19.3, D20.3, D21.3, D22.3, J05.9, R177.2, R187.2, R189.2, R200.2, R202.2, U36.3, U37.1, U42.4
H05_HDD_CMP: R204.1, R208.2, U41.2, U42.7
H05_HDD_FB1: R204.2, R205.1
H05_HDD_FB2: R205.2, R206.1
H05_HDD_FB3: R206.2, R207.1
H05_HDD_M: D22.2, J05.8, R201.1
H05_HDD_N: C95.1, R211.2, U2.18, U41.4
H05_HDD_OA: R210.2, U41.1
H05_HDD_OR: R209.2, R210.1
H05_HDD_P: D22.1, J05.7, R199.1
H05_HDD_SMINUS: C94.1, R201.2, R202.1, R203.2, R207.2, U42.5
H05_HDD_SPLUS: C93.1, R199.2, R200.1, U42.6
H05_PLED_CMP: R191.1, R195.2, U40.2, U42.1
H05_PLED_FB1: R191.2, R192.1
H05_PLED_FB2: R192.2, R193.1
H05_PLED_FB3: R193.2, R194.1
H05_PLED_M: D21.2, J05.6, R188.1
H05_PLED_N: C92.1, R198.2, U2.17, U40.4
H05_PLED_OA: R197.2, U40.1
H05_PLED_OR: R196.2, R197.1
H05_PLED_P: D21.1, J05.5, R186.1
H05_PLED_SMINUS: C91.1, R188.2, R189.1, R190.2, R194.2, U42.3
H05_PLED_SPLUS: C90.1, R186.2, R187.1, U42.2
H05_PWR_A: D19.1, J05.1, U38.4
H05_PWR_B: D19.2, J05.2, U38.6
H05_RAW5: C87.1, U36.4, U37.2
H05_RST_A: D20.1, J05.3, U39.4
H05_RST_B: D20.2, J05.4, U39.6
H06_3V3: C98.1, C99.1, R212.1, R225.1, R230.1, R231.1, R238.1, R243.1, R244.1, U44.3, U49.8
H06_GND: C97.2, C98.2, C99.2, C100.2, C101.2, C103.2, C104.2, D23.3, D24.3, D25.3, D26.3, J06.9, R212.2, R222.2, R224.2, R235.2, R237.2, U43.3, U44.1, U49.4
H06_HDD_CMP: R239.1, R243.2, U48.2, U49.7
H06_HDD_FB1: R239.2, R240.1
H06_HDD_FB2: R240.2, R241.1
H06_HDD_FB3: R241.2, R242.1
H06_HDD_M: D26.2, J06.8, R236.1
H06_HDD_N: C105.1, R246.2, U2.21, U48.4
H06_HDD_OA: R245.2, U48.1
H06_HDD_OR: R244.2, R245.1
H06_HDD_P: D26.1, J06.7, R234.1
H06_HDD_SMINUS: C104.1, R236.2, R237.1, R238.2, R242.2, U49.5
H06_HDD_SPLUS: C103.1, R234.2, R235.1, U49.6
H06_PLED_CMP: R226.1, R230.2, U47.2, U49.1
H06_PLED_FB1: R226.2, R227.1
H06_PLED_FB2: R227.2, R228.1
H06_PLED_FB3: R228.2, R229.1
H06_PLED_M: D25.2, J06.6, R223.1
H06_PLED_N: C102.1, R233.2, U2.19, U47.4
H06_PLED_OA: R232.2, U47.1
H06_PLED_OR: R231.2, R232.1
H06_PLED_P: D25.1, J06.5, R221.1
H06_PLED_SMINUS: C101.1, R223.2, R224.1, R225.2, R229.2, U49.3
H06_PLED_SPLUS: C100.1, R221.2, R222.1, U49.2
H06_PWR_A: D23.1, J06.1, U45.4
H06_PWR_B: D23.2, J06.2, U45.6
H06_RAW5: C97.1, U43.4, U44.2
H06_RST_A: D24.1, J06.3, U46.4
H06_RST_B: D24.2, J06.4, U46.6
H07_3V3: C108.1, C109.1, R247.1, R260.1, R265.1, R266.1, R273.1, R278.1, R279.1, U51.3, U56.8
H07_GND: C107.2, C108.2, C109.2, C110.2, C111.2, C113.2, C114.2, D27.3, D28.3, D29.3, D30.3, J07.9, R247.2, R257.2, R259.2, R270.2, R272.2, U50.3, U51.1, U56.4
H07_HDD_CMP: R274.1, R278.2, U55.2, U56.7
H07_HDD_FB1: R274.2, R275.1
H07_HDD_FB2: R275.2, R276.1
H07_HDD_FB3: R276.2, R277.1
H07_HDD_M: D30.2, J07.8, R271.1
H07_HDD_N: C115.1, R281.2, U2.23, U55.4
H07_HDD_OA: R280.2, U55.1
H07_HDD_OR: R279.2, R280.1
H07_HDD_P: D30.1, J07.7, R269.1
H07_HDD_SMINUS: C114.1, R271.2, R272.1, R273.2, R277.2, U56.5
H07_HDD_SPLUS: C113.1, R269.2, R270.1, U56.6
H07_PLED_CMP: R261.1, R265.2, U54.2, U56.1
H07_PLED_FB1: R261.2, R262.1
H07_PLED_FB2: R262.2, R263.1
H07_PLED_FB3: R263.2, R264.1
H07_PLED_M: D29.2, J07.6, R258.1
H07_PLED_N: C112.1, R268.2, U2.22, U54.4
H07_PLED_OA: R267.2, U54.1
H07_PLED_OR: R266.2, R267.1
H07_PLED_P: D29.1, J07.5, R256.1
H07_PLED_SMINUS: C111.1, R258.2, R259.1, R260.2, R264.2, U56.3
H07_PLED_SPLUS: C110.1, R256.2, R257.1, U56.2
H07_PWR_A: D27.1, J07.1, U52.4
H07_PWR_B: D27.2, J07.2, U52.6
H07_RAW5: C107.1, U50.4, U51.2
H07_RST_A: D28.1, J07.3, U53.4
H07_RST_B: D28.2, J07.4, U53.6
H08_3V3: C118.1, C119.1, R282.1, R295.1, R300.1, R301.1, R308.1, R313.1, R314.1, U58.3, U63.8
H08_GND: C117.2, C118.2, C119.2, C120.2, C121.2, C123.2, C124.2, D31.3, D32.3, D33.3, D34.3, J08.9, R282.2, R292.2, R294.2, R305.2, R307.2, U57.3, U58.1, U63.4
H08_HDD_CMP: R309.1, R313.2, U62.2, U63.7
H08_HDD_FB1: R309.2, R310.1
H08_HDD_FB2: R310.2, R311.1
H08_HDD_FB3: R311.2, R312.1
H08_HDD_M: D34.2, J08.8, R306.1
H08_HDD_N: C125.1, R316.2, U2.27, U62.4
H08_HDD_OA: R315.2, U62.1
H08_HDD_OR: R314.2, R315.1
H08_HDD_P: D34.1, J08.7, R304.1
H08_HDD_SMINUS: C124.1, R306.2, R307.1, R308.2, R312.2, U63.5
H08_HDD_SPLUS: C123.1, R304.2, R305.1, U63.6
H08_PLED_CMP: R296.1, R300.2, U61.2, U63.1
H08_PLED_FB1: R296.2, R297.1
H08_PLED_FB2: R297.2, R298.1
H08_PLED_FB3: R298.2, R299.1
H08_PLED_M: D33.2, J08.6, R293.1
H08_PLED_N: C122.1, R303.2, U2.24, U61.4
H08_PLED_OA: R302.2, U61.1
H08_PLED_OR: R301.2, R302.1
H08_PLED_P: D33.1, J08.5, R291.1
H08_PLED_SMINUS: C121.1, R293.2, R294.1, R295.2, R299.2, U63.3
H08_PLED_SPLUS: C120.1, R291.2, R292.1, U63.2
H08_PWR_A: D31.1, J08.1, U59.4
H08_PWR_B: D31.2, J08.2, U59.6
H08_RAW5: C117.1, U57.4, U58.2
H08_RST_A: D32.1, J08.3, U60.4
H08_RST_B: D32.2, J08.4, U60.6
H09_3V3: C128.1, C129.1, R317.1, R330.1, R335.1, R336.1, R343.1, R348.1, R349.1, U65.3, U70.8
H09_GND: C127.2, C128.2, C129.2, C130.2, C131.2, C133.2, C134.2, D35.3, D36.3, D37.3, D38.3, J09.9, R317.2, R327.2, R329.2, R340.2, R342.2, U64.3, U65.1, U70.4
H09_HDD_CMP: R344.1, R348.2, U69.2, U70.7
H09_HDD_FB1: R344.2, R345.1
H09_HDD_FB2: R345.2, R346.1
H09_HDD_FB3: R346.2, R347.1
H09_HDD_M: D38.2, J09.8, R341.1
H09_HDD_N: C135.1, R351.2, U2.41, U69.4
H09_HDD_OA: R350.2, U69.1
H09_HDD_OR: R349.2, R350.1
H09_HDD_P: D38.1, J09.7, R339.1
H09_HDD_SMINUS: C134.1, R341.2, R342.1, R343.2, R347.2, U70.5
H09_HDD_SPLUS: C133.1, R339.2, R340.1, U70.6
H09_PLED_CMP: R331.1, R335.2, U68.2, U70.1
H09_PLED_FB1: R331.2, R332.1
H09_PLED_FB2: R332.2, R333.1
H09_PLED_FB3: R333.2, R334.1
H09_PLED_M: D37.2, J09.6, R328.1
H09_PLED_N: C132.1, R338.2, U2.40, U68.4
H09_PLED_OA: R337.2, U68.1
H09_PLED_OR: R336.2, R337.1
H09_PLED_P: D37.1, J09.5, R326.1
H09_PLED_SMINUS: C131.1, R328.2, R329.1, R330.2, R334.2, U70.3
H09_PLED_SPLUS: C130.1, R326.2, R327.1, U70.2
H09_PWR_A: D35.1, J09.1, U66.4
H09_PWR_B: D35.2, J09.2, U66.6
H09_RAW5: C127.1, U64.4, U65.2
H09_RST_A: D36.1, J09.3, U67.4
H09_RST_B: D36.2, J09.4, U67.6
H10_3V3: C138.1, C139.1, R352.1, R365.1, R370.1, R371.1, R378.1, R383.1, R384.1, U72.3, U77.8
H10_GND: C137.2, C138.2, C139.2, C140.2, C141.2, C143.2, C144.2, D39.3, D40.3, D41.3, D42.3, J10.9, R352.2, R362.2, R364.2, R375.2, R377.2, U71.3, U72.1, U77.4
H10_HDD_CMP: R379.1, R383.2, U76.2, U77.7
H10_HDD_FB1: R379.2, R380.1
H10_HDD_FB2: R380.2, R381.1
H10_HDD_FB3: R381.2, R382.1
H10_HDD_M: D42.2, J10.8, R376.1
H10_HDD_N: C145.1, R386.2, U2.43, U76.4
H10_HDD_OA: R385.2, U76.1
H10_HDD_OR: R384.2, R385.1
H10_HDD_P: D42.1, J10.7, R374.1
H10_HDD_SMINUS: C144.1, R376.2, R377.1, R378.2, R382.2, U77.5
H10_HDD_SPLUS: C143.1, R374.2, R375.1, U77.6
H10_PLED_CMP: R366.1, R370.2, U75.2, U77.1
H10_PLED_FB1: R366.2, R367.1
H10_PLED_FB2: R367.2, R368.1
H10_PLED_FB3: R368.2, R369.1
H10_PLED_M: D41.2, J10.6, R363.1
H10_PLED_N: C142.1, R373.2, U2.42, U75.4
H10_PLED_OA: R372.2, U75.1
H10_PLED_OR: R371.2, R372.1
H10_PLED_P: D41.1, J10.5, R361.1
H10_PLED_SMINUS: C141.1, R363.2, R364.1, R365.2, R369.2, U77.3
H10_PLED_SPLUS: C140.1, R361.2, R362.1, U77.2
H10_PWR_A: D39.1, J10.1, U73.4
H10_PWR_B: D39.2, J10.2, U73.6
H10_RAW5: C137.1, U71.4, U72.2
H10_RST_A: D40.1, J10.3, U74.4
H10_RST_B: D40.2, J10.4, U74.6
MCU_XN: C18.1, U2.53, Y1.3
MCU_XP: R5.1, U2.54
MCU_XP_CR: C17.1, R5.2, Y1.1
OUT_LATCH: R26.1, U2.6, U4.12, U5.12, U6.12
OUT_OE_N: R25.2, U2.7, U4.13, U5.13, U6.13
PHOTO_5V: Q4.3, R36.1, R40.1, R44.1, R75.1, R79.1, R110.1, R114.1, R145.1, R149.1, R180.1, R184.1, R215.1, R219.1, R250.1, R254.1, R285.1, R289.1, R320.1, R324.1, R355.1, R359.1
PHOTO_GATE: Q3.3, Q4.1, R35.1
RJ_LED_G_A: J105.9, R22.2
RJ_LED_Y_A: J105.12, R23.2
RJ_RD_N: C35.2, J105.6
RJ_RD_P: C34.2, J105.3
RJ_TX_CT: C36.1, J105.4
SHIFT_1: U4.9, U5.14
SHIFT_2: U5.9, U6.14
SPI_MISO: U2.47, U3.34
SPI_MOSI: R7.2, U3.35, U4.14
SPI_MOSI_RAW: R7.1, U2.45
SPI_SCK: R6.2, U3.33, U4.11, U5.11, U6.11
SPI_SCK_RAW: R6.1, U2.44
STRAP45: R3.1, U2.51
STRAP46: R4.1, U2.52
TIMER_ARM: R27.1, U2.49, U7.4
TIMER_CTRL: C41.1, U7.5
TIMER_FIRE: C40.1, R28.1, U2.50
TIMER_OUT: R33.1, U7.3
TIMER_RC: C43.1, C44.1, C45.1, R32.2, U7.6, U7.7
TRIG_AC: C40.2, R29.1
TRIG_BASE: D2.1, Q2.1, R29.2, R30.1
TRIG_N: Q2.3, R31.2, U7.2
USB_CC1: J104.A5, R8.1
USB_CC2: J104.B5, R9.1
USB_DM: D1.2, J104.A7, J104.B7, R10.1
USB_DM_MCU: R10.2, U2.25
USB_DP: D1.3, J104.A6, J104.B6, R11.1
USB_DP_MCU: R11.2, U2.26
USB_VBUS: D1.4, J104.A4, J104.A9, J104.B4, J104.B9, R12.1
USB_VBUS_SENSE: R12.2, R13.1, U2.38
VDD_SPI: C6.1, C7.1, U2.29
