ddasdkimo/rack-atx-controller/(commit log)

2026-10-14 Audit QFN thermal grounding and two-layer manufacturing limits
2026-10-15 Document J105 alternatives without changing the native footprint
2026-10-15 Record minimum prototype assembly quotes and compare test batches
